jmcpheron/pico-quorum/tools/README.md

# tools

From picowallet (Austin Griffith, MIT): `emu`, the emulator's command line
([`../emu/README.md`](../emu/README.md)), and the start of `check_config`. The rest is Picoquorum's:

- `usb`: the board's REPL and file pushes over USB serial (mpremote), for development boards

- [`vectors/`](vectors/): generates the Safe hash test vectors, and what `firmware/decode.py` must
  say about each one
- `quorum` and [`mock-tx-service/`](mock-tx-service/): the console's 2-of-3 Family Safe on the
  laptop, serving Safe's transaction-service endpoints with two simulated co-signers.
  - It runs simulated (`serve`), or as a real Safe on an Anvil fork of Base (`up`), where the
    chip's approvals execute.
  - `e2e` runs one approval end to end on the fork with the emulator.
  - It also regenerates the screenshot walkthrough in [`../docs/quorum-ui/`](../docs/quorum-ui/).

- `wiring-breadboard`: draws the breadboard version and the knob close-up for
  [`../hardware/wiring/BREADBOARD.md`](../hardware/wiring/BREADBOARD.md); `--check` compares its wire list

- `wiring-build1`: draws [`../hardware/wiring/build1-wiring.svg`](../hardware/wiring/build1-wiring.svg);
  `--check` compares its pin table with BUILD1.md and `firmware/bench1.py`

- `wiring-esp32`: draws the ESP32 build on two breadboards and its pin map, for the DevKitC and for
  Freenove's ESP32-WROVER, for [`../hardware/wiring/ESP32.md`](../hardware/wiring/ESP32.md); `--check`
  compares its pin table with ESP32.md, `firmware/board.py`'s `"esp32"` profile and both boards' headers

- `keypcb`: the key PCBs in [`../hardware/key-pcb/`](../hardware/key-pcb/) and the console boards
  ([Mono](../hardware/mono/README.md), console-rp, and by name the ones in `hardware/prototypes/`
  and `hardware/archive/`), with KiCad's `kicad-cli`: 9 for key rev A, 10 for the rest.
  - `check` runs ERC, then DRC with schematic parity.
  - `fab` writes the Gerber zip, and the BOM and CPL in JLCPCB's format.
  - `render` draws the top and bottom of each board.
  - `calc` works out the numbers behind the design: finger timing, I2C rise time, key power from
    a GPIO, and two ngspice runs. See [`../hardware/key-pcb/LEARN.md`](../hardware/key-pcb/LEARN.md).

- `case`: the printed cases and mock-ups, rebuilt from their CadQuery scripts with uv, at pinned
  versions of CadQuery, matplotlib, Pillow and numpy.
  - `list` shows each design: its scripts, what they write, and the pages that show it. Mono's case
    is `mono`, and its industrial variant `mono-industrial`
    ([`../cad/consoles/`](../cad/consoles/README.md)).
  - `build [design]` runs a design's scripts in order (the prism: `prism.py`, then `assembly.py`'s
    step-by-step pictures).
  - `check [design]` builds, then lists every output that changed, appeared or went, and every
    picture a design's pages link to that isn't there. A design is up to date when it lists nothing.
  - A STEP file that differs only in its time, or in the order of its colours, is left as it was.
  - A new design is one entry in its `DESIGNS`.

- [`fonts/`](fonts/): renders the console's anti-aliased fonts (Atkinson Hyperlegible, OFL) into
  `firmware/qf_*.bin`; `firmware/fonts.py` draws them

- [`brand/lockup.py`](brand/lockup.py): the logo (the mark and the name, outlined) as
  `docs/brand/lockup-dark.svg` and `lockup-light.svg`, for the README

- [`releases/badge.mjs`](releases/badge.mjs): the README's build badges and table, each image's
  release fingerprint as a blockie with its first and last 8 digits; `--check` is CI's

- [`board/shots_feather.mjs`](board/shots_feather.mjs): the console's screens on the Feather
  ESP32-S3 Reverse TFT (240×135, three buttons), from the emulator, for
  [`../docs/quorum-ui/feather/`](../docs/quorum-ui/feather/README.md)

- `fw` ([`board/fw.mjs`](board/fw.mjs)): the Pico as a production device, over USB.
  - `build console|ceremony` makes an image from `firmware/manifest.json`.
  - `backup` copies every file on the board, each checked by SHA-256, into `backups/` (gitignored).
  - `verify [--baseline]` is read-only: files, flags, the console's live state, and the chip.
  - `pin` writes `QUORUM_EXPECT` from the chip itself.
  - `push console|ceremony` backs up first, shows the plan and asks for a typed yes. Then it enters
    maintenance, copies, checks every hash, and deletes stale files.
  - Also `restore`, `logs`, and `measure tls` (run on the board from RAM).
  - `tools/usb push` no longer copies `secrets.py`, and refuses a production board.
- `check_config`: both ATECC608 tables, the legacy test table and quorum v1, with quorum v1 decoded
  again from the datasheet's bit tables. `--summary SNAPSHOT` prints a fresh chip's config CRC.
- [`board/shots.mjs`](board/shots.mjs): the walkthrough in
  [`../docs/firmware-production/`](../docs/firmware-production/).
