jmcpheron/pico-quorum/emu/README.md

# emu: the console in a browser

The emulator comes from Austin Griffith's [picowallet](https://github.com/austintgriffith/picowallet)
(MIT): its runtime, shims, page and command line are his, changed since for Picoquorum.

Real MicroPython (the WebAssembly build of 1.26, the board runs 1.26.1) running the firmware in
`firmware/` unchanged, with the `machine`/`network`/`requests` modules replaced by shims that talk
to the page. The screen is captured from the ST7789 SPI stream, so what you see is the exact
framebuffer.

```
tools/emu                 # start the server, open http://localhost:4242
tools/emu run quorum      # reboot + start the console (firmware/quorum.py)
tools/emu key A           # press a button (A B X Y up down left right press), key right:300 holds
tools/emu shot            # emu/shots/latest.png
tools/emu exec 'import gc; print(gc.mem_free())'
tools/emu log             # console lines
tools/emu chip ready      # the virtual ATECC608: config locked + key in slot 0 (fresh = blank part, show = state)
tools/emu devices         # boards on USB (serial ports, bootloader drives)
tools/emu ship snake      # copy emu/sketches/snake.py (+ imports) to the Pico on USB and run it (--port /dev/cu.usbmodemN, --boot: run at power-up too)
tools/emu flash --port /dev/cu.usbmodemN [--wifi]   # MicroPython onto any board (also works on a BOOTSEL drive without --port)
tools/emu headless quorum --wait 300 --key right --shot emu/shots/x.png    # no browser
tools/emu serve --host 0.0.0.0   # server in the foreground, reachable from the LAN (EMU_HOST=0.0.0.0 too)
```

The server listens on 127.0.0.1 only. Its `/ctl` routes run code on the emulated device and ship files
to a Pico on USB, so `--host` opens that to anyone who can reach the machine: trusted networks only.

Page: the device menu lists every board on USB; for one that is not running MicroPython the
send button becomes ⚡ install MicroPython. The module menu top left picks what ▶ run, ↻ reset and
⇪ send to Pico act on (only modules
that show something are listed: they start themselves at import, or the server knows their entry
point, `ENTRY` in `core/workspace.mjs`). Left = files, editor (Cmd/Ctrl+Enter runs the open file),
console with a REPL; right = the device, its screen with the joystick and A B X Y.
Keyboard: W A S D and space for the joystick, numpad 9 6 3 . for A B X Y (top-row 9 6 3 . work
too), after clicking the device, or click the buttons.

The flash also gets a `build.py` like the one `tools/fw build` writes for a Pico (`IMAGE = "emu"`, the
manifest's version, the commit, and `RELEASE`, the release fingerprint of the console files as
served here). The toolbar shows the fingerprint's blockie, the same picture as on a Pico's Device screen running
the same files. `--file build.py=PATH` in headless replaces it.

The flash is `firmware/*.py` and `*.bin` (never `secrets.py`; a stub is generated with
`APP_URL = "/app"`, which the server proxies to a laptop service such as tools/quorum's mock,
`--app http://host:port`, default `http://localhost:3001`) plus `emu/sketches/*` on top. Saving in the editor writes to disk.

## On GitHub Pages

`node emu/build.mjs` (after `npm ci` here) writes the console page, `docs/console/`. Commit it, as
with `docs/app/`. CI rebuilds it and fails if the committed copy differs. This emulator, with its
editor and module menu, is not on the site any more: `docs/emu/` is only a redirect to the
console page, so old links still land somewhere. It runs here, under `tools/emu`.

**The console page** ([picoquorum.app/console/](https://picoquorum.app/console/),
`emu/console/`, written to `docs/console/` by the same build): the console alone, its screen with the
joystick and A B X Y as on the board, for anyone without a Pico. No editor, no module
menu; it always runs the quorum console with your passkey as the key, and the files exactly as built.
- **First visit:** it asks you to **make a passkey**, or to use one you **already have** (made in
  another browser, or synced from your other device by iCloud Keychain or Google Password Manager),
  then to add a Safe you already have: its chain and address (Safe{Wallet}'s `base:0x…` works too),
  saved to the same list the app keeps.
- **Its owner address** is shown on the screen and in the panel, with Copy: the
  `SafeWebAuthnSignerProxy` address the passkey's signatures count as, the same on every chain,
  worked out in the page (`web/browser.mjs` `passkeyOwner`, `core/keccak.mjs`) from the factory in
  the `quorum_cfg.py` it boots, and the same as the console's own (`webauthn.owner_address`).
  A passkey isn't a wallet: a wallet that owns the Safe deploys its signer and proposes adding that
  address; then the passkey only confirms, on this screen. Each Safe in the panel says, from Safe's
  service, whether the passkey is an owner yet, and links the app's Add owner with it filled in.
- **A passkey you already have:** WebAuthn only gives out a passkey's public key when it is made, so
  the page has it sign twice and works the key out from the two signatures
  (`core/webauthn-assert.mjs` `recoverKeys`), then checks it. Same passkey, same owner address.
- **In the app,** `#/passkey` (Keys → Your passkey) shows its owner address, deploys its signer on
  each chain from your wallet, and links each saved Safe's Add owner with it filled in.
- **One folder with everything it runs.** It loads nothing from the rest of the site, so a copy of
  the folder is the whole program ([docs/guide/BROWSER.md](../docs/guide/BROWSER.md): save it,
  check it, run it on `localhost` with a passkey of its own):
  - `firmware/`: the console image (`firmware/manifest.json`), the same files a Pico runs, as plain
    files. They hash to the release fingerprint; the build checks that, and the page works it out
    again in the browser and shows its blockie.
  - `shims/`: only the shims the console uses. The passkey is its only key, so the virtual chips
    (`atecc_sim.py`, `trustm_sim.py`) and `rp2.py` never load and aren't there, and the page passes
    `keyBin: null`: no `key.bin` at all. `_bootstrap.py` is `bootstrap.py` there, because Pages
    leaves out any file whose name starts with `_`.
  - `boot.json`: the release fingerprint, `build.py`, the console image's file names and the shims'
    paths. `web/browser.mjs` `staticBoot` fetches each file.
  - `worker.js` (`emu/console/worker.js`): the console's own worker. It boots, runs `quorum`, and
    carries frames, HTTP and the passkey's question to the page. None of `web/worker.js`'s serial
    line, server chip state or module running is in it.
  - `web/browser.mjs`, `core/`, `shared/`, `vendor/micropython/`: the same files as here.
  - `fonts/` and `brand/`: the site's, from `docs/app/fonts/` and `docs/brand/`.
  - Its own `coi.js`, `sw.js` and CSP (no inline script or style). The CSP's `connect-src` is
    `'self'` and the hosts of `quorum_cfg.py`'s services (`https://api.safe.global`). `sw.js` sends
    it as a header too, with COOP/COEP, so it binds the worker as well; a `<meta>` tag doesn't reach
    a worker.
  - `SHA256SUMS` (for `sha256sum -c`) and `BUILD.json` list every file. The page's table of what is
    in the folder, with line counts, is written by the build.
- **In a copy on your own computer** (`localhost`), the links to the app go to the app on the site,
  carrying only public things: the deploy link's public key, Add owner's address and Safe.

**Your passkey as the key**, here too. The toolbar's **key** menu picks the virtual chip or **your
passkey**, and **make a passkey** creates one with WebAuthn for this site: Touch ID, Windows Hello, a
phone or a security key, P-256 (ES256). It is the same code as the console page's (`web/browser.mjs`).
- **What the console gets:** the public key, kept in the browser. The console computes its owner
  address from it, as for a chip.
- **When it signs:** `shims/passkey.py` asks the page, through a shared buffer while Python waits,
  for a WebAuthn assertion over the safeTxHash computed on screen. `quorum.sign_it` packs it exactly
  as a chip's.
- **Before handing it over,** the page checks the assertion's shape, the UV flag, and the signature
  against the key.
- **The first time,** a note says the authenticator won't show the transaction.

`tools/vectors/passkey.mjs` showed a real browser's assertion passes Safe's passkey signer on Base
Sepolia, Base and Ethereum. `test-vectors/passkey.json` pins the firmware's packing of it. Headless:
`--passkey` signs with a software passkey (`core/softpasskey.mjs`).

The front page, the app and the README link to the console page.

`node emu/e2e-static.mjs` serves `docs/` like Pages and checks the console page in Chromium, and
that `emu/` sends you there. It serves `docs/console/` alone, as a copy on your own computer, and runs
the console from it. It also signs a transaction through the page's buttons, with a virtual
authenticator, against `tools/mock-tx-service/sim.mjs` standing in for Safe's service, and checks
that the CSP refuses any other host in the page and in its worker.

## Give it to your AI

`emu/SKILL.md` is the skill file. It tells an AI what the screen and buttons are, how to write a
sketch, how to run it here (`tools/emu run`, `key`, `shot`), and how to put it on the real Pico.
Hand it over with a checkout of this repo (the skill runs `tools/emu`, which needs node). In
Claude Code it loads on its own from `.claude/skills/pico-emu`; say "build Tetris for the Pico"
or `/pico-emu`. The page links to it too (top right, "skill file for your AI", also at
http://localhost:4242/skill).

What is modeled: pins (keys pull low when pressed), SPI display window commands, the SPI transfer
time (24 MHz cap until `machine.freq(cpu, peri)` raises the peripheral clock, like rp2), PWM
backlight, `Pin("LED")`, `Timer` periodic/one-shot, `Pin.irq`, `machine.reset()`,
a 448 KB heap, and a virtual ATECC608 on I2C at 0x60 (`core/shims/atecc_sim.py`: the packet
protocol, config zone and its locks, the slot table, GenKey, Nonce + Sign, Random, Info; state in
`emu/chip.json`, blank part until provisioned). Not modeled: the chip's OTP/data reads, MAC and
encrypted transfers, sockets, PIO, native/viper code generation (runs as bytecode), real timing of
Python itself (wasm is much faster than the RP2350).

Needs node 18+ and `npm ci` in `emu/` (done by `tools/emu` on first run). No build step.
