jmcpheron/pico-quorum/hardware/key-pcb/key-c-usbc/README.md

# key-c: the USB-C key

> **P3, drawn 2026-10-23: P2 plus a green LED the console lights.** Not ordered. The files in this
> folder are P3.
>
> **P2: built and working.** 5 boards assembled by JLCPCB (order **W…1209** · PCBA **SMT…3772** ·
> $38.96). They read on the bench from 2026-10-16, and chip 3 is a Safe owner on the Feather. P2's
> files as ordered are in [`fab/P2/`](fab/P2/) and at commit `ac34fc55`.

## P3: the LED

| parts side |
|---|
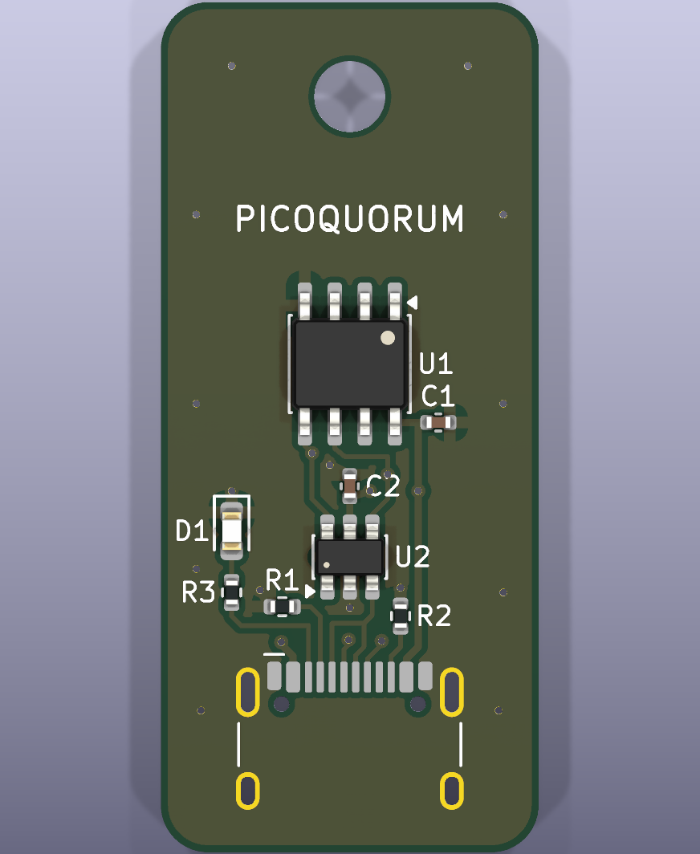
[picture p68: hardware/key-pcb/key-c-usbc/fab/key-c-usbc-top.png]
key-c P3, parts side
|  |

P3 adds two parts, D1 and R3, and changes nothing else in the circuit:
- **D1, a green 0603 LED** (Everlight 19-217, C72043), beside U2, where the key shows when it
  stands in wing-a's plug.
- **R3, 470 Ω** (C25117), between the receptacle's SBU2 pin (B8) and D1. It comes first, so it
  limits whatever a plug puts on SBU. D1's cathode goes to ground.

**The console lights it.** wing-a joins its plug's A8 and B8 and drives them from D13 through
100 Ω ([feather-wing/README.md](../../archive/feather-wing/README.md)). D13 is the console's status LED
pin: today's image blinks it while a transaction waits for this key and keeps it on while Wi-Fi
is up (`led_tick` in `firmware/quorum.py`). So the key's LED does the same with no firmware change.
At 3.3 V that is about 1 mA, which this LED shows plainly; its datasheet rates it at 3.3 V,
20 mA.

**Only B8 is wired.** A8 sits between SDA's two receptacle pads, under SDA's via. The plug's A8 and
B8 are joined on the wing, so one of them meets B8 whichever way up the key goes in.

**Plugged in anywhere else, it stays dark.** A USB-C cable to a laptop carries no SBU on a USB 2.0
cable, and nothing on the key depends on SBU.

**Hot-swap: no change.** P2 already plugs and unplugs safely on wing-a:
- USB-C's ground and VBUS pins mate first and break last. GCT's connector drawings list them as
  "first" and the signal pins (CC, SBU, D+/D−) as "second". The HCTL receptacle's and the wing's
  plug's own drawings weren't checked for this.
- If a signal pin did touch first, U2's diodes carry what the wing's 2.2k pull-ups push into
  SDA/SCL on to the key's VCC: at most about 3 mA, set by the pull-ups.
- The key has 200 nF on VCC, and wing-a's switch limits the key's current to 80 mA.
- 11 plugs and unplugs on the bench reset nothing (log, 2026-10-16).

The rest of hot-swap is the console's: keep the key off until CC shows one, then turn it on. That
needs D5/D6 and D9 in the firmware, a new release
([feather-wing/README.md](../../archive/feather-wing/README.md#open)).

**Checked** (KiCad 10.0.6, `tools/keypcb check key-c-usbc`): ERC 0, DRC 0, 0 unconnected,
schematic parity clean. `gen_cd.py` was first checked to rebuild P2 exactly: every footprint, pad,
track and via the same.

**Ordering P3** is as P2 ([PROPOSALS.md](../PROPOSALS.md#ordering-key-c-at-jlcpcb)), plus: in the
placement preview, D1's cathode (pad 1, the bar in its silkscreen) faces the lanyard hole. D1 and
R3 are basic parts.

## P2 as ordered

| parts side | back |
|---|---|
| key-c P2, parts side | key-c P2, back |

These are KiCad renders of the ordered board, in the colours ordered: blue mask, white
silkscreen and silver lead-free HASL pads. KiCad has no 3D model of the HCTL receptacle, so the
connector shown is a GCT USB4105, a 16-pin receptacle of the same size and pad layout. The
renders come from a scratch copy of the board; the files below are untouched.

**3D models for CAD:** [`3d/key-c-P2.step`](3d/key-c-P2.step) is the assembled board, and
[`3d/key-c-P2-board-only.step`](3d/key-c-P2-board-only.step) is the bare board. They import
into Onshape as-is. Both come from the same scratch copy, with the same GCT stand-in connector at
J1's origin. The origin is the board centre, Z = 0 is the back face, and the USB-C end is at −Y.
The bare board is 1.51 mm thick (mask and copper not modelled). Units are mm.
To remake them: `kicad-cli pcb export step --user-origin 108x118mm`.

**Print mock-up:** [`3d/key-c-P2-print.step`](3d/key-c-P2-print.step) is a simplified version for
a 3D printer: one solid, same frame. The board, the chip bodies and the small parts are plain
blocks fused together. The USB-C receptacle is just its outer shell, with no tongue or contacts.
- The socket is 8.70 × 2.90 mm and 7.0 mm deep, so a real plug (8.25 × 2.40 mm) slides in with
  print clearance. A real-size plug was checked against it and doesn't touch.
- The shell walls are 0.8 mm (two perimeters), so the shell is 10.3 × 4.5 mm. The real one is
  8.94 × 3.26 mm, so the mock-up's shell is a little bigger.
- The board is 1.6 mm, as ordered. H1 is a 3 mm through hole.
- It prints flat, back face down, with no supports. The socket's round top bridges.
- The 0402 parts are 0.35–0.5 mm nubs and may not show on a coarse print.
- To remake it, or change the clearance or walls: `pip install cadquery`, then
  `python3 3d/print_mockup.py`.

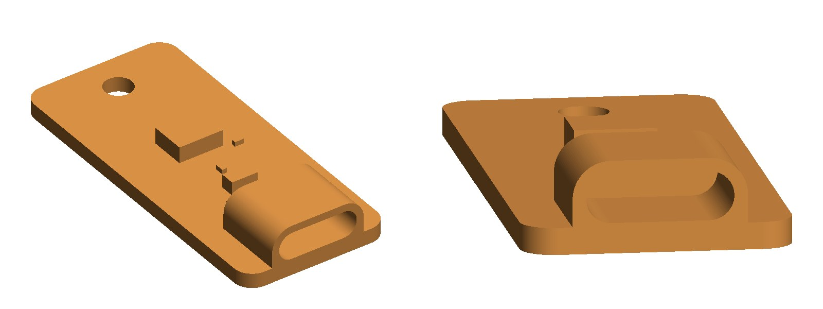
[picture p69: hardware/key-pcb/key-c-usbc/renders/key-c-P2-print.jpg]
print mock-up


**What it is:** an ATECC608C secure element (I2C, SOIC-8) behind a USB-C receptacle. The
receptacle is used as plain wires, not USB:
- D+ carries SDA, D− carries SCL and VBUS is key power.
- A 5.1 kΩ resistor on each CC pin tells the console a key is in.
- A USBLC6 ESD array sits between the connector and the chip.
- Four test pads on the back, and the Picoquorum mark.

The design is in [../PROPOSALS.md](../PROPOSALS.md), and the full order record is
[buildlog/2026-10-02-key-c-order.md](../../../buildlog/2026-10-02-key-c-order.md).

| | |
|---|---|
| Board | 16 × 36 mm, 2 layers, 1.6 mm, blue mask, white silkscreen, LeadFree HASL |
| Parts | U1 ATECC608C-SSHDA-T, U2 USBLC6-2SC6, J1 HCTL HC-TYPE-C-16P-01A, C1/C2 100 nF, R1/R2 5.1 kΩ |
| Files as ordered | commit `ac34fc55` on `key-pcb-learn`; Gerber zip SHA-256 `99a6dbb5…`, now in `fab/P2/` |
| Checks | ERC 0 · DRC 0 · unconnected 0 · parity clean (`tools/keypcb check key-c-usbc`) |

## Next

1. **Before plugging anything in:** build the console's end of the cable
   ([PROPOSALS.md](../PROPOSALS.md#the-console-end-of-key-c)):
   - a current-limited, reverse-blocking VBUS switch, enabled by GP6 and never GP6 directly
   - CC1 and CC2 sensed separately
   - 2.2 kΩ pull-ups to switched VBUS
2. **When the boards arrive:**
   - Look at each one under a loupe, and lightly sand the edges (they weren't deburred).
   - Meter it:
     - VCC to GND is not a short.
     - Each CC pin reads 5.1 kΩ to GND.
     - SDA and SCL aren't shorted to anything.
   - Check that the test pads read the same.
3. **First power-up on the bench:**
   - Only this key in the port.
   - Look for `0x60` in an I2C scan.
   - Read the chip's serial and configuration.
   - Lock nothing yet.
4. **Practise provisioning on a spare** before any key becomes a Safe owner.

## Log (newest first)

- **2026-10-23:** **P3 drawn**: P2 plus D1 (green LED) and R3 on SBU2, lit by the Feather's D13
  through wing-a. R1 moved left of U2 to make room. ERC/DRC clean. P2's fab files moved to
  `fab/P2/`.
- **2026-10-16:** **first power-up on the bench**, on an ESP32
  ([buildlog](../../../buildlog/BUILDLOG.md)). Nothing was locked.
  - The console's end wasn't built: key power straight from the 3.3 V rail, no CC sensing.
  - Nothing answered until IO21/IO22 had pull-ups. The ESP32's own (about 45 kΩ) were enough on
    the bench, up to 400 kHz with no errors.
  - `0x60` answered. Chip `0123e063db3354d7ee`: an ATECC608C, revision `00006005`, both zones
    unlocked, the factory table, SelfTest passes.
  - A second key, `0123147ac8c5b889ee`, also read. Plugged and unplugged 11 times between them,
    both ways round: each insertion read the right serial, and the ESP32 never reset.
- **2026-10-04:** **placement confirmed**, and the order is in production.
  - "Yes, please proceed to production."
  - The PCBA is at 13% (Data Finished) and fabrication at 0%.
  - Estimated finish: 2026-10-07 05:00.
- **2026-10-04:** STEP files of the ordered board added in `3d/`, for Onshape.
- **2026-10-04:** JLCPCB's parts-placement review arrived and was checked.
  - U1 and U2 have pin 1 at their triangles.
  - J1 faces the edge.
  - The 0402 parts aren't polarized.
  - It needs confirming in Order History within 72 hours.
- **2026-10-02:** status page and renders made.
- **2026-10-02:** checked the PCBA line's final parts list and the saved placement view.
  - All 5 parts are selected. C1 and C2 share the C1525 line, with 10 bought.
  - U1/U2 pin 1 sit at their triangles.
  - J1's pegs measure exactly on the peg holes.
- **2026-10-02:** the `cpl.csv` downloadable from the order is byte-identical to the upload. The
  placement edits live only in JLCPCB's system.
- **2026-10-02 17:14:** JLCPCB's production file arrived, was compared with the design, and was
  **confirmed**.
  - The input is byte-identical.
  - All 29 drills are at 0.000 mm offset.
  - Two 1.152 mm tooling holes were added, in plain ground pour.
  - Copper, silkscreen and mask show only normal fab changes.
  - Also checked by hand in GerbView.
- **2026-10-02 16:10:** **ordered**, W…1209, $38.96.
  - Economic PCBA, LeadFree HASL, Confirm Production file and Confirm Parts Placement.
  - Deburring didn't make it into the final order.
- **2026-10-02:** in JLCPCB's placement preview, U1 and U2 were rotated 90° (each pin-1 dot to its
  triangle) and J1 was nudged onto its pads.
- **2026-10-02:** **P2.** Redesigned after an outside review.
  - J1's footprint copy: outer ground pads pulled back to clear the peg holes, which removed the
    DRC exception.
  - U2 moved closer to J1, with C2 at its VBUS pin.
  - Four test pads on the back.
  - The board grew to 16 × 36 mm.
  - The review's console-side points went into PROPOSALS.md.
- **2026-10-02:** first upload, P1, 14 × 32 mm.
  - J1's yellow flag was only a $0.03 special-handling fee.
  - Economic assembly wasn't offered with ENIG but was with HASL. Standard would have forced a
    70 × 70 mm board.
- **2026-10-02:** the Picoquorum mark added to the back.
- **2026-10-02:** **P1** drawn, with key-d (pogo) beside it. The receptacle goes on the key rather
  than a plug: 16 pins on one side, cheap, assembled at JLCPCB.
- **2026-10-02:** rev A (the PCB is the plug) arrived on `main`. The spring-contact C1 concept was
  parked on `key-c1-concept`.
