jmcpheron/pico-quorum/docs/quorum-ui/v2/README.md

# Picoquorum UI, v2: the plan, and the new boot screen

A redo of the console's look, starting with the boot screen. Each iteration adds a section here
with screenshots and what changed. Every picture is the real drawing code running in the emulator
(pixel-for-pixel the Pico's 240×240 panel, shown at 2×). Comment on any line in the pull request,
or edit the [change requests](#change-requests) list at the bottom straight in GitHub.

What came before: [the v1 walkthrough](../README.md) (the approval screens, iterations 1–3) and
its four [boot screen options](../README.md#boot-screen-options). The 2-of-3 "Quorum" triangle
there is where this one starts.

## The plan

1. **The boot screen:** a 3-of-5 quorum that becomes the Ethereum diamond. **Picked: the orbit,
   just dots** (iteration 3), with green signatures and a status line (iteration 4).
2. **Wire it to the real boot.** Each signature is a real boot step finishing, and the spin
   covers the slow ones (see [On the device](#on-the-device)).
3. **Type.** Five candidate sets on a specimen card and on six real screens: see
   [FONTS.md](FONTS.md). Waiting on your pick.
4. **Colour and graphics.** Bring the boot screen's palette and shapes into the approval screens:
   the home screen, the approvals row, and the moment of signing.
5. **Every screen, redone,** with before/after pairs like the v1 walkthrough.

## Home as a status screen, and a screensaver (2026-10-05)

You asked for a home that fits how Picoquorum works now: requests pop up, and when there's
nothing to sign, something calmer, turning into a screensaver with useful information. The grid
of tiles is gone.

**Nothing waits for this key: the status screen.**
- **The header:** this key's blockie and name (the chip's name, or "Your passkey" in the
  browser), and the sync status.
- **One card that answers "can I approve?":**
  - **Ready to approve** (green check): "Nothing waits for you", or "1 waiting for others · Y
    shows" when the queue holds transactions this key has already signed or doesn't need to.
  - **Not an owner yet** (amber): the Safes answered and this key owns none of them. It shows the
    address to add, and the next step: for a passkey "in the app: Your passkey" (its signer
    deployed, then Add owner); for a chip "deploy its signer, add owner". This is the deploy
    step, seen from the console.
  - **Offline**, **Connecting…** or **No key** when that's the state.
- **SAFES:** one row per Safe, with its blockie, name, chain (and the chain's colour bar), and
  what it means for this key: "2 of 3" with a green dot when you're an owner, "not owner" in
  amber, "1 queued", or "offline" in red.
- **Last:** this console's last approval, under the Safes.

**A request arrives: the queue list, as before.** It replaces the status screen until nothing
waits for this key.

**A quiet minute: the screensaver.** The backlight dims to 15%, and every 8 seconds the screen
shows the next card, each a few pixels off from the last:
- **the time and date** (when the clock is set), with "Nothing to sign";
- **each Safe:** its blockie, "2 of 3", the next nonce, whether anything is queued, and whether
  you're an owner;
- **this key:** its blockie, kind ("ATECC608 · 41 uses", "Trust M · sealed", "Passkey"), its
  address, how many Safes it owns;
- **the last approval;**
- **the release:** its blockie and fingerprint, the same on every console and page running it.

Every card comes from what the console already knows, so the screensaver makes no extra
requests. Any key wakes it and does nothing else (the first press only turns the screen on). A
transaction for this key wakes it straight to the queue. `QUORUM_SAVER_S` sets the quiet time (0
turns it off), and `QUORUM_UTC_OFFSET` sets the clock's time zone. The browser console dims its
screen the same way.

**Keys on the status screen:**
- **Up/down** pick a Safe, and **A** (or right, or a press) opens its Owners.
- **B** opens Recent, **X** opens Device, and **Y** opens the queue when others' transactions wait.
- **Build 1's dial:** turn through the Safes, then Queue, Recent and Device; press to open.

| | Waveshare, 240×240 | Build 1, 320×240 |
|---|---|---|
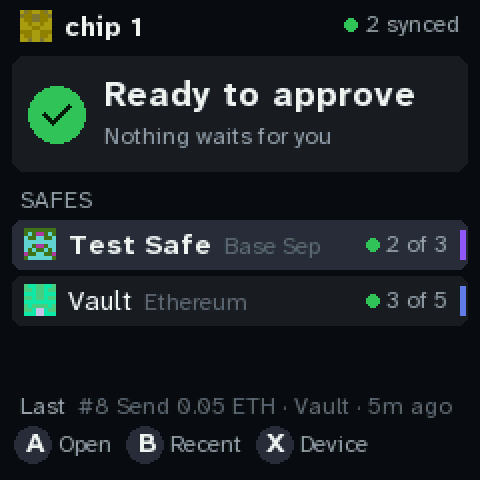
[picture p71: docs/quorum-ui/v2/status/01-ready-240.png]
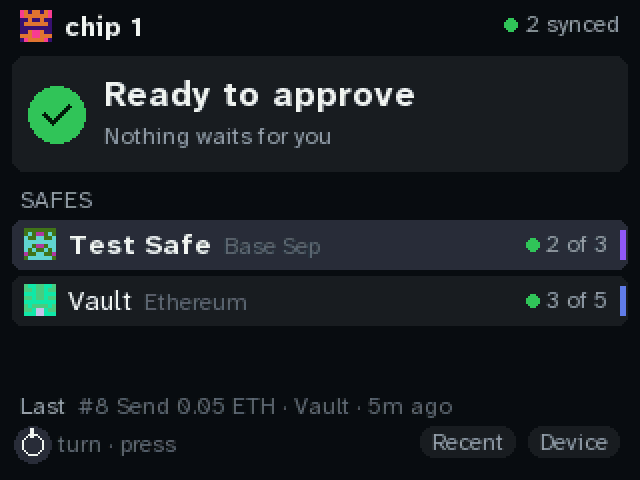
[picture p72: docs/quorum-ui/v2/status/01-ready-320.png]
| Ready |  |  |
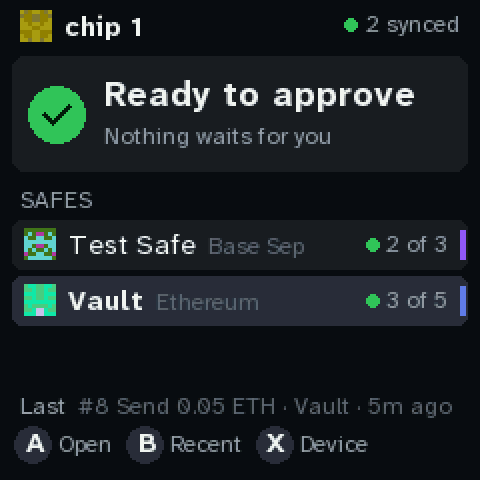
[picture p73: docs/quorum-ui/v2/status/02-safe-in-focus-240.png]
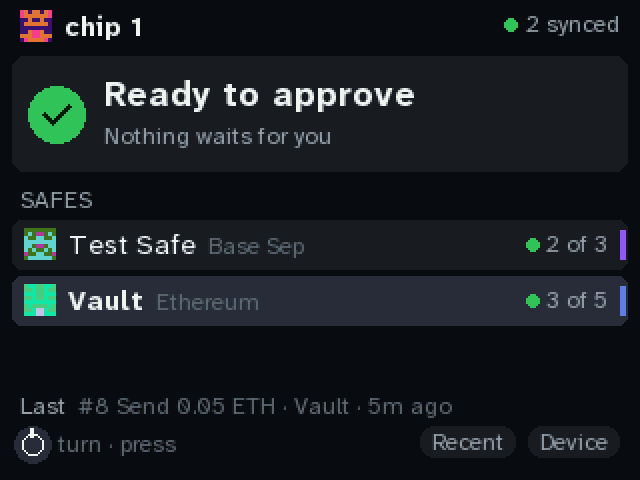
[picture p74: docs/quorum-ui/v2/status/02-safe-in-focus-320.png]
| The second Safe in focus |  |  |
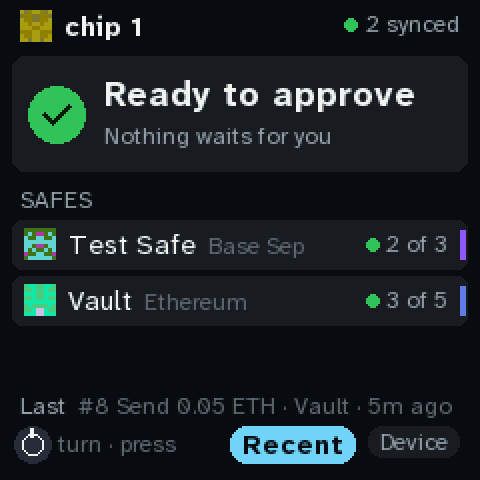
[picture p75: docs/quorum-ui/v2/status/03-dial-240.png]
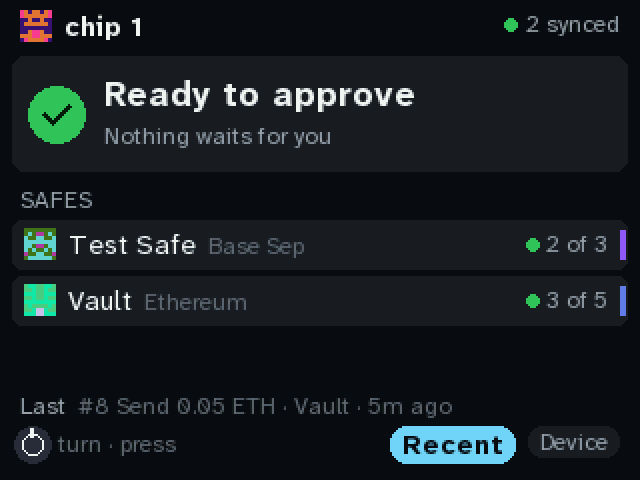
[picture p76: docs/quorum-ui/v2/status/03-dial-320.png]
| The dial past the Safes |  |  |
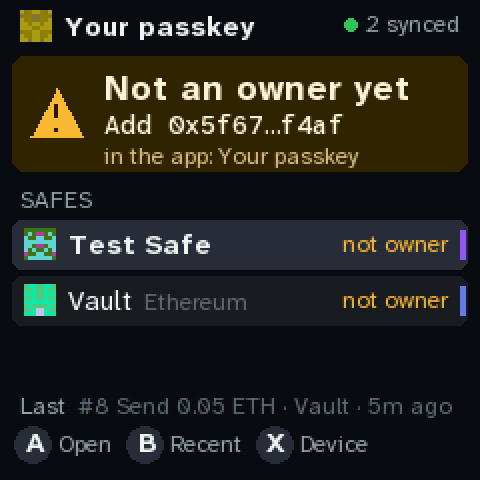
[picture p77: docs/quorum-ui/v2/status/04-passkey-not-owner-yet-240.png]
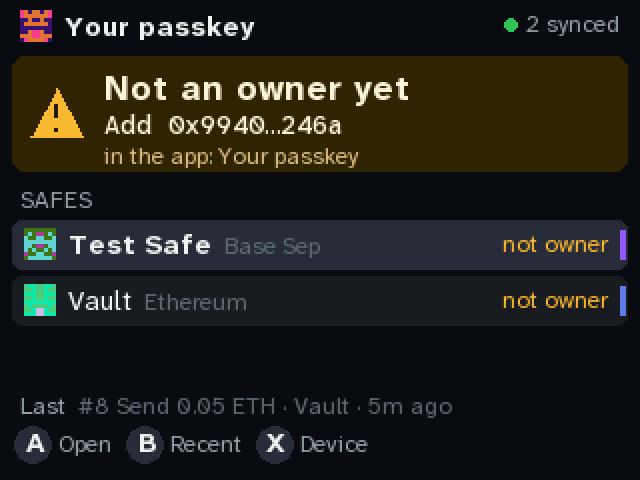
[picture p78: docs/quorum-ui/v2/status/04-passkey-not-owner-yet-320.png]
| Your passkey, not an owner yet |  |  |
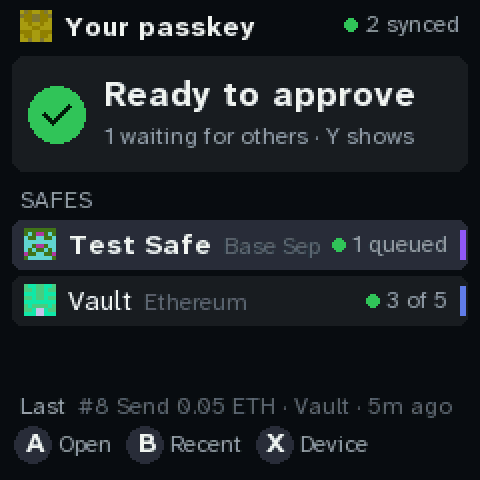
[picture p79: docs/quorum-ui/v2/status/05-queued-for-others-240.png]
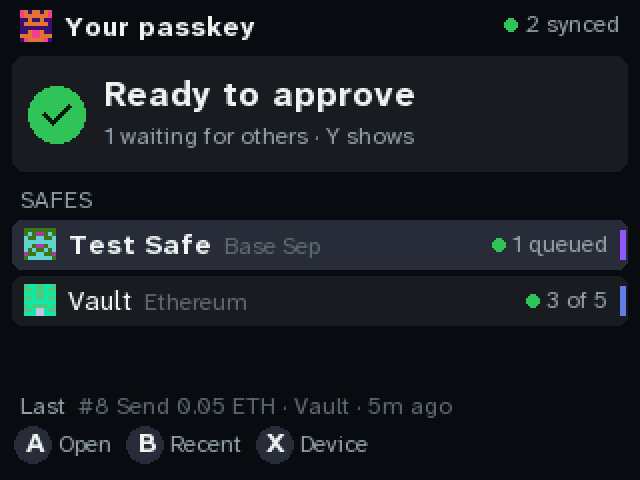
[picture p80: docs/quorum-ui/v2/status/05-queued-for-others-320.png]
| Queued for others (you've signed) |  |  |
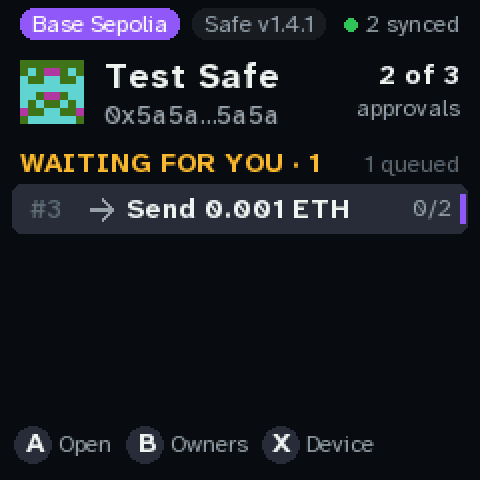
[picture p81: docs/quorum-ui/v2/status/06-request-waiting-240.png]
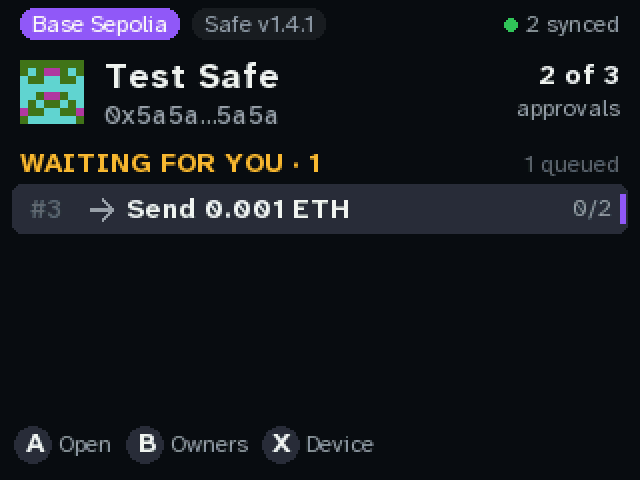
[picture p82: docs/quorum-ui/v2/status/06-request-waiting-320.png]
| A request waiting: the list |  |  |
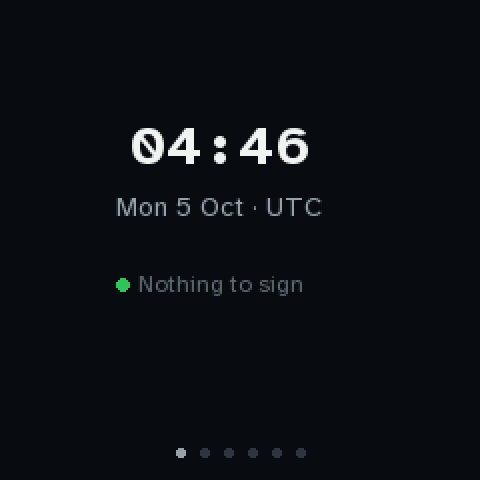
[picture p83: docs/quorum-ui/v2/status/07-saver-clock-240.png]
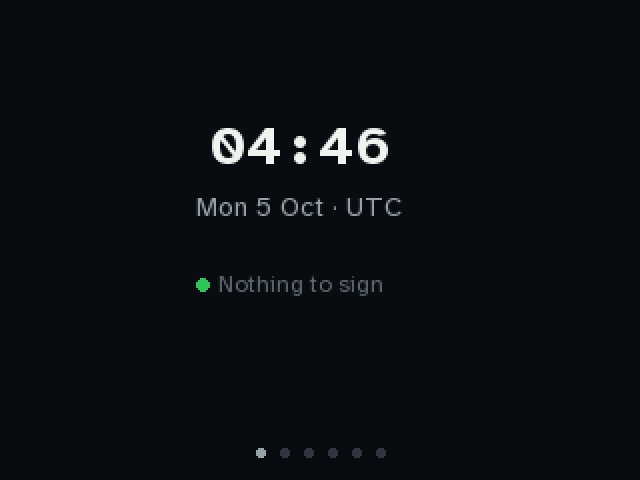
[picture p84: docs/quorum-ui/v2/status/07-saver-clock-320.png]
| Screensaver: the time |  |  |
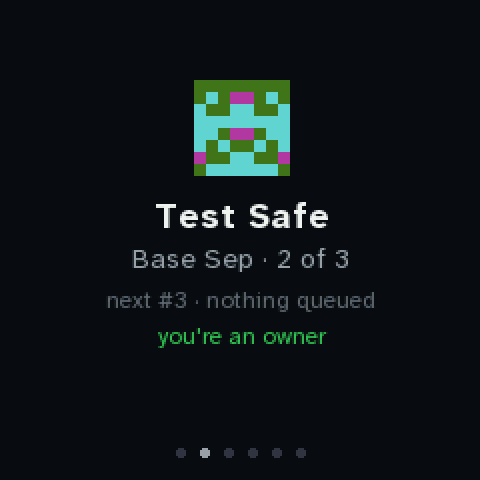
[picture p85: docs/quorum-ui/v2/status/08-saver-safe-240.png]
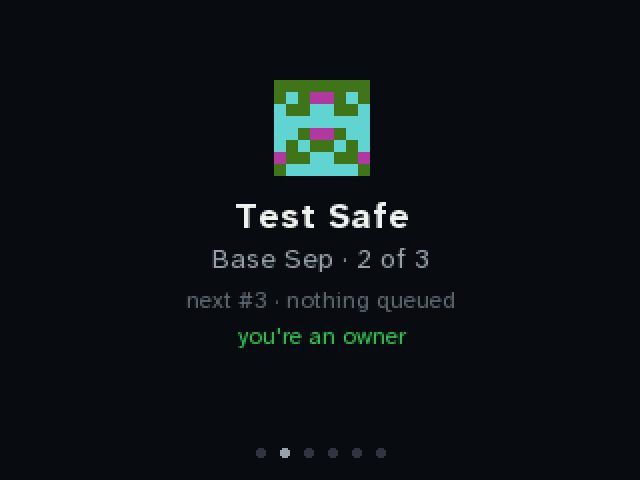
[picture p86: docs/quorum-ui/v2/status/08-saver-safe-320.png]
| Screensaver: a Safe |  |  |
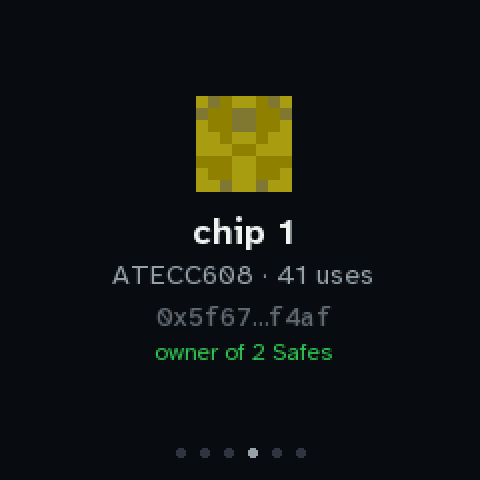
[picture p87: docs/quorum-ui/v2/status/09-saver-key-240.png]
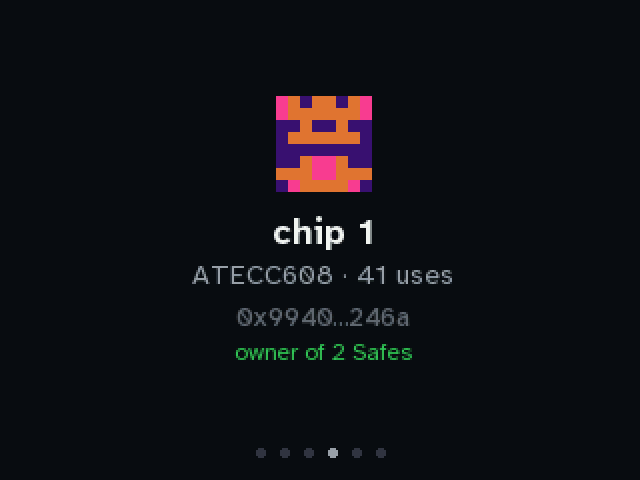
[picture p88: docs/quorum-ui/v2/status/09-saver-key-320.png]
| Screensaver: this key |  |  |
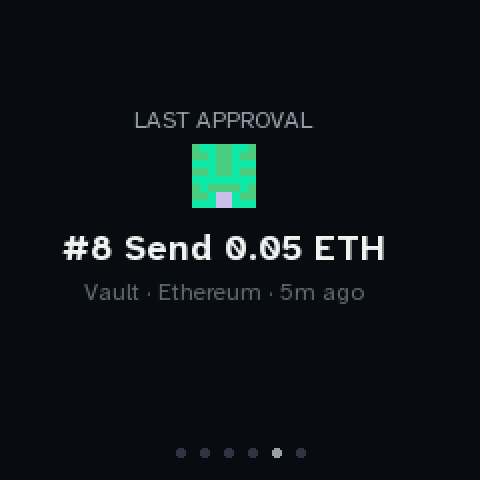
[picture p89: docs/quorum-ui/v2/status/10-saver-recent-240.png]
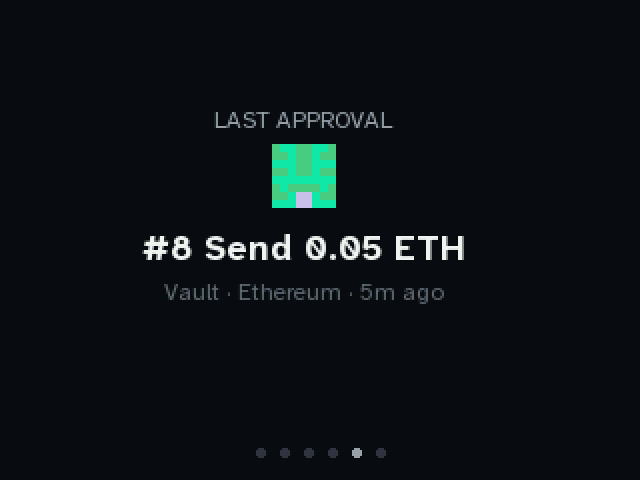
[picture p90: docs/quorum-ui/v2/status/10-saver-recent-320.png]
| Screensaver: the last approval |  |  |
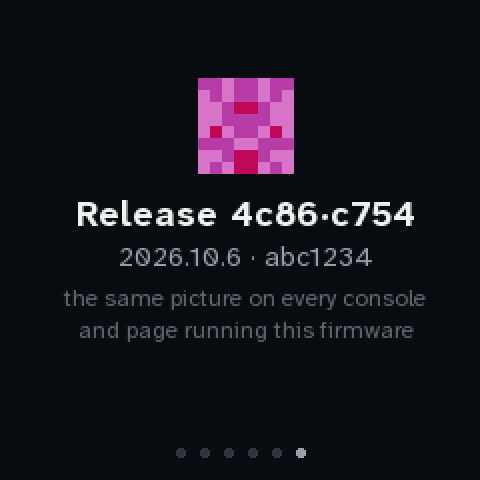
[picture p91: docs/quorum-ui/v2/status/11-saver-release-240.png]
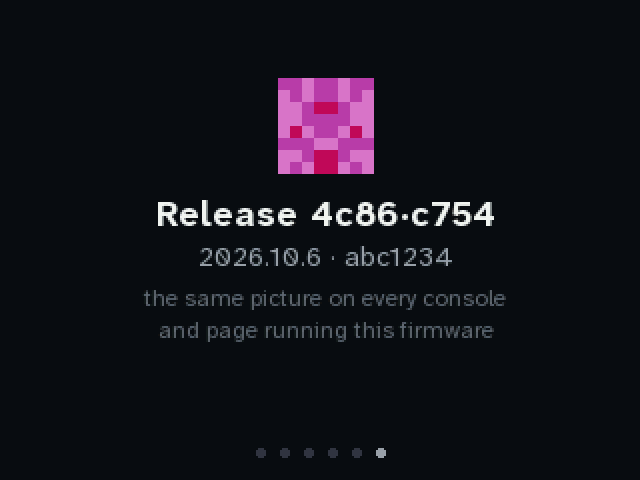
[picture p92: docs/quorum-ui/v2/status/11-saver-release-320.png]
| Screensaver: the release |  |  |

These are drawn by the real firmware in the emulator (`node tools/board/shots_home.mjs`). The
approvals and the release in them are made up.

**Not done, and why:**
- **Whether the signer is deployed.** The console only talks to Safe's transaction service,
  which doesn't say. The app's Your passkey page checks it on each chain. Until it's deployed,
  the Safe can't check that owner's signature, so deploy it before the first approval.
- **An ETH price, or the Safe's balance.** Either needs a new data source on the signing device:
  a price API, or Safe's client gateway for balances in dollars. A balance card would be the more
  useful of the two. Both are easy to add as cards; the question is which source you'd trust.

**Questions for you:**
- Should A on a Safe open a Safe page (owners, nonce, recent activity) rather than just its
  Owners?
- Which cards should the screensaver show, and how often should it turn?

## Home as a grid to browse (2026-10-01, firmware 2026.10.4, replaced by the status screen above)

You asked for a home you can browse when nothing needs signing, with the queue list only when a
request comes in.

**Nothing waits for this key: a grid of tiles.**
- **Each Safe this console works with,** as that Safe's blockie, with its chain and "3 of 5".
  - The one you signed for most recently comes first.
  - A Safe the key isn't an owner of says "not owner" in amber; one that didn't answer says "offline" in red.
  - The coloured bar under the blockie is the chain's colour, as on the chain pill.
- **Recent:** the last signatures this console sent, newest first: which #, what, which Safe,
  when. A dozen are kept in `recent.json` on the board, and every push keeps it. It starts empty
  and fills as you approve.
- **The chip:** its owner blockie (the boot screen's picture), its name, "Trust M · sealed" or
  "ATECC · 41 uses". It opens the Chip pages.
- **Device:** the firmware version and the Wi-Fi network. It opens the Device screen.
- **Queue:** only when transactions are queued but none wants this key; it opens the list.
- **The header** has the same chip blockie, small, with the chip's name, and the sync status.

**A request arrives: the queue list, exactly as before.** Its first row is the waiting
transaction, and A opens it.

**Keys:**
- **Joystick:** moves around the grid. **A** opens the tile. **B** opens the Owners screen for the
  Safe in focus, as on the old home. **X** opens Device.
- **Build 1's dial:** turn to walk the tiles, press to open.

**The 1.8" panel** keeps the list for now.

| | Waveshare, 240×240 | Build 1, 320×240 |
|---|---|---|
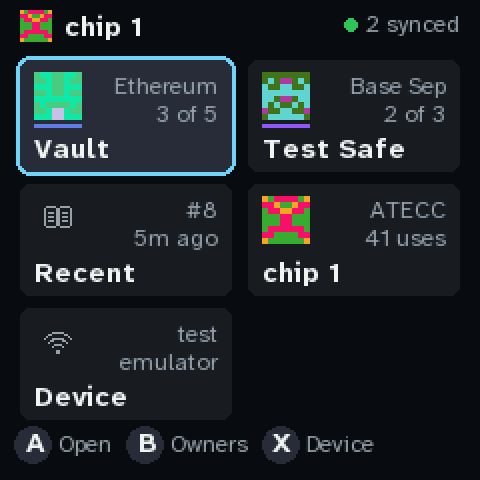
[picture p93: docs/quorum-ui/v2/home/01-grid-240.png]
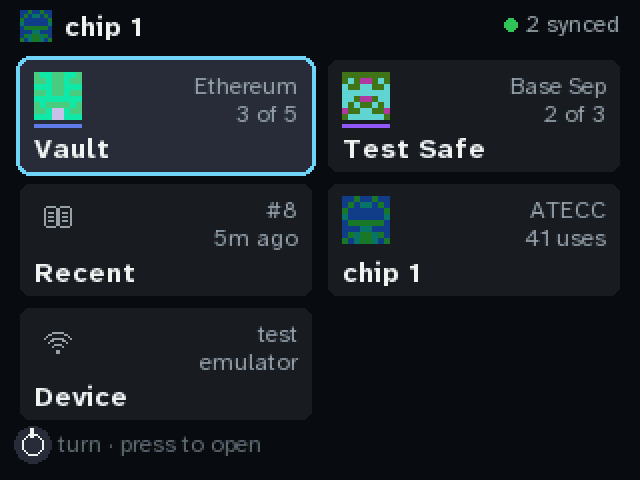
[picture p94: docs/quorum-ui/v2/home/01-grid-320.png]
| The grid |  |  |
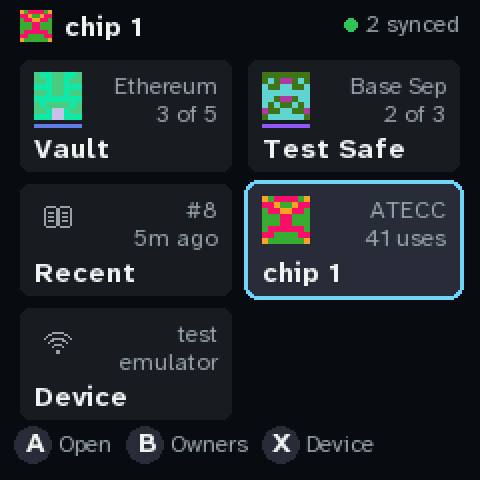
[picture p95: docs/quorum-ui/v2/home/02-grid-chip-240.png]
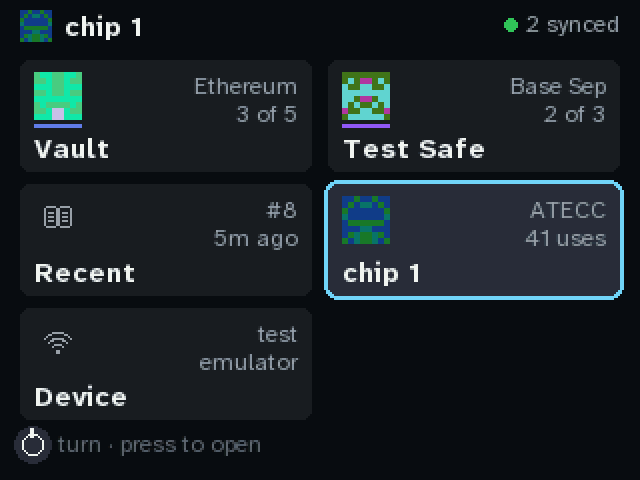
[picture p96: docs/quorum-ui/v2/home/02-grid-chip-320.png]
| The chip in focus |  |  |
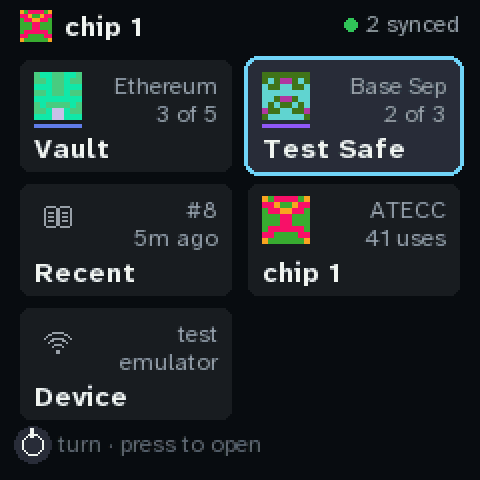
[picture p97: docs/quorum-ui/v2/home/03-grid-knob-240.png]
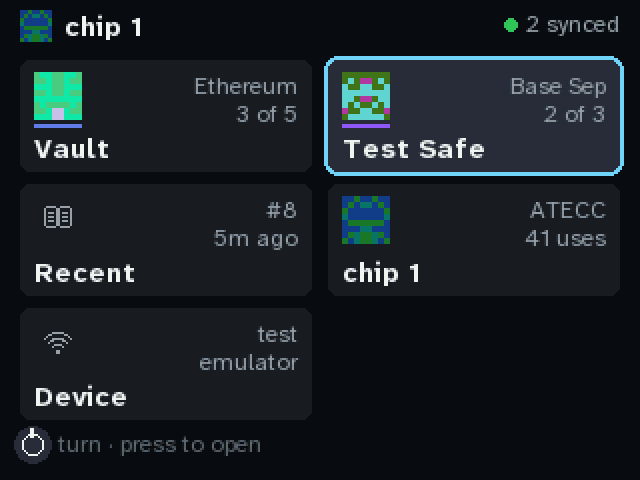
[picture p98: docs/quorum-ui/v2/home/03-grid-knob-320.png]
| The dial's footer |  |  |
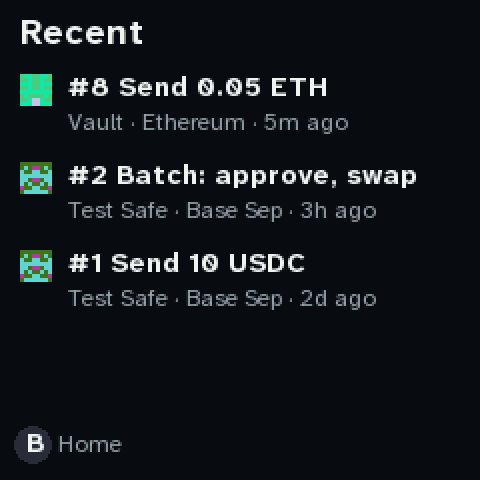
[picture p99: docs/quorum-ui/v2/home/04-recent-240.png]
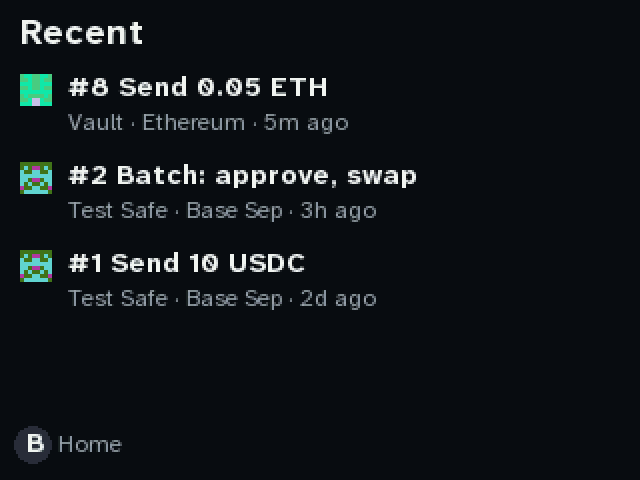
[picture p100: docs/quorum-ui/v2/home/04-recent-320.png]
| Recent |  |  |
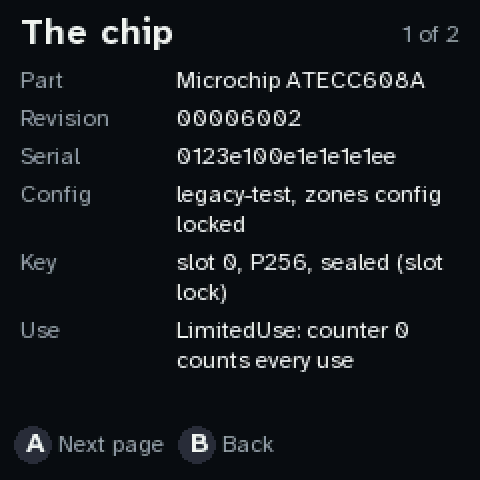
[picture p101: docs/quorum-ui/v2/home/05-chip-from-grid-240.png]
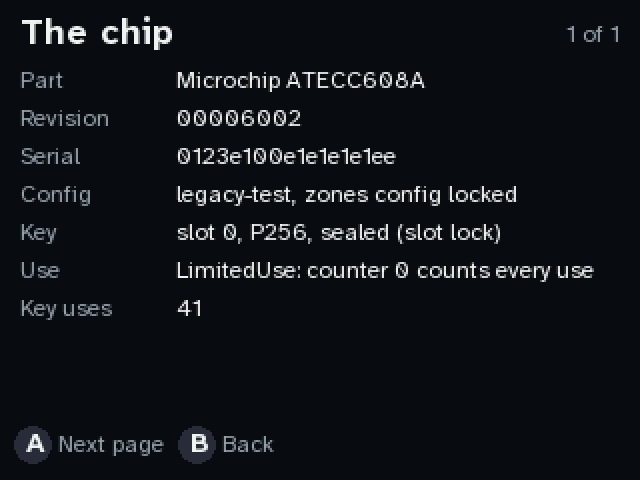
[picture p102: docs/quorum-ui/v2/home/05-chip-from-grid-320.png]
| The Chip pages from the tile (B comes back here) |  |  |
| A request waiting: the list |  |  |

These are drawn by the real firmware in the emulator (`node tools/board/shots_home.mjs`). The
Recent entries in the shots are made up; on the boards Recent starts empty. The Device tile's
"test" and "emulator" are the emulator's build and network names.

**Questions for you:**
- Should a Safe's tile open its Owners, as now, or a Safe page with its owners, nonce and recent
  activity?
- Is two columns right on Build 1's wider screen, or should it be three smaller tiles across?

## The chip's blockie at boot (2026-10-01, firmware 2026.10.3)

You asked to see the loaded chip's blockie when the console first loads.
- **When it appears:** as soon as the console has read the chip and checked its pin, a row comes
  in under the tagline.
- **What's in the row:** the owner address's blockie, the chip's name and the address cut short.
- **The picture:** the same one the ceremony's T5, the Owners screen and every approval show. If
  you swap a chip in, you can tell before the home screen whether it's the one you expect.
- **A chip that isn't the pinned one:** its name and address turn red.
- **How long it shows:** it stays up with the rest of the boot screen, about two seconds on
  Build 1, without slowing the boot.
- **The 1.8" panel:** it has no room, and only the status line shows the chip.

| Waveshare, 240×240 | Build 1, 320×240 |
|---|---|
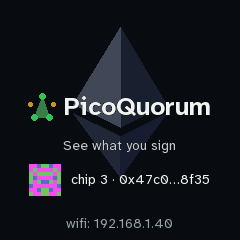
[picture p103: docs/quorum-ui/v2/boot/chip-row-240.png]
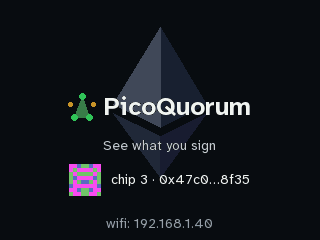
[picture p104: docs/quorum-ui/v2/boot/chip-row-320.png]
|  |  |

These are drawn by the real firmware in the emulator, with TM1's owner address
`0x47c0…8f35` and its board name, chip 3. `node test-vectors/run-bootmark.mjs` checks every frame
of the animation, with the row arriving at 700 ms, against a fresh paint on all three panels.

## The light mark turns into Ethereum (2026-09-30)

You said the diamond fading in and flying to the corner didn't work. You asked to go back to the
original idea, drawn the light way: the green triangle becomes the top of the Ethereum logo, which
spins until the whole logo is there. Then Picoquorum, with a small version of the mark to its left,
fades in over the logo, which keeps turning. And no pauses: as quick as it can go.

**Update, same day:** on the board it ran fast and smooth until the name came up, then stuttered
and froze. That was the console starting up behind it (below), so the diamond now **slows to a
stop on the logo's pose** as the name fades in, rather than freezing mid-turn.

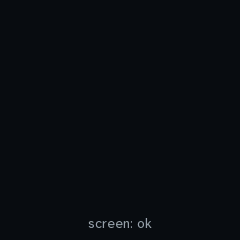
[picture p105: docs/quorum-ui/v2/boot/mark-eth.gif]


| | |
|---|---|
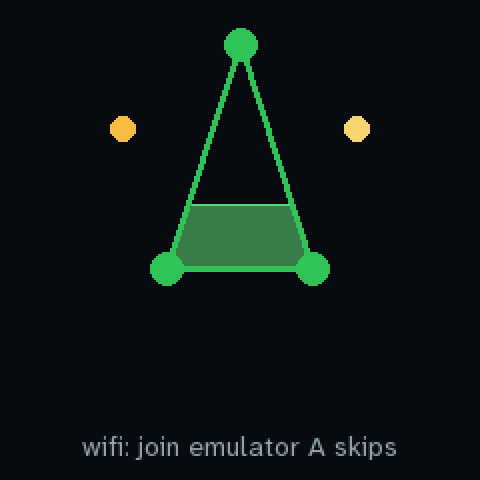
[picture p106: docs/quorum-ui/v2/boot/mark-eth-050.png]
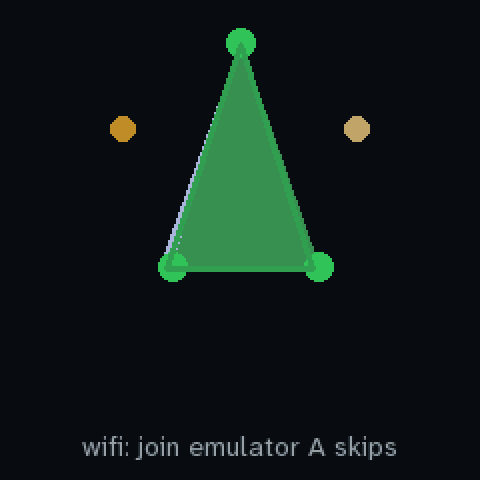
[picture p107: docs/quorum-ui/v2/boot/mark-eth-062.png]
|  |  |
| **1.5 s: the quorum.** Three signed, the triangle filling. The signatures now come 0.3 s apart (they were 0.5 s), with no holds. | **1.9 s: no beat.** The filled triangle *is* the diamond's front face seen head-on. It brightens and starts to turn. |
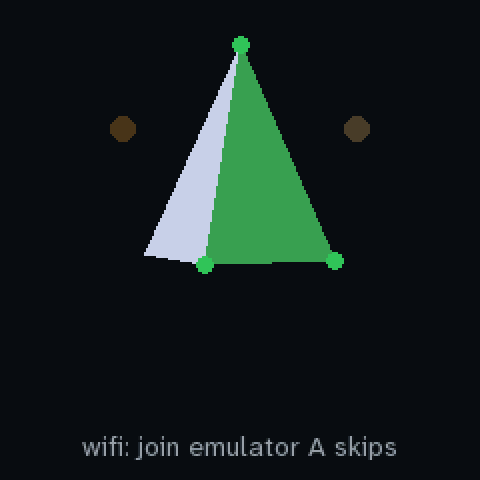
[picture p108: docs/quorum-ui/v2/boot/mark-eth-067.png]
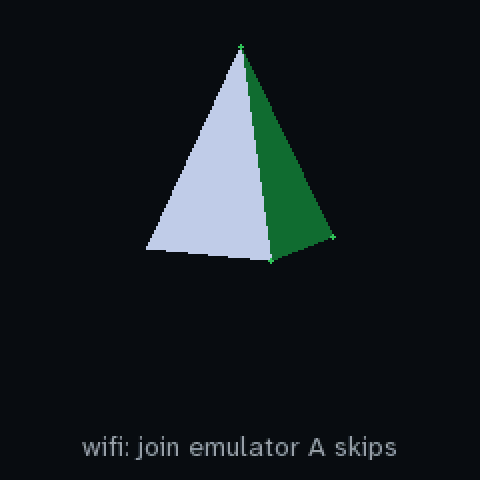
[picture p109: docs/quorum-ui/v2/boot/mark-eth-072.png]
|  |  |
| **2.0 s: it turns.** The signers ride its corners and shrink away, and the two who didn't sign fade out. | **2.2 s: the green face goes round the side** as the camera rises to the logo's 30°. |
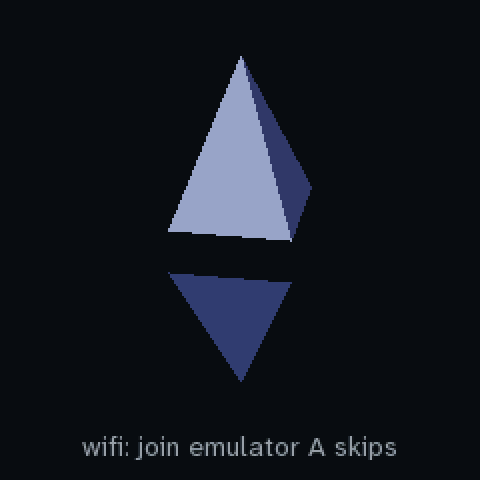
[picture p110: docs/quorum-ui/v2/boot/mark-eth-084.png]
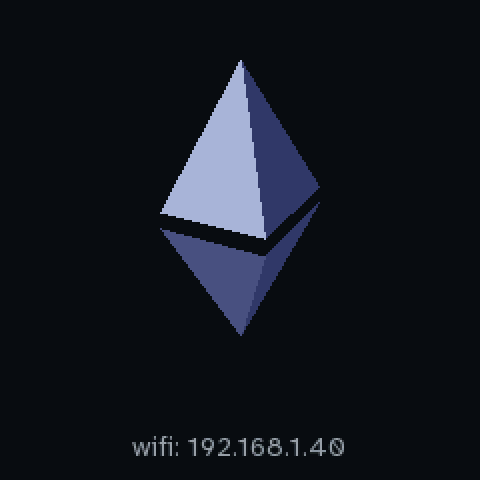
[picture p111: docs/quorum-ui/v2/boot/mark-eth-092.png]
|  |  |
| **2.5 s: all Ethereum blue,** and the lower pyramid rises in. | **2.8 s: the logo,** spinning. |
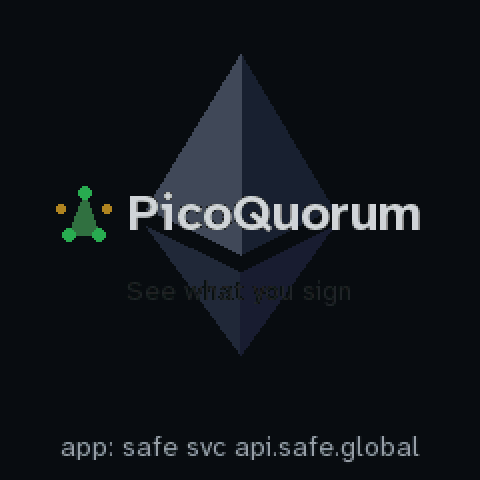
[picture p112: docs/quorum-ui/v2/boot/mark-eth-110.png]
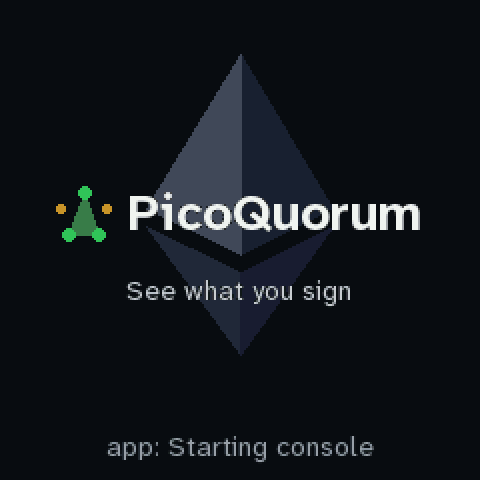
[picture p113: docs/quorum-ui/v2/boot/mark-eth-150.png]
|  |  |
| **3.3 s:** it slows, grows and dims, and **the small mark and Picoquorum fade in over it.** | **4.5 s:** the tagline, and the logo at rest on its own pose behind. |

The small mark is the boot screen in miniature: five owners, three signed in green, two amber,
their triangle.

On every panel (this is `BOOT_ART = "still"`, the end of it drawn at once):

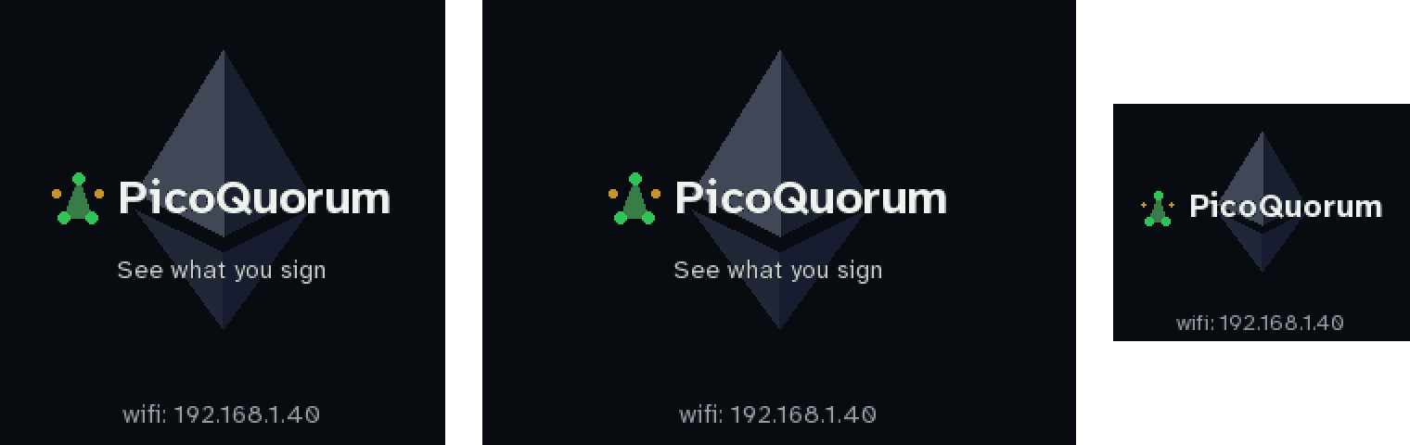
[picture p114: docs/quorum-ui/v2/boot/mark-eth-panels.png]


- **Length:** the logo is spinning by 2.8 s and the name is up by 3.4 s. Splash holds 3.7 s after
  the 0.3 s black (the corner version held 5.3 s and the plain mark 3.8 s). Any key still skips.
- **Cost:** each frame repaints the box the diamond was in and the box it's in now. While it's
  big and turning that's up to half the panel (58 KB), so this is heavier than the plain mark: 15%
  of what whole frames would send, against 6%. That's still about 6× lighter than the orbit. Once
  it lands, frames send nothing but the name's fade and the status line.
- **Why it stuttered on the board, and a faster boot:** the animation finishes as WiFi joins, about
  5.3 s after power-on. Then the console starts: `main.py`'s imports (1.1 s), and the chip checks.
  With the Trust M those were 6.7 s, all without a frame. Two pure-Python P-256 verifies of its
  factory certificate and key binding took 4.7 s, and the owner address (two keccaks) took 0.7 s.
  Both are now worked out once and remembered by a hash of exactly the bytes they're computed from
  (`tmproof.txt`, `owners.txt`). The same chip gives the same answer at once, and any change works
  them out again. The console is up about 7.8 s after power-on, down from about 13 s.
  `log.txt` has a `boot ms:` line each boot with where the time went.
- **The corner version is gone:** its pictures are replaced by these.

**Questions for you:**
1. **The turn:** three-quarters of a turn while it becomes the logo, coming to rest as the name
   fades in. Faster, slower? It could keep turning, but on the board that means a freeze while the
   console starts, unless the startup itself is reworked to hand back frames.
2. **Behind the name:** it dims to about a third. Brighter, so the logo reads more, or darker, so
   the name reads more?

## The light mark (2026-09-30): the loading screen the Pico can keep up with

The orbit redraws and sends the whole panel every frame: 100–130 ms a frame on the Pico
(8–10 fps), of which about 50 ms is just the 150 KB going over SPI to the 2.8". The new default
is the orbit's end mark on its own, drawn as flat shapes: five owners pop in, three sign (green,
a ring going out), their triangle closes and fills from the base, the two left out stay amber, and
Picoquorum fades in under it, then a tagline. The real boot status is the bottom line, as before.

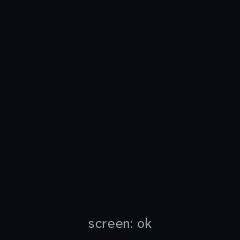
[picture p115: docs/quorum-ui/v2/boot/mark.gif]


**Why it's smooth:** each frame sends only what changed since the last one: a dot's square, an
edge as far as it has got, the rows the green rose through, the name while it fades, the status
line when it changes. Across the animation that's about 6% of the bytes whole frames would take;
the busiest frame is 26–30 KB and 17 of 131 frames send nothing. The drawing is a dozen framebuf
calls per rectangle, in C. Only the first frame paints the whole panel (about the cost of one orbit
frame). It lasts 3.8 s after a 0.3 s black lead-in (the orbit: 9.6 s after 4 s of black).

| | |
|---|---|
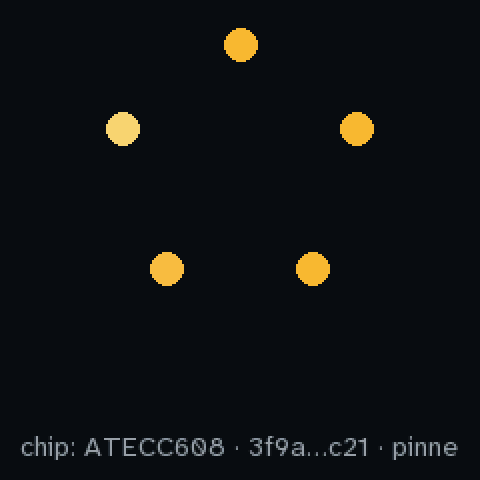
[picture p116: docs/quorum-ui/v2/boot/mark-025.png]
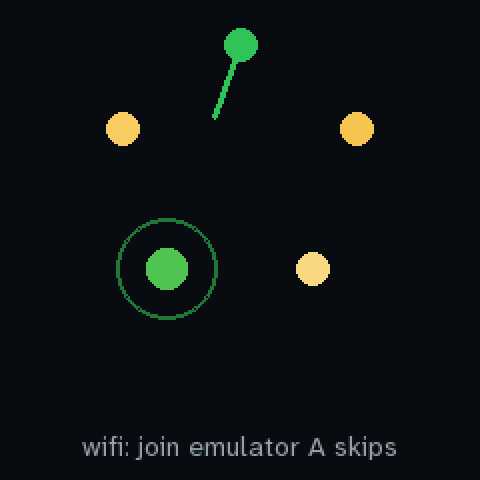
[picture p117: docs/quorum-ui/v2/boot/mark-045.png]
|  |  |
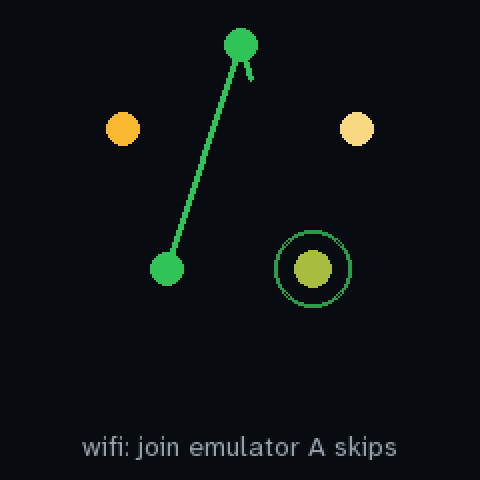
[picture p118: docs/quorum-ui/v2/boot/mark-060.png]
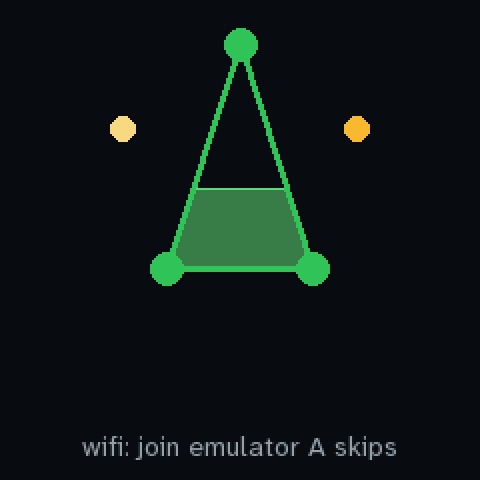
[picture p119: docs/quorum-ui/v2/boot/mark-085.png]
|  |  |
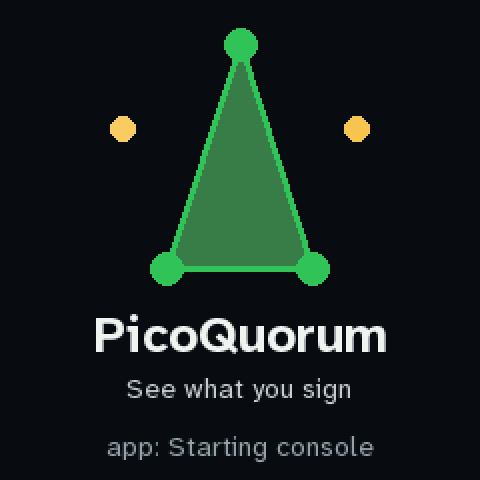
[picture p120: docs/quorum-ui/v2/boot/mark-130.png]
|  | |

It fits every panel we have, including the 1.8" (which had only the checklist; no room there for
a tagline):

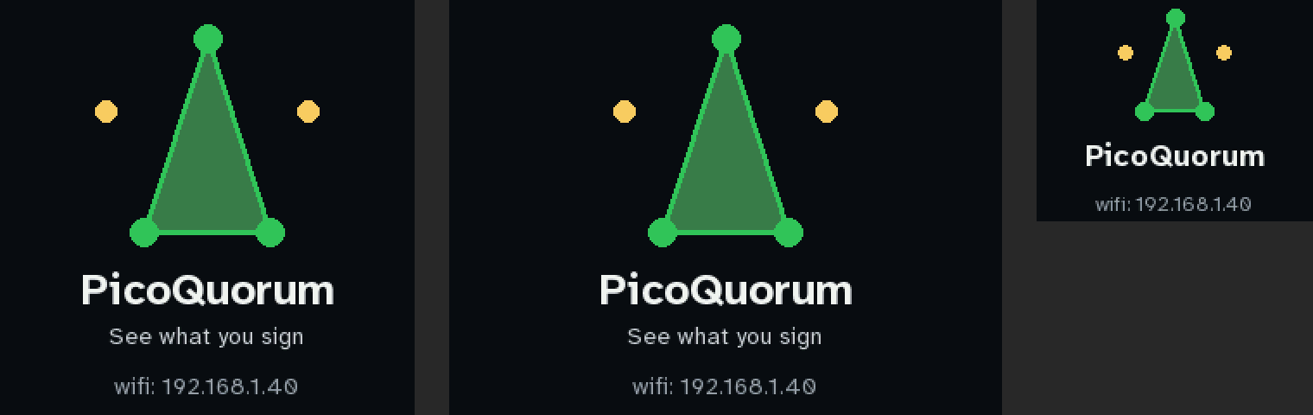
[picture p121: docs/quorum-ui/v2/boot/mark-panels.png]


**Taglines** ([`firmware/taglines.py`](../../../firmware/taglines.py)): one per boot on the mark,
cycling on the orbit. `secrets.BOOT_TAGLINES` picks `"serious"` (the default), `"fun"`, `"all"` or
`"none"`. The serious ones are claims about the console, so each has to stay true of the firmware
(the file says which code backs which claim). The fun ones are films and shows, cyberpunk and
the demoscene. Each fits 220 px; the test checks.

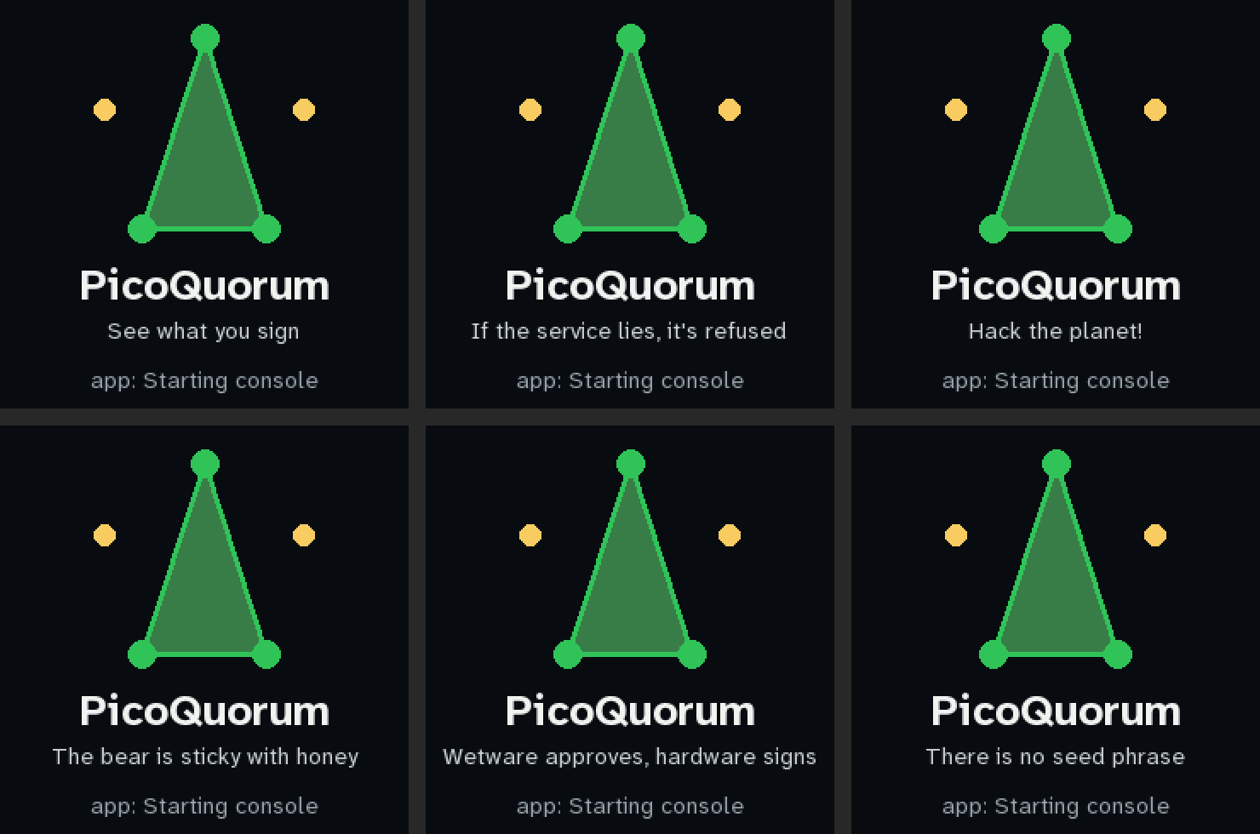
[picture p122: docs/quorum-ui/v2/boot/mark-taglines.png]


`secrets.BOOT_ART` picks the boot screen: `"mark"` (the default), `"still"` (the finished mark at
once, then only the status line changes), `"orbit"` (the full animation above) or `"checklist"`.
`node test-vectors/run-bootmark.mjs` checks that after every frame the panel equals the whole
scene painted afresh, on all three panels, and prints the bytes sent.

## Iteration 6 (2026-09-27): smooth all the way, filled from the bottom, a name in front

You asked:
- Fill the green from the bottom up, like it's being filled.
- It still felt herky-jerky, pausing at awkward spots. Make it feel like it's booting up
  smoothly.
- Keep the Ethereum diamond spinning. Put Picoquorum in front, with the diamond behind it, and a
  cycling tagline.

**Why it was jerky:** to give each boot step time on screen, the animation's clock *stopped*
before each signature. Anything mid-motion froze: a signing ring halfway out, a line partway
drawn, the green triangle dead still before it lurched into the turn. The orbit now has its own
clock that never stops. Between steps the waiting owners keep breathing, and every move eases in
and out.



This is the **lite GIF** (2026-09-28): the panel's own 240 px, 10 frames a second and 48
colours, 0.2 MB, for slower viewers. The full one, 360 px at 20 frames a second (1.1 MB), is
[here](boot/orbit.gif).

| | |
|---|---|
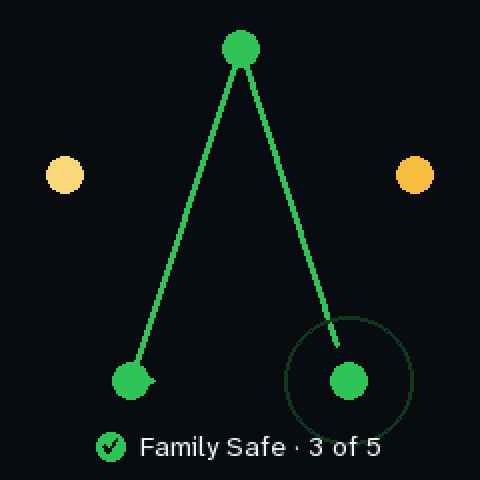
[picture p123: docs/quorum-ui/v2/boot/orbit-132.png]
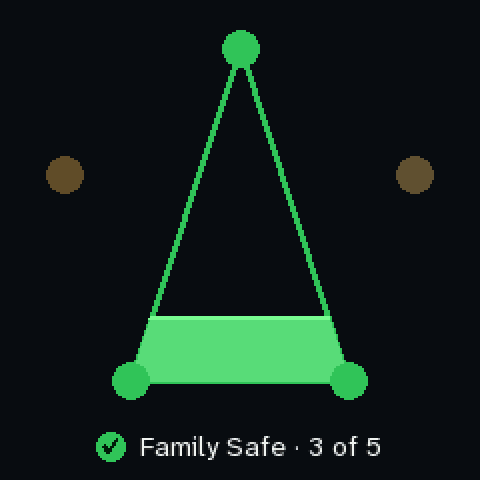
[picture p124: docs/quorum-ui/v2/boot/orbit-144.png]
|  |  |
| **Signing:** each ring now spreads out and fades smoothly (0.8 s), and each line eases in. | **Green fills from the bottom,** with a bright surface line, as the two who didn't sign fade. |
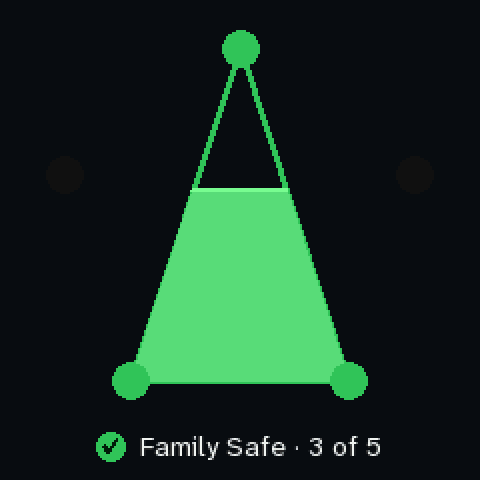
[picture p125: docs/quorum-ui/v2/boot/orbit-150.png]
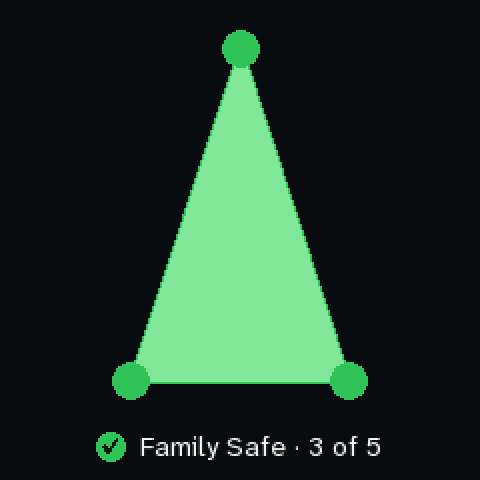
[picture p126: docs/quorum-ui/v2/boot/orbit-160.png]
|  |  |
| **Filling up:** 1.1 s, easing in and out. | **Full,** with a soft glow that swells and fades instead of a flash. |
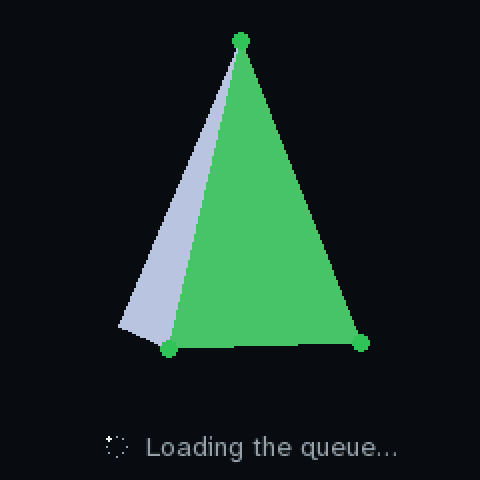
[picture p127: docs/quorum-ui/v2/boot/orbit-186.png]
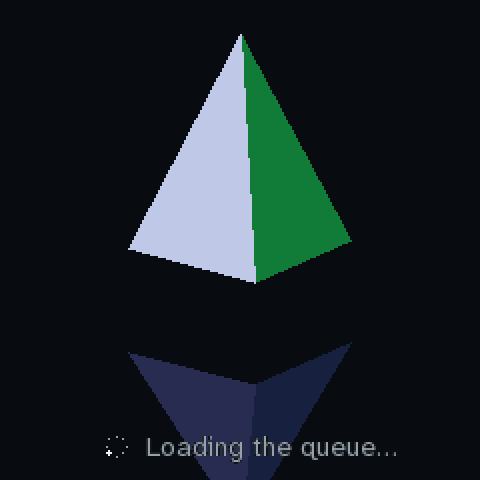
[picture p128: docs/quorum-ui/v2/boot/orbit-198.png]
|  |  |
| **It turns straight out of the glow:** one face of the pyramid, blue coming round. | **The green face turns away,** the inverted pyramid rises. |
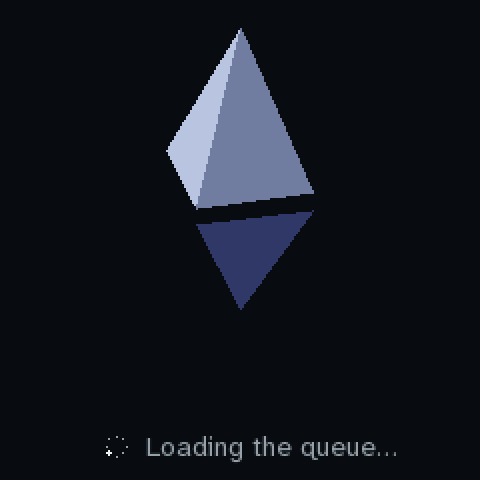
[picture p129: docs/quorum-ui/v2/boot/orbit-214.png]
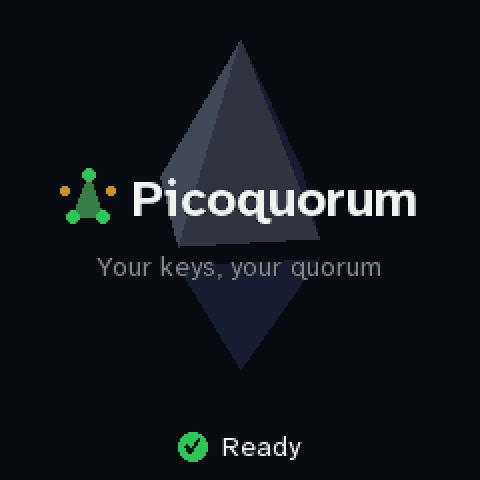
[picture p130: docs/quorum-ui/v2/boot/orbit-256.png]
|  |  |
| **The Ethereum diamond,** still spinning; it never stops now. | **Behind the name:** it grows, centres and dims, and **Picoquorum** comes up in front, with the quorum mark (five owners, three signed, their green triangle). |
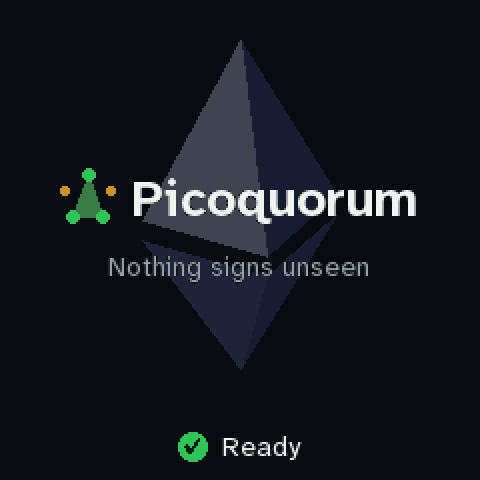
[picture p131: docs/quorum-ui/v2/boot/orbit-300.png]
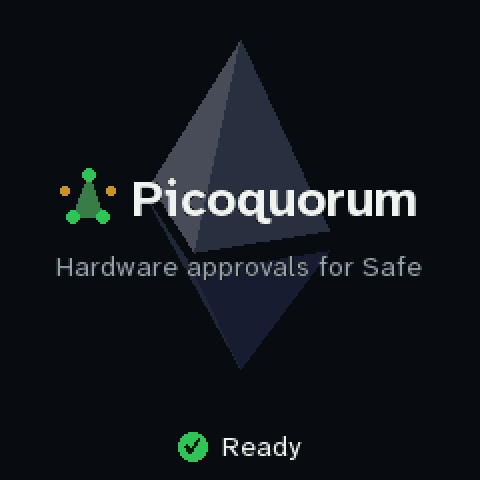
[picture p132: docs/quorum-ui/v2/boot/orbit-340.png]
|  |  |
| **Taglines cycle** under the name, about 2 s each… | **…and the diamond keeps turning** behind, slowly, for as long as the screen is up. |

- **Taglines** (placeholders, yours to rewrite): "Your keys, your quorum", "Nothing signs unseen",
  "Hardware approvals for Safe", "Every hash checked here".
- **The mark** next to the name is new: the boot screen in miniature. It could become the app
  icon and the home screen's corner mark.
- **Length:** 10.8 s to "Ready", then the name and taglines. The GIF runs 20 s to show all four
  taglines. On the device, the home screen would follow as soon as the queue loads.

**Questions for you:**
1. **The taglines:** keep, cut, or write your own? Cycle them, or pick one?
2. **The mark:** keep it next to the name, or just the word?
3. **On the device:** stay on the name until a button is pressed, or go straight to the queue
   when it's ready?

## Iteration 5 (2026-09-27): the green triangle, redone

You said the green triangle's timing felt awkward. Frame by frame, three things were off:
- **It faded up from black,** so for half a second it was a murky dark triangle, not a green one.
- **There was no beat.** It reached full green and started moving at once.
- **The whole pyramid went a washed-out teal** on the way to blue, because every face blended
  from green to blue at the same time.

Now:

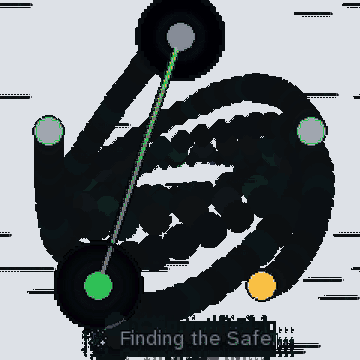
[picture p133: docs/quorum-ui/v2/boot/iter5/orbit.gif]


| | |
|---|---|
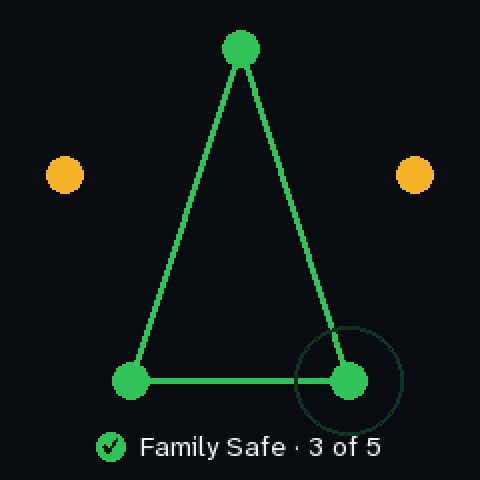
[picture p134: docs/quorum-ui/v2/boot/iter5/orbit-131.png]
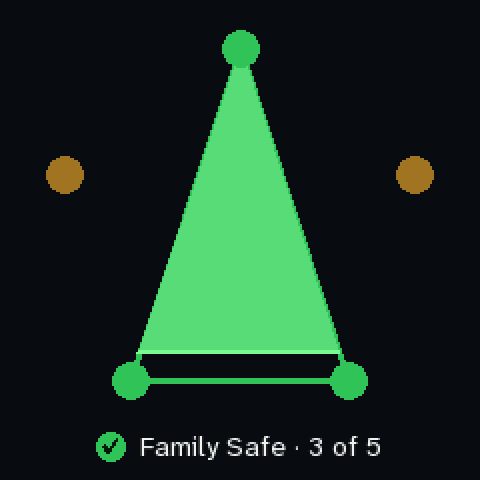
[picture p135: docs/quorum-ui/v2/boot/iter5/orbit-135.png]
|  |  |
| **The quorum closes.** | **Green pours in** from the tip, with a bright surface line, in a third of a second. |
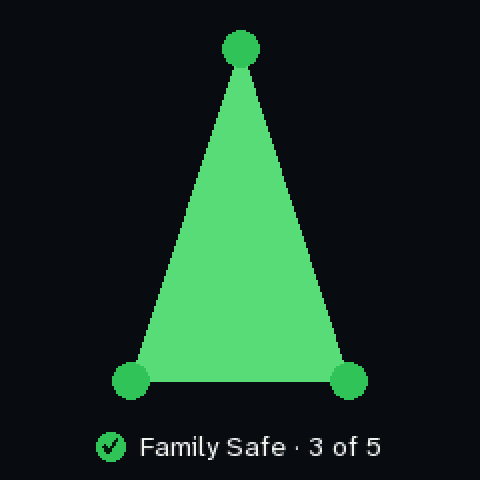
[picture p136: docs/quorum-ui/v2/boot/iter5/orbit-143.png]
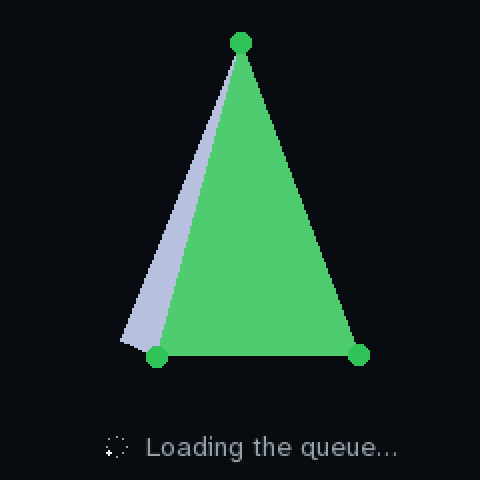
[picture p137: docs/quorum-ui/v2/boot/iter5/orbit-166.png]
|  |  |
| **A flash, then a beat:** it holds, solid green, for about a second. | **It turns, and it's one face of a pyramid.** The face coming round is Ethereum blue. |
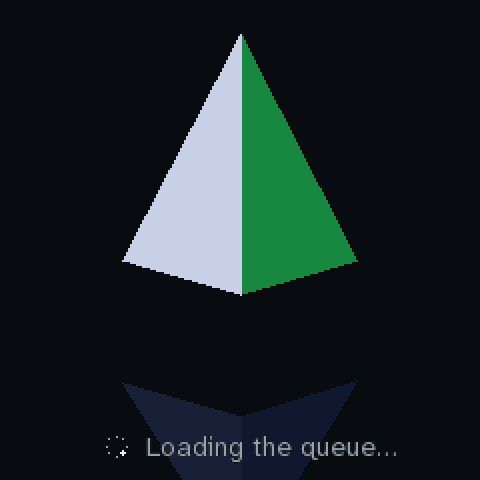
[picture p138: docs/quorum-ui/v2/boot/iter5/orbit-178.png]
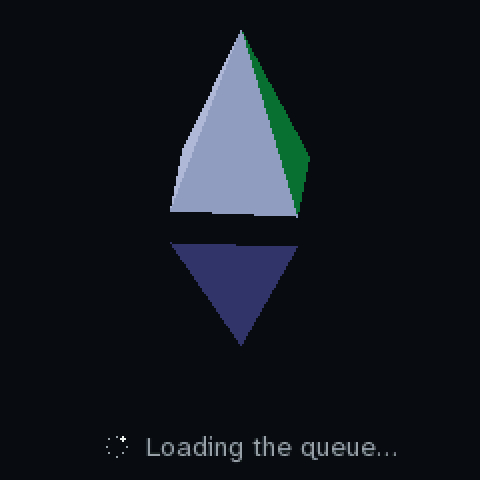
[picture p139: docs/quorum-ui/v2/boot/iter5/orbit-190.png]
|  |  |
| **The green face turns away** as the camera pulls back… | **…and goes out of sight.** Only blue is left, and the diamond settles as before. |

The first half (the orbit, the status line, the signatures) and the ending are iteration 4's.
The loading screen is 0.7 s longer (12.4 s) for the beat.

**Question for you:** is the beat the right length? About 1 s now (the pour, the flash and the
hold).

## Iteration 4 (2026-09-27): more time, a status line, green signatures

You asked:
- Spin the orbit for another cycle; the loading screen could use more time.
- Show what's happening at the bottom as it goes: joining WiFi, verifying the chip…
- Make the three signers green, start the solid triangle green, and blend it into the Ethereum
  logo.

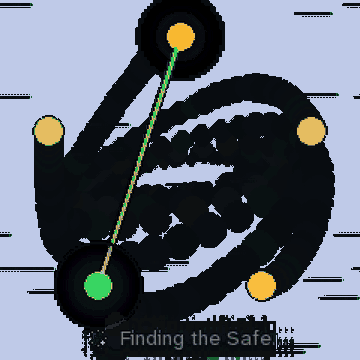
[picture p140: docs/quorum-ui/v2/boot/iter4/orbit.gif]


| | |
|---|---|
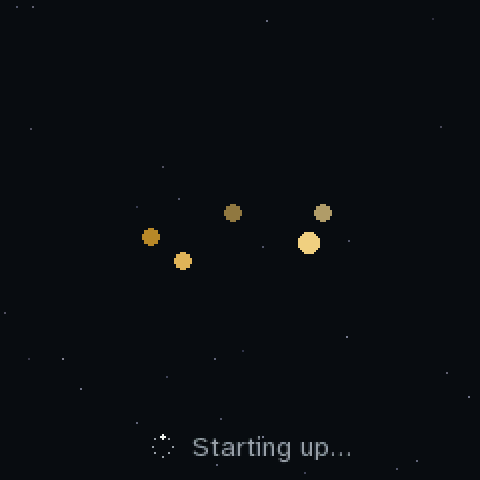
[picture p141: docs/quorum-ui/v2/boot/iter4/orbit-012.png]
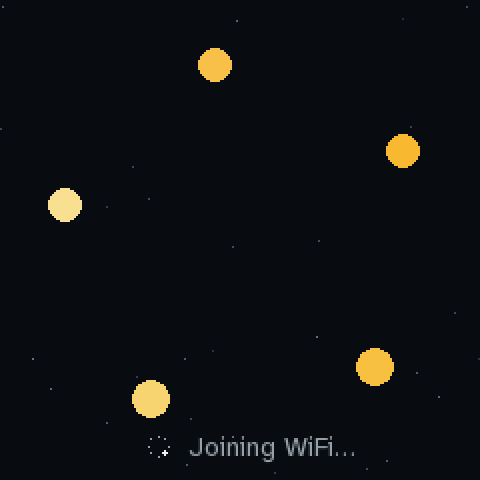
[picture p142: docs/quorum-ui/v2/boot/iter4/orbit-050.png]
|  |  |
| **Starting up.** Five owners far out in space. The orbit now takes 3.2 s and 2.4 turns (was 2.2 s and 1.4). | **Joining WiFi** while they swing round to face you. |
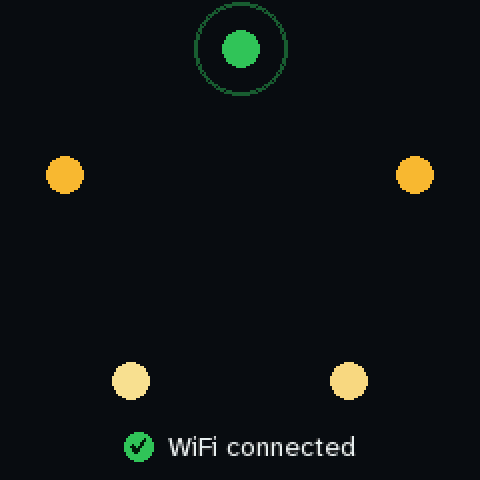
[picture p143: docs/quorum-ui/v2/boot/iter4/orbit-081.png]
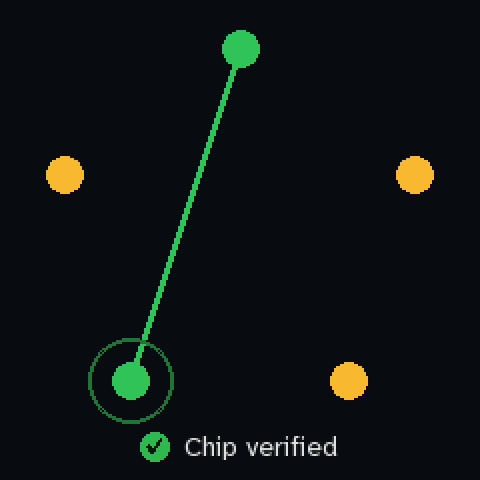
[picture p144: docs/quorum-ui/v2/boot/iter4/orbit-104.png]
|  |  |
| **WiFi connected: the top signs,** and turns green. Each step's line slides up and out as the next slides in. | **Chip verified: the bottom left signs,** with a green line to the top. |
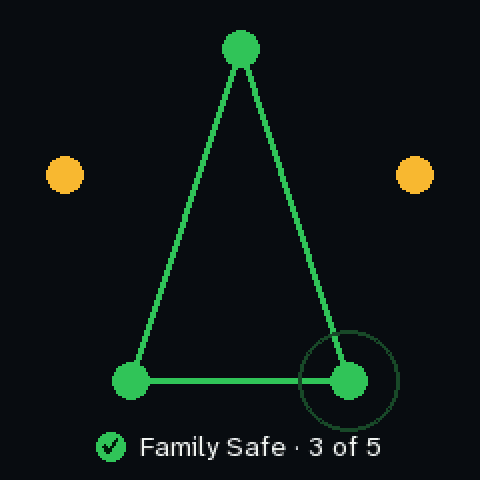
[picture p145: docs/quorum-ui/v2/boot/iter4/orbit-130.png]
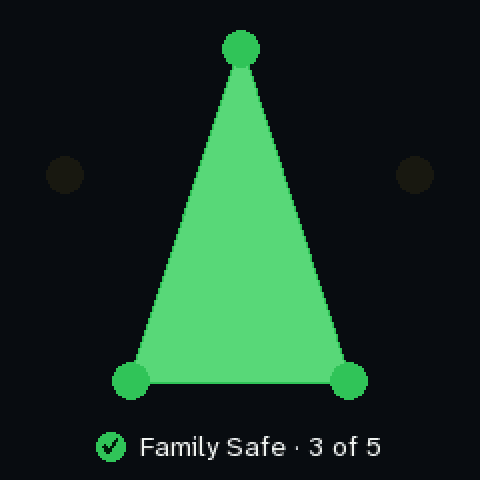
[picture p146: docs/quorum-ui/v2/boot/iter4/orbit-140.png]
|  |  |
| **The Safe found: the bottom right signs** and the triangle closes. "Family Safe · 3 of 5". | **The triangle turns solid green.** The two who didn't sign fade away. |
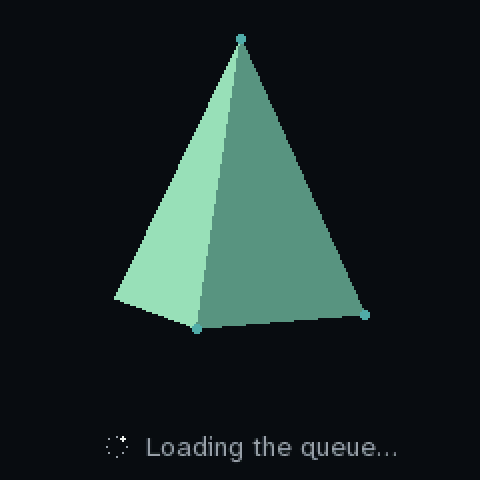
[picture p147: docs/quorum-ui/v2/boot/iter4/orbit-158.png]
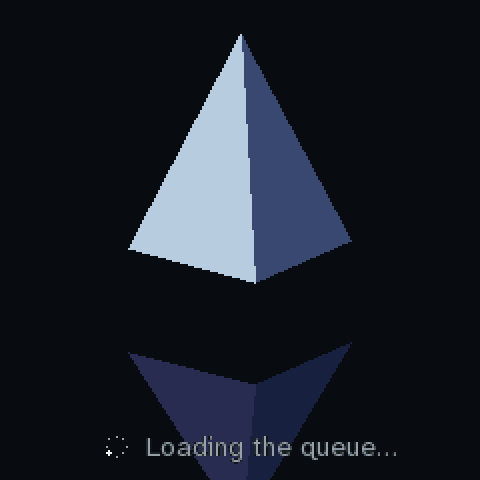
[picture p148: docs/quorum-ui/v2/boot/iter4/orbit-166.png]
|  |  |
| **Loading the queue:** the pyramid turns, and its green blends into Ethereum's blue… | **…and the inverted pyramid rises** underneath. |
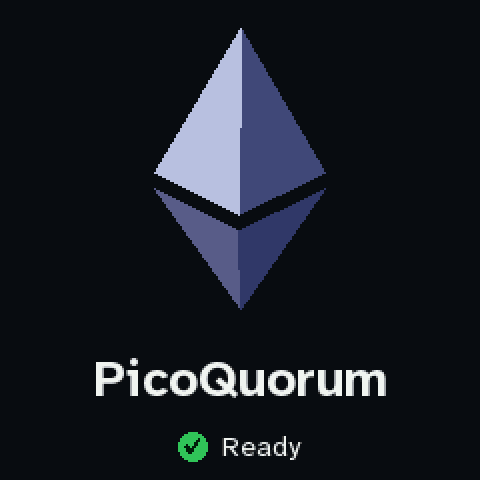
[picture p149: docs/quorum-ui/v2/boot/iter4/orbit-233.png]
|  | |
| **Ready.** The diamond lands on the logo's pose, with the name above the last line. | |

- **The status line** is one row at the bottom. A spinner and grey text mean working ("Joining
  WiFi…"); a green check and white text mean done ("WiFi connected").
- **Each signature is a boot step.** The timeline pauses before each one, so each step gets about a
  second. On the device the pauses would last as long as the real step does.
- **Green** is the theme's "signed" green (the SIGN bar, the checks), which also answers iteration
  1's question 1. The diamond is still Ethereum's blue.
- **The name** no longer has "3 of 5 · ready" under it; the status line says "Ready".
- **Length:** 11.7 s, up from 8.7 s. On the device, most of that would be real waiting anyway.

**Questions for you:**
1. **The wording:** "Starting up · Joining WiFi · WiFi connected · Checking the chip · Chip
   verified · Finding the Safe · Family Safe · 3 of 5 · Loading the queue · Ready". Change any of
   them? It could name the network ("Joining HomeNet") or the key ("Chip verified · 9fad2e82").
2. **Pauses:** about 1.2 s per step here. Faster, slower, or let the real boot decide (my
   suggestion)?

## Iteration 3 (2026-09-27): the orbit, just dots

You picked the orbit, without the circle. The orbit's path is gone, and so is the faint circle the
owners landed on. There are only five dots, then only the triangle of the three who sign. The
pictures for this iteration were replaced by iteration 4's, which builds on it.

## Iteration 2 (2026-09-27): no star, two ways in

You asked: the star could read as a pentagram. Drop it, and have the five owners spin in a
circle or in space, then carry on to the top and the two bottom ones and the Ethereum diamond.

There are two options. Both end with the owners exactly where the star had them. From there it's
iteration 1 unchanged, minus the star's lines: the three sign, the triangle closes, and the
diamond spins.

| **A. Ring** | **B. Orbit** |
|---|---|
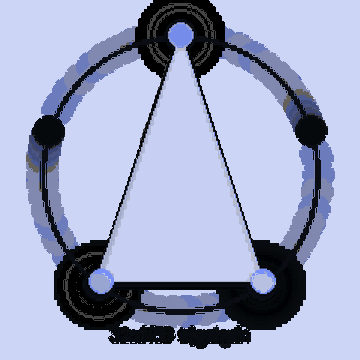
[picture p150: docs/quorum-ui/v2/boot/ring.gif]
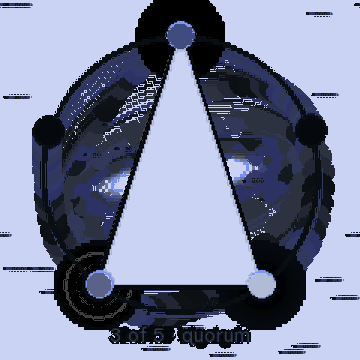
[picture p151: docs/quorum-ui/v2/boot/iter2/orbit.gif]
|  |  |
| Five owners spin round a faint circle, each trailing a comet tail of light. They slow down and stop with one at the top. Flat and simple, like a dial settling. | Five owners orbit in space: the circle starts small and tipped back like a planet's ring, with a few stars drifting behind. It swings round to face you and grows as it slows, and the stars fade out as it lands. |

| | | |
|---|---|---|
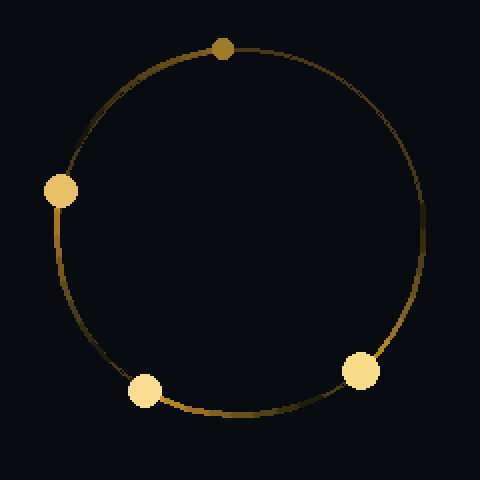
[picture p152: docs/quorum-ui/v2/boot/ring-008.png]
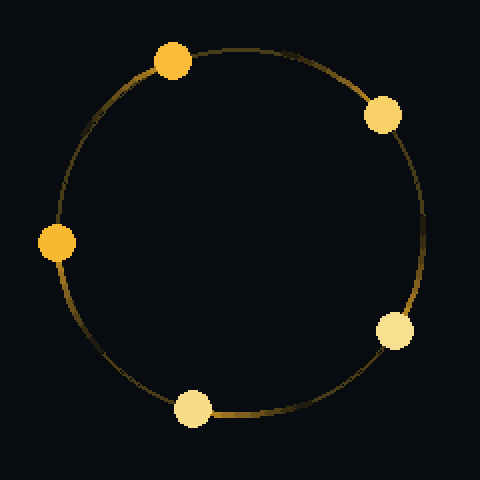
[picture p153: docs/quorum-ui/v2/boot/ring-016.png]
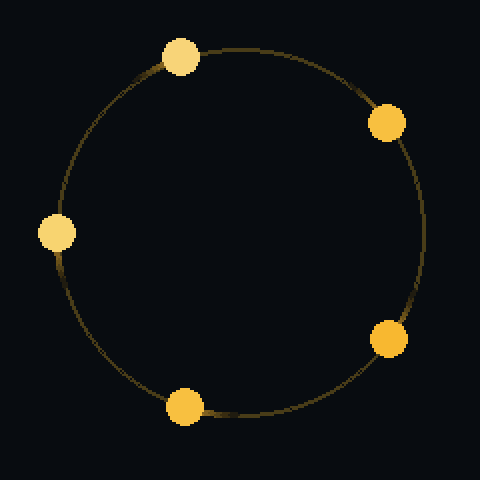
[picture p154: docs/quorum-ui/v2/boot/ring-026.png]
|  |  |  |
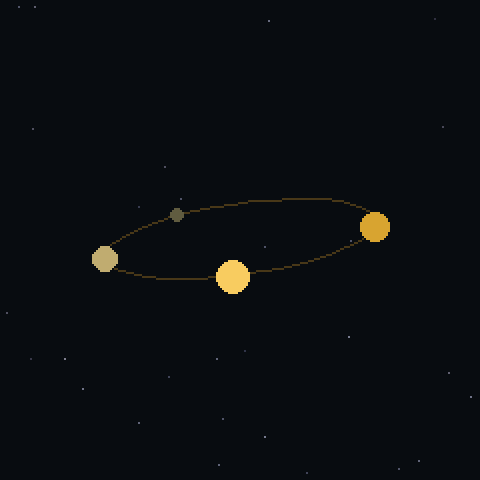
[picture p155: docs/quorum-ui/v2/boot/iter2/orbit-008.png]
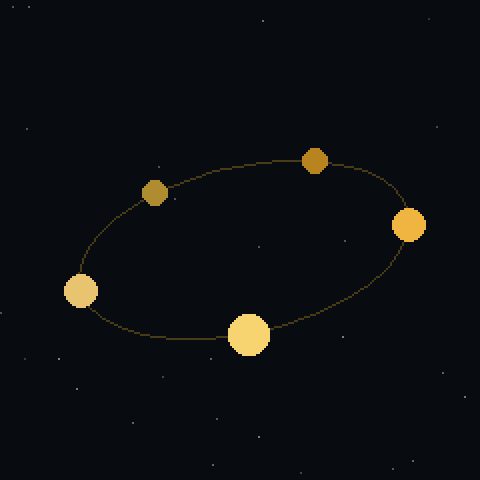
[picture p156: docs/quorum-ui/v2/boot/iter2/orbit-016.png]
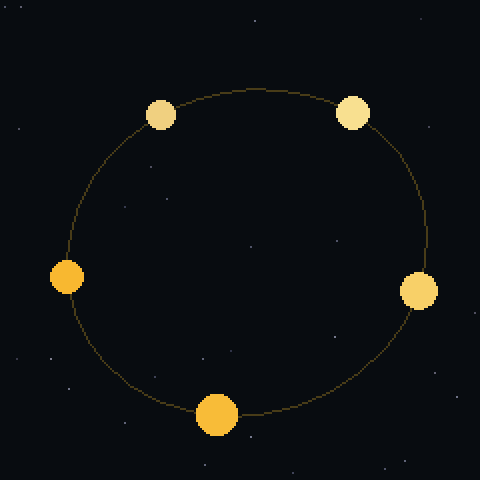
[picture p157: docs/quorum-ui/v2/boot/iter2/orbit-026.png]
|  |  |  |

Both land here, and the signing starts:

| | |
|---|---|
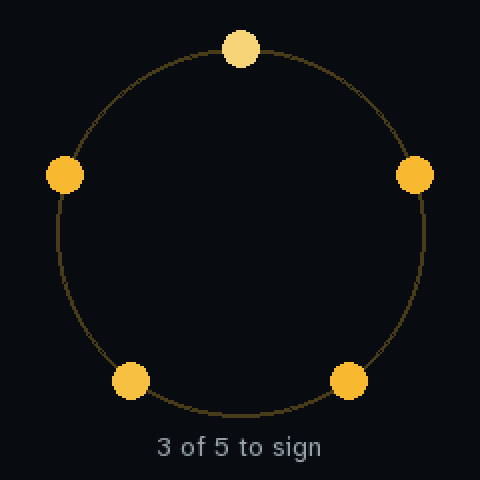
[picture p158: docs/quorum-ui/v2/boot/ring-040.png]
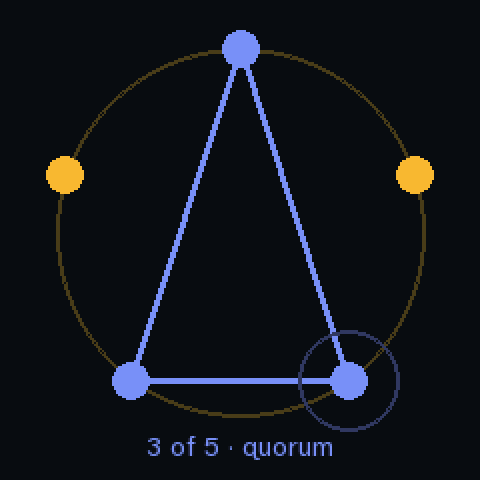
[picture p159: docs/quorum-ui/v2/boot/ring-066.png]
|  |  |
| **Landed.** Five amber owners on a faint circle, no lines between them. | **Quorum.** The top and the two bottom ones sign; only their triangle is drawn. The circle fades out with the two who didn't sign. |

- **What stays:** the three signers, the triangle, the pyramid and the spinning diamond are all
  iteration 1's. Only the first 2 seconds change.
- **Length:** the ring takes 2 s to land and the orbit 2.2 s, so each runs about a second longer
  than the star did (8.5 s in all).
- **The star is still in the sketch** as a third option, so iteration 1's GIF below can be
  regenerated.

**Questions for you** (answered: the orbit, just dots):
1. **Ring or orbit?** I lean to the **orbit**: it has more depth and matches the 3D diamond it
   becomes. The ring is calmer and cheaper to draw on the Pico.
2. **The faint circle:** keep it (it says "these five belong together"), or just the five dots?

## Iteration 1 (2026-09-26): star to Ethereum

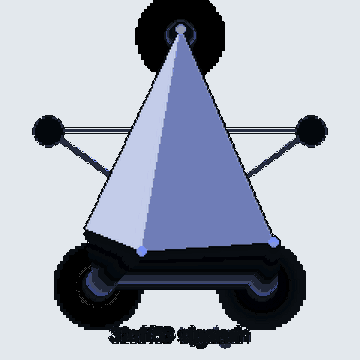
[picture p160: docs/quorum-ui/v2/boot/star.gif]


`emu/sketches/ethboot.py`, 150 frames at the firmware's 50 ms tick (7.5 s, then the last frame
holds). `tools/emu run ethboot` plays it in the emulator; A replays it.

### Frame by frame

| | |
|---|---|
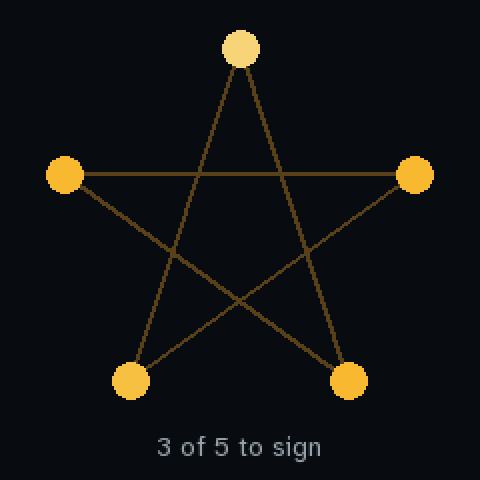
[picture p161: docs/quorum-ui/v2/boot/star-020.png]
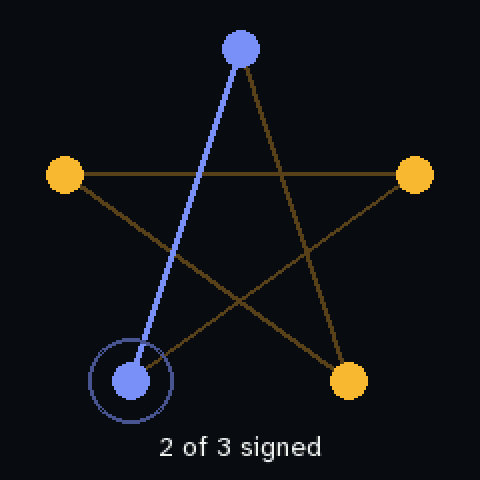
[picture p162: docs/quorum-ui/v2/boot/star-035.png]
|  |  |
| **Five owners, ready.** A pen draws the star in one stroke, and each owner appears as it gets there. All five are amber, which means they can sign but haven't. The ones still waiting breathe slowly. | **Signing.** The top signs, then the left leg. Each one turns Ethereum blue and sends out a ring, and a blue line joins it to the top. |
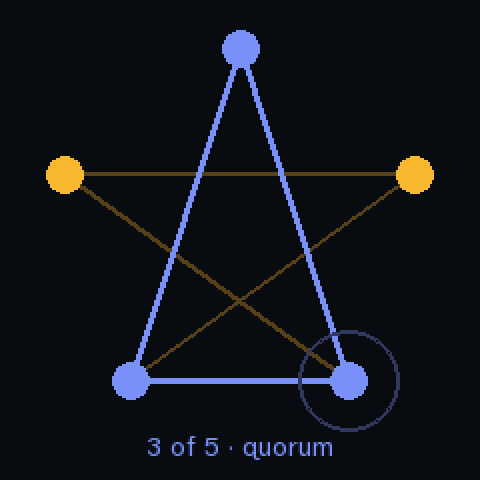
[picture p163: docs/quorum-ui/v2/boot/star-046.png]
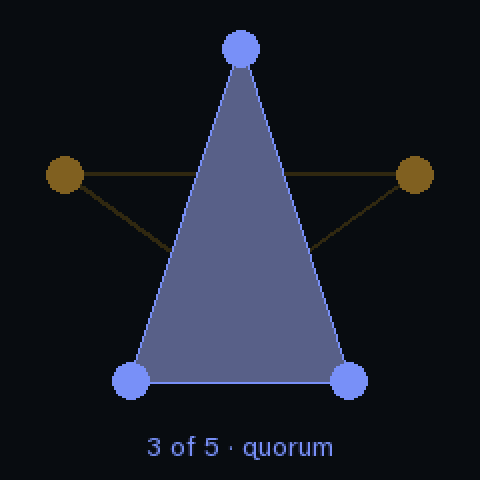
[picture p164: docs/quorum-ui/v2/boot/star-052.png]
|  |  |
| **Quorum.** The right leg signs and the base closes. That's the tall triangle made by the star's top and legs (36° at the tip). The two owners who didn't sign start to fade. | **The triangle fills in.** It's about to become a solid face. |
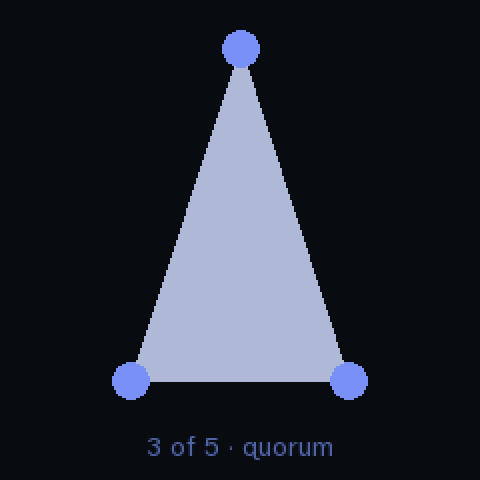
[picture p165: docs/quorum-ui/v2/boot/star-058.png]
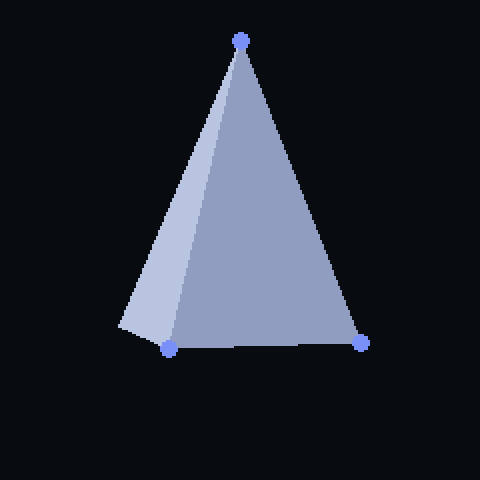
[picture p166: docs/quorum-ui/v2/boot/star-070.png]
|  |  |
| **It's a pyramid, seen head-on.** The filled triangle is exactly one face of a square pyramid. The three signers sit on its tip and its two front corners. | **The camera pulls back and rises**, and the pyramid starts to turn. The signers ride their corners, then shrink away. |
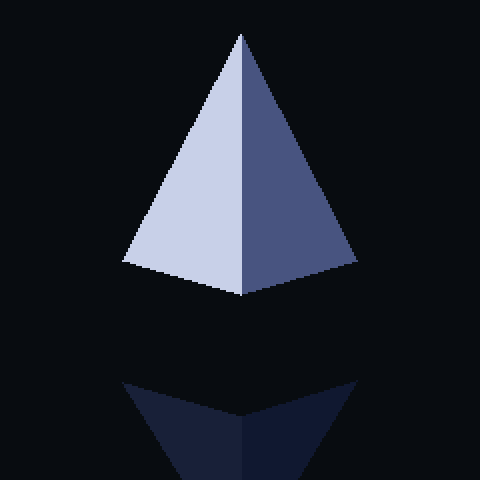
[picture p167: docs/quorum-ui/v2/boot/star-080.png]
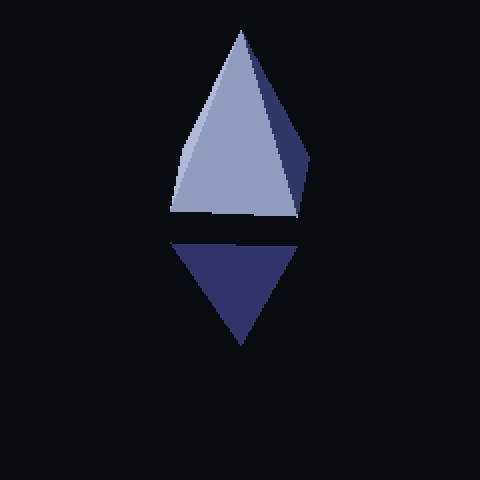
[picture p168: docs/quorum-ui/v2/boot/star-092.png]
|  |  |
| **The inverted pyramid rises** underneath, fading in from dark blue. | **The Ethereum diamond,** spinning on its axis. The gap between the two halves stays an even band at every angle. |
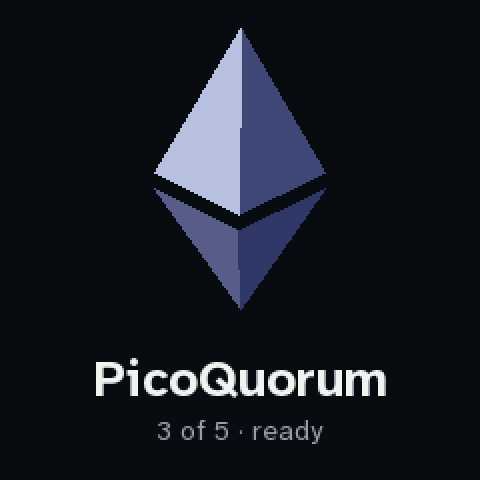
[picture p169: docs/quorum-ui/v2/boot/star-149.png]
|  | |
| **It slows to a stop** with a corner toward you: the logo's own pose. Then the name comes up. | |

### How it's drawn

- **The star** uses lines and filled circles, the same as the v1 option.
- **The diamond** is ten 3D points, turned and projected each frame. It's drawn as flat-shaded
  triangles with `framebuf.poly` (which runs in C), back faces dropped, far faces first. That's at
  most four triangles a frame, so it should cost about what the v1 Quorum option did on the board
  (54 ms a frame, most of it the 46 ms push to the panel). Not timed on the chip yet.
- **It lands on the logo whatever the speed.** A square pyramid looks the same every 90°, so the
  spin can run as long as the boot takes and still stop on a corner (45° + any number of quarter
  turns).
- **The handoff is exact.** The pyramid starts with the star triangle's proportions, so its face
  seen head-on *is* that triangle. It widens a little (0.33 → 0.37 half-base per
  unit of height) as it turns, to match the logo.
- **Colours:** amber (the theme's `warn`) means ready to sign. Signed is Ethereum's periwinkle
  (#627EEA) lifted to `(122, 146, 255)` so it reads on near-black. The diamond is shaded from dark
  indigo to pale lavender, lit from the upper left.
- **The shape is drawn here, not copied.** It's two pyramids built from points, not the
  Ethereum Foundation's artwork. Still, it's meant to read as their mark, so check their brand
  guidance before anything ships.

### What I'd change next (your call)

- **Jagged edges.** `framebuf.poly` doesn't anti-alias. At 2× in the GIF the steps show; on the
  1.3″ screen (about 260 pixels per inch) they're small. A cheap fix is a 1-pixel edge in an
  in-between colour.
- **A glint.** A highlight sweeping across the diamond once it lands.
- **The "not signed" owners** just fade out. They could slide back into the dark instead.
- **Timing.** The whole thing is 7.5 s. On the device, the star part would take as long as the
  real boot steps (see below), and the spin could be shorter once it's ready.

### Questions for you

1. **Blue or green for "signed"?** Ethereum blue ties it to the diamond. Green is what "signed"
   means on every other screen (the SIGN bar, the check marks).
2. **Amber means two things now.** Here it's "ready to sign". On the approval screens amber means
   caution (a yellow page). Keep amber here, or use something neutral (white, grey) for waiting?
3. **3 of 5, always?** The demo Family Safe is 2 of 3. Options:
   - The star is the brand mark and always 3 of 5, and only the line under the name shows the real
     Safe ("2 of 3 · ready").
   - Or draw the real Safe's owners (M points, the first N light up). But only 3 of 5 makes the
     triangle that becomes the diamond.
4. **Ethereum, or the chain it's on?** The Safe might live on Base. Keep the diamond regardless
   (it's all Ethereum), or end on the chain's own mark?

## On the device

This is a proposal; none of it is wired up yet. Today `firmware/splash.py` draws the boot checklist.

| Boot step | What it shows (status line in quotes) |
|---|---|
| Screen up | the five owners spin in and land, all amber: "Starting up", "Joining WiFi" |
| WiFi joined | the top signs: "WiFi connected", then "Checking the chip" |
| The chip answers with its key | the bottom left signs: "Chip verified", then "Finding the Safe" |
| The Safe found, through the service | the bottom right signs, the triangle closes and turns green: "Family Safe · 3 of 5" |
| Loading the queue | the diamond spins, as long as it takes: "Loading the queue" |
| Ready | it lands on the logo: "Ready", and the home screen follows |

- **If a step fails,** that owner turns red and the error goes where the name would be, like the
  checklist's error line today.
- **To try it on the board** without changing `main.py`: `tools/emu ship ethboot`. I haven't
  timed it on the chip yet.

## Type and graphics: where to go next

Today (v1, iteration 2): Atkinson Hyperlegible Next and Mono, seven sizes, rendered on the laptop
by `tools/fonts/gen.py` and drawn by the Pico with 16 levels of anti-aliasing. It was picked for
telling 0/O and 1/l/I apart, which matters on a device for comparing addresses. So:

- **Keep a hyperlegible mono for addresses and hashes,** whatever else changes.
- **A display face for names and headlines** is where the "better fonts" can come from. These are
  all open-licence and `gen.py` can render any of them. I'd put these side by side on the real
  screen:
  - **Inter Display + Inter.** Neutral, very clear at small sizes.
  - **Space Grotesk + JetBrains Mono.** More character, a bit "crypto".
  - **IBM Plex Sans + Plex Mono.** Engineered, calm.
  - **Manrope.** Round and friendly, with Atkinson Mono kept for addresses.
- **Graphics from the boot screen:**
  - The approvals row (`1 of 2 ● Alice ○ Bob ○ You`) becomes a small star or polygon of the
    Safe's owners.
  - Signing plays the ring and the colour change from the boot screen.
  - The home screen's corner carries a small still of the diamond.

## Run it yourself

```sh
tools/emu run ethboot                                   # play it in the emulator; A = next option
tools/bootgifs --sketch ethboot --stills 8,16,26 orbit  # an option's GIF and stills
tools/bootgifs --sketch ethboot --lite orbit            # plus orbit-lite.gif: 240 px, 10 a second
tools/emu ship ethboot                                  # a one-off run on the Pico
```

`tools/bootgifs` now takes `--sketch`, `--out` and `--stills`. It also builds each GIF's palette
from frames across the whole animation instead of only the last one. That kept the amber here, and
it gave the v1 hash-rain GIF back the blue it had lost.

## Change requests

Edit this list on GitHub: add a line, tick one off, or write under it. Each iteration starts here.

- [x] A new boot screen: a 3-of-5 star, the top and legs sign, the triangle becomes the top of a
      rotating Ethereum diamond (iteration 1)
- [x] Fonts: candidates side by side on real screens ([FONTS.md](FONTS.md))
- [x] The star can read as a pentagram: the five owners spin in on a ring or an orbit instead
      (iteration 2)
- [x] Pick the ring or the orbit: the orbit, just dots, no circle (iteration 3)
- [x] Orbit one more turn, more time overall (iteration 4)
- [x] A status line at the bottom: joining WiFi, checking the chip… (iteration 4)
- [x] Signers green, the triangle solid green, blending into the Ethereum logo (iteration 4)
- [x] The green triangle's timing felt awkward: it pours in, holds a beat, and turns away as one
      face of the diamond (iteration 5)
- [x] Fill from the bottom up; smooth, no pauses; the diamond keeps spinning behind the name, with
      cycling taglines (iteration 6)
- [x] A light boot screen: the mark, sending only what changed (the light mark)
- [x] ~~After the mark, the spinning Ethereum diamond fades in and lands in the top-left corner~~
      (didn't work, dropped)
- [x] The light way, the original idea: the green triangle becomes the top of the Ethereum logo,
      which spins; the small mark and Picoquorum fade in over it; no pauses (the light mark turns
      into Ethereum)
- [ ] Pick a font set (FONTS.md, question 1)
- [ ] (add yours)
