jmcpheron/pico-quorum/docs/quorum-ui/feather/README.md

# The console on the Feather ESP32-S3 Reverse TFT

Written by `node tools/board/shots_feather.mjs`: the real firmware on the emulator, 240 × 135, three
buttons down the left edge (the grey dots: D0, D1, D2). The rail beside them says what each does here.

- **D0**: on home, the next tab (Queue, Owners, Key, Device); Reject on a review (one press, any page, even while Sign is held); Back anywhere else.
- **D1**: next page or row, round from the last to the first; held 1 s, the one before. On a review's first page, held: out without rejecting.
- **D2**: what the bar along the bottom says; on a review, the next page not yet seen, then Sign: held 2 s, 3 s when a page is red.

Each button works the strip level with it: D0 the tabs along the top, D1 the list, D2 the bar. The rail's icons:
→ next tab, ‹ back, ⌄ next, ● open or OK, ✕ reject, ✓ sign.

Every address on a review, and every owner, has its blockie: the picture Safe{Wallet} and Etherscan draw for it.
The Key tab shows the app's set-up link for the key as a QR code (docs/ONBOARDING.md).

### home

Home: four tabs, the Queue first. D0 moves to the next tab, D1 down the list and round (held: up), D2 does what the bar along the bottom says.

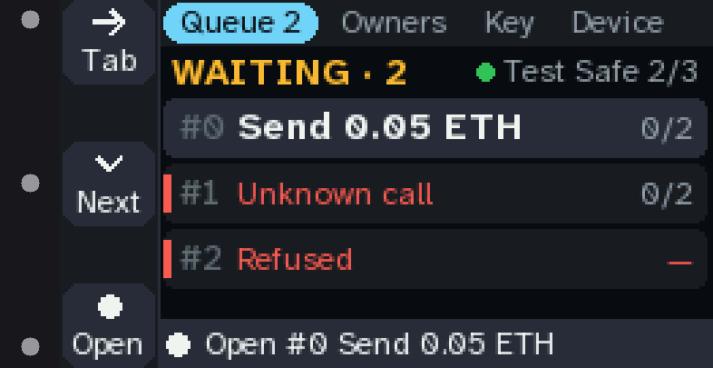
[picture p170: docs/quorum-ui/feather/01-home.png]
01-home


### home owners

The Owners tab: who can approve, each with a blockie. D2 shows the one in focus in full.

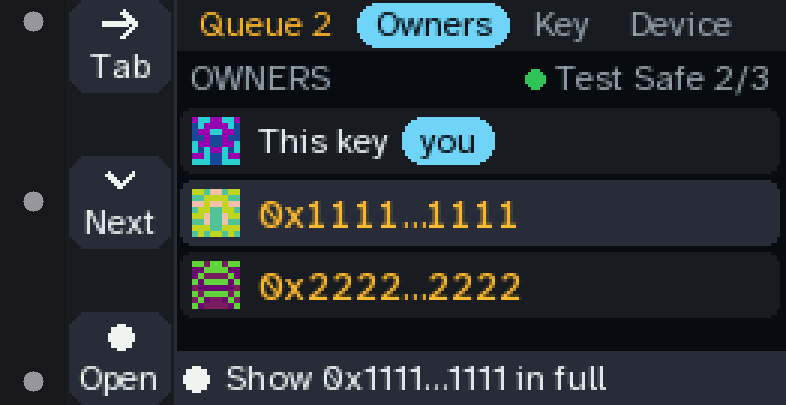
[picture p171: docs/quorum-ui/feather/02-home-owners.png]
02-home-owners


### owner

An owner in full, and its blockie. D0 back to the tab.

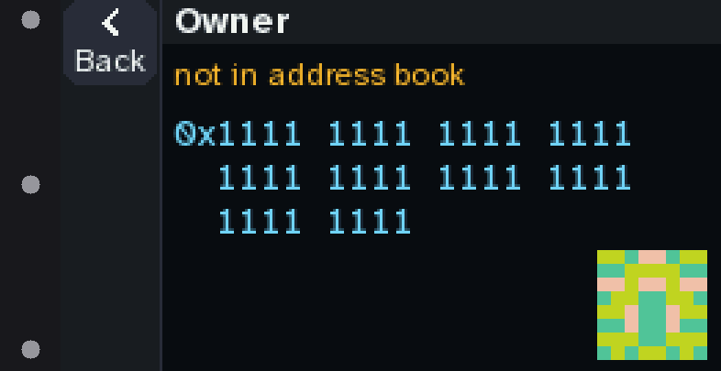
[picture p172: docs/quorum-ui/feather/03-owner.png]
03-owner


### home key

The Key tab: this key's fingerprint and picture, and whether the Safe lists it. D2 shows its code.

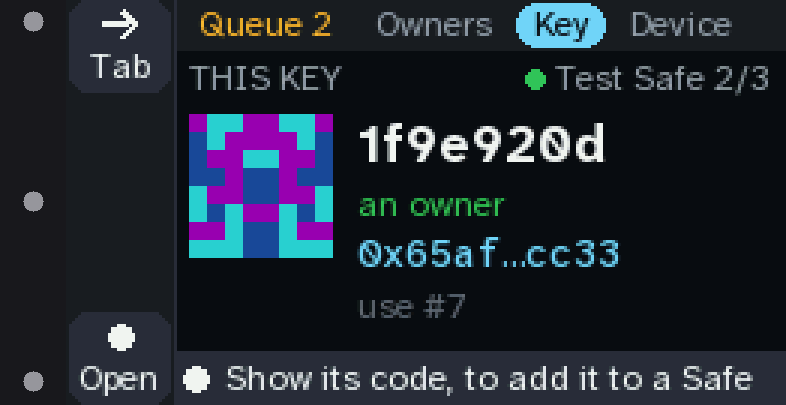
[picture p173: docs/quorum-ui/feather/04-home-key.png]
04-home-key


### home device

The Device tab: Chip, Wi-Fi, Practice and About, one row each.

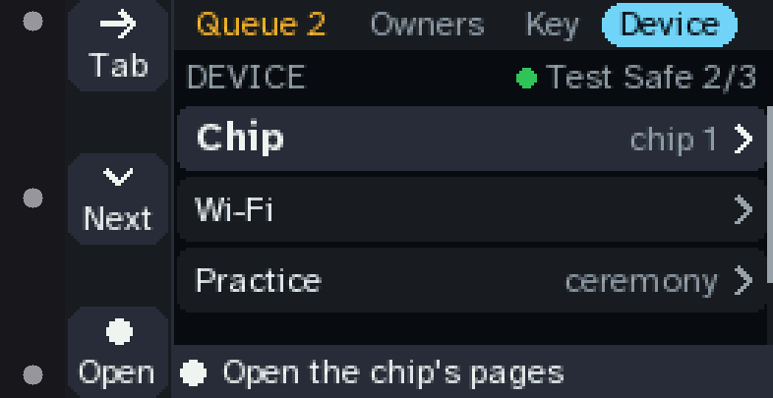
[picture p174: docs/quorum-ui/feather/05-home-device.png]
05-home-device


### review head

A review opens on what it does. Rail: Reject (one press, any page), Next, and "See 5": D2 shows the next page not yet seen.

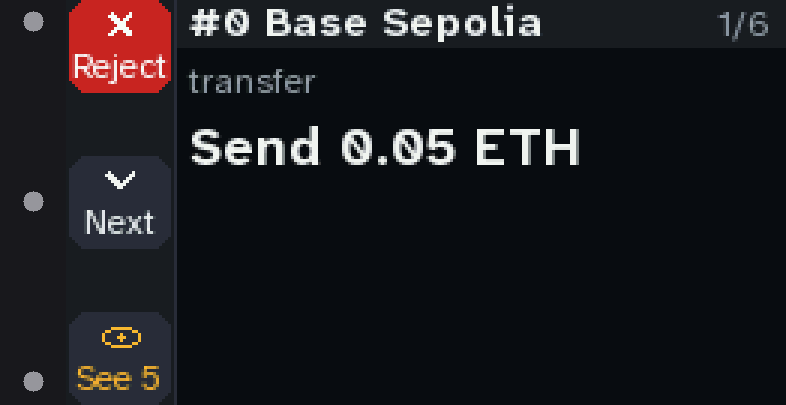
[picture p175: docs/quorum-ui/feather/06-review-head.png]
06-review-head


### review item

The send: the amount, big.

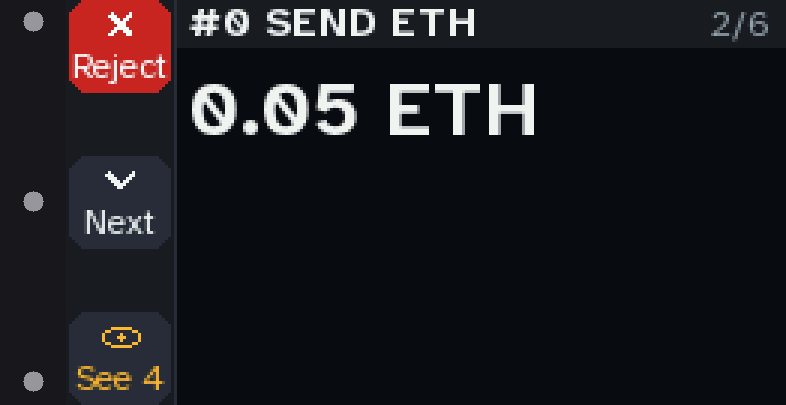
[picture p176: docs/quorum-ui/feather/07-review-item.png]
07-review-item


### review to

Who it goes to, the whole address in four-character chunks, and its blockie.

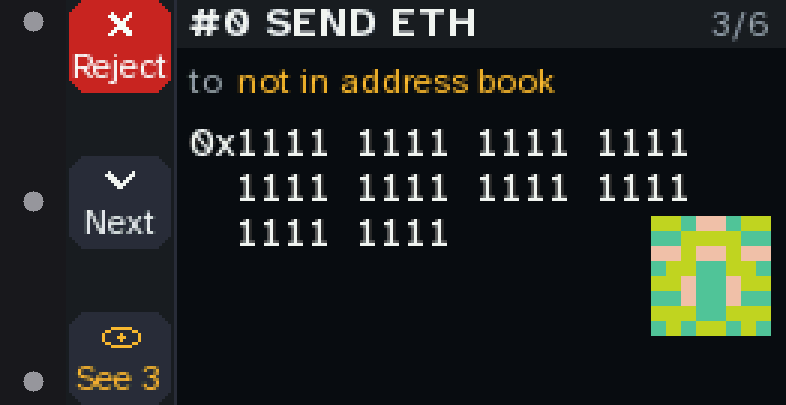
[picture p177: docs/quorum-ui/feather/08-review-to.png]
08-review-to


### review approvals

Who has approved, each owner's blockie beside it, and what this key's signature would make it.

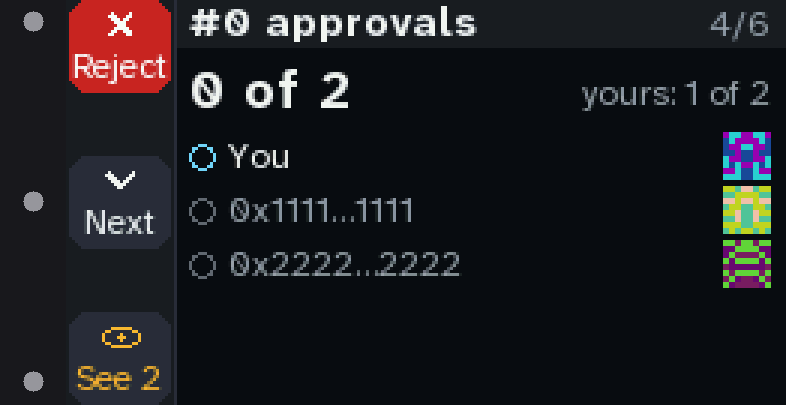
[picture p178: docs/quorum-ui/feather/09-review-approvals.png]
09-review-approvals


### review verify

The code to compare with the proposer: the hash's last 8, and its blockie.

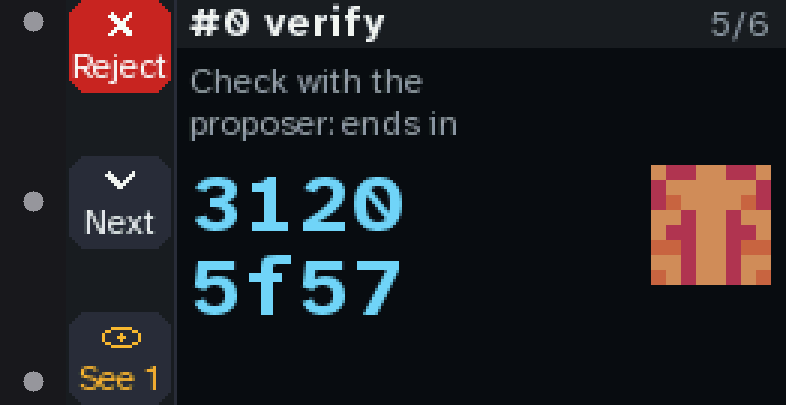
[picture p179: docs/quorum-ui/feather/10-review-verify.png]
10-review-verify


### review hash

The whole Safe transaction hash, worked out here. Every page seen: D2 says Sign.

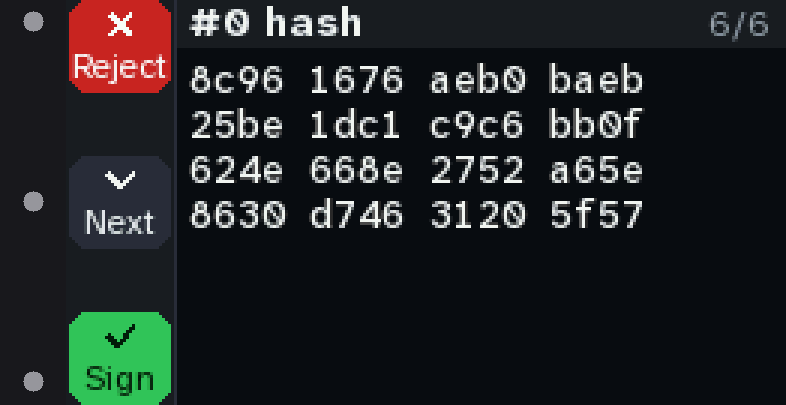
[picture p180: docs/quorum-ui/feather/11-review-hash.png]
11-review-hash


### hold

D2 held: the rail fills from the bottom. 2 s to sign; let go early and nothing is signed.

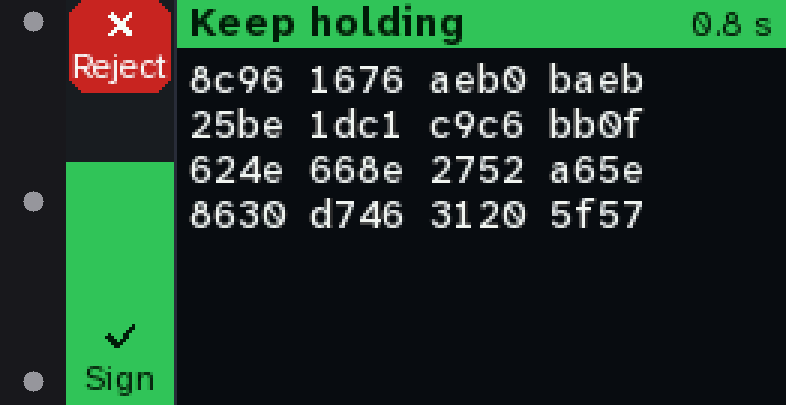
[picture p181: docs/quorum-ui/feather/12-hold.png]
12-hold


### red head

An unknown call: red. Sign takes a 3 s hold.

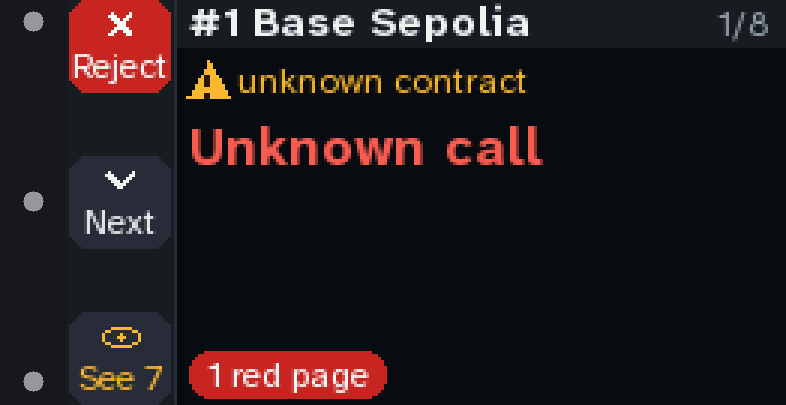
[picture p182: docs/quorum-ui/feather/13-red-head.png]
13-red-head


### red calldata

Its function selector and calldata size, on a red page.

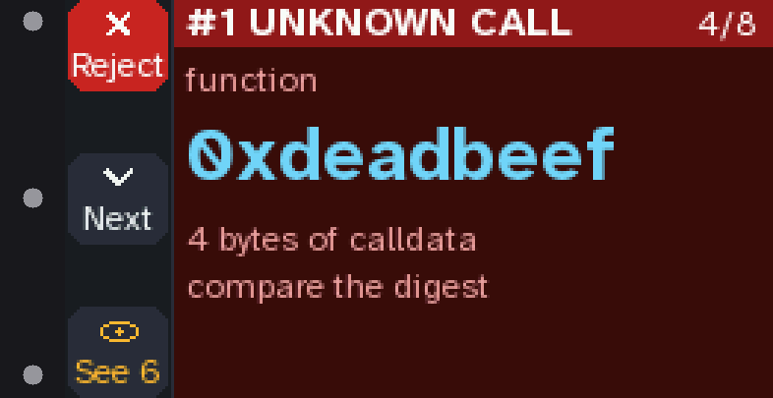
[picture p183: docs/quorum-ui/feather/14-red-calldata.png]
14-red-calldata


### red digest

The calldata's digest to compare.

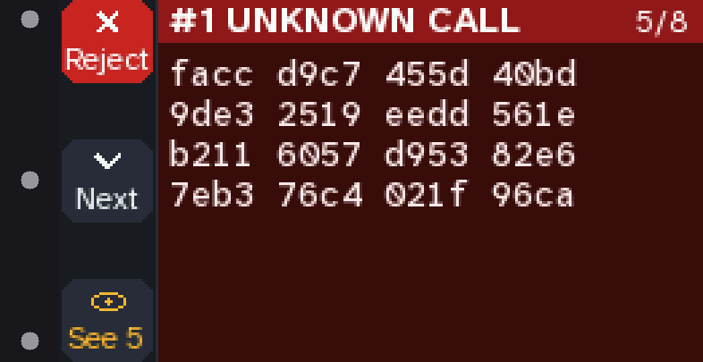
[picture p184: docs/quorum-ui/feather/15-red-digest.png]
15-red-digest


### red hold

Holding Sign on a red transaction: the rail fills in red, 3 s.

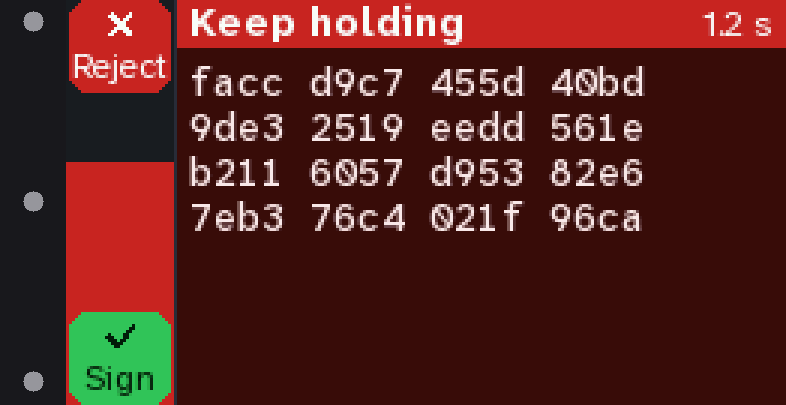
[picture p185: docs/quorum-ui/feather/16-red-hold.png]
16-red-hold


### refused

A hash the fields don't produce: refused. Sign stays grey; D0 rejects.

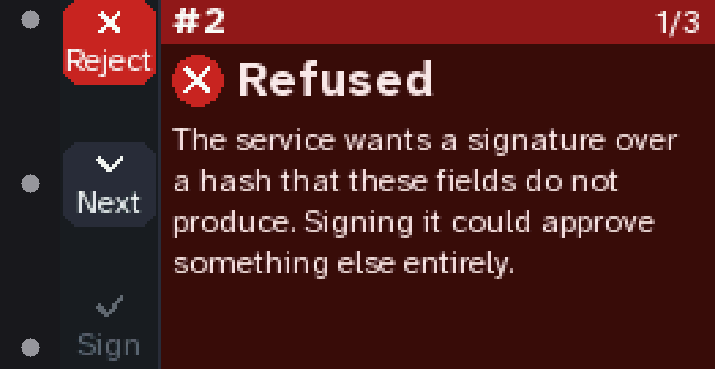
[picture p186: docs/quorum-ui/feather/17-refused.png]
17-refused


### see every page

D2 before every page is seen: it shows the next one and says how many are left.

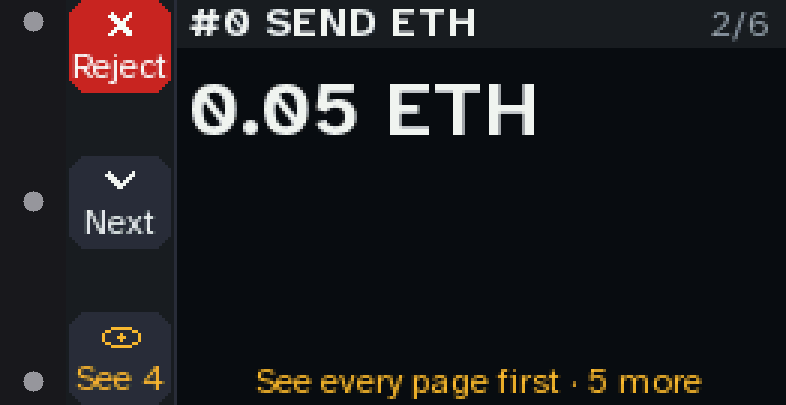
[picture p187: docs/quorum-ui/feather/18-see-every-page.png]
18-see-every-page


### result signed

Signed and posted. D2: OK.

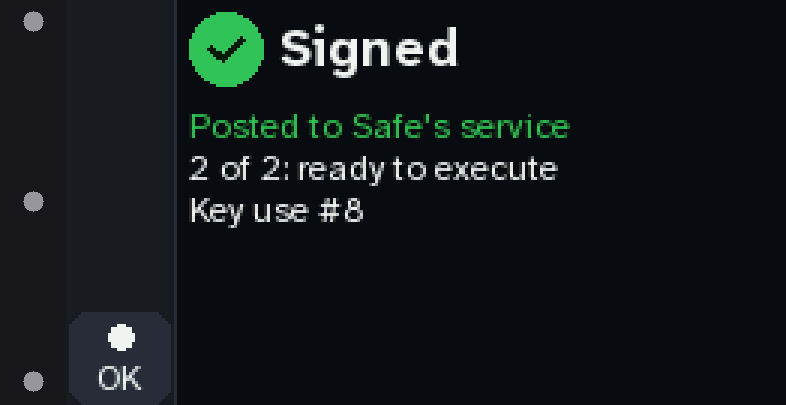
[picture p188: docs/quorum-ui/feather/19-result-signed.png]
19-result-signed


### result unsent

Signed but not sent: D2 sends it again, D0 goes back.

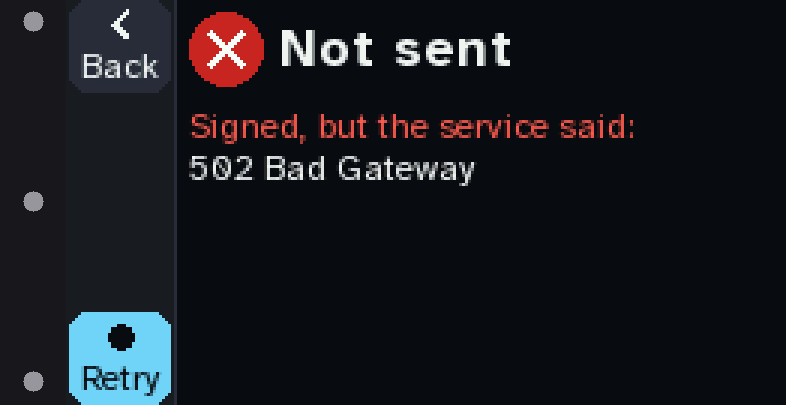
[picture p189: docs/quorum-ui/feather/20-result-unsent.png]
20-result-unsent


### device

Device tab, About: the chip, its slot and key, the pin, uses, memory. D0 back to the tab.

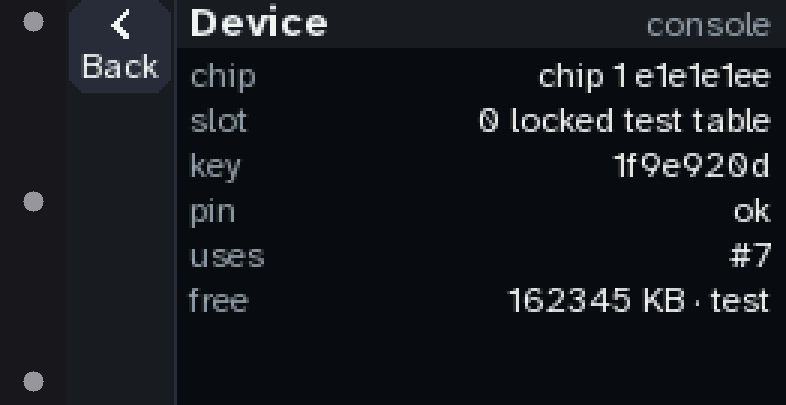
[picture p190: docs/quorum-ui/feather/21-device.png]
21-device


### chip

The chip's own pages. D1 pages, D0 back.

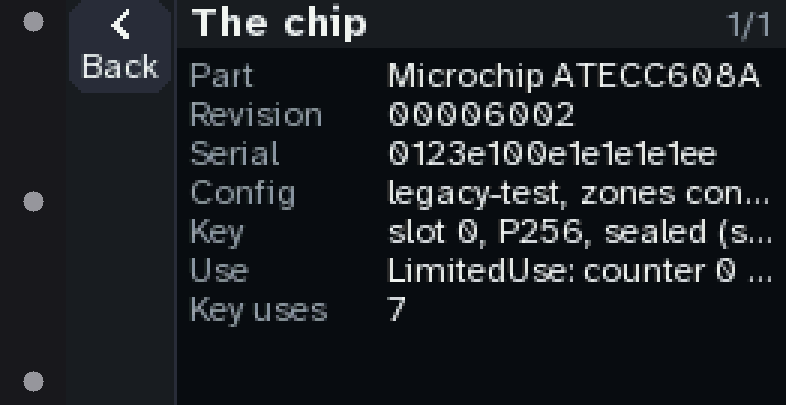
[picture p191: docs/quorum-ui/feather/22-chip.png]
22-chip


### nochip

No chip on the bus: D2 checks again.

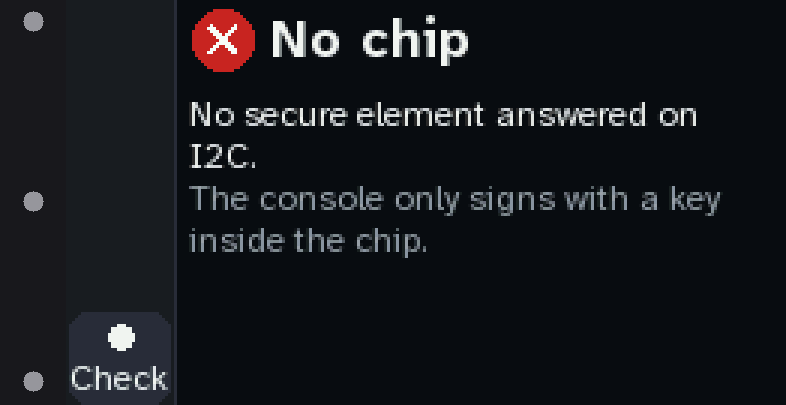
[picture p192: docs/quorum-ui/feather/23-nochip.png]
23-nochip


### pinfail

A chip that isn't pinned: nothing will be signed until tools/fw pin adds it. D2 checks again.

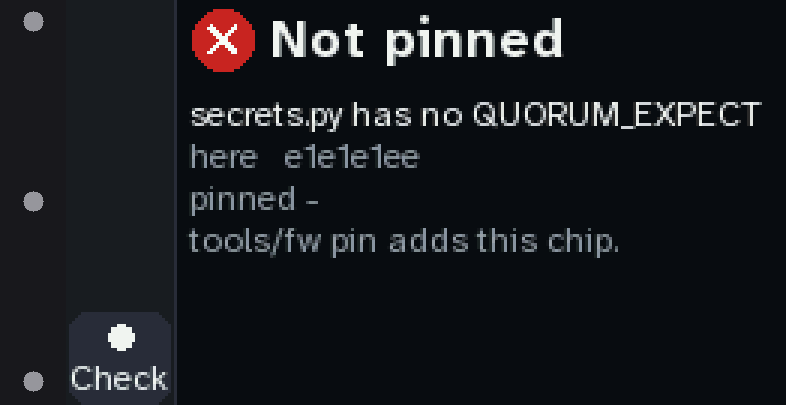
[picture p193: docs/quorum-ui/feather/24-pinfail.png]
24-pinfail


### key code

Key: the app's set-up link (#/k/<compressed key>) as a QR code, beside the owner address's start, end and picture, to compare with the page the phone opens. A signer, not a wallet. D1 shows the address in full, D0 goes back.

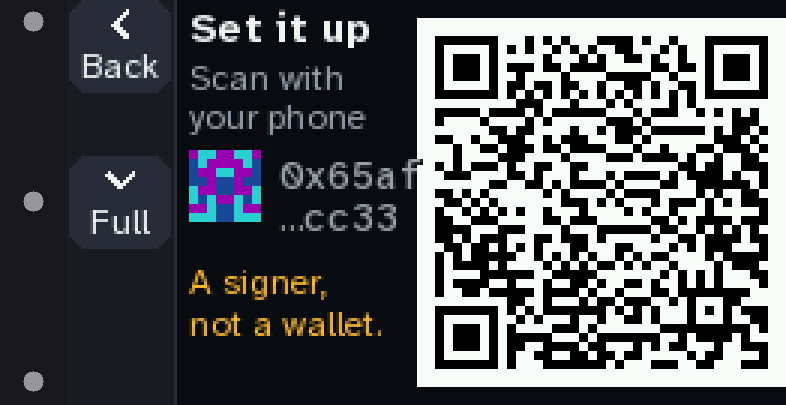
[picture p194: docs/quorum-ui/feather/25-key-code.png]
25-key-code


### key full

The owner address in full, the key's fingerprint and use count.

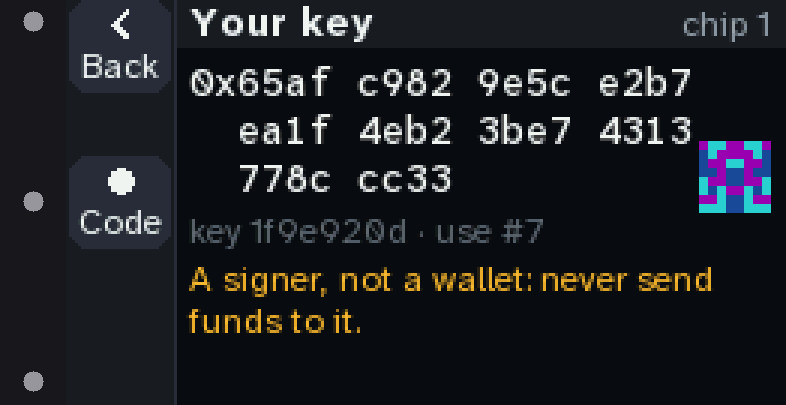
[picture p195: docs/quorum-ui/feather/26-key-full.png]
26-key-full


### home not owner

A Safe that doesn't list this key yet: Not an owner yet, and where its code is: the Key tab.

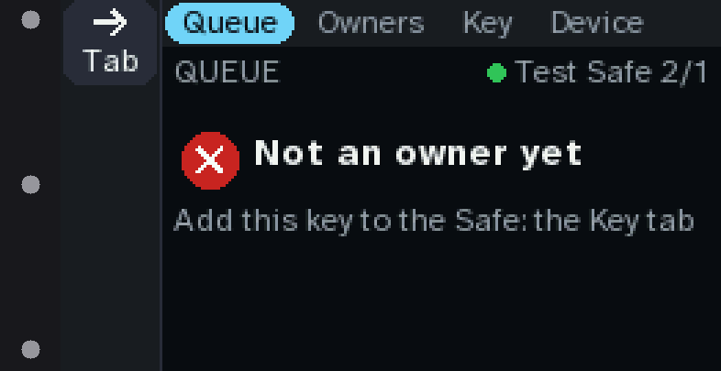
[picture p196: docs/quorum-ui/feather/27-home-not-owner.png]
27-home-not-owner


### ready

No Safe set yet, on a console being set up: the key is ready, D2 shows its code.

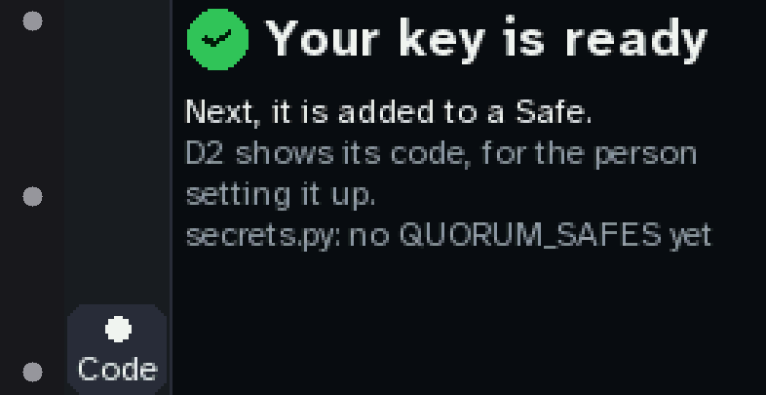
[picture p197: docs/quorum-ui/feather/28-ready.png]
28-ready


### token amount

A token: its amount, the token named from the console's own list, and the token contract's blockie.

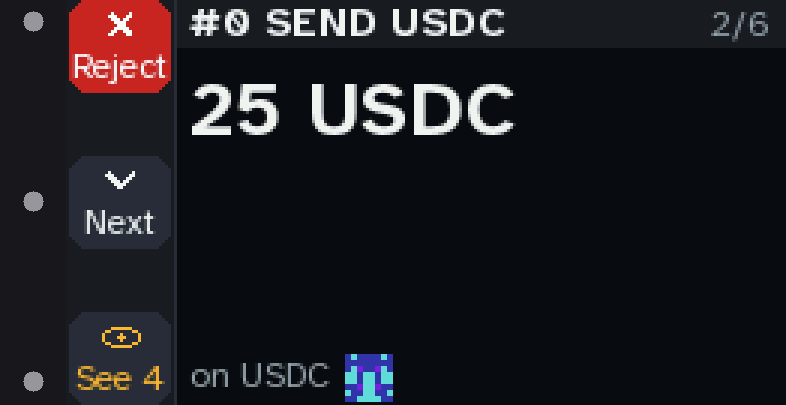
[picture p198: docs/quorum-ui/feather/29-token-amount.png]
29-token-amount


### token to

Every address page has its blockie beside the short last line: the picture Safe{Wallet} and Etherscan draw for it.

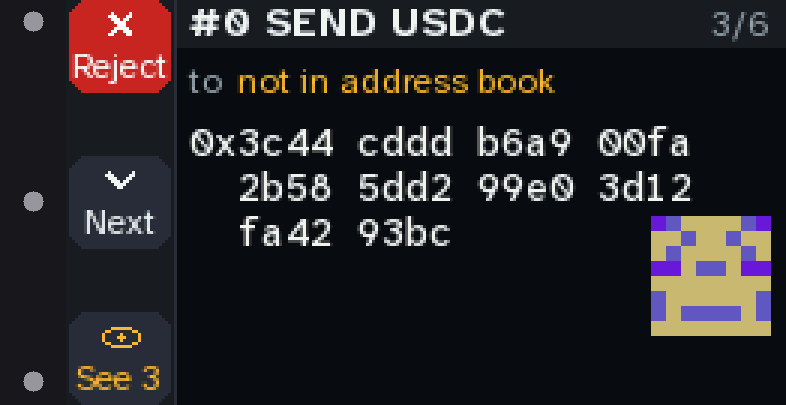
[picture p199: docs/quorum-ui/feather/30-token-to.png]
30-token-to


### swap replaces

Replacing an owner, a red page: the owner going out, and its blockie...

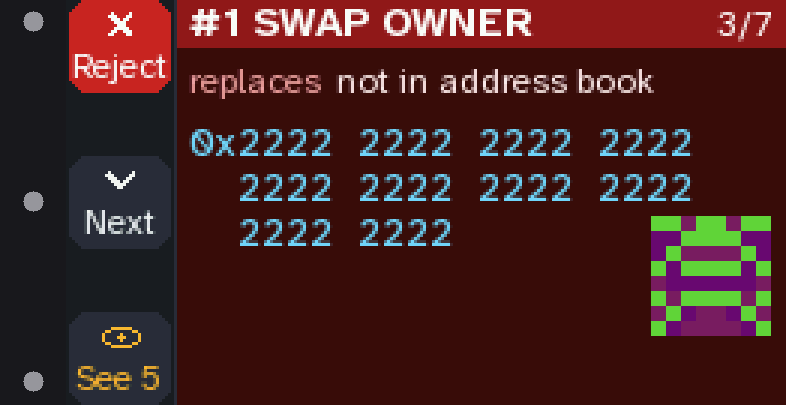
[picture p200: docs/quorum-ui/feather/31-swap-replaces.png]
31-swap-replaces


### swap new owner

...and the one coming in, to compare with the owners list in the Safe app.

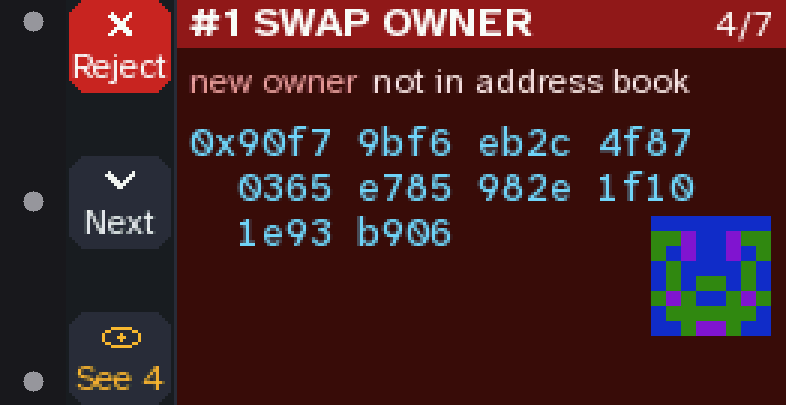
[picture p201: docs/quorum-ui/feather/32-swap-new-owner.png]
32-swap-new-owner


### batch to

A batch: each call has its own pages, and each address its own blockie.

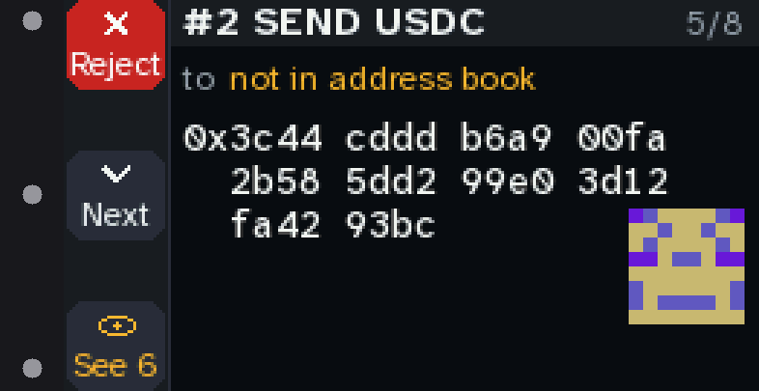
[picture p202: docs/quorum-ui/feather/33-batch-to.png]
33-batch-to
