jmcpheron/pico-quorum/docs/PROVISIONING.md

# Provisioning a fresh ATECC608: quorum v1

Chip #1 (`0123f3acfd2a826bee`) runs Microchip's test table (`test_ecc608_configdata`), inherited
through Austin's Pi code. It works, but it was never meant for a wallet:

- the CountMatch trap in slot 10
- a clear-writable IO-protection slot
- three signing slots
- an open data zone

Every chip from #2 on gets **quorum v1**, a table written for one job: a P-256 key that is one owner
of a Safe. The table lives in [`firmware/chipcfg.py`](../firmware/chipcfg.py). The ceremony that
writes and seals it lives in [`firmware/provision.py`](../firmware/provision.py) and runs from the
ceremony image.

To learn the steps first, the console has them as practice: **Device → Practice**, or **Try** on its
*No key yet* screen ([`firmware/practice.py`](../firmware/practice.py), from 2026.11.2). The same ten
screens, the arm and the holds, on the console's own buttons. C1 reads the config zone and says
whether the chip is fresh; no step writes anything, and the arm is the practice's own, not the
signer's. `test-vectors/console_test.py` (`case_practice`) checks with a spy on the virtual chip
that it asks only Read and Info, and that the chip is the same after.

## Decisions (2026-09-25)

- **No chip PIN.**
  - The Safe's threshold is the protection: a stolen Pico gives one signature of the two needed,
    and the other owners can rotate it out.
  - The ATECC608 has no lockout after failed attempts. At about 40 tries a second over I2C, a
    6-digit PIN falls in about 7 hours.
  - A PIN's rules can only be tested after the irreversible data lock.
  - See [the PIN variant](#the-pin-variant-costed-not-chosen) below. The Trust M has its own
    profile and ceremony now ([TRUSTM.md](TRUSTM.md)), also without a PIN. Revisit it with the Trust M,
    which does lock out.
- **A key-use counter.** LimitedUse on slot 0 ties every use of the key to counter 0, which the
  console shows. CountMatch is off, so the only cap is the counter's own maximum of 2,097,151.
  - On silicon (chip 2), once the data zone is locked, a public-key read (GenKey mode 0) counts as a
    use too; before the lock, and on chip 1, it did not.
  - The console accounts for its own reads: it takes the count before it reads the key, and before
    a signature it re-reads only the serial of a sealed slot. Only uses it didn't make are flagged.
- **One key, sealed.** Slots 1-15 are dead. There is no spare key: a second key in the same chip
  would fail with the first, and recovery is the Safe's other owners.

## The table

```
  0: 01 23 00 00 00 00 60 00 00 00 00 00 ee 00 00 00   the chip's own bytes (never written)
 16: c0 00 00 00 a1 2f 9f 8f 9f 8f 9f 8f 9f 8f 9f 8f
 32: 9f 8f 9f 8f 9f 8f 9f 8f 9f 8f 9f 8f 9f 8f 9f 8f
 48: 9f 8f 9f 8f ff ff ff ff 00 00 00 00 ff ff ff ff
 64: 00 00 00 00 00 00 00 00 00 00 00 00 00 00 00 00
 80: 00 00 00 00 00 00 55 55 ff ff 00 00 00 00 00 00
 96: 33 00 1c 00 1c 00 1c 00 1c 00 1c 00 1c 00 1c 00
112: 1c 00 1c 00 1c 00 1c 00 1c 00 1c 00 1c 00 1c 00
sha256 aadcf1ea51b86a8f71c19823c5eea2adbd683221180496622db2c54b66e8abef
```

### Slot 0, the signing key: SlotConfig `0x2FA1`, KeyConfig `0x0033`

This is chip #1's proven slot 0 (`0x2FAF`/`0x0033`) with internal sign and ECDH taken away.

**SlotConfig:**

| Bits | Field | Value | Meaning |
|---|---|---|---|
| 0-3 | ReadKey | `0001` | External Sign only. No internal sign, no ECDH. |
| 5 | LimitedUse | 1 | Every signature raises counter 0 first. At the cap, Sign fails. |
| 7 | IsSecret | 1 | Required for Sign. |
| 12-15 | WriteConfig | `0010` | The Write command never. GenKey allowed. PrivWrite forbidden, so no key can be imported. |

**KeyConfig:**

- Private, PubInfo (the public key can be read), KeyType 4 (P-256), Lockable.
- No ReqRandom, ReqAuth or AuthKey.

The slot is sealed by the slot lock after GenKey (C6). Datasheet §2.4.3: after that, "modification
via PrivWrite, Write, GenKey, and/or DeriveKey is permanently prohibited".
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
