jmcpheron/pico-quorum/docs/branded-keys/bench/b6-done.png

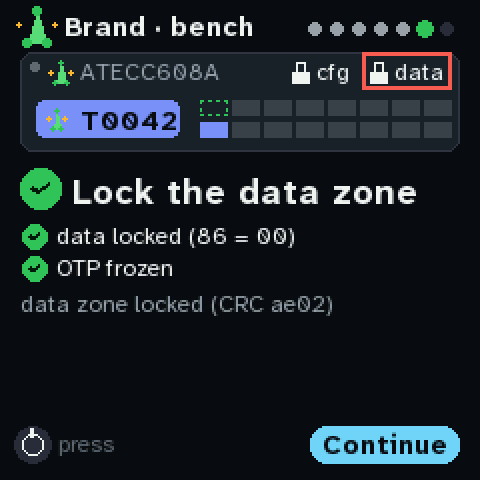
docs/branded-keys/bench/b6-done.png
