jmcpheron/pico-quorum/docs/branded-keys/bench/s1.png

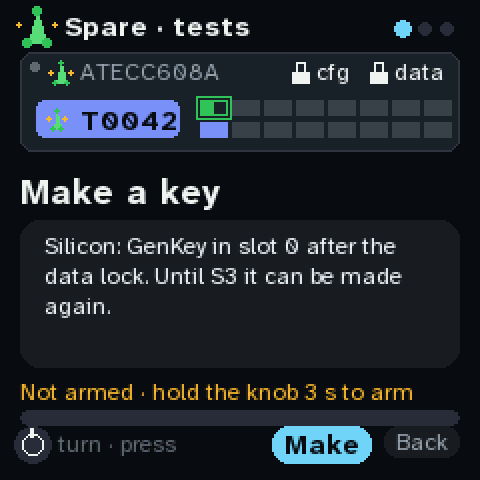
docs/branded-keys/bench/s1.png
