jmcpheron/pico-quorum/docs/branded-keys/bench/s4-done.png

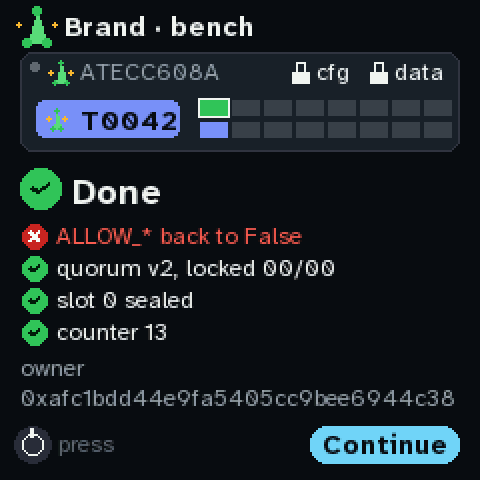
docs/branded-keys/bench/s4-done.png
