jmcpheron/pico-quorum/docs/firmware-production/shots/76-ceremony-C9.png

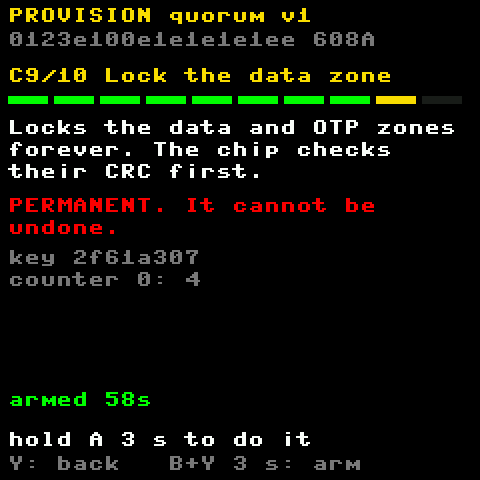
docs/firmware-production/shots/76-ceremony-C9.png
