jmcpheron/pico-quorum/docs/firmware-production/shots/78-ceremony-C10.png

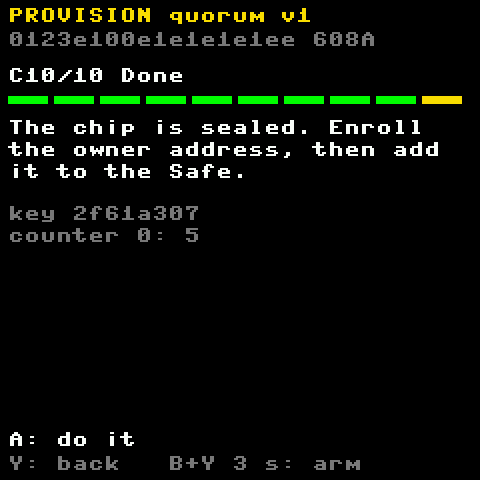
docs/firmware-production/shots/78-ceremony-C10.png
