jmcpheron/pico-quorum/docs/img/console-rp.jpg

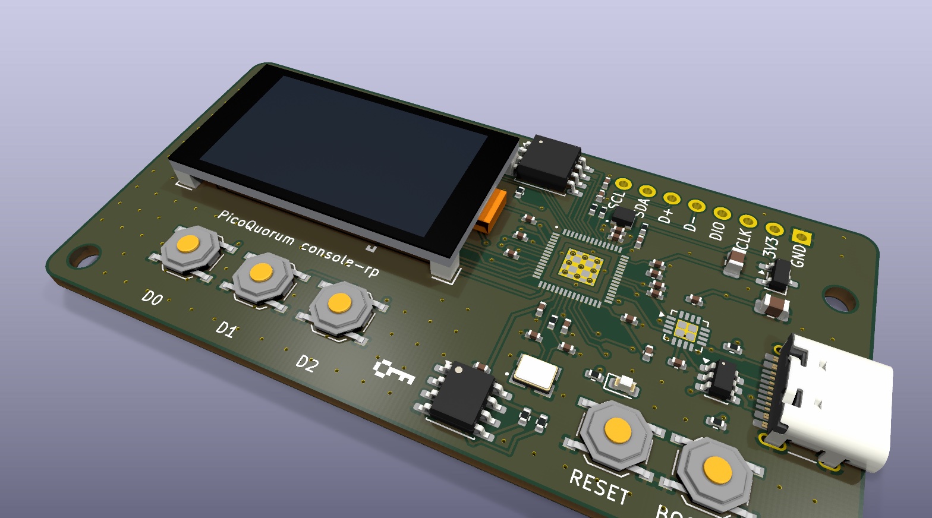
docs/img/console-rp.jpg
