jmcpheron/pico-quorum/docs/mainnet/shots/tm-13-device-buttons-wifi.png

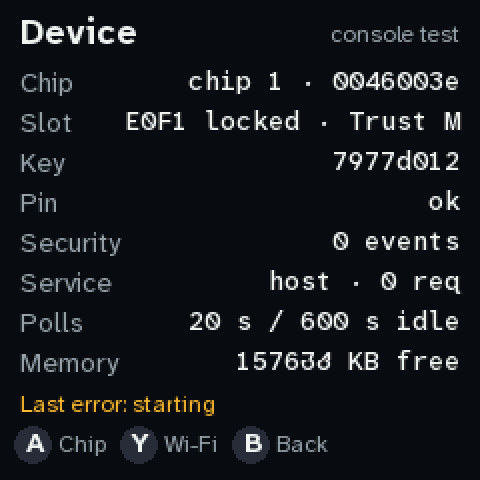
docs/mainnet/shots/tm-13-device-buttons-wifi.png
