jmcpheron/pico-quorum/docs/quorum-ui/boot/quorum.gif

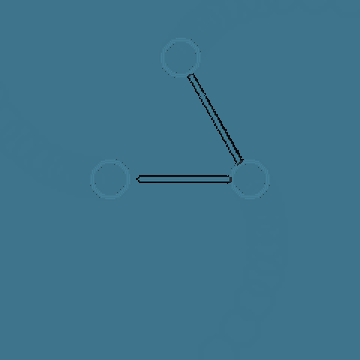
docs/quorum-ui/boot/quorum.gif
