jmcpheron/pico-quorum/docs/quorum-ui/shots/14-owner-let-go-early.png

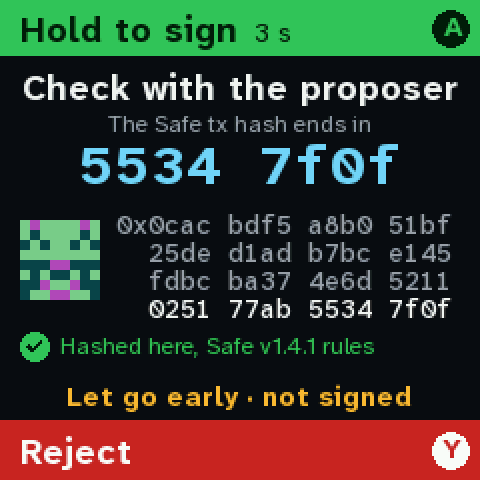
docs/quorum-ui/shots/14-owner-let-go-early.png
