jmcpheron/pico-quorum/docs/quorum-ui/shots/17-lie-claimed.png

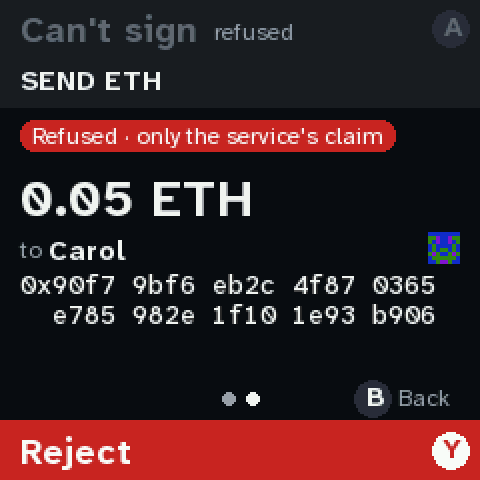
docs/quorum-ui/shots/17-lie-claimed.png
