jmcpheron/pico-quorum/docs/quorum-ui/shots/20-unknown-red-page.png

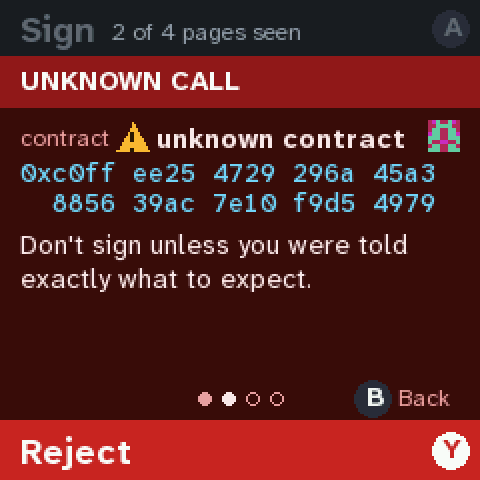
docs/quorum-ui/shots/20-unknown-red-page.png
