jmcpheron/pico-quorum/docs/quorum-ui/shots/23-refund-red-page.png

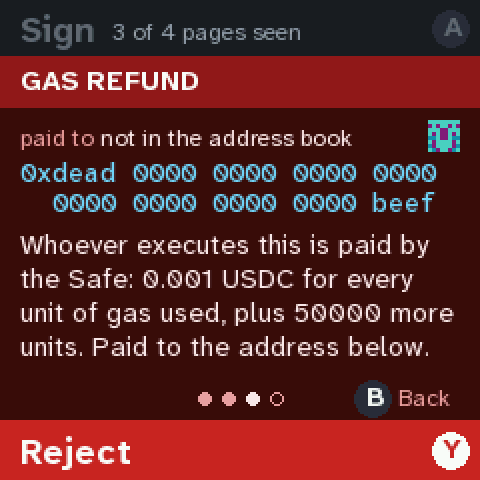
docs/quorum-ui/shots/23-refund-red-page.png
