jmcpheron/pico-quorum/docs/quorum-ui/shots/28-conflict-summary.png

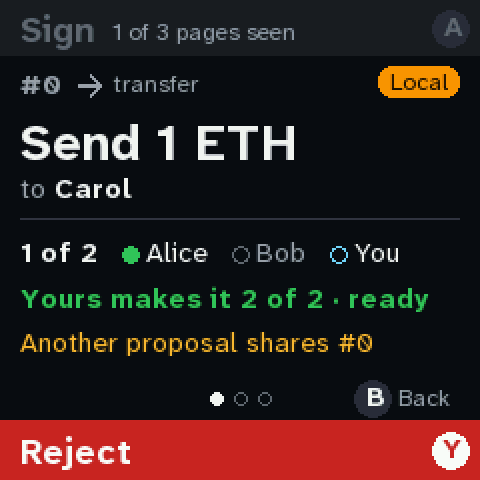
docs/quorum-ui/shots/28-conflict-summary.png
