jmcpheron/pico-quorum/docs/quorum-ui/shots/30-owners.png

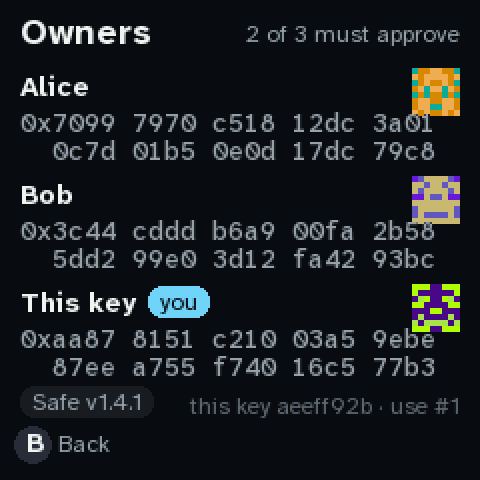
docs/quorum-ui/shots/30-owners.png
