jmcpheron/pico-quorum/docs/quorum-ui/shots/33-light-home.png

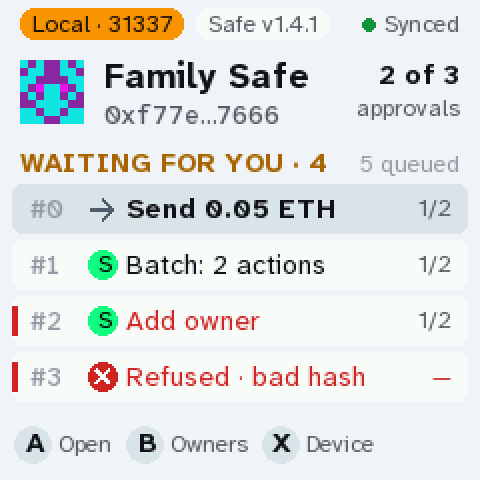
docs/quorum-ui/shots/33-light-home.png
