jmcpheron/pico-quorum/docs/quorum-ui/shots/34-light-summary.png

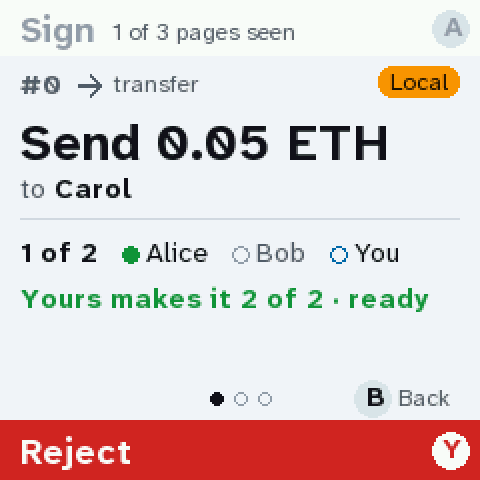
docs/quorum-ui/shots/34-light-summary.png
