jmcpheron/pico-quorum/docs/quorum-ui/shots/35-light-red-page.png

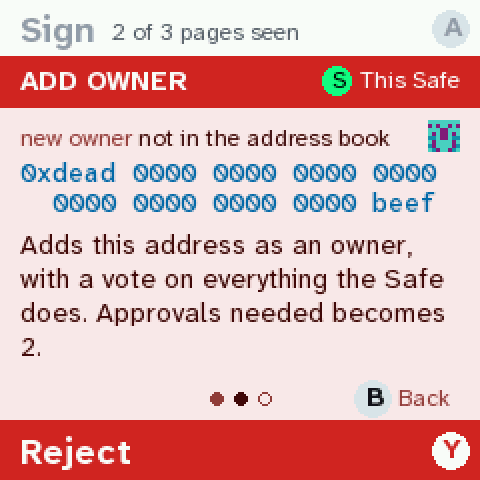
docs/quorum-ui/shots/35-light-red-page.png
