jmcpheron/pico-quorum/docs/quorum-ui/shots/37-identity-home.png

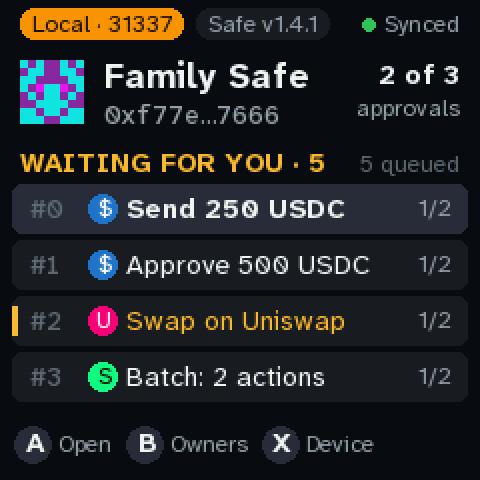
docs/quorum-ui/shots/37-identity-home.png
