jmcpheron/pico-quorum/docs/quorum-ui/shots/41-identity-uniswap-swap-page.png

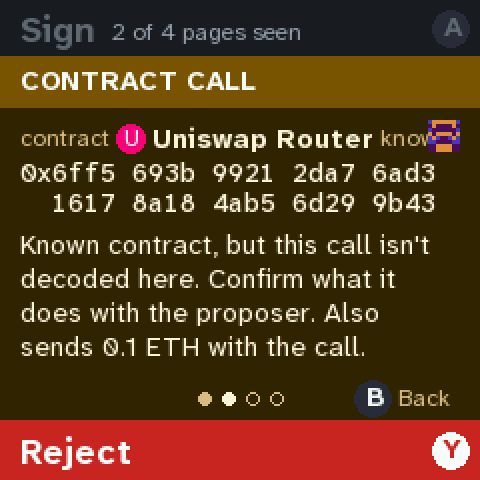
docs/quorum-ui/shots/41-identity-uniswap-swap-page.png
