jmcpheron/pico-quorum/docs/quorum-ui/shots/57-trustm-chip-2.png

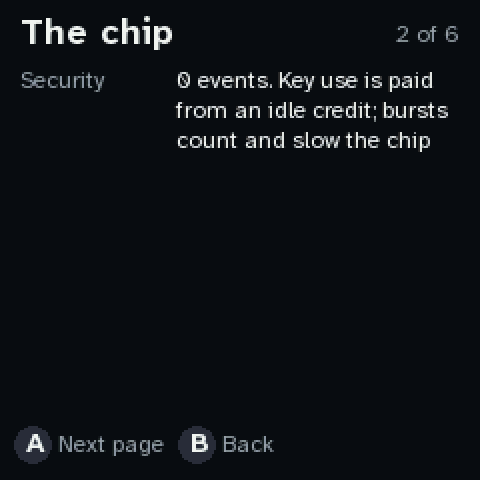
docs/quorum-ui/shots/57-trustm-chip-2.png
