jmcpheron/pico-quorum/docs/quorum-ui/shots/64-owners-page-3.png

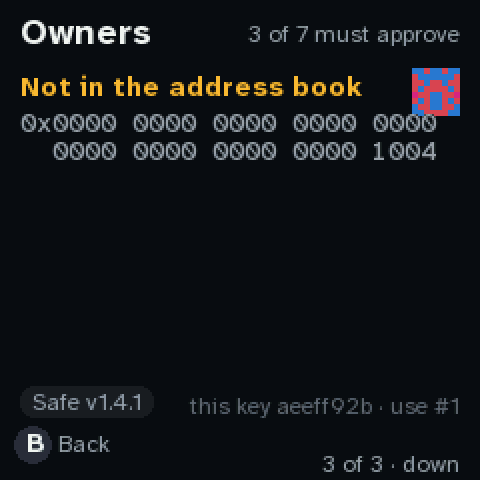
docs/quorum-ui/shots/64-owners-page-3.png
