jmcpheron/pico-quorum/docs/quorum-ui/v2/fonts/compare-02-approve-summary.png

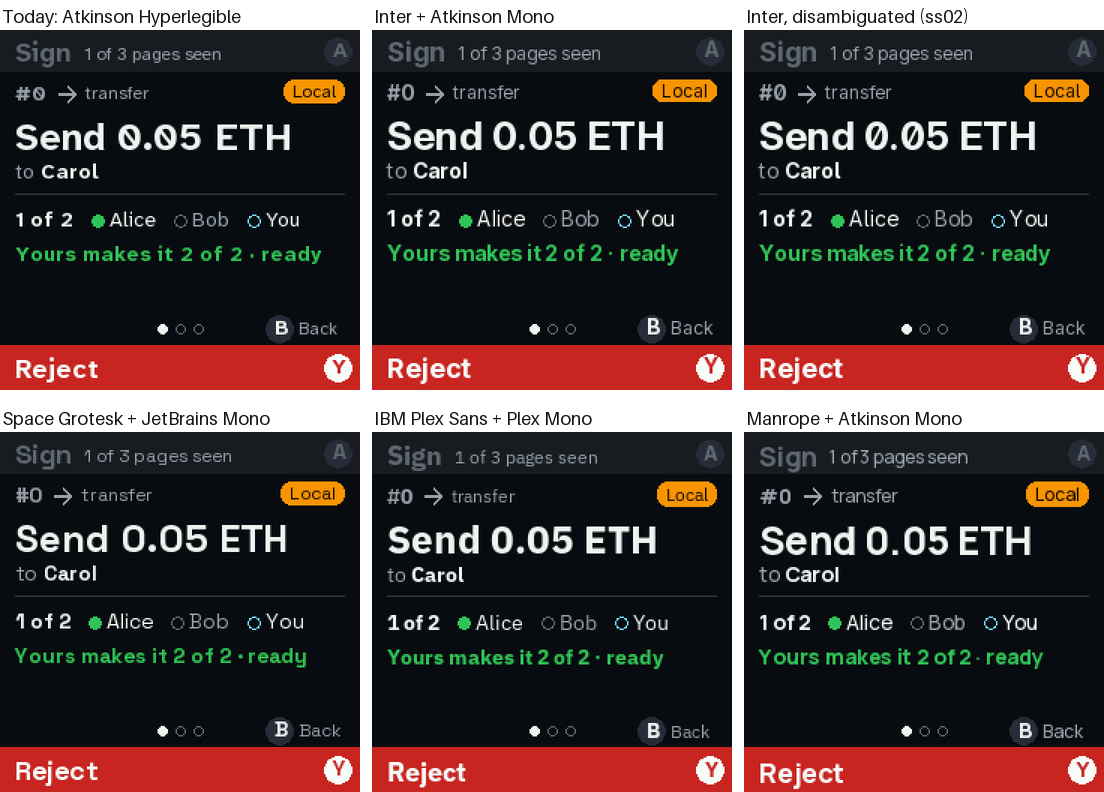
docs/quorum-ui/v2/fonts/compare-02-approve-summary.png
