jmcpheron/pico-quorum/docs/quorum-ui/v2/fonts/compare-13-owner-red-page.png

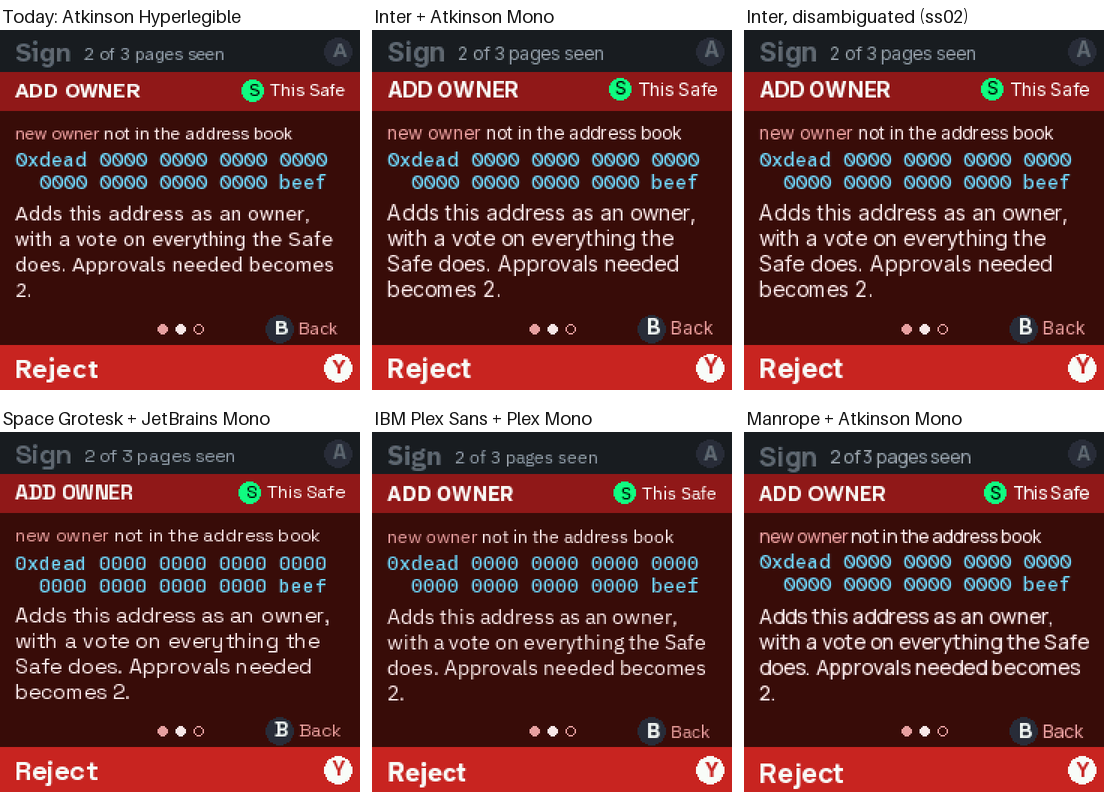
docs/quorum-ui/v2/fonts/compare-13-owner-red-page.png
