jmcpheron/pico-quorum/docs/quorum-ui/v2/fonts/compare-specimen.png

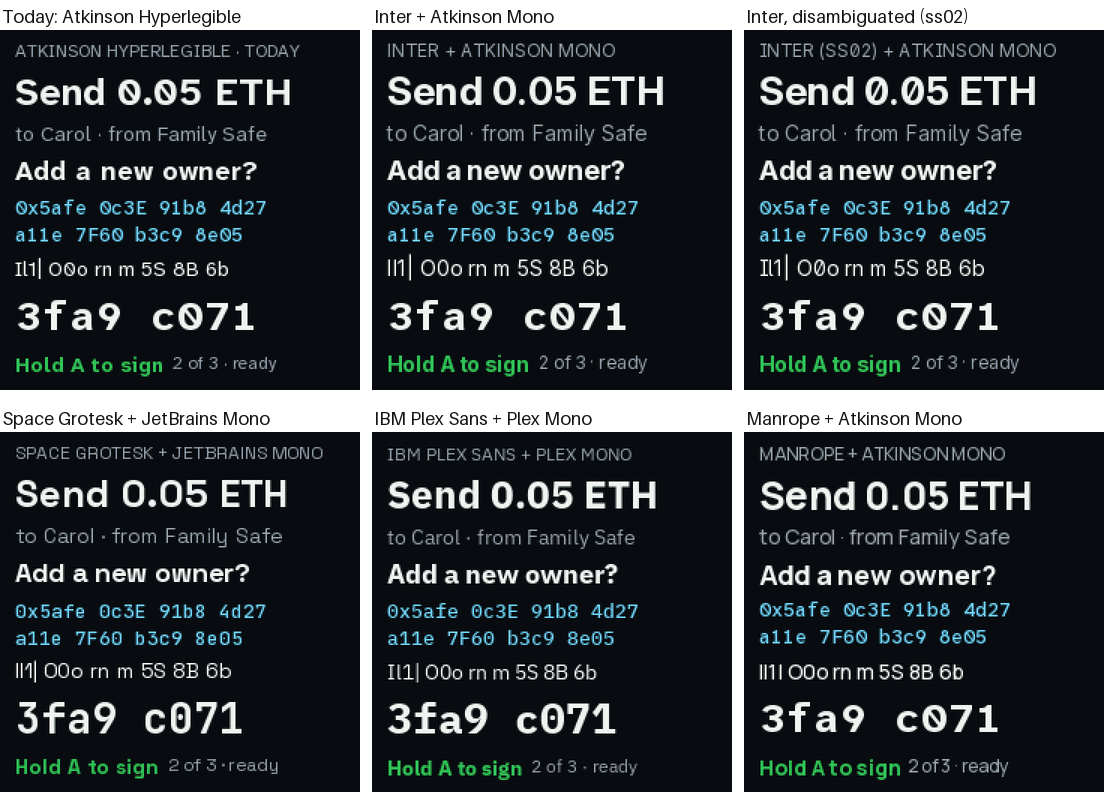
docs/quorum-ui/v2/fonts/compare-specimen.png
