jmcpheron/pico-quorum/docs/quorum-ui/v2/fonts/grotesk/02-approve-summary.png

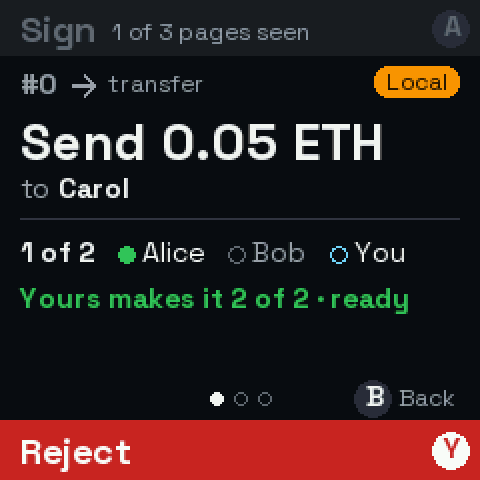
docs/quorum-ui/v2/fonts/grotesk/02-approve-summary.png
