jmcpheron/pico-quorum/docs/quorum-ui/v2/fonts/grotesk/16-lie-refused.png

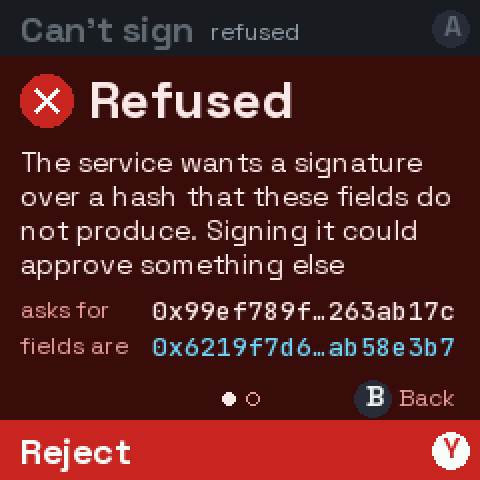
docs/quorum-ui/v2/fonts/grotesk/16-lie-refused.png
