jmcpheron/pico-quorum/docs/quorum-ui/v2/fonts/inter/03-approve-send.png

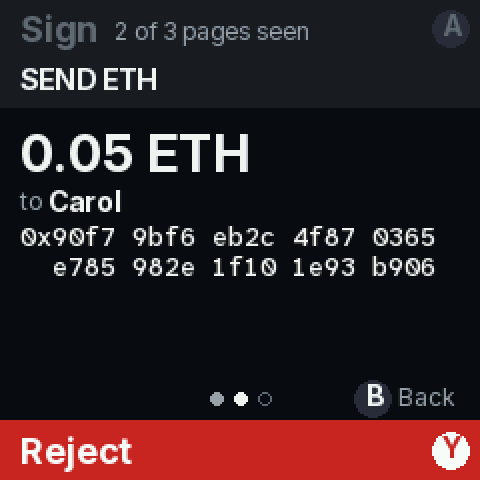
docs/quorum-ui/v2/fonts/inter/03-approve-send.png
