jmcpheron/pico-quorum/docs/quorum-ui/v2/fonts/interd/01-home.png

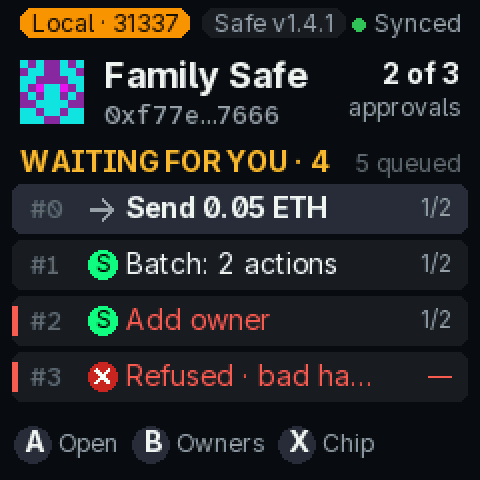
docs/quorum-ui/v2/fonts/interd/01-home.png
