jmcpheron/pico-quorum/docs/quorum-ui/v2/fonts/spec-atkinson.png

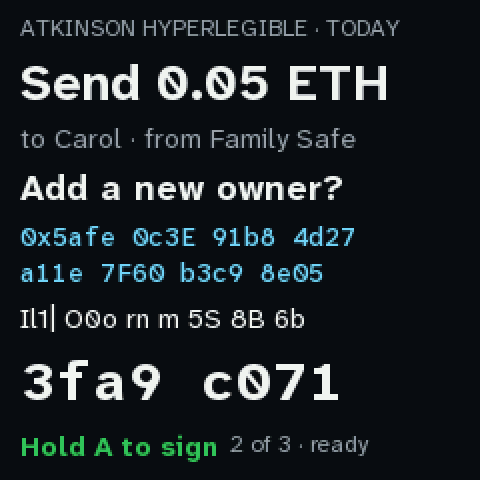
docs/quorum-ui/v2/fonts/spec-atkinson.png
