jmcpheron/pico-quorum/docs/quorum-ui/v2/fonts/spec-grotesk.png

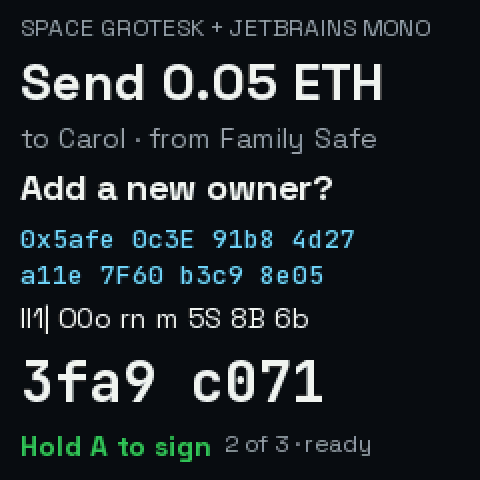
docs/quorum-ui/v2/fonts/spec-grotesk.png
