jmcpheron/pico-quorum/docs/quorum-ui/v2/fonts/spec-interd.png

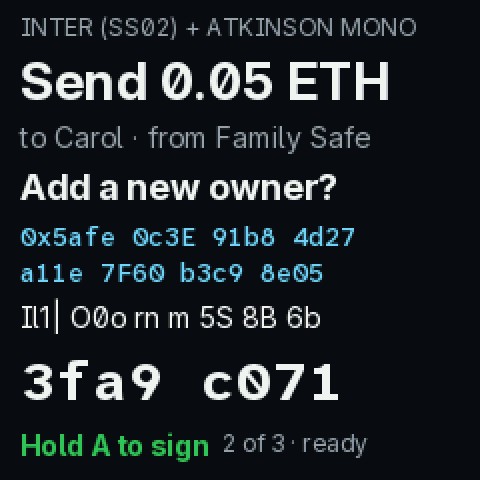
docs/quorum-ui/v2/fonts/spec-interd.png
