jmcpheron/pico-quorum/docs/quorum-ui/v2/fonts/spec-manrope.png

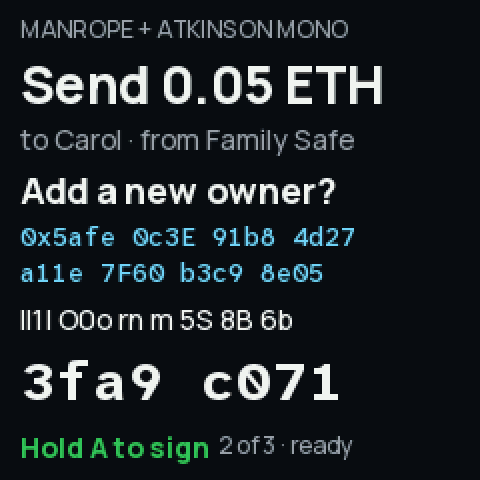
docs/quorum-ui/v2/fonts/spec-manrope.png
