jmcpheron/pico-quorum/docs/quorum-ui/v2/fonts/spec-plex.png

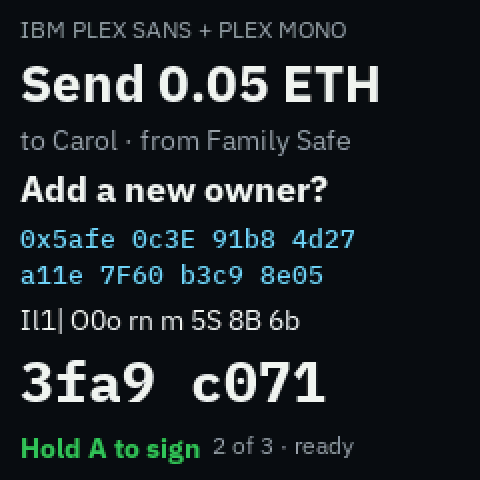
docs/quorum-ui/v2/fonts/spec-plex.png
