jmcpheron/pico-quorum/hardware/console-a/console-a/fab/console-a-bottom.png

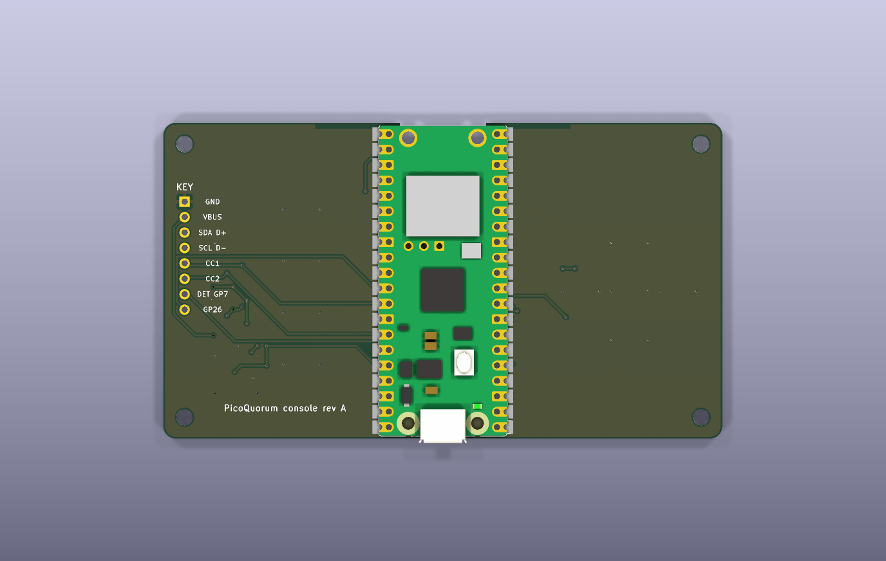
hardware/console-a/console-a/fab/console-a-bottom.png
