jmcpheron/pico-quorum/hardware/console-a/console-a/fab/console-a-top.png

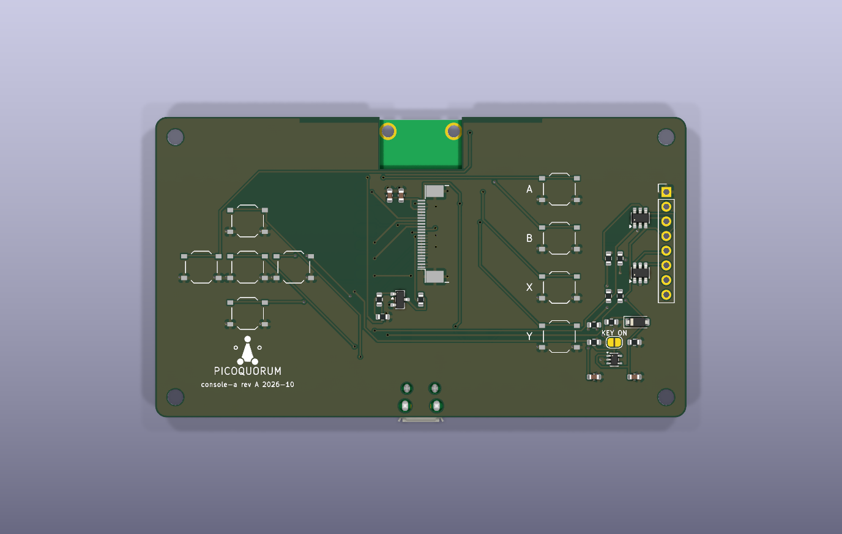
hardware/console-a/console-a/fab/console-a-top.png
