jmcpheron/pico-quorum/hardware/console-rp/renders/console-rp-bottom.jpg

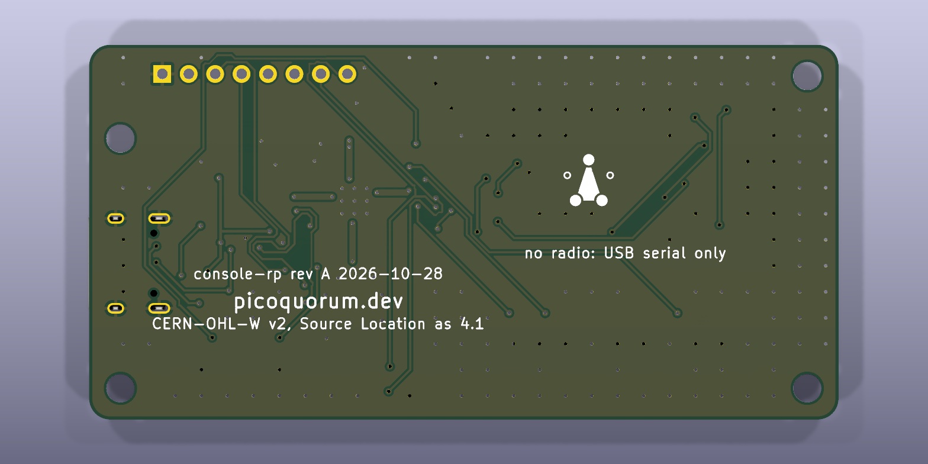
hardware/console-rp/renders/console-rp-bottom.jpg
