jmcpheron/pico-quorum/hardware/console-rp/renders/console-rp-top.jpg

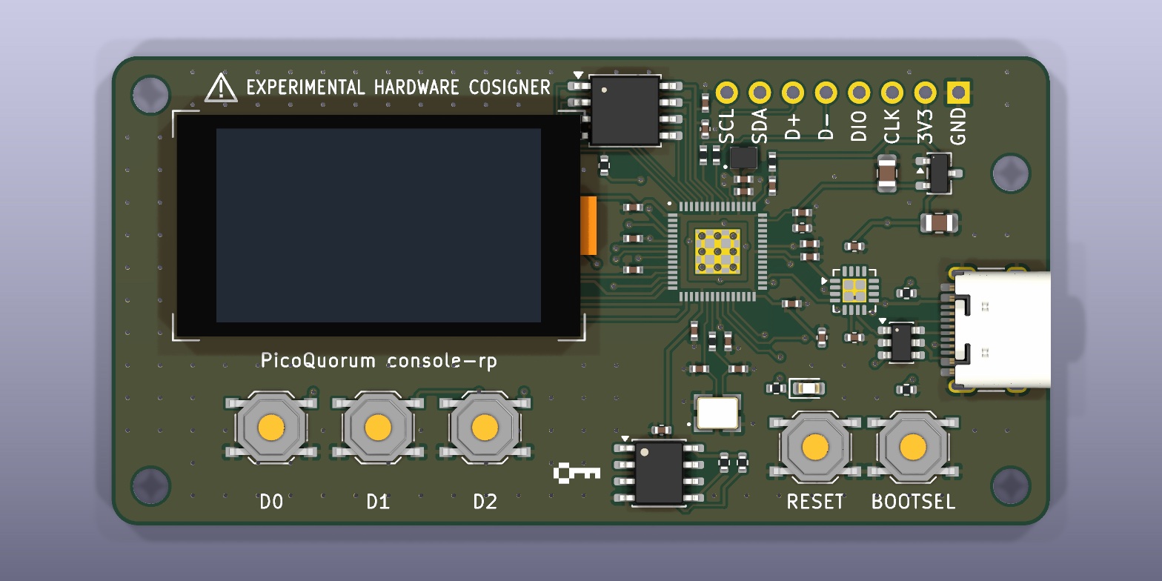
hardware/console-rp/renders/console-rp-top.jpg
