jmcpheron/pico-quorum/hardware/console-usb/renders/console-usb-3q.jpg

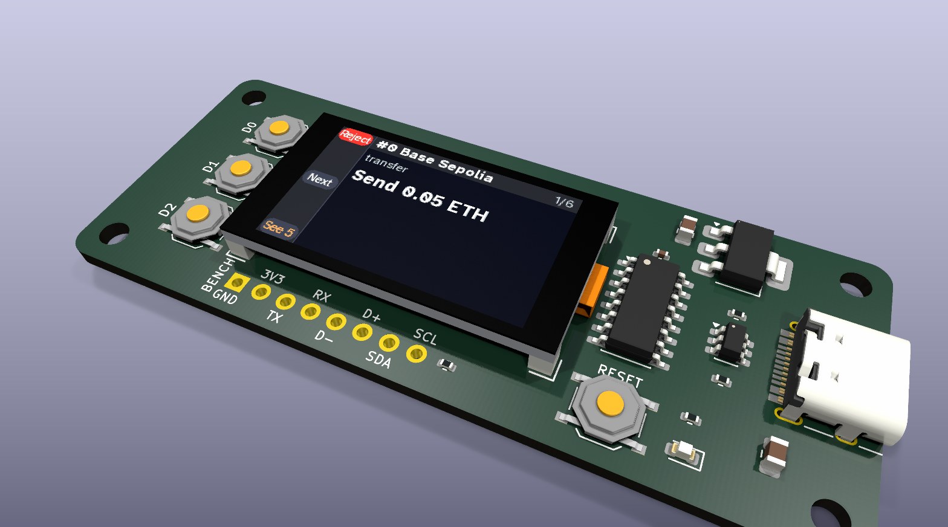
hardware/console-usb/renders/console-usb-3q.jpg
