jmcpheron/pico-quorum/hardware/console-usb/renders/console-usb-bottom.jpg

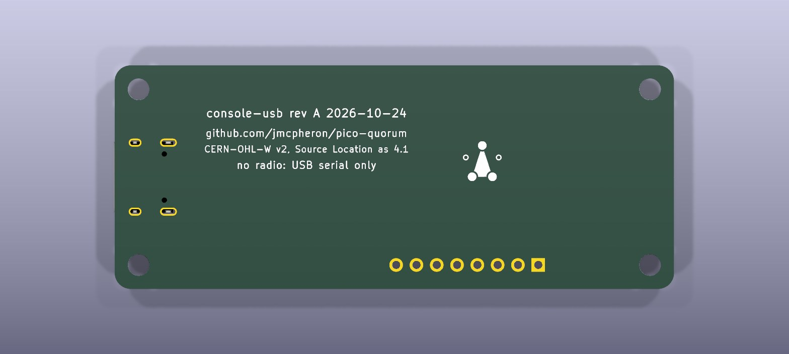
hardware/console-usb/renders/console-usb-bottom.jpg
