jmcpheron/pico-quorum/hardware/console-usb/renders/console-usb-top.jpg

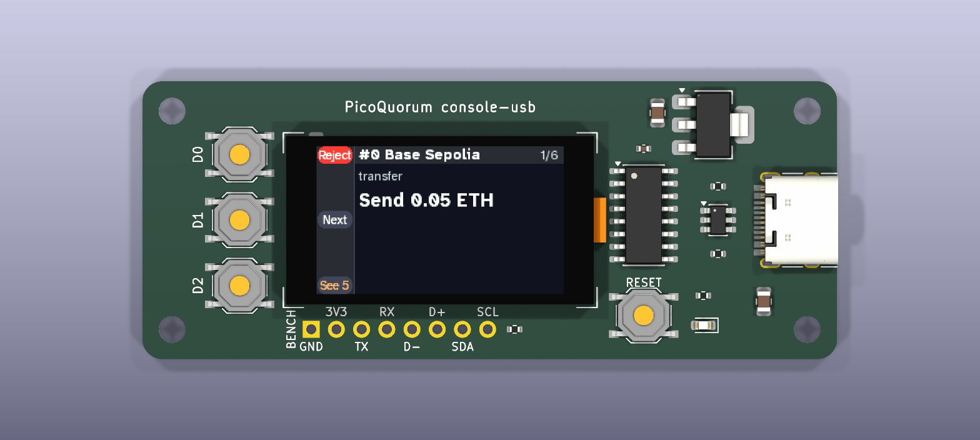
hardware/console-usb/renders/console-usb-top.jpg
