jmcpheron/pico-quorum/hardware/console-usb/renders/console-usb-under-glass.jpg

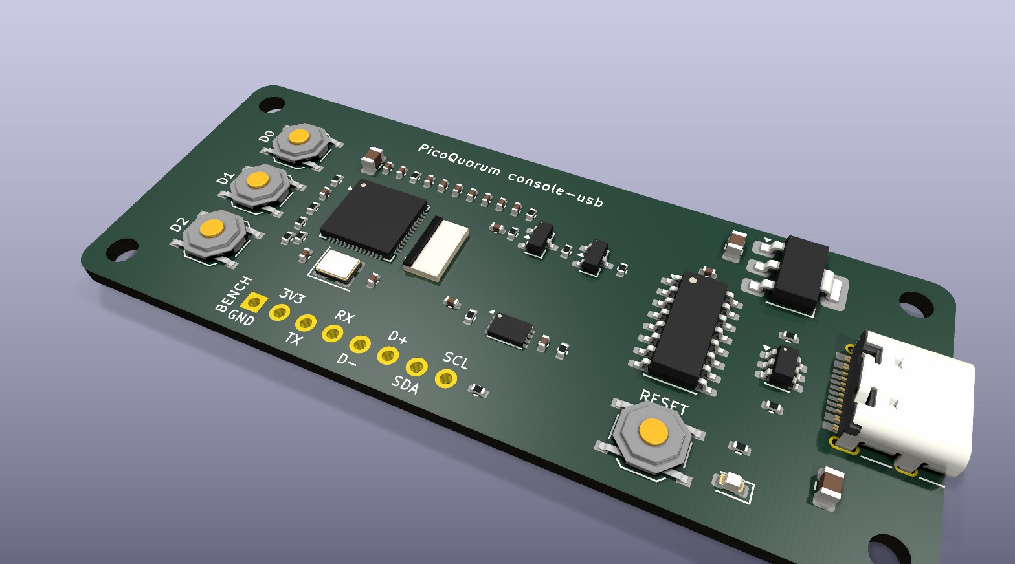
hardware/console-usb/renders/console-usb-under-glass.jpg
