jmcpheron/pico-quorum/hardware/feather-wing/wing-a/fab/wing-a-bottom.png

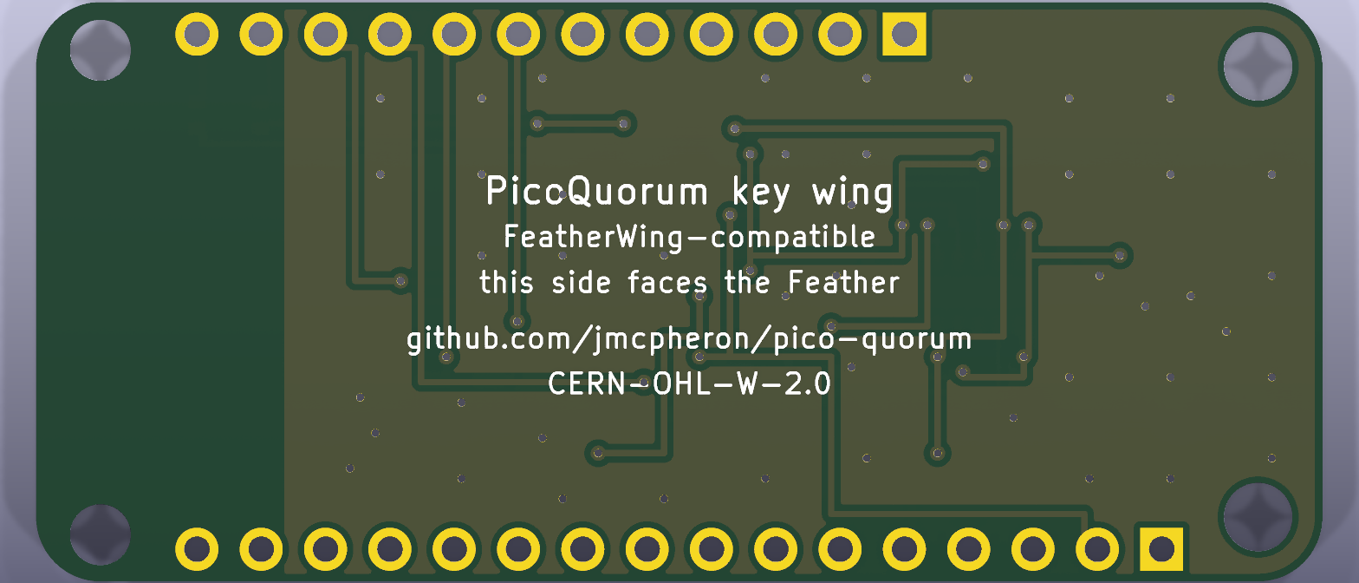
hardware/feather-wing/wing-a/fab/wing-a-bottom.png
