jmcpheron/pico-quorum/hardware/feather-wing/wing-a/fab/wing-a-top.png

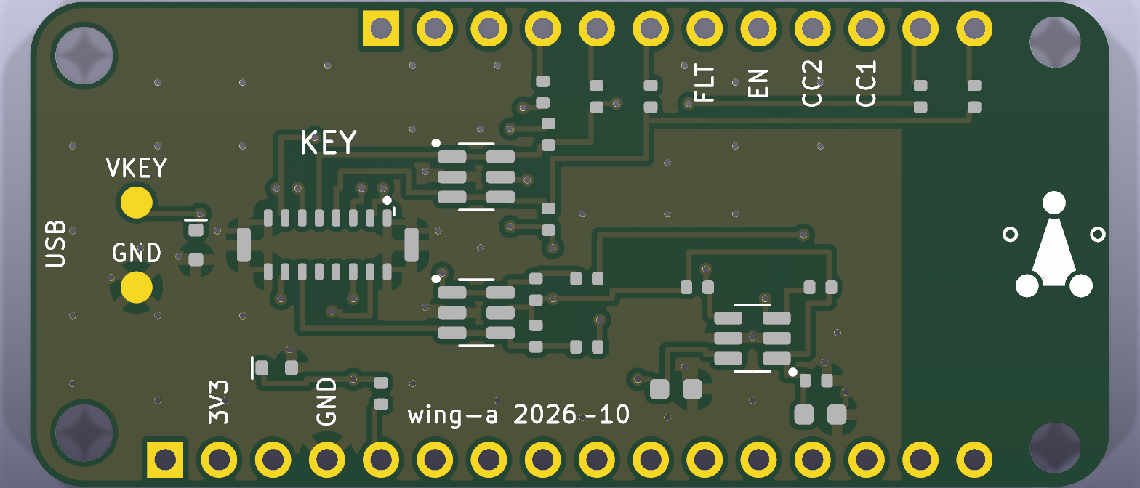
hardware/feather-wing/wing-a/fab/wing-a-top.png
