jmcpheron/pico-quorum/hardware/feather-wing/wing-b/fab/wing-b-bottom.png

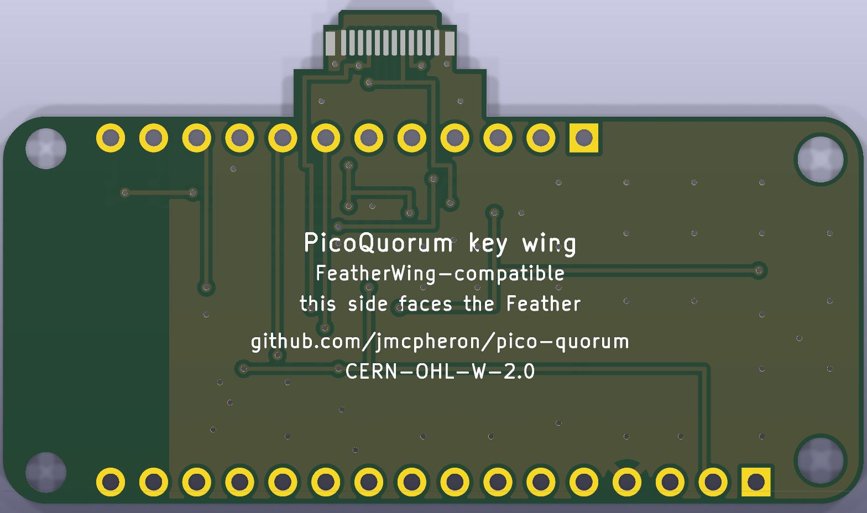
hardware/feather-wing/wing-b/fab/wing-b-bottom.png
