jmcpheron/pico-quorum/hardware/feather-wing/wing-b/fab/wing-b-top.png

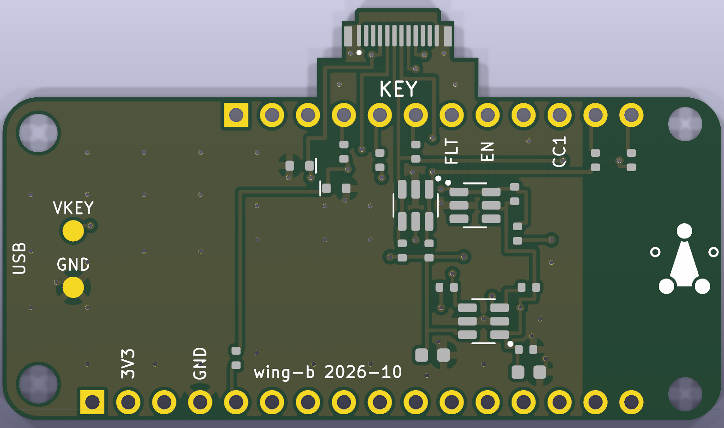
hardware/feather-wing/wing-b/fab/wing-b-top.png
