jmcpheron/pico-quorum/hardware/key-pcb/key-c-usbc/fab/key-c-usbc-bottom.png

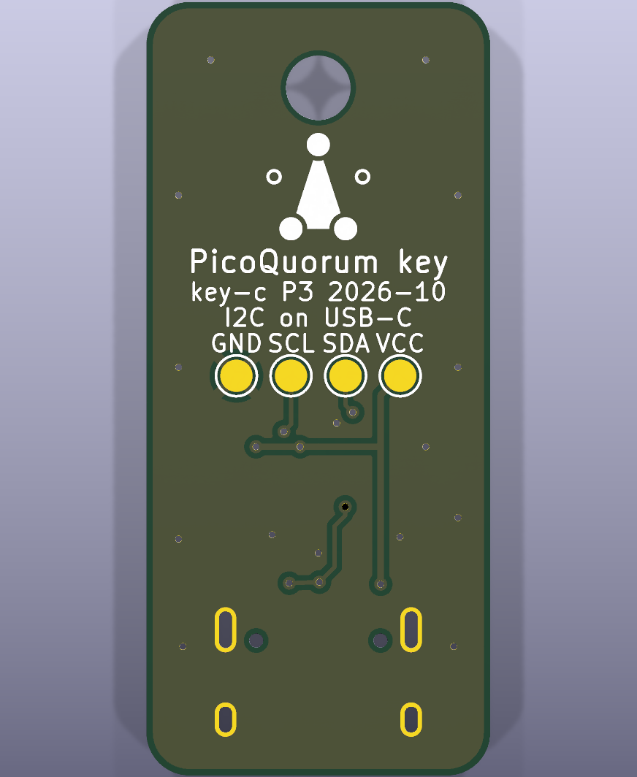
hardware/key-pcb/key-c-usbc/fab/key-c-usbc-bottom.png
