jmcpheron/pico-quorum/hardware/mono/renders/mono-bottom.jpg

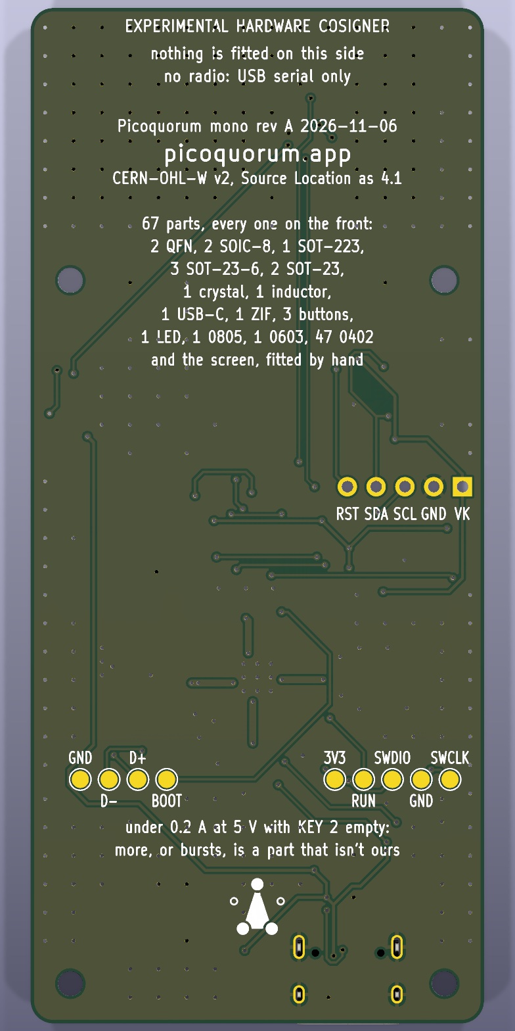
hardware/mono/renders/mono-bottom.jpg
