jmcpheron/pico-quorum/hardware/prototypes/console-s3/console-s3/fab/console-s3-bottom.png

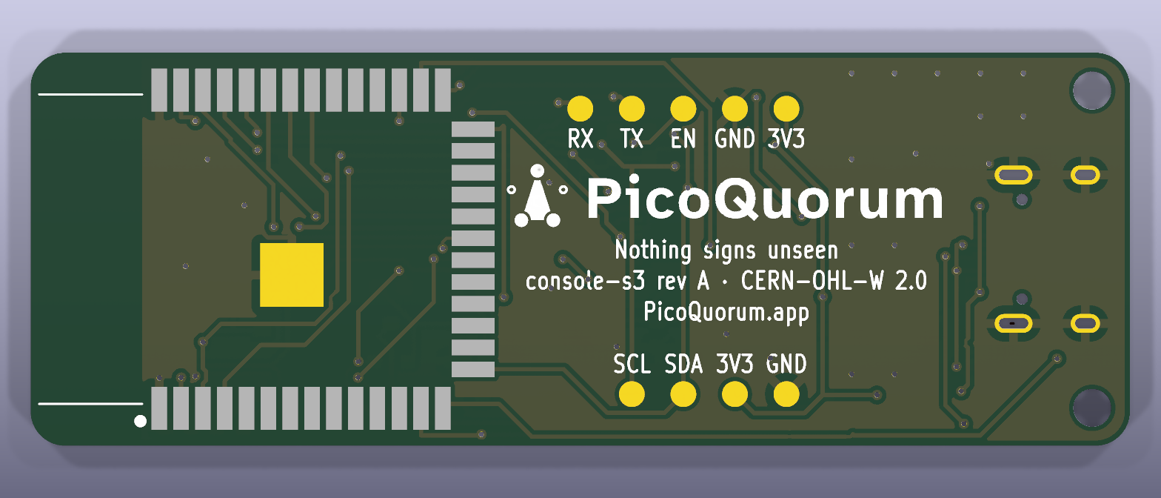
hardware/prototypes/console-s3/console-s3/fab/console-s3-bottom.png
