jmcpheron/pico-quorum/hardware/prototypes/console-s3/console-s3/fab/golden/B.Cu.png

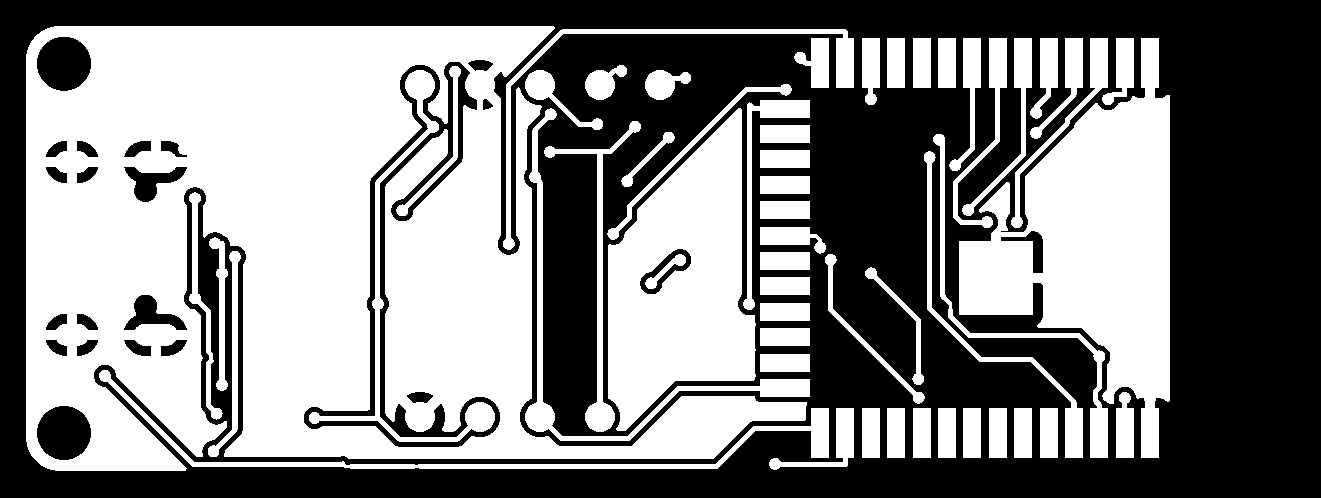
hardware/prototypes/console-s3/console-s3/fab/golden/B.Cu.png
