jmcpheron/pico-quorum/hardware/prototypes/console-s3/console-s3/fab/golden/B.Mask.png

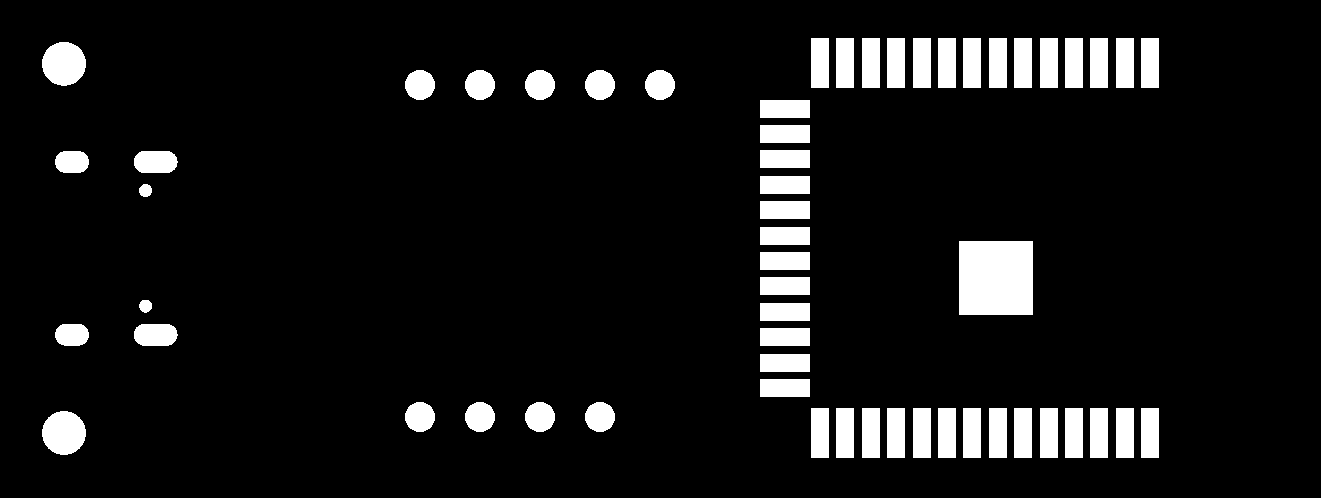
hardware/prototypes/console-s3/console-s3/fab/golden/B.Mask.png
