jmcpheron/pico-quorum/hardware/prototypes/console-s3/console-s3/fab/golden/B.Paste.png

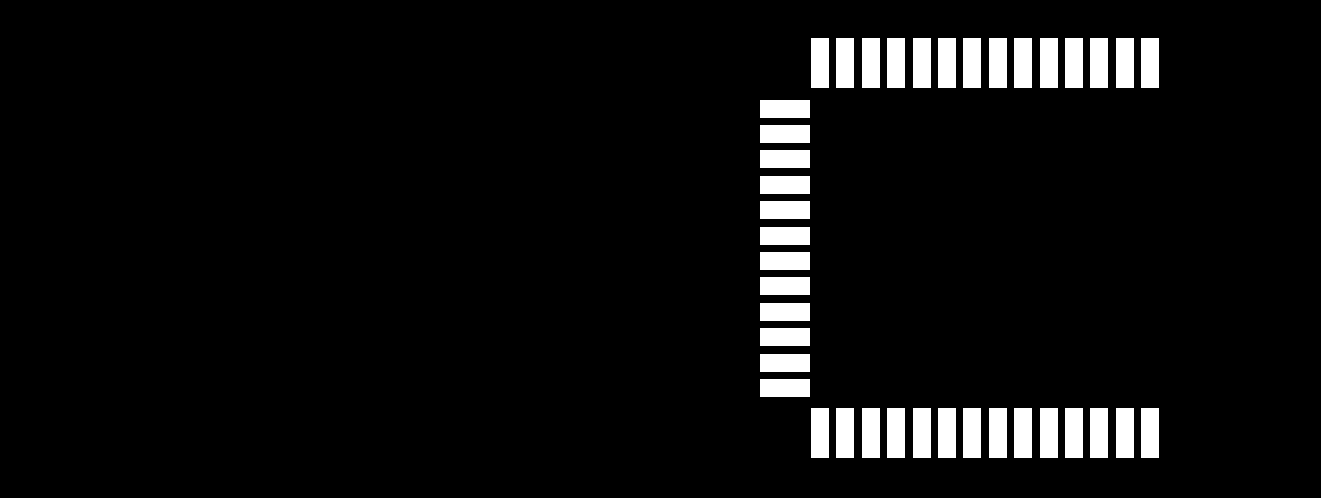
hardware/prototypes/console-s3/console-s3/fab/golden/B.Paste.png
