jmcpheron/pico-quorum/hardware/prototypes/console-s3/console-s3/fab/golden/B.SilkS.png

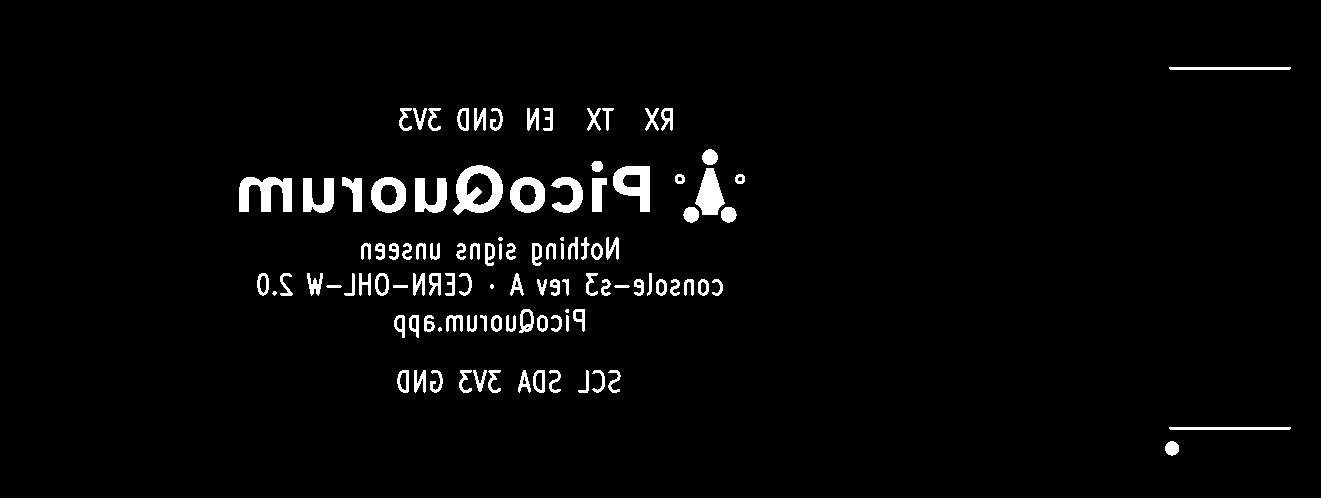
hardware/prototypes/console-s3/console-s3/fab/golden/B.SilkS.png
