jmcpheron/pico-quorum/hardware/prototypes/console-s3/console-s3/fab/golden/F.Cu.png

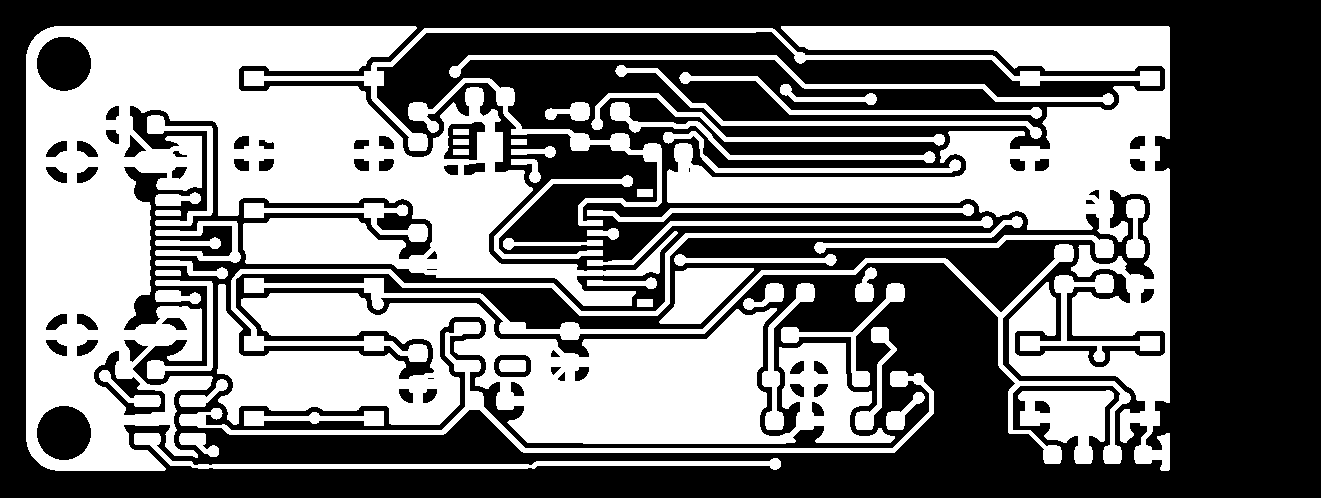
hardware/prototypes/console-s3/console-s3/fab/golden/F.Cu.png
