jmcpheron/pico-quorum/hardware/prototypes/console-s3/console-s3/fab/golden/F.SilkS.png

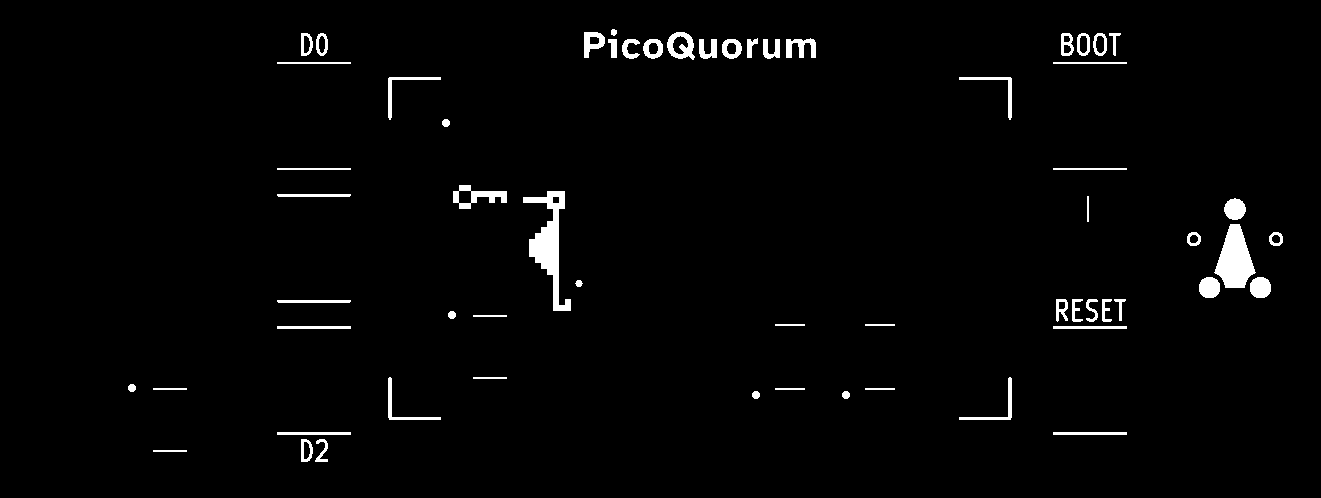
hardware/prototypes/console-s3/console-s3/fab/golden/F.SilkS.png
