jmcpheron/pico-quorum/hardware/prototypes/picoquorum-key/docs/img/rev-a-bottom.png

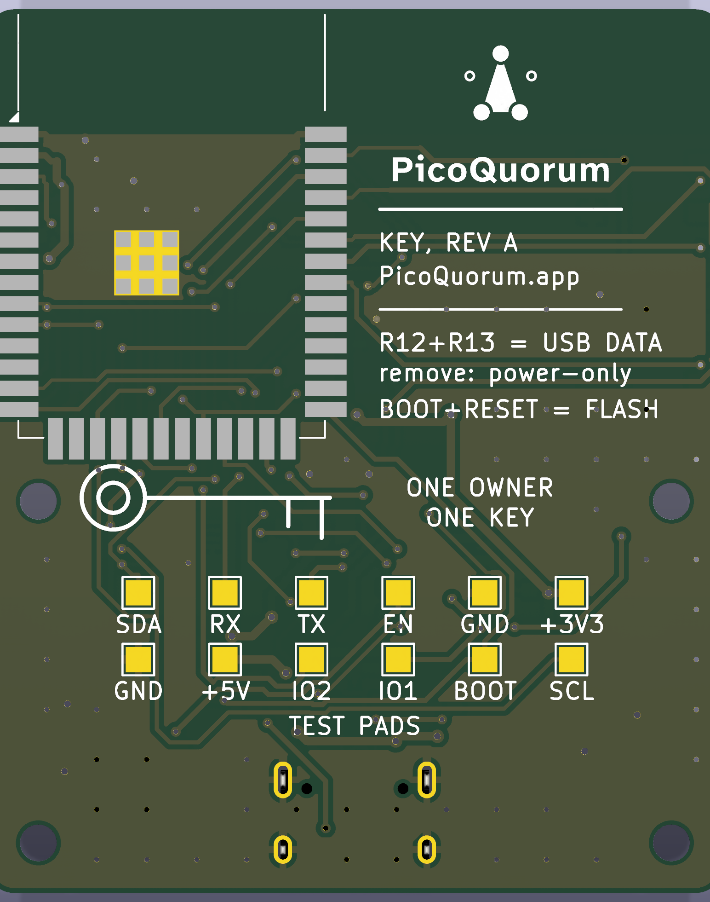
hardware/prototypes/picoquorum-key/docs/img/rev-a-bottom.png
