jmcpheron/pico-quorum/hardware/prototypes/picoquorum-key/docs/img/rev-a-device-back.png

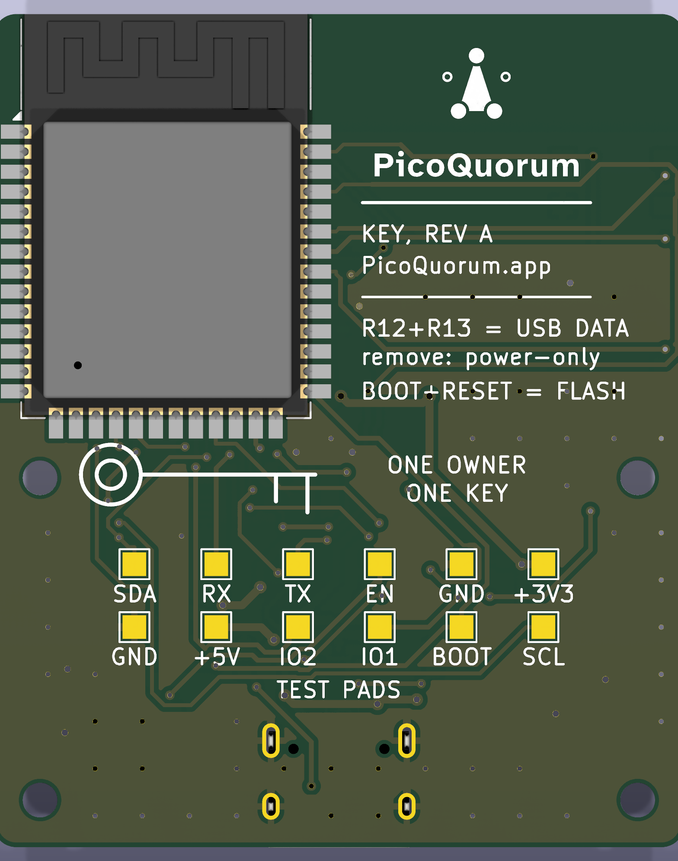
hardware/prototypes/picoquorum-key/docs/img/rev-a-device-back.png
