jmcpheron/pico-quorum/hardware/prototypes/picoquorum-key/docs/img/rev-a-device-top.png

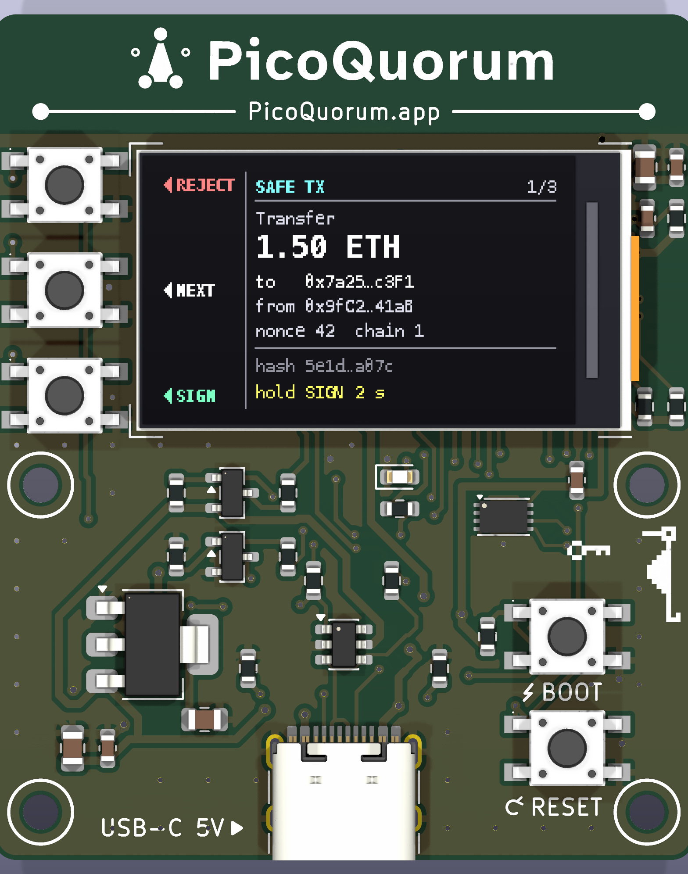
hardware/prototypes/picoquorum-key/docs/img/rev-a-device-top.png
