jmcpheron/pico-quorum/hardware/prototypes/picoquorum-key/docs/img/rev-a-top.png

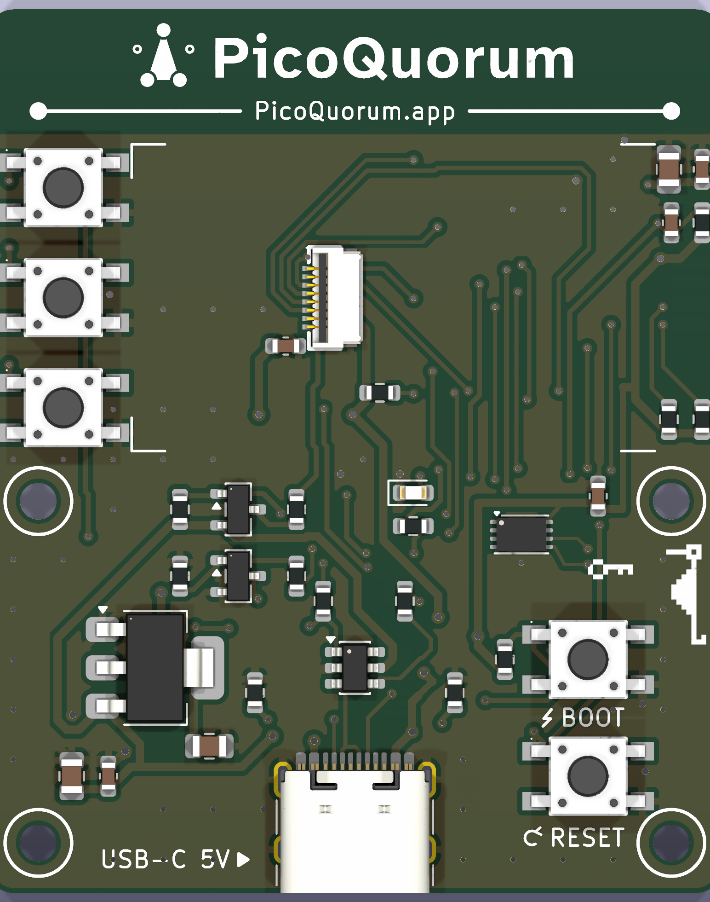
hardware/prototypes/picoquorum-key/docs/img/rev-a-top.png
