jmcpheron/pico-quorum/hardware/tally/renders/tally-back.png

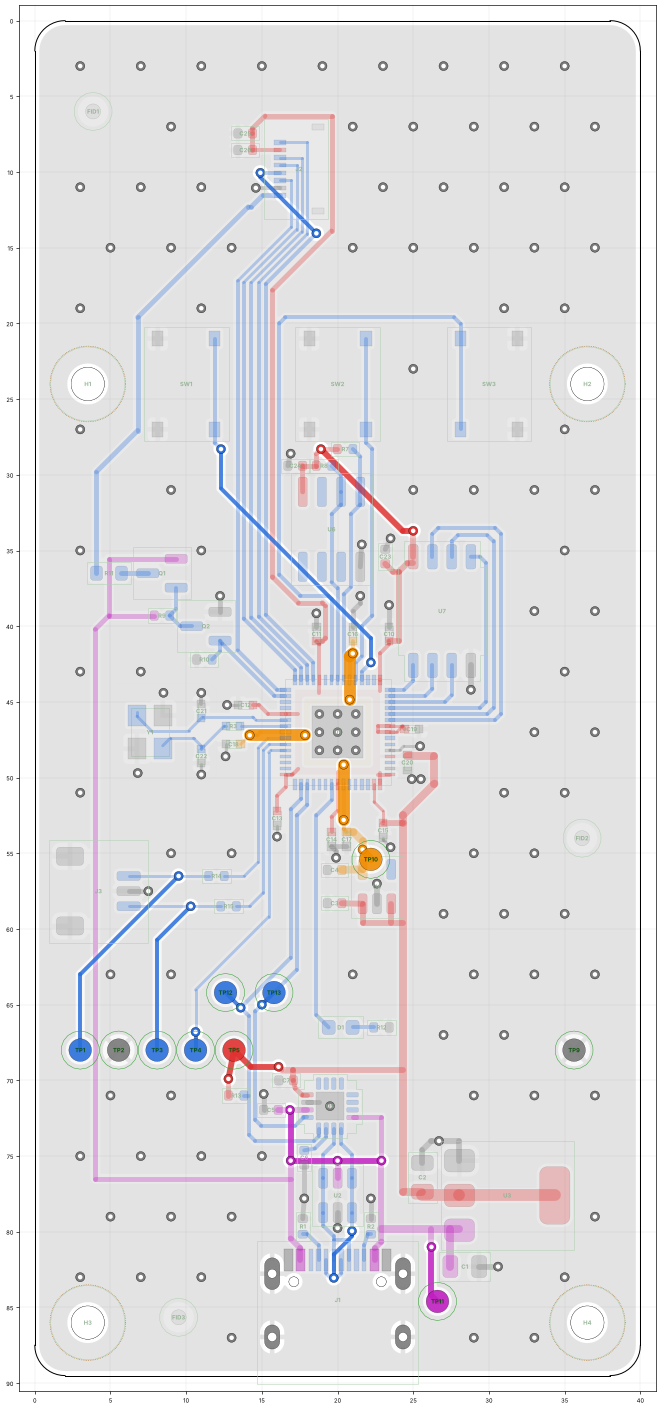
hardware/tally/renders/tally-back.png
