jmcpheron/pico-quorum/hardware/mono/fab/bom.csv

Comment | Designator | Footprint | LCSC Part #
4.7u | C1,C2 | RPi_C_0402_wide | C23733
4.7u | C3,C11 | RPi_C_0402 | C23733
100n | C4,C5,C6,C7,C8,C10,C12,C13,C14 | RPi_C_0402 | C1525
100n | C9,C17,C21,C22,C23,C25,C26,C27,C28 | C_0402_1005Metric | C1525
15p | C15,C16 | RPi_C_0402 | C1548
4.7u | C18 | C_0402_1005Metric | C23733
10u | C19 | C_0805_2012Metric | C15850
1u | C20,C24,C29 | C_0402_1005Metric | C52923
RED | D1 | LED_0603_1608Metric | C2286
USB-C | J1 | USB_C_Receptacle_HRO_TYPE-C-31-M-12 | C165948
PANEL | J2 | FPC_ZIF_8P_P0.5mm_HDGC_0.5K-HX-8PWB | C2919492
3.3uH | L1 | RPi_L_Abracon_AOTA-B201610 | C42411119
AO3401A | Q1 | SOT-23 | C15127
S8050 | Q2 | SOT-23 | C2150
33R | R1 | RPi_R_0402 | C25105
1k | R2 | RPi_R_0402 | C11702
1k | R3,R10,R12 | R_0402_1005Metric | C11702
5.1k | R4,R5 | R_0402_1005Metric | C25905
4.7k | R6,R7,R11,R17,R18,R20 | R_0402_1005Metric | C25900
150R | R8 | R_0603_1608Metric | C22808
10k | R9,R19 | R_0402_1005Metric | C25744
27R | R13,R14 | RPi_R_0402 | C25100
100R | R15,R16 | R_0402_1005Metric | C25076
D0 | SW1 | SW_Push_1P1T_XKB_TS-1187A | C318884
D1 | SW2 | SW_Push_1P1T_XKB_TS-1187A | C318884
D2 | SW3 | SW_Push_1P1T_XKB_TS-1187A | C318884
RP2350A | U1 | RPi_RP2350A_QFN-60_7x7mm_P0.4mm_ThermalVias | C42411118
USBLC6-2SC6 | U2,U10 | SOT-23-6 | C7519
LDL1117S33R | U3 | SOT-223-3_TabPin2 | C435835
CH343P | U4 | WCH_QFN-16-1EP_3x3mm_P0.5mm_EP1.8x1.8mm | C2846043
ATECC608C-SSHDA-T | U5 | SOIC-8_3.9x4.9mm_P1.27mm | C28975195
W25Q128JVSIQ | U6 | SOIC-8_5.3x5.3mm_P1.27mm | C97521
AP22653W6-7 | U9 | SOT-23-6 | C2158037
12MHz | Y1 | RPi_Crystal_SMD_3225-4Pin_3.2x2.5mm | C20625731
