jmcpheron/pico-quorum/hardware/key-pcb/key-c-usbc/fab/bom.csv

Comment | Designator | Footprint | LCSC Part #
100n | C1,C2 | C_0402_1005Metric | C1525
green | D1 | LED_0603_1608Metric | C72043
HC-TYPE-C-16P-01A | J1 | USB_C_Receptacle_HCTL_HC-TYPE-C-16P-01A_PQ | C2894897
5.1k | R1,R2 | R_0402_1005Metric | C25905
470 | R3 | R_0402_1005Metric | C25117
ATECC608C-SSHDA | U1 | SOIC-8_3.9x4.9mm_P1.27mm | C28975195
USBLC6-2SC6 | U2 | SOT-23-6 | C7519
