jmcpheron/pico-quorum/hardware/feather-wing/wing-b/fab/bom.csv

Comment | Designator | Footprint | LCSC Part #
100n | C1 | C_0402 | C1525
10u | C2,C3 | C_0603 | C19702
ESD5Z5V0 | D1,D3 | D_SOD-523 | C502546
USB-C plug, straddle mount | J1 | USB_C_Plug_ShouHan_24P-GTJB_Straddle | C3151751
2.2k | R1,R2 | R_0402 | C25879
100 | R13 | R_0402 | C25076
10k | R3,R7,R8 | R_0402 | C25744
1k | R5 | R_0402 | C11702
0R | R9,R10 | R_0402 | C17168
AP22653W6-7 | U2 | SOT-23-6 | C2158037
USBLC6-2SC6 | U3,U4 | SOT-23-6 | C7519
