jmcpheron/pico-quorum/hardware/console-pcb/console-a/fab/bom.csv

Comment | Designator | Footprint | LCSC Part #
100n | C1 | C_0402_1005Metric | C1525
10u | C2 | C_0603_1608Metric | C19702
ESD5Z5V0 | D1 | D_SOD-523 | C502546
red | D2 | LED_0603_1608Metric | C2286
USB-C plug | J1 | USB_C_Plug_ShenzhenJingTuoJin_918-118A2021Y40002_Vertical | C399939
2.2k | R1,R2 | R_0402_1005Metric | C25879
0R | R10,R11 | R_0402_1005Metric | C17168
10k | R3,R4,R7,R8 | R_0402_1005Metric | C25744
1k | R5,R6,R9 | R_0402_1005Metric | C11702
Sign (A) | SW2 | SW_HRO_K2-1102SP_6x6mm | C129461
Back (B) | SW3 | SW_HRO_K2-1102SP_6x6mm | C129461
Device (X) | SW4 | SW_HRO_K2-1102SP_6x6mm | C129461
Reject (Y) | SW5 | SW_HRO_K2-1102SP_6x6mm | C129461
Pico 2 W | U1 | RaspberryPi_Pico_2_W_SMD_PQ | C42394205
AP22653W6-7 | U2 | SOT-23-6 | C2158037
USBLC6-2SC6 | U3,U4 | SOT-23-6 | C7519
