jmcpheron/pico-quorum/hardware/key-pcb/key-b-udfn/fab/bom.csv

Comment | Designator | Footprint | LCSC Part #
100n | C1 | C_0402_1005Metric | C1525
ATECC608C-MAHDA | U1 | DFN-8-1EP_3x2mm_P0.5mm_EP1.3x1.5mm | C23291019
USBLC6-2SC6 | U2 | SOT-23-6 | C7519
