jmcpheron/pico-quorum/hardware/key-pcb/key-d-pogo/fab/bom.csv

Comment | Designator | Footprint | LCSC Part #
100n | C1 | C_0805_2012Metric | C49678
ATECC608C-SSHDA | U1 | SOIC-8_3.9x4.9mm_P1.27mm | C28975195
USBLC6-2SC6 | U2 | SOT-23-6 | C7519
