jmcpheron/pico-quorum/hardware/prototypes/console-s3/console-s3/fab/bom.csv

Comment | Designator | Footprint | LCSC Part #
10u | C1,C2,C3 | C_0603 | C19702
100n | C4,C5,C6 | C_0603 | C14663
1u | C7 | C_0603 | C15849
RED | D1 | LED_0603 | C2286
USB-C | J1 | USB_C_Receptacle_HCTL_HC-TYPE-C-16P-01A | C2894897
PANEL | J2 | FPC_ZIF_8P_P0.5mm_HDGC_0.5K-HX-8PWB | C2919492
S8050 | Q1 | SOT-23 | C2150
AO3401A | Q2 | SOT-23 | C15127
150R | R1 | R_0603 | C22808
5.1k | R10,R11 | R_0603 | C23186
4.7k | R12,R13 | R_0603 | C23162
1k | R2,R9 | R_0603 | C21190
10k | R3,R4,R5,R6,R7,R8 | R_0603 | C25804
D0 | SW1 | SW_TS-1187A | C318884
D1 | SW2 | SW_TS-1187A | C318884
D2 | SW3 | SW_TS-1187A | C318884
BOOT | SW4 | SW_TS-1187A | C318884
RESET | SW5 | SW_TS-1187A | C318884
ATECC608C | U2 | DFN-8-1EP_3x2mm_P0.5mm | C23291019
ME6211C33 | U3 | SOT-23-5 | C82942
USBLC6-2SC6 | U4 | SOT-23-6 | C7519
