jmcpheron/pico-quorum/hardware/console-a/console-a/fab/factory-pico/bom.csv

Comment | Designator | Footprint | LCSC Part #
100n | C1,C4 | C_0603_1608Metric | C14663
1u | C2,C3 | C_0603_1608Metric | C15849
B5819W | D1 | D_SOD-123 | C8598
AFC07-S24FCA-00 | J2 | Jushuo_AFC07-S24FCA-00_1x24-1MP_P0.50_Horizontal | C262567
SS8050 | Q1 | SOT-23 | C2150
10 | R1 | R_0603_1608Metric | C22859
1k | R2 | R_0603_1608Metric | C21190
10k | R3,R6,R9,R10,R11 | R_0603_1608Metric | C25804
100k | R4,R5 | R_0603_1608Metric | C25803
2.2k | R7,R8 | R_0603_1608Metric | C4190
TS-1187A-B-A-B | SW1,SW2,SW3,SW4,SW5,SW6,SW7,SW8,SW9 | SW_Push_1P1T_XKB_TS-1187A | C318884
Pico 2 W | U1 | RaspberryPi_Pico_W_SMD_HandSolder_PQ | C42394205
TPS22945DCKR | U2 | SOT-353_SC-70-5 | C47507
USBLC6-2SC6 | U3,U4 | SOT-23-6 | C7519
