jmcpheron/pico-quorum/hardware/prototypes/picoquorum-key/hardware/out/rev-b/bom-port.csv

Comment | Designator | Footprint | LCSC Part #
10u | C1,C2,C10 | C_0805_2012Metric | C15850
22u | C3 | C_0805_2012Metric | C45783
1u | C4 | C_0603_1608Metric | C15849
100n | C5,C6,C7,C8,C9 | C_0603_1608Metric | C14663
KT-0603R | D1 | LED_0603_1608Metric | C2286
ESD5Z5V0 | D3 | D_SOD-523 | C502546
KT-0603G | D4 | LED_0603_1608Metric | C12624
1N5819WS | D5 | D_SOD-323 | C191023
HRO TYPE-C-31-M-12 | J1 | USB_C_Receptacle_HRO_TYPE-C-31-M-12_Edge | C165948
HDGC 0.5K-HX-8PWB | J2 | FPC_0.5mm_8P_C2919492 | C2919492
AO3401A | Q1 | SOT-23 | C15127
MMBT3904 | Q2 | SOT-23 | C20526
5.1k | R1,R2 | R_0603_1608Metric | C23186
10k | R3,R4,R5,R23 | R_0603_1608Metric | C25804
4.7k | R6,R7,R14 | R_0603_1608Metric | C23162
1k | R8,R9,R18 | R_0603_1608Metric | C21190
100k | R10,R15 | R_0603_1608Metric | C25803
150 | R11 | R_0603_1608Metric | C22808
0 | R12,R13 | R_0603_1608Metric | C21189
47k | R17 | R_0603_1608Metric | C25819
2.2k | R19,R20 | R_0603_1608Metric | C4190
100 | R21 | R_0603_1608Metric | C22775
470 | R22 | R_0603_1608Metric | C23179
BOOMELE 4.5x4.5x3.8 SMD tact | SW1,SW2,SW3,SW6,SW7 | SW_Tact_4.5x4.5_C2897501 | C2897501
ATECC608C-MAHDA-S | U2 | DFN-8-1EP_3x2mm_P0.5mm_EP1.3x1.5mm | C23291019
AMS1117-3.3 | U3 | SOT-223-3_TabPin2 | C6186
USBLC6-2SC6 | U4,U6,U7 | SOT-23-6 | C7519
AP22653W6-7 | U5 | SOT-23-6 | C2158037
