jmcpheron/pico-quorum/cad/consoles/out/badge/badge_assembly.step

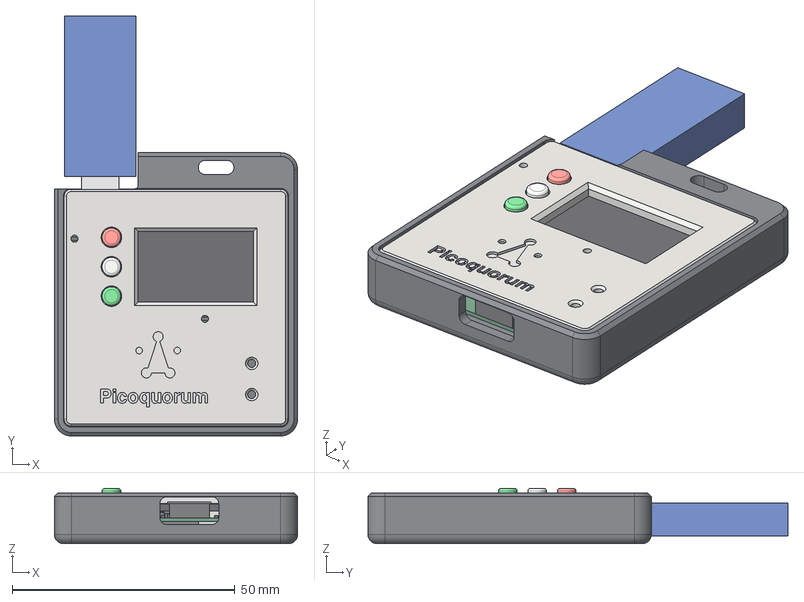
[picture p309: CAD file, 2026-11-09]
cad/consoles/out/badge/badge_assembly.step
54.6 x 94.3 x 12.4 mm
tub
plate
cap_D0
cap_D1
cap_D2
screws
pcb_board
pcb_key_port_plug
pcb_key-c
pcb_C1
pcb_C10
pcb_C2
pcb_C3
pcb_C4
pcb_C5
pcb_C6
pcb_C7
pcb_C8
pcb_C9
pcb_D1
pcb_D3
pcb_D4
pcb_D5
pcb_J1
pcb_J2
pcb_Q1
pcb_Q2
pcb_R1
pcb_R10
pcb_R11
pcb_R12
pcb_R13
pcb_R14
pcb_R15
pcb_R17
pcb_R18
pcb_R19
pcb_R2
pcb_R20
pcb_R21
pcb_R22
pcb_R23
pcb_R3
pcb_R4
pcb_R5
pcb_R6
pcb_R7
pcb_R8
pcb_R9
pcb_SW1
pcb_SW2
pcb_SW3
pcb_SW6
pcb_SW7
pcb_U2
pcb_U3
pcb_U4
pcb_U5
pcb_U6
pcb_U7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
