jmcpheron/pico-quorum/hardware/builds/pico-sign-handheld/case/out/handheld_assembly.step

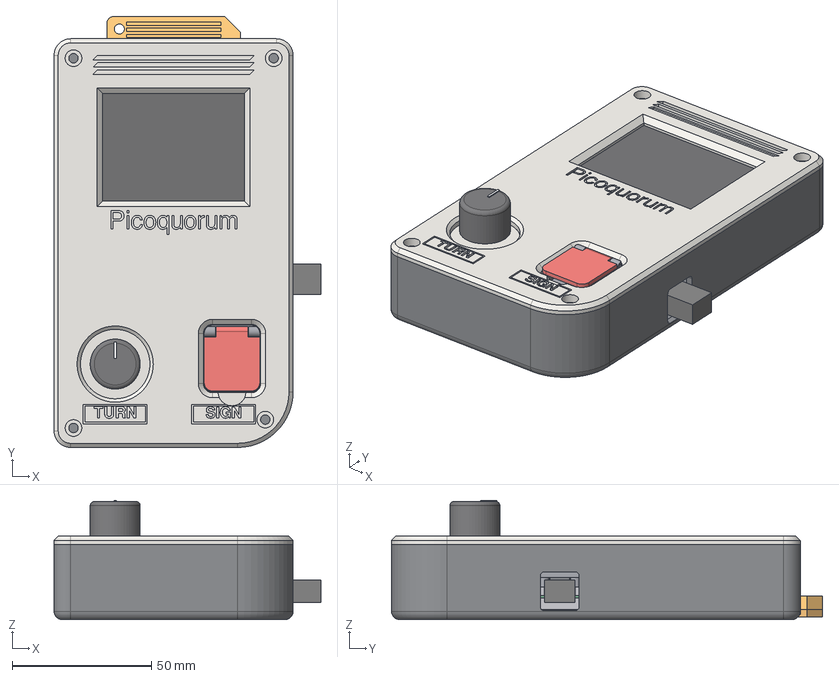
[picture p310: CAD file, 2026-11-06]
hardware/builds/pico-sign-handheld/case/out/handheld_assembly.step
96.0 x 155.0 x 42.9 mm
plate
carrier
spacers
plug_lock
guard_base
guard_cover
sign_cap
screen_glass
screen_board
screen_board_back_parts
screen_header_and_wires
carrier_screws
tact_switch
breadboard
base_screws
knob
knob_mark
EC11_body
plug_overmold
plug_shell
cartridge_cover
cartridge_tray
key-c
ATECC608
Pico_2_W
Picos_parts_toward_the_carrier_space
Picos_wires_space
USB_plug_space
