jmcpheron/pico-quorum/hardware/builds/pico-sign/case/out/prism/prism_assembly.step

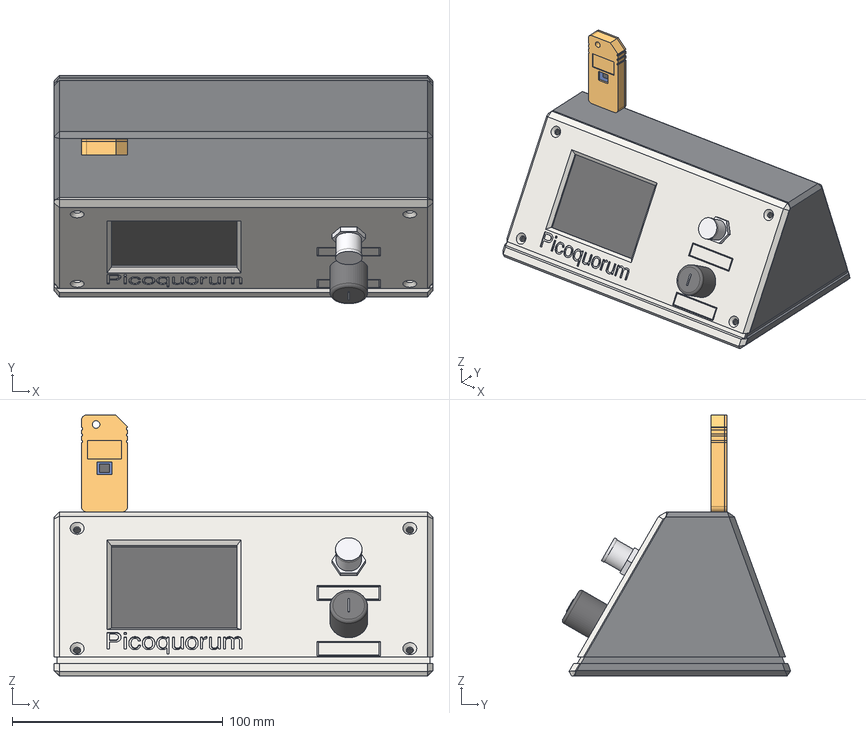
[picture p311: CAD file, 2026-11-06]
hardware/builds/pico-sign/case/out/prism/prism_assembly.step
180.0 x 108.5 x 123.9 mm
plate
carrier
spacers
plug_lock
screen_glass
screen_board
screen_board_back_parts
screen_header_and_wires
carrier_screws
sign_switch
sign_switch_body
knob
knob_mark
EC11_body
plug_overmold
plug_shell
cartridge_top
cartridge_bottom
key-c
ATECC608
Pico_2_W
headers_and_wires_space
USB_plug_and_bend_space
