jmcpheron/pico-quorum/cad/consoles/out/rp/rp_assembly.step

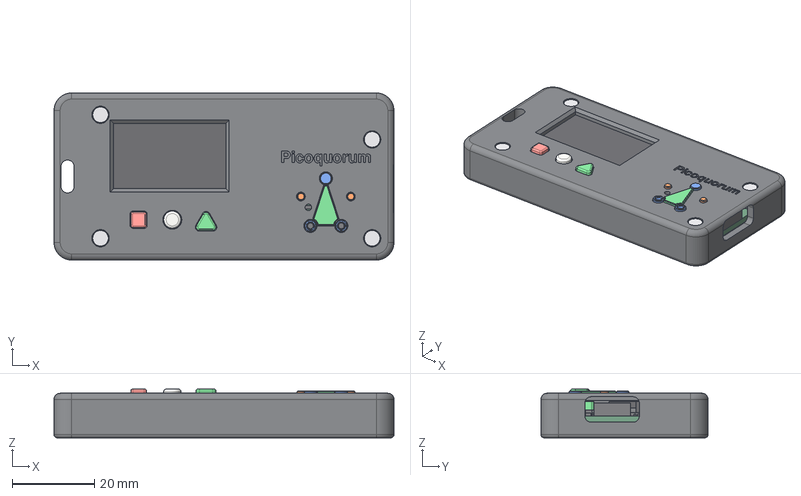
[picture p312: CAD file, 2026-11-09]
cad/consoles/out/rp/rp_assembly.step
82.6 x 40.6 x 11.8 mm
back
cap_D0
cap_D1
cap_D2
badge_triangle
badge_signed_0
badge_signed_2
badge_signed_3
badge_waiting_1
badge_waiting_4
screws
pcb_board
pcb_C1
pcb_C10
pcb_C11
pcb_C12
pcb_C13
pcb_C14
pcb_C15
pcb_C16
pcb_C17
pcb_C18
pcb_C19
pcb_C2
pcb_C20
pcb_C21
pcb_C22
pcb_C23
pcb_C24
pcb_C25
pcb_C3
pcb_C4
pcb_C5
pcb_C6
pcb_C7
pcb_C8
pcb_C9
pcb_D1
pcb_J1
pcb_J2
pcb_L1
pcb_Q1
pcb_Q2
pcb_R1
pcb_R10
pcb_R11
pcb_R12
pcb_R13
pcb_R14
pcb_R2
pcb_R3
pcb_R4
pcb_R5
pcb_R6
pcb_R7
pcb_R8
pcb_R9
pcb_SW1
pcb_SW2
pcb_SW3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
