jmcpheron/pico-quorum/cad/consoles/out/stick/stick_assembly.step

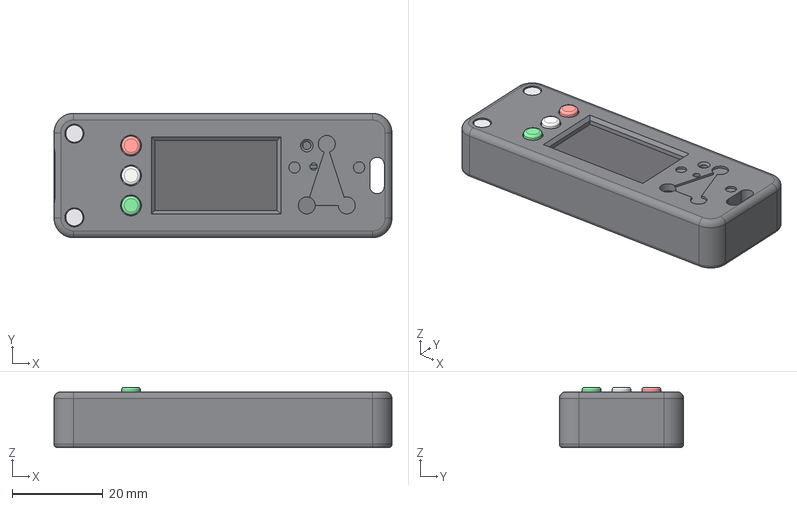
[picture p313: CAD file, 2026-11-09]
cad/consoles/out/stick/stick_assembly.step
74.6 x 27.5 x 13.3 mm
back
cap_D0
cap_D1
cap_D2
screws
pcb_board
pcb_C1
pcb_C2
pcb_C3
pcb_C4
pcb_C5
pcb_C6
pcb_C7
pcb_D1
pcb_J1
pcb_J2
pcb_Q1
pcb_Q2
pcb_R1
pcb_R10
pcb_R11
pcb_R12
pcb_R13
pcb_R2
pcb_R3
pcb_R4
pcb_R5
pcb_R6
pcb_R7
pcb_R8
pcb_R9
pcb_SW1
pcb_SW2
pcb_SW3
pcb_SW4
pcb_SW5
pcb_U2
pcb_U3
pcb_U4
pcb_glass
pcb_ribbon_fold
pcb_module
