jmcpheron/pico-quorum/cad/consoles/out/mono/mono_assembly.step

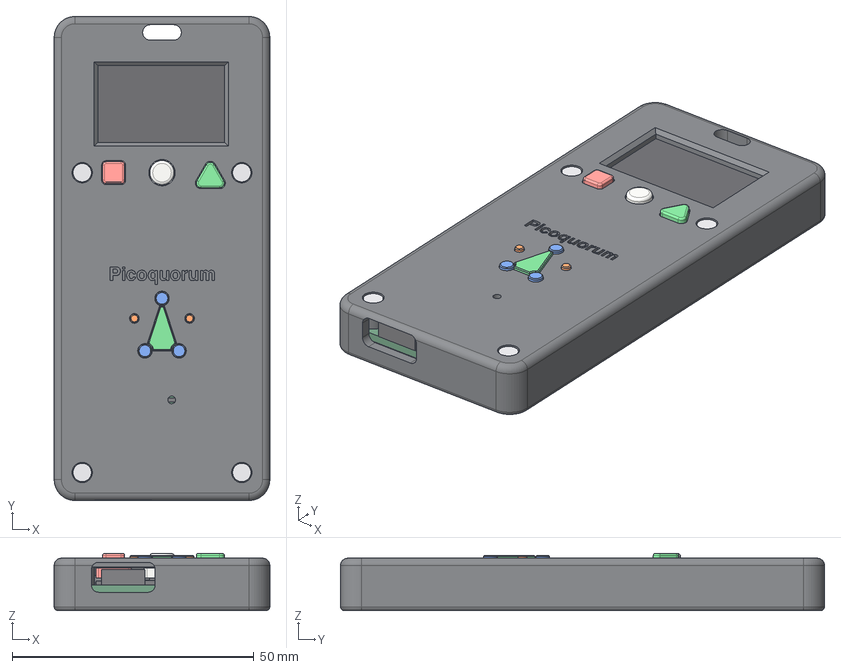
[picture p314: CAD file, 2026-11-09]
cad/consoles/out/mono/mono_assembly.step
44.6 x 100.1 x 11.8 mm
back
cap_D0
cap_D1
cap_D2
badge_triangle
badge_signed_0
badge_signed_2
badge_signed_3
badge_waiting_1
badge_waiting_4
screws
pcb_board
pcb_C1
pcb_C10
pcb_C11
pcb_C12
pcb_C13
pcb_C14
pcb_C15
pcb_C16
pcb_C17
pcb_C18
pcb_C19
pcb_C2
pcb_C20
pcb_C21
pcb_C22
pcb_C23
pcb_C24
pcb_C25
pcb_C26
pcb_C27
pcb_C28
pcb_C29
pcb_C3
pcb_C4
pcb_C5
pcb_C6
pcb_C7
pcb_C8
pcb_C9
pcb_D1
pcb_J1
pcb_J2
pcb_L1
pcb_Q1
pcb_Q2
pcb_R1
pcb_R10
pcb_R11
pcb_R12
pcb_R13
pcb_R14
pcb_R15
pcb_R16
pcb_R17
pcb_R18
pcb_R19
pcb_R2
pcb_R20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
