jmcpheron/pico-quorum/hardware/builds/feather-pigtail/case/out/pigtail_case_v2_assembly.step

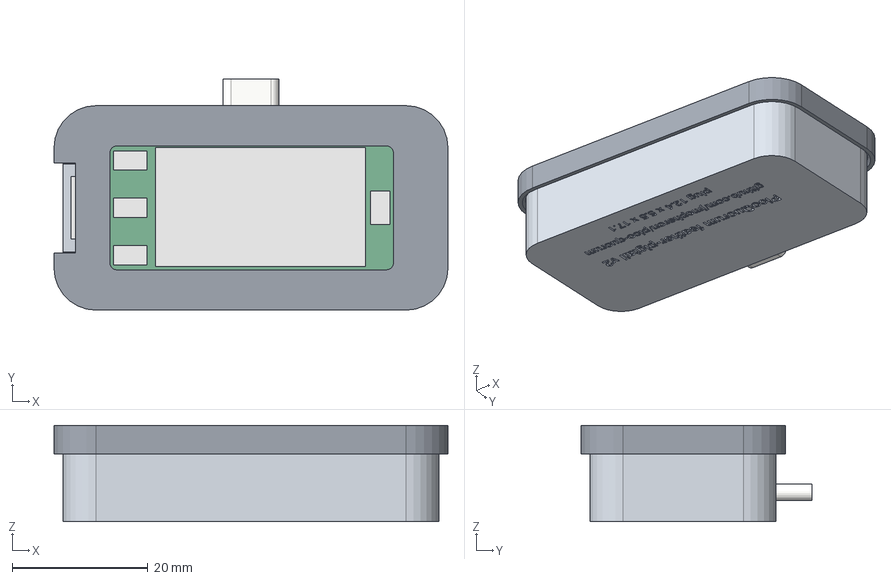
[picture p315: CAD file, 2026-10-24]
hardware/builds/feather-pigtail/case/out/pigtail_case_v2_assembly.step
58.1 x 34.1 x 14.2 mm
tray
bezel
feather
feather parts
usb-c plug
