jmcpheron/pico-quorum/hardware/builds/pico-sign/case/out/pico_sign_assembly.step

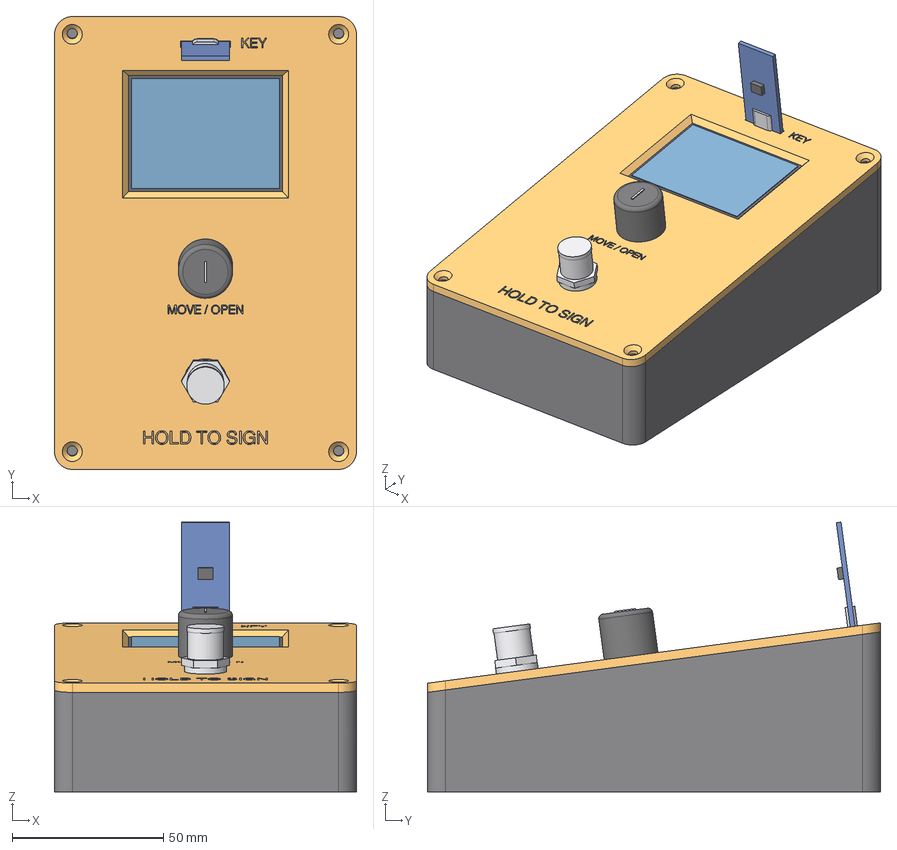
[picture p316: CAD file, 2026-11-02]
hardware/builds/pico-sign/case/out/pico_sign_assembly.step
100.0 x 150.0 x 89.4 mm
base
lid
sign_switch
sign_switch_body
knob
knob_mark
EC11_body
screen_panel
screen_picture
screen_board
plug_overmold
plug_shell
key-c_board
key-c_receptacle
ATECC608
Pico_2_W
micro-USB
headers_and_wires_space
