jmcpheron/pico-quorum/cad/consoles/out/mono/mono_badge_signed_3.stl

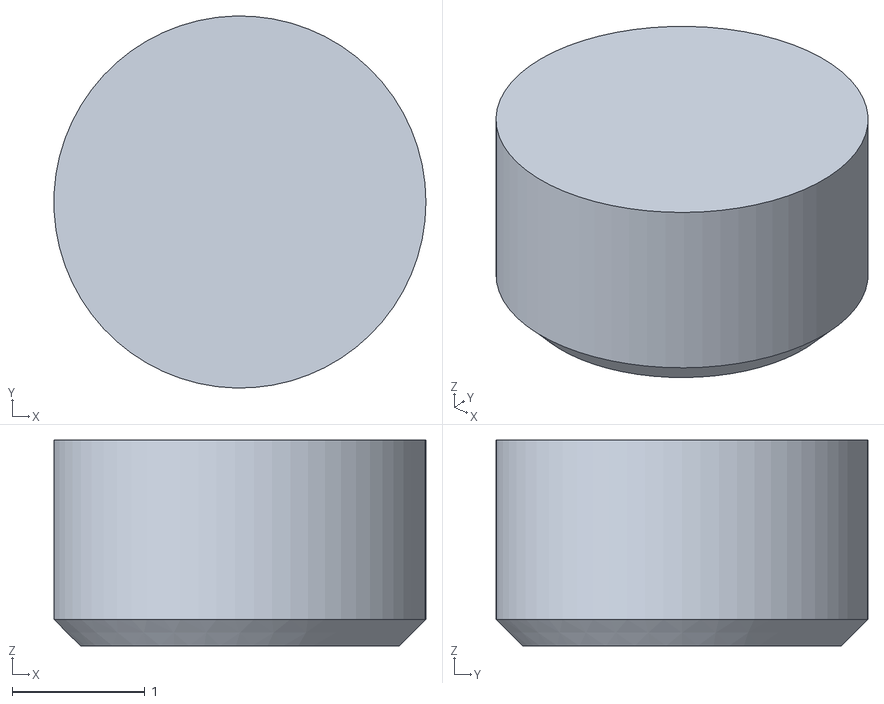
[picture p317: CAD file, 2026-11-09]
cad/consoles/out/mono/mono_badge_signed_3.stl
2.80 x 2.80 x 1.55
