jmcpheron/pico-quorum/cad/consoles/out/mono_ind/mono_ind_shell_black.stl

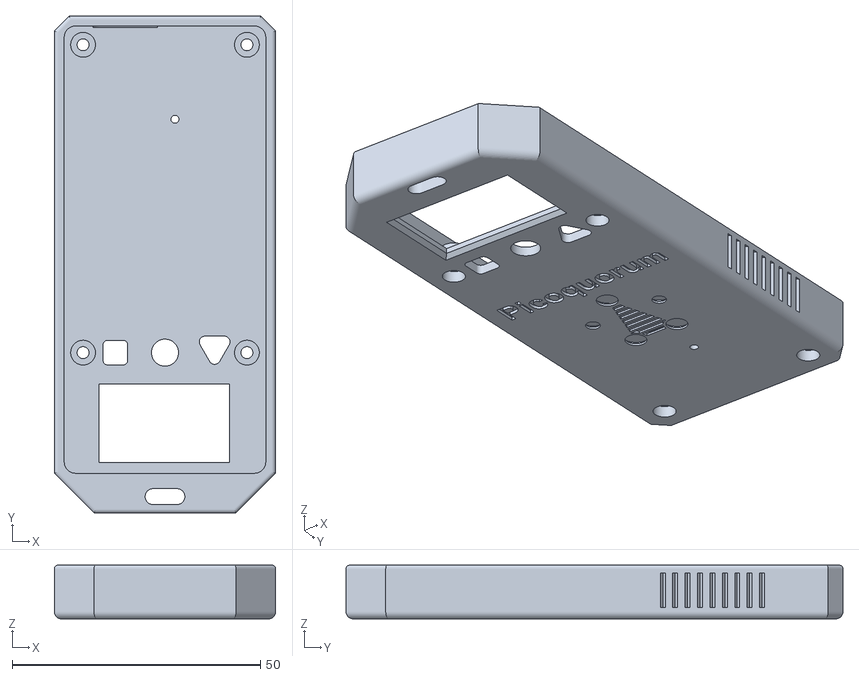
[picture p318: CAD file, 2026-11-12]
cad/consoles/out/mono_ind/mono_ind_shell_black.stl
44.6 x 100.1 x 10.9
