jmcpheron/pico-quorum/cad/consoles/out/rp/rp_shell.stl

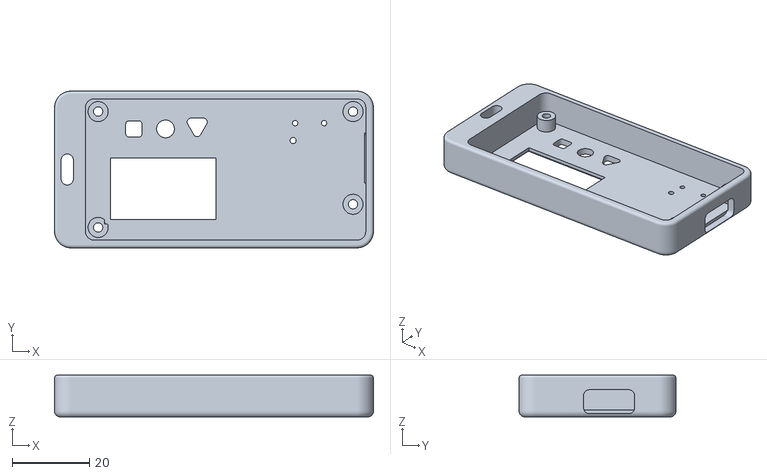
[picture p319: CAD file, 2026-11-09]
cad/consoles/out/rp/rp_shell.stl
82.6 x 40.6 x 10.9
