jmcpheron/pico-quorum/cad/consoles/out/stick/stick_shell.stl

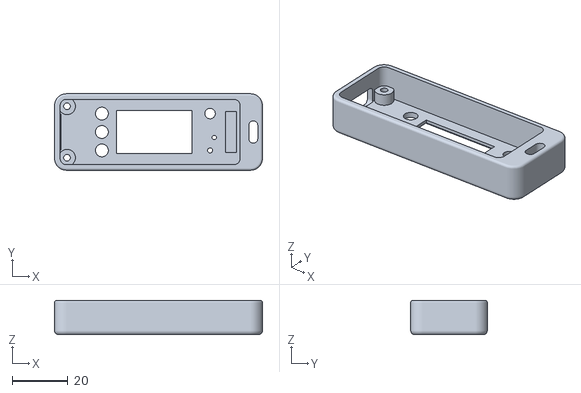
[picture p320: CAD file, 2026-11-09]
cad/consoles/out/stick/stick_shell.stl
74.6 x 27.5 x 12.4
