jmcpheron/pico-quorum/cad/key/out/key_tray_v3.stl

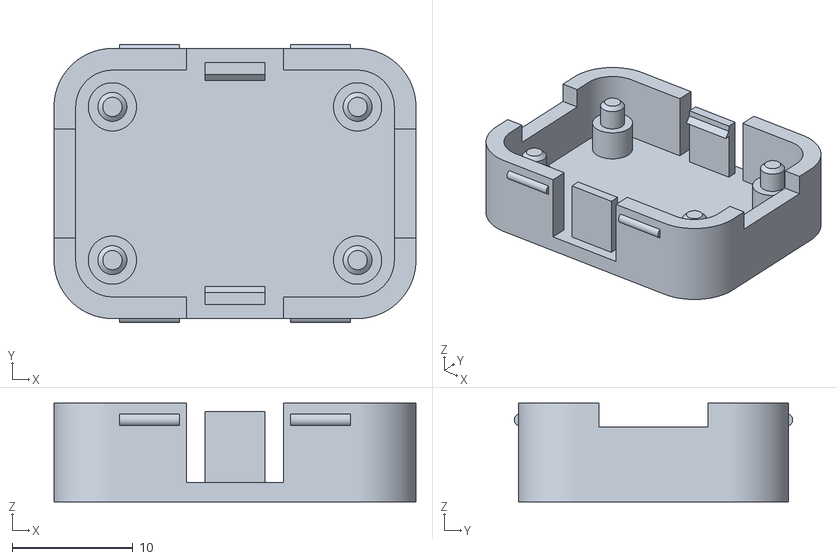
[picture p321: CAD file, 2026-10-07]
cad/key/out/key_tray_v3.stl
30.0 x 23.1 x 8.20
