jmcpheron/pico-quorum/cad/mono/out/mono_board_parts.stl

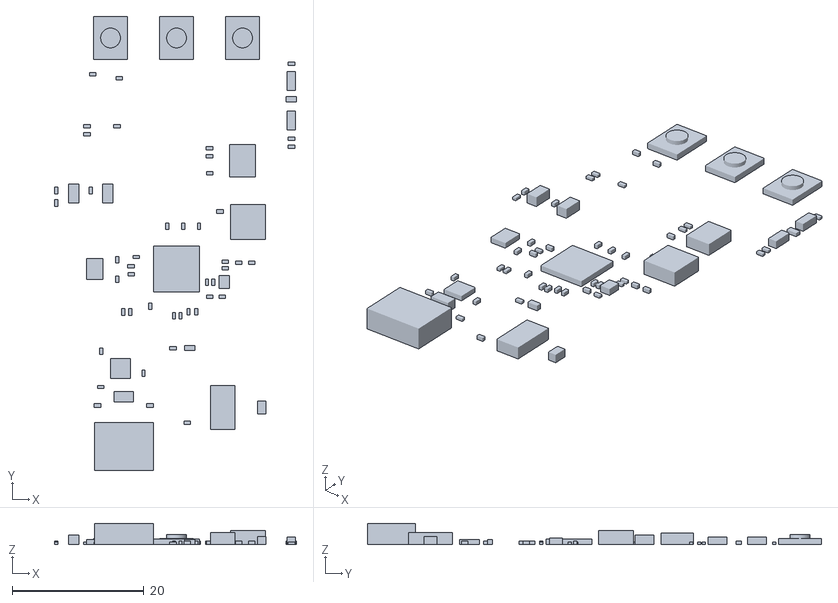
[picture p322: CAD file, 2026-11-09]
cad/mono/out/mono_board_parts.stl
36.7 x 68.8 x 3.20
