jmcpheron/pico-quorum/hardware/builds/feather-pigtail/case/out/pigtail_case_v2.stl

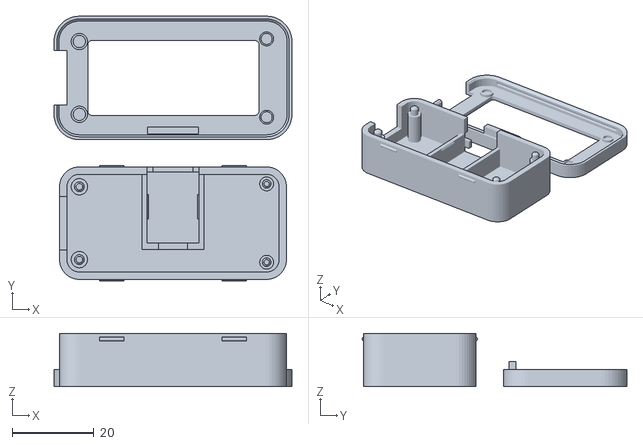
[picture p323: CAD file, 2026-10-24]
hardware/builds/feather-pigtail/case/out/pigtail_case_v2.stl
58.1 x 64.6 x 13.0
