jmcpheron/pico-quorum/hardware/builds/pico-sign/case/out/concepts/cartridge_top.stl

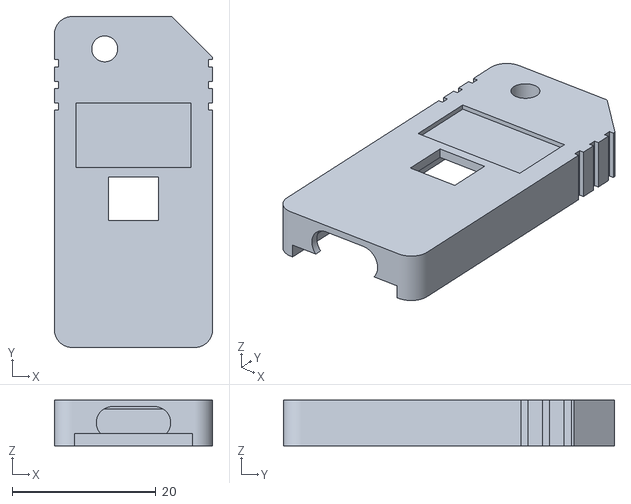
[picture p324: CAD file, 2026-11-02]
hardware/builds/pico-sign/case/out/concepts/cartridge_top.stl
22.0 x 46.0 x 6.36
