jmcpheron/pico-quorum/hardware/builds/pico-sign/case/out/pico_sign_lid.stl

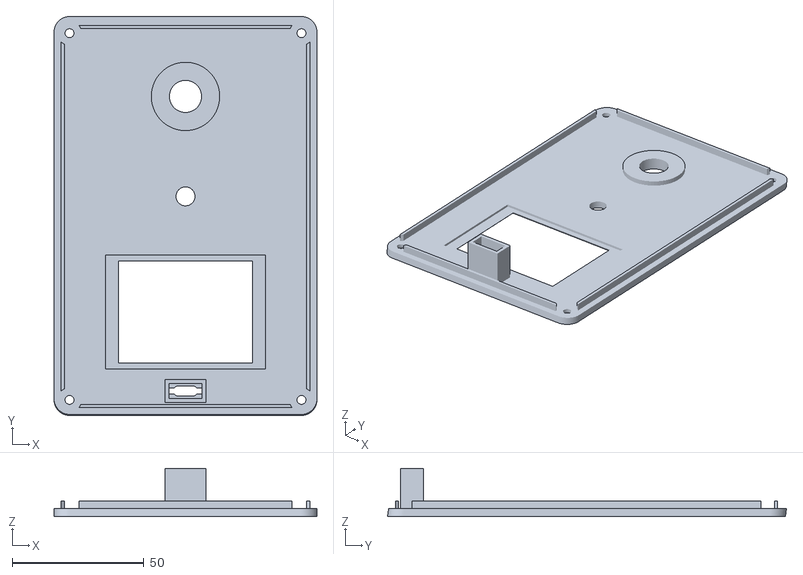
[picture p325: CAD file, 2026-11-02]
hardware/builds/pico-sign/case/out/pico_sign_lid.stl
100.0 x 151.7 x 18.3
