jmcpheron/pico-quorum/hardware/key-pcb/key-c-usbc/3d/key-c-P2-print.step

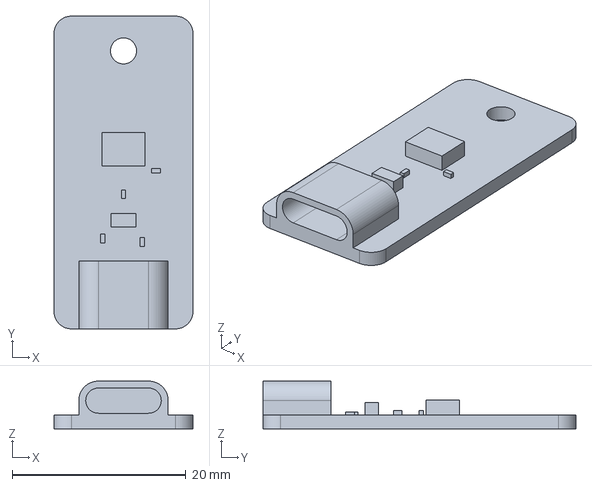
[picture p326: CAD file, 2026-10-05]
hardware/key-pcb/key-c-usbc/3d/key-c-P2-print.step
16.0 x 36.0 x 5.50 mm
