jmcpheron/pico-quorum/hardware/prototypes/console-s3/mockup/console-s3-module.stl

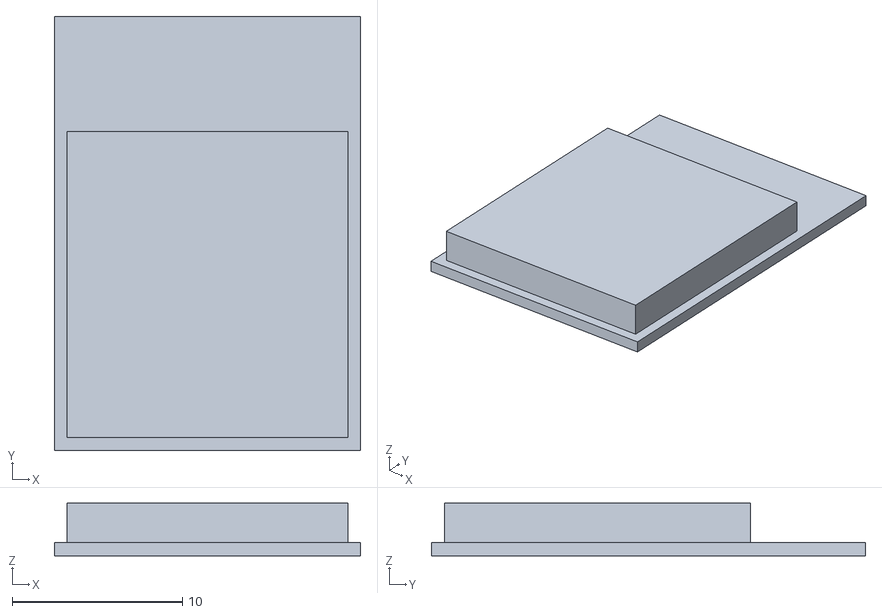
[picture p327: CAD file, 2026-10-25]
hardware/prototypes/console-s3/mockup/console-s3-module.stl
18.0 x 25.5 x 3.10
