jmcpheron/pico-quorum/cad/consoles/out/badge/badge_tub.stl

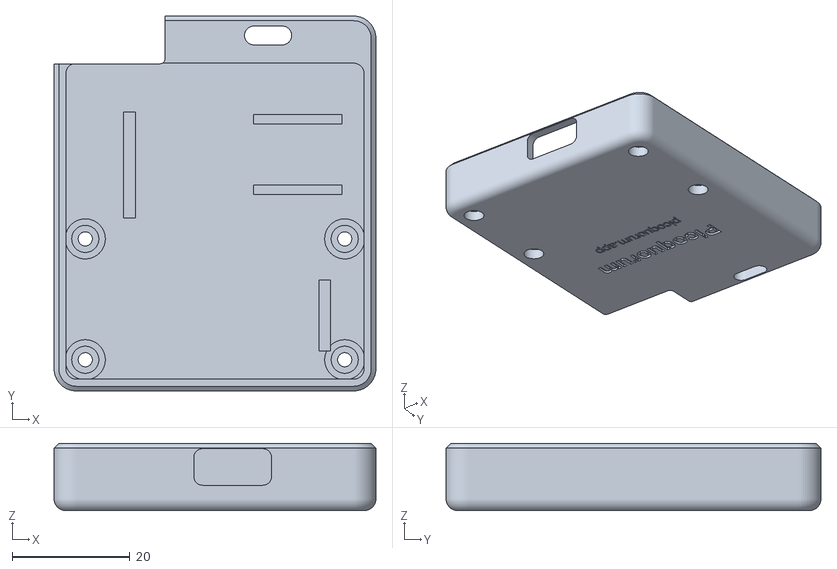
[picture p328: CAD file, 2026-11-09]
cad/consoles/out/badge/badge_tub.stl
54.6 x 63.6 x 11.4
