jmcpheron/pico-quorum/cad/consoles/out/mono/mono_badge_waiting_4.stl

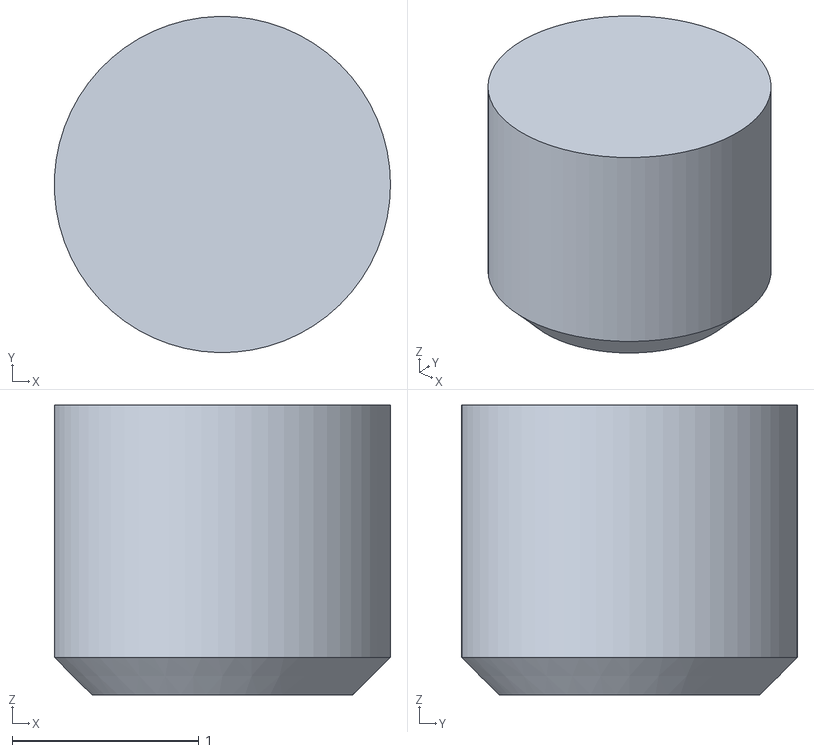
[picture p329: CAD file, 2026-11-09]
cad/consoles/out/mono/mono_badge_waiting_4.stl
1.80 x 1.80 x 1.55
