jmcpheron/pico-quorum/cad/key/out/key_tray_v1_pegfit_x3.stl

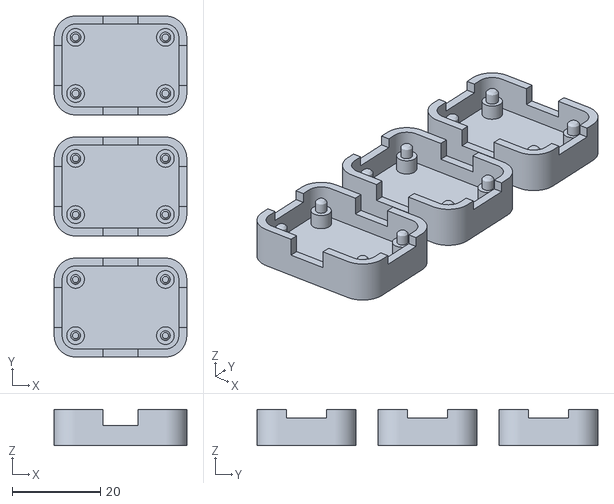
[picture p330: CAD file, 2026-10-07]
cad/key/out/key_tray_v1_pegfit_x3.stl
30.0 x 77.1 x 8.20
