jmcpheron/pico-quorum/cad/mono/out/mono_board_panel.stl

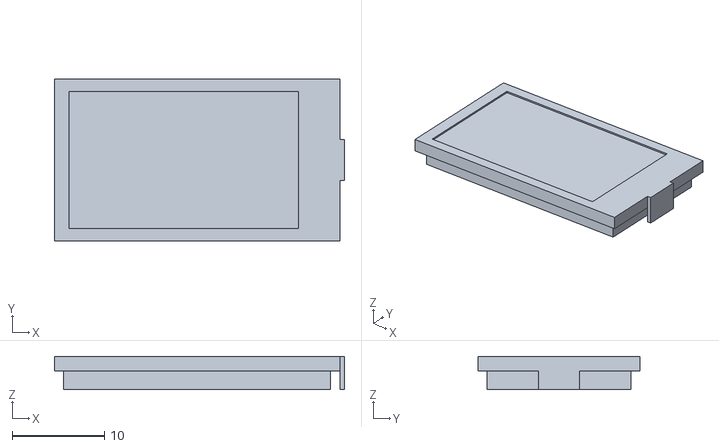
[picture p331: CAD file, 2026-11-09]
cad/mono/out/mono_board_panel.stl
31.5 x 17.6 x 3.60
