jmcpheron/pico-quorum/hardware/builds/feather-pigtail/case/out/pigtail_tray_v2.step

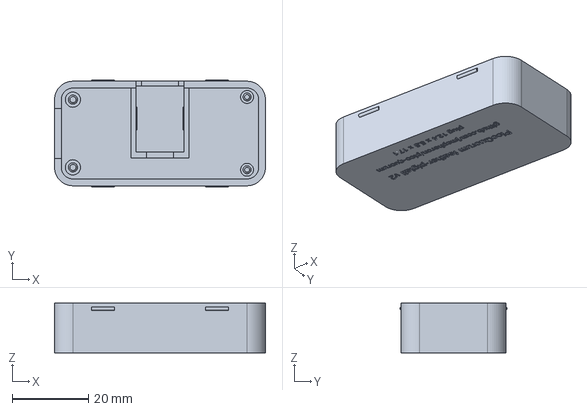
[picture p332: CAD file, 2026-10-24]
hardware/builds/feather-pigtail/case/out/pigtail_tray_v2.step
55.4 x 28.2 x 13.0 mm
