jmcpheron/pico-quorum/hardware/builds/pico-sign-handheld/case/out/handheld_plate.stl

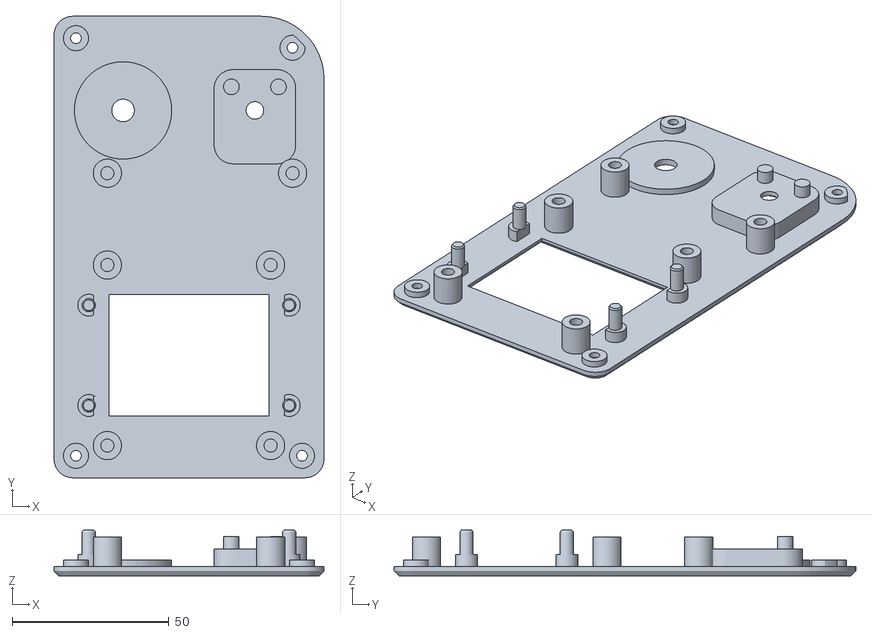
[picture p333: CAD file, 2026-11-06]
hardware/builds/pico-sign-handheld/case/out/handheld_plate.stl
86.0 x 147.0 x 14.5
