jmcpheron/pico-quorum/hardware/builds/pico-sign/case/out/concepts/concepts.step

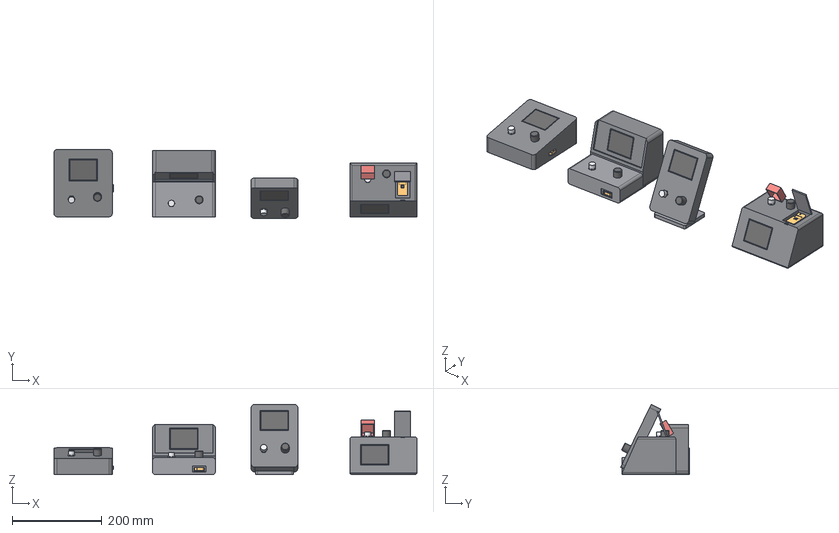
[picture p334: CAD file, 2026-11-02]
hardware/builds/pico-sign/case/out/concepts/concepts.step
810.0 x 153.6 x 156.7 mm
screen x 4
knob x 4
sign_switch x 4
cartridge_top x 4
cartridge_bottom x 4
the_chip_through_its_window x 4
deck
panel
foot
door_slid_open
bay_lid_open
hasp
guard_flipped_up
