jmcpheron/pico-quorum/hardware/builds/pico-sign/case/out/pico_sign_base.stl

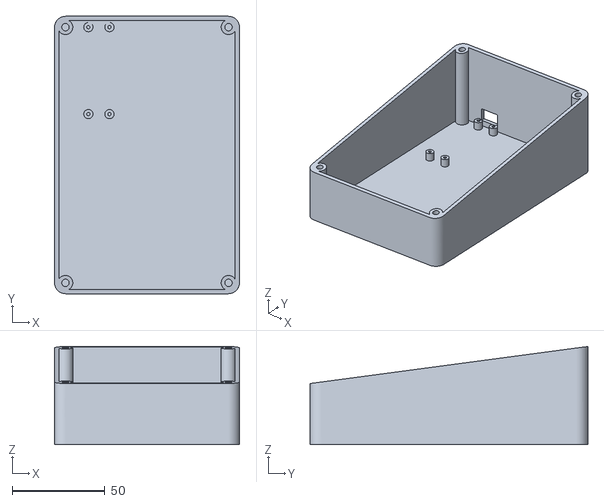
[picture p335: CAD file, 2026-11-02]
hardware/builds/pico-sign/case/out/pico_sign_base.stl
100.0 x 150.0 x 53.0
