jmcpheron/pico-quorum/hardware/builds/pico-sign/case/out/prism/prism_plate.stl

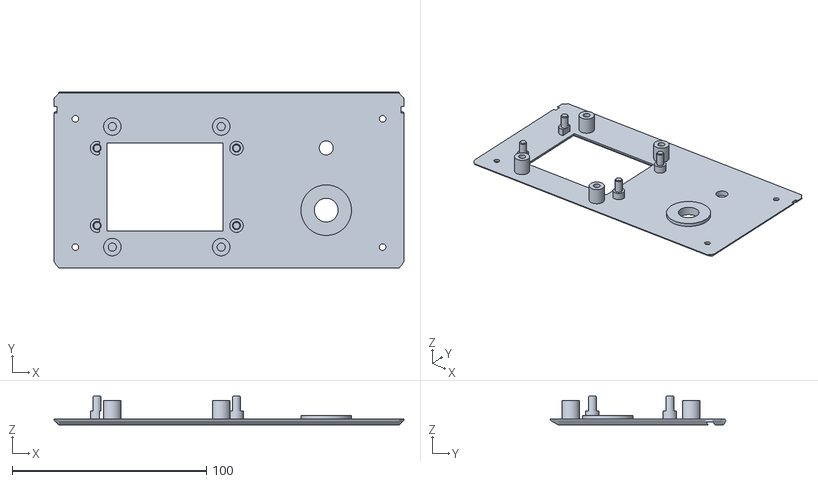
[picture p336: CAD file, 2026-11-06]
hardware/builds/pico-sign/case/out/prism/prism_plate.stl
180.0 x 90.5 x 14.9
