jmcpheron/pico-quorum/hardware/key-pcb/key-c-usbc/3d/key-c-P2.step

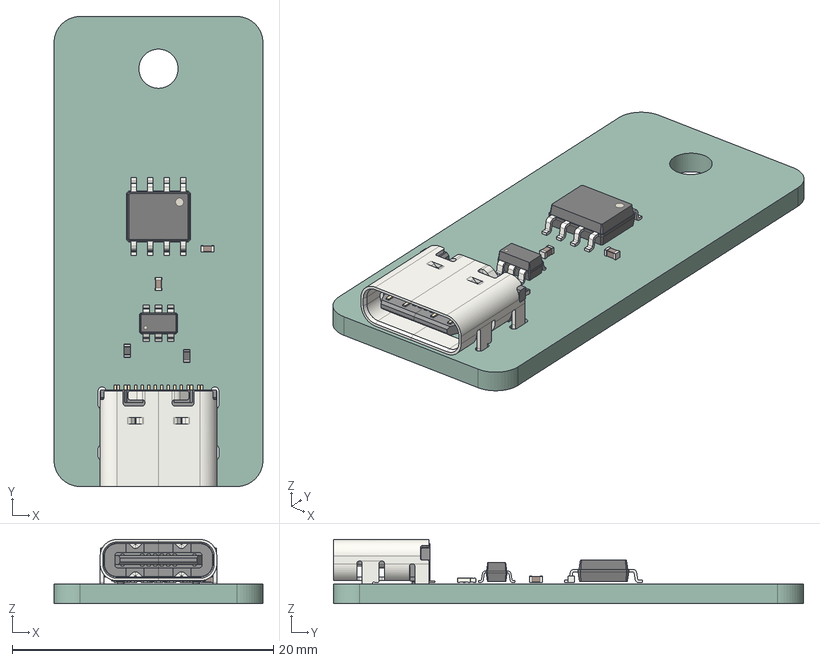
[picture p337: CAD file, 2026-10-05]
hardware/key-pcb/key-c-usbc/3d/key-c-P2.step
16.0 x 36.0 x 4.91 mm
C_0402_1005Metric x 2
SOT-23-6
R_0402_1005Metric x 2
SOIC-8_3.9x4.9mm_P1.27mm
USB_C_Receptacle_16P_TopMnt_Horizontal_GCT_USB4105-xx-A
key-c-usbc_PCB
