jmcpheron/pico-quorum/hardware/prototypes/console-s3/mockup/console-s3-board.stl

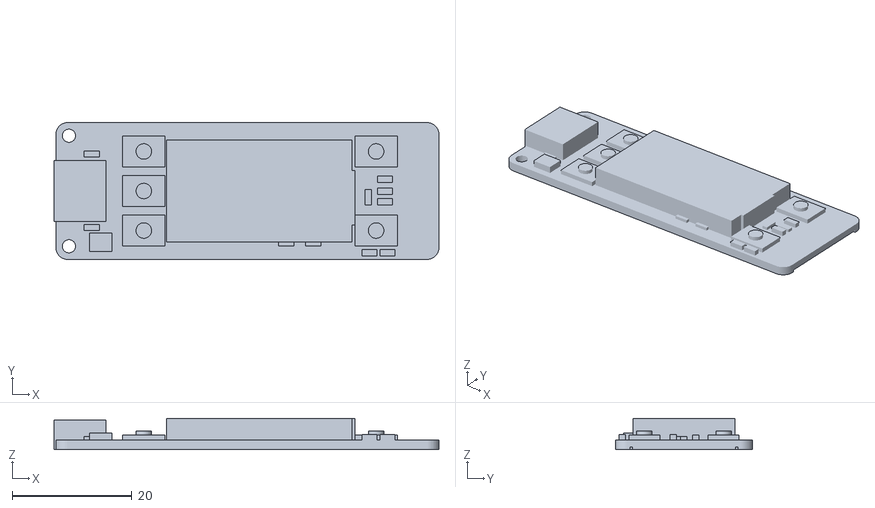
[picture p338: CAD file, 2026-10-25]
hardware/prototypes/console-s3/mockup/console-s3-board.stl
64.3 x 22.9 x 5.20
