jmcpheron/pico-quorum/hardware/prototypes/picoquorum-key/mockup/picoquorum-key-board.stl

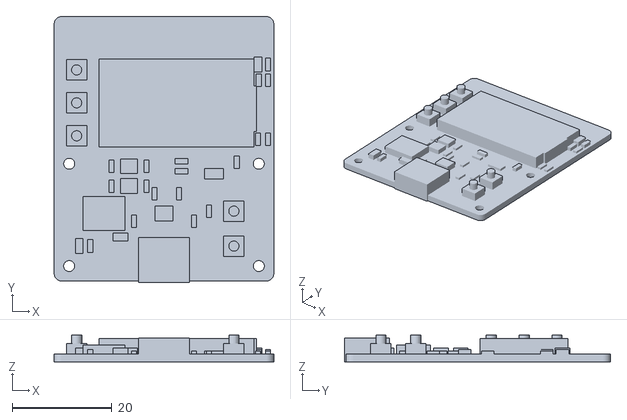
[picture p339: CAD file, 2026-10-25]
hardware/prototypes/picoquorum-key/mockup/picoquorum-key-board.stl
44.0 x 53.3 x 5.40
