jmcpheron/pico-quorum/cad/consoles/out/badge/badge_plate.stl

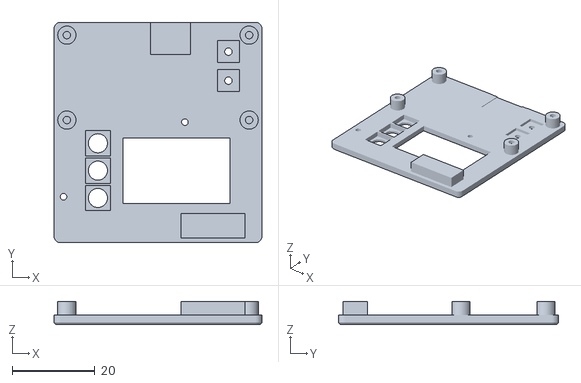
[picture p340: CAD file, 2026-11-06]
cad/consoles/out/badge/badge_plate.stl
50.2 x 53.2 x 5.60
