jmcpheron/pico-quorum/cad/consoles/out/mono_ind/mono_ind_shell_green.stl

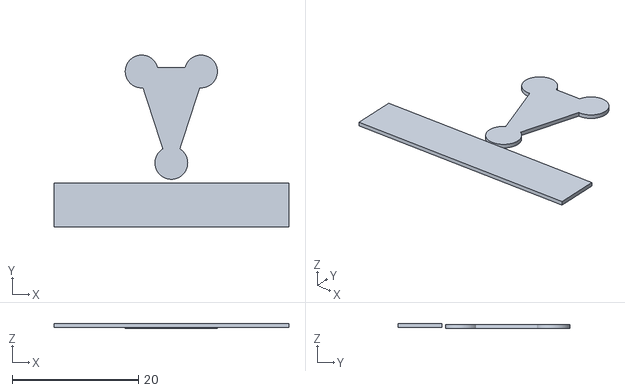
[picture p341: CAD file, 2026-11-12]
cad/consoles/out/mono_ind/mono_ind_shell_green.stl
37.2 x 27.2 x 0.8
