jmcpheron/pico-quorum/cad/consoles/out/rp/rp_back.stl

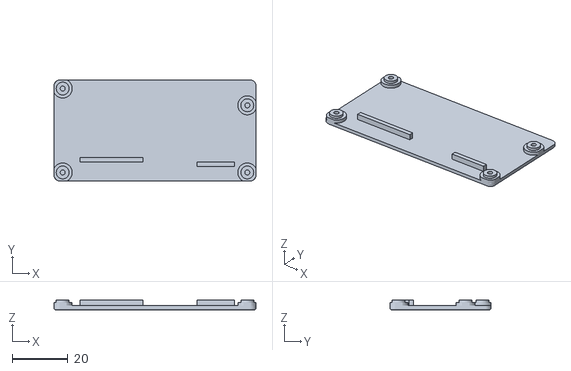
[picture p342: CAD file, 2026-11-06]
cad/consoles/out/rp/rp_back.stl
72.2 x 36.2 x 3.70
