jmcpheron/pico-quorum/cad/consoles/out/stick/stick_back.stl

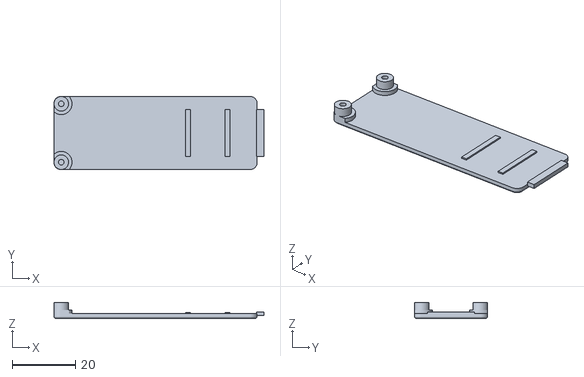
[picture p343: CAD file, 2026-11-06]
cad/consoles/out/stick/stick_back.stl
66.4 x 23.1 x 5.20
