jmcpheron/pico-quorum/cad/key/out/key_case_v2.stl

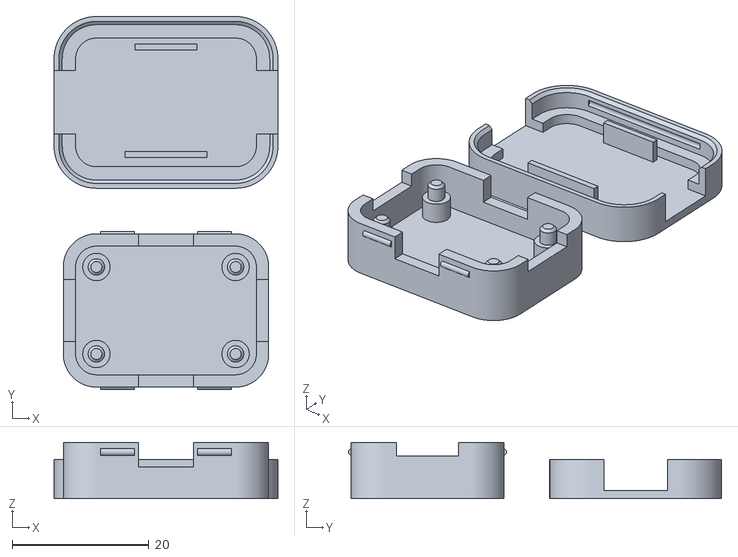
[picture p344: CAD file, 2026-10-07]
cad/key/out/key_case_v2.stl
32.7 x 54.5 x 8.20
