jmcpheron/pico-quorum/cad/mono/out/mono_board_pcb.stl

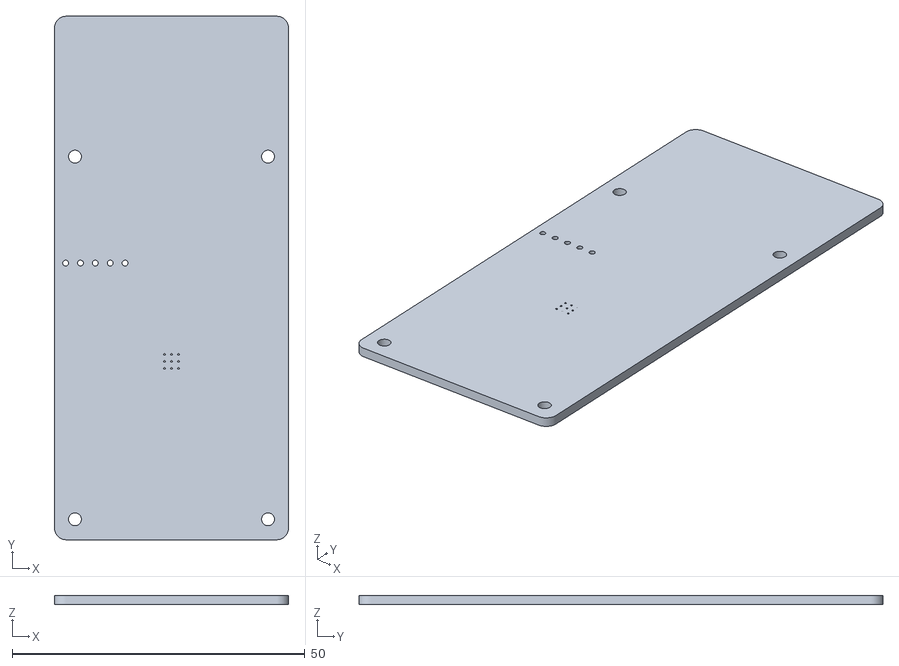
[picture p345: CAD file, 2026-11-09]
cad/mono/out/mono_board_pcb.stl
40.0 x 89.5 x 1.60
