jmcpheron/pico-quorum/hardware/builds/pico-sign-handheld/case/out/cartridge_cover.stl

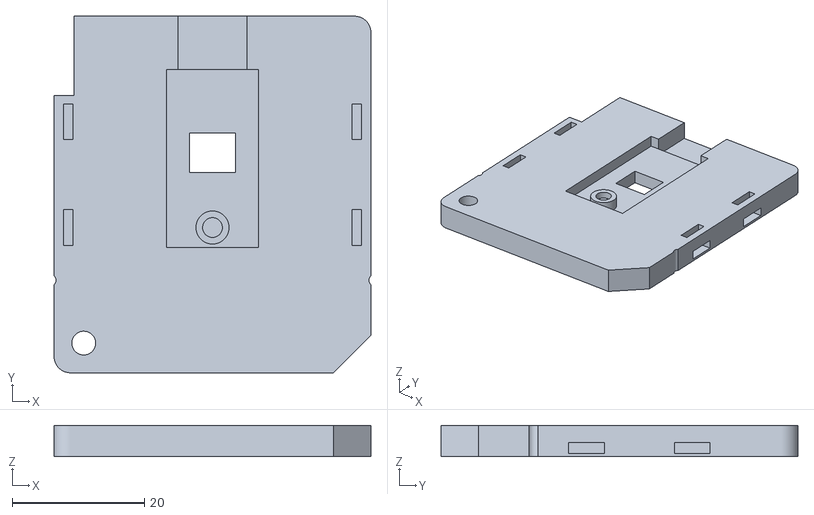
[picture p346: CAD file, 2026-11-02]
hardware/builds/pico-sign-handheld/case/out/cartridge_cover.stl
48.0 x 54.0 x 4.76
