jmcpheron/pico-quorum/hardware/builds/pico-sign/case/out/concepts/cartridge_bottom.stl

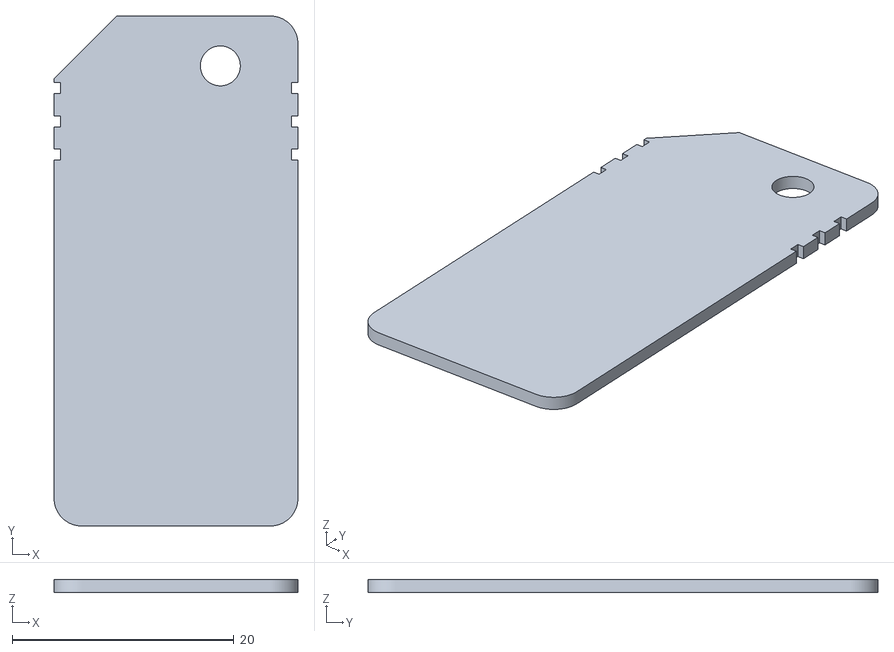
[picture p347: CAD file, 2026-11-02]
hardware/builds/pico-sign/case/out/concepts/cartridge_bottom.stl
22.0 x 46.0 x 1.20
