jmcpheron/pico-quorum/hardware/builds/pico-sign/case/out/prism/prism_plug_lock.stl

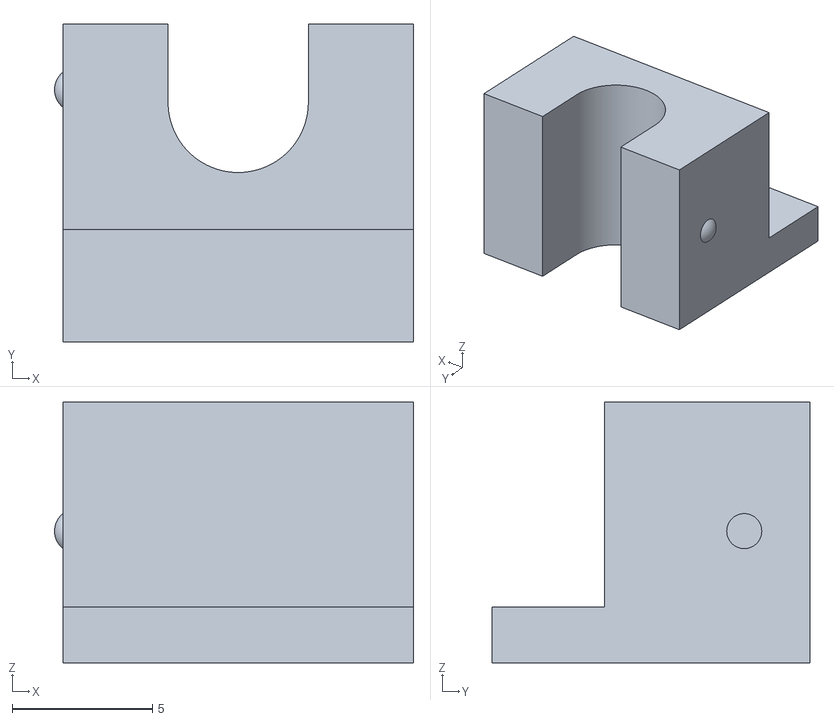
[picture p348: CAD file, 2026-11-02]
hardware/builds/pico-sign/case/out/prism/prism_plug_lock.stl
12.8 x 11.4 x 9.30
