jmcpheron/pico-quorum/hardware/key-pcb/key-c-usbc/3d/key-c-P2-board-only.step

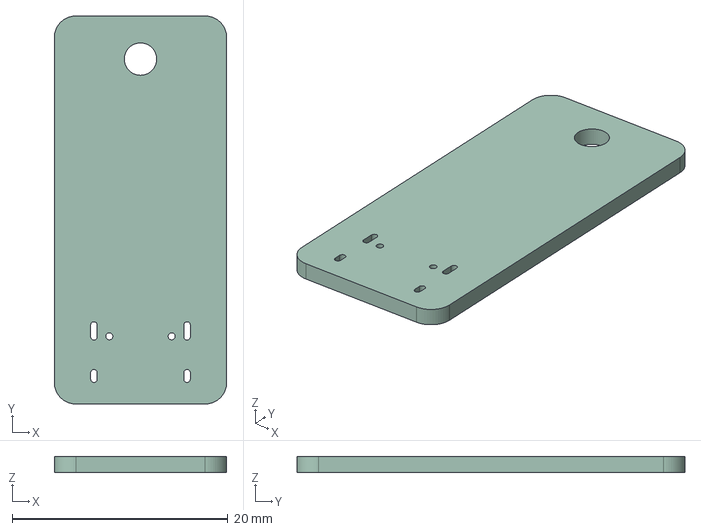
[picture p349: CAD file, 2026-10-05]
hardware/key-pcb/key-c-usbc/3d/key-c-P2-board-only.step
16.0 x 36.0 x 1.51 mm
