jmcpheron/pico-quorum/cad/consoles/out/badge/badge_cap_D2.stl

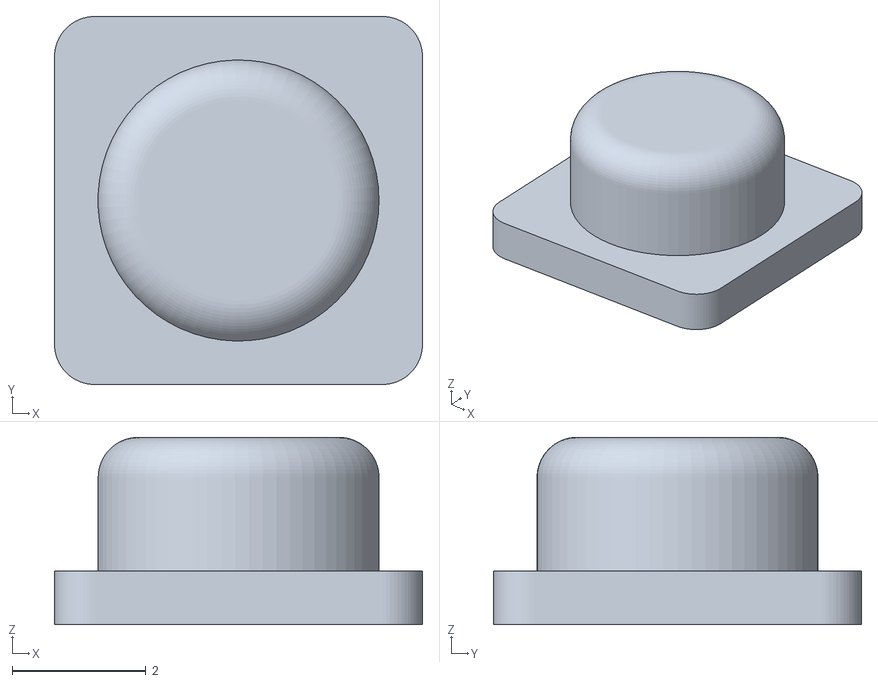
[picture p350: CAD file, 2026-11-03]
cad/consoles/out/badge/badge_cap_D2.stl
5.50 x 5.50 x 2.80
