jmcpheron/pico-quorum/cad/consoles/out/mono/mono_cap_D1.stl

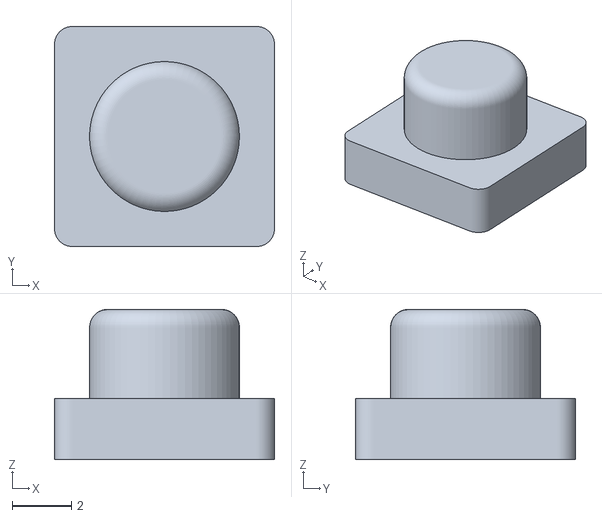
[picture p351: CAD file, 2026-11-09]
cad/consoles/out/mono/mono_cap_D1.stl
7.40 x 7.40 x 5.05
