jmcpheron/pico-quorum/cad/consoles/out/mono_ind/mono_ind_shell_orange.stl

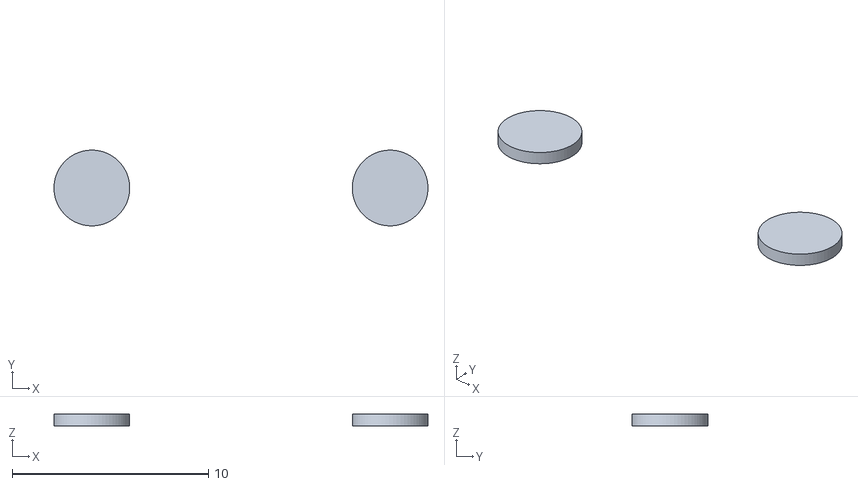
[picture p352: CAD file, 2026-11-12]
cad/consoles/out/mono_ind/mono_ind_shell_orange.stl
19.1 x 3.87 x 0.6
