jmcpheron/pico-quorum/cad/consoles/out/rp/rp_badge_signed_2.stl

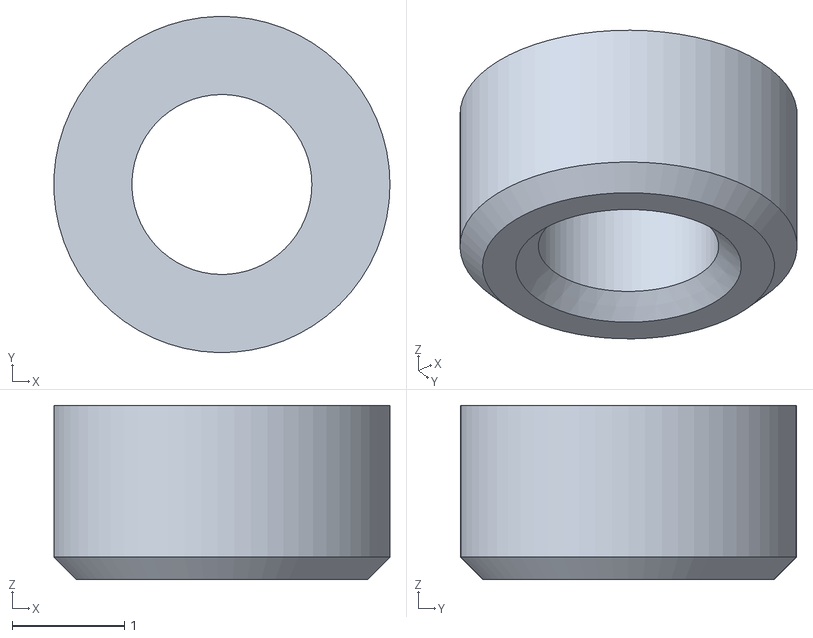
[picture p353: CAD file, 2026-11-05]
cad/consoles/out/rp/rp_badge_signed_2.stl
2.99 x 2.99 x 1.55
