jmcpheron/pico-quorum/cad/consoles/out/stick/stick_cap_D1.stl

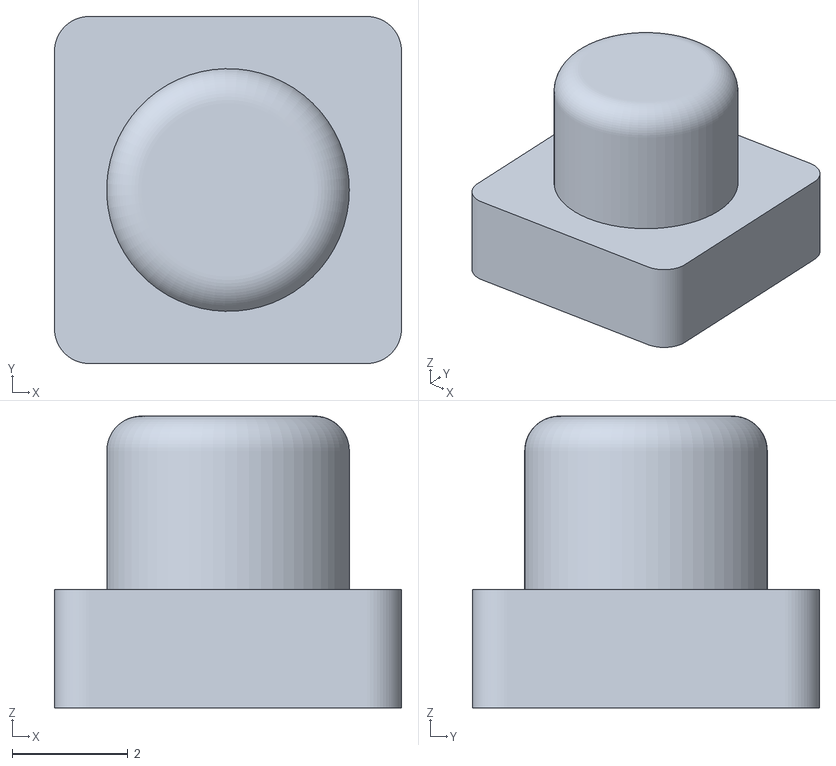
[picture p354: CAD file, 2026-11-03]
cad/consoles/out/stick/stick_cap_D1.stl
6.01 x 6.01 x 5.05
