jmcpheron/pico-quorum/cad/mono/out/mono_board.stl

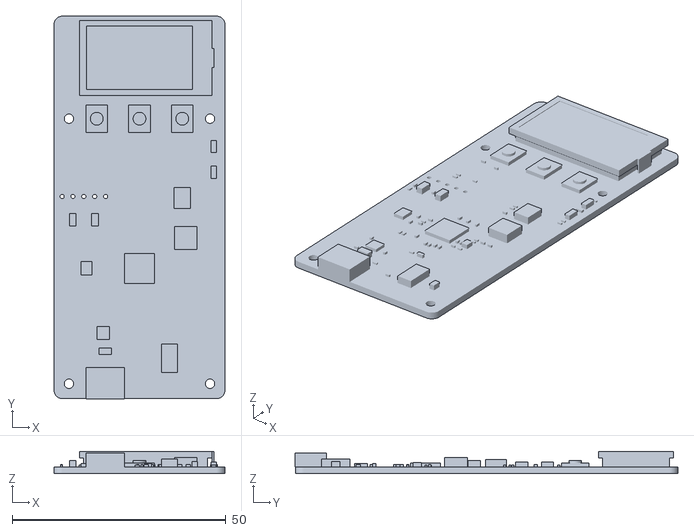
[picture p355: CAD file, 2026-11-09]
cad/mono/out/mono_board.stl
40.0 x 89.6 x 5.20
