jmcpheron/pico-quorum/hardware/builds/feather-pigtail/case/out/pigtail_bezel_v2.step

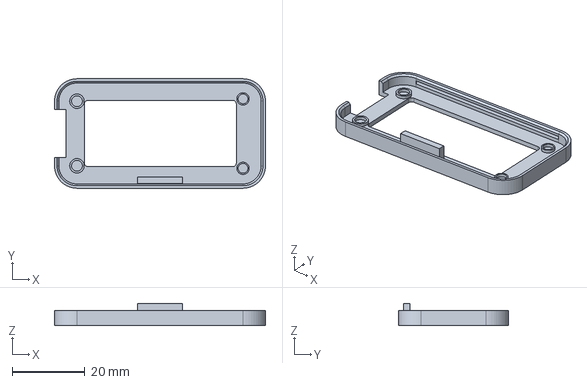
[picture p356: CAD file, 2026-10-24]
hardware/builds/feather-pigtail/case/out/pigtail_bezel_v2.step
58.1 x 30.2 x 6.12 mm
