jmcpheron/pico-quorum/hardware/builds/pico-sign-handheld/case/out/handheld_body.stl

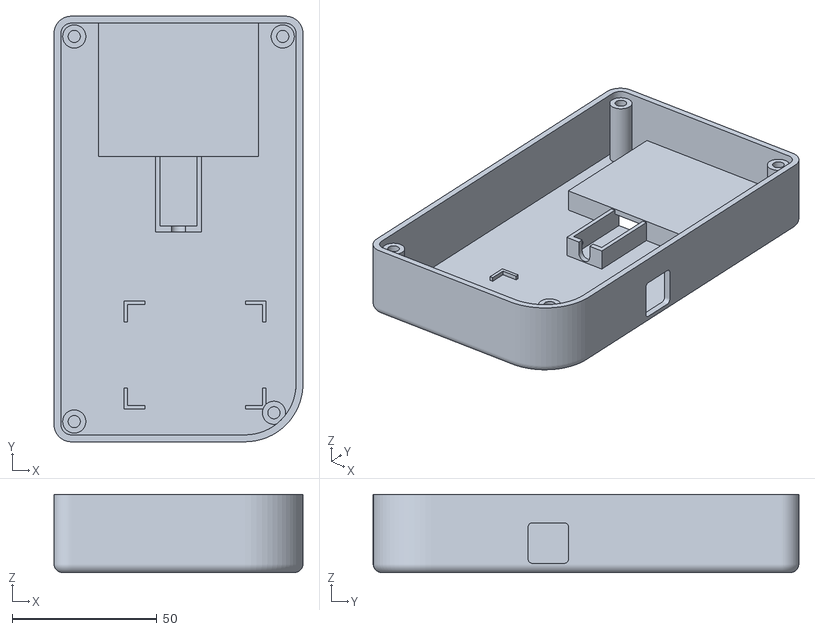
[picture p357: CAD file, 2026-11-02]
hardware/builds/pico-sign-handheld/case/out/handheld_body.stl
86.0 x 147.0 x 27.0
