jmcpheron/pico-quorum/hardware/builds/pico-sign/case/out/prism/prism_carrier.stl

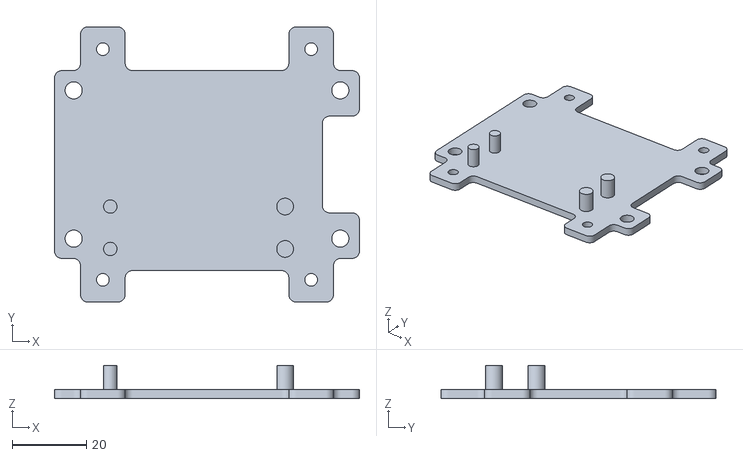
[picture p358: CAD file, 2026-11-02]
hardware/builds/pico-sign/case/out/prism/prism_carrier.stl
82.0 x 74.0 x 9.00
