jmcpheron/pico-quorum/cad/consoles/out/mono/mono_badge_triangle.stl

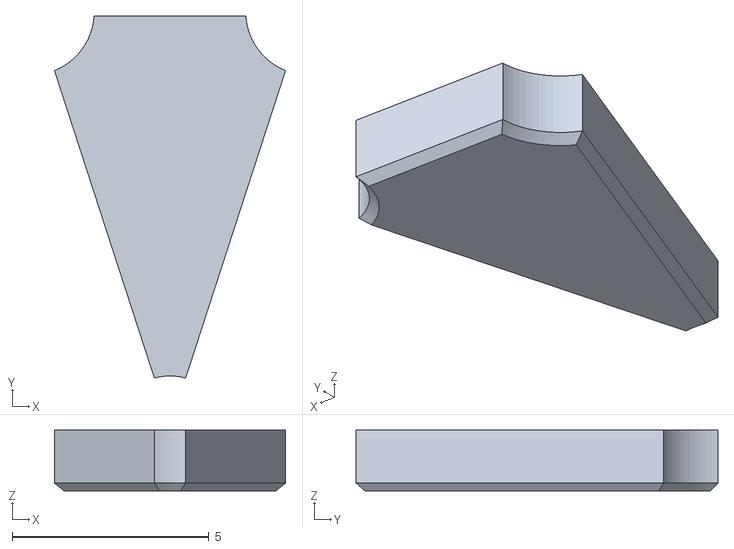
[picture p359: CAD file, 2026-11-09]
cad/consoles/out/mono/mono_badge_triangle.stl
5.88 x 9.20 x 1.55
