jmcpheron/pico-quorum/cad/consoles/out/rp/rp_cap_D2.stl

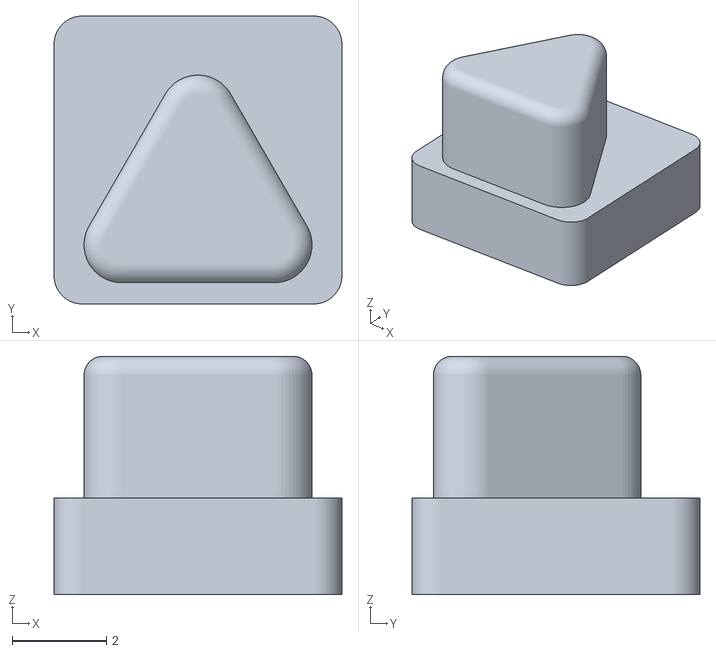
[picture p360: CAD file, 2026-11-05]
cad/consoles/out/rp/rp_cap_D2.stl
6.10 x 6.10 x 5.05
