jmcpheron/pico-quorum/hardware/builds/pico-sign-handheld/case/out/handheld_spacers.stl

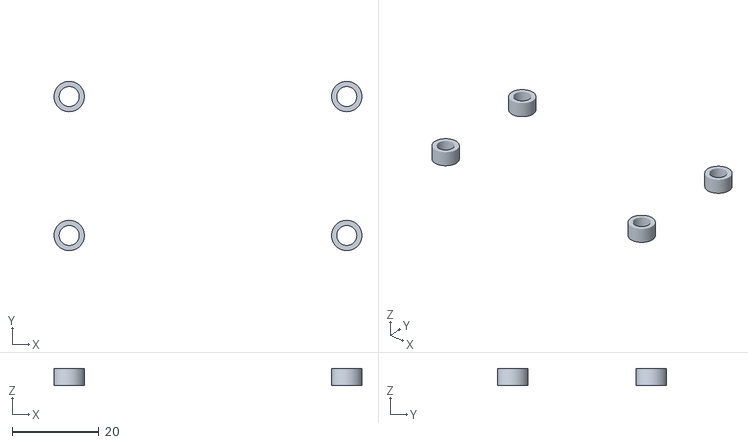
[picture p361: CAD file, 2026-11-02]
hardware/builds/pico-sign-handheld/case/out/handheld_spacers.stl
70.8 x 38.9 x 4.00
