jmcpheron/pico-quorum/hardware/builds/pico-sign/case/out/prism/prism_body.stl

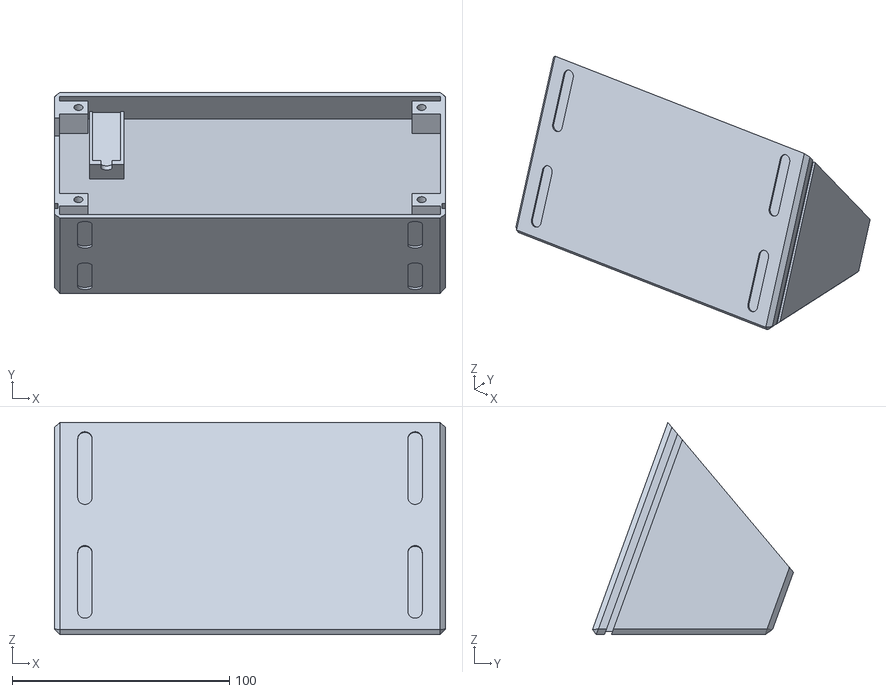
[picture p362: CAD file, 2026-11-02]
hardware/builds/pico-sign/case/out/prism/prism_body.stl
180.0 x 92.5 x 97.6
