jmcpheron/pico-quorum/cad/consoles/out/badge/badge_dock.stl

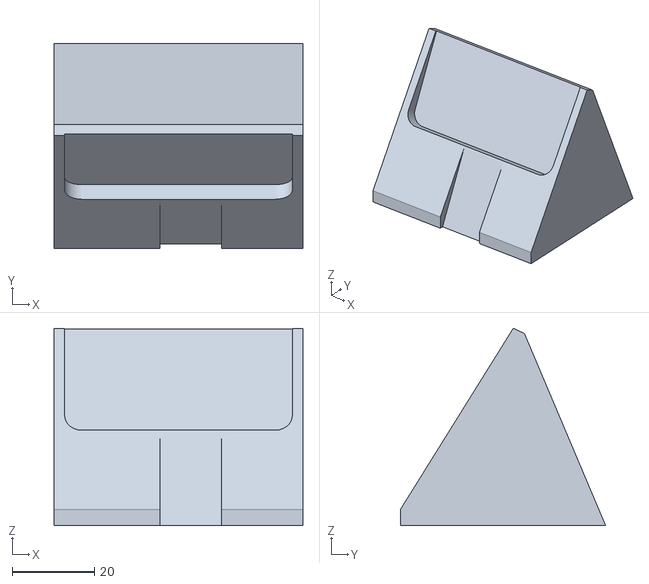
[picture p363: CAD file, 2026-11-03]
cad/consoles/out/badge/badge_dock.stl
60.6 x 50.0 x 48.1
