jmcpheron/pico-quorum/cad/consoles/out/mono/mono_cap_D0.stl

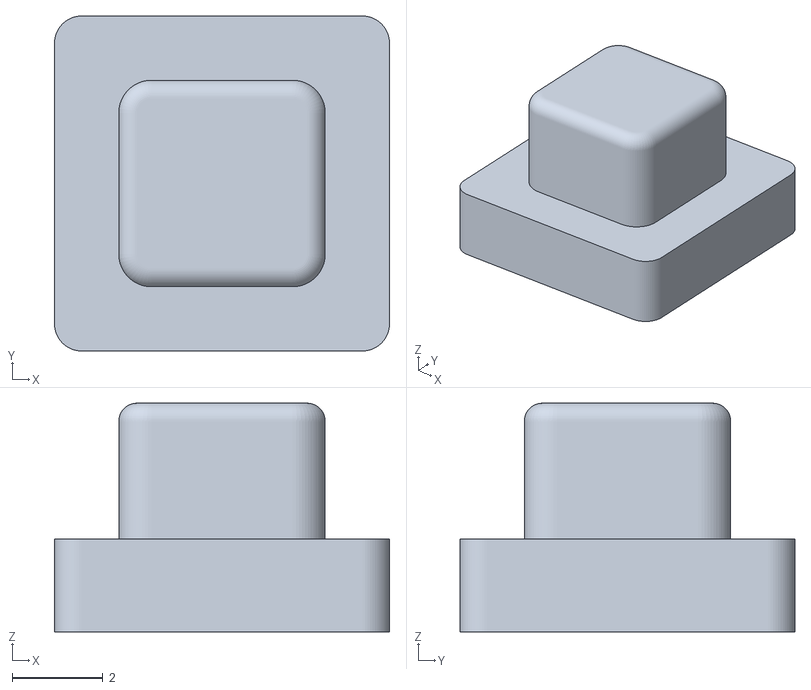
[picture p364: CAD file, 2026-11-09]
cad/consoles/out/mono/mono_cap_D0.stl
7.40 x 7.40 x 5.05
