jmcpheron/pico-quorum/cad/consoles/out/mono_ind/mono_ind_back.stl

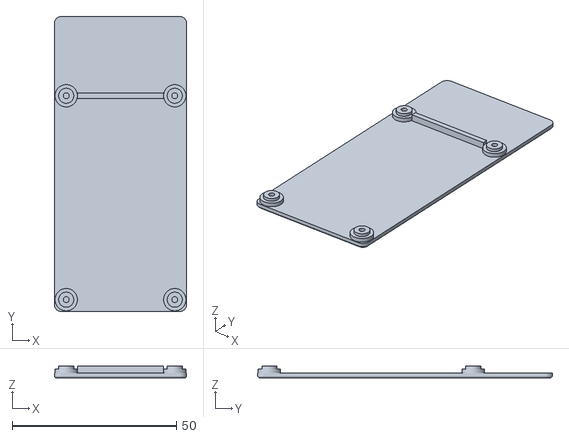
[picture p365: CAD file, 2026-11-09]
cad/consoles/out/mono_ind/mono_ind_back.stl
40.2 x 89.7 x 3.70
