jmcpheron/pico-quorum/cad/key/out/key_lid_v2.stl

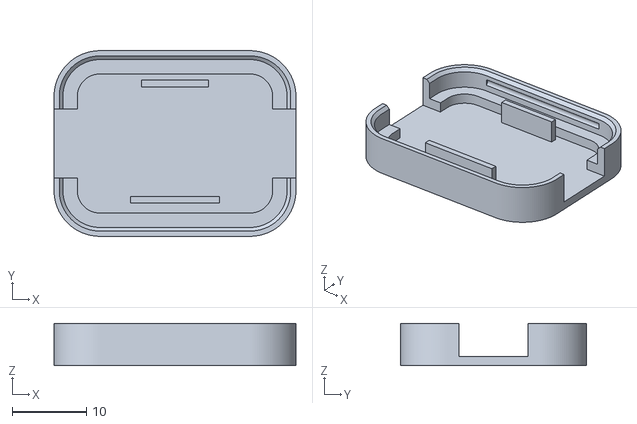
[picture p366: CAD file, 2026-10-07]
cad/key/out/key_lid_v2.stl
32.7 x 25.1 x 5.70
