jmcpheron/pico-quorum/hardware/builds/pico-sign-handheld/case/out/handheld_bay_test.stl

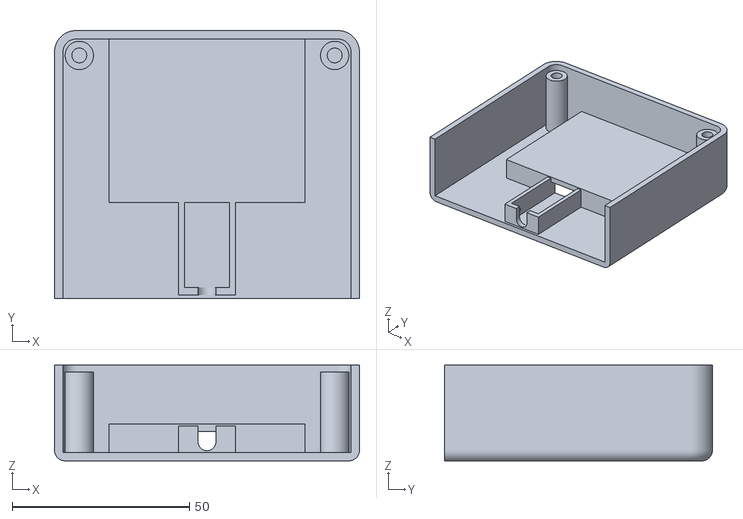
[picture p367: CAD file, 2026-11-02]
hardware/builds/pico-sign-handheld/case/out/handheld_bay_test.stl
86.0 x 75.5 x 27.0
