jmcpheron/pico-quorum/hardware/builds/pico-sign/case/out/prism/prism_spacers.stl

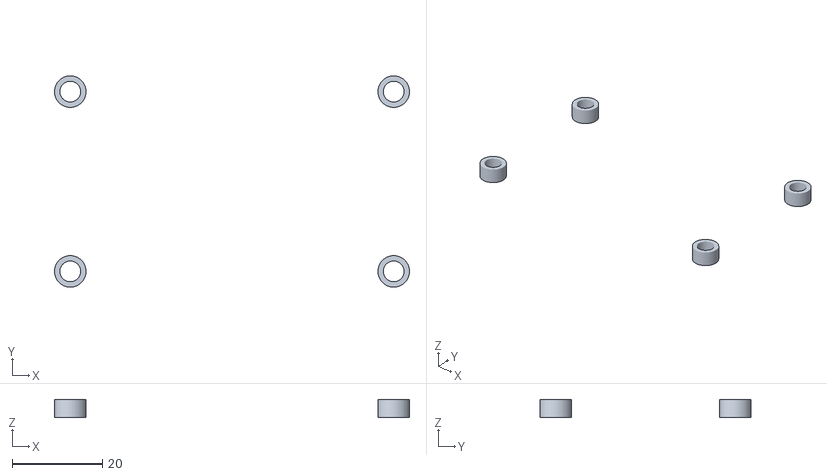
[picture p368: CAD file, 2026-11-02]
hardware/builds/pico-sign/case/out/prism/prism_spacers.stl
78.7 x 46.8 x 4.00
