jmcpheron/pico-quorum/cad/consoles/out/rp/rp_badge_waiting_1.stl

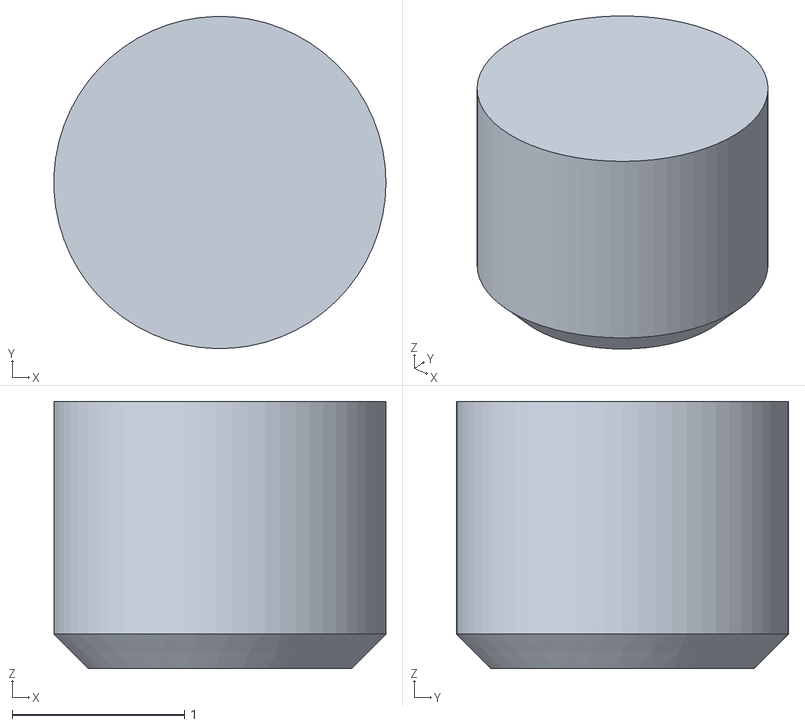
[picture p369: CAD file, 2026-11-05]
cad/consoles/out/rp/rp_badge_waiting_1.stl
1.93 x 1.93 x 1.55
