jmcpheron/pico-quorum/cad/consoles/out/stick/stick_dock.stl

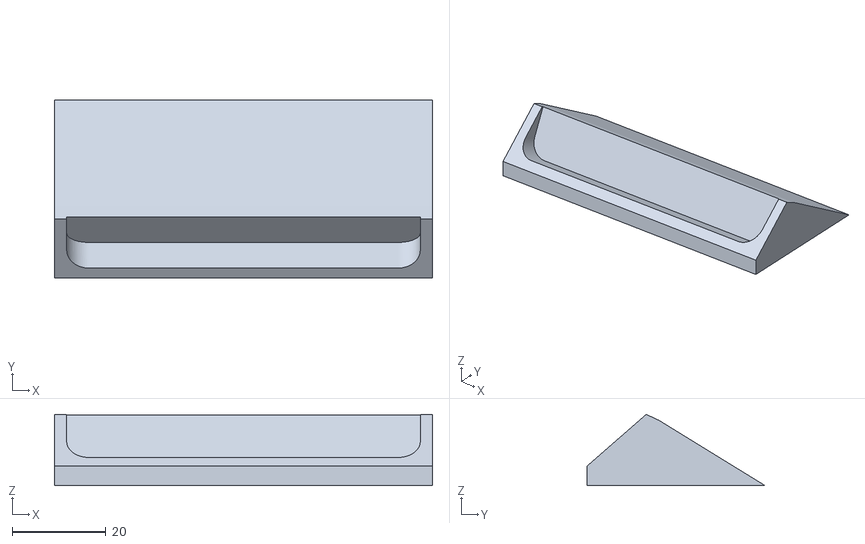
[picture p370: CAD file, 2026-11-03]
cad/consoles/out/stick/stick_dock.stl
80.6 x 38.0 x 15.2
