jmcpheron/pico-quorum/hardware/builds/pico-sign-handheld/case/out/handheld_carrier.stl

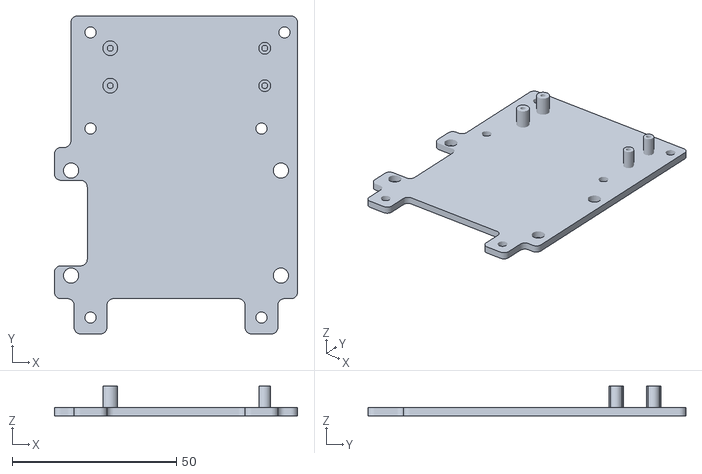
[picture p371: CAD file, 2026-11-02]
hardware/builds/pico-sign-handheld/case/out/handheld_carrier.stl
74.0 x 96.8 x 9.00
