jmcpheron/pico-quorum/cad/consoles/out/rp/rp_dock.stl

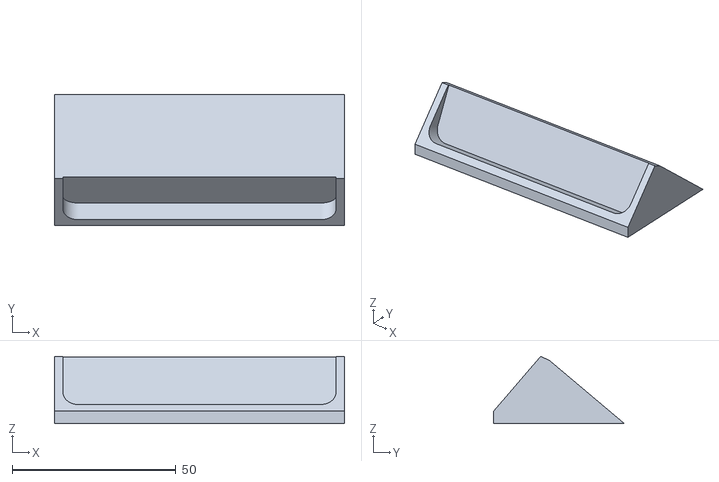
[picture p372: CAD file, 2026-11-05]
cad/consoles/out/rp/rp_dock.stl
88.6 x 40.0 x 20.5
