jmcpheron/pico-quorum/hardware/builds/pico-sign-handheld/case/out/handheld_plug_lock.stl

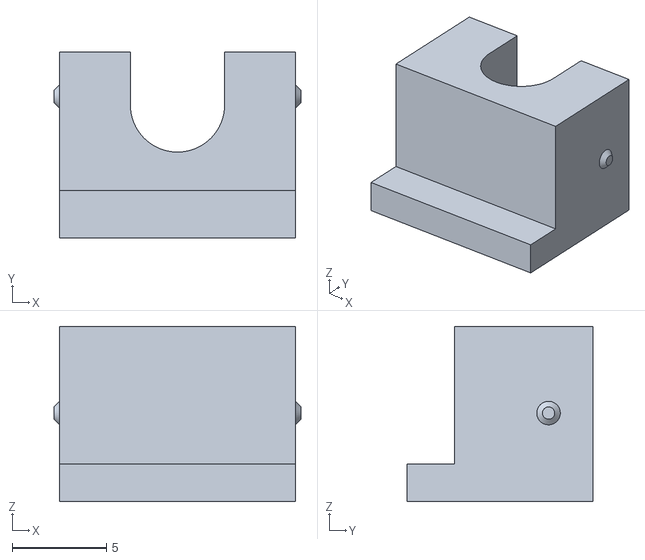
[picture p373: CAD file, 2026-11-02]
hardware/builds/pico-sign-handheld/case/out/handheld_plug_lock.stl
13.1 x 9.85 x 9.30
