jmcpheron/pico-quorum/cad/consoles/out/mono_ind/mono_ind_dock.stl

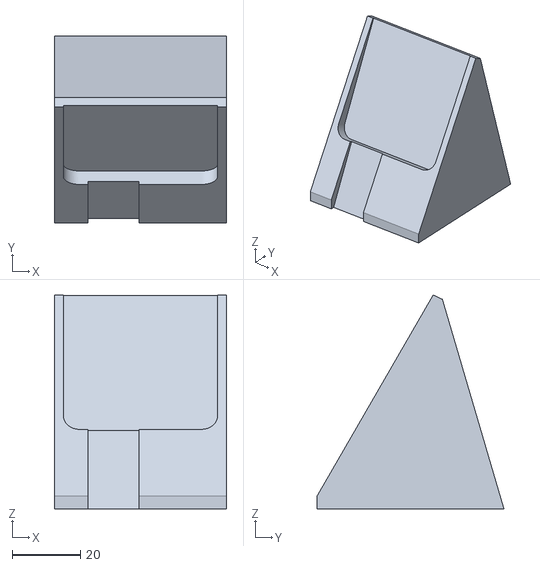
[picture p374: CAD file, 2026-11-09]
cad/consoles/out/mono_ind/mono_ind_dock.stl
50.6 x 55.0 x 62.9
