jmcpheron/pico-quorum/hardware/builds/pico-sign-handheld/case/out/cartridge_tray.stl

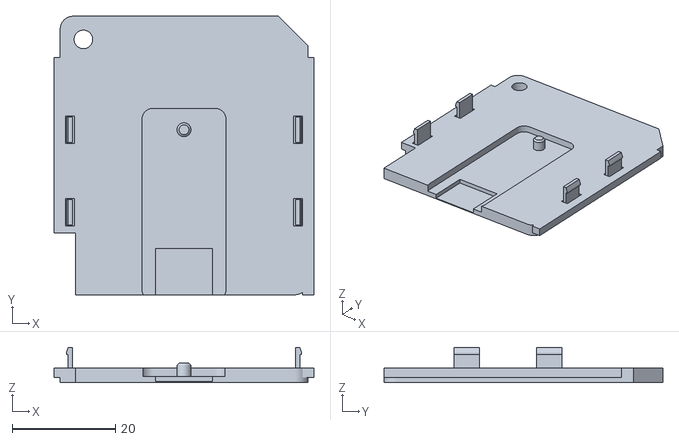
[picture p375: CAD file, 2026-11-02]
hardware/builds/pico-sign-handheld/case/out/cartridge_tray.stl
50.4 x 54.0 x 6.80
