jmcpheron/pico-quorum/hardware/builds/pico-sign-handheld/case/out/handheld_guard_cover.stl

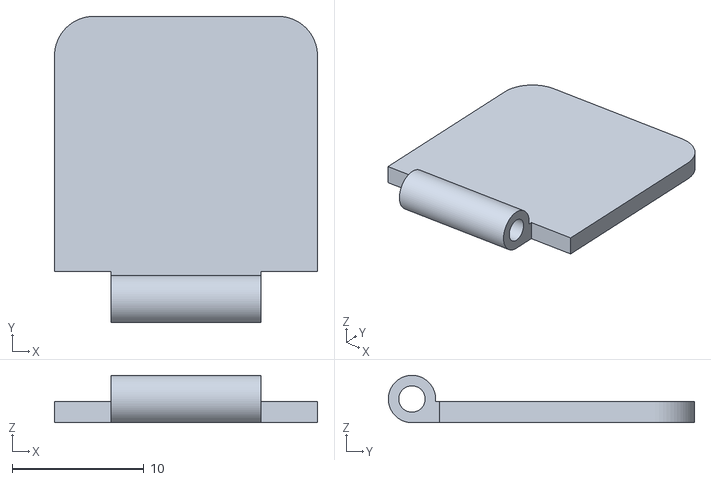
[picture p376: CAD file, 2026-11-02]
hardware/builds/pico-sign-handheld/case/out/handheld_guard_cover.stl
20.0 x 23.3 x 3.60
