jmcpheron/pico-quorum/cad/consoles/out/rp/rp_badge_signed_0.stl

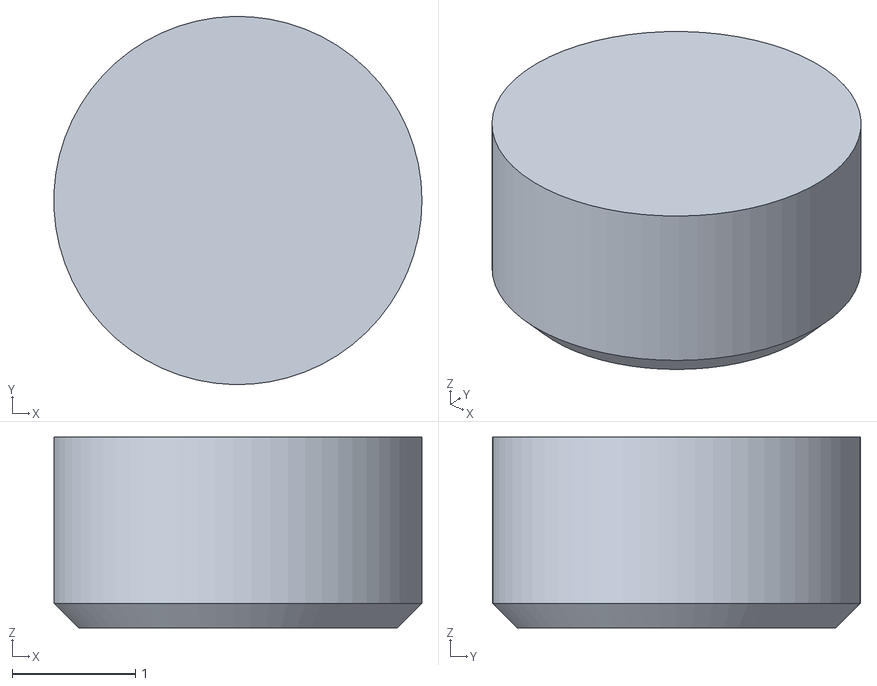
[picture p377: CAD file, 2026-11-05]
cad/consoles/out/rp/rp_badge_signed_0.stl
2.99 x 2.99 x 1.55
