jmcpheron/pico-quorum/hardware/builds/pico-sign-handheld/case/out/handheld_sign_cap.stl

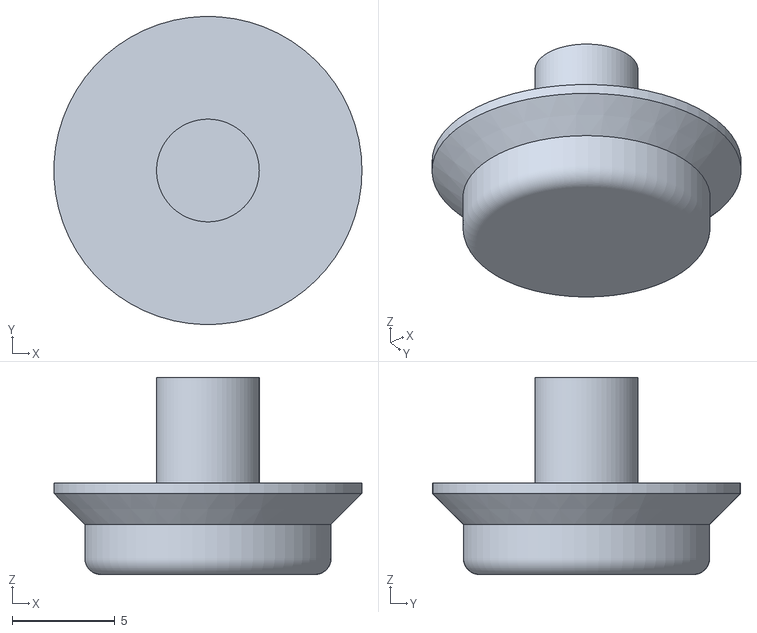
[picture p378: CAD file, 2026-11-02]
hardware/builds/pico-sign-handheld/case/out/handheld_sign_cap.stl
15.0 x 15.0 x 9.60
