jmcpheron/pico-quorum/cad/consoles/out/rp/rp_badge_triangle.stl

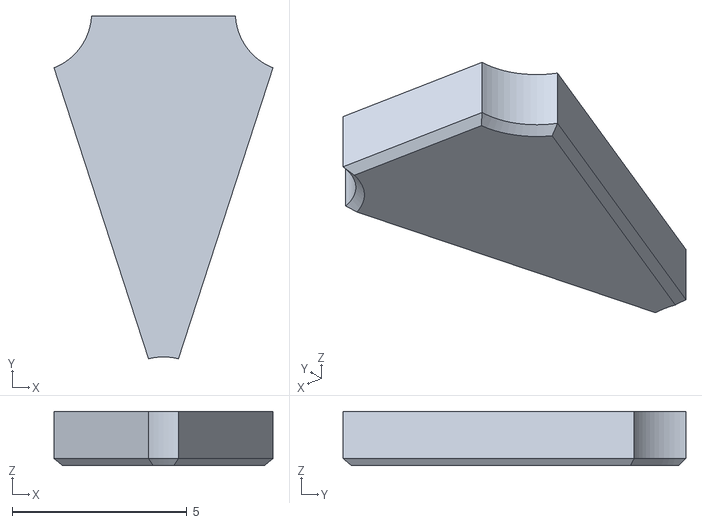
[picture p379: CAD file, 2026-11-05]
cad/consoles/out/rp/rp_badge_triangle.stl
6.26 x 9.80 x 1.55
