jmcpheron/pico-quorum/hardware/builds/pico-sign-handheld/case/out/handheld_guard_base.stl

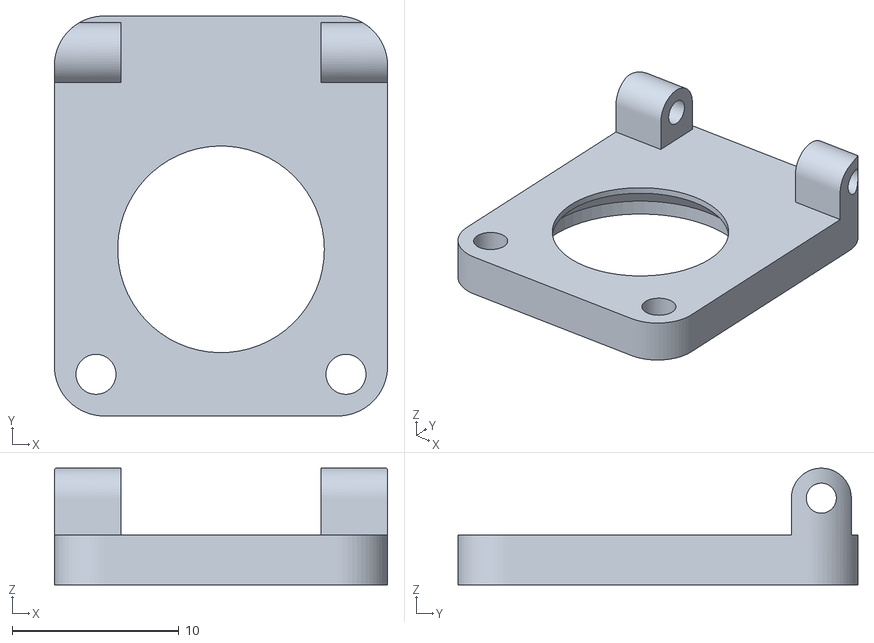
[picture p380: CAD file, 2026-11-02]
hardware/builds/pico-sign-handheld/case/out/handheld_guard_base.stl
20.0 x 24.0 x 7.00
