jmcpheron/pico-quorum/(list of files, cad)

Other CAD files:
cad/consoles/out/mono_ind/mono_ind_assembly.step
cad/consoles/out/mono_ind/mono_ind_shell.stl
cad/consoles/out/badge/badge_cap_D0.stl
cad/consoles/out/stick/stick_cap_D0.stl
cad/consoles/out/rp/rp_cap_D0.stl
cad/consoles/out/stick/stick_cap_D2.stl
cad/consoles/out/badge/badge_cap_D1.stl
cad/consoles/out/mono/mono_badge_waiting_1.stl
cad/consoles/out/mono/mono_cap_D2.stl
cad/consoles/out/rp/rp_badge_signed_3.stl
cad/consoles/out/mono/mono_badge_signed_2.stl
cad/consoles/out/mono_ind/mono_ind_cap_D2.stl
cad/consoles/out/rp/rp_badge_waiting_4.stl
cad/consoles/out/mono/mono_badge_signed_0.stl
cad/consoles/out/mono/mono_shell.stl
cad/consoles/out/rp/rp_cap_D1.stl
cad/key/out/key_tray_v1.stl
cad/key/out/key_tray_v2.stl
hardware/archive/builds/feather-pigtail/case/out/pigtail_bezel_v1.stl
hardware/archive/builds/feather-pigtail/case/out/pigtail_bezel_v2.stl
hardware/archive/builds/feather-pigtail/case/out/pigtail_case_v1.stl
hardware/archive/builds/feather-pigtail/case/out/pigtail_tray_v1.stl
hardware/archive/builds/feather-pigtail/case/out/pigtail_tray_v2.stl
hardware/builds/feather-pigtail/case/out/pigtail_bezel_v1.stl
hardware/builds/feather-pigtail/case/out/pigtail_bezel_v2.stl
hardware/builds/feather-pigtail/case/out/pigtail_case_v1.stl
hardware/builds/feather-pigtail/case/out/pigtail_tray_v1.stl
hardware/builds/feather-pigtail/case/out/pigtail_tray_v2.stl
