jmcpheron/pico-quorum/docs/quorum-ui/feather-setup/README.md

# The ceremony on the Feather ESP32-S3 Reverse TFT

Written by `node tools/board/shots_feather_setup.mjs`: `setup_s.py` on the emulator, C1-C10 on a
virtual 608C, 240 × 135, three buttons down the left edge (the grey dots: D0, D1, D2).

- **D0**: back; on a result, OK.
- **D0 + D1 held 3 s**: the arm, for 60 s (the Pico's B+Y). D2 is never part of it.
- **D2**: do a step; on a permanent or GenKey step, held 3 s once armed. On a result, OK.

ALLOW_LOCK and ALLOW_GENKEY in the board's `secrets.py` still gate every permanent step.

### banner

The banner: a fresh chip on the dual image. Not a signing console. D2 opens PROVISION.

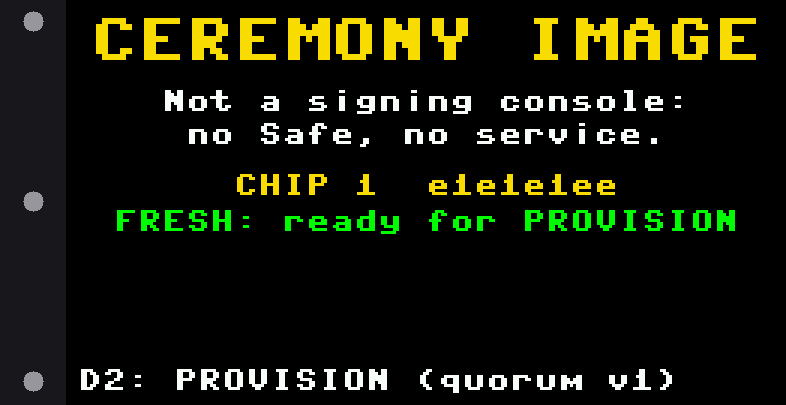
[picture p388: docs/quorum-ui/feather-setup/01-banner.png]
01-banner


### c1

C1, the pre-flight: reads only. D0 back, D2 does it.

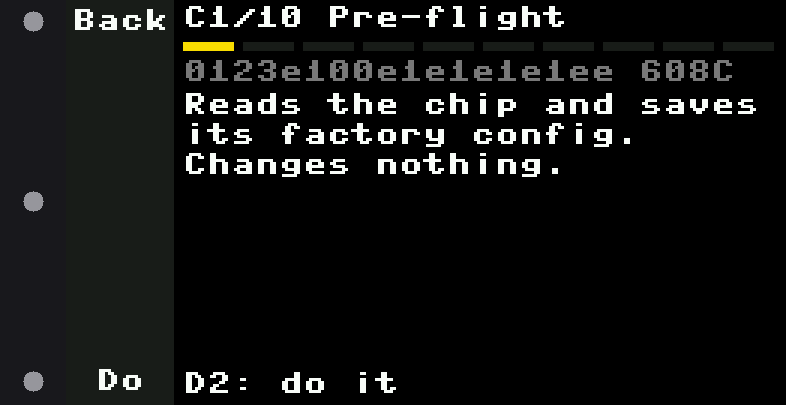
[picture p389: docs/quorum-ui/feather-setup/02-c1.png]
02-c1


### c1 result

C1's checks: the 608C, both zones open, the factory table, saved as a snapshot. D2: OK.

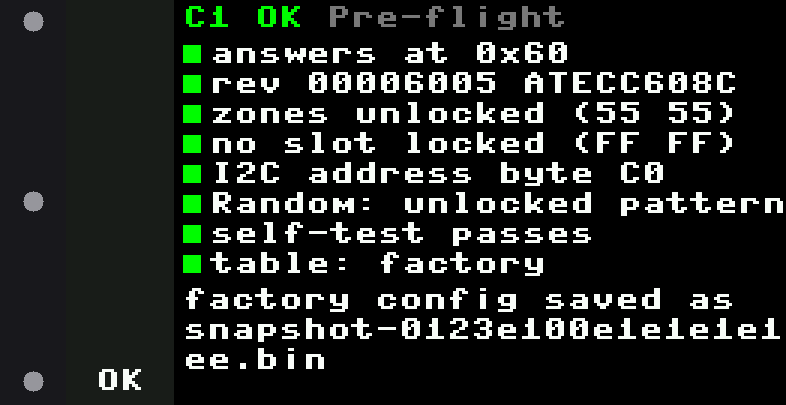
[picture p390: docs/quorum-ui/feather-setup/03-c1-result.png]
03-c1-result


### c2 result

C2 wrote quorum v1 and read it back. Compare the CRC with tools/check_config --summary on the laptop.

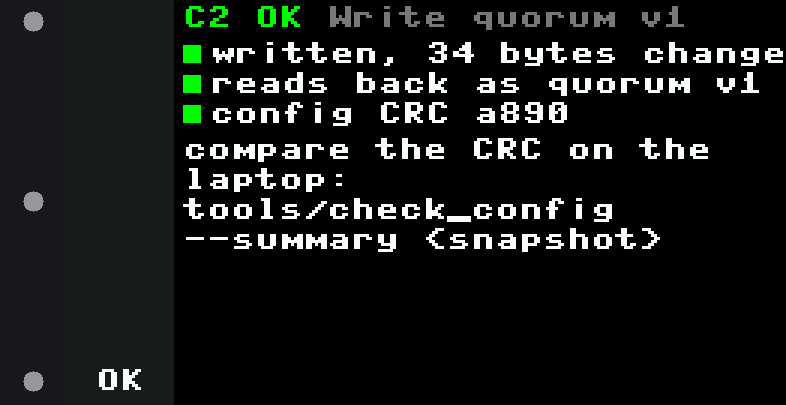
[picture p391: docs/quorum-ui/feather-setup/04-c2-result.png]
04-c2-result


### c3

C3, permanent: red. Not armed: D0+D1 held 3 s arms it (D2 does nothing until then).

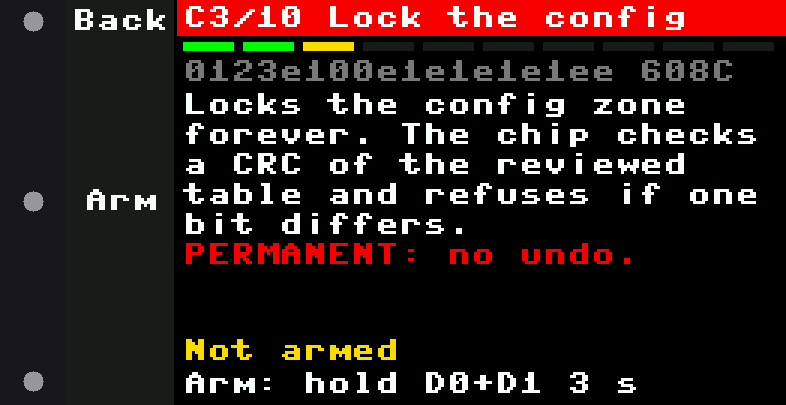
[picture p392: docs/quorum-ui/feather-setup/05-c3.png]
05-c3


### c3 arming

D0+D1 held: the rail fills; 3 s to arm. Let go early and it isn't armed.

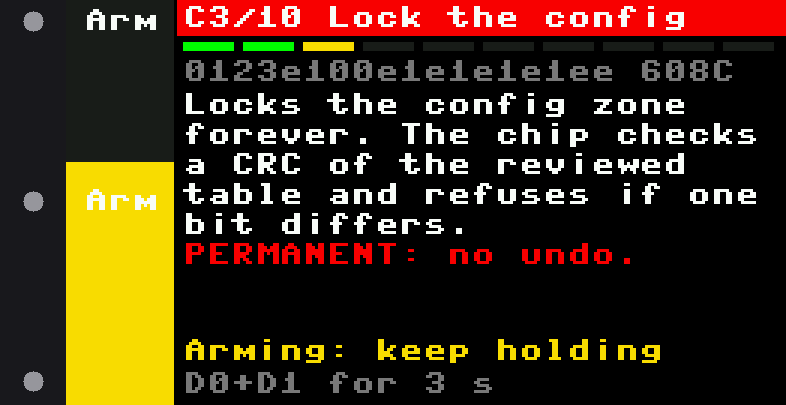
[picture p393: docs/quorum-ui/feather-setup/06-c3-arming.png]
06-c3-arming


### c3 armed letgo

The arm took: let go of both.

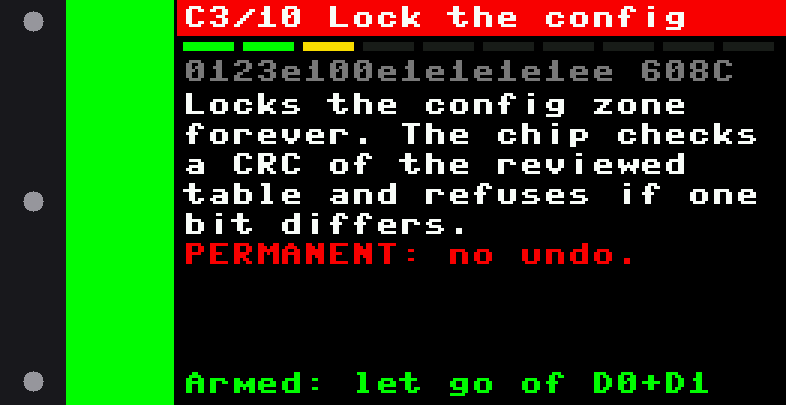
[picture p394: docs/quorum-ui/feather-setup/07-c3-armed-letgo.png]
07-c3-armed-letgo


### c3 armed

Armed for 60 s: hold D2 3 s to lock.

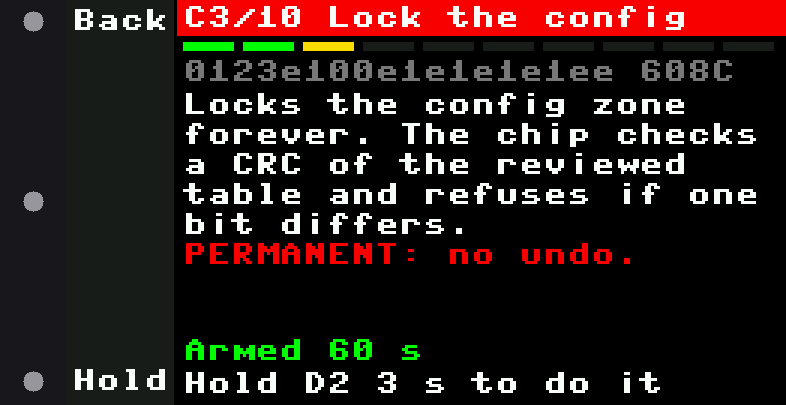
[picture p395: docs/quorum-ui/feather-setup/08-c3-armed.png]
08-c3-armed


### c3 hold

D2 held: the rail fills red. Let go before 3 s and nothing happens.

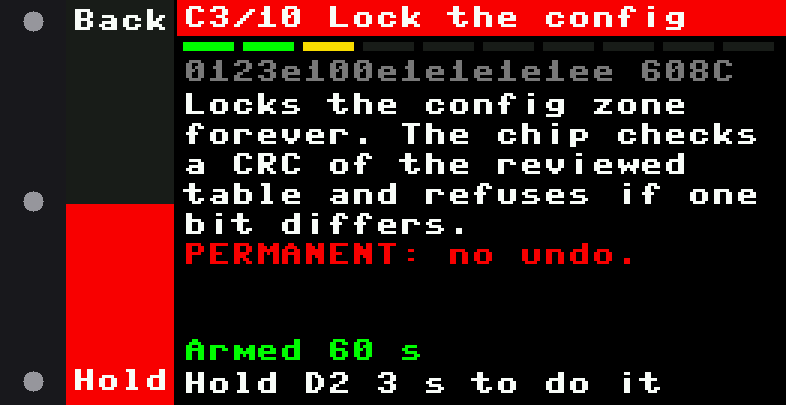
[picture p396: docs/quorum-ui/feather-setup/09-c3-hold.png]
09-c3-hold


### c3 result

C3 done: the config is locked, still quorum v1.

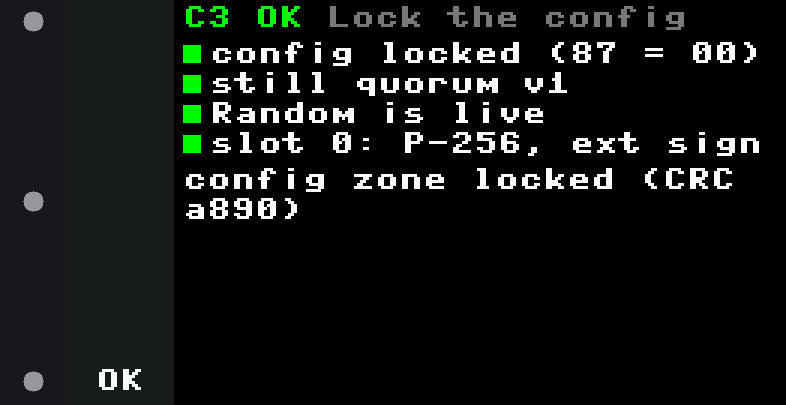
[picture p397: docs/quorum-ui/feather-setup/10-c3-result.png]
10-c3-result


### c4

C4: GenKey, armed and held like a permanent step.

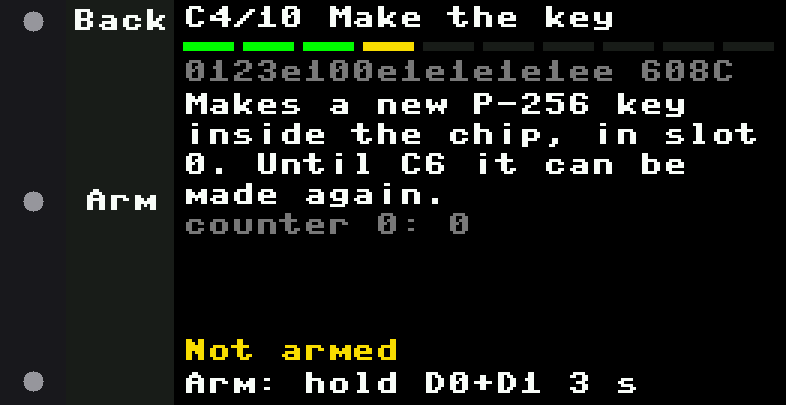
[picture p398: docs/quorum-ui/feather-setup/11-c4.png]
11-c4


### c4 result

The new key, made inside the chip.

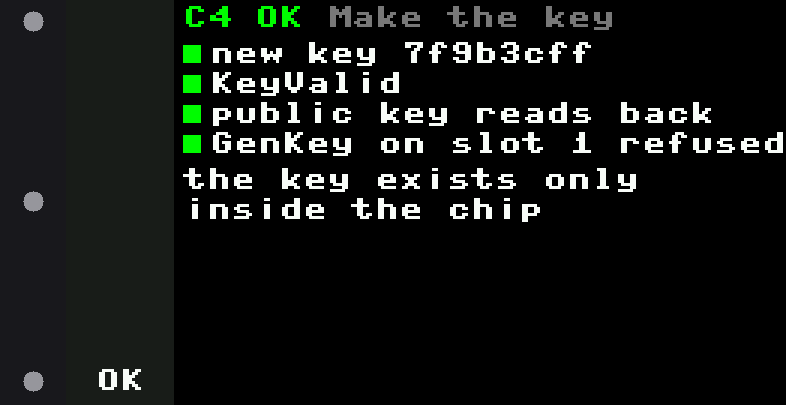
[picture p399: docs/quorum-ui/feather-setup/12-c4-result.png]
12-c4-result


### c5 result

C5: two test signatures checked here; counter 0 up by 2.

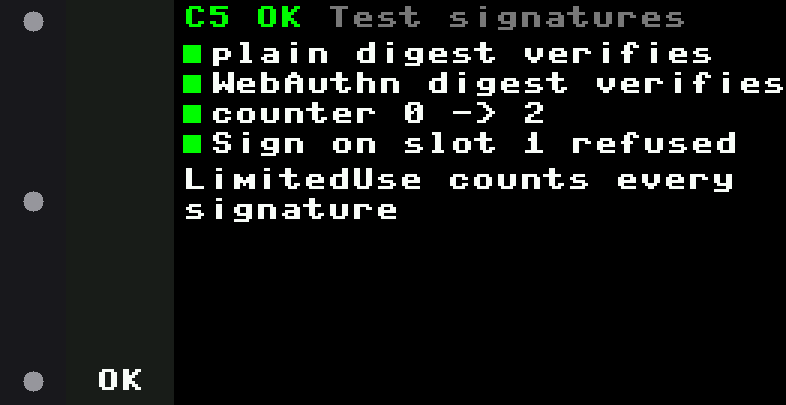
[picture p400: docs/quorum-ui/feather-setup/13-c5-result.png]
13-c5-result


### c6

C6, permanent: seal slot 0 so the key can never be replaced.

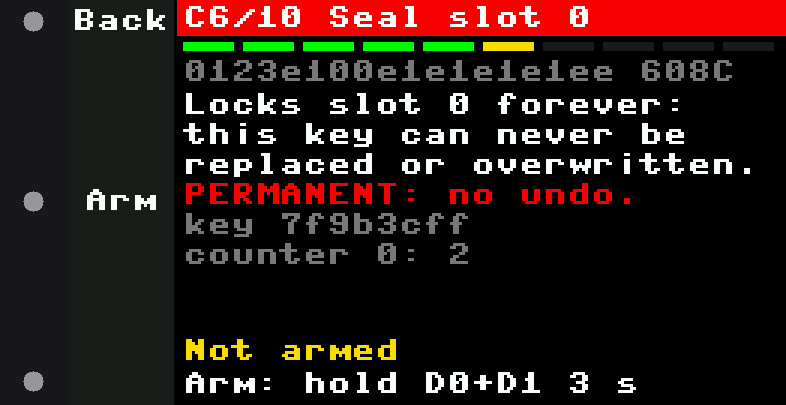
[picture p401: docs/quorum-ui/feather-setup/14-c6.png]
14-c6


### c6 arm again

Under 10 s of the arm left: no hold starts, arm again. Chip 3's first C6 ran out partway.

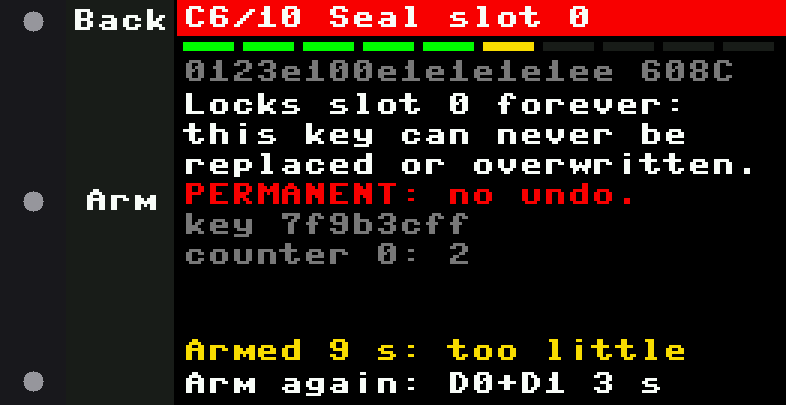
[picture p402: docs/quorum-ui/feather-setup/14-c6-arm-again.png]
14-c6-arm-again


### c6 result

Slot 0 sealed: FE FF, the same key, it signs and verifies.

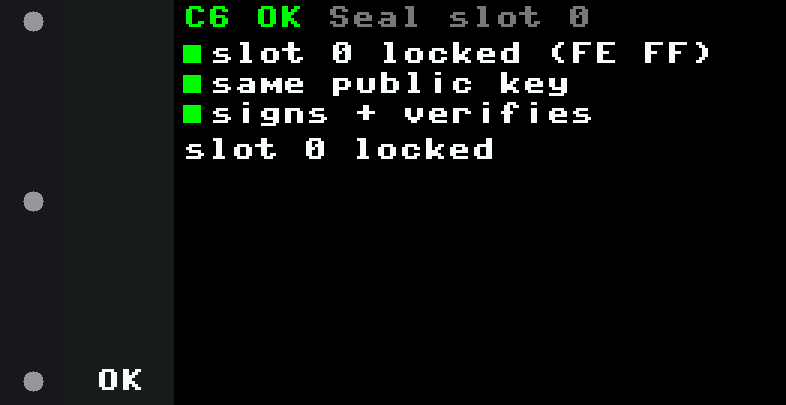
[picture p403: docs/quorum-ui/feather-setup/15-c6-result.png]
15-c6-result


### c7 result

C7: the owner address, to compare on the laptop with tools/fw verify --baseline.

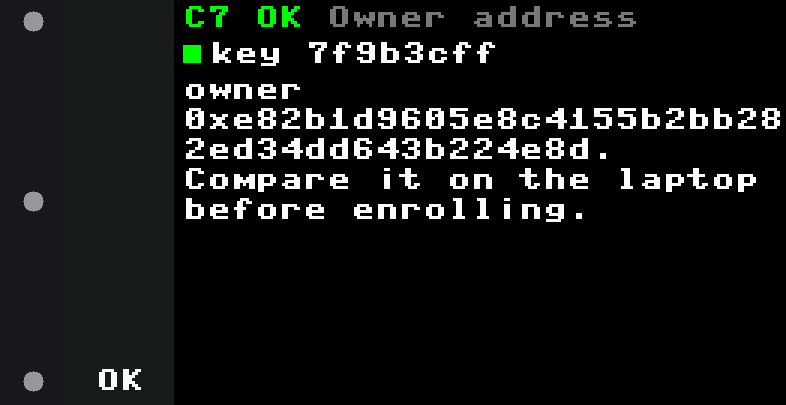
[picture p404: docs/quorum-ui/feather-setup/16-c7-result.png]
16-c7-result


### c8 result

C8: zeros into slots 1-15, the record into OTP; the data CRC.

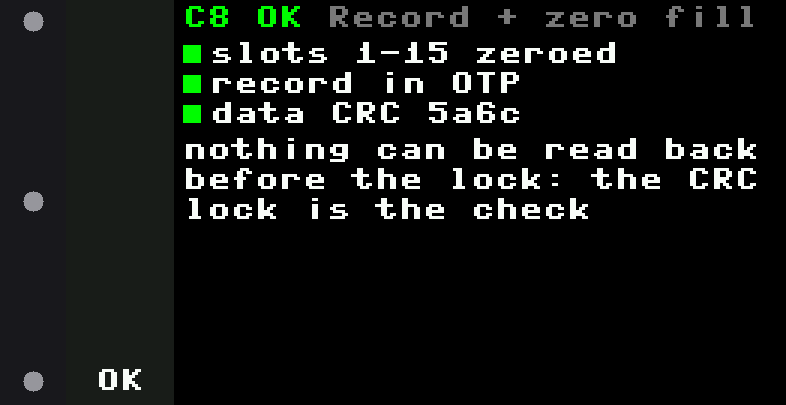
[picture p405: docs/quorum-ui/feather-setup/17-c8-result.png]
17-c8-result


### c9

C9, permanent: lock the data and OTP zones.

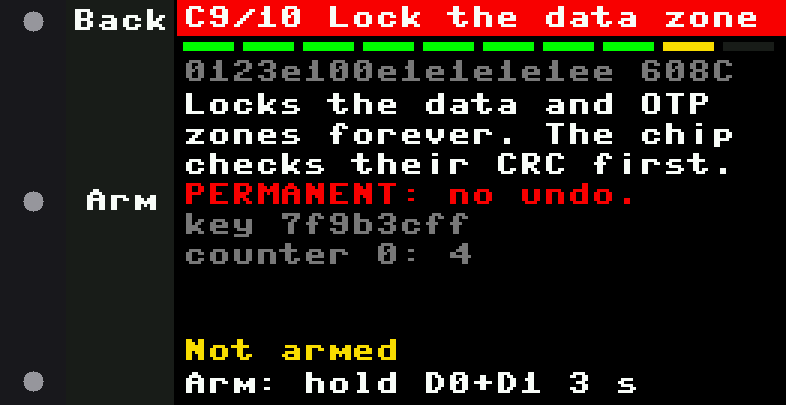
[picture p406: docs/quorum-ui/feather-setup/18-c9.png]
18-c9


### c9 result

C9 done.

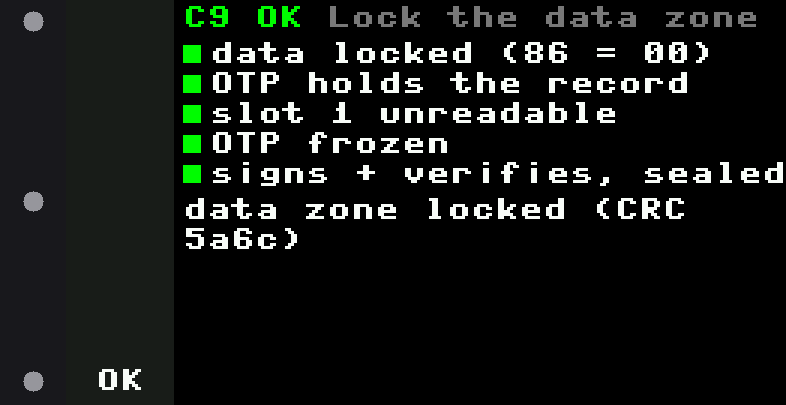
[picture p407: docs/quorum-ui/feather-setup/19-c9-result.png]
19-c9-result


### c10

C10: the summary.

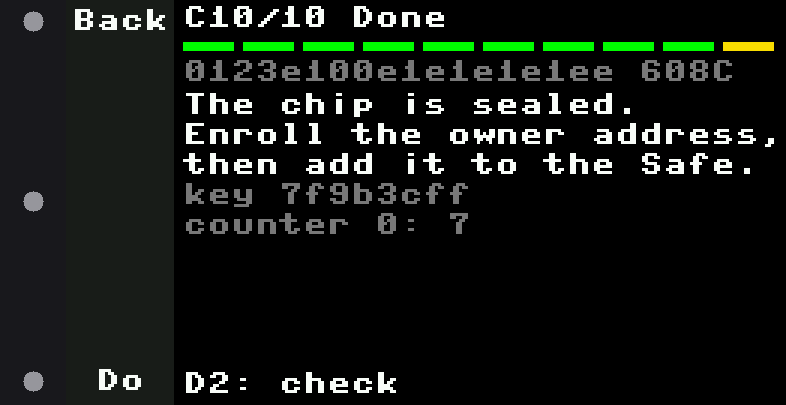
[picture p408: docs/quorum-ui/feather-setup/20-c10.png]
20-c10


### c10 result

Sealed: quorum v1 locked 00/00, slot 0 sealed, the record matches; set ALLOW_* back to False.

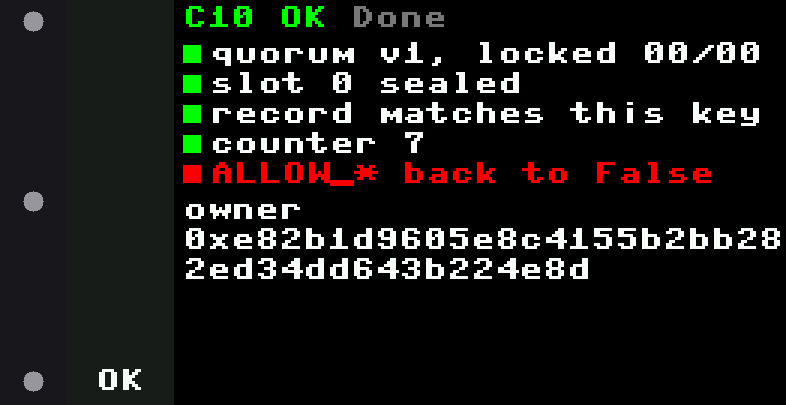
[picture p409: docs/quorum-ui/feather-setup/21-c10-result.png]
21-c10-result


### c3 allow off

With ALLOW_LOCK False on the board, a permanent step says so and nothing arms it.

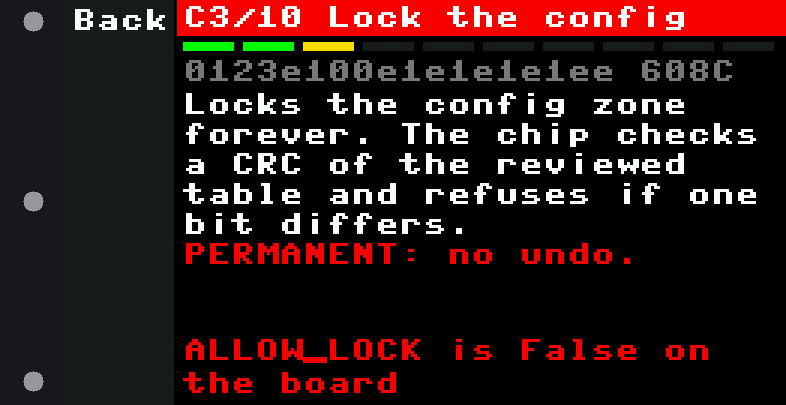
[picture p410: docs/quorum-ui/feather-setup/22-c3-allow-off.png]
22-c3-allow-off
