jmcpheron/pico-quorum/hardware/builds/pico-sign-handheld/ASSEMBLY.md

# Picoquorum Handheld: putting it together

The build's [README](README.md) says what it is, its parts and its wiring; this page puts it together.

Sixteen steps, from printed parts to a key in its bay. Each picture shows the step's new printed parts
in amber, what's already done in white, and what the step needs along the bottom. The pictures are
drawn from the case's own model ([`case/assembly.py`](case/assembly.py)), so they follow
[`case/handheld.py`](case/handheld.py)'s numbers. Nothing here has been put together yet: this is the
plan for the first build.

The wiring is in [pico-sign's README](../pico-sign/README.md#the-wiring), and what differs is in this
build's [README](README.md#the-wiring). This page only says where the wires go.

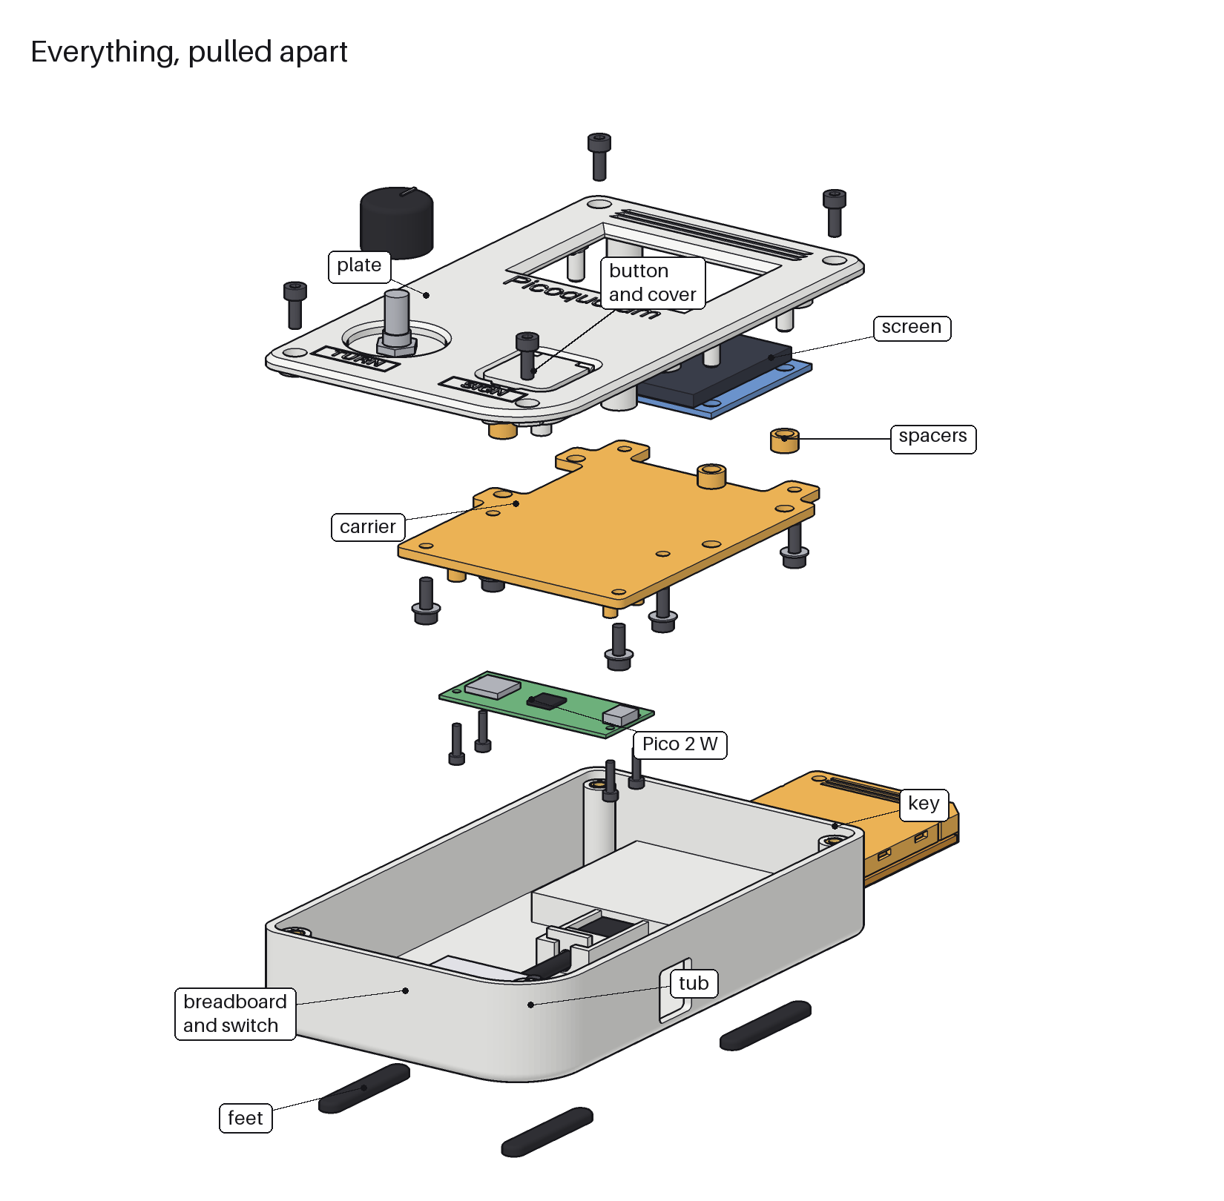
[picture p413: hardware/builds/pico-sign-handheld/case/out/assembly/00-exploded.png]
everything, pulled apart


## What you need

### Printed

All in `case/out/`, each the way up it prints.

| part | file | how many |
|---|---|---|
| the tub | `handheld_body.stl` | 1 |
| the plate | `handheld_plate.stl` | 1 |
| the carrier | `handheld_carrier.stl` | 1 |
| the spacers | `handheld_spacers.stl` (all four in one file) | 4 |
| the plug lock | `handheld_plug_lock.stl` | 1 |
| the guard's base and cover | `handheld_guard_base.stl`, `handheld_guard_cover.stl` | 1 each |
| the button cap | `handheld_sign_cap.stl` | 1 |
| the key's tray and cover | `cartridge_tray.stl`, `cartridge_cover.stl` | 1 each |

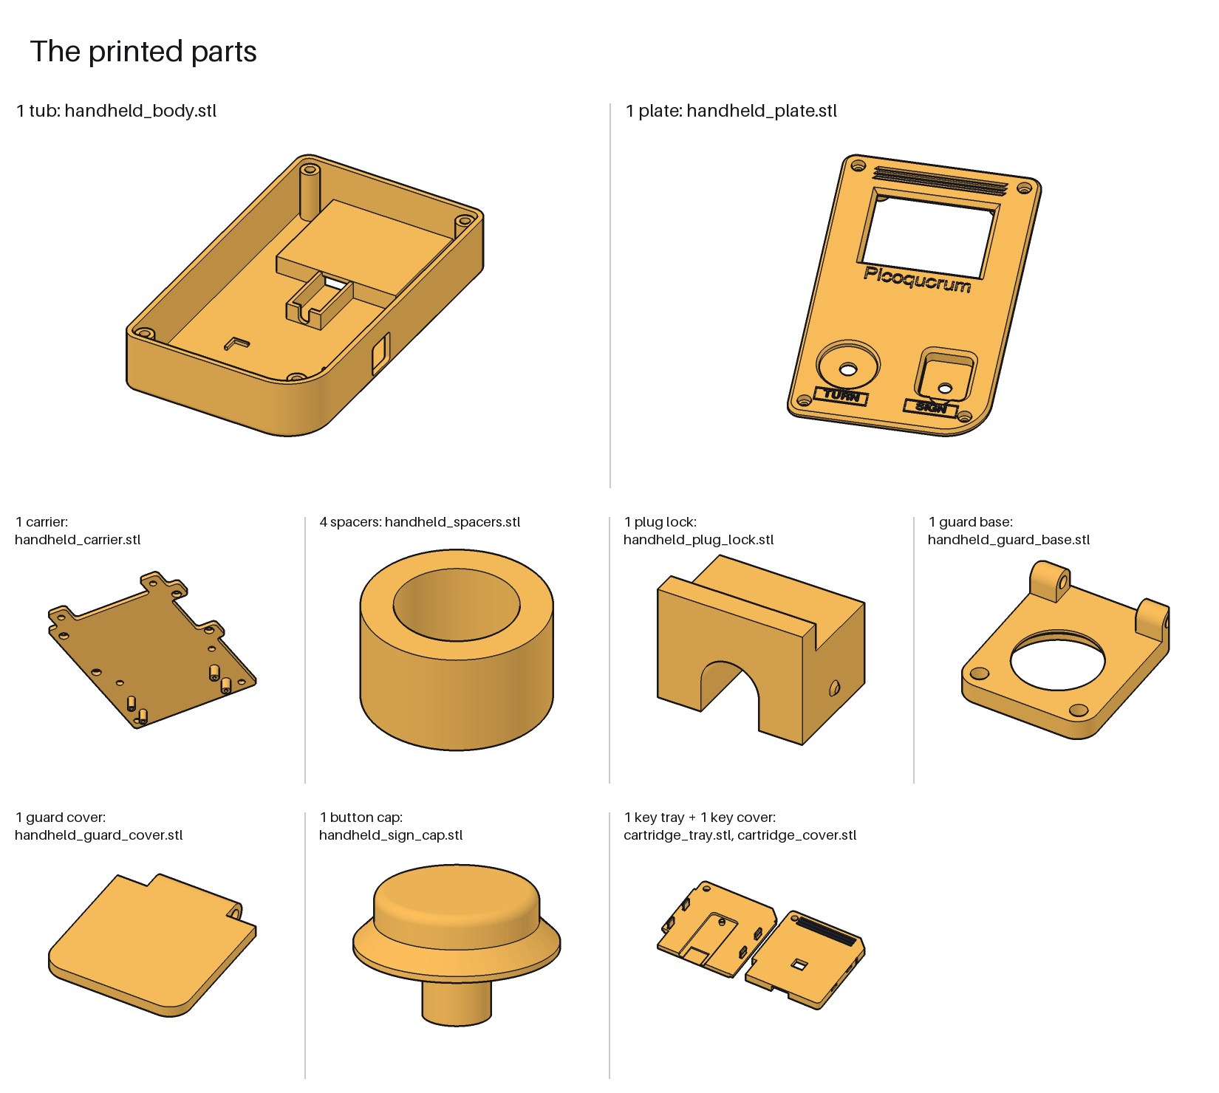
[picture p414: hardware/builds/pico-sign-handheld/case/out/assembly/00-printed-parts.png]
the printed parts


### Printing

Each file is already the way up it prints, on the bed at z = 0. None of them needs supports to start with.
Nothing has been printed yet, so try the untried parts first, in this order:

1. **The key's cartridge**, `cartridge_tray.stl` and `cartridge_cover.stl`, in PETG if you have it: the
   clips are about 1.7% strain to snap in, close to PLA's 2%. Snap them shut without a key first.
2. **The bay test**, `handheld_bay_test.stl`: the tub's top only, from the plug holder's foot up, about
   half the tub. Slide the cartridge in and out: it should run in the grooves, stop on the rib upside down,
   and click at the bottom. Then try the plug and its lock (`handheld_plug_lock.stl`) in the holder, and
   an insert in one of its two corner posts. If the cartridge is tight, sand the bumps; if it's loose or
   won't go, `BAY_CLEAR`, `GROOVE_CLEAR` and `BUMP_R` in `handheld.py` are the numbers to change.
3. **The plate**: every part's hole is in it. Four colours if you like ([below](#the-plates-colours)).
4. **The rest:** the tub, the carrier, the spacers, the guard's base and cover, the cap.

**Bridges** are the only overhangs. The longest is the bay's floor in the tub, 48.6 mm across; if it
sags, put supports in the bay only. In the plate, the wells' floors are 20 to 25 mm; if they sag,
supports in the two wells only. The README lists every one ([what the script checks](README.md#what-the-script-checks)).

**The plate in four colours:** change filament at 0.6, 1.2 and 1.8 mm as it prints, face down
([the colours](README.md#the-colours)).

the plate's colours

### Hardware

| what | how many | where |
|---|---|---|
| M3 heat-set insert, M3\*6\*5 | 10 | 4 in the tub's corner posts, 6 in the plate's bosses |
| M3 × 8 socket head screw | 10 | 4 for the plate into the tub, their heads in counterbores; 6 for the carrier onto the plate's bosses |
| M3 washer | 6 | under the carrier's screws |
| M2 × 8 socket head screw | 6 | 4 for the Pico, 2 for the guard's base. They cut their own thread |
| rubber strip, 6 × 35 mm | 4 | the tub's feet |
| 1.75 mm filament | 20 mm | the guard's hinge pin |

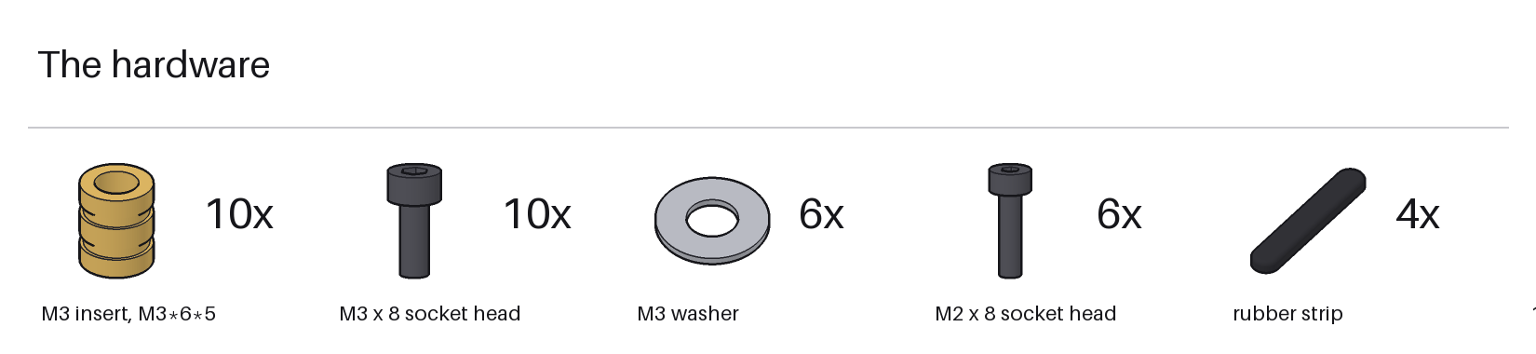
[picture p415: hardware/builds/pico-sign-handheld/case/out/assembly/00-hardware.png]
the hardware


### Bought

- the 2.4″ screen
- a Pico 2 W, no headers
- a 12 × 12 mm tactile switch, a mini breadboard (46 × 34.2 mm) and two flat jumper wires
- an EC11 knob, its nut, and a cap for its 6 mm D-shaft
- a USB-C plug on a short cable, for the key, and two 4.7 kΩ resistors
- a micro-USB cable for the Pico
- thin stranded wire
- a key-c

### Tools

- a soldering iron, with an M3 heat-set insert tip as well as its usual one
- hex keys: 2.5 mm (M3 socket heads), 1.5 mm (M2)
- a spanner or pliers for the knob's nut
- flush cutters, for the hinge pin
- a meter, for the switch's legs
- a towel to lay the plate on

## 1. The tub: an insert in each corner post

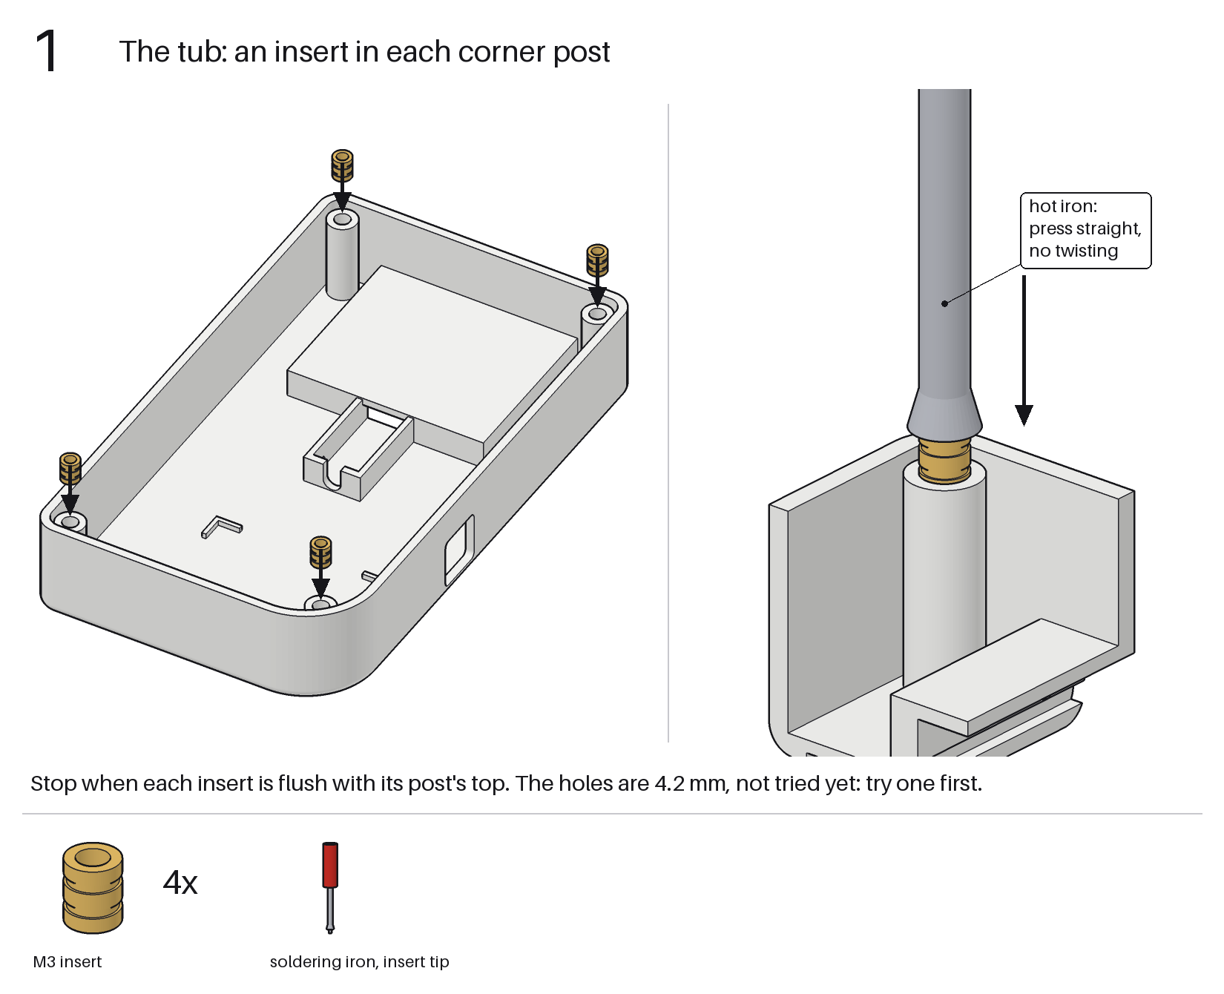
[picture p416: hardware/builds/pico-sign-handheld/case/out/assembly/01-tub-inserts.png]
step 1


The plate screws into these four. Set the iron to the temperature your inserts' maker gives for your
plastic. Sit an insert on the tip, square to the hole, and let it sink in under its own weight with a
light push. Don't twist. Stop when it is flush with the post's top, take the iron straight out, and let
it cool before you touch it.

The insert holes are 4.2 mm, not tried yet. If the first one goes in loose or won't go, stop: the hole
(`M3_INSERT` in `handheld.py`) needs changing.

## 2. The tub: the feet

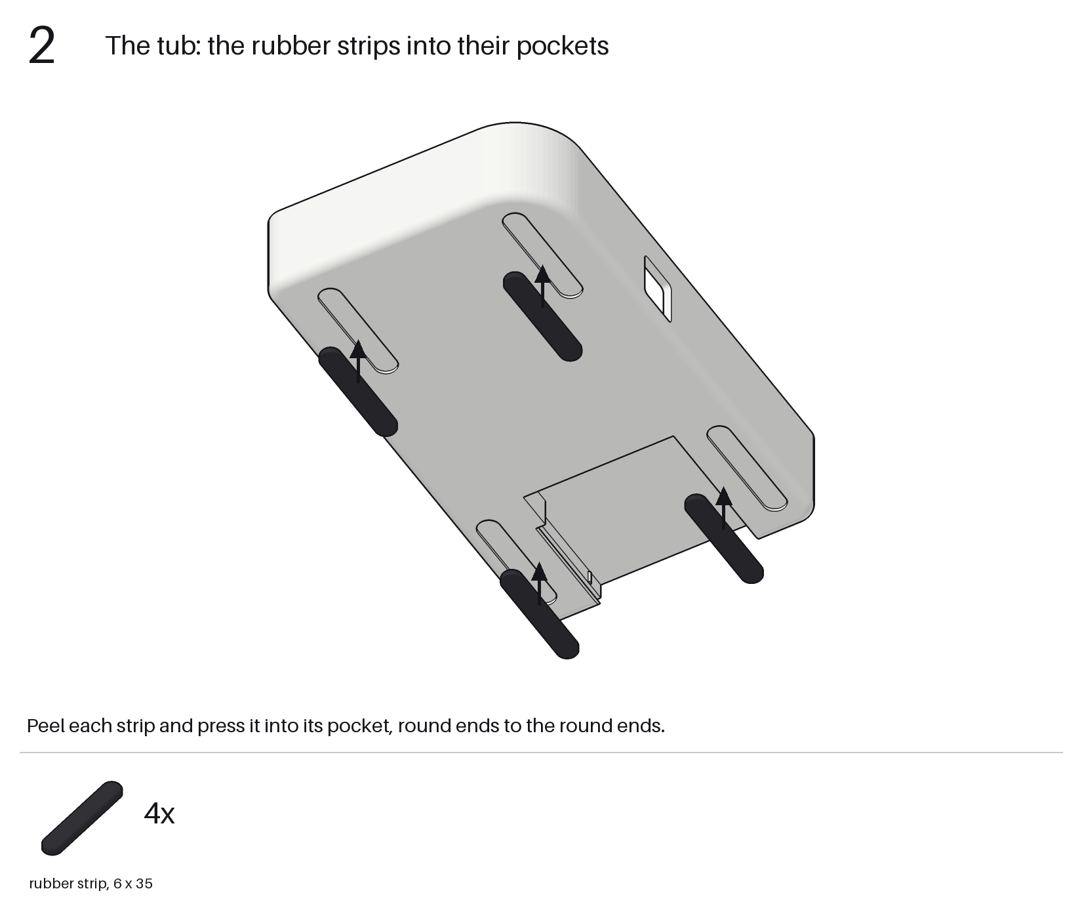
[picture p417: hardware/builds/pico-sign-handheld/case/out/assembly/02-feet.png]
step 2


Peel each strip and press it into its pocket, round ends into the round ends.

## 3. The tub: the key's USB-C plug, at the foot of the key's bay

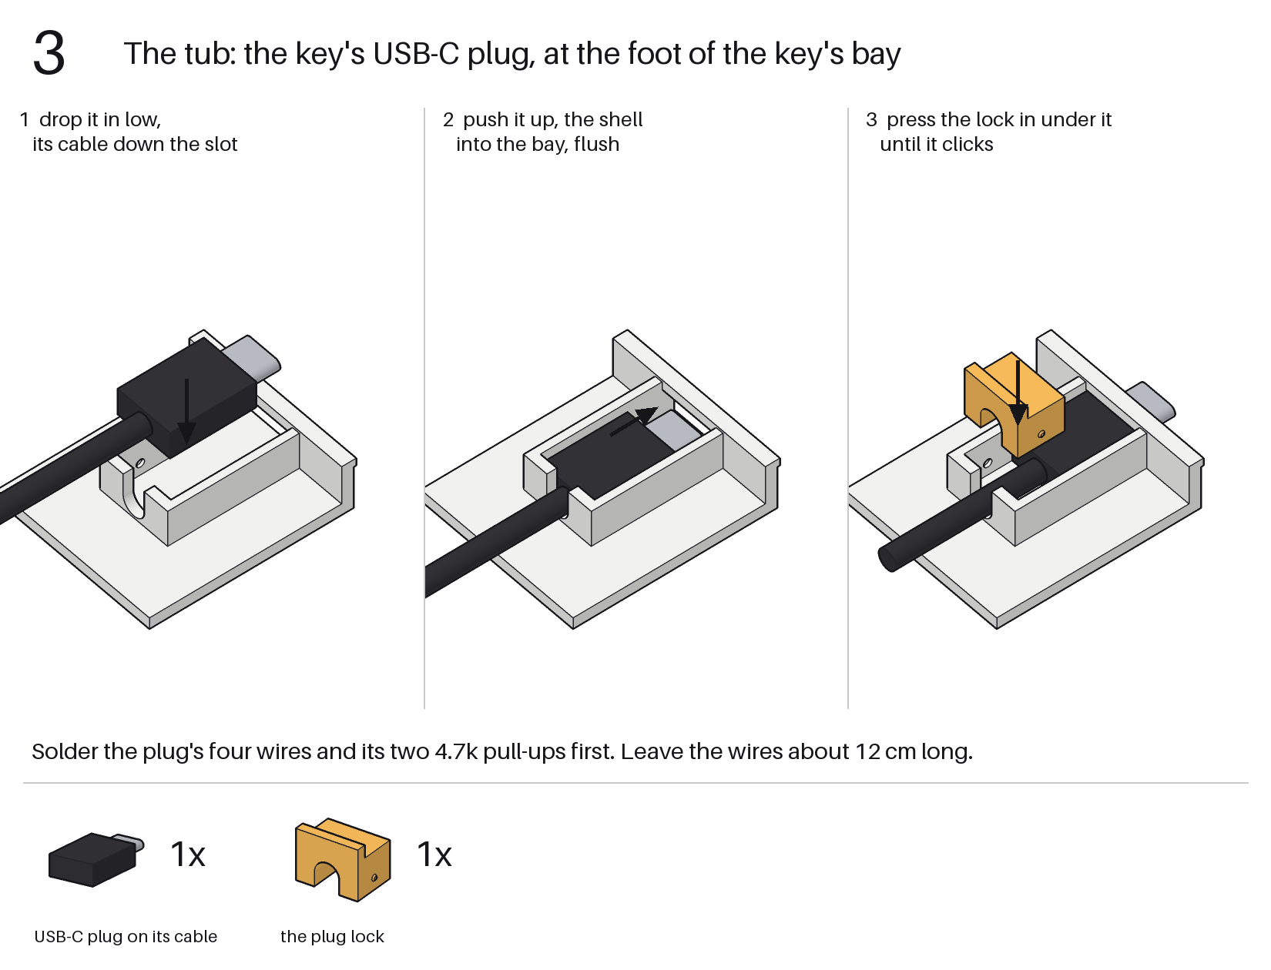
[picture p418: hardware/builds/pico-sign-handheld/case/out/assembly/03-key-plug.png]
step 3


Solder the plug's four wires and its two pull-ups first ([the key](../pico-sign/README.md#the-key)), and
leave the wires about 12 cm long. Then, in the holder under the key's bay, pointing up:
1. Drop the plug into the channel low, its cable down through the slot in the holder's foot.
2. Push it up. The metal shell goes through the hole in the bay's foot and stands up into the bay, and the
   black overmold stops flush with the foot.
3. Press the lock in under it, the cable in the lock's slot, until its two bumps click. Its lip is to
   pull it out by.

## 4. The tub: the breadboard and the sign button's switch

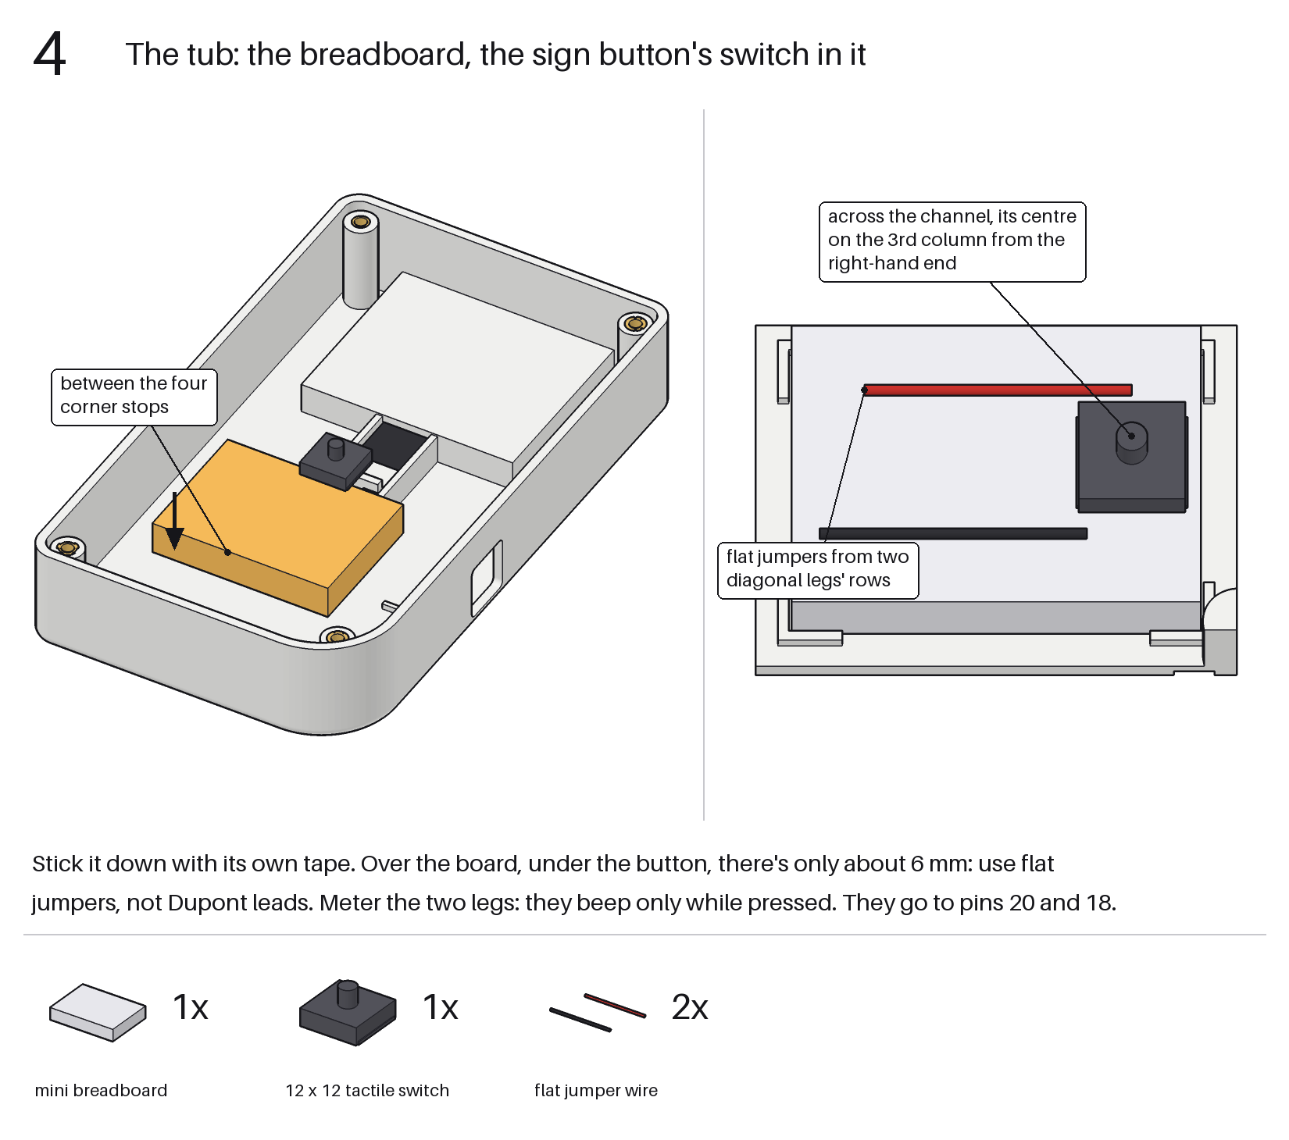
[picture p419: hardware/builds/pico-sign-handheld/case/out/assembly/04-breadboard.png]
step 4


The breadboard goes on the floor under where the button will be, between the four L-shaped stops, long
across the case. Stick it down with its own tape. The 12 × 12 switch goes across the centre channel, its
centre on the **3rd column from the right-hand end**, its legs in the 2nd and 4th. That column is under the
button.

Meter the switch first: find two legs, diagonally opposite, that beep only while it is pressed. Run a flat
jumper from each of their rows; they go to pins 20 and 18. Under the button there's only about 6.6 mm over
the board, so Dupont leads standing up won't fit.

## 5. The plate: an insert in each of the carrier's bosses

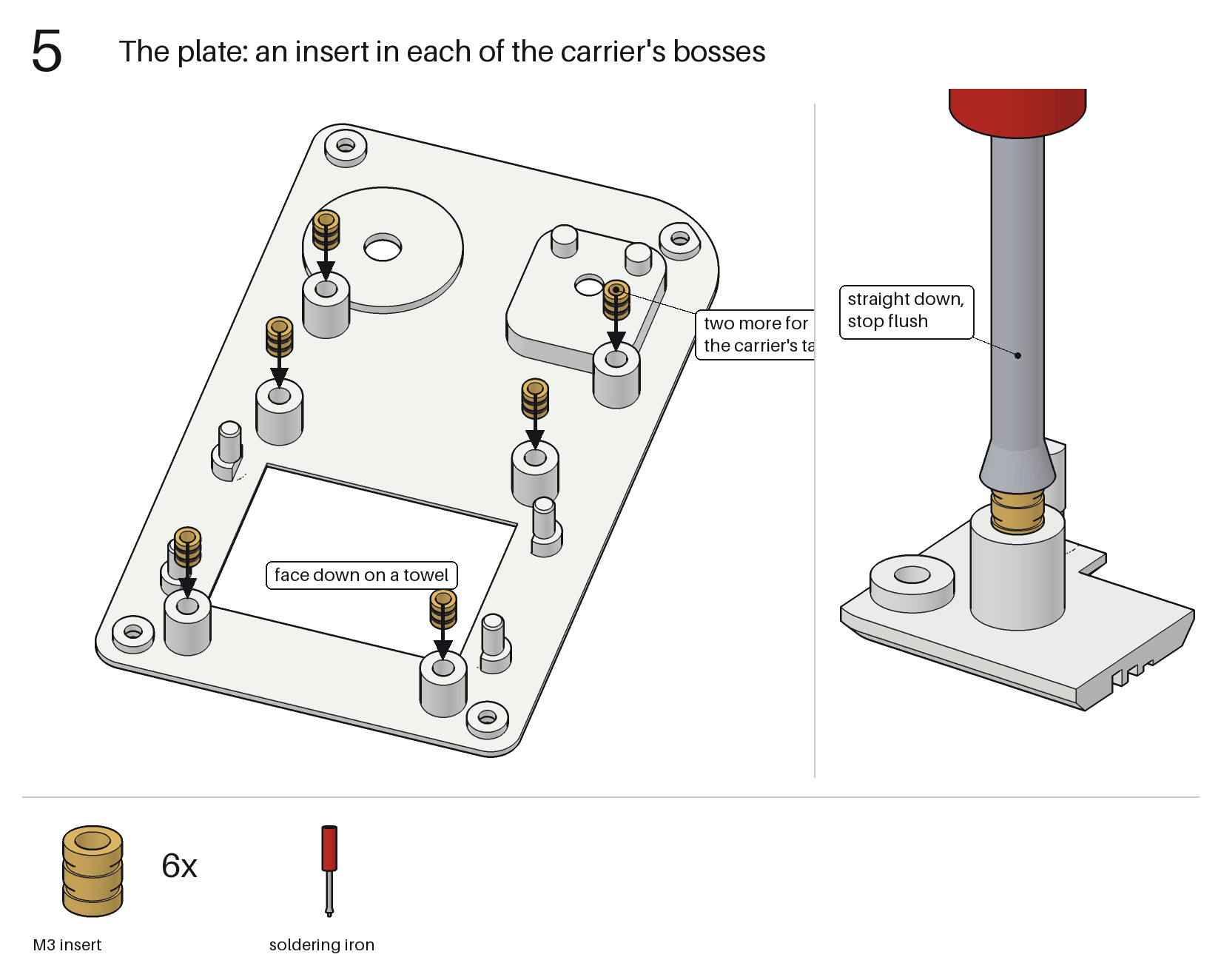
[picture p420: hardware/builds/pico-sign-handheld/case/out/assembly/05-plate-inserts.png]
step 5


Lay the plate face down on a towel. An insert in each of the six round bosses: four round the window, two
lower down for the carrier's tail. As in step 1.

## 6. The sign button's guard, on the bench

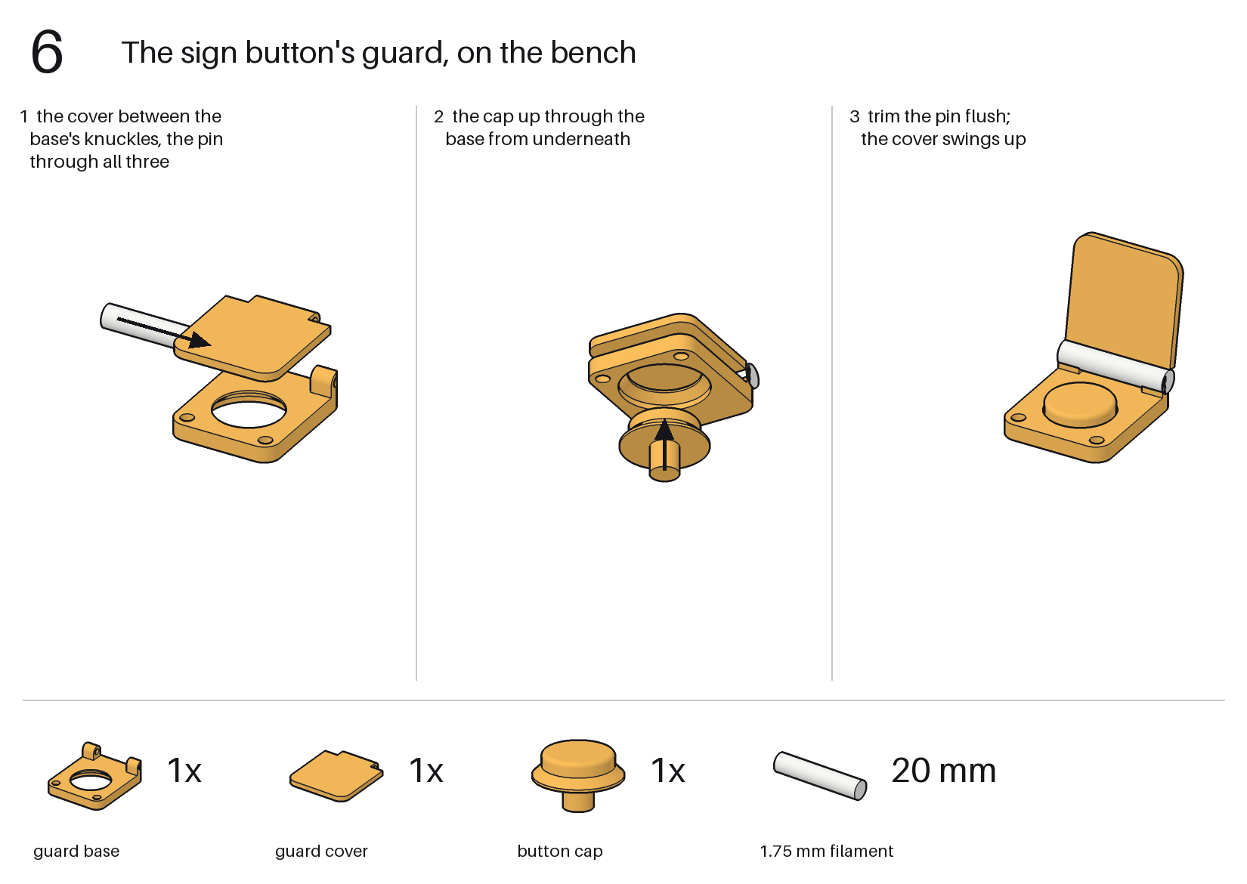
[picture p421: hardware/builds/pico-sign-handheld/case/out/assembly/06-guard.png]
step 6


1. Put the cover's knuckle between the base's two and push the filament through all three. It is tight
   in the base and free in the cover.
2. Push the button cap up through the base from underneath. Its flange seats in the cone under the base.
3. Trim the pin flush on both sides. The cover should swing up and down, and the cap move a little.

## 7. The guard into its well

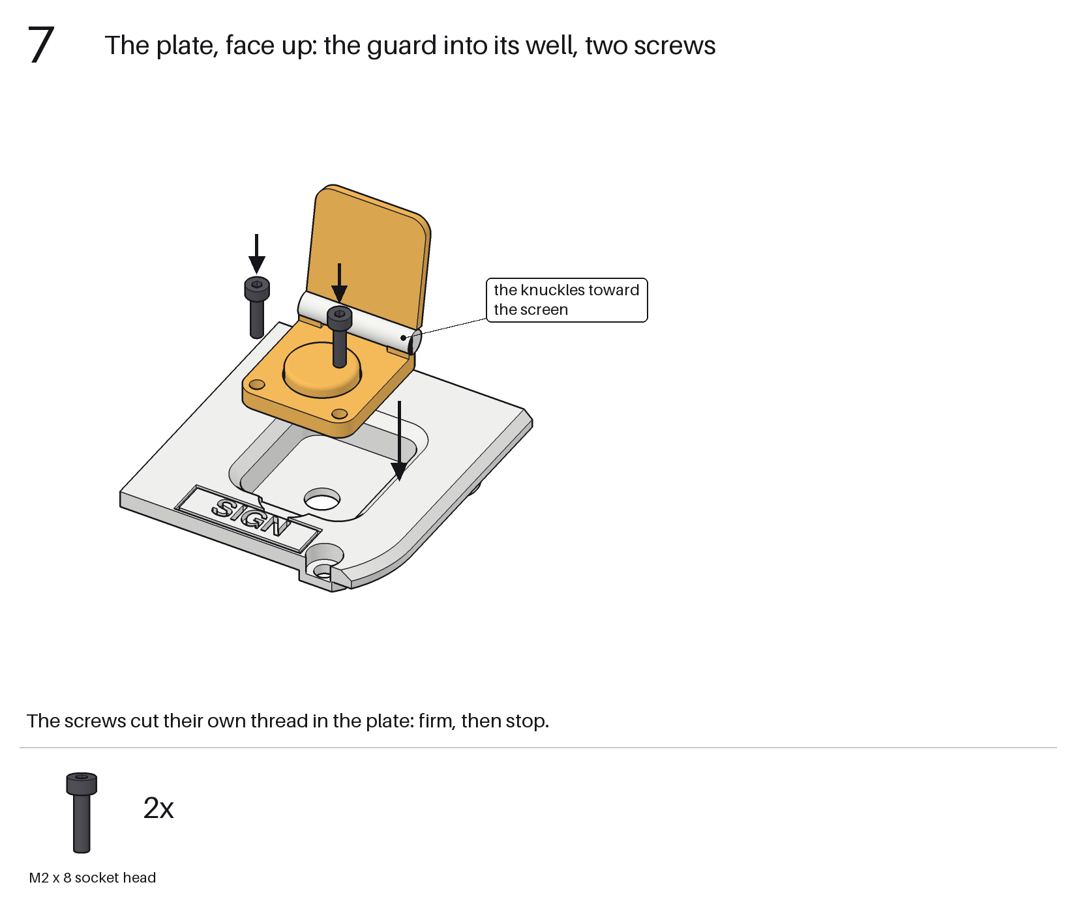
[picture p422: hardware/builds/pico-sign-handheld/case/out/assembly/07-guard-in.png]
step 7


Plate face up. The base, the cap and the cover go into the sign button's well together, the knuckles
toward the screen. Two M2 × 8 through the base's holes into the plate. They cut their own thread: turn
until firm, then stop.

## 8. The plate: the knob

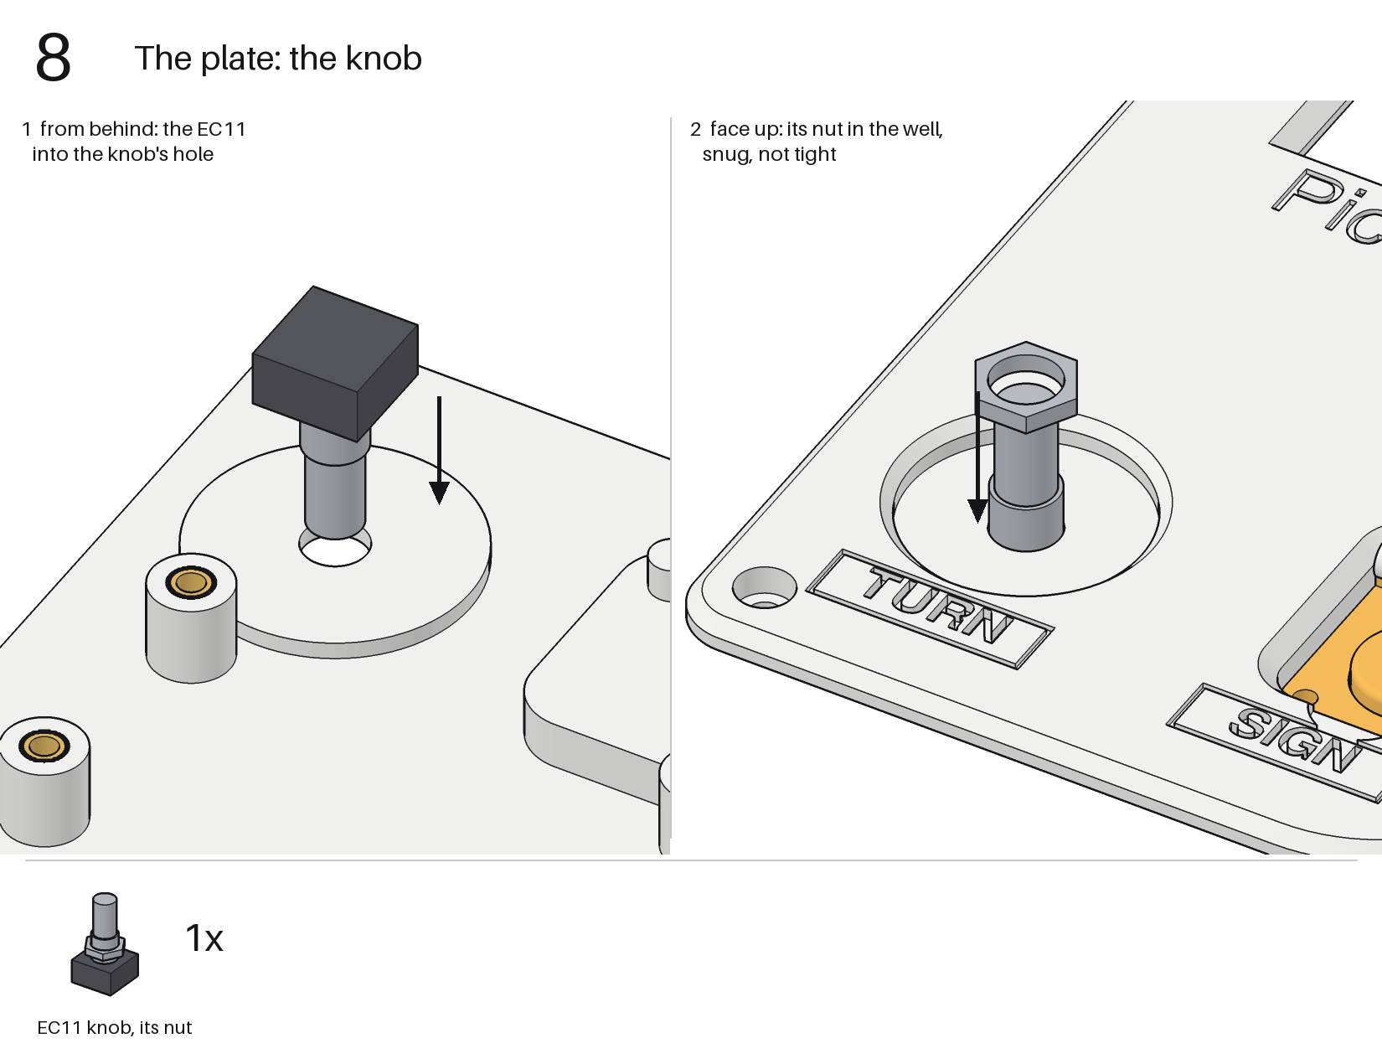
[picture p423: hardware/builds/pico-sign-handheld/case/out/assembly/08-knob.png]
step 8


From behind, the EC11 into the knob's hole. Turn the plate over and put its nut on in the well. Snug,
not tight.

## 9. The plate: the screen onto its pins

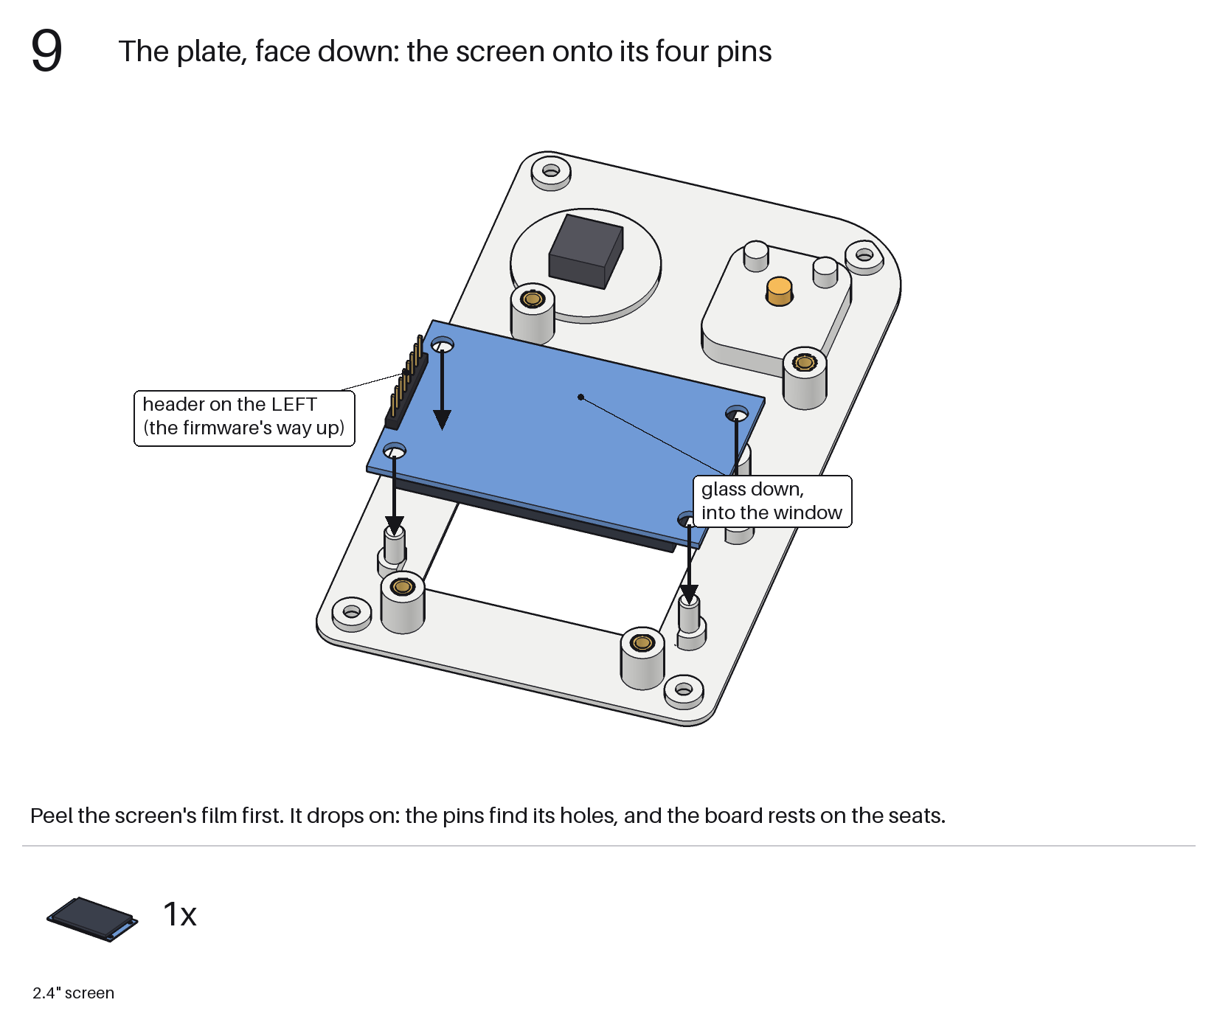
[picture p424: hardware/builds/pico-sign-handheld/case/out/assembly/09-screen.png]
step 9


Face down again. Peel the screen's film. It goes glass down, its 8-pin header on the **left**. Lower it
onto the four pins: they go through its corner holes, and the board rests on the posts' seats.

## 10. The plate: the spacers

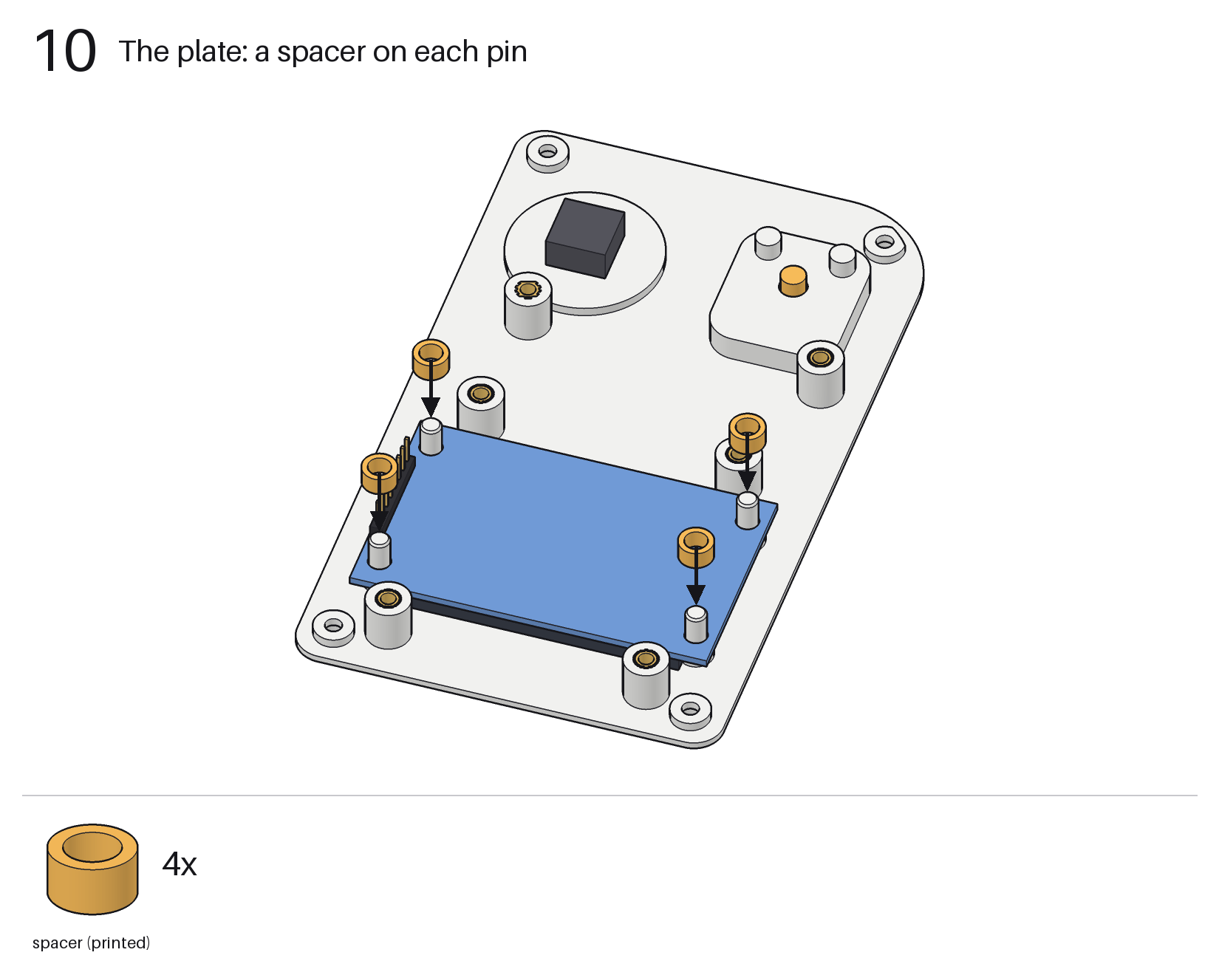
[picture p425: hardware/builds/pico-sign-handheld/case/out/assembly/10-spacers.png]
step 10


A printed spacer on each pin.

## 11. The plate: the carrier

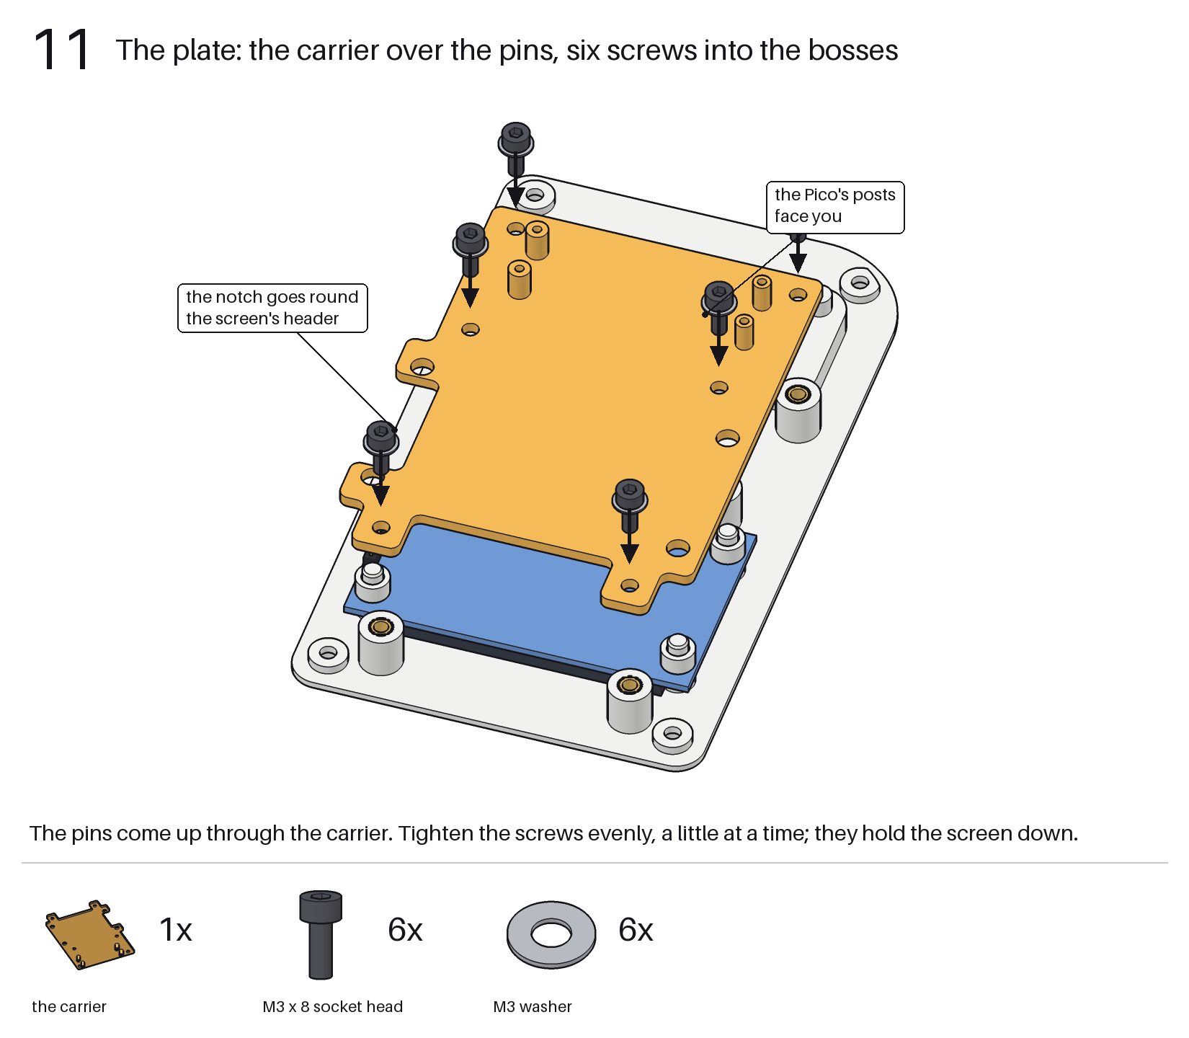
[picture p426: hardware/builds/pico-sign-handheld/case/out/assembly/11-carrier.png]
step 11


The carrier over the pins, the Pico's posts on its tail facing you, its notch round the screen's header.
Six M3 × 8 with washers into the bosses. Tighten the four round the screen evenly, a little at a time: they
hold the screen down.

## 12. The plate: the Pico

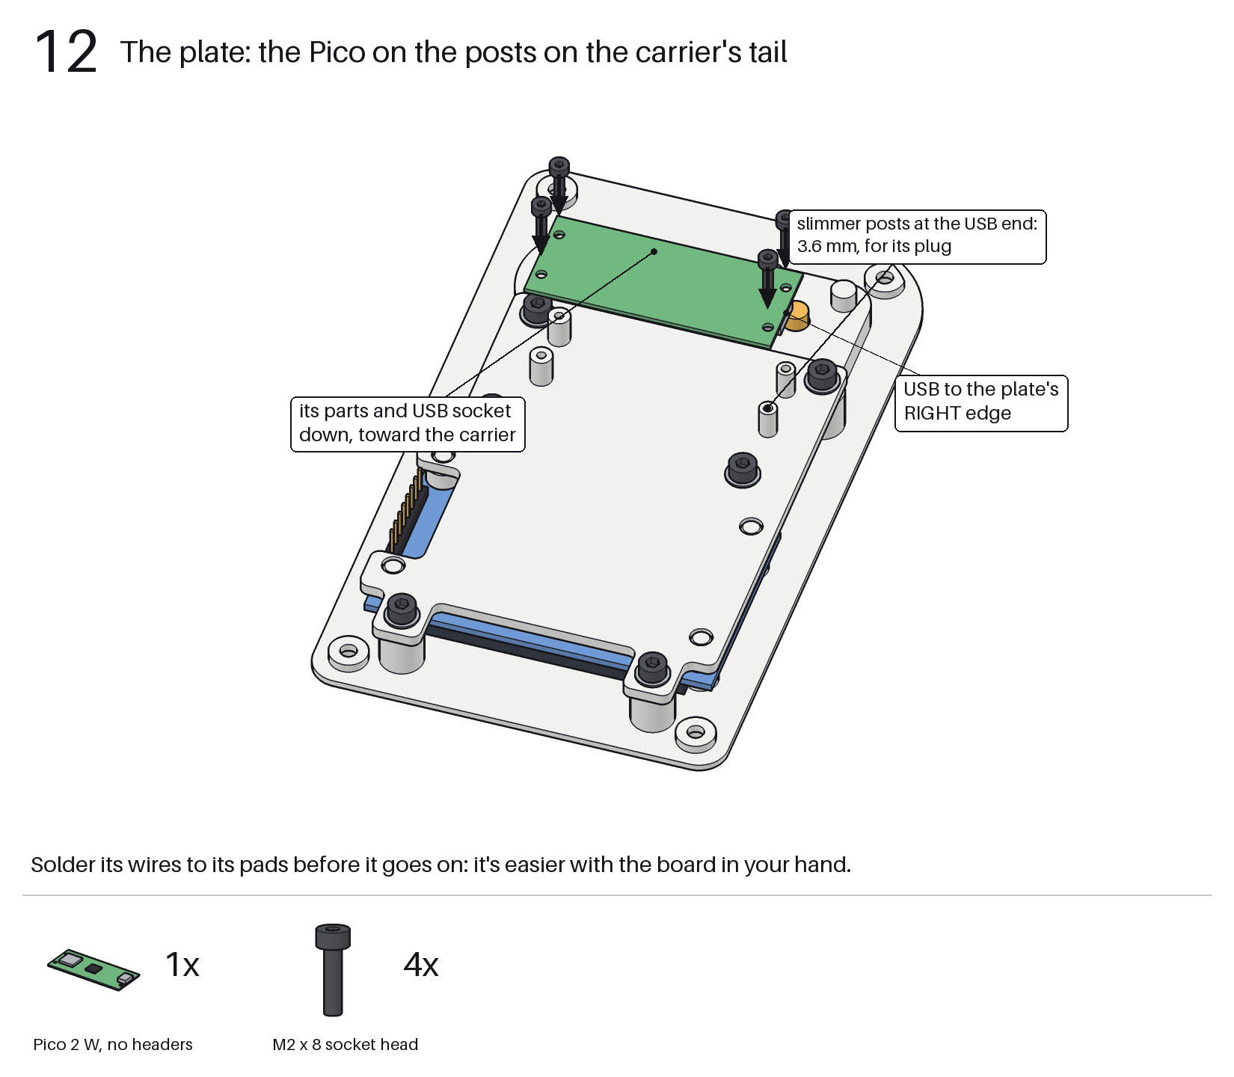
[picture p427: hardware/builds/pico-sign-handheld/case/out/assembly/12-pico.png]
step 12


Solder its wires to its pads first, with the board in your hand. Then onto the four posts on the
carrier's tail, below the screen: its parts and USB socket down toward the carrier, its USB end to the
plate's **right** edge. The slimmer posts are at the USB end. Four M2 × 8.

## 13. The wires

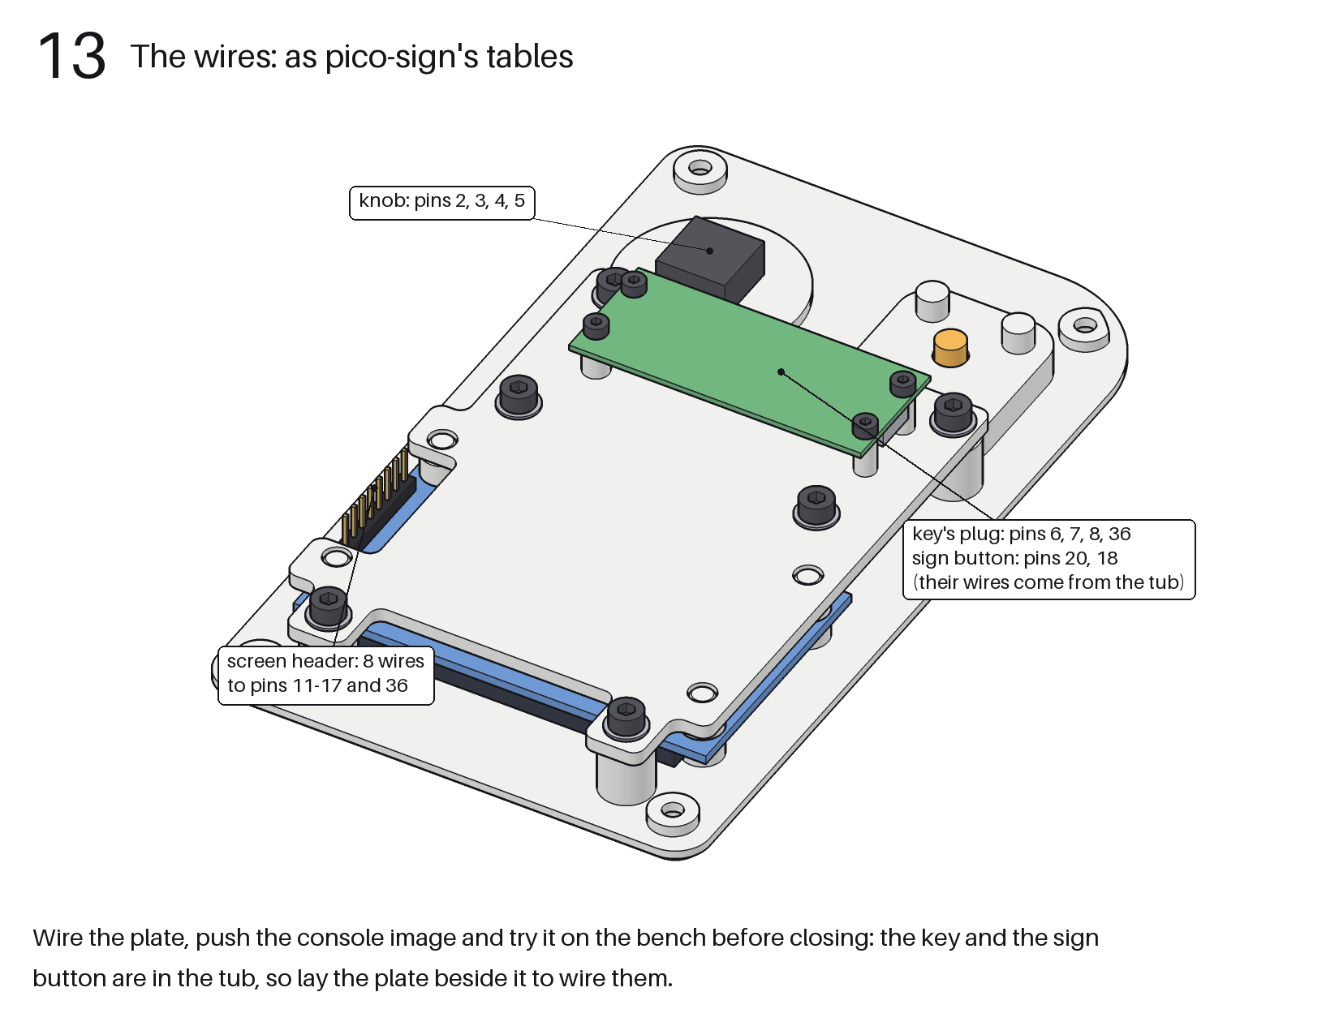
[picture p428: hardware/builds/pico-sign-handheld/case/out/assembly/13-wires.png]
step 13


The screen's header and the knob to the Pico, as pico-sign's tables say. Push the console image and try
it on the bench ([the bench check](README.md#first-the-bench-check)) before it goes in the tub. The key's
plug and the sign button's switch are in the tub: their wires come in the next step.

## 14. Onto the tub

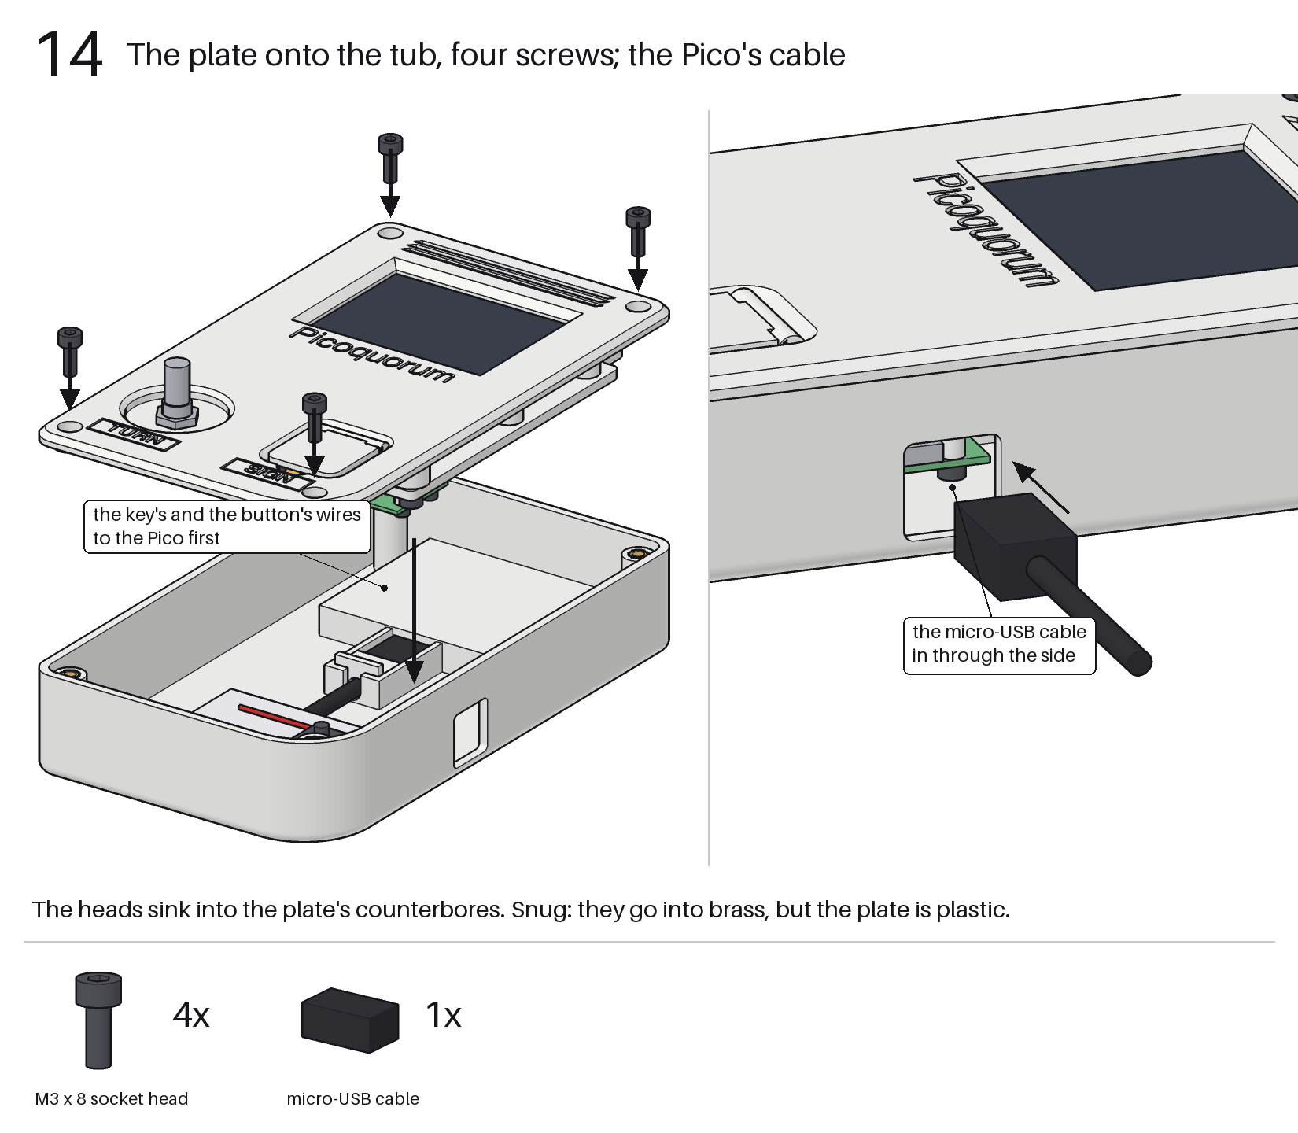
[picture p429: hardware/builds/pico-sign-handheld/case/out/assembly/14-close.png]
step 14


Lay the plate face down beside the tub and solder the key's plug wires and the sign button's two jumpers
to the Pico. Press the cap: the switch should click. Then the plate onto
the tub, and four M3 × 8 socket heads through its corners, into the counterbores. Snug: they go into brass, but the plate is plastic. The micro-USB cable goes in through the hole in the right side, straight into
the Pico's socket.

## 15. The key into its cartridge

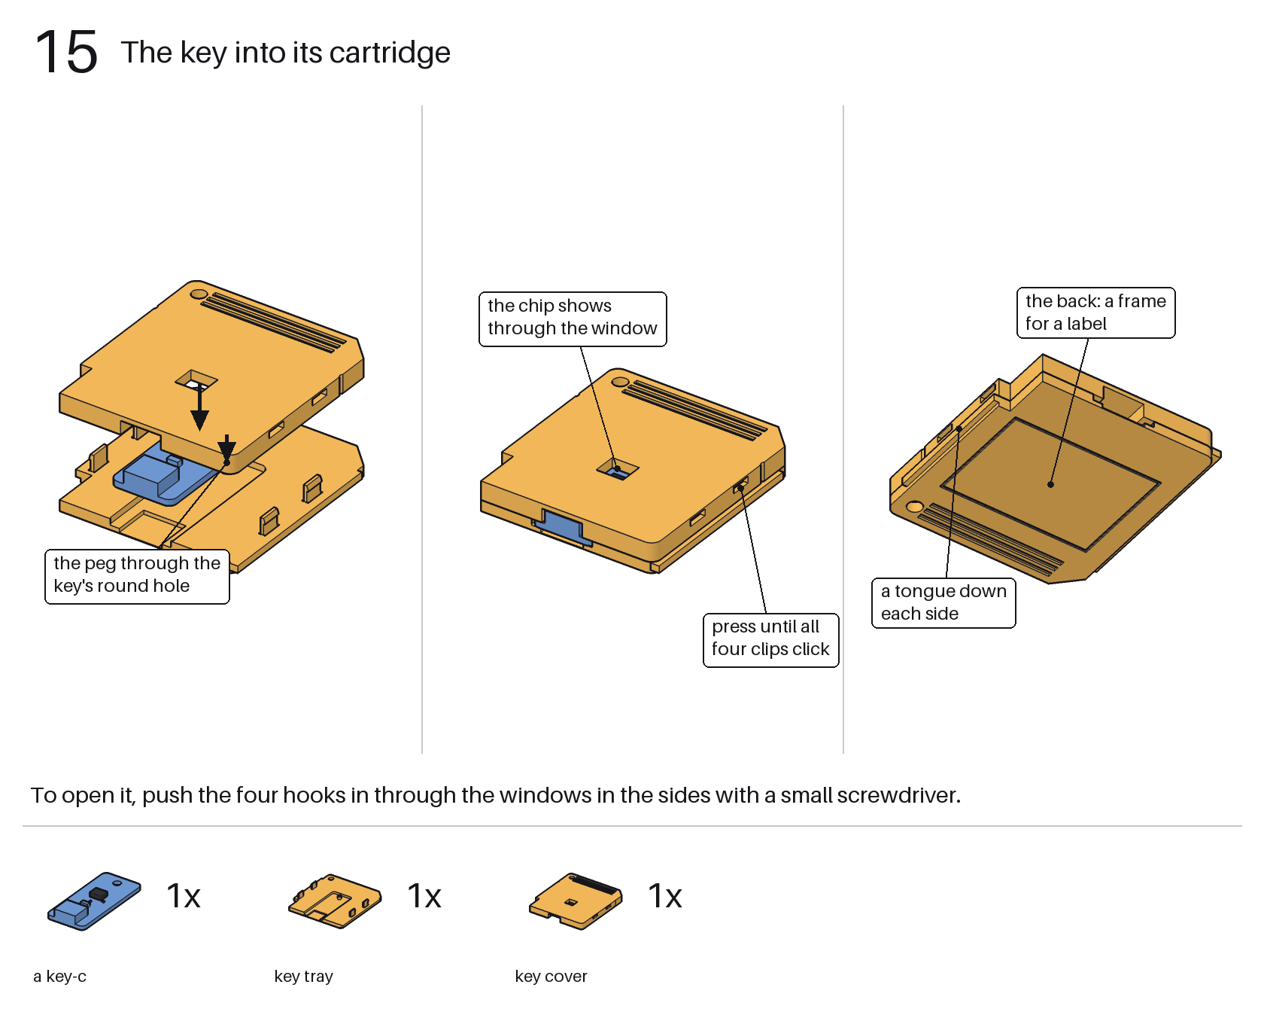
[picture p430: hardware/builds/pico-sign-handheld/case/out/assembly/15-key.png]
step 15


The key-c into the tray, parts up, the tray's peg through its round lanyard hole. The cover on, and
press until all four clips click. The chip shows through the window. To open it, push the four hooks in
through the windows in the sides with a small screwdriver.

The tray's outside is the back: a label goes in its frame. A tongue runs down each of the tray's sides,
and the bottom left corner (seen from the front, the chip's window up) is cut away.

The clips are not tried. Print the two halves and try them before the key goes in; if they're loose,
glue them.

## 16. The knob's cap, then the key into its bay

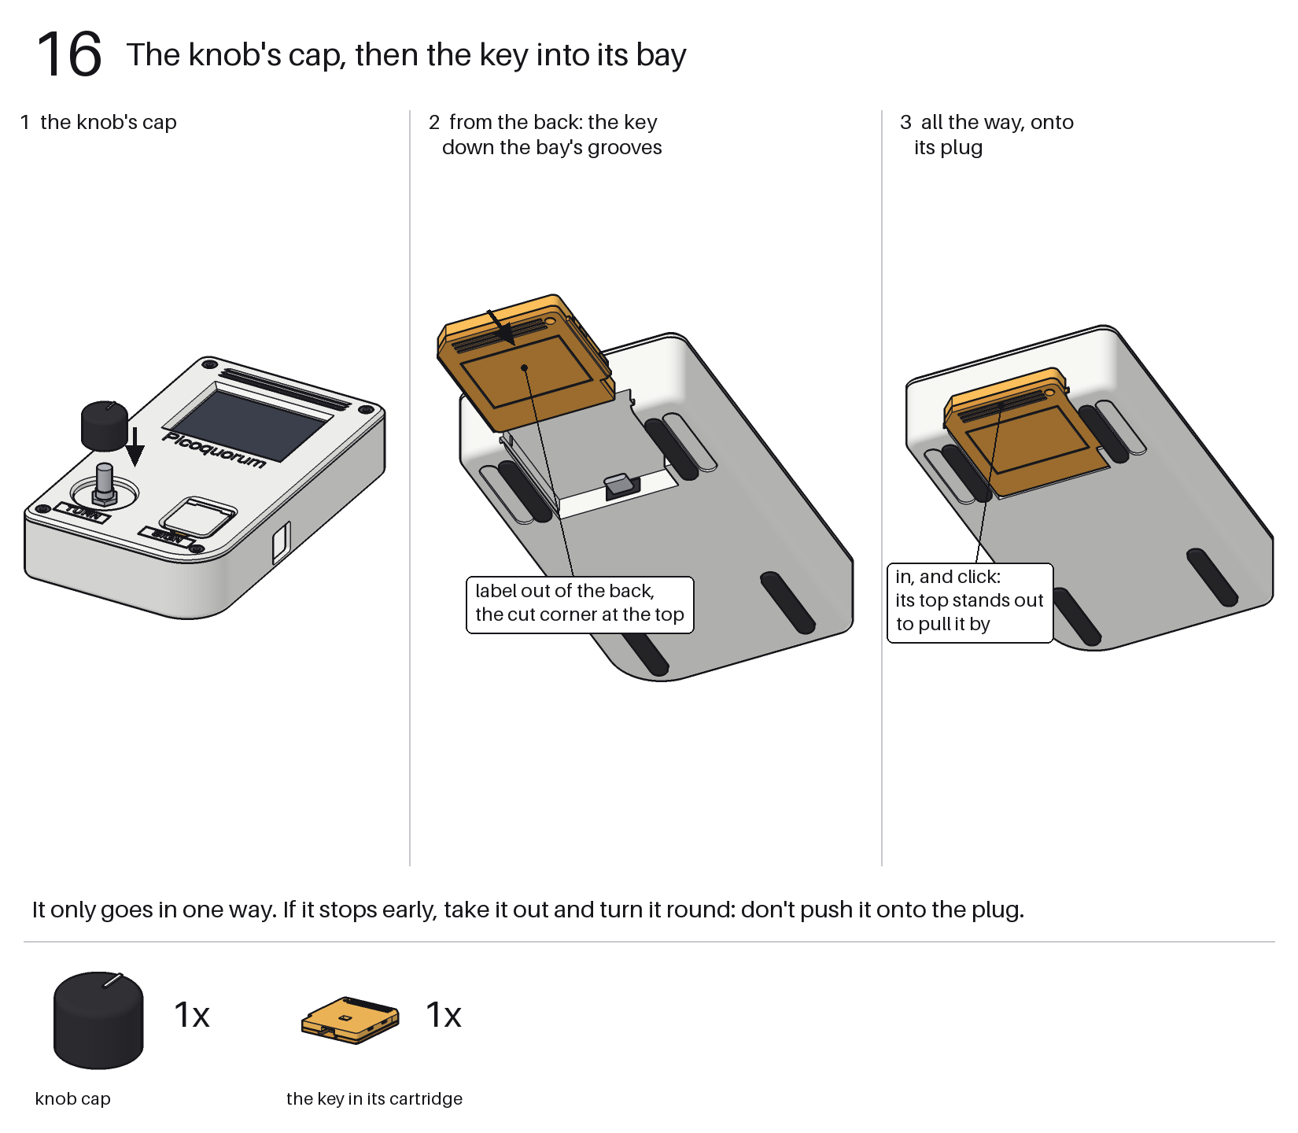
[picture p431: hardware/builds/pico-sign-handheld/case/out/assembly/16-done.png]
step 16


The cap onto the knob's shaft. Then turn the handheld over. The key goes into the bay in the back from the
top edge, plug end first, its label toward you and its cut corner at the top. Its tongues go into the
bay's grooves. Slide it straight down until it clicks onto its plug; its top stays 8 mm out of the top
edge, to pull it out by.

It only goes in one way. Upside down, it stops on the rib in the bay's corner before it reaches the plug.
Back to front, it won't start down the grooves. If it stops early, take it out and turn it round: don't
push it onto the plug.
