jmcpheron/pico-quorum/hardware/builds/pico-sign/case/IDEAS.md

# Case ideas

Three ways to box pico-sign. A is modelled in [`case.py`](case.py); B and C are only written down.

| | A: the wedge | B: the desk console | C: the open sled |
|---|---|---|---|
| looks like | a sloped metal-box enclosure | a small desk console | a bare board on a plate |
| sign switch | front, pressed hard by hand | under a bar along the front edge | front corner |
| screen | landscape, behind the controls | landscape, tilted about 25° | flat, on standoffs |
| key | stands up out of the lid at the back | plugs in from the side, like a cartridge | on a short cable, loose |
| print | lid ~1.5 h, base ~4 h (0.28 mm layers) | ~5 h | ~1 h |
| for tonight | yes: print the lid first | too long | the fallback |

## A: the wedge (modelled)

A Hammond-1590-style wedge, about 100 × 150 mm. The big metal sign switch at the front says what
the box is for before anyone reads the screen: signing is a deliberate act, a press you hold. The
key standing up at the back shows in every shot, so a key swap reads on camera.

Next steps if it's the one:
- a round fillet along the lid's top edges
- a clip under the plug's sleeve instead of hot glue
- a printed bracket for the screen on its own holes, once it's measured
- a chamfer on the back wall's USB hole

## B: the desk wedge

The screen tilted up to face you, the knob to its right, and a long hinged bar across the front edge
over the sign switch, so the whole front edge is the switch. The key slides into a slot in
the left side and its end shows, like a game cartridge. Better for close-up filming of the screen;
less of a story than A's one big switch.

## C: the open sled

A 3 mm plate with standoffs: the Pico, the screen and the knob in plain view, the sign switch in a
printed block at the front, the key on a short USB-C cable. Every wire shows, which suits a "this is
homemade, here's everything in it" post. One hour to print, so it's the fallback if A's lid doesn't
fit tonight.
