jmcpheron/pico-quorum/hardware/builds/feather-pigtail/case/out/pigtail_case_v1_preview.png

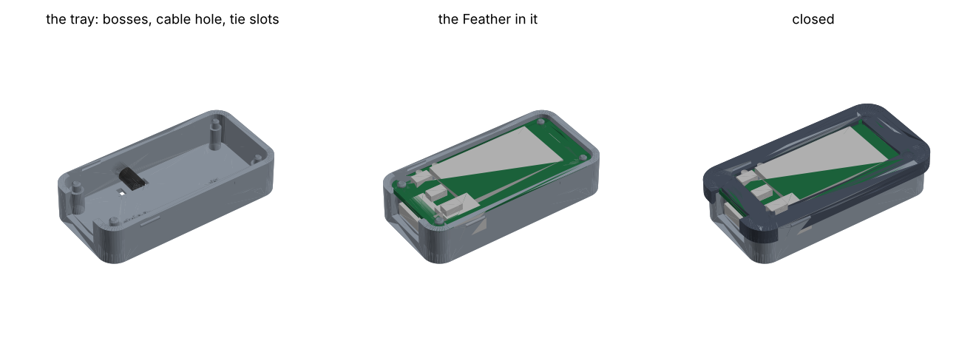
hardware/builds/feather-pigtail/case/out/pigtail_case_v1_preview.png
