jmcpheron/pico-quorum/hardware/builds/pico-sign-handheld/case/out/assembly/card-key-in.png

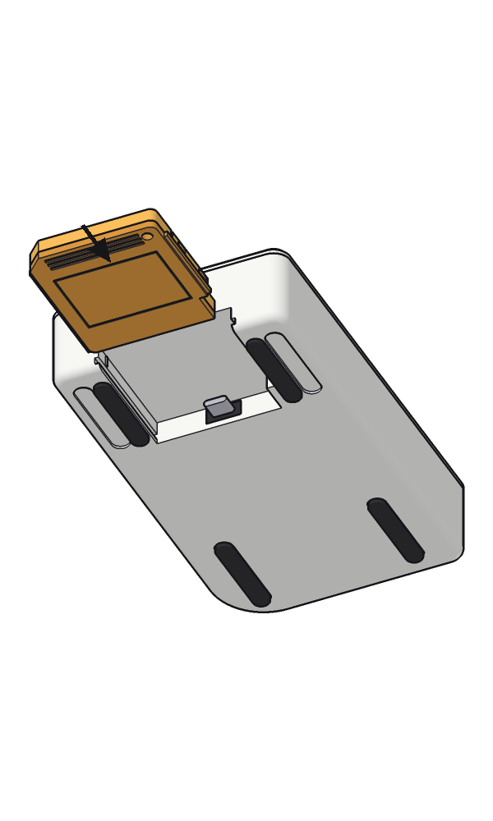
hardware/builds/pico-sign-handheld/case/out/assembly/card-key-in.png
