jmcpheron/pico-quorum/hardware/builds/pico-sign/case/out/pico_sign_exploded.png

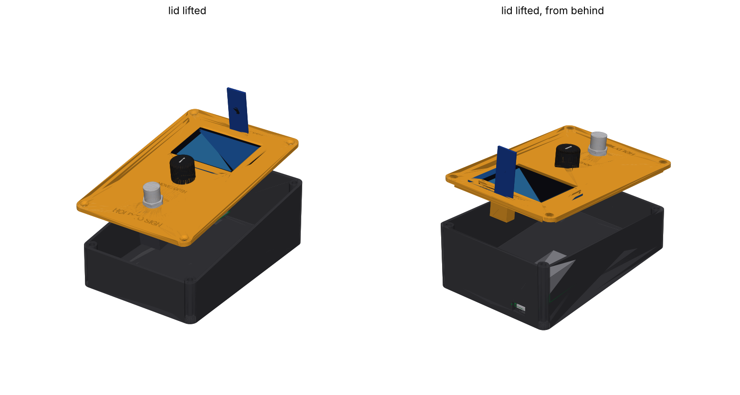
hardware/builds/pico-sign/case/out/pico_sign_exploded.png
