jmcpheron/pico-quorum/hardware/builds/pico-sign/case/out/pico_sign_preview.png

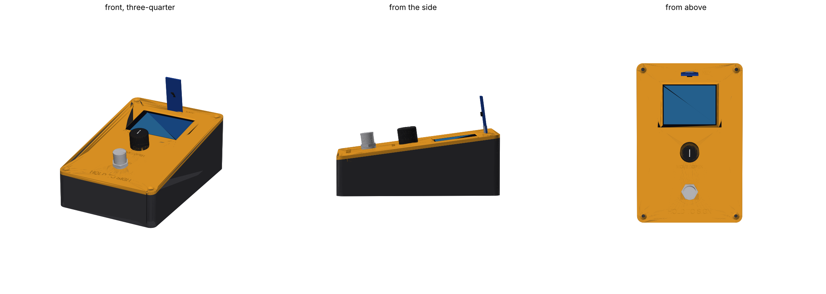
hardware/builds/pico-sign/case/out/pico_sign_preview.png
