jmcpheron/pico-quorum/hardware/prototypes/picoquorum-key/docs/BRINGUP.md

# Building and bringing up a board

*2026-10-23. Per board, about 30 minutes once the parts are on the bench.*

## What you need

- the assembled board from JLCPCB (key chip U2 already placed), a WROOM-1-N8R2, a panel, foam tape
- a temperature-controlled iron (fine chisel tip), flux pen, 0.5 mm solder, wick, isopropyl
- a multimeter, a USB-C cable to the Mac, `esptool` and `mpremote` (both already on this Mac)
- MicroPython `ESP32_GENERIC_S3` 1.26.1 `.bin` from https://micropython.org/download/ESP32_GENERIC_S3

## 1. The bare board

Before any hand soldering:

- Meter 3V3 pad to GND for shorts: expect kΩ or more, not zero.
- Plug in USB. Expect 3.3 V ± 0.1 V on TP1 (+3V3) and 5 V on TP11 (+5V). The backlight switch
  must be off: J2 pad 8 (LEDA, the pad nearest the USB end) near 0 V.
- Unplug.

## 2. Check the key (U2, UDFN-8)

JLCPCB placed it. Check under a loupe that its pin-1 dot matches the silkscreen triangle and that no
pads are bridged (they are 0.5 mm apart, and hidden under the part's edge: look at the fillets).
Meter SDA and SCL to 3V3: ~4.7 kΩ each, and neither shorted to GND.

## 3. Solder the module (U1, back face)

- Flux all 41 pads. Position the module on the **back**: antenna end flush with the board's top
  edge, the antenna area over the empty band. Pin 1 (GND, nearest the antenna) matches the
  silkscreen's pin-1 mark. The pads run 1 mm past the castellations for the iron.
- Tack pin 1 and the opposite corner. Check that every castellation sits on its pad.
- Drag-solder each side with a well-tinned tip and plenty of flux. The castellations wick solder
  from the pad up the half-hole; a clean fillet in each half-hole is the sign.
- Leave the exposed pad (41) unsoldered (datasheet section 9 allows it).
- Clean with isopropyl. Meter 3V3 to GND again for shorts, then EN to 3V3 (10 kΩ).

## 4. Flash MicroPython

```sh
esptool --chip esp32s3 --port /dev/cu.usbmodem* erase_flash
esptool --chip esp32s3 --port /dev/cu.usbmodem* write_flash -z 0 ESP32_GENERIC_S3-20250911-v1.26.1.bin
mpremote
```

The S3's own USB enumerates as `/dev/cu.usbmodem…`. If esptool can't enter download mode by itself:
hold BOOT, tap RESET, release BOOT, retry. In the REPL:

```python
import esp, esp32, gc
esp.flash_size()          # 8388608 for N8R2
gc.mem_free()             # ~ 8 MB with 2 MB PSRAM mapped; a few hundred kB without
```

If `gc.mem_free()` shows no PSRAM, the module is not an R2 or the build is wrong; stop here.

## 5. Panel and smoke test

- Put 1.5 mm foam tape on the board at the glass outline's left and right ends, liners still on.
- Flip J2's actuator up (it hinges at the rear, the side away from the fold). Hold the panel face
  up beside the board's right edge, fold its ribbon back under the glass, and slide it fully into
  J2 from the right. The contacts are double-sided, so the ribbon's face can't be wrong. Press
  the actuator down.
- Lay the panel over the glass outline. Don't peel the tape's top liners until the test passes.

```sh
mpremote cp firmware/smoke/smoke.py :smoke.py
mpremote run firmware/smoke/smoke.py
```

The test, in order, and what passing looks like:

| step | passes when |
|---|---|
| backlight | stays off for 1 s, then comes up (GPIO21 driving the NPN); dims at 25 % |
| screen | three colour bands then the text `picoquorum-key` **upright**, with the buttons on the left |
| rails | three short ticks at rows 7, 67 and 127 at the left edge, level with the three switches |
| buttons | each of D0 D1 D2 (GPIO42–40) prints its name when pressed and lights its rail tick |
| LED | blinks at 2 Hz throughout |
| key bus | `i2c scan: ['0x60']` and nothing else |
| key | `ATECC608 serial: 01 23 ... EE` (9 bytes, first `01 23`, last `EE`), and the chip answers at 0x60 after wake |
| key port, no key | `key port: CC reads 1`, and nothing more from the port: it stays unpowered |
| key port, a key-c in | `CC reads 0`, `VKEY on` with D4 (beside the plug) lit, `i2c(1) scan: ['0x60']`, a `key-c serial` that isn't U2's; then `i2c(0) scan again: ['0x60']` (the buses are apart) |

Anything else is a hardware fault to find before the console image goes on. The test reads only
the chip's public serial number; it signs nothing and reads no key (rule 3).

## 5a. The key port (rev B boards with the port's parts)

Before the plug, and before any key:

- Meter VKEY (D3's cathode) and VKEY_SW (C10) to GND: neither a short; VKEY reads about 10k
  (R23). TP9 (KCC) reads 3.3 V, TP10 (KEN) 0 V. D5 in diode mode: about 0.2 V from C10 to D3's
  cathode, open the other way.
- The plug's A6 and A7 pads are open to TP6 and TP7 (U2's SDA and SCL): the two buses are apart.
- Short J3's A5 pad to GND through 5.1k: TP9 reads about 0.4 V.

**Solder the plug (J3).** Hold a real plug against the paddle first: A1, the dot on the silkscreen,
must be the pin that lands on the front's left pad with the plug pointing up out of the top edge
(DESIGN.md). Slide the 0.8 mm paddle into the plug, flux, solder the front row, then the back row
and the shell legs. Check every pad for bridges at 0.5 mm.

Then with the smoke test (`mpremote run firmware/smoke/smoke.py`):

- No key: the port lines above. Plug a key-c in and run it again: the second set.
- Plug and unplug a key-c 20 times with the board powered and the smoke test's loop running: no
  reset, and the soldered chip still answers (`i2c(0)` scan) after each.
- **Wi-Fi, three numbers**, the same spot and time: RSSI with no key, with a key-c on the plug, and
  on a board without the port's parts. Write them in DESIGN.md. A key-c is a 16 × 36 mm board with a
  ground pour standing beside the antenna; this is the measurement the layout can't make.
- A key-c P3: its own LED is lit with D4, while the key is powered.
- **5 V on VBUS**, from a bench supply at 5.0 V, current limit 30 mA, on J3's VBUS and GND, no
  key. D5 should stop it with KEY_EN low or high (DESIGN.md, "5 V on the plug's VBUS").
  - The supply's current is VKEY's own loads: D4 about (5 − 2.7) / 470 ≈ 5 mA, R23 0.5 mA, D5's
    leakage microamps. About 6 mA; over 10 mA is a path DESIGN.md doesn't know.
  - The board **off** (USB out): 3V3 at TP1 reads under 0.1 V; D1 and the panel stay dark;
    nothing appears on the laptop's USB. Then plug USB in with the 5 V still on: the board starts as
    usual and 3V3 reads 3.3 V ± 0.1 V.
  - The board **on**, smoke test running, with KEY_EN low and then high (the smoke test's key-port
    step, or `Pin(2, Pin.OUT, value=1)` at the REPL): 3V3 at TP1 stays 3.3 V ± 0.1 V throughout,
    VKEY_SW (C10) reads 3.3 V with KEY_EN high, and the supply's current doesn't change when
    KEY_EN does.
  - Take the 5 V off and unplug and replug USB: the board starts as usual.
  Write the numbers in DESIGN.md.
- With a key-c in and powered: VKEY (D3) about 3.1 V, VKEY_SW (C10) 3.3 V. After KEY_EN goes
  low, VKEY falls under 0.5 V within 20 ms (R23).

The console image doesn't use the port yet ([PINS.md](PINS.md#in-the-console-image)): under it the
key on the plug stays unpowered.

## 6. Finish

- Peel the tape, press the panel down square to the rail ticks.
- Write the board's serial (from the test) and the module's lot on the back in pencil, or in the
  project log.
- The console image and the ceremony are Picoquorum's steps (`tools/fw push console`), from a
  release that has the `picoquorum-key` profile; 2026.10.12 and earlier don't
  ([PINS.md](PINS.md#in-the-console-image)).
- From 2026.11.1, plug it into a computer and open the app's **Device** page in Chrome or Edge.
  **Connect** shows the board, its release and its key. The page can send the board a Wi-Fi network
  and the Safes to watch, each saved only once D2 is held on the board ([USB-LINK.md](../../../../docs/USB-LINK.md)).

## Checks worth a minute each

- 3V3 under Wi-Fi: with the console image scanning, 3V3 stays above 3.2 V at the pad. On a scope
  (AC, 20 MHz limit, at C2): no ringing that outlasts a Wi-Fi burst, and the same with a key-c
  plugged in while it runs. U3's output capacitors are all ceramic, which its datasheet doesn't
  cover (DESIGN.md, Power). Feel U3 after ten minutes of Wi-Fi: warm, not too hot to hold.
- Straps at reset: TP8 (BOOT, GPIO0) high with a meter while holding RESET. 45 and 46 have no
  pads; their defaults show as a normal boot.
- esptool reaches the bootloader both ways: BOOT+RESET by hand, and with no buttons.
- Backlight off at reset: unplug, plug in, the panel stays dark until software asks.
