jmcpheron/pico-quorum/test-vectors/README.md

# test-vectors

Safe transactions with known-correct hashes. **Every change to `firmware/safe_tx.py` (or to
`firmware/keccak.py`) must pass all of them.**

```sh
python3 test-vectors/run.py                 # CPython
(cd emu && npm ci)                     # once
node test-vectors/run-micropython.mjs       # MicroPython 1.26, as on the Pico
```

Each run exits 1 on any mismatch.

## Where the expected values come from

Not from the firmware. `tools/vectors/gen.mjs` computes them with viem's `hashTypedData`:

- Made-up cases that cover a plain ETH send on Base and Base Sepolia, an ERC-20 transfer, a
  delegatecall to MultiSendCallOnly, nonzero gas-refund fields, an `addOwnerWithThreshold`, and
  uint256 edge values.
- `real-*` cases are executed transactions from the Safe{DAO} treasury on Ethereum mainnet. Their
  expected `safeTxHash` is the value Safe's transaction service published, and the generator
  checks that viem agrees before writing it.

Add a case in `tools/vectors/gen.mjs` and regenerate. Never edit `safe_tx.json` by hand.

## `webauthn.json`: the chip's signature, packed for the Safe

`firmware/webauthn.py` turns a safeTxHash into what the chip signs (a WebAuthn assertion), and the
chip's (r, s) into the contract signature the Safe checks through this key's signer proxy. It also
computes that proxy's address.

`tools/vectors/webauthn.mjs` makes the expected values with other code: node:crypto for SHA-256,
viem for ABI, CREATE2 and keccak, and noble for P-256. It then puts every vector to the deployed
contracts on Base Sepolia over the public RPC, read only:
- the owner must equal the passkey factory's `getSigner`
- the signature must pass `isValidSignatureForSigner`, the check the Safe makes at execution

It writes nothing unless the chain agrees. `webauthn_check.py` is the check itself, shared by both
runners.

```sh
(cd tools/vectors && npm ci && node webauthn.mjs)
```
