jmcpheron/pico-quorum/docs/firmware-production/shots/65-ceremony-C3-result.png

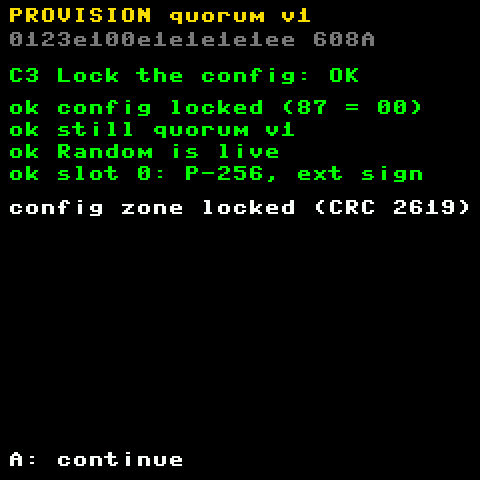
docs/firmware-production/shots/65-ceremony-C3-result.png
