jmcpheron/pico-quorum/docs/firmware-production/shots/75-ceremony-C8-result.png

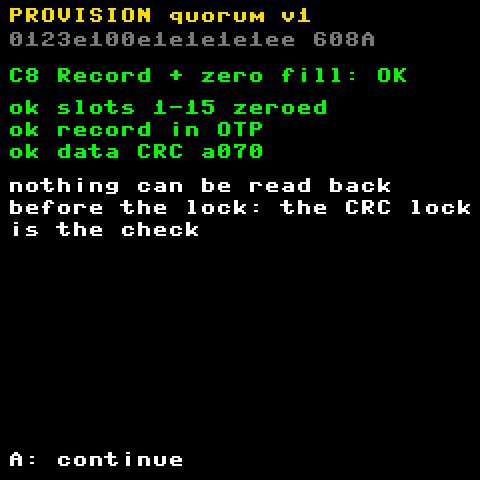
docs/firmware-production/shots/75-ceremony-C8-result.png
