jmcpheron/pico-quorum/docs/firmware-production/shots/84-ceremony-C1-result-light.png

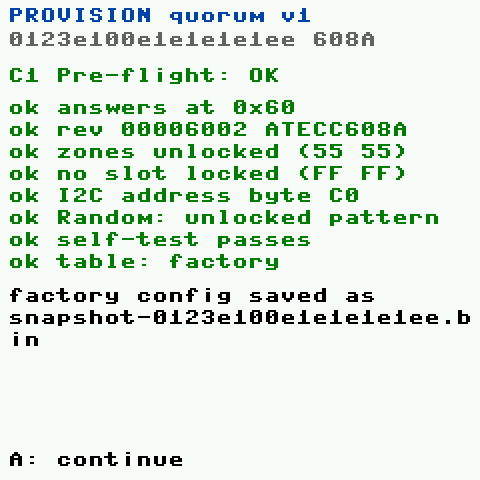
docs/firmware-production/shots/84-ceremony-C1-result-light.png
