jmcpheron/pico-quorum/docs/quorum-ui/shots/36-light-verify.png

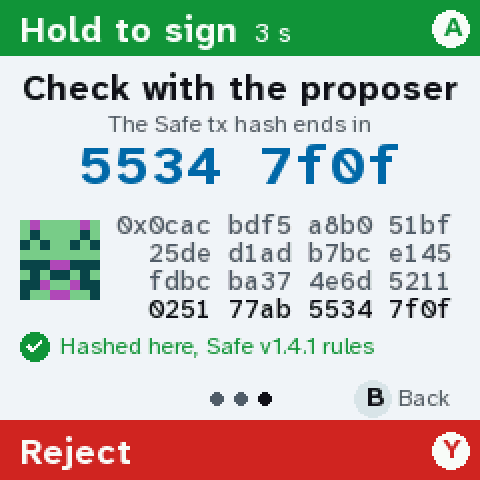
docs/quorum-ui/shots/36-light-verify.png
