jmcpheron/pico-quorum/docs/quorum-ui/v2/fonts/compare-11-batch-verify.png

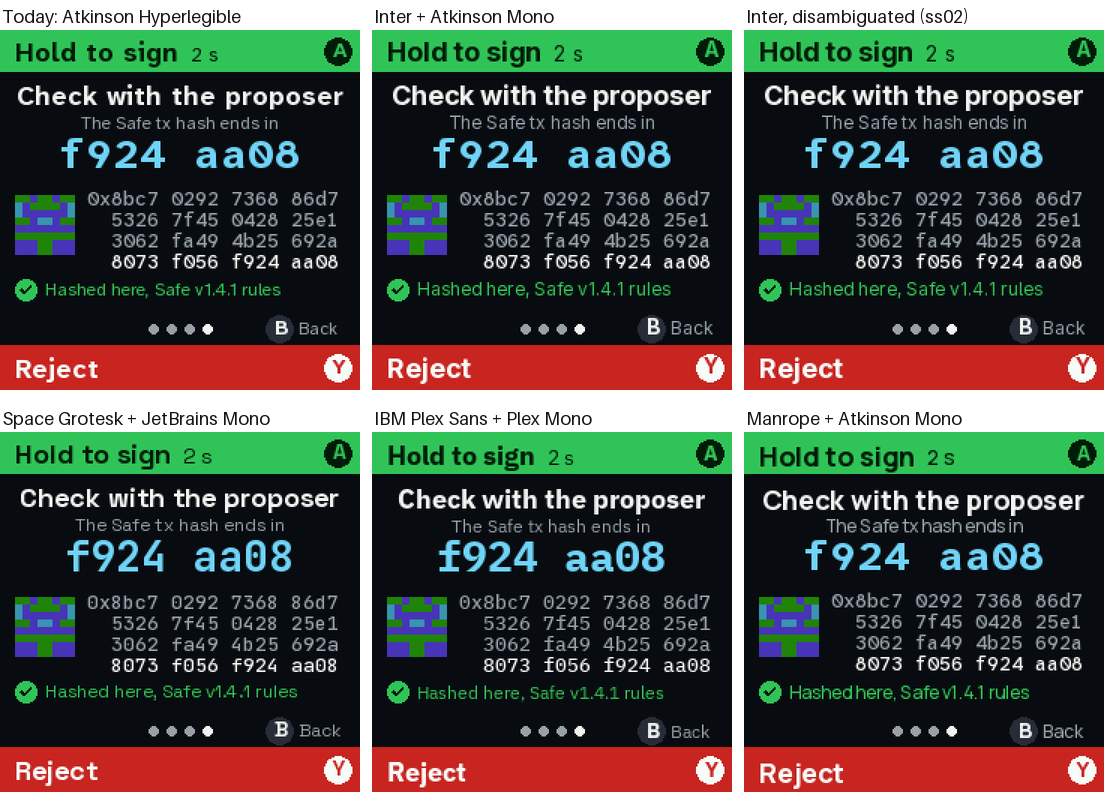
docs/quorum-ui/v2/fonts/compare-11-batch-verify.png
