jmcpheron/pico-quorum/hardware/prototypes/picoquorum-key/tests/golden/B_Cu.png

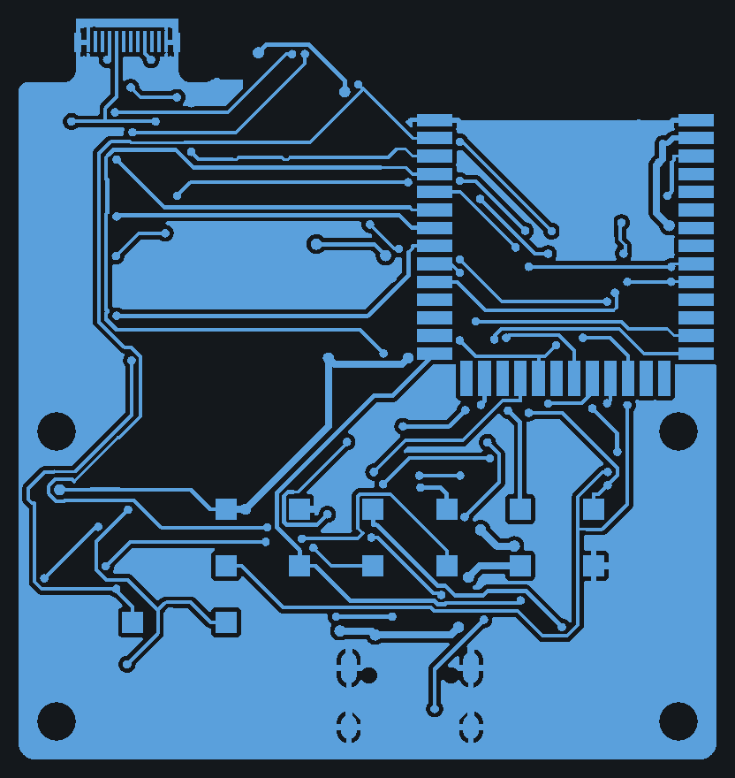
hardware/prototypes/picoquorum-key/tests/golden/B_Cu.png
