jmcpheron/pico-quorum/hardware/prototypes/picoquorum-key/tests/golden/B_Mask.png

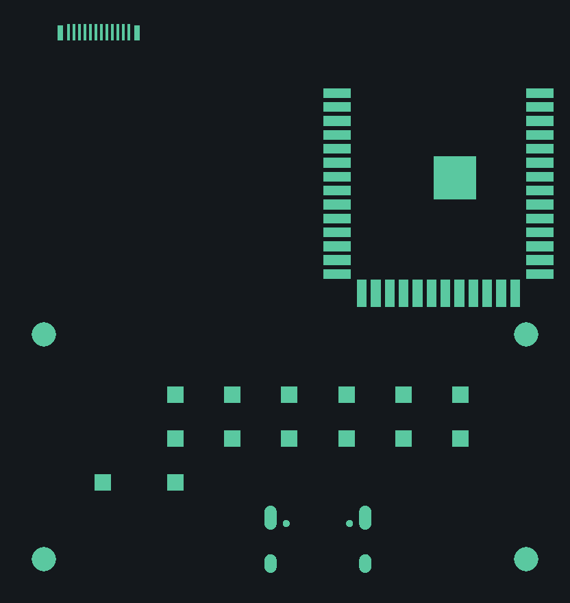
hardware/prototypes/picoquorum-key/tests/golden/B_Mask.png
