jmcpheron/pico-quorum/hardware/prototypes/picoquorum-key/tests/golden/B_Silk.png

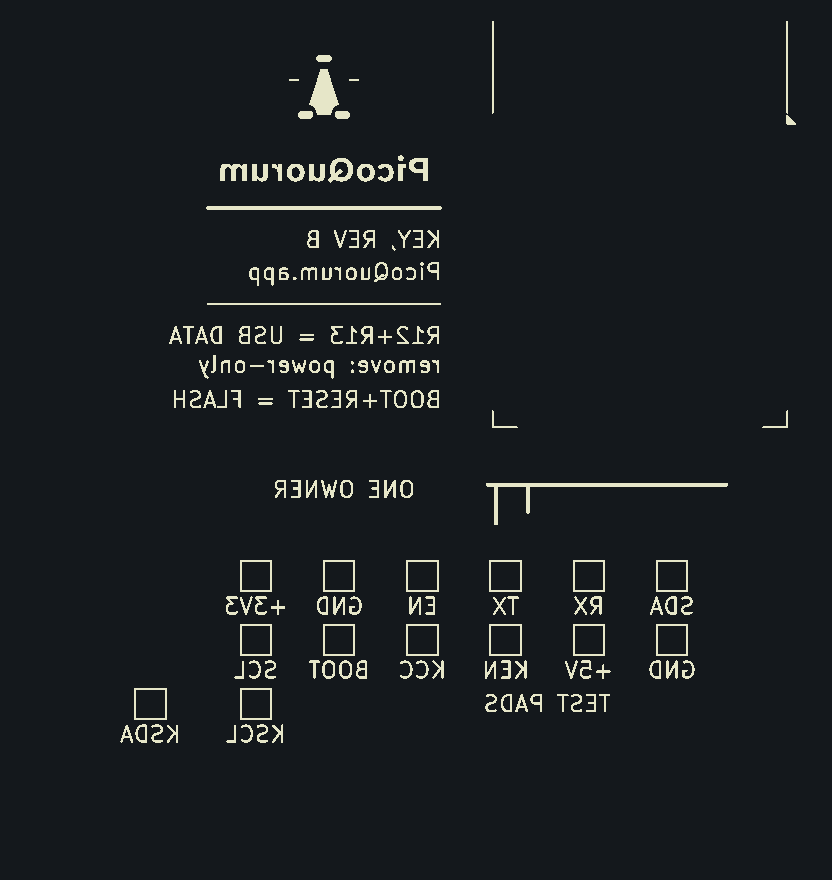
hardware/prototypes/picoquorum-key/tests/golden/B_Silk.png
