jmcpheron/pico-quorum/hardware/prototypes/picoquorum-key/tests/golden/Drill.png

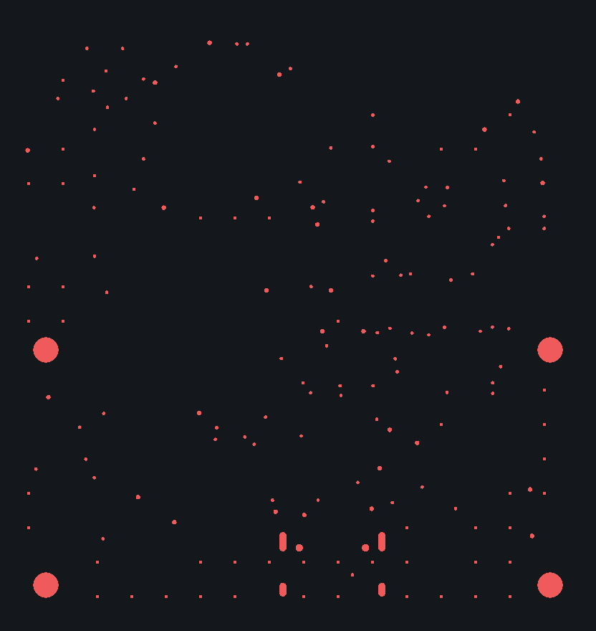
hardware/prototypes/picoquorum-key/tests/golden/Drill.png
