jmcpheron/pico-quorum/hardware/prototypes/picoquorum-key/tests/golden/Edge.png

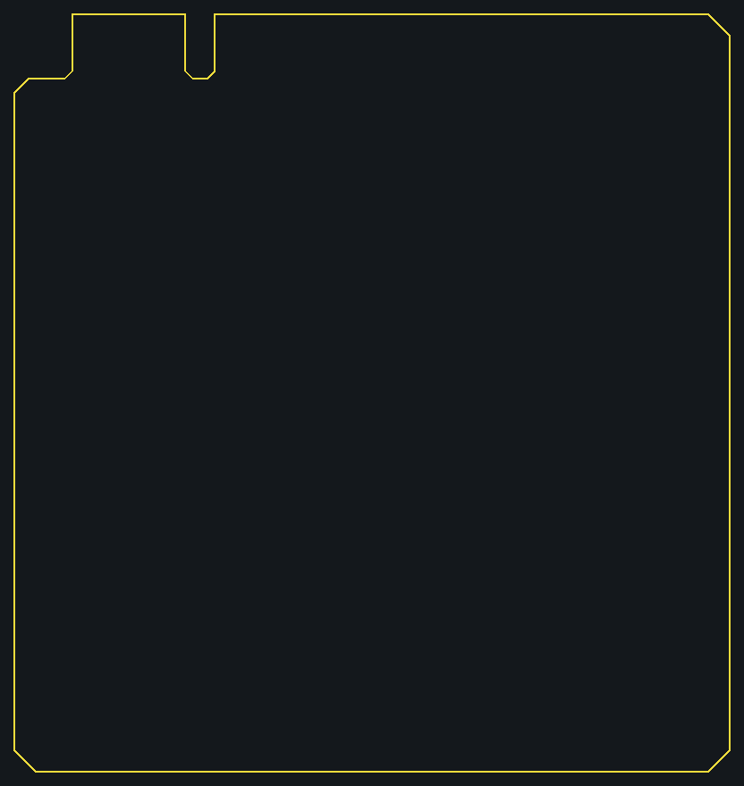
hardware/prototypes/picoquorum-key/tests/golden/Edge.png
