jmcpheron/pico-quorum/hardware/prototypes/picoquorum-key/tests/golden/F_Cu.png

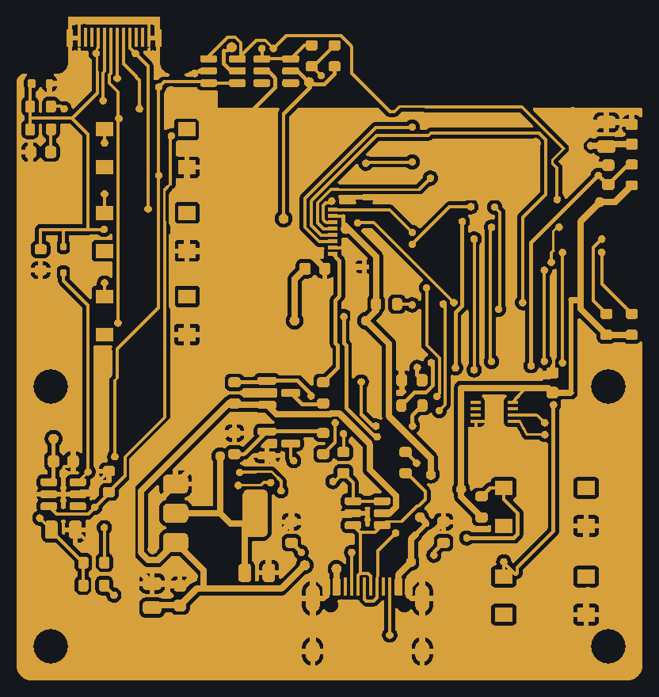
hardware/prototypes/picoquorum-key/tests/golden/F_Cu.png
