jmcpheron/pico-quorum/hardware/prototypes/picoquorum-key/tests/golden/F_Mask.png

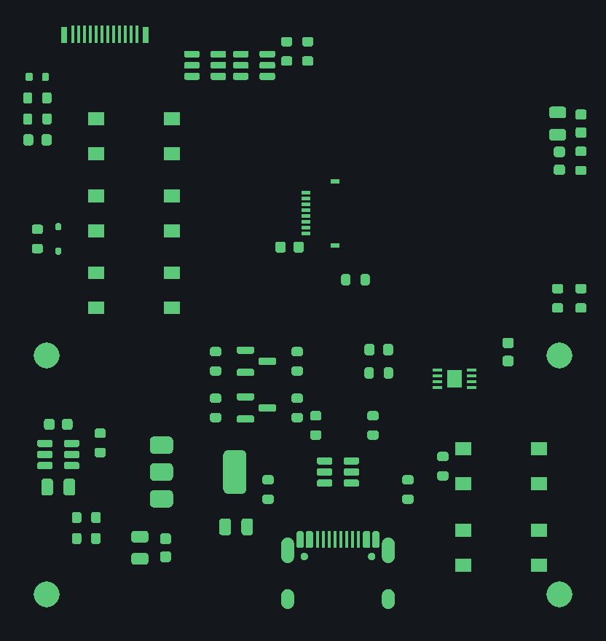
hardware/prototypes/picoquorum-key/tests/golden/F_Mask.png
