jmcpheron/pico-quorum/hardware/prototypes/picoquorum-key/tests/golden/F_Paste.png

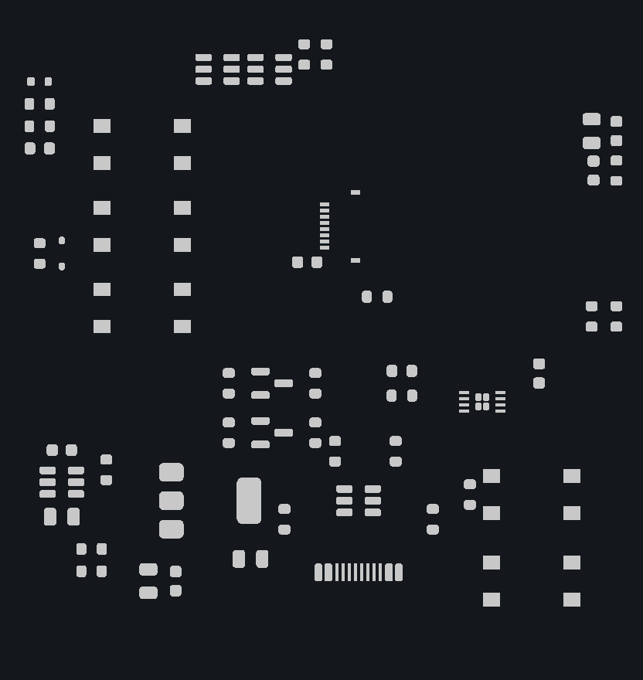
hardware/prototypes/picoquorum-key/tests/golden/F_Paste.png
