jmcpheron/pico-quorum/hardware/prototypes/picoquorum-key/tests/golden/F_Silk.png

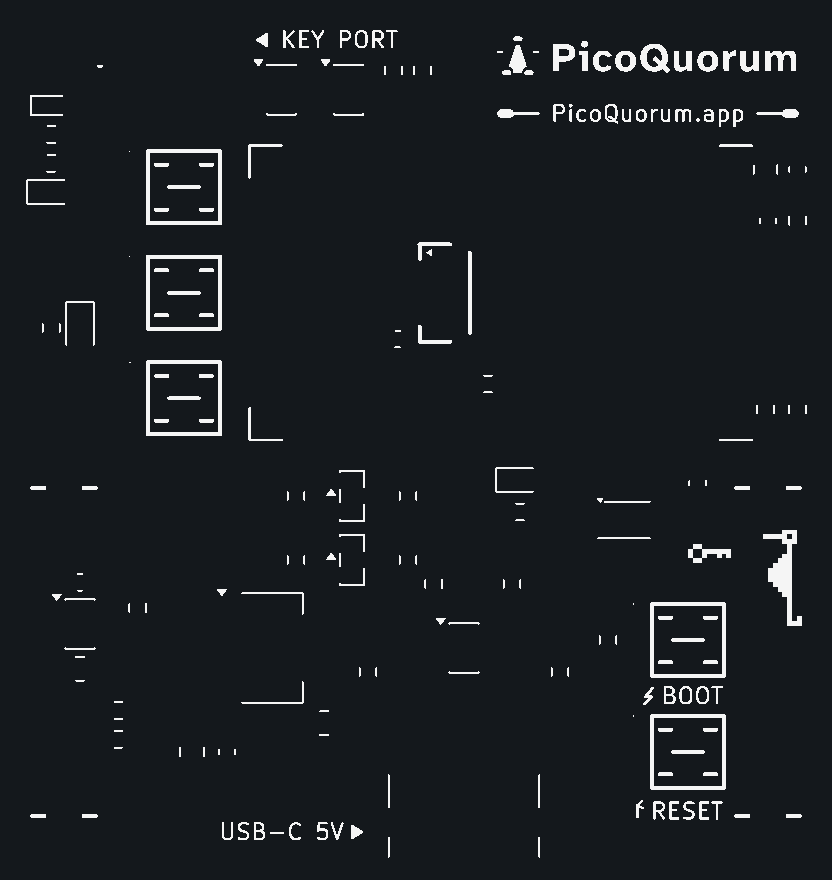
hardware/prototypes/picoquorum-key/tests/golden/F_Silk.png
