jmcpheron/pico-quorum/hardware/prototypes/picoquorum-key/tests/golden/render_bottom.png

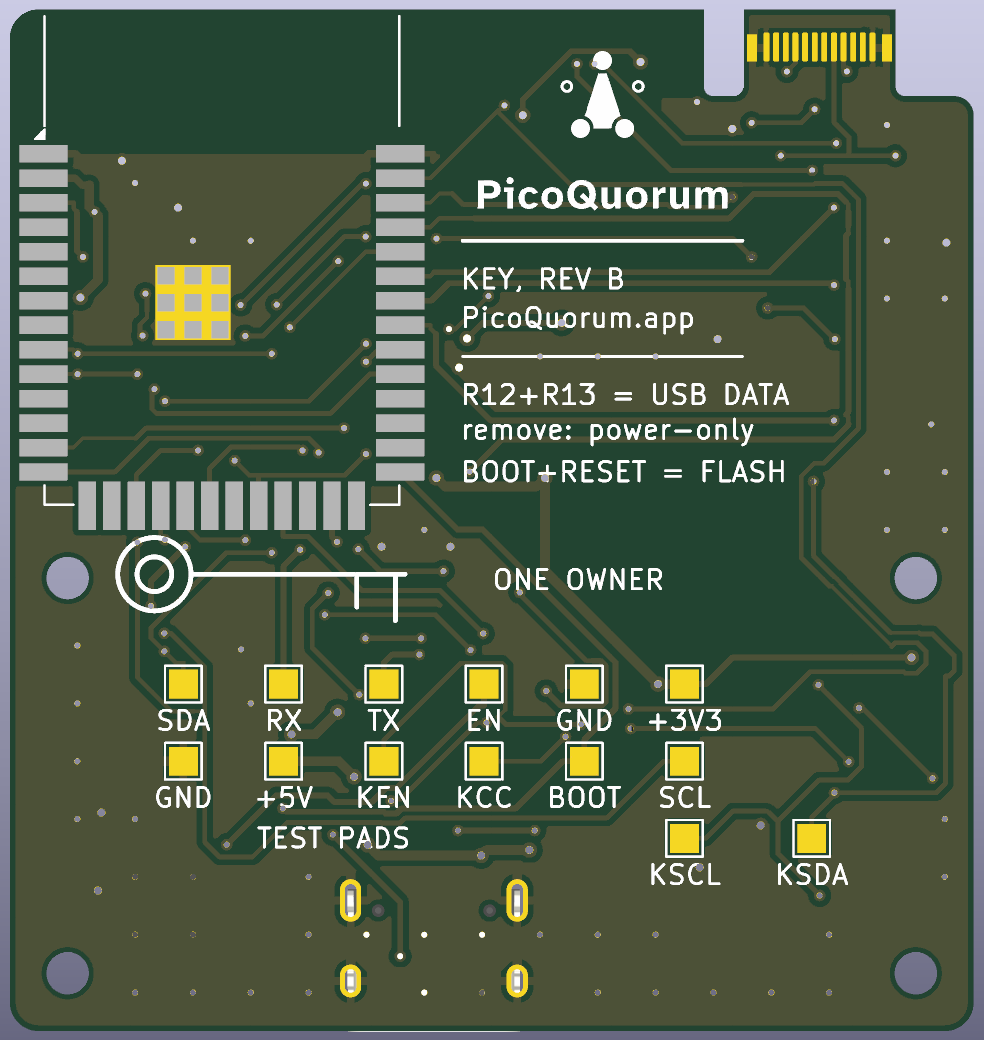
hardware/prototypes/picoquorum-key/tests/golden/render_bottom.png
