jmcpheron/pico-quorum/hardware/prototypes/picoquorum-key/tests/golden/render_top.png

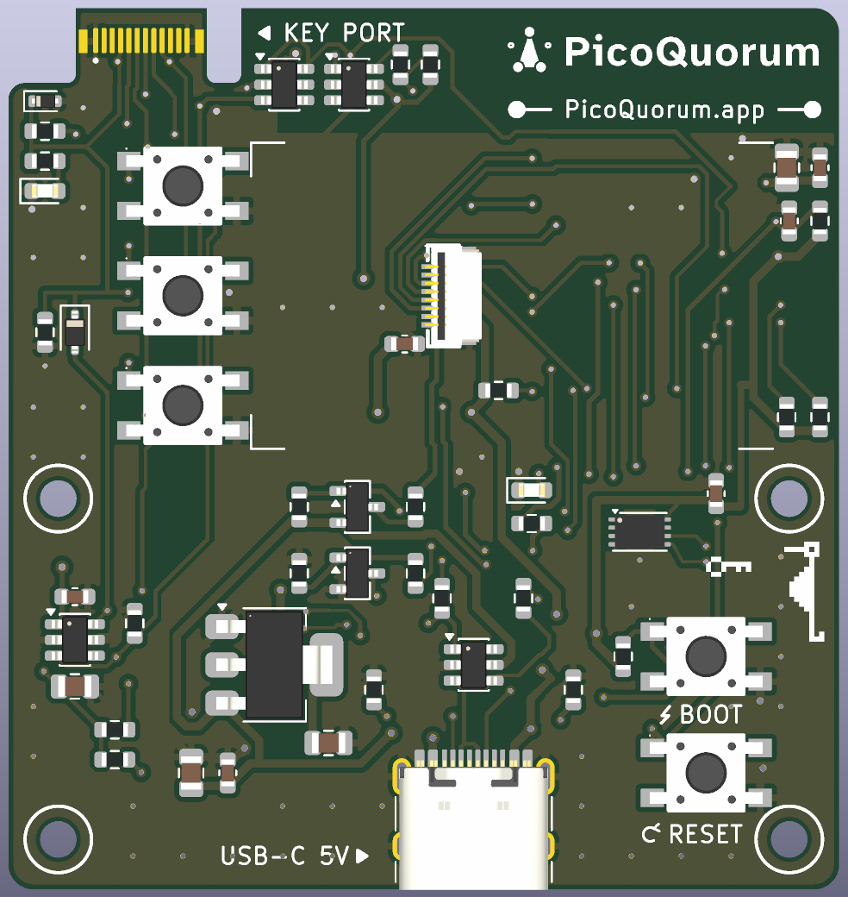
hardware/prototypes/picoquorum-key/tests/golden/render_top.png
