jmcpheron/pico-quorum/buildlog/BUILDLOG.md

# PicoQuorum build log

Dated notes and photos, mistakes included.

The log starts in the picowallet days. Austin Griffith's first entries (2026-09-05: the first build,
the chip on the wallet with no solder, the first mainnet transfer) are in
[picowallet's repository](https://github.com/austintgriffith/picowallet). The 2026-09-16 and
2026-09-17 entries below are Jason McPheron's work on that codebase, before it became PicoQuorum.
Older entries name files as they were that day; picowallet-only ones were removed on 2026-10-06 and
are in the git history.

## 2026-09-17 — the KEYS screen, a virtual chip, and a bug in the config table

No hardware in this session, all of it on the emulator, on branch
`claude/pico-wallet-signing-keys-uyr7mc` of the jmcpheron fork.

The wallet now knows the ATECC608 has 16 slots, not just slot 0. X on the home screen opens a
KEYS screen: the slot table as the config zone types it (P256 / PUB / AES / DATA), which slot
signs, NEW KEY in a slot, SHOW PUBLIC KEY, and the three permanent locks (config zone, data zone,
one slot) each behind a red hold-A screen and the `ALLOW_*` flags. `signer.py` has one shape for
the chip and the software key, active slot in `slot.txt`.

To test it without a chip, the emulator grew a virtual ATECC608 on I2C at 0x60 that speaks the
real packet protocol (wake token, `0x03` command packets, CRC-16), so `atecc.py` runs against it
unchanged. It starts as a blank part. `tools/emu chip fresh|ready|show`. Config lock, GenKey in
slots 0/2/7, a signature that verifies, slot lock and data-zone lock all walked through with
screenshots.

Bug of the day, and a bad one: `atecc.py`'s `CONFIG` was not the table the Pi wrote to chip #1.
It was the ATECC508 test table with an extra row of `0xFF` at bytes 96-111 and the last row
dropped. Those bytes are KeyConfig for slots 0-7, so every one of them decoded to "not an ECC
key". Locking a fresh chip with it (README step 5, the Setup page button) would have made slot 0
unable to ever hold a P-256 key, permanently. It never bit anyone because the lock path has never
run on a fresh chip. Fixed by copying the Pi's bytes; with the real table only slots 0, 2 and 7
are P-256 private keys, not 0-7 as the old handoff said. Notes for upstream in `docs/UPSTREAM.md`.

Also on the branch: `hardware/wiring/SOLDERING.md` with the perfboard wiring (chip on GP4/GP5/GND 8/3V3 36, an
18650 behind a switch and a Schottky into VSYS, 100k/100k divider to GP28 for a gauge),
`power.py` for the gauge, a read-only `chipcheck.py` report, `tools/usb` for deploying over USB
serial, and `docs/TESTPLAN.md` for the next session.

Lesson from the emulator: a top-level `raise SystemExit` in a module you `import` at the
MicroPython REPL soft-reboots the board. `chipcheck.py` runs inside a function now.

## 2026-09-16 — a fresh chip, read only

The perfboard build's first session with the chip: an Adafruit ATECC608 breakout (4314) on the
Pico's pin tails per `hardware/wiring/SOLDERING.md` (VIN 36, GND 8, SDA 6, SCL 7), the 18650 holder, switch,
Schottky and divider wired as well, no cell in the holder, USB only. Firmware: branch
`claude/pico-wallet-signing-keys-uyr7mc` with upstream `main` (`87c717c`) merged in first,
MicroPython v1.26.1 (2025-09-11), deployed with `tools/usb push` from the Mac on
`/dev/cu.usbmodem112301`.

Rule for today: `ALLOW_LOCK = False`, `ALLOW_GENKEY = False`. Nothing written to the chip.

**Before the flash.** Upstream had moved 21 commits past the branch point. The one that mattered
here is `261b373`: a reset straight after a copy lost writes on LittleFS (atecc.py landed at 3584
of 7021 bytes). `tools/usb push` did exactly that sequence, so it now soft-resets first, chains
every copy, calls `os.sync()`, and only then resets. The merge also brought the NO CHIP screen,
the secrets-less boot and demo/vid. Rehearsed on the emulator (blank virtual chip: home, KEYS,
chip page, chipcheck; provisioned: slot 0 ACTIVE), then a read-only I2C scan on the board before
copying anything: `['0x60']`, first try.

**First power, USB only.** The board was already up on the mock screens; after the push it came
back on the wallet's home screen: `X keys`, red dot, `no key`, WiFi joined (secrets.py with real
credentials, console off, app URL a placeholder so the log says `net: OSError(-2,)`). No
`error.log`. Every `.py` on the board matched its local size (`os.stat`). The serial port took
over 10 s to come back after the hard reset.

**What an untouched chip reports.** `tools/usb exec 'import wallet; wallet.stop()'` then
`tools/usb run firmware/chipcheck.py`, three times over the session (twice before the KEYS walk,
once after). The whole output, verbatim:

```
== picowallet chipcheck ==
i2c scan: ['0x60']
using address: 0x60
wake: ok (3 ms)
serial:   0123f3acfd2a826bee
revision: 00006002 (ATECC608A)
i2c address byte 16: 0xc0 (7-bit 0x60)
config zone: unlocked   data zone: unlocked   (byte 87 = 0x55, byte 86 = 0x55; 0x55 = unlocked, 0x00 = locked)
slot locked bytes 88-89: ff ff
raw config zone (128 bytes, 16 per row):
    0: 01 23 f3 ac 00 00 60 02 fd 2a 82 6b ee c1 55 00
   16: c0 00 00 00 83 20 87 20 8f 20 c4 8f 8f 8f 8f 8f
   32: 9f 8f af 8f 00 00 00 00 00 00 00 00 00 00 00 00
   48: 00 00 af 8f ff ff ff ff 00 00 00 00 ff ff ff ff
   64: 00 00 00 00 00 00 00 00 00 00 00 00 00 00 00 00
   80: 00 00 00 00 00 00 55 55 ff ff 00 00 00 00 00 00
   96: 33 00 33 00 33 00 1c 00 1c 00 1c 00 1c 00 1c 00
  112: 3c 00 3c 00 3c 00 3c 00 3c 00 3c 00 3c 00 1c 00
matches the reference table (bytes 16-83, 88-127): no
slot table as the chip has it:
  slot kind  ext-sign genkey privwrite pubinfo lockable locked  key
     0 P256  True     True   False     True    True     False   -
     1 P256  True     True   False     True    True     False   -
     2 P256  True     True   False     True    True     False   -
     3 DATA  False    False  False     False   False    False   -
     4 DATA  False    False  False     False   False    False   -
     5 DATA  False    False  False     False   False    False   -
     6 DATA  False    False  False     False   False    False   -
     7 DATA  False    False  False     False   False    False   -
     8 DATA  False    False  False     False   True     False   -
     9 DATA  False    False  False     False   True     False   -
    10 DATA  False    False  False     False   True     False   -
    11 DATA  False    False  False     False   True     False   -
    12 DATA  False    False  False     False   True     False   -
    13 DATA  False    False  False     False   True     False   -
    14 DATA  False    False  False     False   True     False   -
    15 DATA  False    False  False     False   False    False   -
random (32 bytes): ffff0000ffff0000ffff0000ffff0000ffff0000ffff0000ffff0000ffff0000
NOTE: config zone is unlocked. GenKey and Sign will refuse (status 0x0f) until it is locked; that is normal.
== end ==
```

Read off it:
- I2C scan found `['0x60']`, nothing else.
- Serial `0123f3acfd2a826bee`, revision `00006002` = 608A, address byte 16 `0xc0`.
- Config zone unlocked (byte 87 = 0x55), data zone unlocked (byte 86 = 0x55), SlotLocked `ff ff`.
- The factory slot table is not blank: SlotConfig `2083 2087 208f` and KeyConfig `0033` for slots
  0, 1, 2, so Microchip ships them as P-256 private keys, external sign, GenKey allowed; slots 3
  to 15 data, 8 to 14 lockable. `matches the reference table: no`, as expected.
- Random did NOT change between runs: `ffff0000` repeated. Datasheet behaviour before the config
  lock (a fixed test pattern). The test plan expected it to differ; corrected.
- Second and third runs: serial, config and random byte-identical (only the wake time moved, 3 to
  4 ms).

This is the "as shipped" state.

**The KEYS screen on the real chip.** X: header `KEYS atecc608 cfg OPEN`, rows 0 to 2 `P256`, the
rest `DATA` (the emulator's blank part shows `-` everywhere; its fresh table should be these
factory bytes). X again: the chip page, `i2c 0x60`, the serial, `rev 00006002 608A`, `permanent
actions off`, `config zone OPEN`. Cursor on `WRITE + LOCK CONFIG (off)`, A: the red ERROR naming
ALLOW_LOCK, nothing changed. RAW CONFIG ZONE agreed with the dump, row 80 ended `55 55`. RANDOM
twice: `ffff0000...` both times, as above. Slot 0: `P256` with the `(off)` item. Chipcheck after
the walk: byte 87 still `0x55`.

**Timings.** Wake 3 to 4 ms; the whole chipcheck (config read, slot decode, random) well under a
second. Nothing flaky over the session.

**Battery** (wired, cell out, switch off): `power.status()` said `usb: True` via `WL_GPIO2`, and
`vbat: 1.08` where 0 was expected. With the switch off the divider's top is open, so the volt at
GP28 is most likely the Schottky's reverse leakage from VSYS through the divider. The home screen
showed an empty bar and `1.1V` instead of `usb`. Fixed in `power.py`: anything under 2.5 V counts
as no cell (a protected 18650 cuts off near 2.5 V, and the Pico's regulator quits before that).

Decisions today:
- Locking waits. The app side (vault deployment, recovery address) is not planned yet, and the key
  made at lock time is the one the next vault gets.
- The perfboard layout stays; the chip answered first try.

Gotchas:
- A hard reset drops the USB port for over 10 s; anything scripted must wait for
  `/dev/cu.usbmodem*` before the next mpremote call.
- Random before the lock is a fixed pattern, and the factory table already types slots 0 to 2 as
  P-256: two things the emulator's chip model does not do. Both in `docs/UPSTREAM.md` for `atecc_sim.py`.

Not done today, on purpose: config lock, GenKey, data-zone lock, slot lock. The chip leaves this
session exactly as it arrived. Not done for lack of a cell: TESTPLAN phase 5. Next: the battery
phase when a cell is here; `docs/TESTPLAN.md` phase 6 when the vault deployment is planned.

## 2026-09-17 — the map, the ceremony, and the chip is sealed

The chip UI grew a look: the map is the die itself, drawn as a floor plan with the CONFIG strip,
the 4x4 field of slots coloured by kind, OTP, COUNTERS and the LAB docked below; DATA is a grid
of tiles; menus carry class badges; headers are tinted by zone; 25 sixteen-pixel icons, a palette
in `theme.py`; the boot screen got a navy gradient and a rainbow leg chase. Icons are packed from
ASCII art at import (the first draw of a screen paid 8 ms per icon before that). On the panel a
`show()` is 46 ms and the busiest screen draws in about 70 ms. Two new actions: SIGN TEST on a key
slot (sign, verify on the Pico, read counter 0) and WRITE A NOTE on a clear data slot. Two guards
before the lock: `CONFIG` is checked at import for a P-256 slot 0, and `lock_config()` reads the
zone back and refuses unless the table matches and slot 0 decodes right. `docs/CHIPMAP.md` has it all.

Then the finale on the one chip, flags flipped in `secrets.py` and pushed. Jason at the device,
me reading the chip from the laptop between steps:

- WRITE WALLET CONFIG (the chip had been restored to its original bytes earlier): 49 bytes
  changed, read back identical, config still open. chipcheck: `matches the reference table: yes`.
- Hold B+Y, `! LOCK CONFIG FOREVER`, hold A three seconds: the CONFIG strip pulsed, a flash, the
  padlock closed, RULES SEALED ("the cool sealed animation"). chipcheck: byte 87 = `0x00`, slots
  0/2/7 `P256 empty`. Random live: two different 32-byte values. SelfTest all pass.
- OTP from the map: NOT ALLOWED, status 0x0F. Not a bug on our side of the wire: with the config
  zone locked and the data zone still open the chip accepts clear writes into slots and OTP but
  reads nothing back until the data zone is locked too. Every Data and OTP read refused, clear and
  secret slots alike. Neither the firmware nor the emulator knew; both do now (write-only state on
  the map, the reason on the refusal screen, the note reports "read back after data lock").
- NEW KEY in slot 0: KEY CREATED, `a427c739`. Then Jason unplugged USB, ran the wallet on the
  18650 and made another key on battery; back on USB, rebooted, a third: `cc01b14a`. Counters 0
  and 0 throughout, which is right: GenKey does not spend a count, signing does.
- The control experiment for upstream: GenKey on slot 3 (KeyType 7 but GenKey allowed by its
  SlotConfig, the shape of every slot 0-7 in upstream's table) refused with 0x0F; slot 0 untouched.
- One rewrite while it happened: the red screen now leads with what is LOST (the key being
  replaced and its fingerprint, in red; "nothing, the slot is empty" otherwise; for the locks, the
  abilities that go away).

Decisions today:
- Slot 0 stays replaceable; LOCK SLOT waits for a vault deployed with it.
- The data zone stays open; the note in slot 12 and the OTP wait for that decision.
- Slot 7 is where a brought key would go (PrivWrite, encrypted against the write-only secret in
  slot 4); a seed phrase via SLIP-10 nist256p1 is the idea. Not built.
- The upstream issue has its silicon evidence now (docs/UPSTREAM.md section 1 and the draft at the end).

Gotchas:
- My checkpoint script ended with a reset and rebooted the wallet under Jason's hands. Pause the
  timer (`wallet.stop()`), read, `wallet.start_timer()`: the screen stays where it was.
- The plan said slot 8 was 416 bytes of clear data. Under the wallet config it is secret (write
  never, read never in clear); the clear ones are 12 and 13.
- Reads of Data and OTP need the data lock, not just the config lock.

Later the same evening: the red screen's doomed key went cyan at double size, the one thing on
that screen that is not red ("this is the unique thing that's going to be deleted"). Jason made
a fourth key with it (`9fad2e82`), then SIGN TEST twice: SIGNATURE VERIFIED both times and counter 0
went 1, 2, on the screen and from the laptop. `docs/UPSTREAM-ISSUE.md` is the short version for Austin.

Not done today, on purpose: LOCK SLOT 0, LOCK DATA ZONE, PrivWrite, the note in slot 12, slot 2.
Flags back to False and pushed.

## 2026-09-24 — the Safe console on the Pico: the chip approves its first Safe transactions

The PicoQuorum console (branch `quorum-ui`) ran on the real board for the first time. Its code is
`firmware/quorum.py`, `quorum_ui.py`, `decode.py` and `txservice.py`, with the new
anti-aliased fonts. On the other end was `tools/quorum`, a simulated 2-of-3 Safe on the Mac:
Family Safe, chain 31337, at `192.168.4.25:8787`, with Alice and Bob as simulated co-signers.
Screens and flows are in `docs/quorum-ui/README.md`.

**The board as found:**
- MicroPython 1.26.1 (`RPI_PICO2_W`), `main.py` = the WiFi wallet.
- Chip: config locked, data zone open, key in slot 0 = `9fad2e82`, unchanged since 09-17.
- Heap is 457 KB in all:

  | Loaded | Free |
  |---|---|
  | after boot (boot.py had already drawn the splash, so the framebuffer was in) | 300 KB |
  | with `wallet` imported | 198 KB |
  | with the boot animations' fonts and drawing code | 206 KB |

  That's room enough for the console.

**What changed on the board:**
- Backed up `main.py`, `slot.txt`, `snake.hi`/`snake.top` and the config snapshot.
- Appended `QUORUM_URL = "http://192.168.4.25:8787"` to `secrets.py`; nothing else in it touched.
- `tools/emu ship bootfx`, then `tools/emu ship quorum`. Both are one-off runs; `main.py` was not
  changed.
- Newer `net.py` and `splash.py` came along. They're still compatible with the old wallet.

**The boot screen options** (`emu/sketches/bootfx.py`, GIFs in `docs/quorum-ui/boot/`), timed on
the chip:

| Option | Average frame | Worst frame |
|---|---|---|
| quorum | 54 ms | 81 ms |
| plug in | 61 ms | 97 ms |
| checklist | 67 ms | 84 ms |
| hash rain | 115 ms | 150 ms |

`show()` alone is 46 ms of every frame, so the push to the panel, not the drawing, sets the
pace. Hash rain runs at about half its GIF's speed.

**The session.** The Pico joined WiFi, announced its P-256 key and became the Safe's third
owner (stand-in owner address `0x3EC9…74A7`). Jason at the device, times PDT:

| Time | # | Transaction | On the Pico | The Safe |
|---|---|---|---|---|
| 20:33 | 0 | Alice: 0.05 ETH to Carol | rejected (Y), reopened, held A 2 s | P-256 verified, low s, 2 of 2, executed |
| 20:34 | 1 | Alice: batch via Safe MultiSend (0.01 ETH, 100 USDC) | signed | verified, executed |
| 20:34 | 3 | Bob: add a stranger as an owner (red) | rejected | still 1 of 2 |
| 20:34 | 2 | Alice: approve 500 USDC to Uniswap Permit2 | signed | verified, executed; nonce now 3 |
| — | 4 | The service lies about the hash | refused on the device | nothing ever posted |
| 20:35 | 5 | Bob: call an unknown contract (red) | rejected | still 1 of 2 |

Every signature came from the ATECC608, over a hash the Pico computed itself from the fields it
showed. The Mac checked each one independently: viem's hash, and `@noble/curves` P-256 against
the key the Pico announced. The lying transaction never got a signature. Had the Pico signed the
hash the service reported, the mock would have logged it as blind signing.

Decisions today:
- `main.py` stays the wallet for now; the console runs one-off until it's chosen as the boot app.
- `QUORUM_URL` stays in the board's `secrets.py`.

Gotchas:
- A rejection on the console isn't a rejection on the Safe. #3 (the owner change) now blocks the
  queue at nonce 3, so #4 and #5 could never execute until #3 is signed or replaced by an on-chain
  rejection. That's iteration 1's open question about what Y should do, now shown on hardware.
- The mock server had been started before the day's changes (new names, the Uniswap scenarios,
  the Safe version), so it answered with old code. Restart `tools/quorum serve` after editing
  `tools/mock-tx-service/`.
- `tools/emu ship quorum` reports "blocking loop" because `quorum.start()` joins WiFi for up to
  12 s before returning. The console was fine; it just outlasted ship's short watch.

Not done today, on purpose: making `quorum` the boot app (`main.py`), any lock on the chip, the
on-chain rejection, and a real chain.

## 2026-09-25 — the chip, read before deciding on any lock

A read-only look at the one chip (`0123f3acfd2a826bee`) before any more locks. The analysis and
the decision are in [docs/LOCKING.md](../docs/LOCKING.md).

**What I did to the board:** the console's timer was paused around each read and restarted, and
the screen stayed where it was. Nothing was written. The reads were the config zone, the lock
bytes, both counters, and each P-256 slot's public key (GenKey in public mode).

**What the chip holds:**
- The config zone has been locked since 09-17. The data zone is open and no slot is locked.
- The config matches the wallet table exactly. Byte 52 differs only because it is counter 0,
  which reads 7. That table turned out to be cryptoauthlib's `test_ecc608_configdata`.
- Keys: slot 0 `9fad2e82…` (lockable, LimitedUse), slot 2 `82004df5…` (not lockable), slot 7
  empty.
- Config byte 18 = `0xA1`: the 608A's CountMatch is on, with its limit in slot 10, which was never
  written.

**Checked onchain, free and read only:**
- The owner addresses the console computes, `0x2843…5E53` for slot 0 and `0x3ca6…594F` for slot 2,
  equal the passkey factory's `getSigner` on Base Sepolia, Base and Ethereum.
- Slot 2 signed the WebAuthn digest of a test safeTxHash. `isValidSignatureForSigner` answered
  `0x1626ba7e` on all three chains, for both the high-s signature as the chip made it and the
  low-s one. A wrong-hash control answered `0x00000000`. Counter 0 didn't move.

Gotchas:
- A data-zone lock would make slot 10's unknown bytes the permanent cap on slot 0's signatures,
  unless slot 10 is written first.
- While the data zone is open, a plaintext PrivWrite can put a known key into any private slot.
  Only a slot lock stops that.

## 2026-09-25 — rung 1 on the real Pico: the chip's approval executes on a real Safe

The console with layer 3 (`firmware/webauthn.py`) went on the board with `tools/emu ship quorum`,
and `main.py` wasn't touched. Behind it, `tools/quorum up` ran a real Safe 1.4.1 on an Anvil fork
of Base (chain 31337, block 51760581): the Family Safe at `0xf77e…7666`.

**The run:**
- The Pico announced key `9fad2e82…` (slot 0). The laptop computed its signer proxy `0x2843…5E53`,
  the board computed the same address itself, and the passkey factory's `getSigner` agreed.
- The factory deployed the proxy on the fork and it became the third owner (2 of 3).
- `tools/quorum demo` queued the stories. Jason opened **#0 Send 0.05 ETH** (Alice had signed) and
  held A.
  - The console posted a WebAuthn contract signature.
  - The service checked it with the proxy's own `isValidSignature`.
  - The Safe executed it: `execTransaction` in 109,488 gas, nonce 0 → 1.
- The same slot 0 signature, checked against the real deployed signer on Base Sepolia, Base and
  Ethereum with `isValidSignatureForSigner`, answered `0x1626ba7e` on all three. The s value was
  low. Counter 0 went 7 → 8. Nothing locked.

**Bug of the day:** the first attempt failed on memory, not on the chain. Jason had toured the chip
map (the lock ceremony, the key's QR). After that, the console's biggest font (`qf_bold26.bin`,
one 10.9 KB block, loaded on first use) no longer fit in the fragmented heap, and every redraw of
a review page raised `MemoryError`.
- The screen stopped updating, and #0 got rejected twice from a console that couldn't draw. The
  rejects were console-only and never reached the Safe.
- Fixed now by a fresh start plus loading both big fonts by hand. Fixed for good by `quorum.start()`
  loading every font while the heap is whole.

Gotchas:
- The demo queue on the fork looks exactly like the simulated one, on purpose. The tells are the
  Safe's address (`0xf77e…7666`), "This key" on the owners page, and the dashboard's "a real Safe
  on the Anvil fork of Base".
- The console fetches only from its home screen; on the chip map it doesn't poll.

## 2026-09-25 — rung 2: the chip's approval on Base Sepolia, accepted by Safe's own service

**Setup:**
- Jason's MetaMask (`0x61D2…637F`, Base Sepolia ETH from a faucet) paid for two `createSigner`
  calls through `tools/quorum live enroll`: the emulator's key (`0xaA87…77b3`) and the Pico's slot 0
  (`0x2843…5E53`).
- In the Safe web app he made a 2-of-3 Safe with those three owners: `0xEDEDC0063B23A309f4cAdA5e1225Ef21D8A30a43`.
  It's Safe 1.5.0 L2, and its code and fallback handler match safe-deployments.
- The Safe API key is in the repo's gitignored `.env`. With it the service allows 50,000 requests
  a month, against 5,000 without.

**Rehearsal: the emulator.**
- Jason proposed #0 (0.0001 ETH) in the web app and signed it with MetaMask.
- `live rehearse` ran the console on the emulator against api.safe.global. It showed #0, signed it,
  and the service took the contract signature: 2 of 2.
- `live exec` sent `execTransaction` through MetaMask:
  [tx](https://sepolia.basescan.org/tx/0x1b2adb3e8a860ab0c8802aaa4af48a13260b4b42749a9e53a135e846d4f370d8).
  - The trace: the Safe's part was 105,584 gas, with the P-256 precompile (3,450) doing the check.
  - The rest of the 270k was MetaMask. Jason's account is an EIP-7702 smart account (MetaMask's
    DeleGator), so MetaMask relayed the call through its DelegationManager with fee hooks.

**The real Pico:**
- Two memory fixes first:
  - The chip map now loads only on X. At start it had left no block over 8 KB, and TLS failed with
    OSError 12.
  - An HTTPS reserve.
- The console then read the Safe straight from api.safe.global.
- Jason proposed #1 and the Pico showed it with the hash verified. He held A and the chip signed in
  155 ms, but the POST failed with OSError 12: after the review the heap was in pieces again (154 KB
  free, nothing over 8 KB).
- The console kept the signature. It was copied off the board and checked against the Pico's proxy
  on Base Sepolia (`isValidSignature` = `0x1626ba7e`), then posted unchanged from the laptop. The
  service answered **201**.
- `live exec`: [tx](https://sepolia.basescan.org/tx/0xe719116d86a019098679ba9b7d5e5263fed8c6fc4cd7181f573b4b3fa3860fde),
  `ExecutionSuccess`, nonce 2.
- That completes the slot 0 checklist's last gate before the lock (docs/LOCKING.md).

**Fixes on the board for the Pico's own POST:**
- `txservice.py` holds a 32 KB block from the start and frees it only during each HTTPS call.
- HTTPS calls get a 15 s timeout: a full TLS handshake on the Pico takes 1–2 s, sometimes more than
  the LAN's 5 s.

Gotchas:
- The Safe web app with a 1.5.0 Safe: the version pill `Safe v1.5.0+L2` runs into "Synced" on the
  console's home screen. Cosmetic.
- MicroPython doesn't flush a file until it is closed. A one-line `open(...).write(...)` backup came
  out 0 bytes.

**Later the same evening: the Pico alone.** With the reserve and the 15 s timeout, every poll in a
three-minute watch succeeded. Jason proposed #2 (0.000067 ETH back to his MetaMask). The Pico
fetched it from api.safe.global, showed it, and signed after the hold (154 ms). It posted the
confirmation itself (`confirmed #2`), and `live exec` executed it:
[tx](https://sepolia.basescan.org/tx/0xa046bd0c4289c9c8e75bb75aca40b6a09afea4c5f446f80e24c5fb6a393d9daf),
Safe nonce 3. Counter 0: 13. Slot 0 still `9fad2e82…`, unlocked.

## 2026-09-25 — slot 0 sealed

The last gate in docs/LOCKING.md was rung 2, now passed, so Jason locked slot 0 on the board.
- Before: `ALLOW_GENKEY` was set to False, because NEW KEY sits beside LOCK SLOT in slot 0's menu.
- The lock: X → DATA → slot 0 → `! LOCK SLOT FOREVER`, armed with B+Y, hold A. **KEY SEALED.**

**Checked from the laptop right after:**
- SlotLocked bytes 88–89 = `fe ff`: slot 0 locked, the others open. The config zone is still
  locked, and the data zone is still open by design (CountMatch in slot 10 stays unsprung).
- The public key read back byte for byte as the enrolled one. The sealed key is Safe owner
  `0x2843705391b7E2cf06b0b964b532Ad9891535E53` on every chain.
- The chip still signs. A new WebAuthn signature (counter 13 → 14) passed the passkey factory's
  `isValidSignatureForSigner` on Base Sepolia, Base and Ethereum, and the deployed proxy's own
  `isValidSignature` on Base Sepolia.
- `ALLOW_LOCK` and `ALLOW_GENKEY` are both back to False on the board.

Not done on purpose: asking the chip for a NEW KEY on slot 0 to watch it refuse. If the lock had
not taken, that test would have replaced the key.

## 2026-09-26 — the production console, and quorum v1 for fresh chips

Branch `firmware-production`. The walkthrough with every new screen is in
[docs/firmware-production/](../docs/firmware-production/).

**The console image.**
- `firmware/manifest.json` lists exactly what goes on the board. `main_console.py` boots straight
  into the console, and B at power-up gives maintenance.
- The legacy wallet, the USB wallet, the demos and the chip map are out of the image.
- In this image:
  - `QUORUM_EXPECT` pins the chip, slot and owner, checked at start and before each signature.
  - Counter 0 is shown and checked for signatures made outside the console.
  - A delegatecall to a contract that isn't pinned is refused.
  - HTTPS checks the certificate against three pinned roots.
  - There is a deadline watchdog, `log.txt`, and a crashed state.
  - The `ALLOW_*` flags, the software key and the WiFi REPL are ignored.
- `tools/fw` builds, backs up, pushes, verifies, pins and restores, checking every hash.

**Quorum v1** is PicoQuorum's own ATECC608 table ([docs/PROVISIONING.md](../docs/PROVISIONING.md)).
- Slot 0 is the only key: external Sign only, LimitedUse, no PrivWrite, sealed after GenKey.
- Slots 1-15 are dead, CountMatch is off, and there is no IO protection.
- Both zone locks carry the CRC the chip checks.
- The ceremony (C1-C10) runs on the virtual chip, on a 608A and a 608B, with a reboot after every
  step.

**Mistakes:**
- The first `tools/fw backup` read files over `mpremote resume` while the board's console was
  running. Something the console printed landed inside the transfer: mpremote failed to parse
  `atecc.py`'s bytes, and a minute later the Pico's USB serial stopped answering, even to a raw
  write. It needs a replug. Nothing was written to the board. `tools/fw` now pauses whatever app
  runs (and holds the watchdog off) while it reads, then resumes it.
- `atecc.decode_slot` had decoded WriteConfig wrong since the fork: `wc >> 1` indexing is right only
  for `0000`. The chip map labelled slot 0 "pubinvalid" when it is "never". Only `== "clear"` was
  ever acted on, so nothing wrong was done with it.
- MicroPython strings have no `ljust`. The OTP record would have raised at C8 on the board; the
  ceremony's dry run caught it.

**On the board, 2026-09-26, nothing written to flash:**
- **Backup:** `tools/fw backup` got 52 files, every hash checked, with the wallet paused while
  reading. `verify --baseline` read chip #1 as expected:
  - `0123f3acfd2a826bee`, 608A
  - key `9fad2e82…`, owner `0x2843…5E53`, computed on the laptop
  - lock bytes `55 00 fe ff`
  - counter 0 = 16: 14 at the seal, +1 the Base mainnet GS021 confirmation, +1 not yet accounted for
- **TLS hazard confirmed:** plain `requests` on the board accepted `self-signed.badssl.com`.
- **Dates are checked:** before NTP the board's clock said 2021 and a verified call was refused
  ("validity starts in the future").
- **The console image compiled on the Pico failed to start.** It was run from `mpremote mount`, so
  nothing went to flash. It had 191 KB free, but no block over 5.7 KB, and a 5.8 KB font would not
  load. Compiling modules on the device leaves the heap in pieces.
- **The fix:**
  - `tools/fw build` now compiles every module but `boot.py` and `main.py` with mpy-cross 1.26.1
    (`.mpy` v6.3, the board's own).
  - `main_console.py` loads the fonts and the HTTPS reserve before anything else.
- **The same image, compiled, from the mount:**
  - It starts. Not pinned (no `QUORUM_EXPECT` in the test file), TLS mode `verified`.
  - 8 of 8 verified polls to api.safe.global, 0.8–1.0 s typically, 7 s at worst.
  - 114 KB free after polling, largest block 10.7 KB, the 32 KB reserve back after every call.
  - badssl.com refused on the certificate itself: expired, wrong host (CN mismatch), self-signed,
    untrusted root.

**The production console on the board, 2026-09-26.**
- **Pin:** `tools/fw pin` read chip #1 and computed owner `0x2843…5E53` on the laptop, equal to
  the enrolled one (live.json), then wrote `QUORUM_EXPECT`.
- **Push:** `tools/fw push console` (build `20464b0`) took a fresh backup, copied 28 files
  (compiled `.mpy`, `main.py`, the roots, `build.py`), deleted the 36 legacy files, and checked
  every hash.
- **Mistake:** the push's "is it back?" probe right after the reset sent Ctrl-C (every mpremote
  command does) while `main.py` was still starting. `quorum` never finished importing, so the
  console never started (it left no log, and no watchdog was running).
  - Fixed: after a reset, `tools/fw` waits for the port and then leaves the board alone for 30 s.
  - `tools/fw restart` does that plus `verify`.
  - The flag read now executes the file itself, instead of a `secrets` module the running app had
    imported before the pin was written.
- **After the restart:**
  - home on the Base Safe, pinned, watchdog on
  - TLS `verified`, connected, this key an owner
  - counter 16 (first look), 67 KB free
- **The queue:** #0 "Send 0.000001 ETH", 2 of 2, signed by this key. That is the GS021 evidence
  transaction, still waiting for `live exec`.
- **Log:** boot, pin ok, counter, watchdog on. The reset cause is 3 even for `machine.reset()`: on
  the RP2350 it goes through the watchdog.

**The production console's first real approval, Base Sepolia, 2026-09-26.**
- **Watchdog:** interrupts off for 12 s over USB. The board reset itself, and the console came back
  by itself (a second boot in `log.txt`: pin ok, watchdog on).
- **Approval:**
  1. `live pico --chain basesep`, then Jason proposed #4 (0.0000067 ETH) in the Safe web app and
     signed with MetaMask.
  2. The Pico fetched it over verified TLS. Jason paged through and held A. The log says
     `signed #4 … counter 17`, `confirmed #4`, with real timestamps now that NTP has set the clock.
  3. `live exec` checked both confirmations onchain and executed:
     [tx](https://sepolia.basescan.org/tx/0x52c6d35fd2dde9b63fe65a7de4b9df2016de0551b178d19a4ae0fc20d170cd1b).
     The Safe's nonce is 5.
- **Back to Base:** `live pico --chain base`. `tools/fw verify`: pinned, TLS verified, watchdog on,
  counter 17, all flags off.
- **Small fix:** `live pico` piled up its own comment line on every switch.
- **Power cycle** (Jason unplugged and replugged it). Reset cause 1 (power-on). The console came
  up by itself in 7 s: pin ok, watchdog on, home on the Base Safe, TLS verified, counter still 17,
  so nothing was signed outside the console.

## 2026-09-26 — chip 2 (`01230e6b8fa23e70ee`): quorum v1 on silicon

The first of five new Adafruit 4314 breakouts. It's also the first run of the three details only
silicon can settle (docs/PROVISIONING.md): the byte order of the CRC summary, the data-CRC layout,
and 4-byte writes into the secret slots' tails.

**Setup:**
- The dual image (build `814299d`) boots chip 1 into the Base console, and this chip into the
  ceremony: `chips.json` has it as chip 2, factory, light.
- `tools/fw allow on` refuses while the pinned chip is on the bus. It was run with chip 2 in, then
  `tools/fw restart`.

**Just before, with chip 1:** Base mainnet #0, the GS021 transaction (0.000001 ETH, confirmed by
MetaMask and chip 1), executed with `live exec`:
[tx](https://basescan.org/tx/0x1b682d376629601808c21cf52cbaddb6e17f57779ef1affd81222c50f1262abb).
The Safe's nonce is 1.

**C1-C3 on chip 2:**
- **C1:** all 8 checks passed, including SelfTest on an unlocked chip (not seen on silicon
  before). The factory table matches the known Adafruit dump except the serial and read-only byte
  14. It is an ATECC608A (`6002`). Snapshot saved.
- **C2:** the laptop computed config CRC `2232` from the pulled snapshot
  (`tools/check_config --summary`). The Pico showed `2232` after writing quorum v1.
- **C3:** the CRC-checked config lock (mode `0x00`, summary `2232`) was **accepted by the chip**.
  That settles the summary's byte order (`crc[0] | crc[1] << 8`) on silicon. Read from the
  laptop: lock bytes `55 00`, still quorum v1, Random live.
- **UI:** the first arm showed no feedback while B+Y were held, so a bar was added, plus "let go
  early: not armed" (build `d7c3493`).
- **C4:** GenKey made key `e199b2d7…` in slot 0; KeyValid, the public key reads back, GenKey on
  slot 1 refused. The owner was computed on the laptop and confirmed by the passkey factory's
  `getSigner` on Base and Base Sepolia: `0x99eDACCAd92537B9146dD0804635bC6dEF7f6b88`.
- **C5:** a plain digest and a WebAuthn assertion both signed and verified on the Pico; Sign on
  slot 1 refused.
- **C6:** slot 0 sealed, SlotLocked `fe ff`, the same key read back. Counter 0 = 4: C5's two test
  signatures, plus one before and one after the seal.
- **UI:** B+Y arm in either order, and a full bar waits for the let-go (build `2eaca51`).
- **C7:** the Pico showed `0x99edaccad92537b9146dd0804635bc6def7f6b88`, the same as the laptop
  and the factory.
- **C8 stopped: the third unknown, settled on silicon.** Before the data lock, the chip refuses
  4-byte writes (`0x0F`) into these secret, never-write slots. It accepts 32-byte writes, including
  one that starts at a slot's last, partial block (bytes 32-35 of slots 1-7, bytes 64-71 of slots
  9-15), presumably keeping the bytes that fit.
  - Probed from the laptop with zeros only, the same bytes C8 writes. The OTP zone was not touched:
    C8 stops before the record.
  - Fix: C8 writes whole 32-byte blocks, the last one at the tail. The virtual chip now refuses
    4-byte writes into those slots before the data lock, as this chip does. The data-CRC lock
    at C9 checks that the tails really hold zeros, and refuses (locking nothing) if not.
- **C8 (again), with the tail fix:** all green, data CRC `b10e`.
- **C9:** the CRC-checked data lock (mode `0x01`, summary `b10e`) was **accepted by the chip**.
  Lock bytes `00 00`. That settles the last two silicon questions: the tails took the zeros, and
  the data CRC is every slot that is not a private key, then the OTP zone. The laptop recomputed
  `b10e` from the record independently.
- **The OTP record:** quorum v1, `01230e6b8fa23e70ee`, slot 0, owner `0x99ed…6b88`, 2026-09-26
  05:46:37 UTC, build `c5226e9`, counter 4. Its key hash matches `e199b2d7…`.
- **Every silicon unknown from PROVISIONING.md is now answered.**
  - The config CRC summary's byte order: `crc[0] | crc[1] << 8`.
  - The data CRC's layout: as documented.
  - 4-byte writes into secret slots before the data lock: refused. A 32-byte write at a slot's
    partial last block works instead.
  - Chips 3-5 get the same ceremony (build `c5226e9` or later), with no probing.
- **C10:** sealed. Counter 0 read 7, where the ceremony's signatures account for 5. After a restart
  with nothing signed, it read 8.
  - **Found:** on this chip, once the data zone is locked, a public-key read (GenKey mode 0) counts
    as a use of the LimitedUse key. Tested directly: counter 8, one public-key read, 9; Info
    KeyValid, still 9. Chip 1 (data zone open) never counted them, and the datasheet reading in
    PROVISIONING.md said GenKey ignores LimitedUse. Every extra count came from the ceremony and
    console re-reading the key.
  - **Fix:** the console takes the count before it reads the key, both at boot and before
    signing. It re-reads only the serial of a sealed slot before a signature. The number is
    relabelled "key use #N". The virtual chip counts public-key reads after the data lock.
  - Tests: ceremony 78, console 77. With a sealed chip: boots and a signature raise nothing, and a
    use from outside is flagged.
- `tools/fw allow off`, restart. Chip 2 boots the console in light, "Not pinned" (it is not an
  owner yet).
- **First boot of the fix: 3 uses flagged, all explained by the log.** One was the laptop's
  deliberate public-key read (the test above). Two were "Check again" presses on the pin-fail screen
  (the two `pin FAIL` lines at +199 s and +201 s), each re-reading the key. Fixed: the console saves
  the count after a re-check. Build `63e5041`: the next boot flags nothing (count 12 → 13, its own
  read).
- **Chip 2's state:** quorum v1, sealed, key `e199b2d7…`, owner `0x99ed…6b88`, counter 13, not
  yet an owner of any Safe.
- **Enrolled on Base:** chip 2's signer proxy was deployed with the passkey factory's
  `createSigner` ([tx](https://basescan.org/tx/0x113273caa009c8211e05408521767ef5e01db590f776791f81a82fa24f73931e)).
  `0x99eD…6b88` now has code on Base. The factory on Ethereum mainnet has the same code and gives
  the same address; chip 2 is not deployed there yet (only when a Safe there needs it). Not yet an
  owner of any Safe.

## 2026-10-02 — key PCB rev A: the PCB is the plug

The key's first board, designed and checked but not ordered. The board's own edge is the plug:
gold fingers, staggered so GND mates first and DETECT last, on Build 1's GPIOs. There are two
boards, key-a (SOIC, hand-soldered) and key-b (UDFN, assembled), both with an ATECC608C.
Notes: [2026-10-02-key-pcb-blade.md](2026-10-02-key-pcb-blade.md). Design and ordering:
[hardware/key-pcb](../hardware/key-pcb/README.md).

## 2026-10-02 — key-c ordered: the first key board

The first key board ordered is the USB-C proposal (key-c P2): an ATECC608C behind a USB-C
receptacle used as plain wires, 5 assembled by JLCPCB for $38.96. JLCPCB's production file was
checked against the design before confirming it. Their CAM output matched, apart from two tooling
holes they added in plain ground pour.
key-c P2

Notes: [2026-10-02-key-c-order.md](2026-10-02-key-c-order.md). Status, newest first:
[hardware/key-pcb/key-c-usbc](../hardware/key-pcb/key-c-usbc/README.md). Design:
[hardware/key-pcb/PROPOSALS.md](../hardware/key-pcb/PROPOSALS.md).

## 2026-10-07 — chip 5 (`0123a431b1490801ee`): the brand bench on a spare

The first run of [BRANDED-KEYS.md](../docs/BRANDED-KEYS.md)'s bench half, on Build 1 with the knob
alone, from the `brand` image (branch `brand-bench`). Chip 5 is one of five ATECC608A from one
Amazon order, used as the **spare**: it is branded with the public test key (bench `0xFF`, number
`T0001`), never as a real brand, and it will never be a Safe owner.

- **Read-only first (2026-10-06):** ATECC608A, revision `00006002`, both zones `55 55`, SlotLocked
  `FF FF`, Random's unlocked pattern, self-test 0, the Adafruit factory table. OTP reads were refused
  before any lock (status `0x0F`).
- **B1–B3:** quorum v2 written; the board and `tools/check_config --summary <snapshot> --v2` both said
  config CRC `2136`; the CRC lock took it. B1 and B2 ran on the old 8 px screen, B3 on the new one.
- **B4–B6:** zeros in slots 1–15, the v2 record in OTP, the test key's signature in slot 8, and the
  data lock with CRC `337d`, which covers slot 8. B4 ran three times and B5 twice before the lock,
  as designed (a restart goes back to B4).
- **B7:** the record and slot 8 read back in the clear after the lock; the signature verifies under
  the test key and is refused as a brand. Slot 0 empty, slot 1 unreadable.
- **S1–S3:** GenKey on slot 0 **after** the data lock works (key `7262a070`); two signatures verify
  and count exactly 2 (6 → 8); slot 0 sealed `FE FF`. Owner address of this test key:
  `0x9ff86c3d3fdb64503eb6adaa80614ab38946cdcc` (not deployed, not an owner anywhere).

What it settled, and what it didn't:
- **Settled:** GenKey after the data lock on a slot that never had a key; slot 8 readable after the
  lock and inside the data CRC.
- **A finding for the claim's U1 screen:** counter 0 read **1** at B7, before any key existed. Most
  likely the bench's own public-key read of the empty slot 0 after the data lock counted as a use
  (not yet tried in isolation). "Never used:
  0 signatures" can't be promised as written; the claim must account for the bench's reads.
- **U1's check took 2.3 s** on the Pico (one P-256 verify plus the CRC), against about 1.4 s guessed.
- **Not tested:** PrivWrite on slot 0 after the data lock. The driver has no PrivWrite command.
- **No 608C here:** this order was 608A, so the 608C's revision bytes are still unknown.

**Later the same day: everything left that doesn't need a new command** (a script run over USB with
the bench app paused; counter 0 went from 22 to 27):
- **What counts as a use of slot 0:** only a public-key read of slot 0, 1 each time. Reads of the
  config, OTP and slot 8, Random, Info and the counter itself cost nothing. So the 1 at B7 was most
  likely the bench's own read of the then-empty slot 0 (it can't be measured alone now). A claim
  that reads the key before it shows the count will see its own reads, as chip 2's console does.
- **Refused, each with the counter unmoved:** GenKey on sealed slot 0 (the key read back unchanged
  after), GenKey on slot 1, Write to slots 0, 1 and 8, Write to OTP, Write to the config (the driver
  saw an I2C error, not a status byte), Lock config and Lock data again, Sign with slot 1, Read slot 1,
  the public key of slot 1. GenKey on the sealed slot is the test chip 1 skipped.
- **Onchain, read only, Base Sepolia:** the passkey factory's `getSigner` gives this key
  `0x9ff86c3D3Fdb64503eB6ADAa80614Ab38946CDCC`, the owner the board showed. A WebAuthn signature from
  chip 5 over a test hash passes `isValidSignatureForSigner` (`0x1626ba7e`); a wrong hash gets
  `0x00000000`. Nothing deployed.
- **U1's 2.3 s, split:** the P-256 verify is 2.8 s alone in this run, the config CRC 10 ms, the OTP
  and slot 8 reads 210 ms. The verify is the cost.
- **Self-test 0, Random live, locks `00 00 / FE FF`** at the end.

## 2026-10-07 — the ESP32 bench: screen, knob and both chips on a WROOM-32

The first run of [ESP32.md](../hardware/wiring/ESP32.md) on hardware: a DevKit with an
ESP32-D0WDQ6 (revision v1.0, 4 MB flash, no PSRAM) on two breadboards, the 2.8″ screen from the
Pico's custom build, the EC11 knob and no buttons, `bench1.py` from maintenance mode.

- **MicroPython:** `ESP32_GENERIC-20250911-v1.26.1.bin` (sha256 `6b5272b6…7edd4e`), erase and write
  with esptool 5.4.0. `tools/usb push` copied every firmware file. With bench1 running, 108 KB of
  the heap was still free.
- **The 2.8″:** right on the first try at 24 MHz, with board.py's `MADCTL = 0x60` and inversion on:
  TL top-left, the bars red, green, blue and white. The console's own `lcd.py` drew the same.
  The 2.4″ tried first showed nothing; its wiring was not checked.
- **The knob:** the press worked from the start. The turn counted nothing (A and B never left 1, 1,
  polled every millisecond) until the 3-post side was rewired A, C, B to IO32, ground, IO33. It then
  counted on the pulse counter. Direction and steps per click not yet checked.
- **The Trust M** (a sacrificial chip, LcsA operational, E0F1 a frozen P-256 key): `scan()` returned
  `[]`, as on the Pico (docs/TRUSTM.md). A poll of its state register answered. `bench1.probe()` now
  polls 0x30 when the scan finds nothing, and shows the serial, LcsA and E0F1, read only.
- **Chip 5** (`0123a431b1490801ee`) on the same wires: 608A at 0x60, both zones locked, slot 0 key
  `7262a070` sealed `FE FF`, as above. `chipcheck` read slot 0's public key, so counter 0 went up by 1.
- **This DevKit resets every time its serial port opens.** mpremote's first raw-REPL attempt raced
  the reset; each new connection also stops bench1.
- Not tried: Wi-Fi, HTTPS, the console image, the watchdog. Holding the knob for the chip report
  (`chipcheck`, an ATECC report) with a Trust M on the bus seemed to stall the bench once; not
  looked into.

## 2026-10-16 — the console on an ESP32-WROVER, and the first ATECC608C on a key-c

An ESP32 with PSRAM (MicroPython 1.26.1, the `ESP32_GENERIC-SPIRAM` build, board id
`f42dc976eaf8`) on the breadboards of [ESP32.md](../hardware/wiring/ESP32.md), with the screen and
the EC11 knob, then two key-c boards (P2, ATECC608C) from the JLCPCB order. Nothing was locked or
written on either chip.

- **The console image, with `tools/fw`:** the board had an older console image. `tools/fw push
  console` put 2026.10.10 (`b2187163`, release `a675·bcda`) on it, and `verify` matched all 50
  files. Over the board's USB-serial bridge a backup takes about 3.5 minutes and a push about 5.
  The first push stopped on `trustm.mpy` (mpremote: "timeout waiting for first EOF reception"). The
  board stayed in maintenance, and a second push copied the last 3 files.
- **The screen was black with the backlight on,** at 24 MHz, at 10 MHz and from an init written from
  scratch at 1 MHz. A MOSI or CS wire was out of place. Re-seated, it drew.
- **mpremote's "could not enter raw repl":** its soft reset runs `boot.py` again (the splash, Wi-Fi),
  which takes longer than mpremote waits. Ctrl-C at the prompt, then `mpremote ... resume`.
- **The key-c on the bench:** VBUS and GND to the 3.3 V rails, SDA (D+) to IO21, SCL (D−) to IO22.
  None of the console's end from the key-c page was built: no VBUS switch, no CC sensing, no
  pull-ups.
  - The console's probe timed out (13.6 s) on every boot. Both lines idled low: the key-c has no
    I2C pull-ups (the design puts 2.2 kΩ on the console's side), and on IO21/IO22
    `atecc.make_i2c` uses SoftI2C, which doesn't turn on the ESP32's own. The Adafruit breakout
    has its own, so it never showed.
  - With the ESP32's pull-ups (about 45 kΩ) turned on, `0x60` answered, SDA on IO21.
- **Chip `0123e063db3354d7ee`, `chipcheck` and a read-only lab script:**
  - Revision `00006005`. `chipcfg.REVISIONS` and `chipcheck` know only `6002` (608A) and `6003`
    (608B), so they print "unknown".
  - Config and data zones unlocked. Config bytes 16–127 are byte for byte the 608A factory dump of
    2026-09-16 (`0123f3ac…`). Only the serial, the revision and bytes 13–14 differ: `61 69` here,
    `c1 55` on the 608A.
  - Random: `ffff0000…`, as on any unlocked chip. Info: KeyValid 0 for slots 0–2, State 0. Mode 3
    (GPIO) was refused with status `0x03`.
  - Counters 0 and 1: both 0, after the slot-table probe.
  - SelfTest passed: all at once, then RNG, ECDSA verify, ECDSA sign, ECDH, AES and SHA one at a
    time, 260–320 ms each.
  - The chip's SHA-256 of 0, 3, 21 and 63 bytes equalled `hashlib`'s.
  - 50 config reads at each of 50, 100, 200 and 400 kHz on the internal pull-ups: no errors. Those
    are the clocks asked of SoftI2C; the real ones weren't measured. 400 kHz was barely faster than
    200 (71 against 75 ms a read).
- **The console with a 608C:** started from RAM with the pull-ups on (`boot.py`, the pins, then
  `import main`). Its probe took 3.9 s and logged `new chip 0123e063db3354d7ee: chip 2, factory,
  theme light`, then `pin FAIL ... (secrets.py has no QUORUM_EXPECT)`. The unknown revision didn't
  stop it. It lasts until the board restarts.
- **Hot-plug:** with the console paused, a script woke the chip and read its serial every 300 ms,
  and changed the screen after two reads that agreed. Over 150 s: 11 changes, two chips
  (`0123e063db3354d7ee` and `0123147ac8c5b889ee`), the plug both ways round. Every insertion read
  the right serial, and the ESP32 never reset, with key power straight from the 3.3 V rail. The
  console itself reads the chip only at boot and on Check again.
- Open: pull-ups for the console on an ESP32 (two resistors, or the internal ones turned on in
  `atecc.make_i2c`, which is a new release); `00006005` in `chipcfg.REVISIONS` and `chipcheck`; the
  CC pins (DETECT), not wired here.

## 2026-10-20 — the Feather ESP32-S3 Reverse TFT, and the spare 608C's config is locked

A new board: Adafruit's Feather ESP32-S3 Reverse TFT (4 MB flash, 2 MB PSRAM, 240 × 135 ST7789).
What it is and how to set it up: [FEATHER-S3.md](../hardware/wiring/FEATHER-S3.md).

- **MicroPython 1.26.1** (`ESP32_GENERIC_S3`) over Adafruit's factory demo, with esptool 5.6.0 over
  the native USB. esptool reset the board into its bootloader itself. `erase-flash` failed while the
  port came back after the previous command; `write-flash` without it verified. About 2 MB of heap.
- **The bus:** IO3/IO4 with IO7 high. The MAX17048 battery gauge answered at 0x36.
- **The key** (key-c through USB-C adapters): at first no 0x60, with D+ and D− either way round, at
  20, 100 and 400 kHz, after a wake token and after a 1 ms wake pulse. A scan of every pair of the
  20 header pins found only 0x36. After the key was unplugged and plugged back in, 0x60 answered.
  What changed in the adapters wasn't recorded.
- **Chip `0123e063db3354d7ee`, read-only** (`atecc.py` with a stand-in `board.py`, `addr=0x60`):
  - Revision `00006005` (608C). I2C address byte `c0`, SlotLocked `ffff`.
  - **Config LOCKED, data open.** The table is `quorum-v3` (`chipcfg.identify`). The 2026-10-16
    entry had both zones open, and no entry here records the config lock. A locked chip doesn't
    say which CRC its lock was checked against.
  - Random: 32 bytes that weren't the test pattern. SHA-256 of `PicoQuorum 1` equalled `hashlib`'s.
    SelfTest 0 (all passed). Counters 0 and 1: both 0.
  - No key was read or used.
- **The screen:** `MADCTL 0x60`, offsets 40 and 53, inversion on: the bench test was read off it.
  The buttons haven't been checked.
- **The console image would not start:** `board.py`'s `"esp32"` profile uses GPIO22 and 25, which
  an S3 lacks, and GPIO19, its USB. And `atecc.py`'s fallback addresses include 0x36, the gauge.
  Open: a `"feather-s3"` profile and screens for 240 × 135.

## 2026-10-21 — the Feather: buttons, LED, HTTPS, and the console's profile from RAM

Everything ran from RAM (`mpremote run`, `mpremote mount`). Nothing was written to the board's
flash or to the chip.

- **Buttons** (`feather-s3/stage0.py`): at rest D0 reads 1 and D1, D2 read 0, with or without
  MicroPython's pulls; each reads the other way while pressed. No bounce showed at a 20 ms poll,
  and every press arrived as the right button.
- **Where they sit:** against the screen in 15-row bands, D0 is level with band 0 (rows 0–14), D1
  with band 4 (60–74) and D2 with band 8 (120–134). So `board.RAIL_Y = (7, 67, 127)`.
- **LED:** GPIO13 blinked 5 times; seen.
- **Gauge:** about 4.1 V, 99 %, version `0012`. Whether a battery was plugged in wasn't recorded.
- **HTTPS:** `tools/board/measure_tls.py` after a Wi-Fi join: 10 of 10 calls to `api.safe.global`
  checked against the console's pinned roots (median 561 ms, worst 811 ms), and badssl.com's
  `expired`, `wrong.host`, `self-signed` and `untrusted-root` refused. About 1.3 MB of heap stayed
  free.
- **The console's `board.py` and `lcd.py`, mounted from the laptop:** they picked `"feather-s3"`
  and drew a test frame. Whether its border showed on all four sides wasn't checked. The console
  image hasn't run on the board; its three-button screens run in the emulator
  ([docs/quorum-ui/feather](../docs/quorum-ui/feather/README.md)).

## 2026-10-22 — the dual image on the Feather, and its Wi-Fi setup

- **The push:** `tools/fw push dual` (build `bc6e3a19`) copied the files but failed three times,
  each time because the board dropped off USB: it had reset itself, a watchdog reset
  (`machine.reset_cause()` 3). With the board idle at its REPL, sessions that close the way
  mpremote 1.29 does (RTS low, then DTR low) reset it about one time in three after a restart.
  Closing with about 2 KB of output unread reset it 4 times in 14. Plain pyserial sessions that
  read everything before closing didn't reset it in these tests, and left alone for 90 s it never
  reset. So the push was finished over plain serial: the last file copied, the SHA-256 of every file
  on the board checked against the build (61 of 61), the bench's old files deleted (they are in its
  backup), `maint` removed and the board restarted. `tools/fw verify` hasn't run.
- **What it showed:** Wi-Fi setup, since no network is saved: the QR, "Scan me to set up Wi-Fi",
  and "press to type".
- **The hotspot:** the iPhone read the QR (join `PicoQuorum-CFB0`) and said it was unable to join.
  There was no such network: once setup was stopped, the board's hotspot was off and still had the
  default name `ESP_B1CFB1`. Tried in RAM on the board: `ap.config(...)` before `ap.active(True)`
  raises `OSError('Wifi Invalid Mode')`, and `wifisetup.py` did it in that order, in one `try`, so
  the hotspot never came on. Switched on first and then given a name and key, it came up open
  (`security` 0); with `security=WLAN.SEC_WPA2` as well, it read 3. `wifisetup.py` now does that on
  the ESP32, and switches the hotspot off if that fails. The Pico's order is unchanged.
- **The buttons:** Wi-Fi setup knew A/B/X/Y and the knob, not D0–D2, so no button did anything.
  Now D0 goes back, D1 walks the list and the keyboard one step at a time (held, back) and D2
  chooses; the QR screen says "D2 to type". Checked in the emulator and `wifisetup_test.py`, not
  yet on the board.

## 2026-10-22 — chip 3 (`0123147ac8c5b889ee`): the first 608C through C1–C10, on the Feather's three buttons

A key-c's ATECC608C (revision `00006005`), factory-fresh, on the Feather ESP32-S3 Reverse TFT. The
Feather's own `chips.json` calls it chip 3 (dark). The ceremony is `setup_s.py`, build `2cd9354c`:
`provision.UI`'s steps, checks and gates, on D0–D2 (D0+D1 held 3 s arms, D2 held 3 s does a
permanent step).

- **The push:** `tools/fw push dual` failed three times, each when the board reset partway (`OSError:
  [Errno 6] Device not configured`). The last three files were copied over plain serial, and all 62
  files' SHA-256 on the board matched the build.
- **The flags:** `tools/fw allow on` stopped with ENOENT: the Feather had no `secrets.py` (its Wi-Fi
  is in `wifi.json`). A `secrets.py` with only a comment went on first (every firmware read of
  `secrets` is a `getattr`), then `allow on` wrote both flags.
- **C1–C10:** Jason ran them on the buttons, straight through. The plan had stops at C2 (the CRC,
  on the laptop) and C7 (the owner, on the laptop); both checks came after C10 instead (below).
  Every step's checks were green on the board.
- **One C6 attempt refused.** Its D2 hold started with about 4 s of the 60 s arm left. C6 signs and
  verifies a test digest before it locks, and the arm ran out in between, so `signer.lock_slot`
  refused before any Lock command. A fresh arm, and C6 passed. Two things it showed:
  - The refusal said "hold B+Y 3 s": `signer.gate`'s words, which `setup_s.py` didn't translate. It
    says D0+D1 now.
  - A hold can start too late to finish. Now a hold starts only with 10 s of the arm left
    (`provision.ARM_LEFT`); with less the screen says to arm again. That's for every ceremony
    screen, the Pico's and the knob's too (`case_arm_left`, and the C6 check in `case_three`).
- **The laptop checks, after C10.** `tools/fw verify --baseline` read the chip. `tools/fw logs` and
  `backup` were cut by the reset again, so every file came off over plain serial, each checked
  against a SHA-256 computed on the board (in `backups/`, gitignored).
  - **Config:** `tools/check_config --summary` on the factory snapshot gives `af3a`, and
    `chipcfg.locked_summary` on the locked config read back gives `af3a`. Against the snapshot plus
    quorum v1, the only bytes that differ are counter 0's (52–53), the lock bytes (`00 00`) and
    SlotLocked (`fe ff`).
  - **Key:** slot 0, P-256, LimitedUse, sealed; `9ba14c76…`.
  - **Owner:** `0x031B2c6038aB0d15e62eC2D2D21D84878e13250e`, computed on the laptop. The passkey
    factory's `getSigner` gives the same on Base Sepolia, Base and Ethereum. No signer proxy is
    deployed on any of them yet.
  - **OTP record:** quorum-v1, this serial, slot 0, owner `0x031b…250e`, 2026-10-23 02:20:23 UTC,
    build `2cd9354c`, counter 5. Its key hash matches the key read off the chip. Chip 2's record
    read 4 (C5's two signatures and C6's two); the fifth is the refused C6 attempt's test signature.
  - **Data CRC:** `6724`, worked out on the laptop from zeros in slots 1–15 and the record. The chip
    accepted the CRC-checked data lock (lock bytes `00 00`).
  - **Counter 0:** 11 afterwards. `verify --baseline`'s public-key read and a boot's each count,
    as on chip 2 once its data zone was locked.
- `tools/fw allow off`, read back as False on the board, restart.
- **After the restart:** the dual image booted the console for the sealed chip. The console read it
  (`pin FAIL: … owner 0x031b…250e (secrets.py has no QUORUM_EXPECT)` in `log.txt`) and showed
  "No Safe": the board has no `QUORUM_SAFES` yet. Not pinned, no signer proxy, an owner of nothing yet.
  The plan is Safe `0x5617…DC41` on Base Sepolia (3 of 6 today).
- **Pinned and pointed at the Safe**, later that evening: `tools/quorum live key --qx … --qy …`
  (the key `live.json` held before was kept aside), `tools/fw pin` (owner the same as the laptop's),
  `tools/quorum live pico --chain basesep --safe 0x5617…`. `live pico`'s checks after the restart
  each open an mpremote session, and on this board those caught the console partway through its
  start: 72 s after a reset it was still in `boot`. Restarted with the port left alone for 45 s:
  home, Wi-Fi up, pin ok, the Safe answered (nonce 12, 3 of 6), this key not an owner yet.
- **An owner, and #14.** Jason swapped chip 3's owner in for `0x47c0…` (nonce 13), then proposed #14,
  a Send ETH, and signed it on the Feather. Safe's service refused the confirmation (HTTP 400): the
  signer proxy isn't deployed on Base Sepolia yet, and the service checks a contract signature onchain.

## 2026-10-23 — blockies on the Feather's reviews, pushed with the console's watchdog running

- **The image:** build `3546826d` (dual `db5e·124b`): a blockie on every address page of a review,
  beside a token's amount, and for each owner on approvals and Owners.
- **The push:** `tools/fw push dual` stopped at its first read of the board, before the backup or
  any copy: the board reset (`Device not configured`). Chip 3 is pinned now, so the console had
  started its watchdog (`watch.running()` read True afterwards, over serial). A session that stops the
  console stops its feeding, and the board resets 8 s on. That is likely what cut this one.
- **Done over plain serial instead:** `watch.hold(600000)`, a `maint` file, a restart into
  maintenance (no console, no watchdog), a backup of all 74 files with each SHA-256 checked (in
  `backups/`, gitignored), five files copied (`build.py`, `provision`, `quorum`, `quorum_ui_s`,
  `setup_s`), 62 of 62 hashes matching the build, `maint` removed, restart. `tools/fw verify`
  hasn't run. The signature the console held for #14 went with the restart.

## 2026-10-24 — console-s3 ordered: the first console board

Five console-s3 rev A boards from JLCPCB, Economic assembly on the front; the module goes on by
hand. $96.72 with shipping and import, of which the boards are $50.85. The modules ($43.10, LCSC) and
panels ($16.28, Amazon) are bought apart and not in that figure. Production file not confirmed; parts placement is.

Notes: [2026-10-24-console-s3-order.md](2026-10-24-console-s3-order.md). Plan:
[ORDER-PLAN-2026-10-24.md](../hardware/prototypes/ORDER-PLAN-2026-10-24.md). Design:
[hardware/console-s3](../hardware/prototypes/console-s3/DESIGN.md).

## 2026-11-03 — 100 panels ordered from BuyDisplay

100 ER-TFT1.14-2 (1.14″ 135 × 240 ST7789, FPC) for the demo batches: $371.29 with shipping and
the PayPal fee, $3.71 a panel, before any duty. Paid in advance through PayPal (receipt dated 2026-11-02); invoice and tracking still to come.
Jason reports the first console-s3 and PicoQuorumKey boards both working.

Notes: [2026-11-03-panels-order.md](2026-11-03-panels-order.md).
## 2026-10-29 — console-rp ordered: the RP2350 console, fully assembled

Five console-rp boards from JLCPCB, every part on by JLCPCB; only the panel clips in by hand.
$164.28 with shipping and import, of which the boards are $90.69 ($18.14 each). Import taxes were
35 % of that again. The panels are the console-s3 pair, already checked against J2. An estimate on
the same terms: about $11.50 a board at 100, $9.90 at 500 and $9.60 at 1000, before the panel. L1
and the crystal's stock limit a run before price does.

Notes: [2026-10-29-console-rp-order.md](2026-10-29-console-rp-order.md). Design:
[hardware/console-rp](../hardware/console-rp/README.md).
