jmcpheron/pico-quorum/buildlog/2026-09-30-boot-mark.md

# A light boot screen: the mark, only what changed

The orbit loading screen runs at 8–10 fps on the Pico (2026-09-26: 100–130 ms a frame, about
50 ms of it the 153,600-byte frame over SPI at 24 MHz on the 2.8"). `firmware/bootmark.py` is the
default boot art now: the orbit's end mark (five owners, three sign, the triangle fills green, two
stay amber, PicoQuorum under it) as flat shapes, with the real status on the bottom line.

- **Dirty rectangles.** Each element (a dot, a ring, an edge, the fill, the name, the status) has a
  small "look" tuple for time t. A frame compares looks with the last frame's and repaints only the
  rectangles of those that changed: the whole scene drawn into lcd's own buffer as a window of that
  size (as many rows as fit), then sent with CASET/RASET to just that window. No new buffers.
- **Exact.** An edge repaints from its start to its new end, not only the new piece: a shorter
  Bresenham line is not a prefix of a longer one, and the piece-only version left stray pixels
  (caught by the test at 1350 ms). The test compares the panel with a fresh paint after every
  frame, on the 240x240, 320x240 and 160x128 panels.
- **Numbers (emulator, 30 ms steps, 131 frames).** 240x240: 6.9% of whole-frame bytes; 320x240:
  5.5%; 160x128: 8.2%. Busiest frame after the first: 26 KB / 30 KB / 14 KB. 17 frames send
  nothing. In the emulator, where SPI time is modelled and the CPU is much faster, a mark frame
  averages 2.7 ms against the orbit's 54 ms. On the Pico, expect a few ms to ~15 ms a frame;
  **not yet measured on the board.**
- **Timing.** 0.3 s black, 3.8 s of animation, then the console (the orbit held 4 s + 9.6 s).
  `splash.spin` redraws at most every 30 ms for the mark (120 ms for the orbit), and `net.connect`
  now calls its progress every 50 ms (the LED still toggles every 150 ms), so the mark keeps moving
  while WiFi joins.
- **Choices.** `secrets.BOOT_ART = "mark" | "still" | "orbit" | "checklist"`. "still" draws the
  finished mark once; after that only a status change is sent (13 KB on the 240x240). "orbit" is
  only for strip-buffered panels of 240 rows; elsewhere it falls back to the mark.
- `bootmark` is released at `splash.finish` like `bootart`, and is in all three images in
  `firmware/manifest.json`. Suites: manifest, bootart (pinned to `BOOT_ART="orbit"`), bootmark,
  display, console, ceremony, trustm, micropython all pass.
- **Taglines** (`firmware/taglines.py`): 16 serious (each a claim the firmware backs: the hash
  rebuilt on the device, a lying service refused, the key made in the chip and never a seed phrase,
  plain words, the verify code) and 20 fun (Hackers, Silicon Valley, The Matrix, WarGames, Sneakers,
  Jurassic Park, Mr. Robot, Zero Wing, cyberpunk). One per boot under the name on the mark, cycling on
  the orbit. `secrets.BOOT_TAGLINES = "serious" | "fun" | "all" | "none"`, serious by default. All
  fit 220 px in sans14 ("Mess with the best, die like the rest" was 223 and was cut). No tagline on
  the 1.8". Released with the art at `splash.finish`.
- **Into Ethereum** (same day, on the Waveshare). A first try faded the diamond in beside the mark
  and flew it to the top-left corner; it didn't work and is gone. Now the mark turns into the logo
  the way the orbit did, drawn the light way, with no holds: the signatures 0.3 s apart, then the
  filled triangle *is* bootart.py's diamond seen head-on (its front face, the same green), which
  turns, the signers riding its corners, the lower pyramid rising in and the green face going blue
  round the back. The logo is spinning by 2.8 s. It slows, grows and dims, and the small mark (five
  owners, three signed) and PicoQuorum fade in over it by 3.4 s. It keeps turning, 30° a second,
  for as long as the boot screen is up. The hold is 3.7 s. The diamond is one element: a frame
  repaints the box it was in and the box it is in, as one rectangle. Emulator, 151 frames to 4.5 s:
  20.7% of whole-frame bytes on the 240x240 (the plain mark was 6.9%), busiest frame 58 KB while
  it is big and turning; every frame matches a fresh paint on all three panels. One catch: the
  small mark's points were rounded after shifting into the tile, so tiles disagreed by a pixel;
  they are rounded on the screen first, as everything else is.
- **On the board, then faster** (same evening). Smooth until the name came up, then a stutter and a
  freeze: the console's start ran after the animation without a frame. A `boot ms:` line in
  log.txt now says where the time goes. With the Trust M: art at 1.7 s, WiFi at 5.3 s, then
  imports 1.1 s, fonts 0.1 s, chip probe 6.7 s (the certificate and the binding: two pure-Python
  P-256 verifies, 2.3 s each; the owner address: two keccaks, 0.7 s), the rest 0.4 s. Both are
  pure functions of bytes that don't change, so each is remembered by the SHA-256 of exactly its
  inputs (tmproof.txt, owners.txt, both kept across pushes): the probe is 0.9 s, and the console
  is up at 7.8 s instead of about 13. The chip's own VerifySign was not used for the factory
  checks: they ask whether the chip is genuine, and a counterfeit would say yes. The diamond now
  slows to a stop on the logo's pose (315°) as the name fades in, so the startup after it shows
  a still screen, not a frozen spin.
