jmcpheron/pico-quorum/hardware/prototypes/picoquorum-key/hardware/out/rev-a/fit-check-front-1to1.pdf

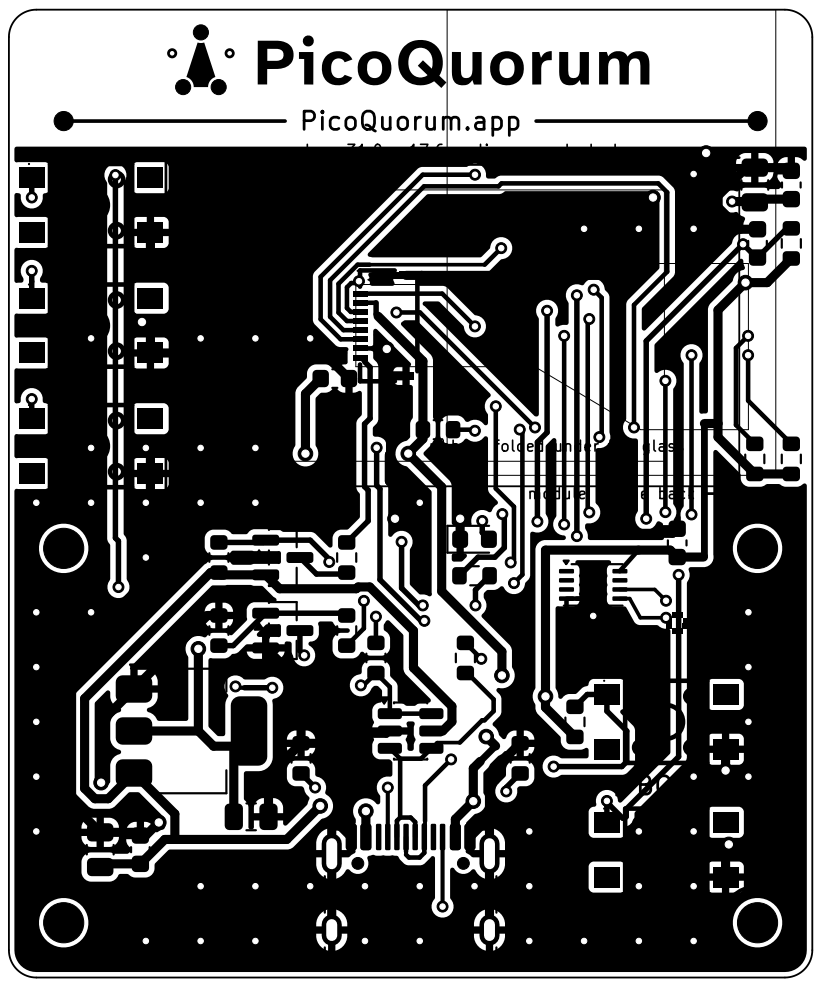
[picture p477: page 1]

glass 31.0 x 17.6; active area dashed

Sheet:
File: picoquorum-key.kicad_pcb
Title: picoquorum-key rev A

Size: A4 | Rev: A
KiCad E.D.A. 10.0.6 | Id: 1/1
