jmcpheron/pico-quorum/hardware/tally/tally/tally.kicad_pcb

## KiCad design hardware/tally/tally/tally.kicad_pcb (2026-11-13)

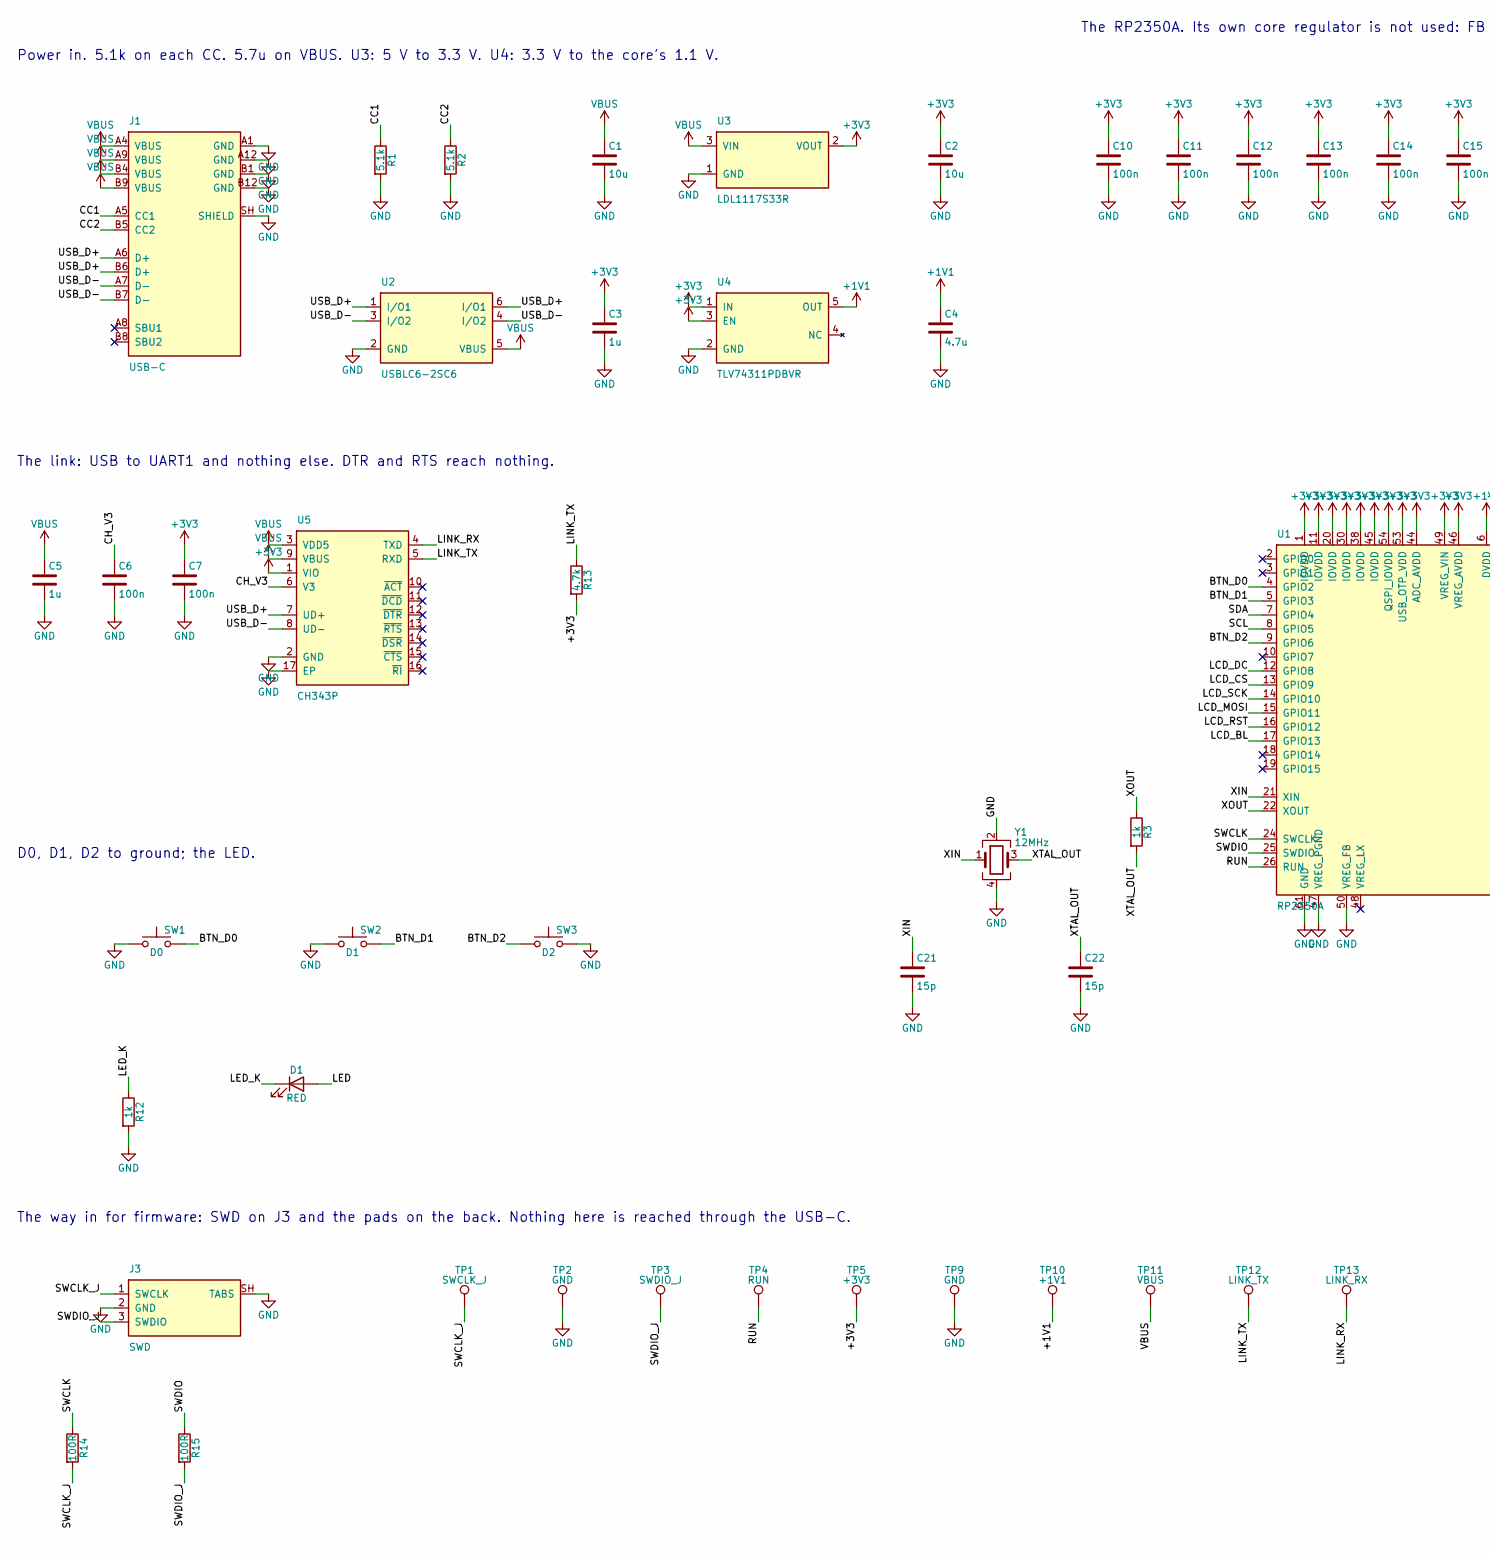
[picture p478: schematic tally.kicad_sch, Picoquorum Tally: a slender console, an RP2350A, no radio, …, part in row 1, column 1]

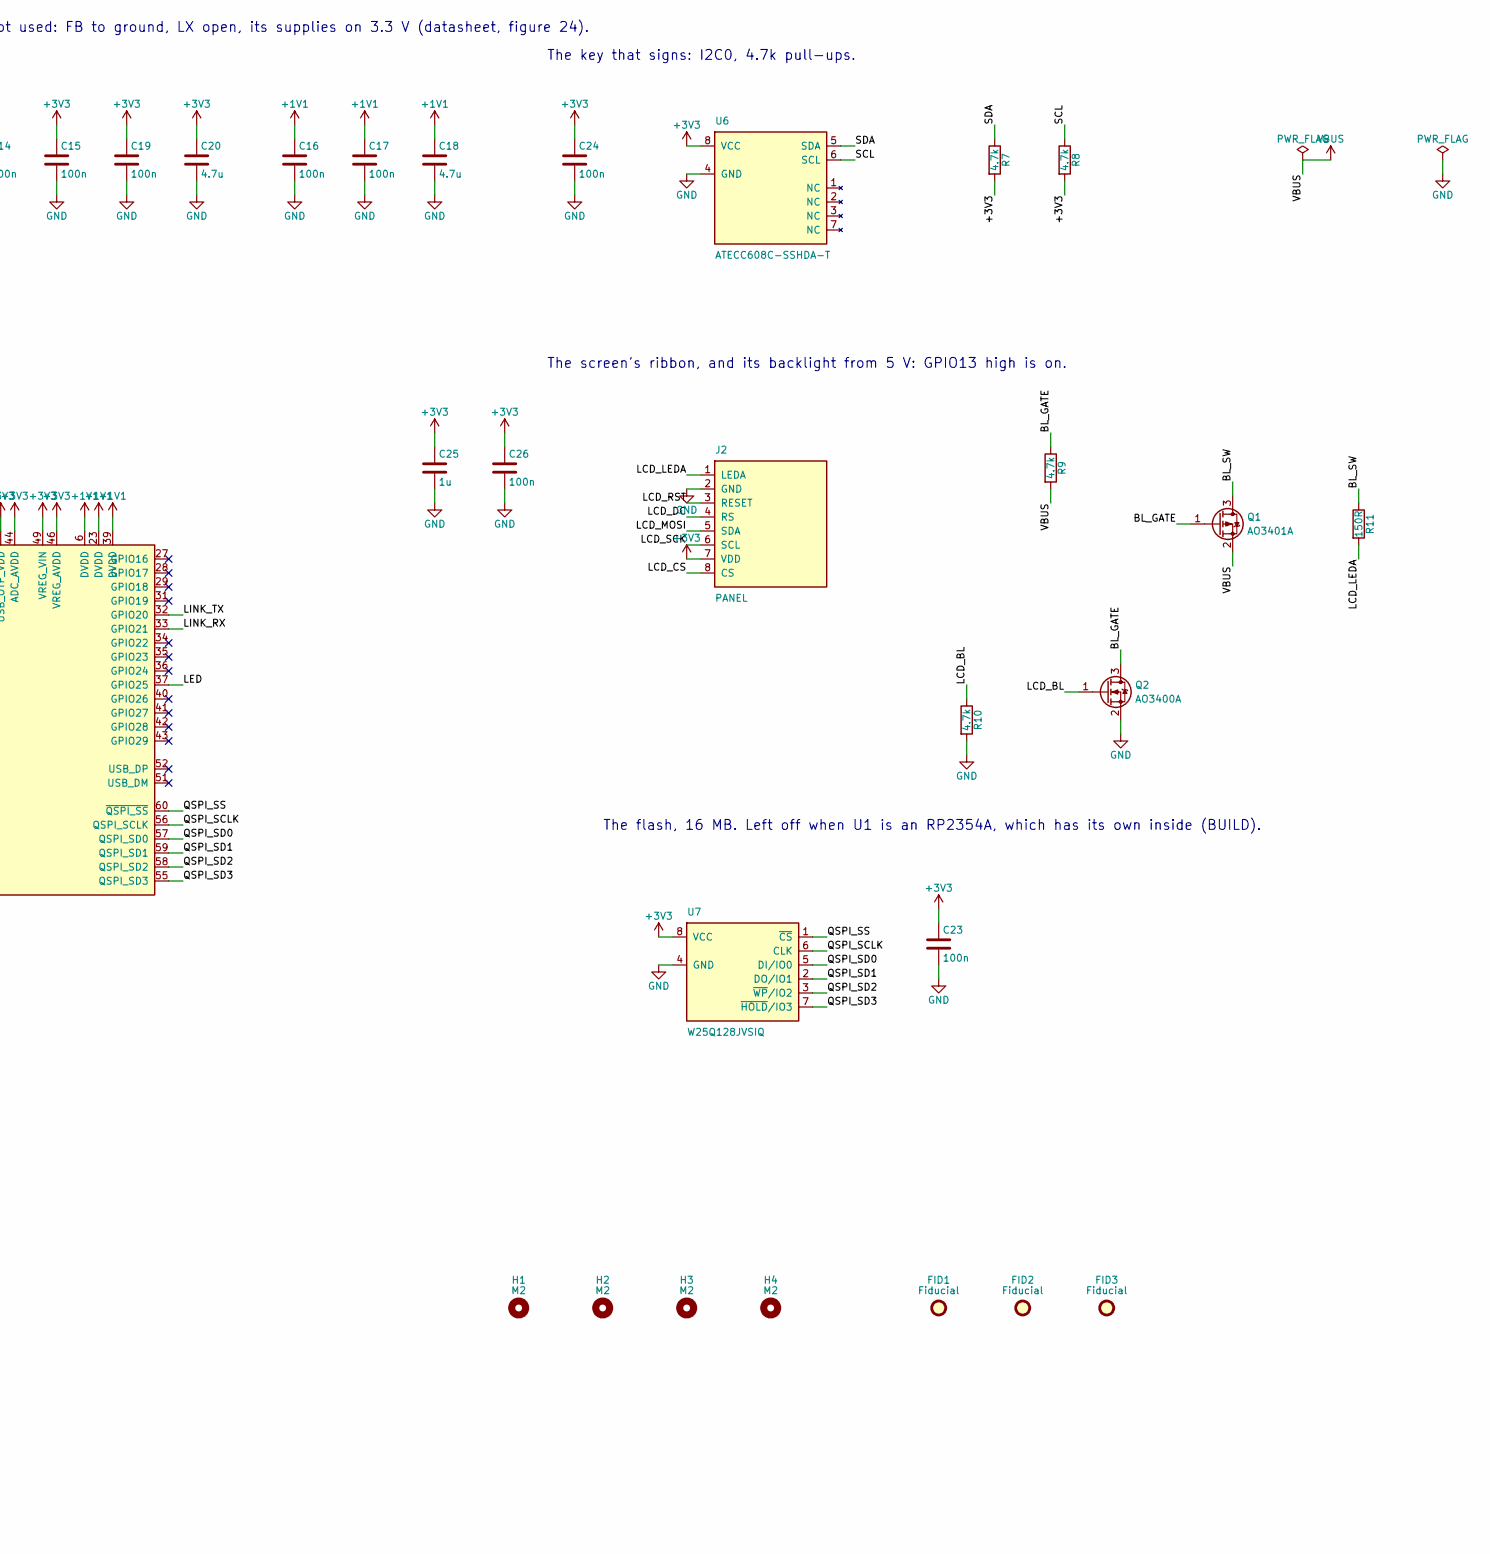
[picture p479: schematic tally.kicad_sch, Picoquorum Tally: a slender console, an RP2350A, no radio, …, part in row 1, column 2]

Parts:
C1, C2: 10u; C_0805_2012Metric; MPN CL21A106KAYNNNE; LCSC C15850
C3, C5, C25: 1u; C_0402_1005Metric; MPN CL05A105KA5NQNC; LCSC C52923
C4: 4.7u; C_0402_1005Metric; MPN CL05A475MP5NRNC; LCSC C23733
C6, C7, C23, C24, C26: 100n; C_0402_1005Metric; MPN CL05B104KO5NNNC; LCSC C1525
C10, C11, C12, C13, C14, C15, C16, C17, C19: 100n; RPi_C_0402; MPN CL05B104KO5NNNC; LCSC C1525
C18: 4.7u; RPi_C_0402; MPN CL05A475MP5NRNC; LCSC C23733
C20: 4.7u; RPi_C_0402_wide; MPN CL05A475MP5NRNC; LCSC C23733
C21, C22: 15p; RPi_C_0402; MPN 0402CG150J500NT; LCSC C1548
D1: RED; LED_0603_1608Metric; MPN KT-0603R; LCSC C2286
FID1, FID2, FID3: Fiducial; Fiducial_1mm_Mask2mm
H1, H2, H3, H4: M2; MountingHole_2.2mm_M2
J1: USB-C; USB_C_Receptacle_HRO_TYPE-C-31-M-12; MPN TYPE-C-31-M-12; LCSC C165948
J2: PANEL; FPC_ZIF_8P_P0.5mm_HDGC_0.5K-HX-8PWB; MPN 0.5K-HX-8PWB; LCSC C2919492
J3: SWD; JST_SH_SM03B-SRSS-TB_1x03-1MP_P1.00mm_Horizontal; MPN SM03B-SRSS-TB(LF)(SN); LCSC C160403
Q1: AO3401A; SOT-23; MPN AO3401A; LCSC C15127
Q2: AO3400A; SOT-23; MPN AO3400A; LCSC C20917
R1, R2: 5.1k; R_0402_1005Metric; MPN 0402WGF5101TCE; LCSC C25905
R3: 1k; RPi_R_0402; MPN 0402WGF1001TCE; LCSC C11702
R7, R8, R9, R10, R13: 4.7k; R_0402_1005Metric; MPN 0402WGF4701TCE; LCSC C25900
R11: 150R; R_0603_1608Metric; MPN 0603WAF1500T5E; LCSC C22808
R12: 1k; R_0402_1005Metric; MPN 0402WGF1001TCE; LCSC C11702
R14, R15: 100R; R_0402_1005Metric; MPN 0402WGF1000TCE; LCSC C25076
SW1: D0; SW_Push_1P1T_XKB_TS-1187A; MPN TS-1187A-B-A-B; LCSC C318884
SW2: D1; SW_Push_1P1T_XKB_TS-1187A; MPN TS-1187A-B-A-B; LCSC C318884
SW3: D2; SW_Push_1P1T_XKB_TS-1187A; MPN TS-1187A-B-A-B; LCSC C318884
TP1: SWCLK_J; TestPoint_Pad_D1.5mm
TP2, TP9: GND; TestPoint_Pad_D1.5mm
TP3: SWDIO_J; TestPoint_Pad_D1.5mm
TP4: RUN; TestPoint_Pad_D1.5mm
TP5: +3V3; TestPoint_Pad_D1.5mm
TP10: +1V1; TestPoint_Pad_D1.5mm
TP11: VBUS; TestPoint_Pad_D1.5mm
TP12: LINK_TX; TestPoint_Pad_D1.5mm
TP13: LINK_RX; TestPoint_Pad_D1.5mm
U1: RP2350A; RPi_RP2350A_QFN-60_7x7mm_P0.4mm_ThermalVias; MPN RP2350A; LCSC C42411118
U2: USBLC6-2SC6; SOT-23-6; MPN USBLC6-2SC6; LCSC C7519
U3: LDL1117S33R; SOT-223-3_TabPin2; MPN LDL1117S33R; LCSC C435835
U4: TLV74311PDBVR; SOT-23-5; MPN TLV74311PDBVR; LCSC C485147
U5: CH343P; WCH_QFN-16-1EP_3x3mm_P0.5mm_EP1.8x1.8mm; MPN CH343P; LCSC C2846043
U6: ATECC608C-SSHDA-T; SOIC-8_3.9x4.9mm_P1.27mm; MPN ATECC608C-SSHDA-T; LCSC C28975195
U7: W25Q128JVSIQ; SOIC-8_5.3x5.3mm_P1.27mm; MPN W25Q128JVSIQ; LCSC C97521
Y1: 12MHz; RPi_Crystal_SMD_3225-4Pin_3.2x2.5mm; MPN X322512MSB4SI; LCSC C9002

Connections:
+1V1: C4.1, C16.1, C17.1, C18.1, TP10.1, U1.6 (DVDD), U1.23 (DVDD), U1.39 (DVDD), U4.5 (OUT)
+3V3: C2.1, C3.1, C7.1, C10.1, C11.1, C12.1, C13.1, C14.1, C15.1, C19.1, C20.1, C23.1, C24.1, C25.1, C26.1, J2.7 (VDD), R7.2, R8.2, R13.2, TP5.1, U1.1 (IOVDD), U1.11 (IOVDD), U1.20 (IOVDD), U1.30 (IOVDD), U1.38 (IOVDD), U1.44 (ADC_AVDD), U1.45 (IOVDD), U1.46 (VREG_AVDD), U1.49 (VREG_VIN), U1.53 (USB_OTP_VDD), U1.54 (QSPI_IOVDD), U3.2 (VOUT), U4.1 (IN), U4.3 (EN), U5.1 (VIO), U6.8 (VCC), U7.8 (VCC)
/BL_GATE: Q1.1 (G), Q2.3 (D), R9.1
/BL_SW: Q1.3 (D), R11.1
/BTN_D0: SW1.2, U1.4 (GPIO2)
/BTN_D1: SW2.2, U1.5 (GPIO3)
/BTN_D2: SW3.1, U1.9 (GPIO6)
/CC1: J1.A5 (CC1), R1.1
/CC2: J1.B5 (CC2), R2.1
/CH_V3: C6.1, U5.6 (V3)
/LCD_BL: Q2.1 (G), R10.1, U1.17 (GPIO13)
/LCD_CS: J2.8 (CS), U1.13 (GPIO9)
/LCD_DC: J2.4 (RS), U1.12 (GPIO8)
/LCD_LEDA: J2.1 (LEDA), R11.2
/LCD_MOSI: J2.5 (SDA), U1.15 (GPIO11)
/LCD_RST: J2.3 (RESET), U1.16 (GPIO12)
/LCD_SCK: J2.6 (SCL), U1.14 (GPIO10)
/LED: D1.2 (A), U1.37 (GPIO25)
/LED_K: D1.1 (K), R12.1
/LINK_RX: TP13.1, U1.33 (GPIO21), U5.4 (TXD)
/LINK_TX: R13.1, TP12.1, U1.32 (GPIO20), U5.5 (RXD)
/QSPI_SCLK: U1.56 (QSPI_SCLK), U7.6 (CLK)
/QSPI_SD0: U1.57 (QSPI_SD0), U7.5 (DI/IO0)
/QSPI_SD1: U1.59 (QSPI_SD1), U7.2 (DO/IO1)
/QSPI_SD2: U1.58 (QSPI_SD2), U7.3 (~WP/IO2)
/QSPI_SD3: U1.55 (QSPI_SD3), U7.7 (~HOLD/IO3)
/QSPI_SS: U1.60 (~QSPI_SS), U7.1 (~CS)
/RUN: TP4.1, U1.26 (RUN)
/SCL: R8.1, U1.8 (GPIO5), U6.6 (SCL)
/SDA: R7.1, U1.7 (GPIO4), U6.5 (SDA)
/SWCLK: R14.1, U1.24 (SWCLK)
/SWCLK_J: J3.1 (SWCLK), R14.2, TP1.1
/SWDIO: R15.1, U1.25 (SWDIO)
/SWDIO_J: J3.3 (SWDIO), R15.2, TP3.1
/USB_D+: J1.A6 (D+), J1.B6 (D+), U2.1 (I/O1), U2.6 (I/O1), U5.7 (UD+)
/USB_D-: J1.A7 (D-), J1.B7 (D-), U2.3 (I/O2), U2.4 (I/O2), U5.8 (UD-)
/XIN: C21.1, U1.21 (XIN), Y1.1
/XOUT: R3.1, U1.22 (XOUT)
/XTAL_OUT: C22.1, R3.2, Y1.3
GND: C1.2, C2.2, C3.2, C4.2, C5.2, C6.2, C7.2, C10.2, C11.2, C12.2, C13.2, C14.2, C15.2, C16.2, C17.2, C18.2, C19.2, C20.2, C21.2, C22.2, C23.2, C24.2, C25.2, C26.2, J1.A1 (GND), J1.A12 (GND), J1.B1 (GND), J1.B12 (GND), J1.SH (SHIELD), J2.2 (GND), J3.2 (GND), J3.SH (TABS), Q2.2 (S), R1.2, R2.2, R10.2, R12.2, SW1.1, SW2.1, SW3.2, TP2.1, TP9.1, U1.47 (VREG_PGND), U1.50 (VREG_FB), U1.61 (GND), U2.2 (GND), U3.1 (GND), U4.2 (GND), U5.2 (GND), U5.17 (EP), U6.4 (GND), U7.4 (GND), Y1.2, Y1.4
VBUS: C1.1, C5.1, J1.A4 (VBUS), J1.A9 (VBUS), J1.B4 (VBUS), J1.B9 (VBUS), Q1.2 (S), R9.2, TP11.1, U2.5 (VBUS), U3.3 (VIN), U5.3 (VDD5), U5.9 (VBUS)

Notes on the sheet:
Power in. 5.1k on each CC. 5.7u on VBUS. U3: 5 V to 3.3 V. U4: 3.3 V to the core's 1.1 V.
The link: USB to UART1 and nothing else. DTR and RTS reach nothing.
The RP2350A. Its own core regulator is not used: FB to ground, LX open, its supplies on 3.3 V (datasheet, figure 24).
The key that signs: I2C0, 4.7k pull-ups.
The screen's ribbon, and its backlight from 5 V: GPIO13 high is on.
The flash, 16 MB. Left off when U1 is an RP2354A, which has its own inside (BUILD).
D0, D1, D2 to ground; the LED.
The way in for firmware: SWD on J3 and the pads on the back. Nothing here is reached through the USB-C.

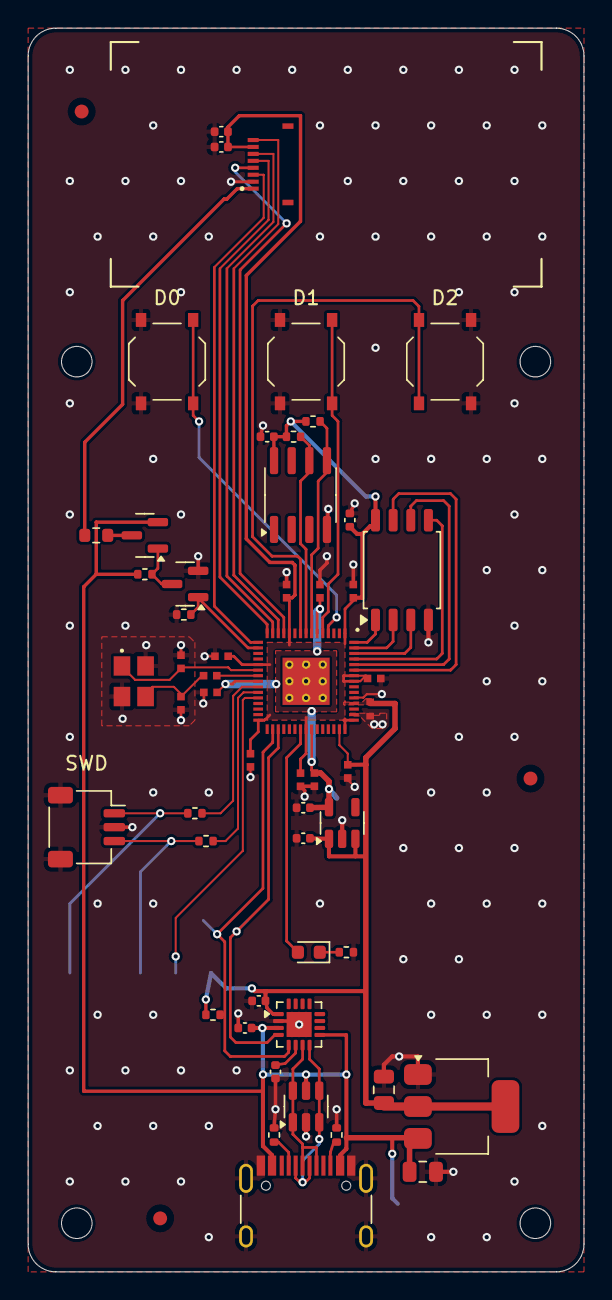
[picture p480: board tally.kicad_pcb from above]

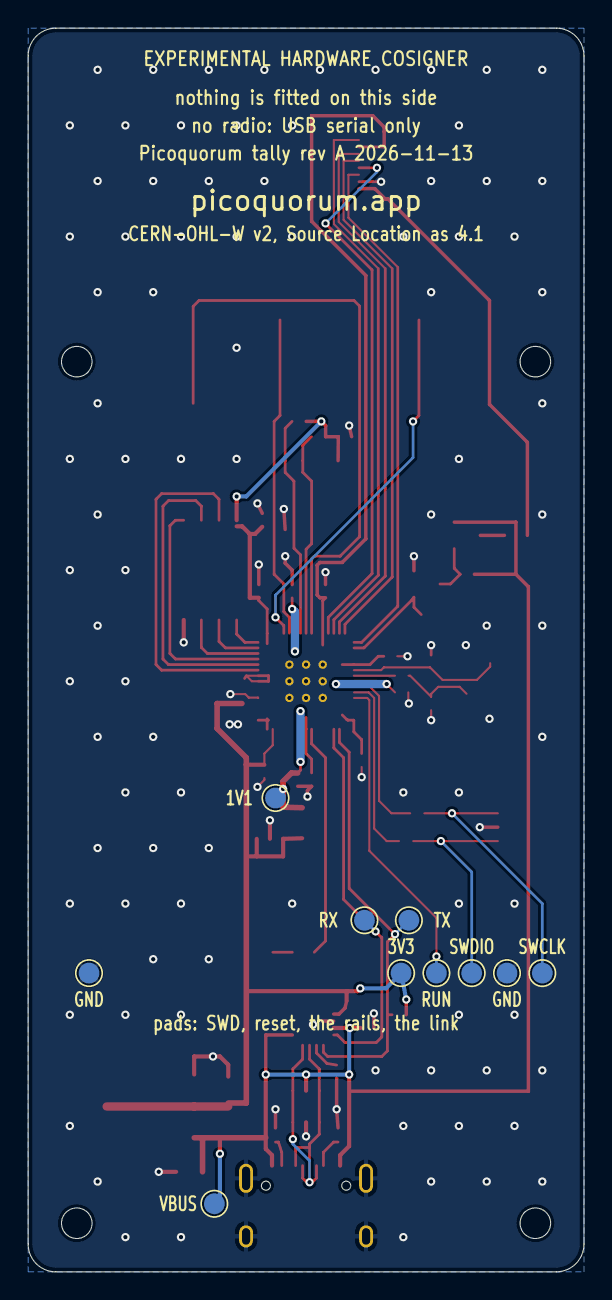
[picture p481: board tally.kicad_pcb from below]

Board: 2 copper layers, 40.0 x 89.5 mm, 70 parts (10 on the bottom side), 41 nets.
