jmcpheron/pico-quorum/hardware/prototypes/console-s3/console-s3/console-s3.kicad_pcb

## KiCad design hardware/prototypes/console-s3/console-s3/console-s3.kicad_pcb (2026-11-06)

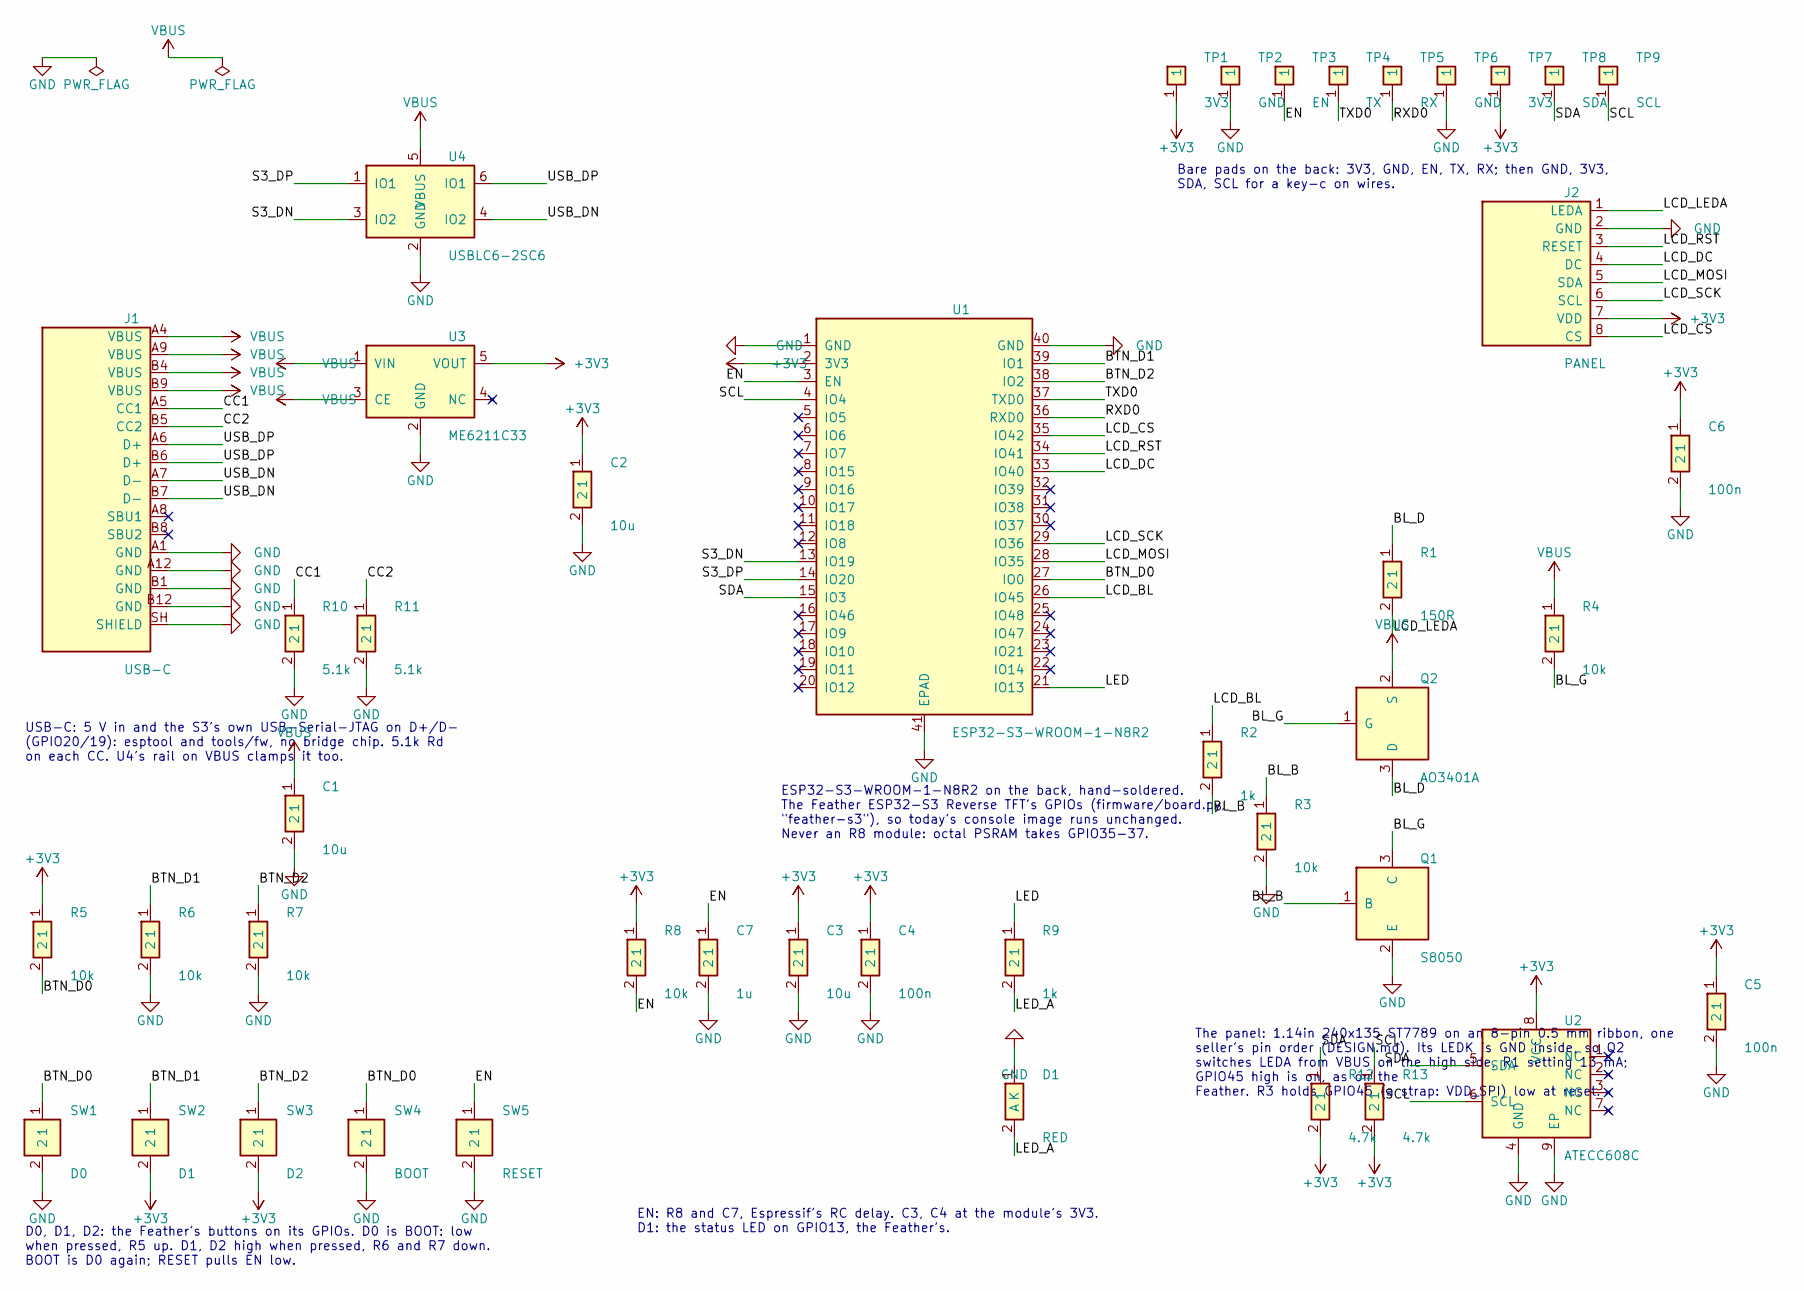
[picture p482: schematic console-s3.kicad_sch, Picoquorum console-s3, rev A: ESP32-S3-WROOM-1 on the back,…]

Parts:
C1, C2, C3: 10u; C_0603; LCSC C19702
C4, C5, C6: 100n; C_0603; LCSC C14663
C7: 1u; C_0603; LCSC C15849
D1: RED; LED_0603; LCSC C2286
J1: USB-C; USB_C_Receptacle_HCTL_HC-TYPE-C-16P-01A; MPN HC-TYPE-C-16P-01A; LCSC C2894897
J2: PANEL; FPC_ZIF_8P_P0.5mm_HDGC_0.5K-HX-8PWB; MPN 0.5K-HX-8PWB; LCSC C2919492
Q1: S8050; SOT-23; MPN SS8050; LCSC C2150
Q2: AO3401A; SOT-23; MPN AO3401A; LCSC C15127
R1: 150R; R_0603; LCSC C22808
R2, R9: 1k; R_0603; LCSC C21190
R3, R4, R5, R6, R7, R8: 10k; R_0603; LCSC C25804
R10, R11: 5.1k; R_0603; LCSC C23186
R12, R13: 4.7k; R_0603; LCSC C23162
SW1: D0; SW_TS-1187A; MPN TS-1187A-B-A-B; LCSC C318884
SW2: D1; SW_TS-1187A; MPN TS-1187A-B-A-B; LCSC C318884
SW3: D2; SW_TS-1187A; MPN TS-1187A-B-A-B; LCSC C318884
SW4: BOOT; SW_TS-1187A; MPN TS-1187A-B-A-B; LCSC C318884
SW5: RESET; SW_TS-1187A; MPN TS-1187A-B-A-B; LCSC C318884
TP1, TP7: 3V3; TestPad_1.5mm_Back
TP2, TP6: GND; TestPad_1.5mm_Back
TP3: EN; TestPad_1.5mm_Back
TP4: TX; TestPad_1.5mm_Back
TP5: RX; TestPad_1.5mm_Back
TP8: SDA; TestPad_1.5mm_Back
TP9: SCL; TestPad_1.5mm_Back
U1: ESP32-S3-WROOM-1-N8R2; ESP32-S3-WROOM-1; MPN ESP32-S3-WROOM-1-N8R2
U2: ATECC608C; DFN-8-1EP_3x2mm_P0.5mm; MPN ATECC608C-MAHDA-S; LCSC C23291019
U3: ME6211C33; SOT-23-5; MPN ME6211C33M5G-N; LCSC C82942
U4: USBLC6-2SC6; SOT-23-6; MPN USBLC6-2SC6; LCSC C7519

Connections:
+3V3: C2.1, C3.1, C4.1, C5.1, C6.1, J2.7 (VDD), R5.1, R8.1, R12.2, R13.2, SW2.2, SW3.2, TP1.1, TP7.1, U1.2 (3V3), U2.8 (VCC), U3.5 (VOUT)
/BL_B: Q1.1 (B), R2.2, R3.1
/BL_D: Q2.3 (D), R1.1
/BL_G: Q1.3 (C), Q2.1 (G), R4.2
/BTN_D0: R5.2, SW1.1, SW4.1, U1.27 (IO0)
/BTN_D1: R6.1, SW2.1, U1.39 (IO1)
/BTN_D2: R7.1, SW3.1, U1.38 (IO2)
/CC1: J1.A5 (CC1), R10.1
/CC2: J1.B5 (CC2), R11.1
/EN: C7.1, R8.2, SW5.1, TP3.1, U1.3 (EN)
/LCD_BL: R2.1, U1.26 (IO45)
/LCD_CS: J2.8 (CS), U1.35 (IO42)
/LCD_DC: J2.4 (DC), U1.33 (IO40)
/LCD_LEDA: J2.1 (LEDA), R1.2
/LCD_MOSI: J2.5 (SDA), U1.28 (IO35)
/LCD_RST: J2.3 (RESET), U1.34 (IO41)
/LCD_SCK: J2.6 (SCL), U1.29 (IO36)
/LED: R9.1, U1.21 (IO13)
/LED_A: D1.2 (A), R9.2
/RXD0: TP5.1, U1.36 (RXD0)
/S3_DN: U1.13 (IO19), U4.3 (IO2)
/S3_DP: U1.14 (IO20), U4.1 (IO1)
/SCL: R13.1, TP9.1, U1.4 (IO4), U2.6 (SCL)
/SDA: R12.1, TP8.1, U1.15 (IO3), U2.5 (SDA)
/TXD0: TP4.1, U1.37 (TXD0)
/USB_DN: J1.A7 (D-), J1.B7 (D-), U4.4 (IO2)
/USB_DP: J1.A6 (D+), J1.B6 (D+), U4.6 (IO1)
GND: C1.2, C2.2, C3.2, C4.2, C5.2, C6.2, C7.2, D1.1 (K), J1.A1 (GND), J1.A12 (GND), J1.B1 (GND), J1.B12 (GND), J1.SH (SHIELD), J2.2 (GND), Q1.2 (E), R3.2, R6.2, R7.2, R10.2, R11.2, SW1.2, SW4.2, SW5.2, TP2.1, TP6.1, U1.1 (GND), U1.40 (GND), U1.41 (EPAD), U2.4 (GND), U2.9 (EP), U3.2 (GND), U4.2 (GND)
VBUS: C1.1, J1.A4 (VBUS), J1.A9 (VBUS), J1.B4 (VBUS), J1.B9 (VBUS), Q2.2 (S), R4.1, U3.1 (VIN), U3.3 (CE), U4.5 (VBUS)

Notes on the sheet:
ESP32-S3-WROOM-1-N8R2 on the back, hand-soldered. The Feather ESP32-S3 Reverse TFT's GPIOs (firmware/board.py, "feather-s3"), so today's console image runs unchanged. Never an R8 module: octal PSRAM takes GPIO35-37.
USB-C: 5 V in and the S3's own USB-Serial-JTAG on D+/D- (GPIO20/19): esptool and tools/fw, no bridge chip. 5.1k Rd on each CC. U4's rail on VBUS clamps it too.
The panel: 1.14in 240x135 ST7789 on an 8-pin 0.5 mm ribbon, one seller's pin order (DESIGN.md). Its LEDK is GND inside, so Q2 switches LEDA from VBUS on the high side, R1 setting 13 mA; GPIO45 high is on, as on the Feather. R3 holds GPIO45 (a strap: VDD_SPI) low at reset.
D0, D1, D2: the Feather's buttons on its GPIOs. D0 is BOOT: low when pressed, R5 up. D1, D2 high when pressed, R6 and R7 down. BOOT is D0 again; RESET pulls EN low.
EN: R8 and C7, Espressif's RC delay. C3, C4 at the module's 3V3. D1: the status LED on GPIO13, the Feather's.
Bare pads on the back: 3V3, GND, EN, TX, RX; then GND, 3V3, SDA, SCL for a key-c on wires.

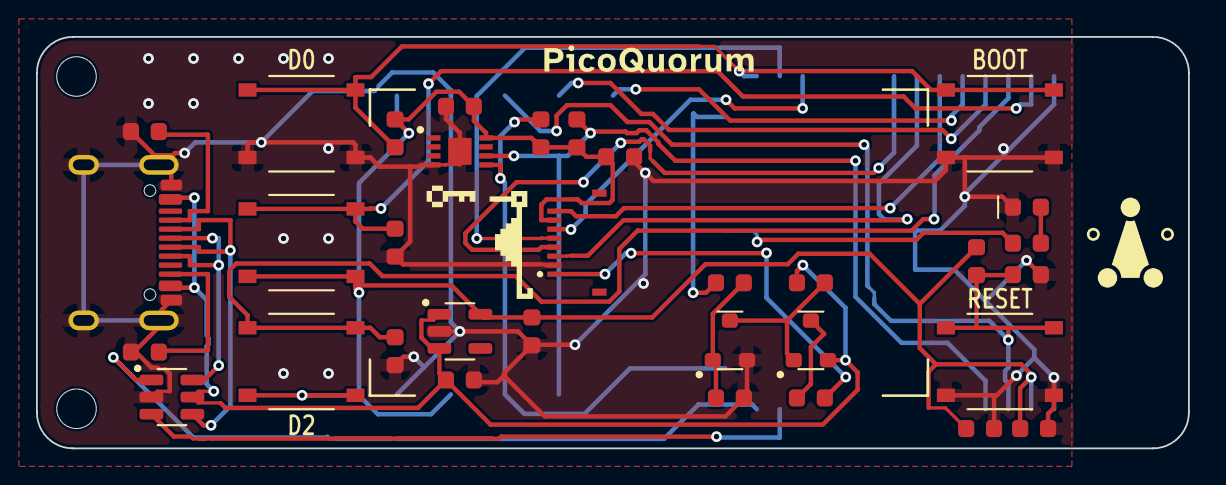
[picture p483: board console-s3.kicad_pcb from above]

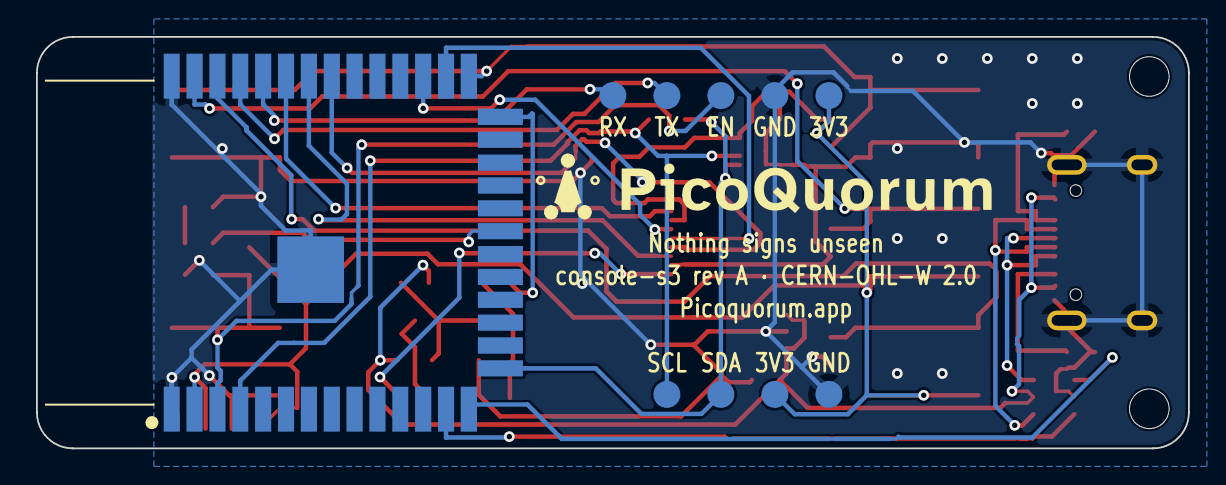
[picture p484: board console-s3.kicad_pcb from below]

Board: 2 copper layers, 64.0 x 22.9 mm, 45 parts (10 on the bottom side), 29 nets.

Other parts of the board:
H1, H2: M2; MountingHole_2.2mm
