jmcpheron/pico-quorum/hardware/prototypes/picoquorum-key/hardware/picoquorum-key/picoquorum-key.kicad_pcb

## KiCad design hardware/prototypes/picoquorum-key/hardware/picoquorum-key/picoquorum-key.kicad_pcb (2026-11-06)

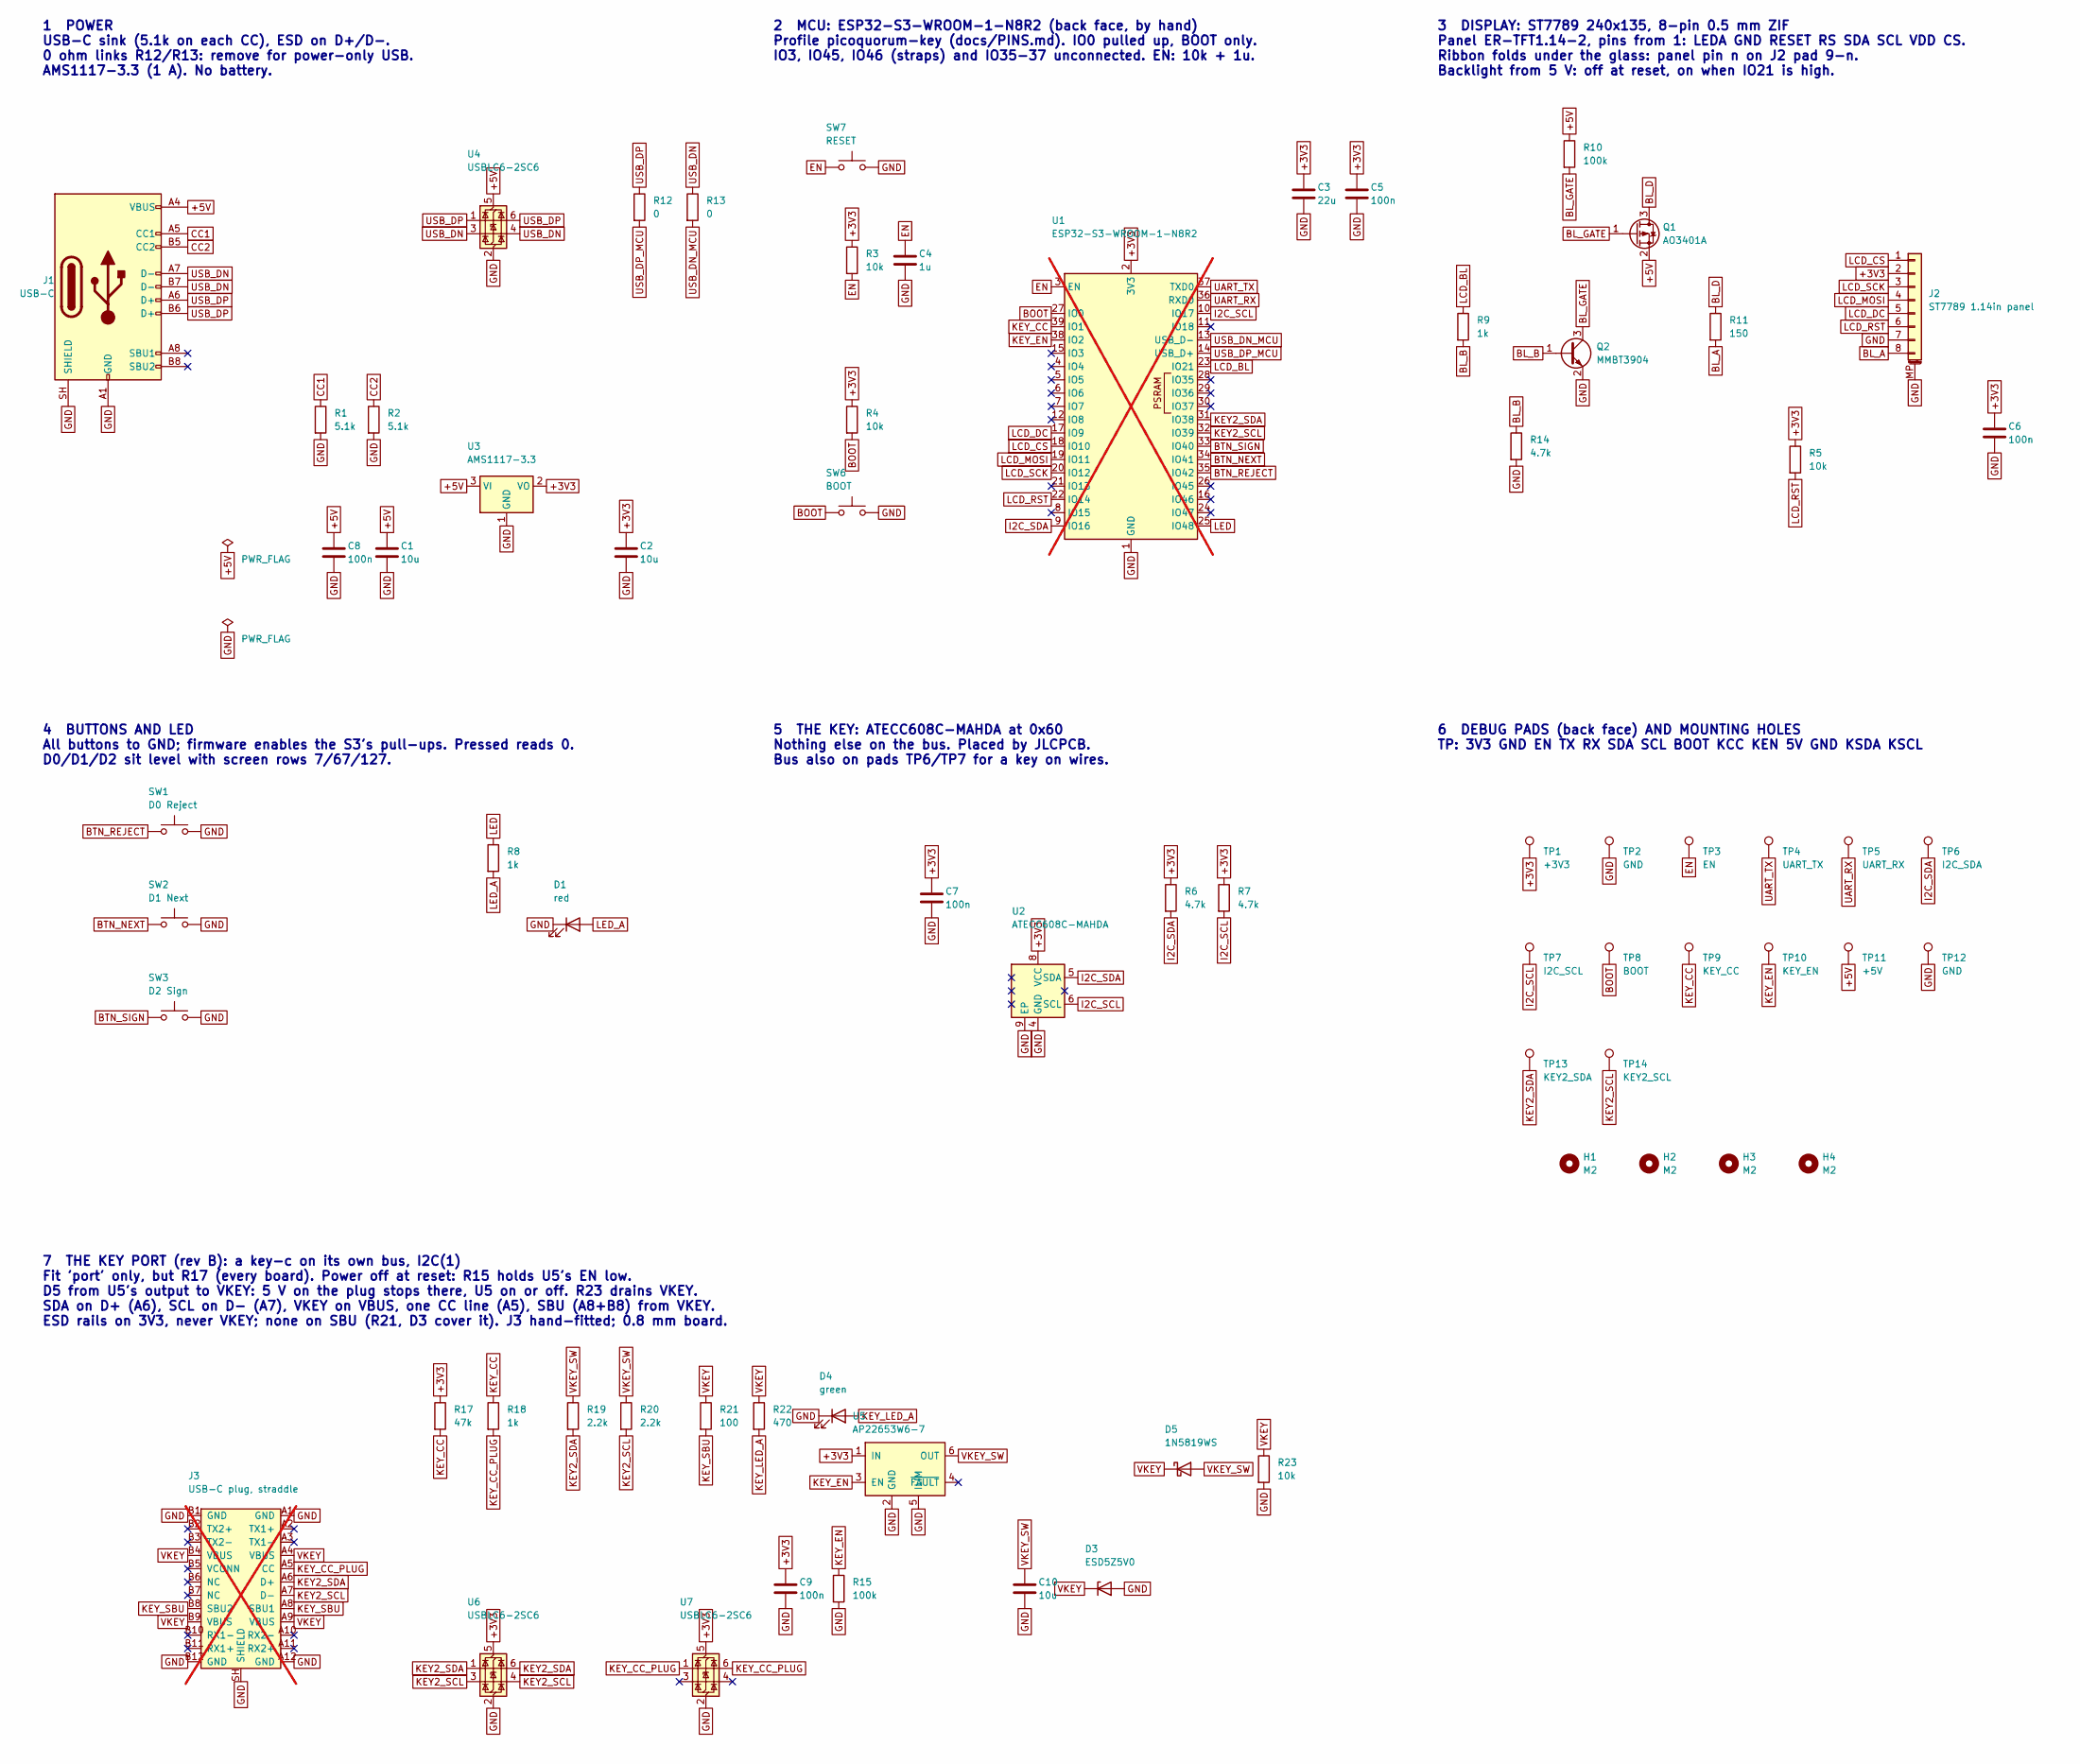
[picture p485: schematic picoquorum-key.kicad_sch, picoquorum-key: one owner of a Safe multisig]

Parts:
C1, C2, C10: 10u; C_0805_2012Metric; MPN 10u; LCSC C15850
C3: 22u; C_0805_2012Metric; MPN 22u; LCSC C45783
C4: 1u; C_0603_1608Metric; MPN 1u; LCSC C15849
C5, C6, C7, C8, C9: 100n; C_0603_1608Metric; MPN 100n; LCSC C14663
D1: red; LED_0603_1608Metric; MPN KT-0603R; LCSC C2286
D3: ESD5Z5V0; D_SOD-523; MPN ESD5Z5V0; LCSC C502546
D4: green; LED_0603_1608Metric; MPN KT-0603G; LCSC C12624
D5: 1N5819WS; D_SOD-323; MPN 1N5819WS; LCSC C191023
H1, H2, H3, H4: M2; MountingHole_2.2mm_M2; MPN M2
J1: USB-C; USB_C_Receptacle_HRO_TYPE-C-31-M-12_Edge; MPN HRO TYPE-C-31-M-12; LCSC C165948
J2: ST7789 1.14in panel; FPC_0.5mm_8P_C2919492; MPN HDGC 0.5K-HX-8PWB; LCSC C2919492
J3: USB-C plug, straddle; USB_C_Plug_ShouHan_24P-GTJB_Straddle; MPN TYPE-C 24P-GTJB 040; LCSC C3151751; not fitted
Q1: AO3401A; SOT-23; MPN AO3401A; LCSC C15127
Q2: MMBT3904; SOT-23; MPN MMBT3904; LCSC C20526
R1, R2: 5.1k; R_0603_1608Metric; MPN 5.1k; LCSC C23186
R3, R4, R5, R23: 10k; R_0603_1608Metric; MPN 10k; LCSC C25804
R6, R7, R14: 4.7k; R_0603_1608Metric; MPN 4.7k; LCSC C23162
R8, R9, R18: 1k; R_0603_1608Metric; MPN 1k; LCSC C21190
R10, R15: 100k; R_0603_1608Metric; MPN 100k; LCSC C25803
R11: 150; R_0603_1608Metric; MPN 150; LCSC C22808
R12, R13: 0; R_0603_1608Metric; MPN 0; LCSC C21189
R17: 47k; R_0603_1608Metric; MPN 47k; LCSC C25819
R19, R20: 2.2k; R_0603_1608Metric; MPN 2.2k; LCSC C4190
R21: 100; R_0603_1608Metric; MPN 100; LCSC C22775
R22: 470; R_0603_1608Metric; MPN 470; LCSC C23179
SW1: D0 Reject; SW_Tact_4.5x4.5_C2897501; MPN BOOMELE 4.5x4.5x3.8 SMD tact; LCSC C2897501
SW2: D1 Next; SW_Tact_4.5x4.5_C2897501; MPN BOOMELE 4.5x4.5x3.8 SMD tact; LCSC C2897501
SW3: D2 Sign; SW_Tact_4.5x4.5_C2897501; MPN BOOMELE 4.5x4.5x3.8 SMD tact; LCSC C2897501
SW6: BOOT; SW_Tact_4.5x4.5_C2897501; MPN BOOMELE 4.5x4.5x3.8 SMD tact; LCSC C2897501
SW7: RESET; SW_Tact_4.5x4.5_C2897501; MPN BOOMELE 4.5x4.5x3.8 SMD tact; LCSC C2897501
TP1: +3V3; TestPoint_Pad_1.5x1.5mm; MPN +3V3
TP2, TP12: GND; TestPoint_Pad_1.5x1.5mm; MPN GND
TP3: EN; TestPoint_Pad_1.5x1.5mm; MPN EN
TP4: UART_TX; TestPoint_Pad_1.5x1.5mm; MPN UART_TX
TP5: UART_RX; TestPoint_Pad_1.5x1.5mm; MPN UART_RX
TP6: I2C_SDA; TestPoint_Pad_1.5x1.5mm; MPN I2C_SDA
TP7: I2C_SCL; TestPoint_Pad_1.5x1.5mm; MPN I2C_SCL
TP8: BOOT; TestPoint_Pad_1.5x1.5mm; MPN BOOT
TP9: KEY_CC; TestPoint_Pad_1.5x1.5mm; MPN KEY_CC
TP10: KEY_EN; TestPoint_Pad_1.5x1.5mm; MPN KEY_EN
TP11: +5V; TestPoint_Pad_1.5x1.5mm; MPN +5V
TP13: KEY2_SDA; TestPoint_Pad_1.5x1.5mm; MPN KEY2_SDA
TP14: KEY2_SCL; TestPoint_Pad_1.5x1.5mm; MPN KEY2_SCL
U1: ESP32-S3-WROOM-1-N8R2; ESP32-S3-WROOM-1_HandSolder; MPN ESP32-S3-WROOM-1-N8R2; LCSC C2913204; not fitted
U2: ATECC608C-MAHDA; DFN-8-1EP_3x2mm_P0.5mm_EP1.3x1.5mm; MPN ATECC608C-MAHDA-S; LCSC C23291019
U3: AMS1117-3.3; SOT-223-3_TabPin2; MPN AMS1117-3.3; LCSC C6186
U4, U6, U7: USBLC6-2SC6; SOT-23-6; MPN USBLC6-2SC6; LCSC C7519
U5: AP22653W6-7; SOT-23-6; MPN AP22653W6-7; LCSC C2158037

Connections:
+3V3: C2.1, C3.1, C5.1, C6.1, C7.1, C9.1, J2.2, R3.1, R4.1, R5.1, R6.1, R7.1, R17.1, TP1.1, U1.2 (3V3), U2.8 (VCC), U3.2 (VO), U5.1 (IN), U6.5 (VBUS), U7.5 (VBUS)
+5V: C1.1, C8.1, J1.A4 (VBUS), J1.A9 (VBUS), J1.B4 (VBUS), J1.B9 (VBUS), Q1.2 (S), R10.1, TP11.1, U3.3 (VI), U4.5 (VBUS)
BL_A: J2.8, R11.2
BL_B: Q2.1 (B), R9.2, R14.1
BL_D: Q1.3 (D), R11.1
BL_GATE: Q1.1 (G), Q2.3 (C), R10.2
BOOT: R4.2, SW6.1, TP8.1, U1.27 (IO0)
BTN_NEXT: SW2.1, U1.34 (IO41)
BTN_REJECT: SW1.1, U1.35 (IO42)
BTN_SIGN: SW3.1, U1.33 (IO40)
CC1: J1.A5 (CC1), R1.1
CC2: J1.B5 (CC2), R2.1
EN: C4.1, R3.2, SW7.1, TP3.1, U1.3 (EN)
GND: C1.2, C2.2, C3.2, C4.2, C5.2, C6.2, C7.2, C8.2, C9.2, C10.2, D1.1 (K), D3.2 (A), D4.1 (K), J1.A1 (GND), J1.A12 (GND), J1.B1 (GND), J1.B12 (GND), J1.SH (SHIELD), J2.7, J2.MP (MountPin), J3.A1 (GND), J3.A12 (GND), J3.B1 (GND), J3.B12 (GND), J3.SH (SHIELD), Q2.2 (E), R1.2, R2.2, R14.2, R15.2, R23.2, SW1.2, SW2.2, SW3.2, SW6.2, SW7.2, TP2.1, TP12.1, U1.1 (GND), U1.40 (GND), U1.41 (GND), U2.4 (GND), U2.9 (EP), U3.1 (GND), U4.2 (GND), U5.2 (GND), U5.5 (ILIM), U6.2 (GND), U7.2 (GND)
I2C_SCL: R7.2, TP7.1, U1.10 (IO17), U2.6 (SCL)
I2C_SDA: R6.2, TP6.1, U1.9 (IO16), U2.5 (SDA)
KEY2_SCL: J3.A7 (D-), R20.2, TP14.1, U1.32 (IO39), U6.3 (I/O2), U6.4 (I/O2)
KEY2_SDA: J3.A6 (D+), R19.2, TP13.1, U1.31 (IO38), U6.1 (I/O1), U6.6 (I/O1)
KEY_CC: R17.2, R18.1, TP9.1, U1.39 (IO1)
KEY_CC_PLUG: J3.A5 (CC), R18.2, U7.1 (I/O1), U7.6 (I/O1)
KEY_EN: R15.1, TP10.1, U1.38 (IO2), U5.3 (EN)
KEY_LED_A: D4.2 (A), R22.2
KEY_SBU: J3.A8 (SBU1), J3.B8 (SBU2), R21.2
LCD_BL: R9.1, U1.23 (IO21)
LCD_CS: J2.1, U1.18 (IO10)
LCD_DC: J2.5, U1.17 (IO9)
LCD_MOSI: J2.4, U1.19 (IO11)
LCD_RST: J2.6, R5.2, U1.22 (IO14)
LCD_SCK: J2.3, U1.20 (IO12)
LED: R8.1, U1.25 (IO48)
LED_A: D1.2 (A), R8.2
UART_RX: TP5.1, U1.36 (RXD0)
UART_TX: TP4.1, U1.37 (TXD0)
USB_DN: J1.A7 (D-), J1.B7 (D-), R13.1, U4.3 (I/O2), U4.4 (I/O2)
USB_DN_MCU: R13.2, U1.13 (USB_D-)
USB_DP: J1.A6 (D+), J1.B6 (D+), R12.1, U4.1 (I/O1), U4.6 (I/O1)
USB_DP_MCU: R12.2, U1.14 (USB_D+)
VKEY: D3.1 (K), D5.1 (K), J3.A4 (VBUS), J3.A9 (VBUS), J3.B4 (VBUS), J3.B9 (VBUS), R21.1, R22.1, R23.1
VKEY_SW: C10.1, D5.2 (A), R19.1, R20.1, U5.6 (OUT)

Notes on the sheet:
1 POWER USB-C sink (5.1k on each CC), ESD on D+/D-. 0 ohm links R12/R13: remove for power-only USB. AMS1117-3.3 (1 A). No battery.
2 MCU: ESP32-S3-WROOM-1-N8R2 (back face, by hand) Profile picoquorum-key (docs/PINS.md). IO0 pulled up, BOOT only. IO3, IO45, IO46 (straps) and IO35-37 unconnected. EN: 10k + 1u.
3 DISPLAY: ST7789 240x135, 8-pin 0.5 mm ZIF Panel ER-TFT1.14-2, pins from 1: LEDA GND RESET RS SDA SCL VDD CS. Ribbon folds under the glass: panel pin n on J2 pad 9-n. Backlight from 5 V: off at reset, on when IO21 is high.
4 BUTTONS AND LED All buttons to GND; firmware enables the S3's pull-ups. Pressed reads 0. D0/D1/D2 sit level with screen rows 7/67/127.
5 THE KEY: ATECC608C-MAHDA at 0x60 Nothing else on the bus. Placed by JLCPCB. Bus also on pads TP6/TP7 for a key on wires.
6 DEBUG PADS (back face) AND MOUNTING HOLES TP: 3V3 GND EN TX RX SDA SCL BOOT KCC KEN 5V GND KSDA KSCL
7 THE KEY PORT (rev B): a key-c on its own bus, I2C(1) Fit 'port' only, but R17 (every board). Power off at reset: R15 holds U5's EN low. D5 from U5's output to VKEY: 5 V on the plug stops there, U5 on or off. R23 drains VKEY. SDA on D+ (A6), SCL on D- (A7), VKEY on VBUS, one CC line (A5), SBU (A8+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
