jmcpheron/pico-quorum/hardware/prototypes/picoquorum-key/hardware/picoquorum-key/picoquorum-key.kicad_pcb

## KiCad design hardware/prototypes/picoquorum-key/hardware/picoquorum-key/picoquorum-key.kicad_pcb (continued)

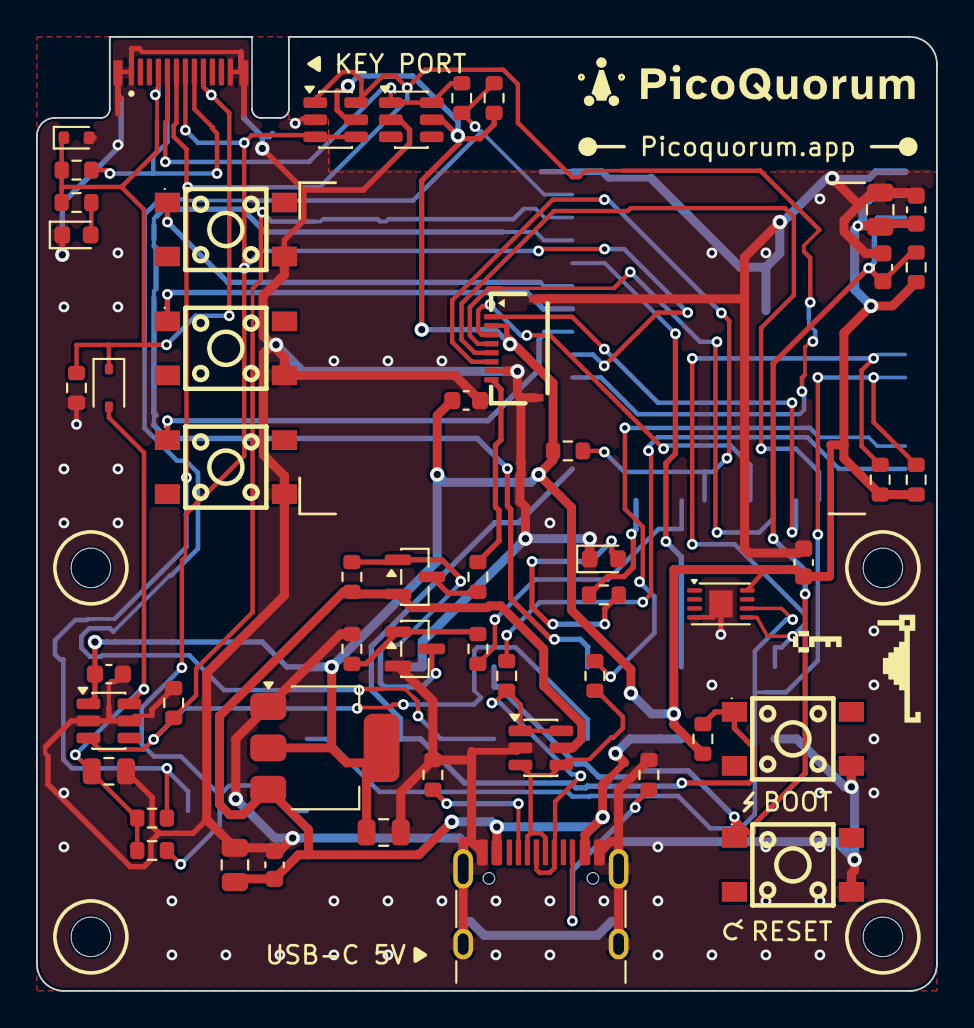
[picture p486: board picoquorum-key.kicad_pcb from above]

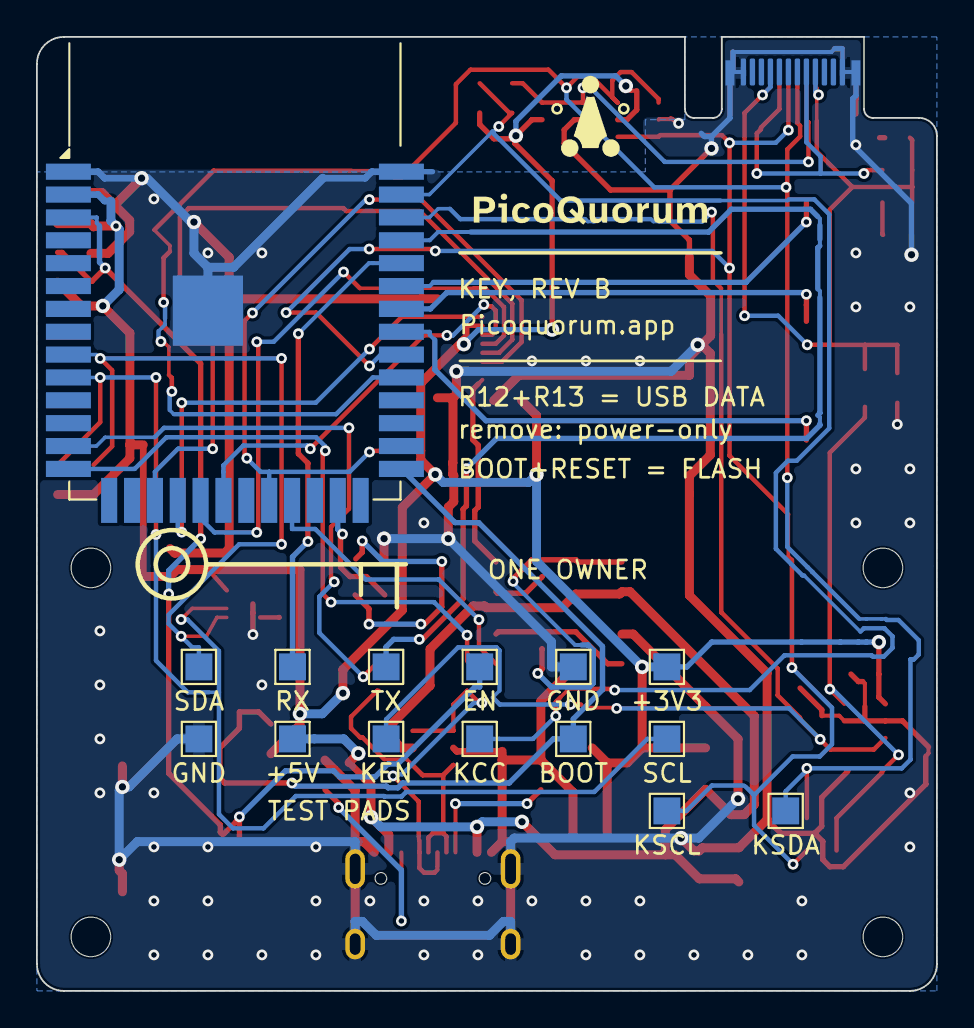
[picture p487: board picoquorum-key.kicad_pcb from below]

Board: 2 copper layers, 50.0 x 53.0 mm, 71 parts (15 on the bottom side), 39 nets.
