jmcpheron/pico-quorum/hardware/mono/mono/mono.kicad_pcb

## KiCad design hardware/mono/mono/mono.kicad_pcb (2026-11-07)

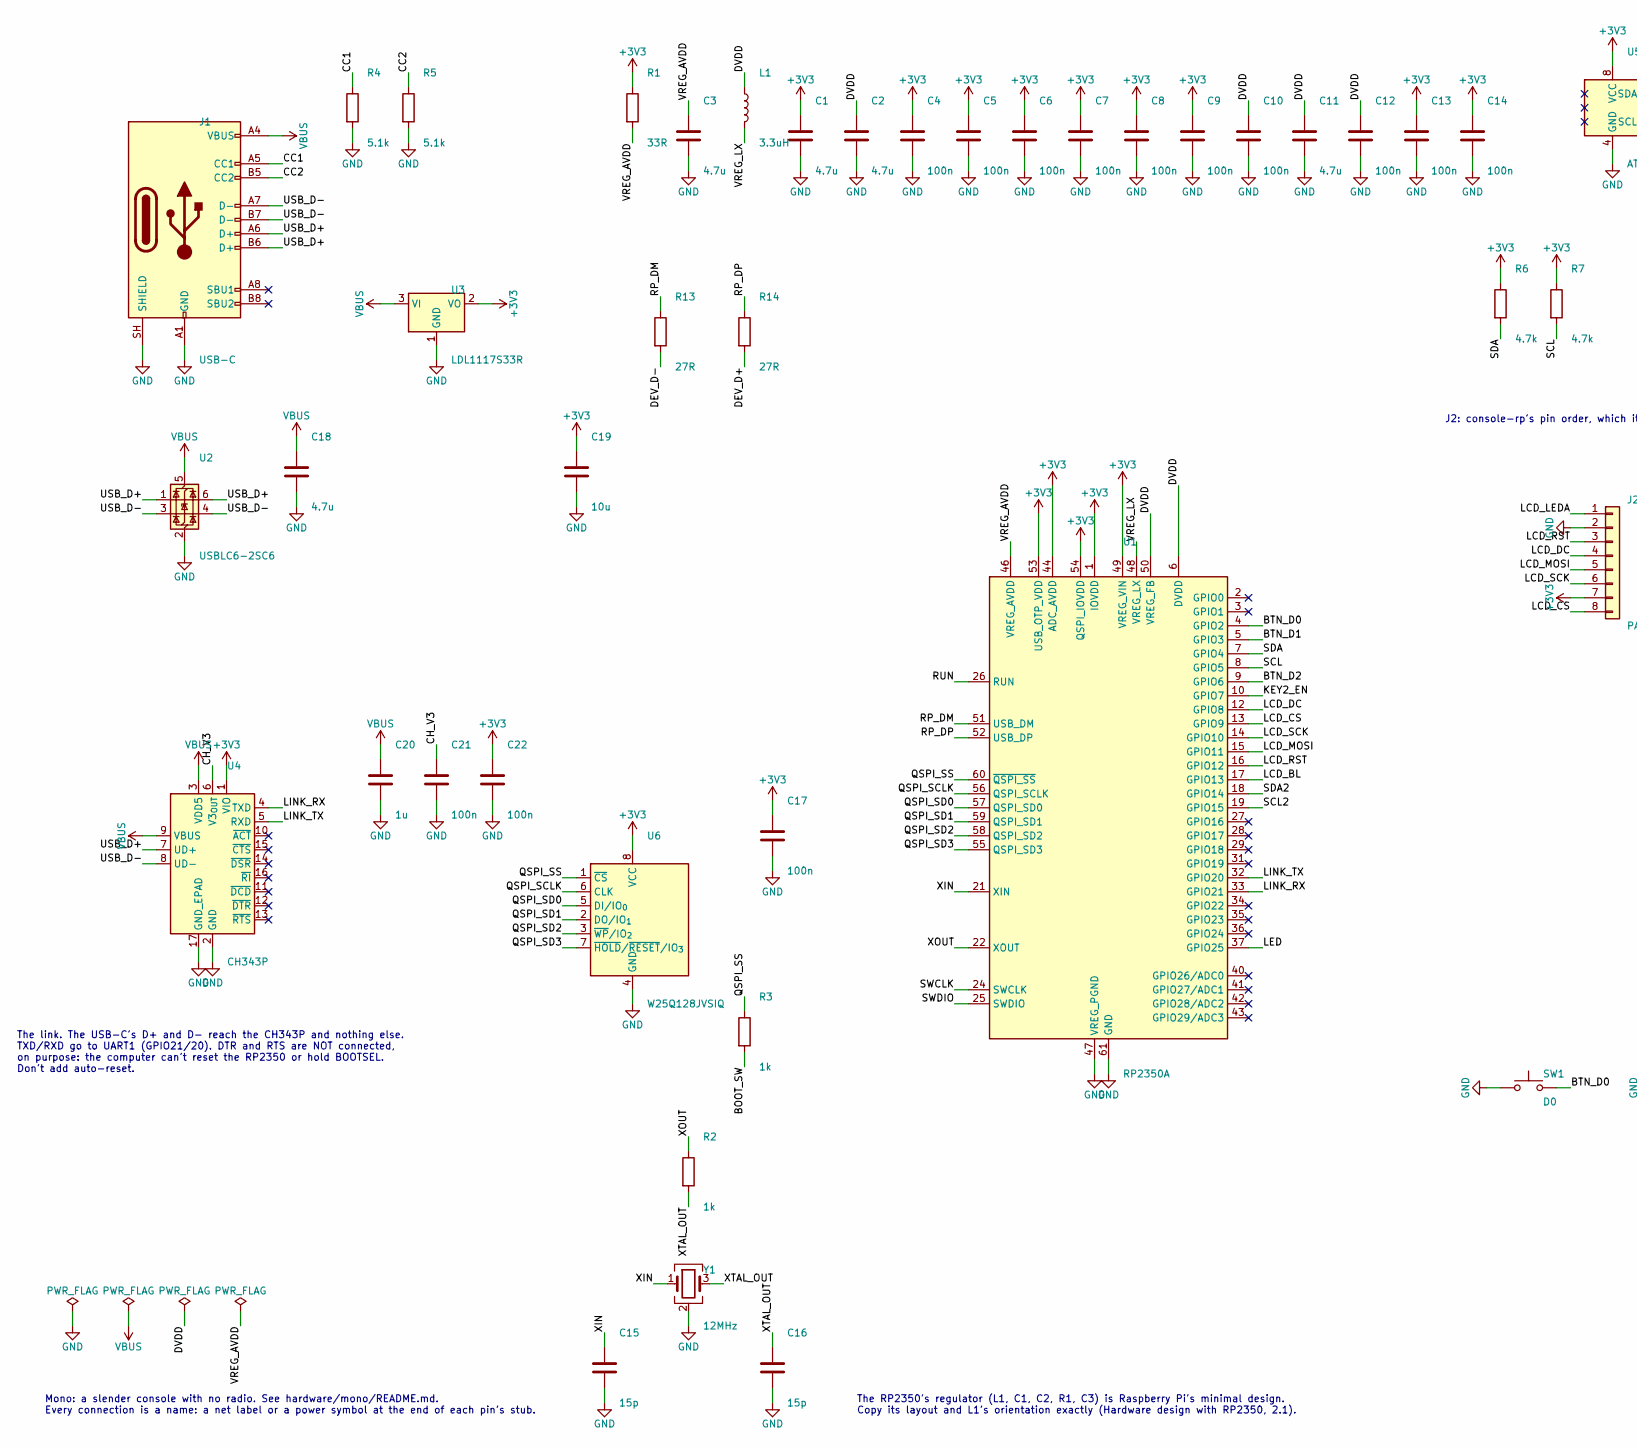
[picture p488: schematic mono.kicad_sch, Picoquorum Mono: a slender console, an RP2350, no radio, US…, part in row 1, column 1]

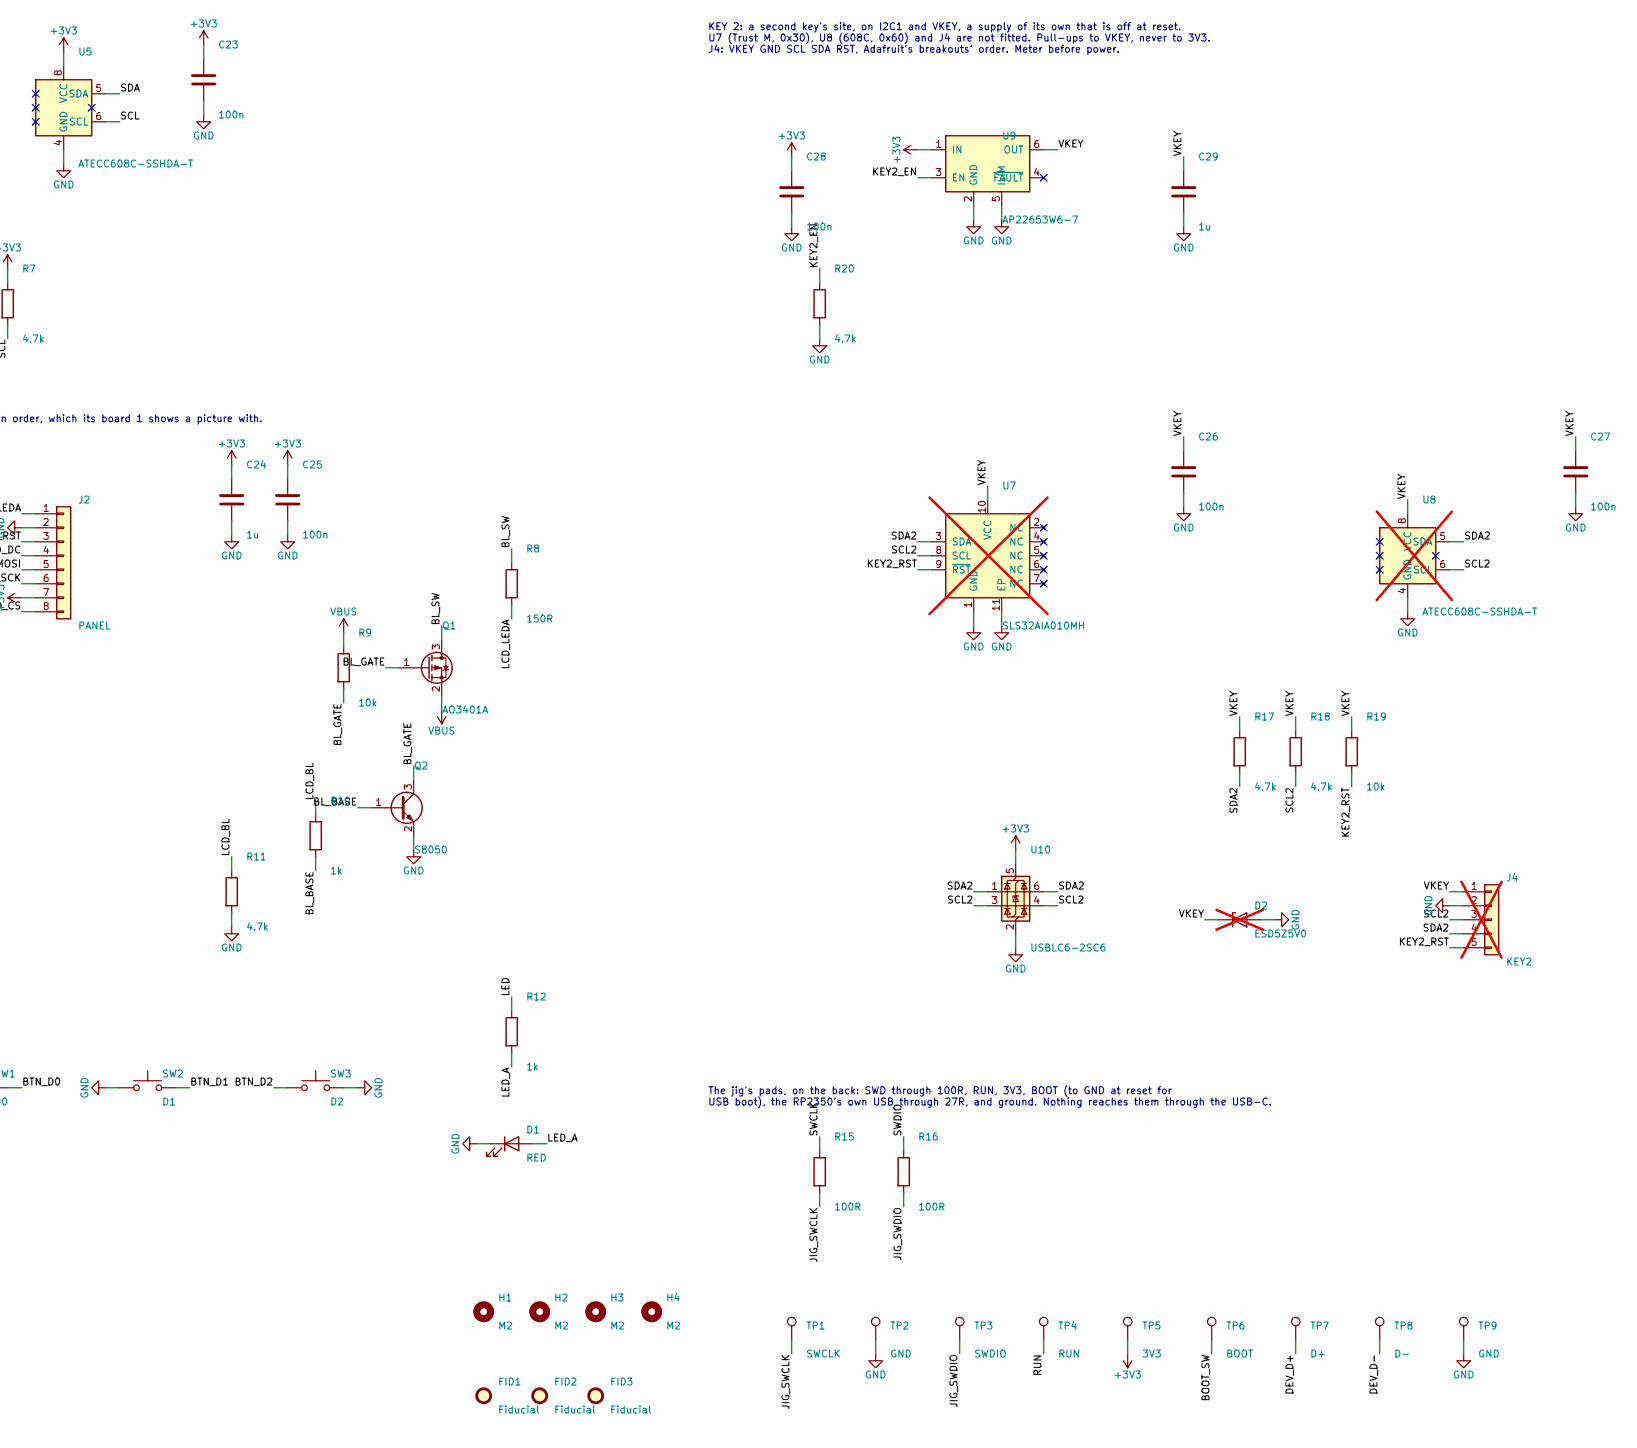
[picture p489: schematic mono.kicad_sch, Picoquorum Mono: a slender console, an RP2350, no radio, US…, part in row 1, column 2]

Parts:
C1, C2: 4.7u; RPi_C_0402_wide; LCSC C23733
C3, C11: 4.7u; RPi_C_0402; LCSC C23733
C4, C5, C6, C7, C8, C10, C12, C13, C14: 100n; RPi_C_0402; LCSC C1525
C9, C17, C21, C22, C23, C25, C26, C27, C28: 100n; C_0402_1005Metric; LCSC C1525
C15, C16: 15p; RPi_C_0402; LCSC C1548
C18: 4.7u; C_0402_1005Metric; LCSC C23733
C19: 10u; C_0805_2012Metric; LCSC C15850
C20, C24, C29: 1u; C_0402_1005Metric; LCSC C52923
D1: RED; LED_0603_1608Metric; MPN KT-0603R; LCSC C2286
D2: ESD5Z5V0; D_SOD-523; MPN ESD5Z5V0; LCSC C502546; not fitted
FID1, FID2, FID3: Fiducial; Fiducial_1mm_Mask2mm
H1, H2, H3, H4: M2; MountingHole_2.2mm_M2
J1: USB-C; USB_C_Receptacle_HRO_TYPE-C-31-M-12; MPN TYPE-C-31-M-12; LCSC C165948
J2: PANEL; FPC_ZIF_8P_P0.5mm_HDGC_0.5K-HX-8PWB; MPN 0.5K-HX-8PWB; LCSC C2919492
J4: KEY2; PinHeader_1x05_P2.54mm_Vertical; not fitted
L1: 3.3uH; RPi_L_Abracon_AOTA-B201610; MPN AOTA-B201610S3R3-101-T; LCSC C42411119
Q1: AO3401A; SOT-23; LCSC C15127
Q2: S8050; SOT-23; MPN SS8050; LCSC C2150
R1: 33R; RPi_R_0402; LCSC C25105
R2: 1k; RPi_R_0402; LCSC C11702
R3, R10, R12: 1k; R_0402_1005Metric; LCSC C11702
R4, R5: 5.1k; R_0402_1005Metric; LCSC C25905
R6, R7, R11, R17, R18, R20: 4.7k; R_0402_1005Metric; LCSC C25900
R8: 150R; R_0603_1608Metric; LCSC C22808
R9, R19: 10k; R_0402_1005Metric; LCSC C25744
R13, R14: 27R; RPi_R_0402; LCSC C25100
R15, R16: 100R; R_0402_1005Metric; LCSC C25076
SW1: D0; SW_Push_1P1T_XKB_TS-1187A; MPN TS-1187A-B-A-B; LCSC C318884
SW2: D1; SW_Push_1P1T_XKB_TS-1187A; MPN TS-1187A-B-A-B; LCSC C318884
SW3: D2; SW_Push_1P1T_XKB_TS-1187A; MPN TS-1187A-B-A-B; LCSC C318884
TP1: SWCLK; TestPoint_Pad_D1.5mm
TP2, TP9: GND; TestPoint_Pad_D1.5mm
TP3: SWDIO; TestPoint_Pad_D1.5mm
TP4: RUN; TestPoint_Pad_D1.5mm
TP5: 3V3; TestPoint_Pad_D1.5mm
TP6: BOOT; TestPoint_Pad_D1.5mm
TP7: D+; TestPoint_Pad_D1.5mm
TP8: D-; TestPoint_Pad_D1.5mm
U1: RP2350A; RPi_RP2350A_QFN-60_7x7mm_P0.4mm_ThermalVias; MPN RP2350A; LCSC C42411118
U2, U10: USBLC6-2SC6; SOT-23-6; LCSC C7519
U3: LDL1117S33R; SOT-223-3_TabPin2; MPN LDL1117S33R; LCSC C435835
U4: CH343P; WCH_QFN-16-1EP_3x3mm_P0.5mm_EP1.8x1.8mm; MPN CH343P; LCSC C2846043
U5: ATECC608C-SSHDA-T; SOIC-8_3.9x4.9mm_P1.27mm; MPN ATECC608C-SSHDA-T; LCSC C28975195
U6: W25Q128JVSIQ; SOIC-8_5.3x5.3mm_P1.27mm; MPN W25Q128JVSIQ; LCSC C97521
U7: SLS32AIA010MH; Microchip_USON-10-1EP_3x3mm_P0.5mm_EP1.8x2.5mm; MPN SLS32AIA010MH; LCSC C539250; not fitted
U8: ATECC608C-SSHDA-T; SOIC-8_3.9x4.9mm_P1.27mm; MPN ATECC608C-SSHDA-T; LCSC C28975195; not fitted
U9: AP22653W6-7; SOT-23-6; MPN AP22653W6-7; LCSC C2158037
Y1: 12MHz; RPi_Crystal_SMD_3225-4Pin_3.2x2.5mm; MPN ABM8-272-T3; LCSC C20625731

Connections:
+3V3: C1.1, C4.1, C5.1, C6.1, C7.1, C8.1, C9.1, C13.1, C14.1, C17.1, C19.1, C22.1, C23.1, C24.1, C25.1, C28.1, J2.7, R1.1, R6.1, R7.1, TP5.1, U1.1 (IOVDD), U1.11 (IOVDD), U1.20 (IOVDD), U1.30 (IOVDD), U1.38 (IOVDD), U1.44 (ADC_AVDD), U1.45 (IOVDD), U1.49 (VREG_VIN), U1.53 (USB_OTP_VDD), U1.54 (QSPI_IOVDD), U3.2 (VO), U4.1 (VIO), U5.8 (VCC), U6.8 (VCC), U9.1 (IN), U10.5 (VBUS)
/BL_BASE: Q2.1 (B), R10.2
/BL_GATE: Q1.1 (G), Q2.3 (C), R9.2
/BL_SW: Q1.3 (D), R8.1
/BOOT_SW: R3.2, TP6.1
/BTN_D0: SW1.2, U1.4 (GPIO2)
/BTN_D1: SW2.2, U1.5 (GPIO3)
/BTN_D2: SW3.1, U1.9 (GPIO6)
/CC1: J1.A5 (CC1), R4.1
/CC2: J1.B5 (CC2), R5.1
/CH_V3: C21.1, U4.6 (V3_{OUT})
/DEV_D+: R14.2, TP7.1
/DEV_D-: R13.2, TP8.1
/DVDD: C2.1, C10.1, C11.1, C12.1, L1.1, U1.6 (DVDD), U1.23 (DVDD), U1.39 (DVDD), U1.50 (VREG_FB)
/JIG_SWCLK: R15.2, TP1.1
/JIG_SWDIO: R16.2, TP3.1
/KEY2_EN: R20.1, U1.10 (GPIO7), U9.3 (EN)
/KEY2_RST: J4.5, R19.2, U7.9 (~RST)
/LCD_BL: R10.1, R11.1, U1.17 (GPIO13)
/LCD_CS: J2.8, U1.13 (GPIO9)
/LCD_DC: J2.4, U1.12 (GPIO8)
/LCD_LEDA: J2.1, R8.2
/LCD_MOSI: J2.5, U1.15 (GPIO11)
/LCD_RST: J2.3, U1.16 (GPIO12)
/LCD_SCK: J2.6, U1.14 (GPIO10)
/LED: R12.1, U1.37 (GPIO25)
/LED_A: D1.2 (A), R12.2
/LINK_RX: U1.33 (GPIO21), U4.4 (TXD)
/LINK_TX: U1.32 (GPIO20), U4.5 (RXD)
/QSPI_SCLK: U1.56 (QSPI_SCLK), U6.6 (CLK)
/QSPI_SD0: U1.57 (QSPI_SD0), U6.5 (DI/IO_{0})
/QSPI_SD1: U1.59 (QSPI_SD1), U6.2 (DO/IO_{1})
/QSPI_SD2: U1.58 (QSPI_SD2), U6.3 (~WP/IO_{2})
/QSPI_SD3: U1.55 (QSPI_SD3), U6.7 (~HOLD/~RESET/IO_{3})
/QSPI_SS: R3.1, U1.60 (~QSPI_SS), U6.1 (~CS)
/RP_DM: R13.1, U1.51 (USB_DM)
/RP_DP: R14.1, U1.52 (USB_DP)
/RUN: TP4.1, U1.26 (RUN)
/SCL: R7.2, U1.8 (GPIO5), U5.6 (SCL)
/SCL2: J4.3, R18.2, U1.19 (GPIO15), U7.8 (SCL), U8.6 (SCL), U10.3 (I/O2), U10.4 (I/O2)
/SDA: R6.2, U1.7 (GPIO4), U5.5 (SDA)
/SDA2: J4.4, R17.2, U1.18 (GPIO14), U7.3 (SDA), U8.5 (SDA), U10.1 (I/O1), U10.6 (I/O1)
/SWCLK: R15.1, U1.24 (SWCLK)
/SWDIO: R16.1, U1.25 (SWDIO)
/USB_D+: J1.A6 (D+), J1.B6 (D+), U2.1 (I/O1), U2.6 (I/O1), U4.7 (UD+)
/USB_D-: J1.A7 (D-), J1.B7 (D-), U2.3 (I/O2), U2.4 (I/O2), U4.8 (UD-)
/VKEY: C26.1, C27.1, C29.1, D2.1 (K), J4.1, R17.1, R18.1, R19.1, U7.10 (VCC), U8.8 (VCC), U9.6 (OUT)
/VREG_AVDD: C3.1, R1.2, U1.46 (VREG_AVDD)
/VREG_LX: L1.2, U1.48 (VREG_LX)
/XIN: C15.1, U1.21 (XIN), Y1.1
/XOUT: R2.1, U1.22 (XOUT)
/XTAL_OUT: C16.1, R2.2, Y1.3
GND: C1.2, C2.2, C3.2, C4.2, C5.2, C6.2, C7.2, C8.2, C9.2, C10.2, C11.2, C12.2, C13.2, C14.2, C15.2, C16.2, C17.2, C18.2, C19.2, C20.2, C21.2, C22.2, C23.2, C24.2, C25.2, C26.2, C27.2, C28.2, C29.2, D1.1 (K), D2.2 (A), J1.A1 (GND), J1.A12 (GND), J1.B1 (GND), J1.B12 (GND), J1.SH (SHIELD), J2.2, J4.2, Q2.2 (E), R4.2, R5.2, R11.2, R20.2, SW1.1, SW2.1, SW3.2, TP2.1, TP9.1, U1.47 (VREG_PGND), U1.61 (GND), U2.2 (GND), U3.1 (GND), U4.2 (GND), U4.17 (GND_EPAD), U5.4 (GND), U6.4 (GND), U7.1 (GND), U7.11 (EP), U8.4 (GND), U9.2 (GND), U9.5 (ILIM), U10.2 (GND), Y1.2 (G), Y1.4 (G)
VBUS: C18.1, C20.1, J1.A4 (VBUS), J1.A9 (VBUS), J1.B4 (VBUS), J1.B9 (VBUS), Q1.2 (S), R9.1, U2.5 (VBUS), U3.3 (VI), U4.3 (VDD5), U4.9 (VBUS)

Notes on the sheet:
Mono: a slender console with no radio. See hardware/mono/README.md. Every connection is a name: a net label or a power symbol at the end of each pin's stub.
The link. The USB-C's D+ and D- reach the CH343P and nothing else. TXD/RXD go to UART1 (GPIO21/20). DTR and RTS are NOT connected, on purpose: the computer can't reset the RP2350 or hold BOOTSEL. Don't add auto-reset.
The RP2350's regulator (L1, C1, C2, R1, C3) is Raspberry Pi's minimal design. Copy its layout and L1's orientation exactly (Hardware design with RP2350, 2.1).
J2: console-rp's pin order, which its board 1 shows a picture with.
KEY 2: a second key's site, on I2C1 and VKEY, a supply of its own that is off at reset. U7 (Trust M, 0x30), U8 (608C, 0x60) and J4 are not fitted. Pull-ups to VKEY, never to 3V3. J4: VKEY GND SCL SDA RST, Adafruit's breakouts' order. Meter before power.
The jig's pads, on the back: SWD through 100R, RUN, 3V3, BOOT (to GND at reset for USB boot), the RP2350's own USB through 27R, and ground. Nothing reaches them through the USB-C.

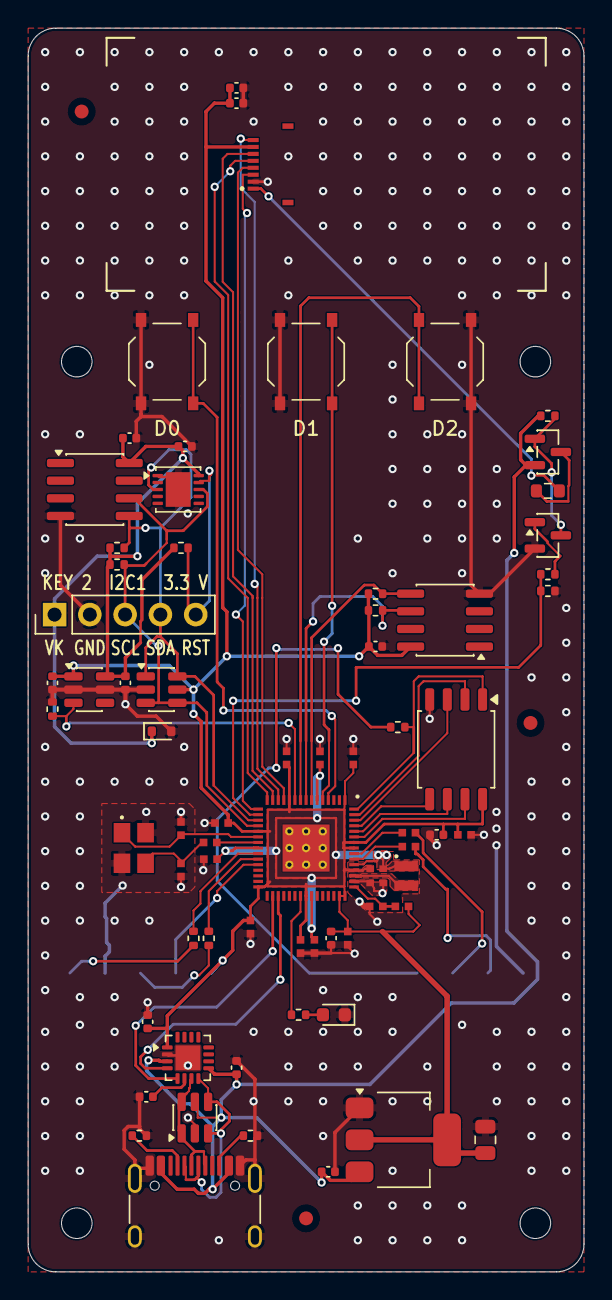
[picture p490: board mono.kicad_pcb from above]

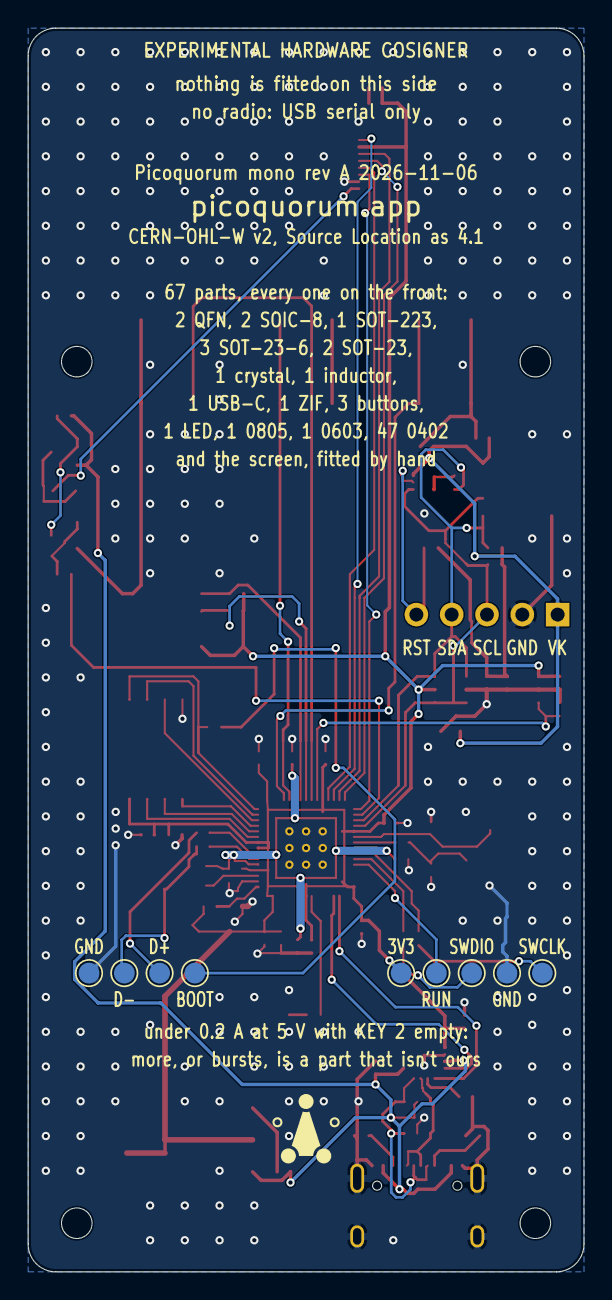
[picture p491: board mono.kicad_pcb from below]

Board: 2 copper layers, 40.0 x 89.5 mm, 89 parts (10 on the bottom side), 54 nets.

Other parts of the board:
LCD1: 1.14in 240x135; LCD_1.14in_240x135_on_tape
LOGO1: PicoQuorum_Mark
