jmcpheron/pico-quorum/hardware/key-pcb/key-c-usbc/key-c-usbc.kicad_pcb

## KiCad design hardware/key-pcb/key-c-usbc/key-c-usbc.kicad_pcb (2026-11-06)

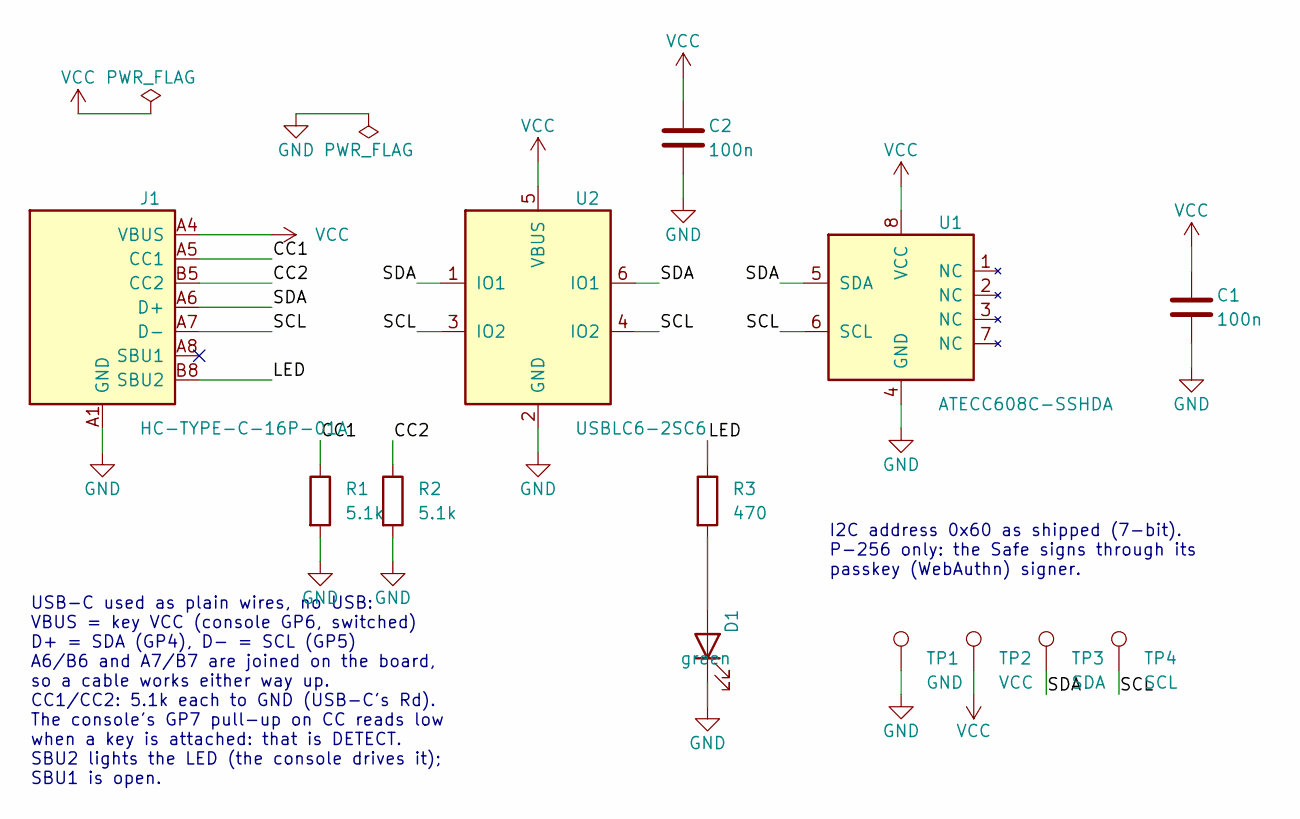
[picture p492: schematic key-c-usbc.kicad_sch, Picoquorum key, proposal C: USB-C receptacle]

Parts:
C1, C2: 100n; C_0402_1005Metric; LCSC C1525
D1: green; LED_0603_1608Metric; MPN Everlight 19-217/GHC-YR1S2/3T; LCSC C72043
J1: HC-TYPE-C-16P-01A; USB_C_Receptacle_HCTL_HC-TYPE-C-16P-01A_PQ; MPN HC-TYPE-C-16P-01A; LCSC C2894897
R1, R2: 5.1k; R_0402_1005Metric; LCSC C25905
R3: 470; R_0402_1005Metric; LCSC C25117
TP1: GND; TestPoint_Pad_D1.5mm
TP2: VCC; TestPoint_Pad_D1.5mm
TP3: SDA; TestPoint_Pad_D1.5mm
TP4: SCL; TestPoint_Pad_D1.5mm
U1: ATECC608C-SSHDA; SOIC-8_3.9x4.9mm_P1.27mm; MPN ATECC608C-SSHDA-B; LCSC C28975195
U2: USBLC6-2SC6; SOT-23-6; MPN USBLC6-2SC6; LCSC C7519

Connections:
/CC1: J1.A5 (CC1), R1.1
/CC2: J1.B5 (CC2), R2.1
/LED: J1.B8 (SBU2), R3.1
/SCL: J1.A7 (D-), J1.B7 (D-), TP4.1, U1.6 (SCL), U2.3 (IO2), U2.4 (IO2)
/SDA: J1.A6 (D+), J1.B6 (D+), TP3.1, U1.5 (SDA), U2.1 (IO1), U2.6 (IO1)
GND: C1.2, C2.2, D1.1 (K), J1.A1 (GND), J1.A12 (GND), J1.B1 (GND), J1.B12 (GND), J1.SH (SHIELD), R1.2, R2.2, TP1.1, U1.4 (GND), U2.2 (GND)
unnamed: D1.2 (A), R3.2
VCC: C1.1, C2.1, J1.A4 (VBUS), J1.A9 (VBUS), J1.B4 (VBUS), J1.B9 (VBUS), TP2.1, U1.8 (VCC), U2.5 (VBUS)

Notes on the sheet:
I2C address 0x60 as shipped (7-bit). P-256 only: the Safe signs through its passkey (WebAuthn) signer.
USB-C used as plain wires, no USB: VBUS = key VCC (console GP6, switched) D+ = SDA (GP4), D- = SCL (GP5) A6/B6 and A7/B7 are joined on the board, so a cable works either way up. CC1/CC2: 5.1k each to GND (USB-C's Rd). The console's GP7 pull-up on CC reads low when a key is attached: that is DETECT.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

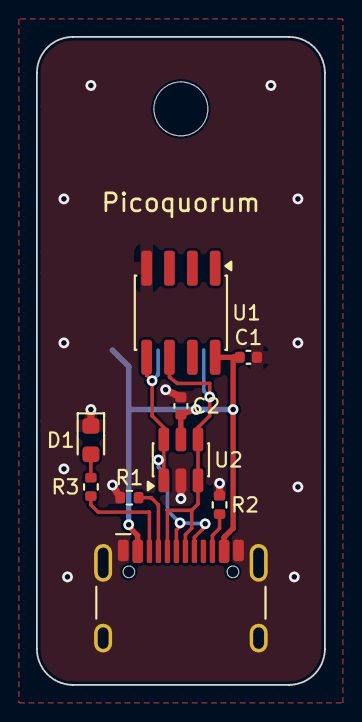
[picture p493: board key-c-usbc.kicad_pcb from above]

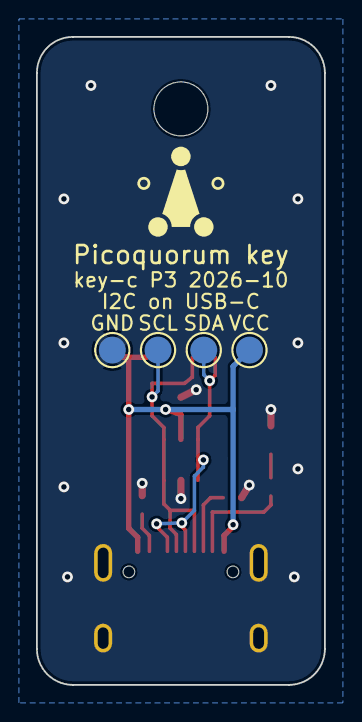
[picture p494: board key-c-usbc.kicad_pcb from below]

Board: 2 copper layers, 16.0 x 36.0 mm, 15 parts (5 on the bottom side), 8 nets.

Other parts of the board:
H1: Lanyard; MountingHole_3mm
LOGO1: PicoQuorum_Mark
