jmcpheron/pico-quorum/hardware/console-pcb/console-a/console-a.kicad_pcb

## KiCad design hardware/console-pcb/console-a/console-a.kicad_pcb (2026-11-06)

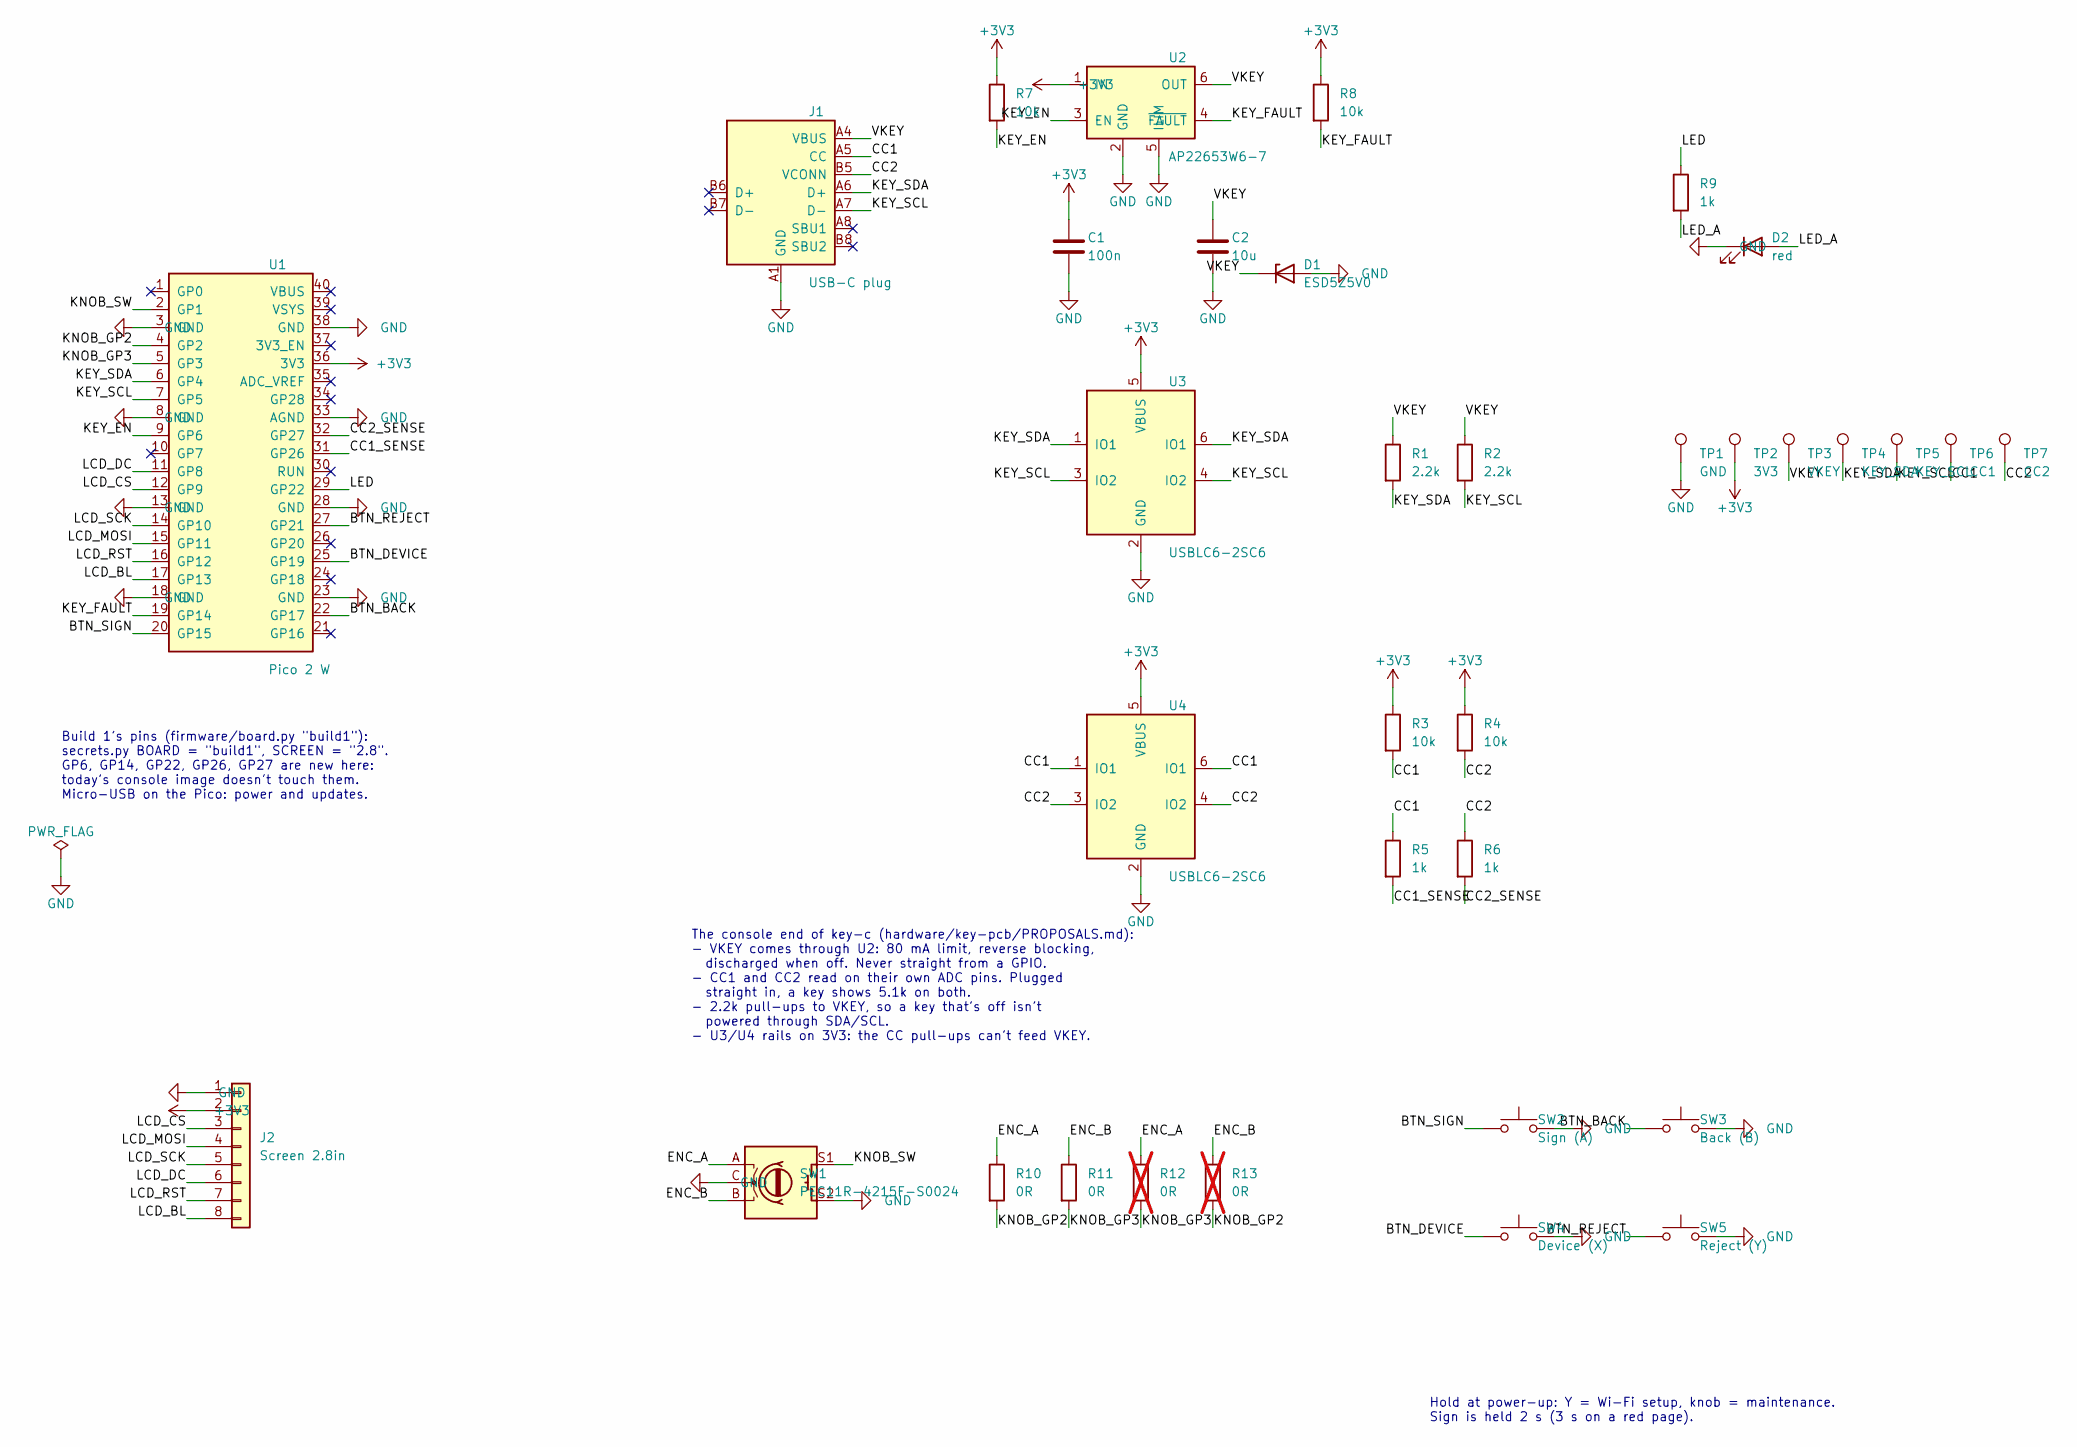
[picture p495: schematic console-a.kicad_sch, Picoquorum console, proposal A: Pico 2 W carrier]

Parts:
C1: 100n; C_0402_1005Metric; LCSC C1525
C2: 10u; C_0603_1608Metric; LCSC C19702
D1: ESD5Z5V0; D_SOD-523; MPN ESD5Z5V0; LCSC C502546
D2: red; LED_0603_1608Metric; MPN KT-0603R; LCSC C2286
J1: USB-C plug; USB_C_Plug_ShenzhenJingTuoJin_918-118A2021Y40002_Vertical; MPN 918-118A2021Y40002; LCSC C399939
J2: Screen 2.8in; Screen_ST7789_2.8in_8P_PLACEHOLDER; MPN 2.8in 240x320 ST7789 SPI module, 8-pin
R1, R2: 2.2k; R_0402_1005Metric; LCSC C25879
R3, R4, R7, R8: 10k; R_0402_1005Metric; LCSC C25744
R5, R6, R9: 1k; R_0402_1005Metric; LCSC C11702
R10, R11: 0R; R_0402_1005Metric; LCSC C17168
R12, R13: 0R; R_0402_1005Metric; LCSC C17168; not fitted
SW1: PEC11R-4215F-S0024; RotaryEncoder_Bourns_PEC11R-S_Vertical; MPN PEC11R-4215F-S0024
SW2: Sign (A); SW_HRO_K2-1102SP_6x6mm; MPN K2-1102SP-K4SC-04; LCSC C129461
SW3: Back (B); SW_HRO_K2-1102SP_6x6mm; MPN K2-1102SP-K4SC-04; LCSC C129461
SW4: Device (X); SW_HRO_K2-1102SP_6x6mm; MPN K2-1102SP-K4SC-04; LCSC C129461
SW5: Reject (Y); SW_HRO_K2-1102SP_6x6mm; MPN K2-1102SP-K4SC-04; LCSC C129461
TP1: GND; TestPoint_Pad_D1.5mm
TP2: 3V3; TestPoint_Pad_D1.5mm
TP3: VKEY; TestPoint_Pad_D1.5mm
TP4: KEY_SDA; TestPoint_Pad_D1.5mm
TP5: KEY_SCL; TestPoint_Pad_D1.5mm
TP6: CC1; TestPoint_Pad_D1.5mm
TP7: CC2; TestPoint_Pad_D1.5mm
U1: Pico 2 W; RaspberryPi_Pico_2_W_SMD_PQ; MPN Raspberry Pi Pico 2 W (SC1633); LCSC C42394205
U2: AP22653W6-7; SOT-23-6; MPN AP22653W6-7; LCSC C2158037
U3, U4: USBLC6-2SC6; SOT-23-6; MPN USBLC6-2SC6; LCSC C7519

Connections:
+3V3: C1.1, J2.2, R3.1, R4.1, R7.1, R8.1, TP2.1, U1.36 (3V3), U2.1 (IN), U3.5 (VBUS), U4.5 (VBUS)
/BTN_BACK: SW3.1, U1.22 (GP17)
/BTN_DEVICE: SW4.1, U1.25 (GP19)
/BTN_REJECT: SW5.1, U1.27 (GP21)
/BTN_SIGN: SW2.1, U1.20 (GP15)
/CC1: J1.A5 (CC), R3.2, R5.1, TP6.1, U4.1 (IO1), U4.6 (IO1)
/CC1_SENSE: R5.2, U1.31 (GP26)
/CC2: J1.B5 (VCONN), R4.2, R6.1, TP7.1, U4.3 (IO2), U4.4 (IO2)
/CC2_SENSE: R6.2, U1.32 (GP27)
/ENC_A: R10.1, R12.1, SW1.A
/ENC_B: R11.1, R13.1, SW1.B
/KEY_EN: R7.2, U1.9 (GP6), U2.3 (EN)
/KEY_FAULT: R8.2, U1.19 (GP14), U2.4 (~FAULT)
/KEY_SCL: J1.A7 (D-), R2.2, TP5.1, U1.7 (GP5), U3.3 (IO2), U3.4 (IO2)
/KEY_SDA: J1.A6 (D+), R1.2, TP4.1, U1.6 (GP4), U3.1 (IO1), U3.6 (IO1)
/KNOB_GP2: R10.2, R13.2, U1.4 (GP2)
/KNOB_GP3: R11.2, R12.2, U1.5 (GP3)
/KNOB_SW: SW1.S1, U1.2 (GP1)
/LCD_BL: J2.8, U1.17 (GP13)
/LCD_CS: J2.3, U1.12 (GP9)
/LCD_DC: J2.6, U1.11 (GP8)
/LCD_MOSI: J2.4, U1.15 (GP11)
/LCD_RST: J2.7, U1.16 (GP12)
/LCD_SCK: J2.5, U1.14 (GP10)
/LED: R9.1, U1.29 (GP22)
/LED_A: D2.2 (A), R9.2
/VKEY: C2.1, D1.1 (K), J1.A4 (VBUS), J1.A9 (VBUS), J1.B4 (VBUS), J1.B9 (VBUS), R1.1, R2.1, TP3.1, U2.6 (OUT)
GND: C1.2, C2.2, D1.2 (A), D2.1 (K), J1.A1 (GND), J1.A12 (GND), J1.B1 (GND), J1.B12 (GND), J1.SH (SHIELD), J2.1, SW1.C, SW1.S2, SW2.2, SW3.2, SW4.2, SW5.2, TP1.1, U1.3 (GND), U1.8 (GND), U1.13 (GND), U1.18 (GND), U1.23 (GND), U1.28 (GND), U1.33 (AGND), U1.38 (GND), U2.2 (GND), U2.5 (ILIM), U3.2 (GND), U4.2 (GND)

Notes on the sheet:
Build 1's pins (firmware/board.py "build1"): secrets.py BOARD = "build1", SCREEN = "2.8". GP6, GP14, GP22, GP26, GP27 are new here: today's console image doesn't touch them. Micro-USB on the Pico: power and updates.
The console end of key-c (hardware/key-pcb/PROPOSALS.md): - VKEY comes through U2: 80 mA limit, reverse blocking, discharged when off. Never straight from a GPIO. - CC1 and CC2 read on their own ADC pins. Plugged straight in, a key shows 5.1k on both. - 2.2k pull-ups to VKEY, so a key that's off is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
Hold at power-up: Y = Wi-Fi setup, knob = maintenance. Sign is held 2 s (3 s on a red page).

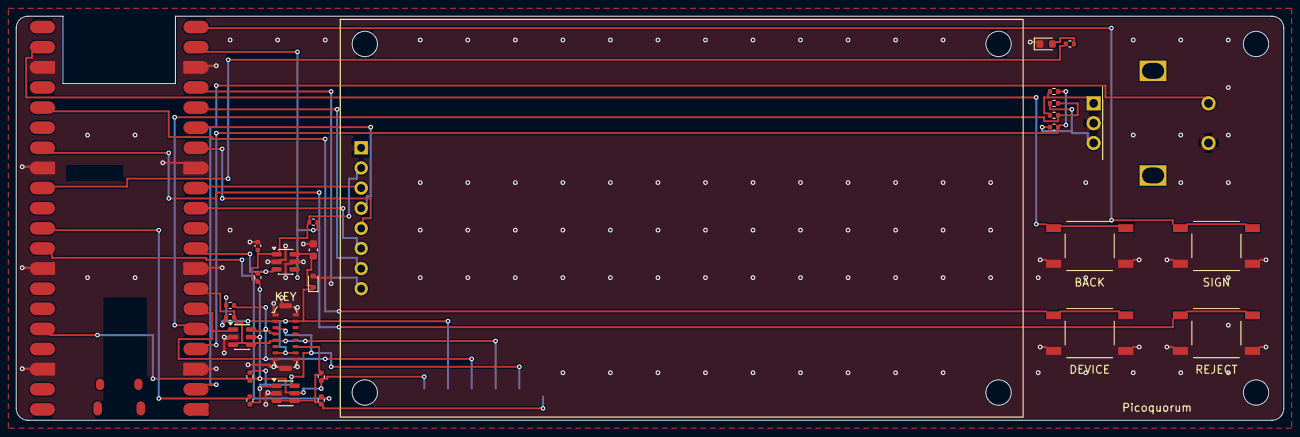
[picture p496: board hardware/console-pcb/console-a/console-a.kicad_pcb from above]

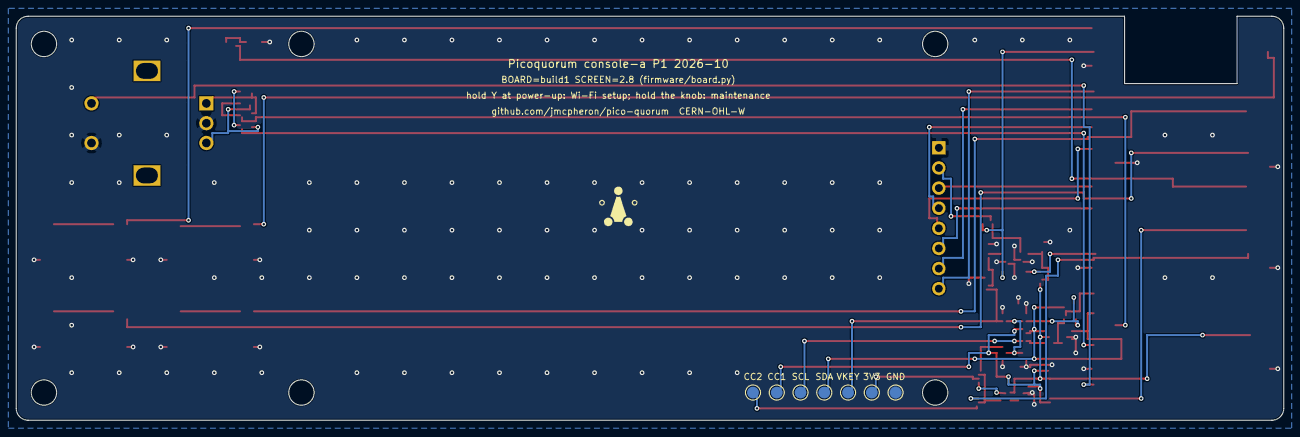
[picture p497: board hardware/console-pcb/console-a/console-a.kicad_pcb from below]

Board: 2 copper layers, 160.0 x 51.0 mm, 38 parts (8 on the bottom side), 28 nets.

Other parts of the board:
H2, H3: M3; MountingHole_3.2mm_M3
LOGO1: PicoQuorum_Mark
