jmcpheron/pico-quorum/hardware/key-pcb/key-d-pogo/key-d-pogo.kicad_pcb

## KiCad design hardware/key-pcb/key-d-pogo/key-d-pogo.kicad_pcb (2026-11-06)

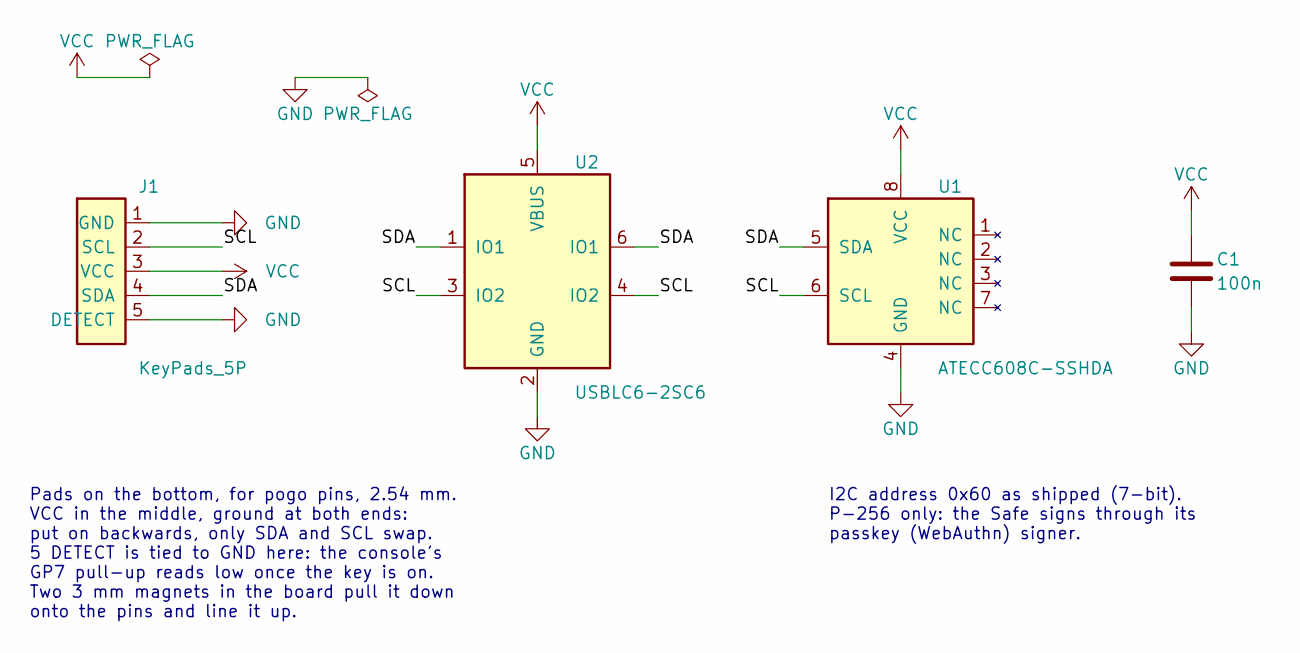
[picture p498: schematic key-d-pogo.kicad_sch, Picoquorum key, proposal D: pogo pads and magnets]

Parts:
C1: 100n; C_0805_2012Metric; LCSC C49678
J1: KeyPads_5P; KeyPads_5P_P2.54mm
U1: ATECC608C-SSHDA; SOIC-8_3.9x4.9mm_P1.27mm; MPN ATECC608C-SSHDA-B; LCSC C28975195
U2: USBLC6-2SC6; SOT-23-6; MPN USBLC6-2SC6; LCSC C7519

Connections:
/SCL: J1.2 (SCL), U1.6 (SCL), U2.3 (IO2), U2.4 (IO2)
/SDA: J1.4 (SDA), U1.5 (SDA), U2.1 (IO1), U2.6 (IO1)
GND: C1.2, J1.1 (GND), J1.5 (DETECT), U1.4 (GND), U2.2 (GND)
VCC: C1.1, J1.3 (VCC), U1.8 (VCC), U2.5 (VBUS)

Notes on the sheet:
I2C address 0x60 as shipped (7-bit). P-256 only: the Safe signs through its passkey (WebAuthn) signer.
Pads on the bottom, for pogo pins, 2.54 mm. VCC in the middle, ground at both ends: put on backwards, only SDA and SCL swap. 5 DETECT is tied to GND here: the console's GP7 pull-up reads low once the key is on. Two 3 mm magnets in the board pull it down onto the pins and line it up.
