jmcpheron/pico-quorum/hardware/key-pcb/key-d-pogo/key-d-pogo.kicad_pcb

## KiCad design hardware/key-pcb/key-d-pogo/key-d-pogo.kicad_pcb (continued)

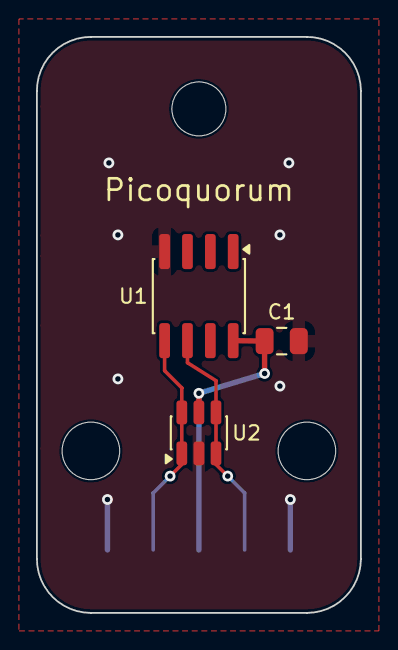
[picture p499: board key-d-pogo.kicad_pcb from above]

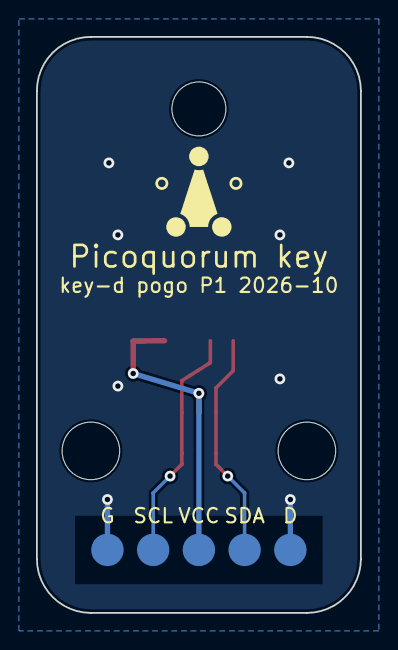
[picture p500: board key-d-pogo.kicad_pcb from below]

Board: 2 copper layers, 18.0 x 32.0 mm, 8 parts (2 on the bottom side), 4 nets.

Other parts of the board:
H1: Lanyard; MountingHole_3mm
H2, H3: Magnet; MountingHole_3.2mm_M3
LOGO1: PicoQuorum_Mark
