jmcpheron/pico-quorum/hardware/console-a/console-a/console-a.kicad_pcb

## KiCad design hardware/console-a/console-a/console-a.kicad_pcb (2026-11-06)

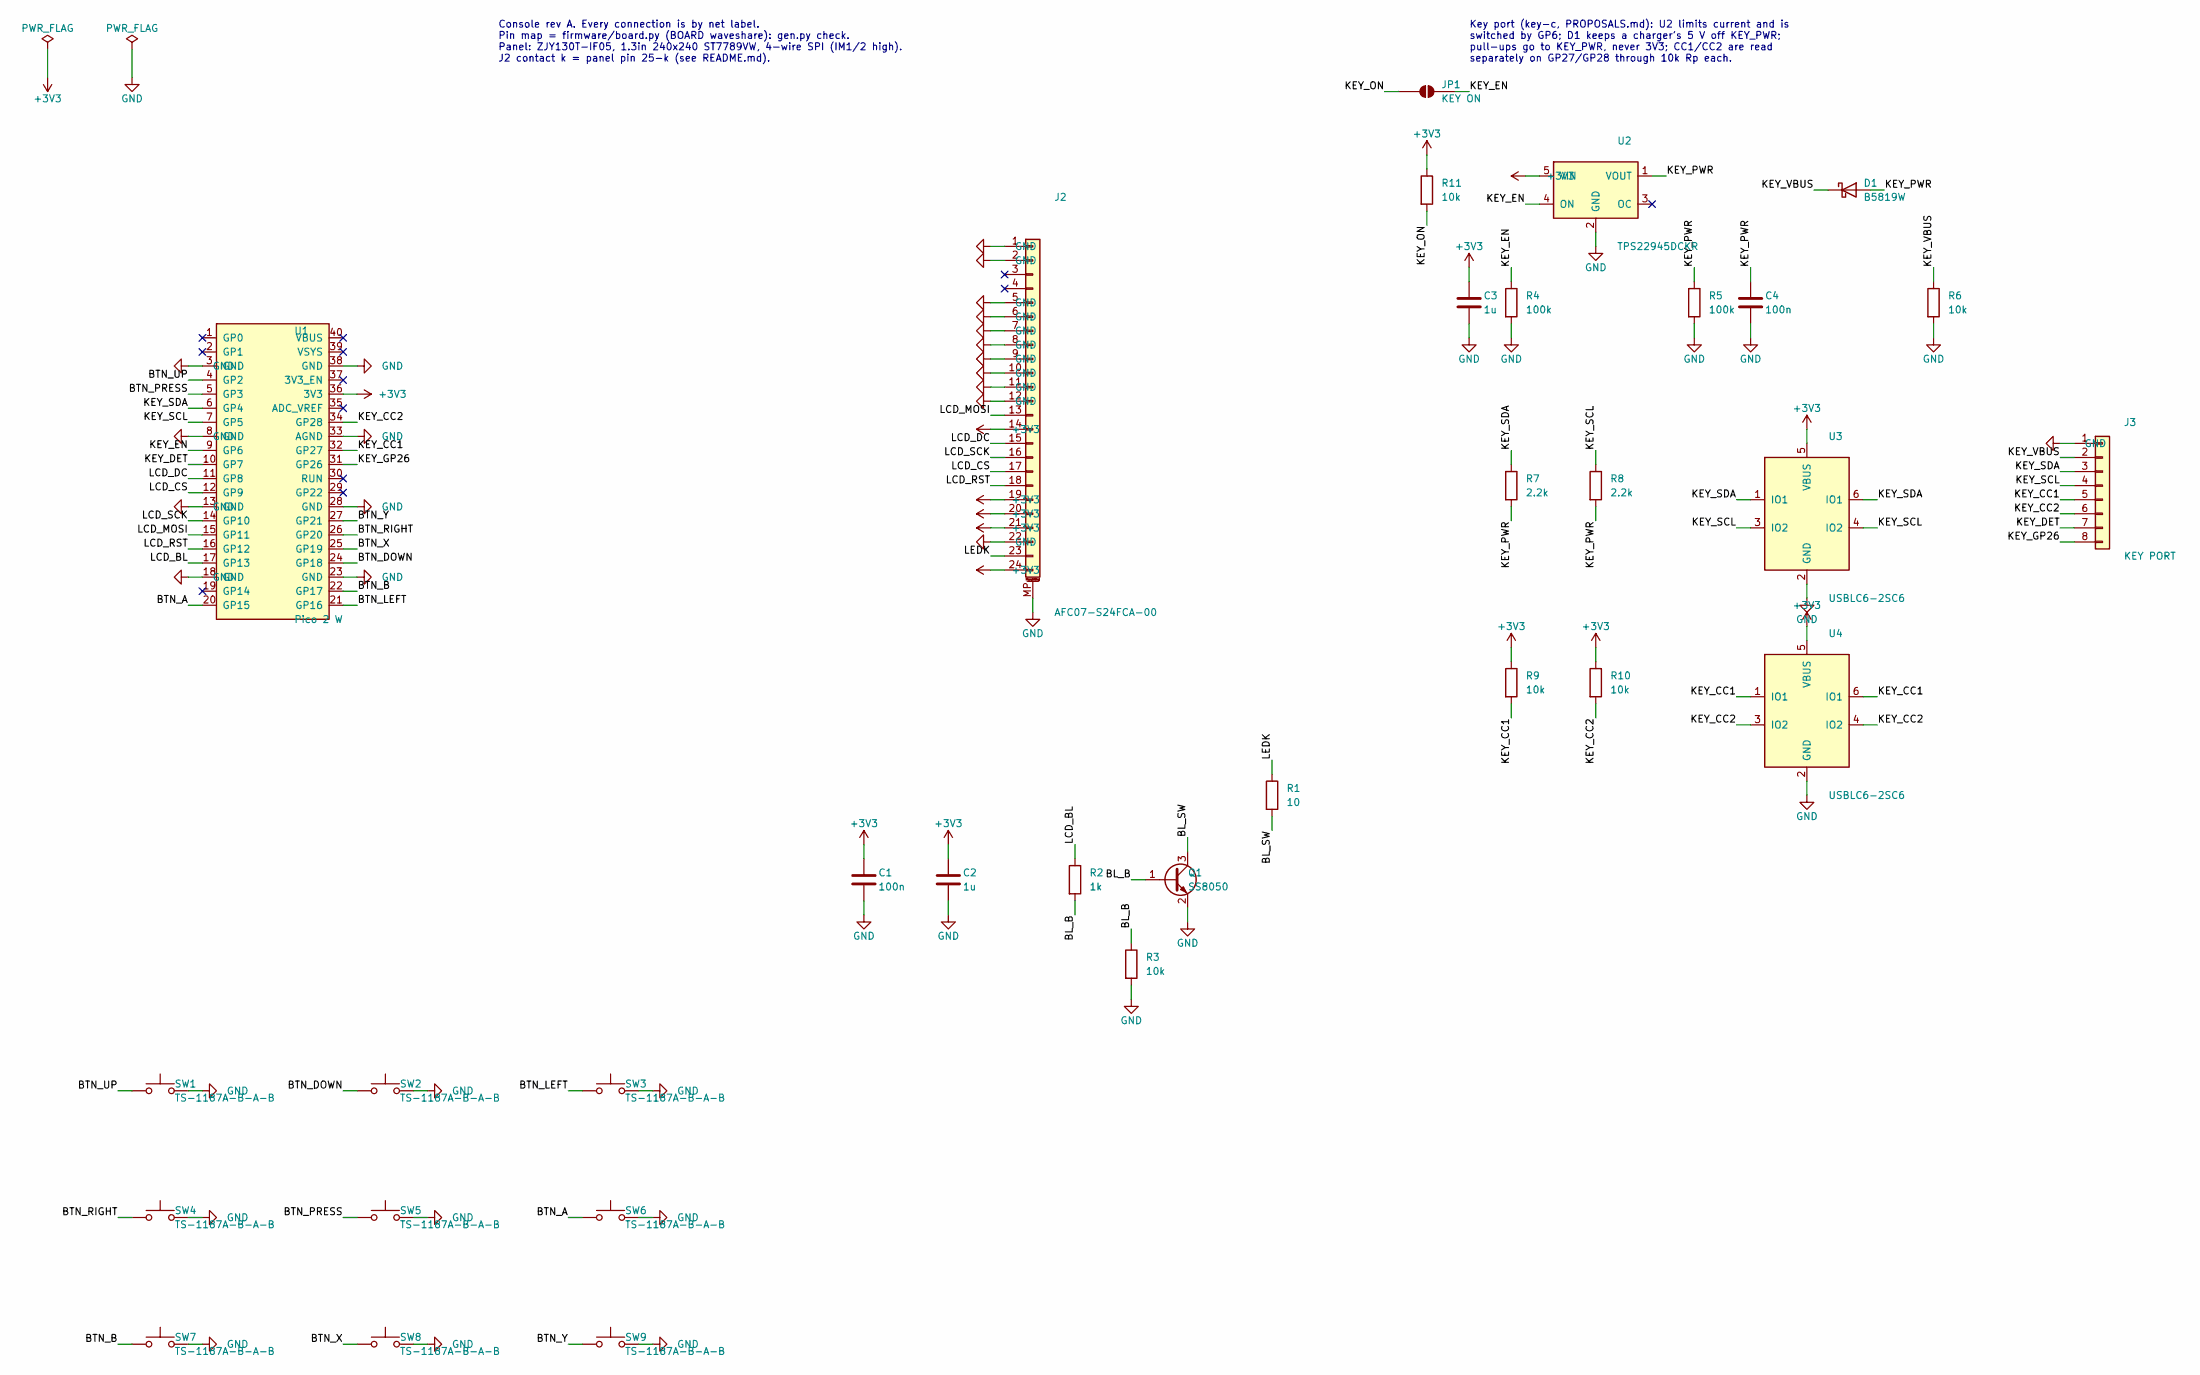
[picture p501: schematic console-a.kicad_sch, Picoquorum console, rev A: Pico 2 W, 1.3in panel, nine butt…]

Parts:
C1, C4: 100n; C_0603_1608Metric; LCSC C14663
C2, C3: 1u; C_0603_1608Metric; LCSC C15849
D1: B5819W; D_SOD-123; MPN B5819W SL; LCSC C8598
J2: AFC07-S24FCA-00; Jushuo_AFC07-S24FCA-00_1x24-1MP_P0.50_Horizontal; MPN AFC07-S24FCA-00; LCSC C262567
J3: KEY PORT; PinHeader_1x08_P2.54mm_Vertical
JP1: KEY ON; SolderJumper-2_P1.3mm_Open_RoundedPad1.0x1.5mm
Q1: SS8050; SOT-23; MPN SS8050; LCSC C2150
R1: 10; R_0603_1608Metric; LCSC C22859
R2: 1k; R_0603_1608Metric; LCSC C21190
R3, R6, R9, R10, R11: 10k; R_0603_1608Metric; LCSC C25804
R4, R5: 100k; R_0603_1608Metric; LCSC C25803
R7, R8: 2.2k; R_0603_1608Metric; LCSC C4190
SW1, SW2, SW3, SW4, SW5, SW6, SW7, SW8, SW9: TS-1187A-B-A-B; SW_Push_1P1T_XKB_TS-1187A; LCSC C318884
U1: Pico 2 W; RaspberryPi_Pico_W_SMD_HandSolder_PQ; MPN SC1633; LCSC_FACTORY C42394205
U2: TPS22945DCKR; SOT-353_SC-70-5; MPN TPS22945DCKR; LCSC C47507
U3, U4: USBLC6-2SC6; SOT-23-6; MPN USBLC6-2SC6; LCSC C7519

Connections:
+3V3: C1.1, C2.1, C3.1, J2.14, J2.19, J2.20, J2.21, J2.24, R9.1, R10.1, R11.1, U1.36 (3V3), U2.5 (VIN), U3.5 (VBUS), U4.5 (VBUS)
/BL_B: Q1.1 (B), R2.2, R3.1
/BL_SW: Q1.3 (C), R1.2
/BTN_A: SW6.1, U1.20 (GP15)
/BTN_B: SW7.1, U1.22 (GP17)
/BTN_DOWN: SW2.1, U1.24 (GP18)
/BTN_LEFT: SW3.1, U1.21 (GP16)
/BTN_PRESS: SW5.1, U1.5 (GP3)
/BTN_RIGHT: SW4.1, U1.26 (GP20)
/BTN_UP: SW1.1, U1.4 (GP2)
/BTN_X: SW8.1, U1.25 (GP19)
/BTN_Y: SW9.1, U1.27 (GP21)
/KEY_CC1: J3.5, R9.2, U1.32 (GP27), U4.1 (IO1), U4.6 (IO1)
/KEY_CC2: J3.6, R10.2, U1.34 (GP28), U4.3 (IO2), U4.4 (IO2)
/KEY_DET: J3.7, U1.10 (GP7)
/KEY_EN: JP1.2 (B), R4.1, U1.9 (GP6), U2.4 (ON)
/KEY_GP26: J3.8, U1.31 (GP26)
/KEY_ON: JP1.1 (A), R11.2
/KEY_PWR: C4.1, D1.2 (A), R5.1, R7.2, R8.2, U2.1 (VOUT)
/KEY_SCL: J3.4, R8.1, U1.7 (GP5), U3.3 (IO2), U3.4 (IO2)
/KEY_SDA: J3.3, R7.1, U1.6 (GP4), U3.1 (IO1), U3.6 (IO1)
/KEY_VBUS: D1.1 (K), J3.2, R6.1
/LCD_BL: R2.1, U1.17 (GP13)
/LCD_CS: J2.17, U1.12 (GP9)
/LCD_DC: J2.15, U1.11 (GP8)
/LCD_MOSI: J2.13, U1.15 (GP11)
/LCD_RST: J2.18, U1.16 (GP12)
/LCD_SCK: J2.16, U1.14 (GP10)
/LEDK: J2.23, R1.1
GND: C1.2, C2.2, C3.2, C4.2, J2.1, J2.2, J2.5, J2.6, J2.7, J2.8, J2.9, J2.10, J2.11, J2.12, J2.22, J2.MP (MountPin), J3.1, Q1.2 (E), R3.2, R4.2, R5.2, R6.2, SW1.2, SW2.2, SW3.2, SW4.2, SW5.2, SW6.2, SW7.2, SW8.2, SW9.2, U1.3 (GND), U1.8 (GND), U1.13 (GND), U1.18 (GND), U1.23 (GND), U1.28 (GND), U1.33 (AGND), U1.38 (GND), U2.2 (GND), U3.2 (GND), U4.2 (GND)

Notes on the sheet:
Console rev A. Every connection is by net label. Pin map = firmware/board.py (BOARD waveshare): gen.py check. Panel: ZJY130T-IF05, 1.3in 240x240 ST7789VW, 4-wire SPI (IM1/2 high). J2 contact k = panel pin 25-k (see README.md).
Key port (key-c, PROPOSALS.md): U2 limits current and is switched by GP6; D1 keeps a charger's 5 V off KEY_PWR; pull-ups go to KEY_PWR, never 3V3; CC1/CC2 are read separately on GP27/GP28 through 10k Rp each.

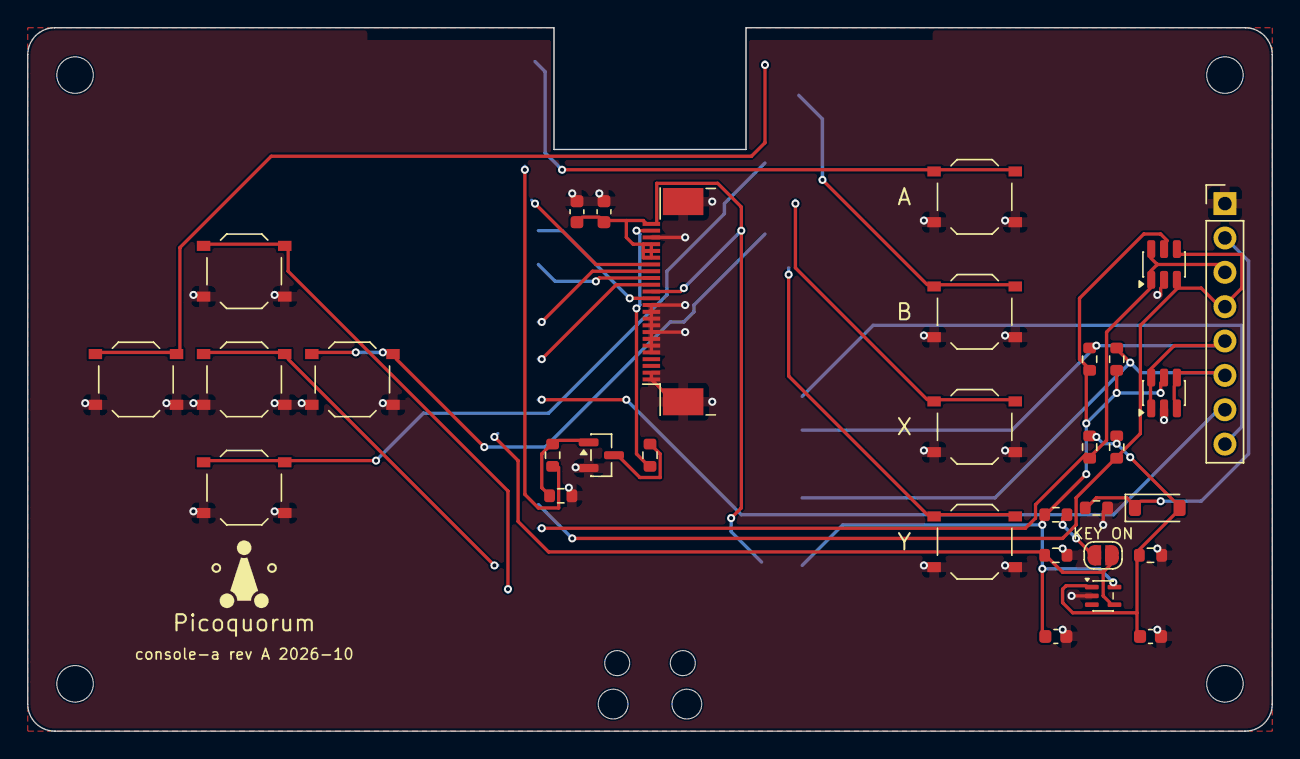
[picture p502: board hardware/console-a/console-a/console-a.kicad_pcb from above]

Board: 2 copper layers, 92.0 x 52.0 mm, 38 parts (1 on the bottom side), 30 nets.

Other parts of the board:
H1, H2, H3, H4: M2.5; MountingHole_2.7mm_M2.5
LOGO1: PicoQuorum_Mark
