jmcpheron/pico-quorum/hardware/feather-wing/wing-a/wing-a.kicad_pcb

## KiCad design hardware/feather-wing/wing-a/wing-a.kicad_pcb (2026-11-06)

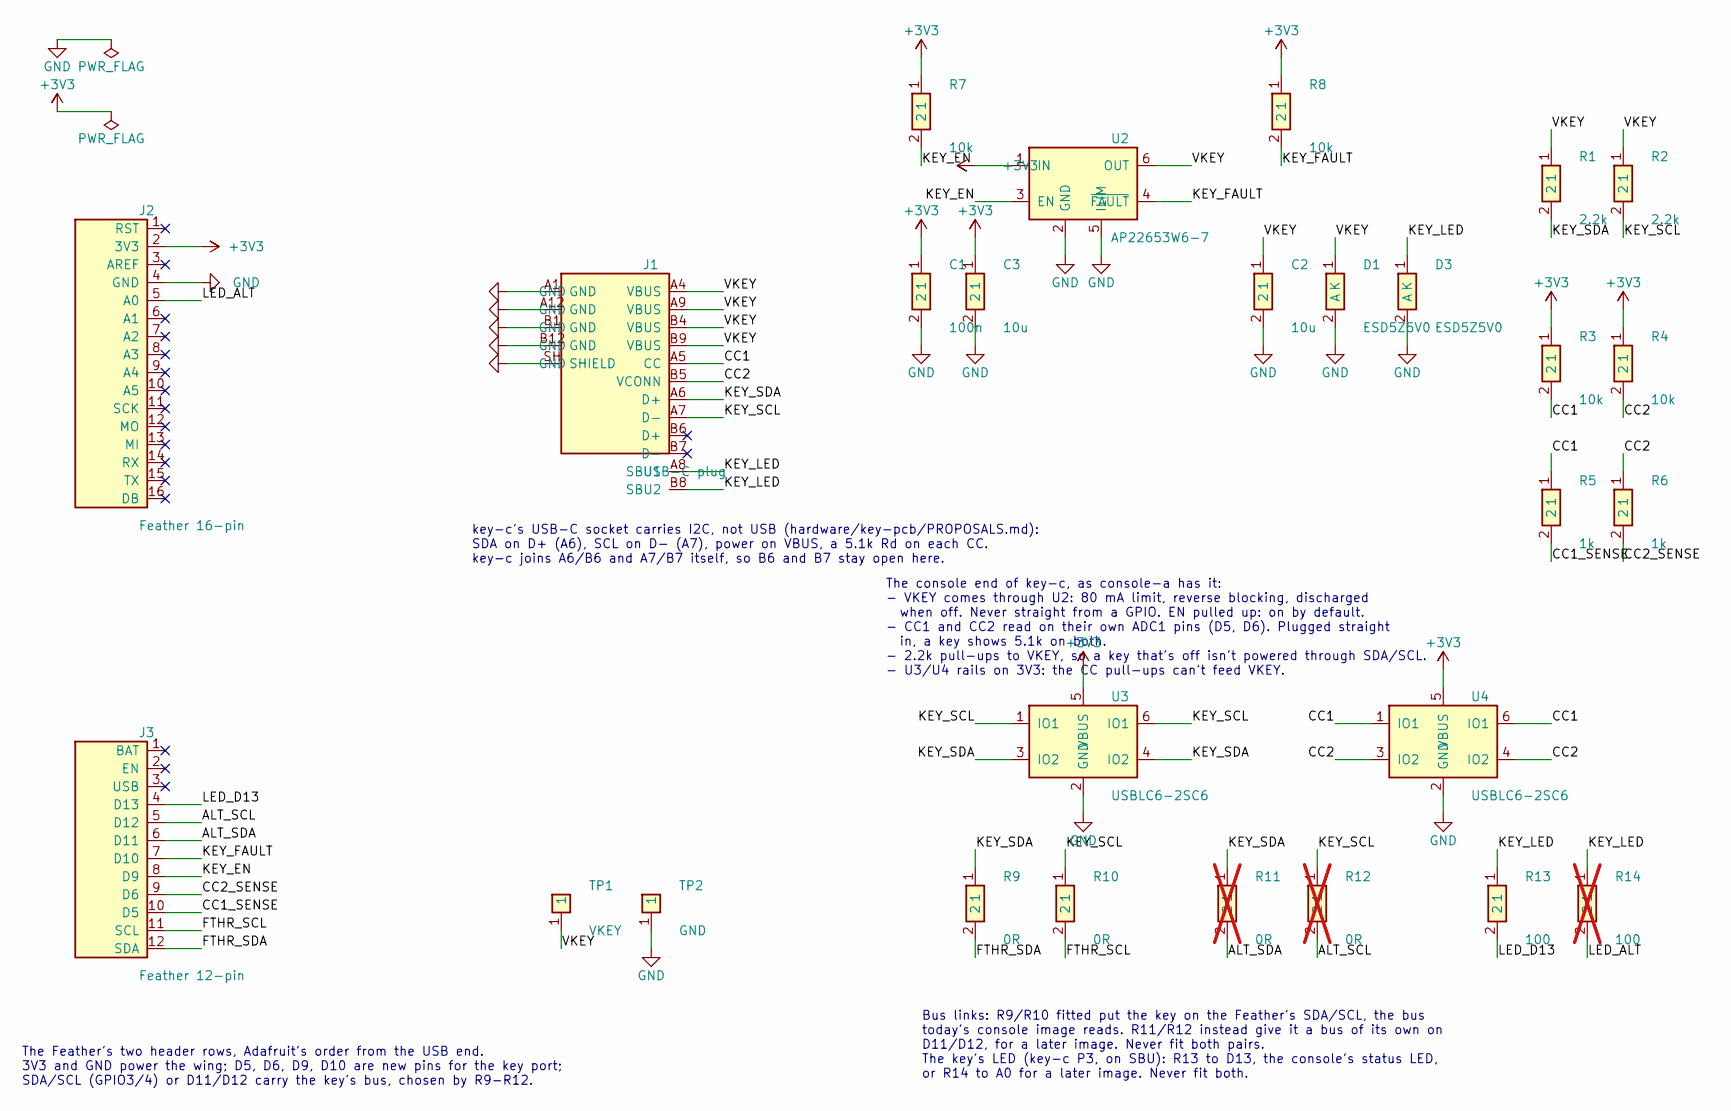
[picture p503: schematic wing-a.kicad_sch, Picoquorum key wing, wing-a: key-c's USB-C port behind a Fe…]

Parts:
C1: 100n; C_0402; LCSC C1525
C2, C3: 10u; C_0603; LCSC C19702
D1, D3: ESD5Z5V0; D_SOD-523; MPN ESD5Z5V0; LCSC C502546
J1: USB-C plug; USB_C_Plug_918-118A2021Y40002_Vertical; MPN 918-118A2021Y40002; LCSC C399939
J2: Feather 16-pin; Feather_Header_1x16
J3: Feather 12-pin; Feather_Header_1x12
R1, R2: 2.2k; R_0402; LCSC C25879
R3, R4, R7, R8: 10k; R_0402; LCSC C25744
R5, R6: 1k; R_0402; LCSC C11702
R9, R10: 0R; R_0402; LCSC C17168
R11, R12: 0R; R_0402; LCSC C17168; not fitted
R13: 100; R_0402; LCSC C25076
R14: 100; R_0402; LCSC C25076; not fitted
TP1: VKEY; TestPad_1.5mm
TP2: GND; TestPad_1.5mm
U2: AP22653W6-7; SOT-23-6; MPN AP22653W6-7; LCSC C2158037
U3, U4: USBLC6-2SC6; SOT-23-6; MPN USBLC6-2SC6; LCSC C7519

Connections:
+3V3: C1.1, C3.1, J2.2 (3V3), R3.1, R4.1, R7.1, R8.1, U2.1 (IN), U3.5 (VBUS), U4.5 (VBUS)
/ALT_SCL: J3.5 (D12), R12.2
/ALT_SDA: J3.6 (D11), R11.2
/CC1: J1.A5 (CC), R3.2, R5.1, U4.1 (IO1), U4.6 (IO1)
/CC1_SENSE: J3.10 (D5), R5.2
/CC2: J1.B5 (VCONN), R4.2, R6.1, U4.3 (IO2), U4.4 (IO2)
/CC2_SENSE: J3.9 (D6), R6.2
/FTHR_SCL: J3.11 (SCL), R10.2
/FTHR_SDA: J3.12 (SDA), R9.2
/KEY_EN: J3.8 (D9), R7.2, U2.3 (EN)
/KEY_FAULT: J3.7 (D10), R8.2, U2.4 (~FAULT)
/KEY_LED: D3.1 (K), J1.A8 (SBU1), J1.B8 (SBU2), R13.1, R14.1
/KEY_SCL: J1.A7 (D-), R2.2, R10.1, R12.1, U3.1 (IO1), U3.6 (IO1)
/KEY_SDA: J1.A6 (D+), R1.2, R9.1, R11.1, U3.3 (IO2), U3.4 (IO2)
/LED_ALT: J2.5 (A0), R14.2
/LED_D13: J3.4 (D13), R13.2
/VKEY: C2.1, D1.1 (K), J1.A4 (VBUS), J1.A9 (VBUS), J1.B4 (VBUS), J1.B9 (VBUS), R1.1, R2.1, TP1.1, U2.6 (OUT)
GND: C1.2, C2.2, C3.2, D1.2 (A), D3.2 (A), J1.A1 (GND), J1.A12 (GND), J1.B1 (GND), J1.B12 (GND), J1.SH (SHIELD), J2.4 (GND), TP2.1, U2.2 (GND), U2.5 (ILIM), U3.2 (GND), U4.2 (GND)

Notes on the sheet:
The Feather's two header rows, Adafruit's order from the USB end. 3V3 and GND power the wing; D5, D6, D9, D10 are new pins for the key port; SDA/SCL (GPIO3/4) or D11/D12 carry the key's bus, chosen by R9-R12.
key-c's USB-C socket carries I2C, not USB (hardware/key-pcb/PROPOSALS.md): SDA on D+ (A6), SCL on D- (A7), power on VBUS, a 5.1k Rd on each CC. key-c joins A6/B6 and A7/B7 itself, so B6 and B7 stay open here.
The console end of key-c, as console-a has it: - VKEY comes through U2: 80 mA limit, reverse blocking, discharged when off. Never straight from a GPIO. EN pulled up: on by default. - CC1 and CC2 read on their own ADC1 pins (D5, D6). Plugged straight in, a key shows 5.1k on both. - 2.2k pull-ups to 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
Bus links: R9/R10 fitted put the key on the Feather's SDA/SCL, the bus today's console image reads. R11/R12 instead give it a bus of its own on D11/D12, for a later image. Never fit both pairs. The key's LED (key-c P3, on SBU): R13 to D13, the console's status LED, or R14 to A0 for a later image. N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

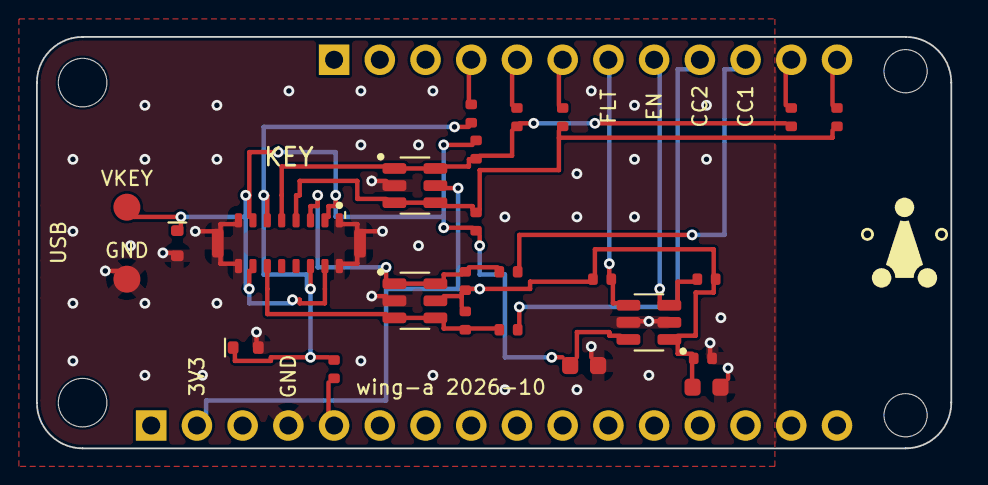
[picture p504: board wing-a.kicad_pcb from above]

Board: 2 copper layers, 50.8 x 22.9 mm, 32 parts (0 on the bottom side), 18 nets.

Other parts of the board:
H1, H2: M2.5; MountingHole_2.7mm
H3, H4: M2; MountingHole_2.4mm
LOGO1: PicoQuorum_Mark
