jmcpheron/pico-quorum/hardware/key-pcb/key-a-soic/key-a-soic.kicad_pcb

## KiCad design hardware/key-pcb/key-a-soic/key-a-soic.kicad_pcb (2026-11-06)

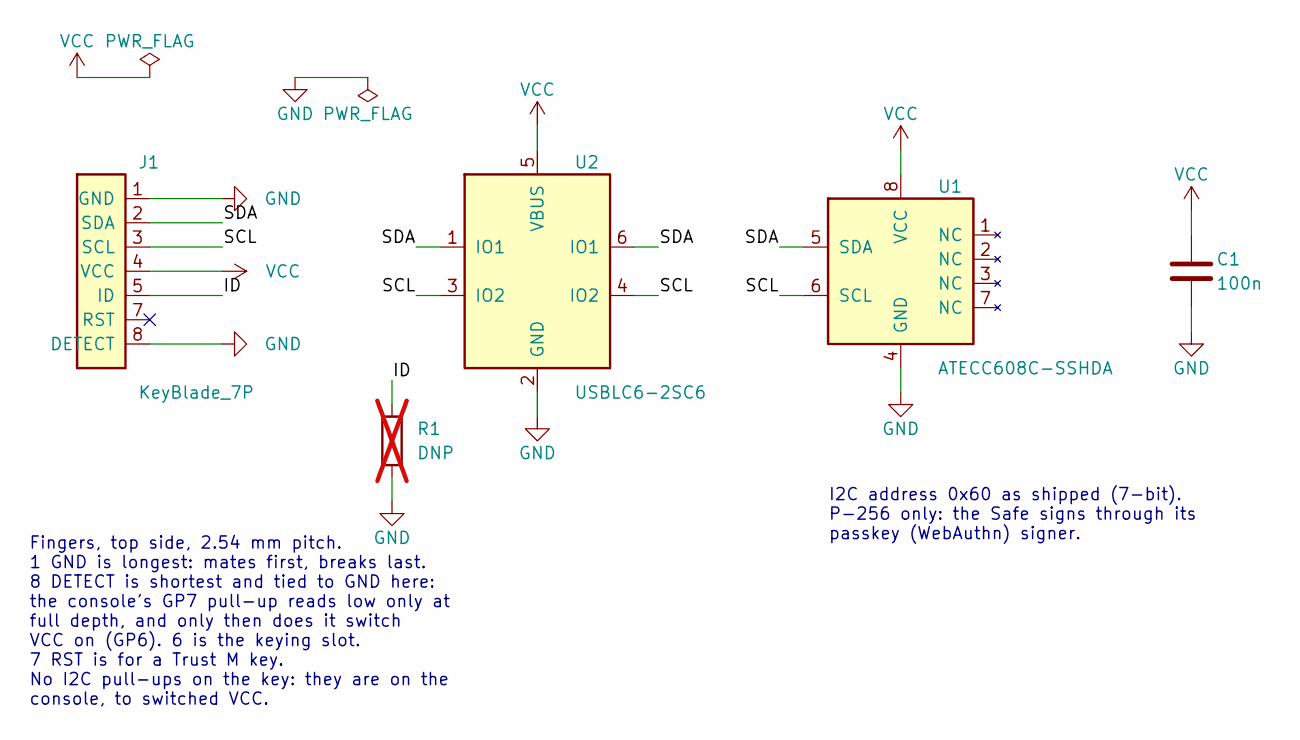
[picture p505: schematic key-a-soic.kicad_sch, Picoquorum key, rev A: SOIC-8, hand-soldered]

Parts:
C1: 100n; C_0805_2012Metric; LCSC C49678
J1: KeyBlade_7P; KeyBlade_7P_P2.54mm
R1: DNP; R_0805_2012Metric; not fitted
U1: ATECC608C-SSHDA; SOIC-8_3.9x4.9mm_P1.27mm; MPN ATECC608C-SSHDA-B; LCSC C28975195
U2: USBLC6-2SC6; SOT-23-6; MPN USBLC6-2SC6; LCSC C7519

Connections:
/ID: J1.5 (ID), R1.1
/SCL: J1.3 (SCL), U1.6 (SCL), U2.3 (IO2), U2.4 (IO2)
/SDA: J1.2 (SDA), U1.5 (SDA), U2.1 (IO1), U2.6 (IO1)
GND: C1.2, J1.1 (GND), J1.8 (DETECT), R1.2, U1.4 (GND), U2.2 (GND)
VCC: C1.1, J1.4 (VCC), U1.8 (VCC), U2.5 (VBUS)

Notes on the sheet:
Fingers, top side, 2.54 mm pitch. 1 GND is longest: mates first, breaks last. 8 DETECT is shortest and tied to GND here: the console's GP7 pull-up reads low only at full depth, and only then does it switch VCC on (GP6). 6 is the keying slot. 7 RST is for a Trust M key. No I2C pull-ups on the key: t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
I2C address 0x60 as shipped (7-bit). P-256 only: the Safe signs through its passkey (WebAuthn) signer.

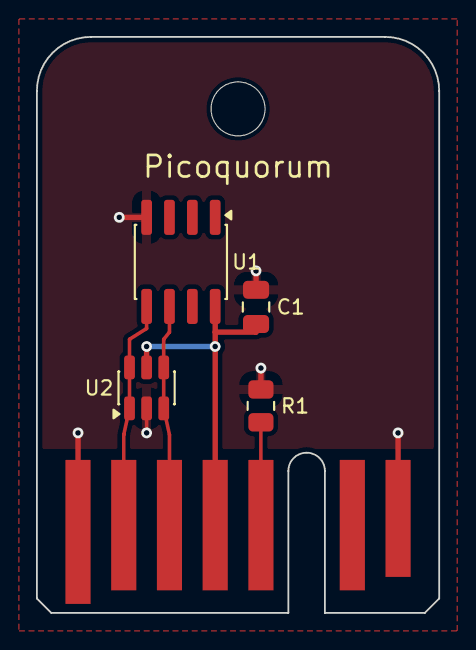
[picture p506: board key-a-soic.kicad_pcb from above]

Board: 2 copper layers, 22.3 x 32.0 mm, 6 parts (0 on the bottom side), 5 nets.

Other parts of the board:
H1: Lanyard; MountingHole_3mm
