jmcpheron/pico-quorum/hardware/console-pocket/console-pocket/console-pocket.kicad_pcb

## KiCad design hardware/console-pocket/console-pocket/console-pocket.kicad_pcb (2026-11-06)

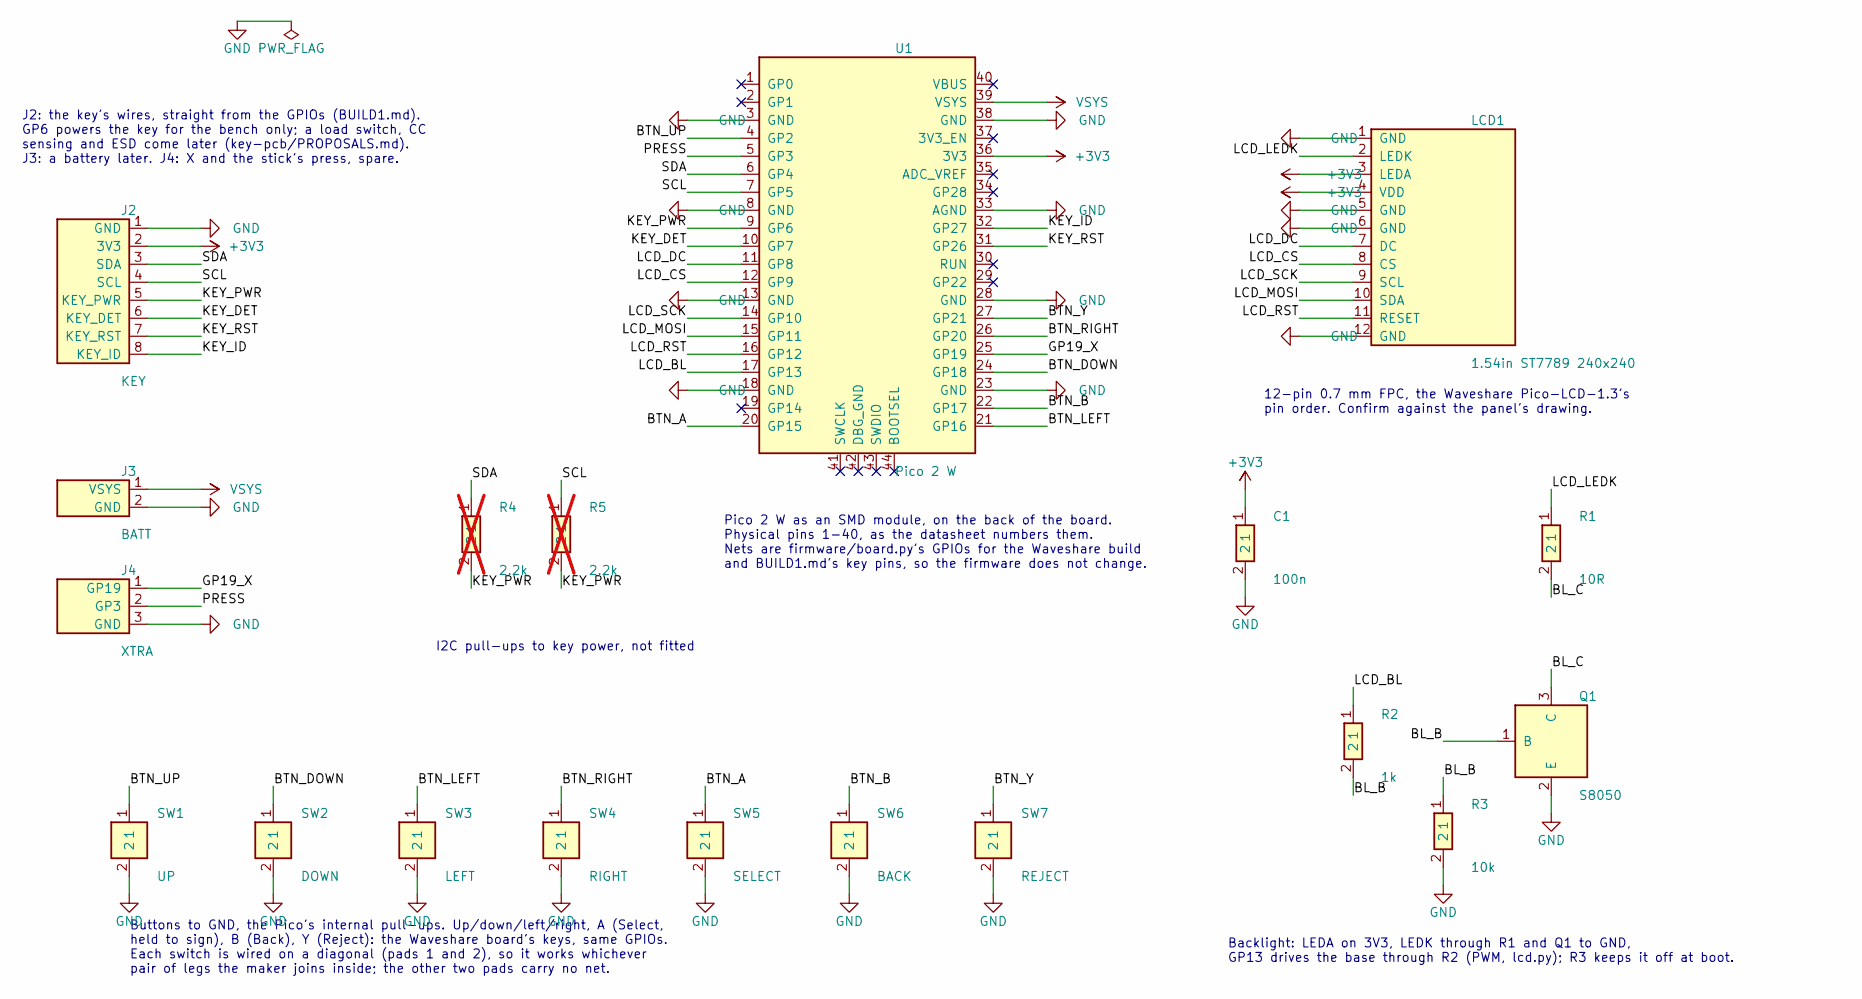
[picture p507: schematic console-pocket.kicad_sch, Picoquorum console-pocket, rev A: Pico 2 W on the back, 1.5…]

Parts:
C1: 100n; C_0603; LCSC C14663
J2: KEY; Pads_1x8_P2.54mm
J3: BATT; Pads_1x2_P2.54mm
J4: XTRA; Pads_1x3_P2.54mm
LCD1: 1.54in ST7789 240x240; LCD_1.54in_240x240_FPC12_P0.7mm
Q1: S8050; SOT-23; MPN S8050 J3Y; LCSC C2150
R1: 10R; R_0603; LCSC C22859
R2: 1k; R_0603; LCSC C21190
R3: 10k; R_0603; LCSC C25804
R4, R5: 2.2k; R_0603; LCSC C4190; not fitted
SW1: UP; SW_SMD_6x6x5_TS1097A; MPN TS-1097A-05026; LCSC C720496
SW2: DOWN; SW_SMD_6x6x5_TS1097A; MPN TS-1097A-05026; LCSC C720496
SW3: LEFT; SW_SMD_6x6x5_TS1097A; MPN TS-1097A-05026; LCSC C720496
SW4: RIGHT; SW_SMD_6x6x5_TS1097A; MPN TS-1097A-05026; LCSC C720496
SW5: SELECT; SW_SMD_6x6x5_TS1097A; MPN TS-1097A-05026; LCSC C720496
SW6: BACK; SW_SMD_6x6x5_TS1097A; MPN TS-1097A-05026; LCSC C720496
SW7: REJECT; SW_SMD_6x6x5_TS1097A; MPN TS-1097A-05026; LCSC C720496
U1: Pico 2 W; Pico2W_SMD; MPN SC1633

Connections:
+3V3: C1.1, J2.2 (3V3), LCD1.3 (LEDA), LCD1.4 (VDD), U1.36 (3V3)
/BL_B: Q1.1 (B), R2.2, R3.1
/BL_C: Q1.3 (C), R1.2
/BTN_A: SW5.1, U1.20 (GP15)
/BTN_B: SW6.1, U1.22 (GP17)
/BTN_DOWN: SW2.1, U1.24 (GP18)
/BTN_LEFT: SW3.1, U1.21 (GP16)
/BTN_RIGHT: SW4.1, U1.26 (GP20)
/BTN_UP: SW1.1, U1.4 (GP2)
/BTN_Y: SW7.1, U1.27 (GP21)
/GP19_X: J4.1 (GP19), U1.25 (GP19)
/KEY_DET: J2.6 (KEY_DET), U1.10 (GP7)
/KEY_ID: J2.8 (KEY_ID), U1.32 (GP27)
/KEY_PWR: J2.5 (KEY_PWR), R4.2, R5.2, U1.9 (GP6)
/KEY_RST: J2.7 (KEY_RST), U1.31 (GP26)
/LCD_BL: R2.1, U1.17 (GP13)
/LCD_CS: LCD1.8 (CS), U1.12 (GP9)
/LCD_DC: LCD1.7 (DC), U1.11 (GP8)
/LCD_LEDK: LCD1.2 (LEDK), R1.1
/LCD_MOSI: LCD1.10 (SDA), U1.15 (GP11)
/LCD_RST: LCD1.11 (RESET), U1.16 (GP12)
/LCD_SCK: LCD1.9 (SCL), U1.14 (GP10)
/PRESS: J4.2 (GP3), U1.5 (GP3)
/SCL: J2.4 (SCL), R5.1, U1.7 (GP5)
/SDA: J2.3 (SDA), R4.1, U1.6 (GP4)
GND: C1.2, J2.1 (GND), J3.2 (GND), J4.3 (GND), LCD1.1 (GND), LCD1.5 (GND), LCD1.6 (GND), LCD1.12 (GND), Q1.2 (E), R3.2, SW1.2, SW2.2, SW3.2, SW4.2, SW5.2, SW6.2, SW7.2, U1.3 (GND), U1.8 (GND), U1.13 (GND), U1.18 (GND), U1.23 (GND), U1.28 (GND), U1.33 (AGND), U1.38 (GND)
VSYS: J3.1 (VSYS), U1.39 (VSYS)

Notes on the sheet:
Pico 2 W as an SMD module, on the back of the board. Physical pins 1-40, as the datasheet numbers them. Nets are firmware/board.py's GPIOs for the Waveshare build and BUILD1.md's key pins, so the firmware does not change.
Buttons to GND, the Pico's internal pull-ups. Up/down/left/right, A (Select, held to sign), B (Back), Y (Reject): the Waveshare board's keys, same GPIOs. Each switch is wired on a diagonal (pads 1 and 2), so it works whichever pair of legs the maker joins inside; the other two pads carry no net.
J2: the key's wires, straight from the GPIOs (BUILD1.md). GP6 powers the key for the bench only; a load switch, CC sensing and ESD come later (key-pcb/PROPOSALS.md). J3: a battery later. J4: X and the stick's press, spare.
I2C pull-ups to key power, not fitted
12-pin 0.7 mm FPC, the Waveshare Pico-LCD-1.3's pin order. Confirm against the panel's drawing.
Backlight: LEDA on 3V3, LEDK through R1 and Q1 to GND, GP13 drives the base through R2 (PWM, lcd.py); R3 keeps it off at boot.

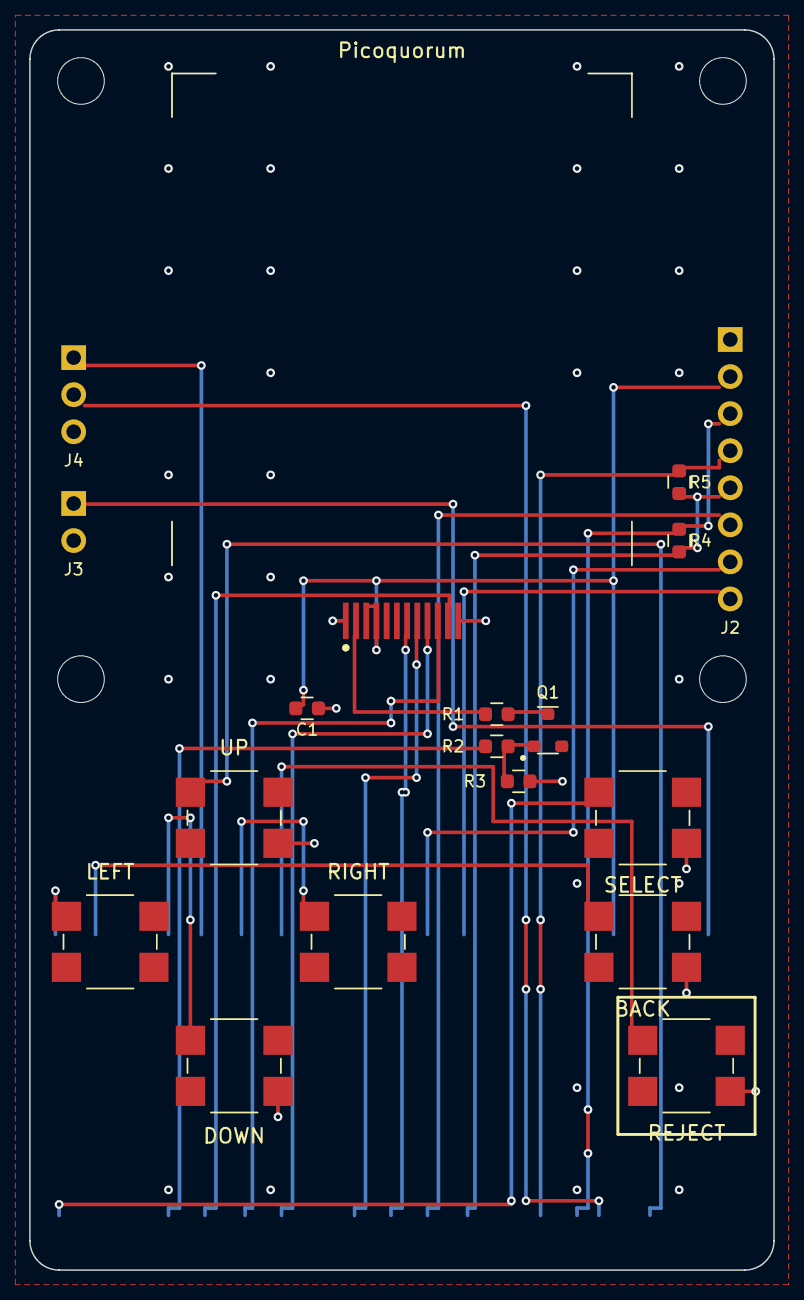
[picture p508: board console-pocket.kicad_pcb from above]

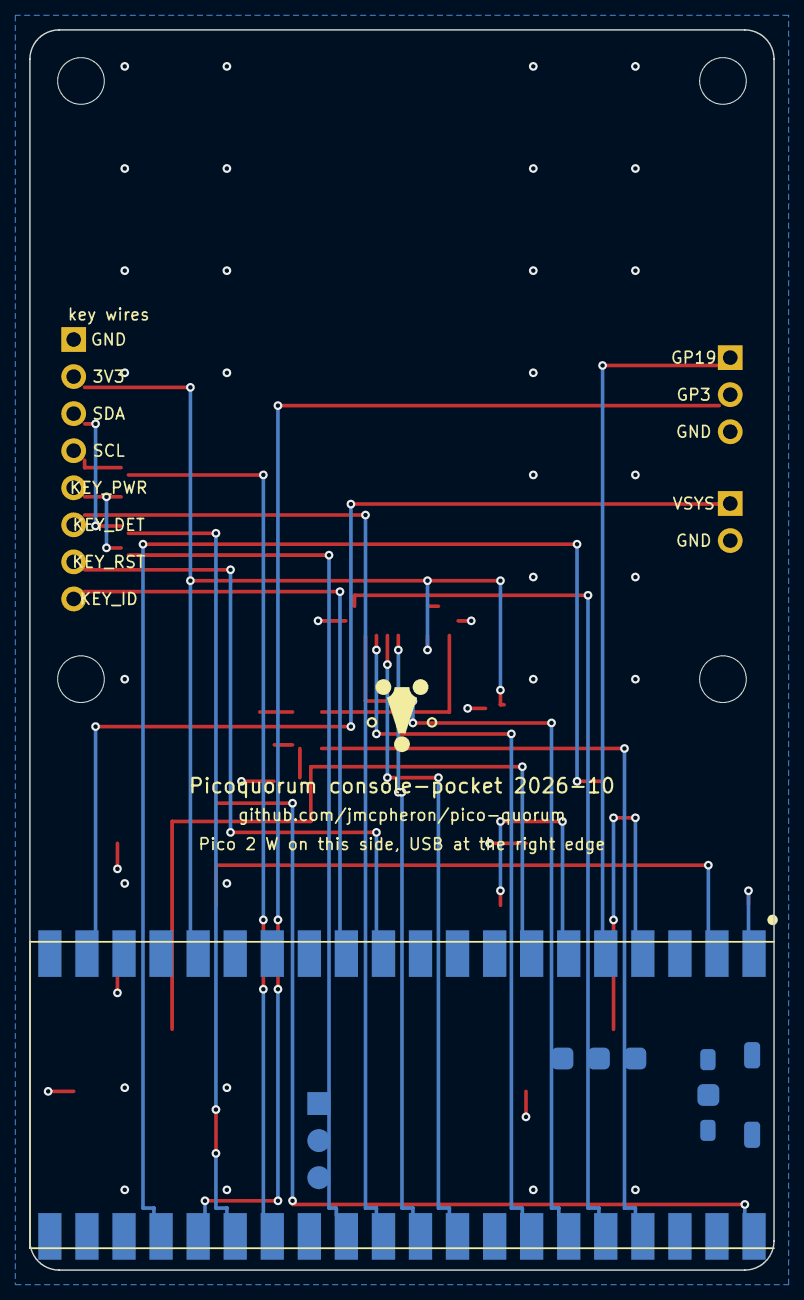
[picture p509: board console-pocket.kicad_pcb from below]

Board: 2 copper layers, 51.0 x 85.0 mm, 24 parts (2 on the bottom side), 27 nets.

Other parts of the board:
H1, H2, H3, H4: M3; MountingHole_3.2mm
LOGO1: PicoQuorum_Mark
