jmcpheron/pico-quorum/hardware/console-usb/console-usb/console-usb.kicad_pcb

## KiCad design hardware/console-usb/console-usb/console-usb.kicad_pcb (2026-11-06)

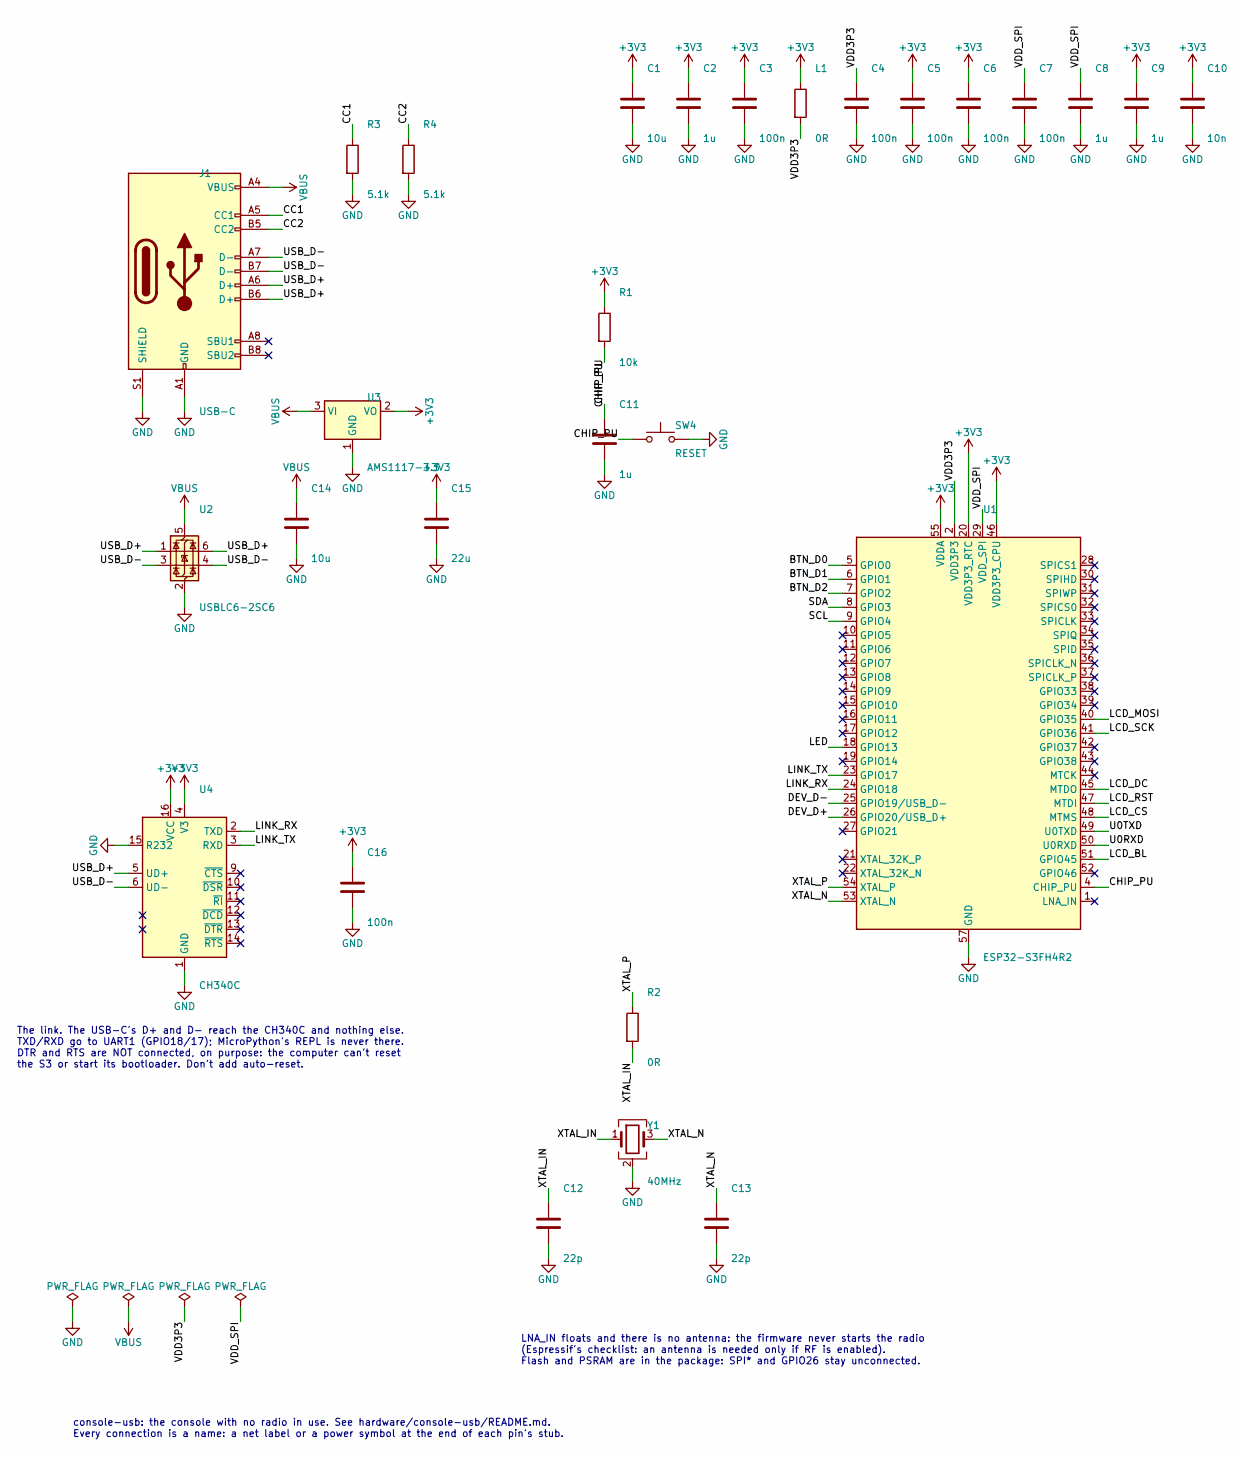
[picture p510: schematic console-usb.kicad_sch, Picoquorum console-usb: no radio, USB serial to the host, part in row 1, column 1]

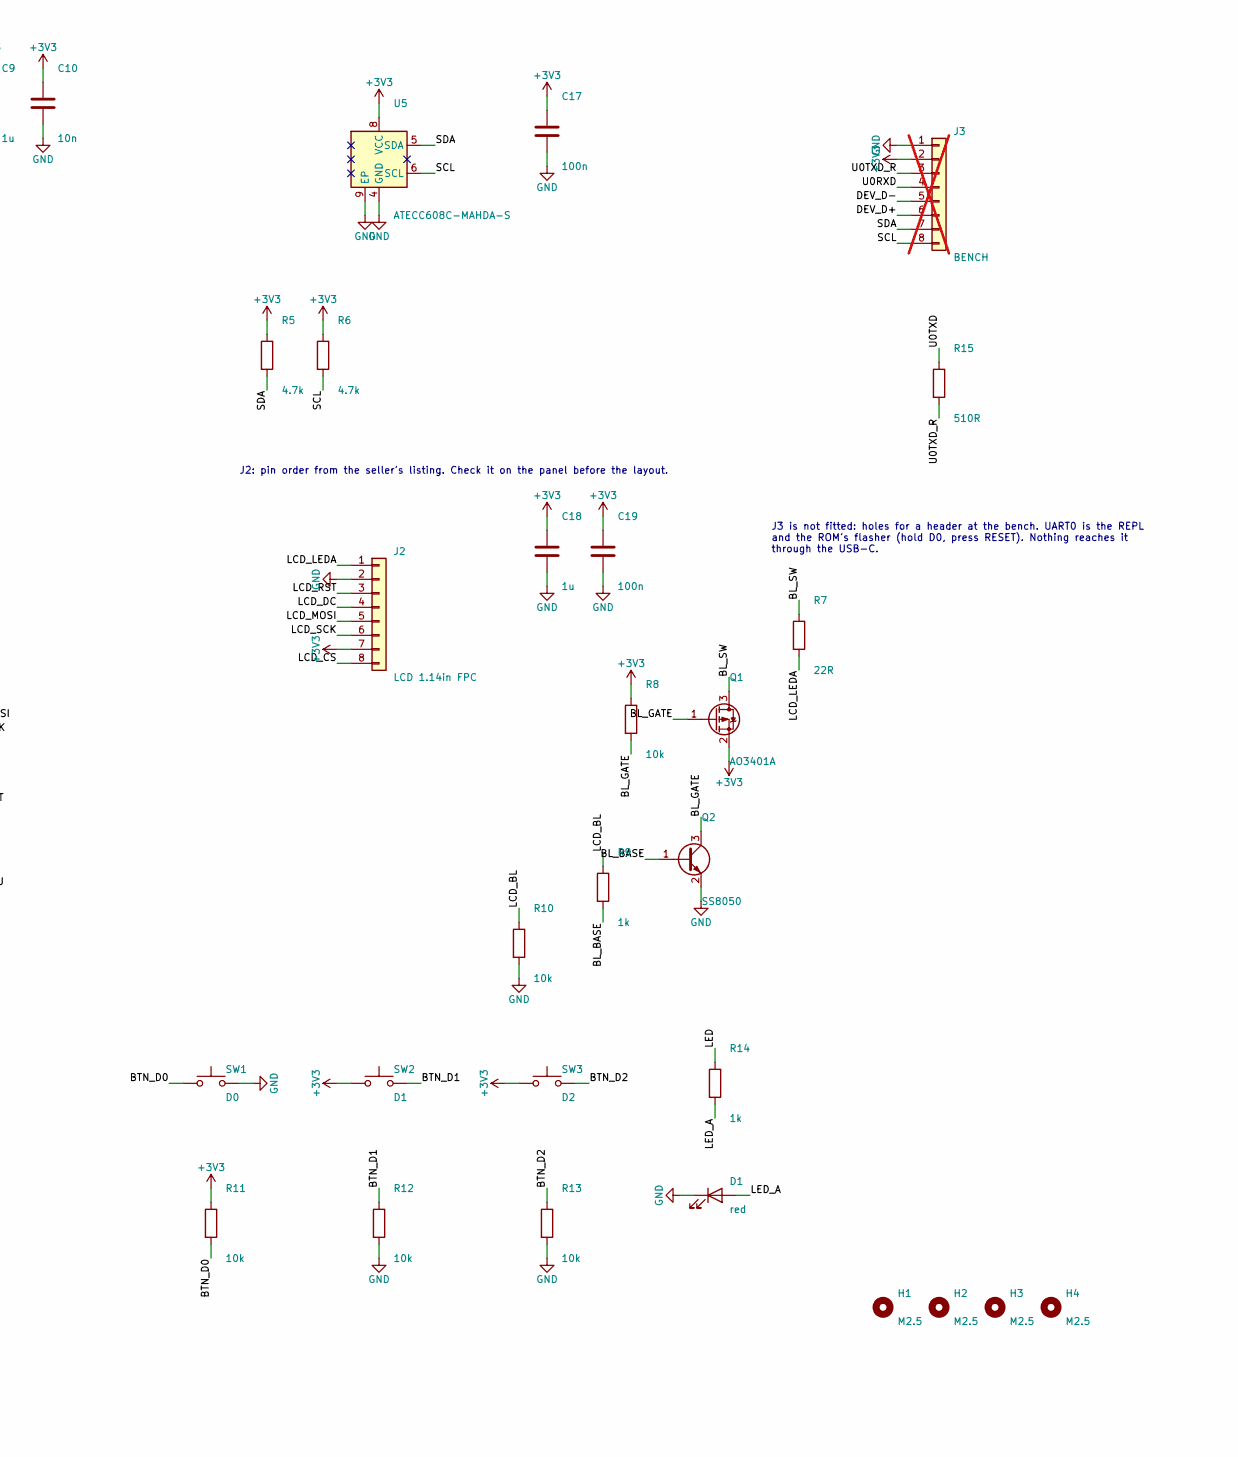
[picture p511: schematic console-usb.kicad_sch, Picoquorum console-usb: no radio, USB serial to the host, part in row 1, column 2]

Parts:
C1, C14: 10u; C_0805_2012Metric; LCSC C15850
C2, C8, C9, C11, C18: 1u; C_0402_1005Metric; LCSC C52923
C3, C4, C5, C6, C7, C16, C17, C19: 100n; C_0402_1005Metric; LCSC C1525
C10: 10n; C_0402_1005Metric; LCSC C15195
C12, C13: 22p; C_0402_1005Metric; LCSC C1555
C15: 22u; C_0805_2012Metric; LCSC C45783
D1: red; LED_0603_1608Metric; MPN KT-0603R; LCSC C2286
H1, H2, H3, H4: M2.5; MountingHole_2.7mm_M2.5
J1: USB-C; USB_C_Receptacle_HRO_TYPE-C-31-M-12; MPN TYPE-C-31-M-12; LCSC C165948
J2: LCD 1.14in FPC; FPC_ZIF_8P_P0.5mm_HDGC_0.5K-HX-8PWB; MPN 0.5K-HX-8PWB; LCSC C2919492
J3: BENCH; PinHeader_1x08_P2.54mm_Vertical; not fitted
L1: 0R; R_0402_1005Metric; LCSC C17168
Q1: AO3401A; SOT-23; LCSC C15127
Q2: SS8050; SOT-23; MPN SS8050; LCSC C2150
R1, R8, R10, R11, R12, R13: 10k; R_0402_1005Metric; LCSC C25744
R2: 0R; R_0402_1005Metric; LCSC C17168
R3, R4: 5.1k; R_0402_1005Metric; LCSC C25905
R5, R6: 4.7k; R_0402_1005Metric; LCSC C25900
R7: 22R; R_0402_1005Metric; LCSC C25092
R9, R14: 1k; R_0402_1005Metric; LCSC C11702
R15: 510R; R_0402_1005Metric; LCSC C25123
SW1: D0; SW_Push_1P1T_XKB_TS-1187A; MPN TS-1187A-B-A-B; LCSC C318884
SW2: D1; SW_Push_1P1T_XKB_TS-1187A; MPN TS-1187A-B-A-B; LCSC C318884
SW3: D2; SW_Push_1P1T_XKB_TS-1187A; MPN TS-1187A-B-A-B; LCSC C318884
SW4: RESET; SW_Push_1P1T_XKB_TS-1187A; MPN TS-1187A-B-A-B; LCSC C318884
U1: ESP32-S3FH4R2; QFN-56-1EP_7x7mm_P0.4mm_EP4x4mm; MPN ESP32-S3FH4R2; LCSC C3013940
U2: USBLC6-2SC6; SOT-23-6; LCSC C7519
U3: AMS1117-3.3; SOT-223-3_TabPin2; LCSC C6186
U4: CH340C; SOIC-16_3.9x9.9mm_P1.27mm; LCSC C84681
U5: ATECC608C-MAHDA-S; DFN-8-1EP_3x2mm_P0.5mm_EP1.3x1.5mm; MPN ATECC608C-MAHDA-S; LCSC C23291019
Y1: 40MHz; Crystal_SMD_3225-4Pin_3.2x2.5mm; MPN X322540MPB4SI; LCSC C9010

Connections:
+3V3: C1.1, C2.1, C3.1, C5.1, C6.1, C9.1, C10.1, C15.1, C16.1, C17.1, C18.1, C19.1, J2.7, J3.2, L1.1, Q1.2 (S), R1.1, R5.1, R6.1, R8.1, R11.1, SW2.1, SW3.1, U1.20 (VDD3P3_RTC), U1.46 (VDD3P3_CPU), U1.55 (VDDA), U1.56 (VDDA), U3.2 (VO), U4.4 (V3), U4.16 (VCC), U5.8 (VCC)
/BL_BASE: Q2.1 (B), R9.2
/BL_GATE: Q1.1 (G), Q2.3 (C), R8.2
/BL_SW: Q1.3 (D), R7.1
/BTN_D0: R11.2, SW1.1, U1.5 (GPIO0)
/BTN_D1: R12.1, SW2.2, U1.6 (GPIO1)
/BTN_D2: R13.1, SW3.2, U1.7 (GPIO2)
/CC1: J1.A5 (CC1), R3.1
/CC2: J1.B5 (CC2), R4.1
/CHIP_PU: C11.1, R1.2, SW4.1, U1.4 (CHIP_PU)
/DEV_D+: J3.6, U1.26 (GPIO20/USB_D+)
/DEV_D-: J3.5, U1.25 (GPIO19/USB_D-)
/LCD_BL: R9.1, R10.1, U1.51 (GPIO45)
/LCD_CS: J2.8, U1.48 (MTMS)
/LCD_DC: J2.4, U1.45 (MTDO)
/LCD_LEDA: J2.1, R7.2
/LCD_MOSI: J2.5, U1.40 (GPIO35)
/LCD_RST: J2.3, U1.47 (MTDI)
/LCD_SCK: J2.6, U1.41 (GPIO36)
/LED: R14.1, U1.18 (GPIO13)
/LED_A: D1.2 (A), R14.2
/LINK_RX: U1.24 (GPIO18), U4.2 (TXD)
/LINK_TX: U1.23 (GPIO17), U4.3 (RXD)
/SCL: J3.8, R6.2, U1.9 (GPIO4), U5.6 (SCL)
/SDA: J3.7, R5.2, U1.8 (GPIO3), U5.5 (SDA)
/U0RXD: J3.4, U1.50 (U0RXD)
/U0TXD: R15.1, U1.49 (U0TXD)
/U0TXD_R: J3.3, R15.2
/USB_D+: J1.A6 (D+), J1.B6 (D+), U2.1 (I/O1), U2.6 (I/O1), U4.5 (UD+)
/USB_D-: J1.A7 (D-), J1.B7 (D-), U2.3 (I/O2), U2.4 (I/O2), U4.6 (UD-)
/VDD3P3: C4.1, L1.2, U1.2 (VDD3P3), U1.3 (VDD3P3)
/VDD_SPI: C7.1, C8.1, U1.29 (VDD_SPI)
/XTAL_IN: C12.1, R2.2, Y1.1
/XTAL_N: C13.1, U1.53 (XTAL_N), Y1.3
/XTAL_P: R2.1, U1.54 (XTAL_P)
GND: C1.2, C2.2, C3.2, C4.2, C5.2, C6.2, C7.2, C8.2, C9.2, C10.2, C11.2, C12.2, C13.2, C14.2, C15.2, C16.2, C17.2, C18.2, C19.2, D1.1 (K), J1.A1 (GND), J1.A12 (GND), J1.B1 (GND), J1.B12 (GND), J1.S1 (SHIELD), J2.2, J3.1, Q2.2 (E), R3.2, R4.2, R10.2, R12.2, R13.2, SW1.2, SW4.2, U1.57 (GND), U2.2 (GND), U3.1 (GND), U4.1 (GND), U4.15 (R232), U5.4 (GND), U5.9 (EP), Y1.2 (G), Y1.4 (G)
VBUS: C14.1, J1.A4 (VBUS), J1.A9 (VBUS), J1.B4 (VBUS), J1.B9 (VBUS), U2.5 (VBUS), U3.3 (VI)

Notes on the sheet:
console-usb: the console with no radio in use. See hardware/console-usb/README.md. Every connection is a name: a net label or a power symbol at the end of each pin's stub.
The link. The USB-C's D+ and D- reach the CH340C and nothing else. TXD/RXD go to UART1 (GPIO18/17); MicroPython's REPL is never there. DTR and RTS are NOT connected, on purpose: the computer can't reset the S3 or start its bootloader. Don't add auto-reset.
LNA_IN floats and there is no antenna: the firmware never starts the radio (Espressif's checklist: an antenna is needed only if RF is enabled). Flash and PSRAM are in the package: SPI* and GPIO26 stay unconnected.
J2: pin order from the seller's listing. Check it on the panel before the layout.
J3 is not fitted: holes for a header at the bench. UART0 is the REPL and the ROM's flasher (hold D0, press RESET). Nothing reaches it through the USB-C.

Board: 2 copper layers, 57 parts (1 on the bottom side), 37 nets, no tracks yet.

Other parts of the board:
LCD1: 1.14in 240x135; LCD_1.14in_240x135_on_tape
LOGO1: PicoQuorum_Mark
