jmcpheron/pico-quorum/docs/console/firmware/main_console.py

# picoquorum-image: console
# main.py of the production image (tools/fw push console copies this file to :main.py). boot.py
# already showed the splash and joined WiFi. This starts the Safe console on its timer, then hands
# USB to the link (usblink.run), which never returns: while the console runs, a computer gets the
# link's few requests and never the REPL (docs/USB-LINK.md). tools/fw reads the console through
# the link, and asks it for maintenance to do anything else.
#
# Maintenance: hold B (on build1, the knob pressed down; D1 on the Feather and PicoquorumKey) while
# plugging the board in, and keep holding it until the onboard LED lights, or accept the link's
# maint ask on the screen (it leaves a file named "maint" on flash). The display stays off in
# maintenance. Then nothing starts: no console, no watchdog, only the USB REPL, for a restore or a
# repair.
try:
    import micropython
    micropython.kbd_intr(-1)        # first: MicroPython turned Ctrl-C back on for this file
except BaseException:
    pass
import sys
import os


def _plain(title, lines, color=None):
    """framebuf's own 8 px font: works when nothing else does."""
    import lcd
    import splash
    splash.stop()               # the boot art's timer must not draw over this
    d = splash.begin()

    def draw():
        d.fill(lcd.BLACK)
        d.center_text(title, 60, color or lcd.YELLOW, 2)
        y = 100
        for line in lines:
            d.center_text(line[:(d.width - 8) // 8], y, lcd.WHITE)
            y += 14
        d.show()
    d.frames(draw)


def _maintenance():
    if "maint" in os.listdir():
        return True
    import board
    return getattr(board, "MAINTENANCE", False) or board.key_down(board.MAINT)     # B, the knob's push on build1, D1 on the Feather


_quorum = None
_maint = False
try:
    import image
    if _maintenance():
        _maint = True
        print("maintenance: the console is not started")
        # Leave the heap and USB free even when the display driver is broken.
        from machine import Pin
        import board
        Pin(board.LED, Pin.OUT).on()
    else:
        # The big blocks first, while the heap is still in one piece: the framebuffer (lcd), every
        # font (bold26 alone is 10.9 KB) and the 32 KB that HTTPS borrows for each call. Everything
        # imported after them fits in what is left; the other way round the heap ends up in pieces
        # too small for any of them (2026-09-26, on the board).
        # The boot art keeps moving on its timer (boot.py, splash.run), but not while the big blocks
        # are taken or the console's modules load: its frames' small objects must not land between
        # them. With the art running through the imports, the console loaded in 3.5 s and left no
        # free block over 17-26 KB; Build 1 then stopped on boot, unable to find 1,280 bytes in one
        # piece with 221 KB free. Paused, the imports take 0.9 s and leave a 95 KB block (2026-10-03).
        import gc
        import lcd
        import splash
        splash.pause()
        gc.collect()
        import fonts
        for _f in fonts.FILES:
            fonts.get(_f)
        import txservice
        txservice.reserve_early()
        import quorum
        splash.pause(False)
        quorum.start()
        _quorum = quorum
except Exception as e:
    try:
        with open("error.log", "w") as f:
            sys.print_exception(e, f)
    except Exception:
        pass
    sys.print_exception(e)
    try:
        import image
        _plain("STOPPED", ["The console did not start.", repr(e)[:29], repr(e)[29:58], "",
                           "error.log has the details.", "build " + image.BUILD])
    except Exception:
        pass

if not _maint:
    # USB is the link's from here, a console that stopped included: never the REPL. Never returns.
    import usblink
    usblink.run(_quorum)
