jmcpheron/pico-quorum/hardware/console-rp/bench/swdload.py

# Load a console-rp over SWD: MicroPython from its UF2, and files into MicroPython's own filesystem.
# The board's USB-C can't do it (it reaches only the CH343P), and J3's USB pins are only holes, so the
# debug probe is the way in. BRINGUP.md has the whole story.
#
#   uv run --no-project --with littlefs-python==0.19.0 python hardware/console-rp/bench/swdload.py \
#       RPI_PICO2-20250911-v1.26.1.uf2 main.py=hardware/console-rp/bench/stage0.py [--no-micropython] [--dry-run]
#
# Each NAME=PATH goes into the filesystem as /NAME. Needs probe-rs on the PATH (brew install
# probe-rs-tools) and a CMSIS-DAP probe on J3's CLK, DIO and GND. It writes the RP2350's flash only:
# nothing here talks to the key.
import hashlib
import os
import struct
import subprocess
import sys
import tempfile

# The MicroPython the first board was loaded with (micropython.org/download/RPI_PICO2, 2026-11-04).
UF2_SHA256 = {"0616a3a4298a3c32c9092b71a431867dafcb4250f467245bcf2b6fe9704e4548": "RPI_PICO2 v1.26.1"}
FAMILY_ARM = 0xE48BFF59         # RP2350, Arm, secure: MicroPython's own blocks
XIP = 0x10000000
# MicroPython's rp2 filesystem on a Pico 2 (ports/rp2: PICO_FLASH_SIZE_BYTES 4 MB, storage = all but the
# first 1 MB): littlefs v2, 4 KB blocks, 256-byte programming (_boot.py), readsize and lookahead 32.
FS_BASE, FS_BLOCKS, BLOCK = XIP + 0x100000, 768, 4096
PROBE = ["probe-rs"]
CHIP = ["--chip", "RP235x", "--protocol", "swd"]


def micropython_bin(path):
    """The UF2's Arm blocks as one image from 0x10000000. -> bytes. Other families are left out: the
    file also carries one block for 0x10ffff00 (family 0xe48bff57), which is for a UF2 copied to the
    boot drive, not part of MicroPython."""
    b = open(path, "rb").read()
    h = hashlib.sha256(b).hexdigest()
    if h not in UF2_SHA256:
        sys.exit("%s: sha256 %s is not a UF2 this script knows (UF2_SHA256)" % (path, h))
    img = {}
    for i in range(0, len(b), 512):
        m0, m1, flags, addr, size, n, total, fam = struct.unpack("<8I", b[i:i + 32])
        if m0 != 0x0A324655 or m1 != 0x9E5D5157:
            sys.exit("%s: block %d is not UF2" % (path, i // 512))
        if fam == FAMILY_ARM:
            img[addr] = b[i + 32:i + 32 + size]
    lo, hi = min(img), max(a + len(d) for a, d in img.items())
    if lo != XIP:
        sys.exit("the image starts at %#x, not %#x" % (lo, XIP))
    out = bytearray(b"\xff" * (hi - lo))
    for a, d in img.items():
        out[a - lo:a - lo + len(d)] = d
    print("%s (%s): %d bytes for %#x" % (os.path.basename(path), UF2_SHA256[h], len(out), lo))
    return bytes(out)
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
