jmcpheron/pico-quorum/(commit log)

2026-09-23 Restructure to the PicoQuorum layout: docs/, hardware/wiring/, cad/console/ (renames only)
    The picowallet build guide moves to docs/picowallet.md; the notes (CHIPMAP, TESTPLAN, SECURITY,
    UPSTREAM, UPSTREAM-ISSUE, HANDOFF, PLAN) to docs/; SOLDERING.md to hardware/wiring/; case/ to
    cad/console/. No content changes in this commit so rename detection follows the files through
    upstream merges. Paths are fixed in the next commit.
    Claude-Session: https://claude.ai/code/session_01C3cYskE8MaNMc3DwiMp1gS
    [base.stl, base_pink.stl, base_v3.stl, base_v4.stl, base_v5.stl, base_v5_qr.3mf, base_v5_qr_black.stl, base_v5_qr_white.stl]
2026-09-23 Paths for the new layout: case/ is cad/console/, docs link back to buildlog/images, notes name their new homes
    tools/lid, zez*, cad/console/gen.py and emu/server.mjs (/stl/) read and write cad/console/.
    Image links in docs/ and hardware/wiring/ climb back to buildlog/images. Comments and notes that
    named SOLDERING, TESTPLAN, CHIPMAP, UPSTREAM or PLAN now give the path. Every relative link in the
    tracked Markdown resolves; the emulator serves the case STLs from the new place.
    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
    [atecc.py, atecc_sim.py, chipcheck.py, gen.py]
2026-09-23 PicoQuorum docs: the kickoff with its upstream credit corrected, NOTICE, a new README, BOM, key stubs, tracking upstream
    docs/KICKOFF.md is the project kickoff. Upstream is Austin Griffith's picowallet on an ATECC608,
    not a Trust M project, so the credit, the secure-element table and the checklists say so, and a
    status table maps the five firmware layers to their files. NOTICE lists every upstream and
    third-party source and license. The README is PicoQuorum's front page; picowallet's build guide
    stays in docs/picowallet.md. hardware/bom has the dev console's parts and the first order;
    hardware/key-pcb and cad/key are placeholders. docs/UPSTREAM.md says how to merge upstream now
    that files ha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
2026-09-24 Fork as PicoQuorum: kickoff doc, attribution, skeleton, and an on-device Safe transaction hash
    PicoQuorum is a Safe multisig signer: a Pico console with guarded Sign and easy Reject buttons,
    and secure-element keys on a dual plug. The picowallet code stays where it is and still works.
    - firmware/safe_tx.py: Safe >= 1.3.0 EIP-712 safeTxHash from the raw fields, and the 8-char
    verify code; reuses keccak.py
    - test-vectors/: 9 vectors (7 made up, 2 real Safe{DAO} mainnet transactions) from viem via
    tools/vectors/gen.mjs, which also checks viem against Safe's service; runners for CPython and
    MicroPython 1.26, both 9/9
    - docs/KICKOFF.md (living draft, credit corrected: upstream is ATECC608,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
    [run.py, safe_tx.py]
2026-09-25 README and KICKOFF: open with what PicoQuorum is, a physical approval device for Safe multisig wallets
    Claude-Session: https://claude.ai/code/session_01Jvvo5FDhAN2YPbxhJzbt1F
2026-09-25 decode.py: a Safe transaction in plain language, checked against hand-written expectations on CPython and MicroPython
    quorum_cfg.py pins the simulated Safe (chain 31337), the address book, tokens and known batchers,
    as a JSON-valid literal the laptop mock can read too. decode.review() turns to/value/data/operation
    into items with a level: sends, ERC-20 transfer/approve/transferFrom, MultiSend batches unpacked per
    call, the Safe's own settings (owners, threshold, modules, guard, fallback handler: red),
    delegatecall (red), gas refunds (red), unlimited approvals (red), and anything else as an unknown
    call (red) with its calldata digest. Six new vectors; gen.mjs writes each vector's expectation.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
2026-09-25 tools/quorum: a simulated 2-of-3 Safe and a mock of Safe's transaction service for the console
    The mock answers the console's endpoints at Safe's real paths and shapes (safes/{safe},
    multisig-transactions, confirmations), hashes with viem, and checks every confirmation the way the
    Safe would: ECDSA from the simulated co-signers Alice and Bob (anvil accounts 1 and 2), P-256
    r||s from a console that announced its key on /sim/device. At threshold it executes: the nonce
    moves on and owner and threshold changes take effect. Eleven scenarios, including a service that
    lies about the hash and one that slips in another Safe's transaction; a dashboard at /.
    test.mjs: every scenario hashes the same in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
2026-09-25 quorum.py: the console's Safe approval screens, signing with the chip against the simulated Safe
    The queue on one screen; per transaction a summary, one page per thing it does, red pages for
    anything that can take the Safe from its owners, and a verify page with the hash computed on the
    device. SIGN stays grey until every page has been seen, then A is held 2 s (3 s when a page is
    red). Y rejects on the console, B goes back, X opens the chip map as in the wallet.
    Every transaction is rehashed from the fields on screen with the chain and Safe pinned in
    quorum_cfg.py; a different safeTxHash or Safe is REFUSED and cannot be signed. The chip signs the
    hash computed here. txservice.py talks to Sa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
2026-09-25 Console screens, iteration 2: real anti-aliased type, a new theme, who's being called, the Safe version
    - fonts.py draws Atkinson Hyperlegible Next and Mono (SIL OFL, Braille Institute), rendered by
    tools/fonts/gen.py into 34 KB of 4-bit glyphs and blitted in C through a 16-colour palette. The
    8x8 framebuf font scaled 2-4x was the blocky look.
    - quorum_ui.py rewritten on colour tokens (dark default, light via QUORUM_THEME), rounded cards,
    key badges beside what each button does, and sentence case.
    - Contract identity: quorum_cfg.py pins known contracts (Safe MultiSend, USDC, Uniswap Router and
    Permit2) with a monogram logo; queue rows, the summary header and page headers show it, and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
2026-09-25 docs/quorum-ui/SCREENS.md: a plan for the approval flow on the six screens on order
    The Lonely Binary kit (0.96" to 3.5": ST7735S, ST7789, ST7796): what each size is for (status
    strip, pocket signer, console, one-screen console), the rules that never change with size,
    layout blocks that paginate per screen instead of fixed positions, drivers, banded drawing for
    320x480, emulator sizes and per-size walkthrough shots, the order of work, and the questions
    that pick the console's screen. Linked from the walkthrough and the kickoff's screen candidates.
    Claude-Session: https://claude.ai/code/session_016JQw5Xk6GET78FuXALvVz6
2026-09-25 Boot screen options: four animations as GIFs in the walkthrough
    emu/sketches/bootfx.py draws each option frame by frame (quorum: owners link up and vote 2 of 3;
    plug in: the dual-plug key goes into the jack and lights; hash rain settling into the name;
    checklist: the real boot steps ticking off), and tools/bootgifs captures them from the emulator
    at the firmware's 50 ms tick into docs/quorum-ui/boot/.
    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
2026-09-25 Build log: the Safe console on the Pico, and the chip's first approvals of (simulated) Safe transactions
    Board survey, what was copied and appended, the boot animations timed on the chip, and the
    session: three transactions signed by the ATECC608 and verified on the Mac, three rejected on the
    console, the lying one refused and never signed. Gotchas: a console rejection blocks the Safe's
    queue, restart the mock after editing it, ship's 'blocking loop' during the WiFi join.
    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
2026-09-25 docs/HEGOTA-WATCH.md: which Hegotá EIPs could matter for a P-256 hardware multisig
    Frame transactions could let the console submit Safe transactions itself;
    state-diff assertions could make the chip sign the outcome the screen showed;
    keyed nonces could give parallel approval queues; ML-DSA precompiles need a
    new chip. Linked from the kickoff's open signature-format decision and the README.
    Claude-Session: https://claude.ai/code/session_01KVjFRyEzwLNsqRe7rys41t
2026-09-25 webauthn.py: the chip's signature packed for Safe's passkey signer, checked against the deployed contracts
    Layer 3. A P-256 key can't own a Safe by itself, so each chip key owns it through its own
    SafeWebAuthnSignerProxy: Safe's audited passkey signer, safe-modules passkey v0.2.1, pinned in
    quorum_cfg.py "signer" with the proxy's creation code.
    - assertion(): what the chip signs, sha256(authenticatorData || sha256(clientDataJSON)). The
    challenge is the safeTxHash computed on the device, so it is still no blind signature.
    - contract_signature(): the Safe's v=0 layout around abi.encode(authData, fields, r, s).
    - owner_address(): the proxy's CREATE2 address, computed on the console.
    - verifi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
2026-09-25 Console screens, iteration 3: the chip signs as its passkey signer, and the simulated Safe checks the real format
    - quorum.py: my_owner() is this key's signer proxy (webauthn.owner_address). The chip signs the
    WebAuthn digest of the hash computed here, and the confirmation it posts is the Safe contract
    signature.
    - tools/mock-tx-service:
    - sigs.mjs, written against viem and noble and never the firmware: the proxy's address, parsing
    a contract signature, the proxy's WebAuthn check, and laying out signatures for execTransaction.
    - sim.mjs accepts those and drops the raw 64-byte r||s. It has hooks for a forked chain under it.
    - test.mjs packs through firmware webauthn.py, with nob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
2026-09-25 tools/quorum up and e2e: the Family Safe as a real Safe 1.4.1 on an Anvil fork of Base (test ladder rung 1)
    The console's approvals now execute for real. `tools/quorum up` forks Base with anvil (chain 31337,
    one pinned block in fork.json, so the public RPC's rate limit and anvil's cache get along), then
    runs the same service with --chain:
    - chain.mjs setup: checks for Safe 1.4.1, the passkey factory (and that quorum_cfg's proxyCode is
    in it) and the P-256 precompile; creates the Family Safe at its pinned address; funds it with
    10 ETH and 10k USDC; snapshots so `demo`/`reset` roll back.
    - A console that announces gets its signer proxy deployed and added as an owner.
    - Contract signatures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
2026-09-25 docs/LOCKING.md: the dev chip read before any lock, checked onchain, and what each lock would do
    A read-only readout of chip 0123f3ac:
    - config locked, data zone open, no slot locks
    - keys in slots 0 and 2; slot 2 isn't lockable
    - CountMatch on slot 10
    - the config is cryptoauthlib's test table
    Both keys' owner addresses match the passkey factory on Base Sepolia, Base and Ethereum. A real
    slot-2 signature passes isValidSignatureForSigner on all three.
    What each lock does, sourced from the datasheets:
    - A slot lock doesn't need the data lock, and it is the only thing that fixes the key (and so the
    owner).
    - The data lock would spring CountMatch unless slot 10 is written first.
    - While the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
2026-09-25 quorum.py: load every font at start, while the heap is whole
    On the board, after a tour of the chip map, bold26 (one 10.9 KB block, loaded on first use) no
    longer fit in the fragmented heap and every review-page redraw failed with MemoryError. That is
    how #0 got rejected twice by a console that couldn't draw.
    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
    [quorum.py]
2026-09-25 Rung 1 on the real Pico: the chip's approval executed a real Safe transaction on the Base fork
    Slot 0 (9fad2e82) approved #0 through its signer proxy 0x2843…5E53: execTransaction in 109,488 gas.
    The same signature passes Safe's passkey signer on Base Sepolia, Base and Ethereum. Counter 0 went
    7 → 8. LOCKING.md and LADDER.md are ticked, and the buildlog has the run and the MemoryError that
    came before it.
    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
2026-09-25 quorum.py: load the chip map on the first X and drop it on the way home, so HTTPS has room
    On the board, with api.safe.global as the service, every call failed with OSError 12. There was
    116 KB free, but no single free block of even 8 KB: the chip map's modules (slots, chipmap, learn,
    ceremony, qrcode, about 80 KB of source compiled on the Pico at start) had left the heap in pieces,
    and TLS needs one buffer of about 16 KB.
    Loaded only while it is open, the chip map leaves 173 KB free at start, with a 32 KB+ block, and
    the console reads the Base Sepolia Safe over HTTPS. The screenshots are unchanged.
    Claude-Session: https://claude.ai/c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
    [quorum.py]
2026-09-25 txservice.py: hold a 32 KB reserve for HTTPS and let go of it only during each call
    After a review on the board, 154 KB of heap were free but no block was over 8 KB, and the POST of
    the chip's confirmation to api.safe.global failed with OSError 12. The signature was kept, posted
    from the laptop and accepted (201), and #1 executed. An https Service now takes one 32 KB block
    at start and frees it just for each call, so TLS always finds its ~16 KB buffer. The chip map
    borrows the reserve while it compiles.
    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
    [quorum.py, txservice.py]
2026-09-25 Rung 2 on Base Sepolia: the emulator's and the Pico's approvals accepted by api.safe.global and executed; HTTPS timeout 15 s on the Pico
    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
2026-09-25 Rung 2 end to end: the Pico fetches, signs and posts its own confirmation over HTTPS; #2 executed on Base Sepolia
    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
2026-09-25 Slot 0 sealed: lock bytes fe ff, the same enrolled key, and a post-lock signature valid on Base Sepolia, Base and Ethereum
    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
2026-09-25 live pico: switch the Pico's console between networks in one command (settings backed up, console restarted and read back); the Pico sends its API key only over HTTPS
    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
2026-09-25 upstream/safe-wallet-gs021: Base mainnet evidence, the same GS021 with the Pico's confirmation on a real-money Safe
    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
2026-09-26 tools/usb: push never copies secrets.py, so the board keeps its WiFi, API key and Safe; refused on a production-image board
    Claude-Session: https://claude.ai/code/session_01L1EKUmNDKakSfiGYx9AYrs
2026-09-26 quorum.py: the console signs only with the pinned chip, slot and owner, counts the chip's signatures, and refuses unpinned delegatecalls
    - QUORUM_EXPECT pins the chip's serial, the slot, its lock and the owner address; checked at start and again before every signature. slot.txt no longer picks the key.
    - The production image (build.py IMAGE="console", image.py): no fallback Safe, no software key, ALLOW_* flags ignored, no network console, the chip map gone (X shows a read-only Device screen).
    - Counter 0 read at start and around each signature; signatures made outside the console are flagged and logged.
    - decode.review refuses delegatecalls except a multiSend to a pinned batcher or a pinned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
    [atecc_sim.py, console_test.py, decode.py, image.py, machine.py, main_console.py, net.py, policy.py]
2026-09-26 tools/fw: images from firmware/manifest.json, and a board that is backed up, pushed, verified and pinned with every hash checked
    - firmware/manifest.json lists exactly what the console and ceremony images put on the board; test-vectors/manifest.mjs checks each is the import closure of boot.py + its main, that the console image holds nothing else that can change the chip or sign (quorum.sign_it is the one place), and that no image carries secrets.
    - main_ceremony.py + chipapp.py: the chip map as its own image, with a banner that says it is not a signing console.
    - tools/fw build | backup | verify [--baseline] | logs | pin | push | restore | measure. Reads pause whatever app runs on the board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
2026-09-26 tools/emu ship and tools/quorum live pico: a production-image board is left to tools/fw; live pico restarts it with a reset
    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
2026-09-26 Boot screen v2: a 3-of-5 star whose quorum becomes a spinning Ethereum diamond
    emu/sketches/ethboot.py: five amber owners on a star; the top and the two legs sign and turn
    Ethereum blue, closing the star's tall triangle. That triangle is one face of a pyramid seen
    head-on: the camera pulls back, the pyramid turns, an inverted pyramid rises beneath, and the
    diamond spins down into the logo's pose (a square pyramid repeats every 90 degrees, so the spin
    can last as long as the boot and still land there). Flat-shaded framebuf.poly triangles, at most
    four a frame.
    docs/quorum-ui/v2/README.md: the plan for the redo (boot screen, wiring it to the real boot
    steps, type, colour and graphics), the ne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
    [ethboot.py]
2026-09-26 vhttp.py: HTTPS with the server's certificate checked against three pinned roots; the API key is written only after the handshake
    MicroPython's requests sets CERT_NONE, so on the board the API key would go to anyone answering
    for api.safe.global. vhttp.py: one TLS context built at start with Amazon Root CA 1 and 3 and
    Starfield Services G2 (DER, exported from the macOS root store; fingerprints in the file), SNI and
    the hostname check, the clock set from NTP first (mbedTLS checks dates) and never below the build's
    date, the body capped at 48 KB. txservice uses it on the board for every https call; the emulator
    keeps the host's curl. A development board may turn it off with QUORUM_TLS_VERIFY =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
2026-09-26 chipcfg.py: quorum v1, PicoQuorum's own ATECC608 config, and the ceremony that seals a fresh chip with it, each zone locked against a CRC the chip checks
    - quorum v1: slot 0 a P-256 key made by GenKey, external Sign only, no PrivWrite, LimitedUse on
    counter 0 (CountMatch off: no slot-10 trap); slots 1-15 dead; IO protection, KDF, SecureBoot,
    UseLock off. Guarded like the legacy table: fingerprint, shape asserts at import, and
    tools/check_config decoding every slot again from the datasheet's bit tables.
    - provision.py: C1 pre-flight .. C10, worked out from the chip's own state so a reboot resumes;
    config and data locks with the CRC summary (a table one bit off is refused by the chip),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
    [atecc.py, atecc_sim.py, ceremony_test.py, chipapp.py, chipcfg.py, chipmap.py, provision.py, signer.py]
2026-09-26 docs: the production console and quorum v1, with a screen walkthrough, the provisioning runbook, a PicoQuorum security model, and the ladder's real-money checklist
    - docs/firmware-production/: every new screen (Device, pin fail, refused delegatecall, the chip's
    signature count, maintenance, the ten ceremony steps), drawn by the firmware on the emulator.
    - docs/PROVISIONING.md: the quorum v1 table byte by byte, the CRC locks, the OTP record, the
    C1-C10 runbook, what only silicon can settle, and the PIN variant costed and deferred.
    - SECURITY.md starts with the PicoQuorum console's model; picowallet's is labelled legacy.
    - LADDER.md, LOCKING.md, TESTPLAN.md, tools/README.md, upstream statu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
    [policy.py, provision.py, quorum.py, quorum_ui.py]
2026-09-26 Fonts for v2: five candidate sets side by side on a specimen card and six real screens
    docs/quorum-ui/v2/FONTS.md compares today's Atkinson Hyperlegible with Inter, Inter with its ss02
    alternates (I, l and 1 all different), Space Grotesk + JetBrains Mono, IBM Plex, and Manrope:
    what each does to look-alike characters, which layouts they break, and a recommendation.
    - tools/fonts/gen.py --try renders candidate sets (SETS) into emu/sketches/qf_SET_NAME.bin, with
    axes set by name (weight, Inter's optical size), OpenType features, and GF_DIR to copy the
    typefaces from a google/fonts checkout. Today's firmware/qf_*.bin are unchanged.
    - firmware/fonts.py: use(SET) swaps every size to a candid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
    [fonts.py, fontspec.py, gen.py]
2026-09-26 tools/fw measure tls: follow the console's order at start, and tell a memory failure from a certificate refusal
    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
    [measure_tls.py]
2026-09-26 tools/fw build: every module but boot.py and main.py goes on the board as .mpy (mpy-cross 1.26.1); main_console takes the fonts and the HTTPS reserve before the console's modules load
    The console image compiled on the Pico failed to start: 191 KB free, no block over 5.7 KB, and a
    5.8 KB font would not load (found by running it from a mount, nothing written to flash).
    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
    [main_console.py, txservice.py]
2026-09-26 buildlog: the board, read-only: backup, chip #1's baseline, the TLS hazard confirmed, and the compiled console image passing verified TLS from a mount
    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
2026-09-26 hardware/HANDOFF.md and wiring/BUILD1.md: Build 1 on the bench (2.0" ST7789, EC11 knob, 3.5 + 2.5 mm TRRS key jacks, ATECC608 stand-in key)
    - BUILD1.md: pin map per part, reserved and free pins, how the key is
    detected (J1 ring 2 to sleeve on GP7) and powered (GP6, only after
    DETECT settles), the key's plug wiring and meter checks
    - build1-wiring.svg, drawn by tools/wiring-build1; --check compares its
    pin table with BUILD1.md, HANDOFF.md and firmware/bench1.py
    - HANDOFF.md: parts on hand and what each unblocks, build order with
    pass tests, damage rules, firmware to-do, open decisions, pin change log
    - firmware/bench1.py: read-only bench test (320x240 screen, knob,
    detect/power/scan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
    [bench1.py]
2026-09-26 review fixes: the Anvil names only on the local chain, the seal only after C5 passes, the chip re-read before each signature, and tools/fw safer
    From an independent review of the branch:
    - quorum.py never passed the chain to decode.context, so the bookChains gate did nothing: on Base
    mainnet a send to an Anvil address (an EIP-7702 sweeper there) showed as "Alice".
    - provision.py offered C6 (the permanent seal) after a failed C5, because a failed test signature
    raises the counter too. The seal now needs C5 passed this session, and C6 signs and verifies once
    more first. A result dismissed with A no longer starts the next hold until A is let go.
    - sign_it re-reads the chip's serial and th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
    [ceremony_test.py, console_test.py, provision.py, quorum.py, txservice.py, vhttp.py, watch.py]
2026-09-26 tools/fw: hands off for 30 s after a reset (a probe's Ctrl-C stopped the console mid-start on the first push); flags read from the file itself; tools/fw restart
    The production console is on the board: pinned, TLS verified, watchdog on (buildlog).
    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
2026-09-26 tools/quorum live pico: 30 s hands off after resetting a production board
    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
2026-09-26 buildlog: power cycle: the console boots itself, pinned, counter unchanged
    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
2026-09-26 chips.py: the board remembers every chip it has seen (chips.json): chip 1 dark, chip 2 light; both images identify the chip at boot and draw in its theme
    - The console identifies the chip's config at boot (chipcfg.identify: quorum v1, the test table,
    fresh), registers it, and uses its theme. Its name shows on the boot screen and on Device. It
    stays cosmetic: the pin decides what gets signed, and chip 2 on a board pinned to chip 1 is
    refused.
    - The ceremony image's banner names the chip and says whether it is fresh; PROVISION draws in a
    light palette for a light chip; C10 records the owner in chips.json.
    - tools/fw chips lists the index; tools/fw allow on|off sets ALLOW_LOCK and ALLOW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
2026-09-26 tools/fw: list the board's files one per line and lend the tool the console's HTTPS reserve while it reads (a running console left no 3.4 KB block for one big listing)
    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
2026-09-26 main_dual.py: a dual image for the provisioning period: at every boot it reads the chip on the bus and runs the console for the pinned chip, the ceremony for a fresh (or half-sealed quorum v1) chip
    The board ran whatever image was on its flash, so chip 1 put back got the ceremony too. The dual
    image carries both. The console path keeps the production rules (image.PRODUCTION is on by default
    for "dual"). The ceremony path turns them off only for a chip that is not the pinned one and is
    fresh, or quorum v1 with its data zone still open. tools/fw push dual; back to push console once
    the new chip is sealed, enrolled and pinned. Tests: ceremony 75 (the choice for every kind of chip,
    no chip, and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
2026-09-26 provision.py: a bar fills while B+Y are held to arm, and 'let go early: not armed' if they are let go too soon
    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
2026-09-26 provision.py: arm with B+Y in either order; a full arm bar waits for both keys to be let go, and the 60 s start then; Y is back only on release, and only alone
    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
2026-09-26 buildlog: chip 2 C4-C6: key e199b2d7 sealed in slot 0, owner 0x99eD...6b88 confirmed by the factory onchain
    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
2026-09-26 provision.py C8: fill the dead slots with whole 32-byte blocks, the last starting at the slot's tail; chip 2 refused 4-byte writes into them before the data lock
    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
2026-09-26 quorum.py: a sealed quorum v1 chip counts public-key reads as uses of the key (found on chip 2); the console takes the count before its own reads and flags only uses it didn't make
    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
    [atecc_sim.py, ceremony_test.py, console_test.py, quorum.py, quorum_ui.py]
2026-09-26 quorum.py: Check again on the pin-fail screen reads the key; save the count after it so the console's own reads are never flagged (the 3 flagged on chip 2: one laptop test read, two Check again press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
    [ceremony_test.py, quorum.py]
2026-09-26 tools/quorum live pico: the dual image restarts with a reset too
    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
2026-09-26 tools/fw pin: use the running console's serial and key, so pinning reads nothing new from a sealed chip
    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
2026-09-26 quorum.py: a signature the service did not take is kept on flash and sent after the next boot; a lost HTTPS reserve restarts the console from home; the reserve is taken back before a response is pars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
    On chip 2 (dual image) the reserve could not be taken back after a poll: what the console kept
    from the response landed where the reserve goes, and the confirmation's POST then failed with
    OSError 12 (free 100 KB, largest block 10.6 KB). Now:
    - txservice reads the body, closes the connection, takes the reserve back, and only then parses
    the JSON; if the reserve still does not fit, Service.lost is set.
    - on home, a lost reserve restarts the board (at most once in 10 minutes; logged).
    - unsent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
    [console_test.py, quorum.py, txservice.py]
2026-09-26 QUORUM_EXPECT pins several chips: at boot the chip on the bus picks its entry (serial), and signs only if that entry's slot, lock and owner all match; tools/fw pin adds the chip on the bus to the list
    Any of the owner's chips can be plugged in (USB off) and used, each as itself. A chip not on the
    list is refused; a fresh one still boots the dual image's ceremony. The single-dict form still
    works. tools/fw pin keeps the others (--only replaces them); allow on refuses for any pinned chip.
    Tests: console 86 (two pinned, one missing, a listed serial with the wrong owner).
    Claude-Session: https://claude.ai/code/session_01L1EKUmNDKakSfiGYx9A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
    [console_test.py, main_dual.py, policy.py, quorum.py, quorum_ui.py]
2026-09-27 Boot screen iteration 2: the owners spin in on a ring or an orbit, no star
    The one-stroke star could read as a pentagram. emu/sketches/ethboot.py gains two ways in, both
    landing the five owners exactly where the star had them, then carrying on as before without the
    star's lines:
    - ring: they spin round a faint circle with comet tails and slow to a stop, one at the top
    - orbit: a small ring tipped back in space, stars drifting behind, swings round to face us
    The star stays as a third option so iteration 1's GIF can be regenerated. A in the emulator
    cycles through them. docs/quorum-ui/v2/README.md shows both, with questions.
    Claude-Sess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
    [ethboot.py]
2026-09-27 hardware/wiring/BREADBOARD.md: Build 1 on a breadboard, no jacks, with a knob close-up
    - build1-breadboard.svg: the Pico across the gap, power on the rails,
    19 numbered jumper wires dropping straight to the chip, screen and knob
    - knob-ec11.svg: the EC11 from the side and from below, which leg is
    which, what each goes to, how A/B quadrature and the push work, the
    KY-040 board version
    - tools/wiring-breadboard draws both; --check compares the wire list
    with BREADBOARD.md and the GPIO pins with tools/wiring-build1
    - bench1.py: JACKS = False (default) for a chip wired straight to 3V3;
    it reads the chip at start and never touches GP6/GP7
    - HANDOFF.md build order: breadboard now, jacks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
2026-09-27 QUORUM_SAFES: one console watches up to 4 Safes on any mix of chains, asks each at its own chain's service (quorum_cfg "services", one Safe per poll in turn), and shows one queue; the config's tokens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
2026-09-27 Boot screen iteration 6: one clock, green fills from the bottom, the name in front
    The orbit paused its clock before each signature, freezing whatever was moving (a ring halfway
    out, a line partway drawn, the triangle before the turn). It now runs on its own timeline that
    never stops: the waiting owners keep breathing, the rings spread and fade over 0.8 s, the lines
    ease in, and green fills the triangle from the base up with a soft glow instead of a flash,
    turning straight out of it.
    The diamond no longer stops: it grows, centres and dims behind the PicoQuorum name, which comes
    up with a new mark (five owners, three signed, their green triangle), and taglines cycle under
    it while it keeps t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
    [ethboot.py]
2026-09-27 Build 1 screen: use the bench screen's printed pin names (3V3, SCL, MOSI) and draw its header order
    The 2.0" board on the bench prints BL, RST, DC, SCL, MOSI, CS, 3V3, GND
    down its right edge: the same 8 signals as before under other names.
    Same Pico pins, no firmware change.
    - PINS, BUILD1.md, HANDOFF.md: VCC -> 3V3, DIN -> MOSI, CLK -> SCL
    - build1-breadboard.svg: the screen's header in its real order, each
    pin with its wire number and destination; SCL flagged as the screen's
    clock, not the chip's I2C SCL
    - BREADBOARD.md: the screen section as a printed-name -> Pico table
    Claude-Session: https://claude.ai/code/session_012k2c8ChP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
2026-09-27 Support Build 1 displays and stabilize firmware updates
    [board.py, boot.py, boot_maintenance_test.py, fonts.py, knob.py, lcd.py, main_ceremony.py, main_console.py]
2026-09-27 Record loading-screen performance measured on Pico
2026-09-28 A lite boot screen GIF: the panel's 240 px, 10 frames a second, 48 colours
    The full orbit GIF (360 px, 20 frames a second, 402 frames, 1.1 MB) lags on slower viewers.
    tools/bootgifs --lite also writes OPTION-lite.gif: every other frame at 100 ms, the panel's own
    pixels kept sharp (nearest-neighbour), 48 colours; 0.2 MB. The v2 page shows it inline and links
    the full one. The GIF code moved into a function; every existing GIF regenerates unchanged.
    Claude-Session: https://claude.ai/code/session_01VwsX5t6CBqTaer3oW2cveF
2026-09-29 Support the OPTIGA Trust M beside the ATECC608: detect at boot, sign, and a quorum-tm1 ceremony
    - signer.detect() finds either chip on I2C0 (a sleeping Trust M NACKs scan(), so 0x30 is polled);
    load(pins=) prefers the pinned one. TrustMSigner and ChipSigner share the console's interface
    (serial(fresh), key_row, profile, use_counter, needs_ceremony, info); quorum.py, main_dual and
    chipapp go through it.
    - trustm_q.py (GenKeyPair, SetDataObject, lifecycle, metadata, error codes) over upstream's
    unchanged trustm.py; tmcfg.py: metadata, the Infineon certificate check, the F1D0 record and the
    E0F0 key binding, and the screen lines.
    - provision_tm.py: T1-T8 on the shared ceremony screen.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
    [atecc_sim.py, chipapp.py, chips.py, machine.py, main_dual.py, provision.py, provision_tm.py, quorum.py]
2026-09-29 Ceremony image on Build 1: draw every screen strip by strip, drive it with the knob
    The banner, the ceremony steps and the Trust M object map drew once and called show(), so the
    strip-buffered 320x240 panel only ever got its top 30 rows: a black screen. They go through
    d.frames now. On build1 (A/B/X/Y not wired) the knob drives the ceremony: turn to choose
    do it / back, press to act; on a permanent or GenKey step one 3 s hold arms and a second does it.
    The boot art is released before the banner. test-vectors: case_knob.
2026-09-29 Trust M ceremony: T1 resumes a ceremony started elsewhere
    On the board, the Trust M that ran T1-T6 from the laptop stopped at T1 ("E0F1 empty", "no
    record yet" failed): its snapshot was on the laptop, so the board saw no T1. T1 now accepts
    E0F1 holding a key when F1D0 holds our record for this serial, still checks the cert, E0F0,
    lifecycle and security events, and the ceremony resumes at T3, which proves the key matches the
    record. A key without our record still stops.
    Claude-Session: https://claude.ai/code/session_018VxLv8Exi5pQ6LLVcdkqFD
    [provision_tm.py, trustm_test.py]
2026-09-29 Chip pages: the chip, its factory certificate and the signing key, from the Device screen
    The Signing screen's four chip lines go by in about a second. Device -> Chip (A, or the knob)
    now shows them at leisure, read off the chip when opened: part, CC EAL6+, firmware, serial,
    wafer, lifecycle and security counter; the Infineon certificate's issuer, subject, serial,
    validity (now parsed), the CA check and the factory key; E0F1, sealed or not, access, public
    key, owner, the binding and when the record was written. Long rows continue on the next page.
    An ATECC gets its own page. Boot now also checks the certificate against the pinned Infineon CA
    key: "Bound to Infineon cert" needs both the chain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
    [quorum.py, quorum_ui.py, quorum_ui_s.py, signer.py, tmcfg.py, trustm_test.py]
2026-09-29 Watch several Safes on one chain; the production console ignores a stale APP_URL
    live pico takes --safe A,B and --name N1,N2 for one chain (up to 4), without saving either as
    the chain's default. Removing QUORUM_URL let the legacy APP_URL (the board still had an old
    laptop address) take over and every request went to a dead plain-HTTP host: "connection reset"
    on both Safes. Only a development console falls back to APP_URL now; production uses Safe's
    own service per chain unless QUORUM_URL is set.
    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
    [console_test.py, quorum.py]
2026-09-29 Owners screen scrolls; the single-buffer 240x240 board skips the boot animation
    Owners: three a page (four on the 160x128), down/right or a dial turn for the next page, up/left
    back, a "2 of 3 . down" marker; a 3-of-5 or larger Safe no longer loses owners past the fourth.
    splash: the orbit animation is only for strip-buffered panels (BANDS > 1). On the Waveshare
    240x240 board (one 115 KB frame, ~109 KB free after the console is imported) it ran the heap out
    at boot: MemoryError in bootart.render. Buildlog 2026-09-29-waveshare.md, with the measurements
    and why config edits on that board go through maintenance.
    Claude-Session: https:/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
    [console_test.py, quorum.py, quorum_ui.py, quorum_ui_s.py, splash.py]
2026-09-29 Strip-buffer the 240x240 Waveshare board: the 115 KB frame left HTTPS no room
    On the Waveshare board (one 115 KB frame) the console had ~109 KB of heap once imported; on some
    boots HTTPS found no 16 KB block: OSError 12 on every call, svc.lost, and the 10-minute restart
    guard landing on the same layout. Any panel whose frame is over 45 KB is now strip-buffered as
    build1's is (BANDS = 8, a 14 KB buffer at 240 wide), about 100 KB of heap back, and the boot
    animation runs on it again. The 1.8" keeps one frame. Test: the 240x240 board is strip-buffered.
    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
2026-09-30 A boot-animation frame that runs out of memory is skipped, not fatal
    With the Trust M on the 240x240 board the certificate checks (big-number math) left the heap in
    pieces, and one failed 1.3 KB allocation in bootart.render ended quorum.start(): the console never
    came up. splash.draw now catches MemoryError, collects and skips the frame, and start() collects
    after the chip probe. Test: a render that raises MemoryError does not propagate.
    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
    [console_test.py, quorum.py, splash.py]
2026-09-30 A light boot screen: the PicoQuorum mark, sending only what changed
    The orbit redraws and sends the whole panel every frame (100-130 ms on the Pico). bootmark.py
    draws the orbit's end mark as flat shapes (five owners, three sign, the triangle fills green, two
    stay amber, the name fades in) and each frame repaints only the rectangles whose look changed,
    in lcd's own buffer, each sent to its own window: about 6% of whole-frame bytes in the emulator.
    The default now; secrets.BOOT_ART = "mark" | "still" | "orbit" | "checklist". Runs on every panel,
    the 1.8" included. net.connect calls progress every 50 ms so it keeps moving while WiFi joins.
    Test: run-bootmark.mjs compares the panel with a fresh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
2026-09-30 A refused confirmation says what the service said
    confirm() read only the service's `detail`, so a rejected signature showed "Signed, but the service
    said: " and nothing. Safe's validation errors come as {"nonFieldErrors": [...]} or {"signature": [...]}.
    The screen and log now carry "HTTP <code>: <message>" from detail, else the first message under any
    name, else just the code. Found when Trust M's confirmation was rejected because its signer contract
    is not deployed (its signature is valid: the factory returns 0x1626ba7e).
    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
    [console_test.py, txservice.py]
2026-09-30 Boot taglines: serious ones the firmware backs, fun ones for hackers
    firmware/taglines.py: 16 serious lines, each a claim the console makes true (it rebuilds the Safe
    hash itself, refuses a service that lies about it, makes the key in the chip with no seed phrase,
    shows plain words and a verify code), and 20 fun ones (Hackers, Silicon Valley, The Matrix,
    WarGames, Sneakers, Jurassic Park, Mr. Robot, Zero Wing, cyberpunk). The mark shows one per boot
    under the name (not on the 1.8"); the orbit cycles them. secrets.BOOT_TAGLINES = "serious"
    (default) | "fun" | "all" | "none". The test checks every line fits 220 px.
    Claude-Session: https: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
2026-10-01 Boot mark: the Ethereum diamond fades in spinning and lands in the corner
    After the mark (3.5 s), bootart.py's diamond fades in beside the owners, turning, and glides up
    into the top-left corner, landing on the logo's pose at 5.1 s, where it stays. One more element
    with a look (yaw mod 90, place, size, fade); a frame repaints the union of the box it was in and
    the box it is in. The hold is 5.3 s (was 3.8 s). Emulator: every one of 181 frames matches a
    fresh paint on 240x240, 320x240 and 160x128; 6.3% of whole-frame bytes on the 240x240.
    Walkthrough: docs/quorum-ui/v2/README.md, "The light mark, then Ethereum".
2026-10-01 Trust M: remember a pass of the factory checks; a boot timeline in log.txt
    The Trust M's factory certificate and key binding are two pure-Python P-256 verifies, 2.3 s each
    on the Pico (measured), every boot, over bytes that never change: UID, E0E0, F1D1, F1D0. A pass
    is now remembered by the SHA-256 of everything the two checks decide from (those bytes, the key's
    OID and the pinned CA key; tmcfg.proof) in tmproof.txt, kept across pushes. A boot that reads the
    same bytes has the same answer without the math; one changed byte runs both again, and a failure
    is never remembered. Not handed to the chip's VerifySign: the checks ask whether the chip is
    genuine, and a counterfeit would answer yes.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
    [boot.py, quorum.py, signer.py, tmcfg.py, trustm_test.py]
2026-10-01 Boot: the diamond lands on the logo; the owner address is remembered
    The diamond slows to a stop on the logo's pose behind the name (60 + 180 + 75 = 315°) instead
    of turning on: after WiFi the console's start takes the Pico for seconds without a frame, and a
    diamond frozen mid-turn looked like a hang. The yaw is rounded, not truncated (float32 on the
    Pico). The test checks it lands on 45° mod 90 and stays.
    The owner address (webauthn.owner_address, two pure-Python keccaks, 0.7 s on the Pico) is
    remembered in owners.txt by the SHA-256 of exactly its inputs (webauthn.owner_inputs: factory and
    init code), kept across pushes. Test: computed once, then remembered; another key computes.
    Co-Aut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
2026-10-01 Boot timeline: written before the timer starts (its first tick is the first HTTPS call)
2026-10-02 Boot: WiFi starts joining before the boot screen
    net.begin() switches the radio on, asks it to join and returns; boot.py calls it first, so the
    join runs while the screen comes up, and net.connect() only waits for what is left of its 12 s
    (counted from begin). The "boot ms" line now starts with when boot.py ran and when the radio was
    asked ("boot 900 radio 1200 art ...").
2026-10-02 Boot (prototype): the art on a soft timer while the console starts
    On the console image boot.py starts the art, a soft timer that draws a frame every 30 ms
    (splash.run), asks WiFi to join and returns without waiting: main.py's imports and the chip probe
    run while WiFi joins, under a moving screen, and quorum.start waits for what is left of the join.
    One core on purpose: MicroPython's second core on the RP2 has no GIL and its collector does not
    stop the other core, so two cores allocating can free an object in use; a soft timer runs between
    bytecodes, every object rooted. The timer skips a frame while one is drawn, pauses around main.py's
    big blocks (fonts, the HTTPS reserve) after a collect,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
    [boot.py, main_console.py, quorum.py, splash.py]
2026-10-02 Wi-Fi setup at power-up: a hotspot with a QR code, or the on-screen keyboard
    A board with no Wi-Fi saved (or Y held while plugging in) opens Wi-Fi setup
    before the console starts. The console makes its own hotspot and shows a QR
    code that joins it; the phone's captive-portal check lands on a page with the
    network list and a password field. Or pick a network on the console and type
    the password on an on-screen keyboard: the joystick moves on the grid, the
    build1 knob steps through every key.
    The console joins before it saves, so a wrong password shows up on the screen
    and the page. Networks go in wifi.json (up to 4, newest first, preserved by
    every push), which net.py tries before secrets.py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
    [board.py, boot.py, net.py, network.py, quorum.py, secrets.example.py, splash.py, wificfg.py]
2026-10-02 Trust M T9: freeze the spares; tools/fw ceremony start|finish
    The quorum-tm1 ceremony gains T8 (the seal checked), T9 (LcsO operational on
    every object the profile does not use: spare keys, cert and trust-anchor
    slots, counters, data objects; never termination, E140 left as it came) and
    T10 (done). TRUSTM_KEEP_OPEN leaves named spares open. A sealed chip from
    before T9 reaches it on the dual image only unpinned with ALLOW_LOCK on. The
    Chip page shows the spares; console boot reads nothing new.
    tools/fw ceremony start/finish wraps the swap (unpin, ALLOW_*, push dual;
    then ALLOW_* off, pin, push console, compare the pins), each after one yes.
    verify and backups record the board's flash space.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
    [main_dual.py, provision_tm.py, signer.py, tmcfg.py, trustm_sim.py, trustm_test.py]
2026-10-02 Ceremony record anyone can check: tools/fw attest, tools/quorum verify
    tools/fw attest reads a Trust M's public ceremony record off the board (UID,
    factory certificate, F1D0 record, F1D1 binding, every object's metadata) into
    docs/mainnet/attest/. tools/quorum verify re-checks it with Node's X.509,
    noble and viem, no board and no firmware: the certificate under Infineon's
    CA 101, the binding, the owner from the key, the seal and the spares as
    reported, getSigner and deployment per chain, Safe ownership. TM1's record
    passes on Base Sepolia, Base and Ethereum.
    T9's result lines fit 240 px; the Chip page says T9 freezes open spares.
    Shots of T8-T10 and the Chip page in docs/mainnet/shots (shot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
    [provision_tm.py, tmcfg.py]
2026-10-02 docs/mainnet: co-signers, threat model, configuration, runbook
    The shareable side of a Trust M signer in a mainnet 3-of-5 Safe: how other
    owners check a chip (tools/quorum verify, or getSigner on Etherscan), what a
    Pico approval does and doesn't mean, GS021 and live exec, a lost device; the
    honest limits (no PIN, open REPL, no use record on a Trust M, what the
    binding proves); the recommended Safe and the address lock-down options,
    still to decide; the operator's runbook from a fresh chip to an owner.
    TRUSTM.md gains T8-T10 and the spares; LADDER.md a Trust M rung.
    Claude-Session: https://claude.ai/code/session_01VLs77QjrEu7ZCaUH966677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
2026-10-02 docs/mainnet: the Safe stays off the chip; the spare key slots are the open question
    After talking it through: the goal is a key that never leaves the chip and
    can serve any Safe, so the Safe list stays in the Pico's config (option a).
    The address goes into the hash on the Pico; the chip never sees it. The
    decision left before T9 is whether to freeze E0F2/E0F3 (one key per chip) or
    keep them for a second key. The shareable guide now draws the chip's objects
    and the one-key-many-Safes picture.
    Claude-Session: https://claude.ai/code/session_01VLs77QjrEu7ZCaUH966677
2026-10-02 Trust M ceremony: record every step on the board
    T1's snapshot now holds every object's factory metadata, the 23 spares
    included. Each step appends its result to snapshot-tm-<serial>-steps.json
    (checks, message, security counter); T9's entry keeps each spare's metadata
    before and after, any refusal and how long it took. The file is preserved
    across pushes, so ceremony finish's backup carries it to the laptop.
    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
2026-10-02 TM2, the sacrificial Trust M: T9 and every refusal confirmed on silicon
    The whole ceremony ran on the device; T9 raised all 23 spares to operational
    in 1.2 s, changing only the lifecycle byte. Then, from the laptop, GenKeyPair
    on the sealed E0F1 and a frozen E0F2, writes to the sealed F1D0 and a frozen
    F1D2, and a metadata change were all refused (07), and lowering a lifecycle
    too (05); the key still signs as recorded. The emulator gives the same codes.
    tools/board/tm_refusals.py repeats the test, only on the serial it names.
    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
2026-10-02 tools/fw ceremony finish: pin doesn't ask for a replug the push makes anyway
    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
2026-10-02 tools/board/tm_burst.py: the Trust M's security counter under a burst, sacrificial chips only
    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
2026-10-02 TM2: the Trust M's security counter under a burst, measured
    No idle credit on a chip just powered up; +1 per signature at ~140 ms each
    with no slowdown below a counter of about 127; above it each count adds about
    40 ms (1.0 s at 149, 2.5 s at 187), so a burst settles near one signature
    every 5 s, the fade rate. It slows a burst, never refuses one. Past ~150 a
    signature outlasts upstream's 1 s wait. tm_burst.py now waits 15 s in RAM and
    logs errors; TRUSTM.md and the threat model have the numbers.
    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
    [tm_burst.py]
2026-10-02 TM2 rewrite tests: Infineon's objects can be rewritten until frozen; T9 freezes them
    Every data write, counter increment and metadata change on TM2's sealed and
    frozen objects was refused (07; 08 past the end, 04 empty, 0E a frozen
    counter, 05 a lower lifecycle or an empty TLV). But Infineon's E0F0, E0E0
    and E140 come at LcsO creation, and below operational metadata is
    rewritable whatever Change says: E0F0's Change went NEV to ALW, then
    GenKeyPair replaced the factory key (counter unchanged). The stored binding
    still verified.
    So T9 also raises E0F0, E0E0 and E140 to operational with their rules as
    they came (26 objects); T8 checks live that E0F0 is still the certificate's
    key and that Infi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
    [provision_tm.py, signer.py, tm_rewrites.py, tmcfg.py, trustm_test.py]
2026-10-02 Wi-Fi setup from the Device screen; tools/fw --all for every board on USB
    Build 1's knob board has no Y to hold at power-up, so the Device screen
    offers Wi-Fi: the knob's third choice, Y on a buttons board. It leaves a
    "wifisetup" file and restarts; boot.py takes it once and opens setup, where
    the knob already works (and "Keep the saved Wi-Fi" goes back).
    tools/fw ... --all runs the same command on every board on USB in turn, each
    in its own run (its own backup and yes), then prints a summary.
    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
2026-10-02 Firmware 2026.10.1: a version on every build, shown on the Device screen
    firmware/manifest.json carries the release (year.month.n). tools/fw build
    writes it into build.py beside the commit; image.VERSION has it, the Device
    screen shows "2026.10.1 · <commit>", the boot line in log.txt both, and
    tools/fw verify and push print it. docs/RELEASES.md says what 2026.10.1 holds
    and how to make the next one; the tag is fw-2026.10.1.
    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
2026-10-02 Firmware 2026.10.2: Device -> Wi-Fi works on Build 1's knob
    The knob's press that chose Wi-Fi is also Build 1's maintenance key at
    power-up, and the console restarted with it still down: Build 1 came up in
    maintenance with the request untouched. The console now waits for the knob
    to be let go (saying so on screen, the watchdog extended), and at boot a
    pending Wi-Fi request outranks a held key; the request is taken once and
    the maint file still wins. Tests cover all four cases.
    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
2026-10-02 Firmware 2026.10.3: the loaded chip's blockie on the boot screen
    Once the console has read its chip and checked the pin, the boot mark shows
    a row under the tagline: the owner address's blockie (the picture T5, Owners
    and approvals show), the chip's name and the address cut short, red when it
    is not the pinned chip. bootmark.set_chip / splash.chip; the 1.8" has no
    room. run-bootmark checks every frame with the row arriving at 700 ms against
    a fresh paint on all three panels. Walkthrough: docs/quorum-ui/v2.
    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
    [bootmark.py, quorum.py, splash.py]
2026-10-02 Firmware 2026.10.4: home is a grid to browse when nothing waits
    When no transaction wants this key, home is a grid of tiles: each Safe (its
    blockie, chain and threshold; the one signed for most recently first; "not
    owner" or "offline" flagged), Recent (the last dozen signatures this console
    sent, kept in recent.json and preserved by pushes), the chip (its owner
    blockie, opening the Chip pages and coming back home) and Device; a Queue
    tile when transactions are queued for others. A request waiting: the queue
    list as before. Joystick moves, A opens, B Owners, X Device; the dial turns
    and presses. The chip's blockie sits small in the header. The 1.8" keeps the
    list. console_test case_grid; shot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
2026-10-02 Firmware 2026.10.5: no Wi-Fi scan at boot (Build 1 froze at "screen: ok")
    With two networks saved, net.begin() scanned for the one in range just as
    boot.py started the art on its soft timer; Build 1 froze at the first status
    line and stopped answering on USB. begin() now joins the newest saved network
    without a scan; retry() already walks the others every 30 s. The scan stays
    in connect(), which runs only where nothing draws on a timer.
    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
2026-10-02 Key PCB rev A: the PCB is the plug
    The key's first board. Gold fingers on the board's own edge plug into a
    card-edge socket. The fingers are staggered so GND mates first and DETECT
    last, and they use Build 1's GPIOs, so the firmware is unchanged. A slot at
    position 6 keys it.
    Two KiCad 9 projects share the blade:
    - key-a: ATECC608C in SOIC-8, ordered bare and soldered by hand
    - key-b: ATECC608C in UDFN-8 (Microchip's 3x2 land pattern), assembled by
    JLCPCB
    Both have a USBLC6-2SC6 ESD array and a 100 nF cap, plus unfitted KEY ID
    and RST positions for a later Trust M key.
    hardware/key-pcb/gen.py writes the projects. tools/keypcb runs ERC, and DRC
    with schematic parity (both boards clean),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
    [bom.csv, key-a-soic.kicad_pcb, key-a-soic.kicad_sch, key-b-udfn.kicad_pcb, key-b-udfn.kicad_sch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]
2026-10-02 Brand guide: the name, the three-of-five mark, colour, type, motion and voice
    docs/BRAND.html is a single page with the orbit boot screen running live (a
    port of firmware/bootart.py at 30 ms a frame). Colours and sizes come from
    firmware/quorum_ui.py and tools/fonts/gen.py; the taglines and the font set
    are marked as still open.
    Claude-Session: https://claude.ai/code/session_01PbVs8zigosD74GRACEPrhq
2026-10-02 Key PCB: USB-C (key-c P2, ordered) and pogo (key-d) proposals, LEARN.md, keycalc
    Two alternatives to rev A's gold fingers, generated by gen_cd.py (tools/keypcb
    gen-cd), which reuses gen.py's helpers and never rewrites rev A:
    - key-c-usbc, proposal P2: a USB-C receptacle used as plain wires (D+ = SDA,
    D- = SCL, VBUS = key power, 5.1k on each CC as the attach detect). Changes
    after an outside review: a project copy of the HCTL footprint with its outer
    ground pads pulled back from the peg holes (JLCPCB hole clearance, no DRC
    exception), U2 closer to J1 with C2 bypassing its VBUS pin, four test pads on
    the back, 16 x 36 mm.
    - key-d-pogo, P1: five ENIG pads on the bottom (GND SCL VCC S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
    [bom.csv, key-c-usbc.kicad_pcb, key-c-usbc.kicad_sch, key-d-pogo.kicad_pcb, key-d-pogo.kicad_sch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]
2026-10-03 Build log: key-c P2 ordered at JLCPCB, the parts and the production-file check
    Order W2026100307101209 (PCB Y4-13710122A): 5 assembled, $38.96. The parts
    as JLCPCB matched them (MPN, maker, LCSC), the hashes of the files sent and
    of JLCPCB's production file, and what the production-file comparison found:
    input byte-identical, all 29 drills at 0.000 mm, plus two 1.152 mm tooling
    holes in cleared ground pour. Still to record: the final PCBA parts list,
    the placement confirmation and the bench test.
    Claude-Session: https://claude.ai/code/session_01Laiocv4emJiwXVGjenZzqa
2026-10-03 Build log: key-c order's final PCB details (full PCBA number, no deburring, production file confirmed)
    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
2026-10-03 Build log: key-c's final PCBA parts list and the checked placement
    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
2026-10-03 key-c P2: a status page (newest first) with three-quarter renders, and the full order story in the build log
    hardware/key-pcb/key-c-usbc/README.md: where the ordered key stands, what's
    next (console adapter, arrival checks, first power-up) and a newest-first
    log. Renders in the ordered colours (blue mask, white silkscreen, lead-free
    HASL), made from a scratch copy so the ordered files are untouched; the USB-C
    body is a same-size GCT USB4105 stand-in because KiCad has no HCTL model.
    buildlog/2026-10-02-key-c-order.md: how the day went from rev A to the order,
    and the lessons from the first real order (fixed costs, Economic vs Standard,
    the special-fee flag, rotation offsets, tooling holes, c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
2026-10-03 Firmware 2026.10.6: Build 1's screen turned 180° for its case
2026-10-03 Firmware 2026.10.7: Build 1's knob keeps up; the Sign button only signs
    A detent took ~2.1 s to reach the screen: every one of the 8 strips re-ran
    the whole screen, rebuilding each blockie's pattern and re-measuring text.
    Both are kept now, a turn that only moves the focus redraws just its
    strips (~140 ms), the encoder interrupts are hard, and polls wait for the
    knob to be still and stop between calls when it turns.
    With the knob, the Sign button signs on a review and nothing else;
    anywhere else it says so.
    Claude-Session: https://claude.ai/code/session_01T4UzpiwqVJeFFAKoEBNF7H
2026-10-03 Firmware 2026.10.8: HTTPS fits its reserve (the OSError 12s)
    Measured on the board with the heap full but for one hole: the TLS
    session fails in 28 KB and crawls in 32 KB, the old reserve, so it is
    40 KB now. The body was read as pieces and joined with the connection
    still open, so a 6.7 KB queue needed 48 KB; it is read in place into a
    16 KB buffer kept from boot and copied out after the reserve is back.
    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
    [txservice.py, vhttp.py]
2026-10-03 Firmware 2026.10.9: the boot art pauses while the console loads
    Build 1 stopped on boot with "allocating 1280 bytes" and 221 KB free:
    the boot art's frames landed between the modules being loaded, leaving
    no block over 17-26 KB. Paused, the imports take 0.9 s instead of
    3.5 s and leave a 95 KB block.
    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
2026-10-04 key-c P2: JLCPCB's parts-placement review checked, and STEP files of the ordered board for Onshape
    [key-c-P2-board-only.step, key-c-P2.step]
2026-10-04 Emulator on the web with a laptop passkey: design notes and an on-chain check
    docs/EMU-WEB.md: how the emulator goes onto GitHub Pages (a service worker for
    COOP/COEP, static boot.json, chip state in the browser; no Vercel), and how a
    laptop passkey (Touch ID, Windows Hello, a phone, a YubiKey) becomes a key
    through the passkey signer the Safe already trusts. Covers the firmware seam
    (signer.assertion), the limits, and the steps.
    tools/vectors/passkey.mjs: a real Chromium passkey assertion over a safeTxHash,
    packed as firmware/webauthn.py packs the chip's, passes the deployed factory's
    isValidSignatureForSigner on Base Sepolia, Base and Ethereum, with the same
    owner address on all three.
    C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
2026-10-05 Release fingerprint: one SHA-256 of the console's source, its blockie on the Pico, the emulator and the app
    The fingerprint is the SHA-256 over "name \0 sha256(file)" lines of an image's source files,
    sorted (tools/release/fingerprint.mjs; test-vectors/fingerprint_test.py is a second
    implementation). Taken over source, not .mpy, so a Pico built from a commit and the emulator
    running that commit's files show the same value.
    - tools/fw build writes RELEASE into build.py; build and verify print it.
    - firmware/image.py: RELEASE, SEED (the blockie's seed), SHORT (4c86·c754).
    - The home grid's Device tile draws the release blockie; the Device screen draws it in the header
    (when it fits) and on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
    [console_test.py, fingerprint_test.py, image.py, quorum_ui.py, quorum_ui_s.py]
2026-10-05 The emulator on GitHub Pages: docs/emu, the console in your browser
    emu/build.mjs writes docs/emu/, the same page as tools/emu as a static site, laid out like the
    server's URLs so one set of relative paths works under both:
    - boot.json at build time: the firmware, the shims, and a build.py with IMAGE "web", BUILD
    "pages" and the console's release fingerprint (no commit or date in it, so a rebuild of the
    same commit gives the same bytes; CI checks that).
    - coi.js + sw.js: a service worker adds COOP/COEP to the folder's own responses, since Pages can't
    send headers; the first visit reloads once. Cross-origin requests are left alone.
    - A strict CSP (wasm-unsafe-eval and the import map's h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
    [base_v5.stl, button_cap_1.stl, joystick_cap_v3_2.00.stl, lid_v4.stl]
2026-10-05 web build: pin viem and noble with an esbuild alias, not a resolve plugin
    The plugin that sent sigs.mjs's viem and noble imports to web's copies let the module order, and
    so the minified names, differ about one build in eight (three different app.js from one source in
    40 builds), even with a synchronous resolver; CI's rebuild-must-equal-docs check would trip on it.
    An alias resolves those imports from web/ with no plugin: 30 builds out of 30 give the same app.js,
    the one already committed (a6ccf6e7), and nothing is bundled from outside web/node_modules.
    Claude-Session: https://claude.ai/code/session_01PPJmErTNh1xFD5nWLyymob
2026-10-05 Bring your own passkey: the visitor's passkey as the console's key, in the browser emulator
    A passkey can't stand in for a chip's sign(digest): it writes its own authenticatorData and
    clientDataJSON. So the console asks it for a whole assertion over the safeTxHash computed on
    screen, and packs that exactly as it packs a chip's; Safe's passkey signer checks both the same way.
    Firmware (no change on a Pico):
    - signer.load() returns the visitor's passkey first when the emulator's page picked one
    (emu/core/shims/passkey.py, a module the Pico never has; never in a production image).
    - quorum.sign_it: a signer with asserts = True gives (ad, fields, r, s) from sig.assertion(hash);
    the working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
2026-10-05 Safe-approved releases: the project Safe approves a release on chain, and the console clear-signs it
    A release's digest D = EIP-712 PicoQuorumRelease(version, firmware, manifest): the console image's
    release fingerprint and the SHA-256 of docs/releases/<version>.json (immutable after its tag). The
    project Safe approves D with one ordinary Safe transaction, a delegatecall to Safe's SignMessageLib
    1.4.1 (signMessage(D)), which marks it signed for good: isValidSignature(D, "0x") == 0x1626ba7e on
    the Safe, even after owners change. No off-chain message flow, no signature packing to trust.
    Console:
    - firmware/release.py: D, pure (checked against viem on CPython and MicroPython).
    - decode.py: a d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
2026-10-05 Governance plan: the project Safe on Ethereum and Base, release approvals, the ENS name, handing it over
    docs/GOVERNANCE.md, plan only: one Safe at the same address on Ethereum (canonical: owns the ENS
    name, approves releases) and Base (day-to-day), 2 of 3 to start across three technologies (a
    Trust M console key, a hardware wallet, a passkey); how to get the same address on both chains and
    keep owners from drifting; the release approval flow and the "project" setting that turns its
    checks on; the ENS name handed to the Safe and its records, and the resolver decoders the console
    needs next; the stages of handing it over; what changes at a public launch (provenance
    attestations, a domain befo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
2026-10-05 README for launch: light and dark logo, badges, the build's blockie, three ideas
    - The logo: docs/brand/lockup-dark.svg and lockup-light.svg, the mark and the name outlined from
    Atkinson Hyperlegible Next Bold, swapped by GitHub's prefers-color-scheme (tools/brand/lockup.py).
    - Badges: the live site, the browser console, the site check, CI, the firmware version, signed
    release tags, the release workflow, Safe ≥ 1.3.0, the chains, the license.
    - The build you're looking at: each image's release fingerprint as a blockie badge with its first
    and last 8 digits, and a table of the full fingerprints (tools/releases/badge.mjs writes
    docs/releases/badges/ and the table; CI's fwbuild job fa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
2026-10-05 Add the console page: the console alone, with your passkey as its key
    docs/console/ (from emu/console/, written by emu/build.mjs): the console's screen with the joystick
    and A B X Y as on the board, for anyone without a Pico. No editor, no 3D case, no module menu: it
    always runs the quorum console on the files exactly as built, with your passkey as the key. The
    first visit asks you to make a passkey, then to save a Safe in the app.
    - emu/web/browser.mjs: what both pages need (boot.json, the release fingerprint, the app's Safes,
    the software key, the passkey, the worker's questions, frames), shared by the emulator's app.js
    - the console runs docs/emu's boot.json, worker and MicroPython, wi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
2026-10-05 Your passkey in a Safe: use one you already have, and a page in the app to add it
    A passkey synced to your other device (iCloud Keychain, Google Password Manager) is there, but its
    public key isn't: WebAuthn only hands that out when the passkey is made. So:
    - "I already have one" on the console page (and "use one I have" in the emulator): you pick the
    passkey, it signs twice, and the page works out its public key from the two signatures
    (webauthn-assert.mjs recoverKeys: P-256 public key recovery), checks it, and keeps it. Same
    passkey, same owner address, whichever device signs.
    - The app's Your passkey page (#/passkey, from Keys and from the console page): its owner address
    with a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
2026-10-05 Home is a status screen, and a quiet minute brings a screensaver
    The grid of tiles didn't fit how the console is used: it waits, and now and then a request comes
    in. So home when nothing waits for this key is one screen that answers "can I approve?":
    - this key (the chip's name, or Your passkey) and the sync status;
    - one card: Ready to approve, or Not an owner yet with the address to add and the next step (in
    the app: Your passkey, for a browser passkey: deploy its signer, Add owner), or Offline,
    Connecting, No key;
    - the Safes, a row each: chain, "2 of 3" with a green dot when this key is an owner, "not owner",
    "1 queued", "offline";
    - this console's last approval.
    A request for th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
    [console_test.py, quorum.py, quorum_ui.py, secrets.example.py]
2026-10-05 Console page: your passkey's owner address, and add a Safe you already have
    The console page signed with your passkey but never showed the address its signatures count as,
    and it sent you to the app for a Safe. Now:
    - The owner address on the screen and in the panel, with its blockie and Copy: the
    SafeWebAuthnSignerProxy address Safe's passkey factory deploys for the key, the same on every
    chain. Worked out in the page (web/browser.mjs passkeyOwner, a small core/keccak.mjs: the page
    has no viem) from the factory in the quorum_cfg.py it boots.
    - Add a Safe right there: chain and address (Safe{Wallet}'s "base:0x..." picks the chain), checked
    with EIP-55, saved to the same pq.safes lis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
2026-10-05 HTTPS: parse the response in its buffer, never copy it out
    "service New 3-of-5: MemoryError" on poll after poll while a queue
    waited: the body sat whole in its 16 KB buffer, but _fetch copied it out
    with bytes(), and a running console's heap had no free block of 6-9 KB
    for the copy. json.loads reads a memoryview in place and needs only
    small blocks. On Build 1 with the heap cut into 4 KB holes: bytes() of a
    9 KB queue fails, and three polls through Service parse it fine.
    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
    [txservice.py]
2026-10-05 README build badges for the board fixes' source (badge.mjs)
    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
2026-10-05 Deploy any passkey's signer from any wallet: a deploy link and a page for it in the app
    A passkey owner's signatures fail on a chain where its signer isn't deployed (Safe's service: HTTP
    400 on the signature), and the app could only deploy your own passkey's signer, from a wallet in the
    same browser. An iPhone has the passkey but no wallet. Now:
    - #/signer/<x>/<y> in the app: the owner address worked out from the key (the address alone is a
    hash of it, so it can't be deployed from), and Deploy on each chain from whatever wallet is
    connected: createSigner is open to anyone, so it needn't own the Safe. Each chain's factory must
    name the same address before anything is sent, as on Your p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
2026-10-05 key-c P2: a simplified STEP mock-up for 3D printing
    One fused solid: the board, block bodies for the chips and small parts, and
    the USB-C receptacle as just its outer shell with an open socket a real plug
    slides into (no tongue). Made by 3d/print_mockup.py (CadQuery), so the plug
    clearance and wall thickness can be changed and the file remade.
    Claude-Session: https://claude.ai/code/session_01UUZRaAJjMAL52UDybYzNTL
    [key-c-P2-print.step]
2026-10-06 The console page as one folder you can read, check and run; the hosted 3D emulator deprecated
    The console page (docs/console/) now holds everything it runs and loads nothing from the rest of
    the site, so a copy of the folder is the whole program:
    - firmware/ is the console image, the same 50 files a Pico runs, as plain files. They hash to the
    release fingerprint (the build checks), so a copy can be held up to the README with sha256sum.
    - shims/, web/, core/, shared/ and vendor/micropython/: the rest of what runs. boot.json names
    the files to boot; browser.mjs staticBoot fetches each.
    - SHA256SUMS lists every file for sha256sum -c. The page shows a table of what is in the folder,
    with l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
2026-10-06 The console folder, only what runs: no virtual chips, its own worker, a CSP the browser enforces
    The console page always signs with your passkey, so the folder now holds only what that runs:
    - shims/: the six the console uses. The virtual chips (atecc_sim, trustm_sim) and rp2 never
    loaded; 1,695 lines down to 633. No key.bin and no chip state: runtime.mjs writes only the shims
    it is given, and keyBin null means no software key at all.
    - worker.js: the console's own (emu/console/worker.js), about half the emulator's. It boots, runs
    quorum, and carries frames, HTTP and the passkey's question; none of the serial line, the
    server's chip state or module running.
    - boot.json: the release f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
    [base_v5.stl, button_cap_1.stl, joystick_cap_v3_2.00.stl, lid_v4.stl]
2026-10-06 AGENTS.md: what an AI agent must never weaken here, and what to run
    The console signs only the hash it worked out, from one place; the console image is exactly what
    it imports; keys stay in their chips and locks are permanent; the console page is one folder with a
    CSP that allows only Safe's service; the app holds no key and never follows offchain lookups; docs/
    is built, never edited; no secrets; the supply chain stays pinned; releases are signed tags. Then
    the checks CI runs, as commands. CLAUDE.md imports it, so Claude Code reads it too.
    Claude-Session: https://claude.ai/code/session_0147sXZ3zKC3CDYjsuNvoQJa
2026-10-06 Remove picowallet-specific material before going public
    PicoQuorum grew from Austin Griffith's picowallet (MIT). Before the repository goes
    public, take out what came with the fork that PicoQuorum doesn't use. Austin's code
    that the console does use (the chip drivers, keccak, p256, lcd, blockies, net, the
    emulator core and shims) stays, under his MIT copyright, and gets credited file by
    file in the next commit. Everything removed here is still in this repository's
    history and in picowallet's own.
    Removed:
    - app/: the Scaffold-ETH 2 single-owner vault app (ChipAccount, TrustMAttest, the
    mainnet broadcast records) and its agent rule files (AGENTS.md, CLAUDE.md,
    .agents/, .cursor/, .openco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
    [base.stl, base_pink.stl, base_v3.stl, base_v4.stl, base_v5.stl, base_v5_qr.3mf, base_v5_qr_black.stl, base_v5_qr_white.stl]
2026-10-06 Credit Austin Griffith and picowallet in every file that came from it; firmware 2026.10.10
    Each file that started in picowallet now says so on its first line, with a link and its
    license:
    - "From picowallet by Austin Griffith (MIT)" where it is still mostly his: trustm.py,
    p256.py, keccak.py; the emulator's runtime, png, ship, devices, usbinfo, server, the
    dev page's CSS, and the shims _bootstrap, requests, socket, rp2; tools/emu
    - "Started in picowallet" where it has changed a lot since: atecc.py, lcd.py,
    blockies.py, net.py; workspace, headless, cli, the dev page, its worker, and the
    machine and network shims; tools/check_config
    The console page's folder now carries LICENSE (MIT,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
2026-10-06 Licensing: MIT code, CERN-OHL-W-2.0 hardware, CC BY-SA 4.0 docs; the name and mark reserved
    Set before the repository goes public, because a version once published under a license
    stays under it.
    - LICENSE stays MIT, with Austin Griffith's copyright beside Jason McPheron's: his code is
    still here.
    - LICENSE-HARDWARE: CERN-OHL-W-2.0, verbatim from ohwr.org, for hardware/. Changes to the
    designs must be shared; they can be combined with other parts. hardware/README.md
    carries CERN's notice, the Source Location, and, per section 4.1, that a product made
    from it shows the Source Location on itself, its packaging or its documentation. A
    to-do puts it on the silkscreen at the next key r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
2026-10-06 Docs: one status page, picoquorum.eth and the domains, superseded notes folded in
    PicoQuorum is built in public, so what exists should be easy to find and current.
    - docs/STATUS.md, new: the one page for what exists. picoquorum.eth (owned by the
    hardware wallet 0x682De3ad16F47Acd01e97A73f1619be93672a9f3, unwrapped, expires
    2031-10-06) and picoquorum.app/.com/.org/.dev; the three Safes with their owners and
    thresholds, read on chain 2026-10-06 (the Base Sepolia "3-of-5" is now 3 of 6; the
    Base Safe's #0 executed 2026-09-26); each key's owner address and where its proxy is
    deployed; Jason's wallets; the contracts the console pins in quorum_cfg.py; releases,
    hardware, the ladder, w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
2026-10-06 Emulator server listens on 127.0.0.1; --host or EMU_HOST to open it to the LAN
    server.listen(PORT) bound every interface, so any machine on the network could
    call /ctl/cmd (run code on the emulated device) and /ctl/ship (copy modules to
    a Pico on USB). It now binds loopback by default. --host 0.0.0.0 (or EMU_HOST)
    opts in, and the server prints a warning when it is not on 127.0.0.1.
    URLs stay on localhost: the page needs it as the WebAuthn RP ID.
2026-10-06 emu: drop three.js from the exact pins, so npm ci installs again
    The merge of main kept #51's "three": "0.170.0" in emu/package.json and the lockfile's root,
    but this branch had already removed three.js's package entry along with the 3D case view.
    npm ci refused the pair ("Missing: three@0.170.0 from lock file"), and every CI job installs
    emu/ with it. Now the pins are #51's exact versions without three.js; npm install
    --package-lock-only leaves the lockfile as it is, npm ci installs from it, and the rebuilt
    docs/ and the release fingerprints are unchanged.
    Claude-Session: https://claude.ai/code/session_019bZJLX1hwpk9Wx7HeCtu5B
2026-10-06 The site moves to picoquorum.app
    docs/CNAME sets the custom domain. The site check, the console page's
    app link for a local copy, and the static e2e test (now served at the
    root, as Pages will) follow it, and the docs name the new host. The
    console page is rebuilt; the firmware and its release fingerprint
    (817a·5ae6) are unchanged. LAUNCH.md gets the exact Porkbun records,
    from GitHub's docs, and the forwarding and auto-renew steps.
    Merge only once picoquorum.app's A, AAAA and www records resolve to
    GitHub Pages: github.io starts redirecting the moment this lands.
    Claude-Session: https://claude.ai/code/session_016VzzhkPTVDPXMB2YR3zcC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
2026-10-07 key-c: sketches of ways to lock the key into a dock
    Five ideas for a possible P3, as top-view SVG sketches with a page
    comparing them: round detents, a keyed corner, square notches under a
    lid with prongs, barbs with release tabs, and a pin through H1 on the
    board as ordered. Also notes what JLCPCB can mill. No board files change.
    Claude-Session: https://claude.ai/code/session_01WYKU6jTQADXv5q3A6Xb3UP
2026-10-07 BRANDED-KEYS.md: the bench brands the chip, the user makes the key
    A proposal for LAUNCH.md section 6 (the brand and quorum record before
    chip #3), and the user's side of it. The bench runs B1-B7: quorum v2
    (quorum v1 with slot 8 readable), a brand record in OTP, a signature
    from a bench Trust M in slot 8, both zones locked, and no key. The
    user's console runs claim, U1-U5: check the brand offline, GenKey,
    test, seal, owner. After the bench's data lock only the chip's own
    GenKey can fill slot 0, so nobody chose the user's key.
    The screens are mockups drawn by the real ceremony screen on the
    emulator (tools/board/shots_brand.mjs); the label is drawn with the
    firmware's blockies.py and qrcode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
2026-10-07 BRANDED-KEYS.md: the brand key is PicoQuorum key 0000
    The brand key is now a PicoQuorum key, not a Trust M: a key-c ATECC608C
    run through today's C1-C10 on the bench, on the Pico's second I2C
    controller beside the chip being branded. Its use counter is a public
    tally against the registry. B7's screen is redrawn to name it.
    Claude-Session: https://claude.ai/code/session_01F2siti5ZqnrYbuxLjEHMfG
2026-10-07 BRANDED-KEYS.md: diagrams of quorum v2, the brand and the bench
    Four SVGs in the brand's dark colours with the PicoQuorum lockup: the
    chip map (config zone, the sixteen slots, OTP, and who writes each), how
    key 0000 signs the brand into slot 8, a branded key's four states, and
    the bench rig. tools/board/brand_diagrams.py draws them.
    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
2026-10-07 BRANDED-KEYS.md: the ceremony in the console's own look, in plain words
    The bench and claim mockups are redrawn with quorum_ui.py's kit: the
    Atkinson Hyperlegible fonts, cards, check marks, red pages, hold bars,
    and the PicoQuorum mark in the header. tools/board/brand_screens.py
    draws them; it is not firmware.
    The claim now says what the key is: it signs your Safe's approvals,
    can't hold ETH, tokens or funds, can't be copied or read out. The last
    screen warns again beside the owner address: a signer, not a wallet.
    New screens: plug in, test. A table in the doc gives the reason for
    each plain line.
    Claude-Session: https://claude.ai/cod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
2026-10-07 BRANDED-KEYS.md: the chip fills in on every ceremony screen
    Each bench and claim screen now shows the chip under its header: the
    ATECC608C package, the config and data padlocks, the OTP zone (dashed,
    then the PicoQuorum mark and the key's number) and the sixteen slots.
    Slot 8 turns blue with key 0000's signature, slot 0 fills green with
    the user's key and gets a white border when sealed. What each step
    writes is ringed.
    New bench screens B1, B3 and B5, so the bench reads as a wizard too,
    and a card with the chip at four stages for the doc.
    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
2026-10-07 BRANDED-KEYS.md: a bench id in the number, room for a bench certificate
    The brand record's 4-byte number becomes a bench id (1 byte, 0 for
    now) and a sequence on that bench (3 bytes): bench 0 prints 0042,
    another bench would print B2-0042. Slot 8 keeps bytes 64-223 for a
    bench certificate, zeros while key 0000 brands every chip itself, and
    the console refuses any other bench id or a non-zero certificate until
    a second bench exists. Both are frozen at the first chip, so the room
    is there from the start.
    New point 5 says how a second bench would work. Point 4 gives the
    pros and cons of sequential numbers. The use-counter tally now counts
    key 0000's public-key reads too. The OTP and brand diag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
2026-10-07 brand image: quorum v2 and the bench steps B1-B7, for a spare chip
    The first build of docs/BRANDED-KEYS.md's bench half, on a spare:
    - chipcfg: quorum v2 (v1 with slot 8 readable in the clear), the v2 brand record,
    and the CRC a locked config was checked against. tools/check_config decodes v2.
    - brand.py: B1-B7 on provision.py's screen and gates (knob or buttons), then
    S1-S3 for the silicon questions: GenKey after the data lock, two signatures,
    the slot lock. B5 signs with a public test key, bench 0xFF, which brand_check
    refuses as a brand.
    - main_brand.py and a "brand" image in the manifest; tools/fw refuses it on a
    board that pins a chip, as for the ceremony image.
    - test-vectors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
2026-10-07 Console page: no wallet asks, three setup steps under the device
    The console page's key is your passkey, so it no longer points you at a
    wallet: no Launch app in the header, no deploy link to share, no
    MetaMask or Rabby. One link stays, for an owner of the Safe who adds the
    passkey from their own wallet.
    Under the device, the panel is three steps that turn green when done:
    your passkey, a Safe to watch, your passkey as its owner (green when
    Safe's service says so). The warning sits right under the screen it is
    about, and the keyboard keys are drawn as keys (hidden on phones).
    Firmware unchanged: the release fingerprint is still 817a·5ae6.
    emu/e2e-static.mjs checks the page asks for no wal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
2026-10-07 brand image: the bench screens in the console's look (brand_ui.py)
    The brand steps now draw as docs/BRANDED-KEYS.md's mockups do: the header and
    step dots, the chip filling in (OTP, slot 8, padlocks, the part a step writes
    ringed), a red card on permanent steps, the hold bar, and the console's knob
    choices. brand_ui.UI is provision.UI with this drawing, so the knob, the arm,
    ALLOW_* and the 3 s holds are unchanged.
    - The kit moves into firmware/brand_ui.py; tools/board/brand_screens.py
    imports it, and its mockups come out byte for byte the same.
    - Every step's full result is appended to brand-log.txt on the board
    (preserved across pushes); the screen shows a few lines.
    - The test bench'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
2026-10-07 Console page: steps beside the device, a shorter intro, Ask an owner
    - On wide screens (1160px and up) the warning and the three setup steps
    sit beside the device, the section a little wider than the page's
    column, so all of it fits without scrolling. Narrower, they stay under it.
    - The intro is one short paragraph, with less space above the device.
    - The header's nav drops Keys, the last link that led into the app.
    - A Safe your passkey doesn't own yet gets an Ask an owner button: one
    tap shares (or copies) a note for an owner with the owner address, the
    signer's deploy link and the add-owner link. Only public things.
    emu/e2e-static.mjs adds a Safe the passkey doesn't own and check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
2026-10-07 Chip 5, a spare 608A, through the brand bench: what the silicon showed
    B1-B7 and S1-S3 on Build 1 with the knob. GenKey after the data lock works,
    slot 8 reads in the clear and is in the data CRC, U1's check takes 2.3 s.
    Counter 0 read 1 before any key existed. PrivWrite was not tested. In the
    buildlog and BRANDED-KEYS.md's silicon list.
    brand.py: once the data zone is locked the bench reads the record from OTP,
    so the screen shows the chip's number after a restart (it showed ????).
    Claude-Session: https://claude.ai/code/session_01PX6mRUeihEgRz4R4YfutoJ
2026-10-07 Chip 5: counter accounting, the refusals after the seal, and an onchain check
    Only a public-key read of slot 0 counts as a use; every write, lock and key
    command is refused after the seal, GenKey on slot 0 included, none moving the
    counter; Base Sepolia's passkey factory agrees on the owner and accepts a
    chip 5 signature (read only). In the buildlog and BRANDED-KEYS.md.
    run-brand.mjs: the console pinned to a branded spare, signing, and the dual
    image booting the console for a sealed quorum v2 chip.
    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
2026-10-07 Restore the key breakout case and add a clip-in tray (v3)
    The ATECC608 breakout case (cad/key) came out with the picowallet cleanup in
    d529a59. Bring back its generator, README and STLs as of 39e3a4c, and add
    key_tray_v3.stl: the v2 tray with a springy finger in each grip notch whose hook
    reaches 0.35 mm over the board edge, so a test key stays in its tray without
    the lid. The v2 files regenerate byte for byte, and the overlap checks cover
    the v3 tray against the lid and the board. Not printed yet.
    Claude-Session: https://claude.ai/code/session_01LzPWW19TtRKn4Hd1rec3UX
    [key_case_v2.stl, key_lid_v2.stl, key_tray_v1.stl, key_tray_v1_pegfit_x3.stl, key_tray_v2.stl, key_tray_v3.stl]
2026-10-07 Add console-a: the console on one board, with a USB-C plug for key-c
    A Pico 2 W carrier on Build 1's pins (BOARD = "build1", SCREEN = "2.8"),
    so today's console image runs on it unchanged:
    - the 2.8" ST7789 module on its 8-pin header
    - a Bourns PEC11R knob (24 detents, 24 pulses, as knob.py counts)
    - Sign, Back, Device and Reject buttons, and a status LED on GP22
    - a vertical USB-C plug that key-c slides onto, with the console end
    PROPOSALS.md asks for: an AP22653 switch on VBUS (80 mA, reverse
    blocking, enabled by GP6 with a pull-up), CC read on GP26/GP27,
    2.2k pull-ups to the switched VBUS, ESD on every line
    gen_console.py writes the KiCad 10 project, checks its pin table against
    fi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
    [bom.csv, console-a.kicad_pcb, console-a.kicad_sch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]
2026-10-07 console-a: rotations that match JLCPCB's footprints
    In JLCPCB's 3D preview the Pico 2 W lay across its pads, turned 90° and
    off the board's edge: JLCPCB places each part by its own footprint, whose
    zero rotation isn't always KiCad's. key-c's SOT-23-6 parts had the same
    problem and were turned by hand in the preview, which no file records.
    Every placed part's KiCad footprint was compared with JLCPCB's EasyEDA
    one, matching pins by function (JLCPCB's LED calls its anode pin 1). The
    turns needed go on the parts as "JLCPCB Rotation Offset" (JLC_ROT in
    gen_console.py), and tools/keypcb adds that field to the rotation it
    writes to cpl.csv:
    - U1 Pico 2 W 180 -> 90, J1 plug 0 -> 270, U3/U4 USBLC6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
    [console-a.kicad_pcb, console-a.kicad_sch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]
2026-10-07 Console PCB rev A: Pico 2 W, 1.3in panel and nine buttons on one board
    console-a is the whole console on one board, wired like the Waveshare
    Pico-LCD-1.3, so the console image runs on it unchanged (BOARD "waveshare").
    - Pico 2 W soldered flat on the back, antenna over a notch.
    - A bare 1.3in 240x240 ST7789 panel on a 24-pin FPC connector.
    - A five-button d-pad plus A/B/X/Y, all SMT.
    - Pads for the key, behind the console end of key-c that PROPOSALS.md asks
    for: a 100 mA load switch on GP6, a Schottky against 5 V on VBUS,
    pull-ups to switched power, CC1/CC2 read separately on GP27/GP28, ESD.
    JP1 (open) powers the key for firmware that doesn't switch GP6, which is
    today's console image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
    [bom.csv, console-a.kicad_pcb, console-a.kicad_sch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]
2026-10-07 Move the console board to hardware/console-a
    Same design, new folder, so it stays clear of parallel work in hardware/.
    tools/keypcb, gen.py and the links in hardware/README.md and
    hardware/bom/README.md follow it. Checks still pass from the new place:
    ERC 0, DRC 0, parity clean, pin check passes. The fab files are unchanged.
    Claude-Session: https://claude.ai/code/session_012wBec1er2qFD8SksgKkpb8
    [bom.csv, console-a.kicad_pcb, console-a.kicad_sch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]
2026-10-08 console-a: factory-soldered Pico option, and how to get the right panel
    The same board and Gerbers, with a second assembly set in
    fab/factory-pico/ where JLCPCB also solders U1, the Pico 2 W
    (LCSC C42394205, Raspberry Pi SC1633), on the back. It needs two-sided
    assembly and X-ray. The default fab/bom.csv and cpl.csv are unchanged.
    - gen.py: U1's MPN is SC1633 (the Pico 2 W without headers; SC1634 has
    headers). An LCSC_FACTORY field carries the factory option, and U1 stays
    in the position file. Track geometry is identical (244 segments,
    77 vias), so the committed Gerber zip is kept.
    - tools/keypcb fab: a board with LCSC_FACTORY parts also gets
    fab/factory-pico/{bom,cpl}.csv. The key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
    [bom.csv, console-a.kicad_pcb, console-a.kicad_sch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]
2026-10-08 Console PCB, rev A: one board for the Pico 2 W, a 1.54in panel, seven buttons and the key pads
    hardware/console-pcb/gen_console.py writes the whole KiCad 9 project as text (symbols,
    footprints, schematic, routed board, project file), with no KiCad needed: a grid router with a
    reserved exit channel per Pico pad and a geometric self-check that stands in for DRC until
    tools/keypcb check runs on a machine with KiCad. The Pico sits on the back as an SMD module,
    USB flush with the right edge and the antenna end with the left; the panel's 12-pin FPC is
    soldered to pads on the front; the buttons are 6x6 SMD tacts wired on a diagonal. The key's
    wires come out to eight pads on the Build 1 GPIOs. tools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
    [console-a.kicad_pcb, console-a.kicad_sch]
2026-10-08 Move the pocket console board to hardware/console-pocket
    Two other one-board consoles landed on main under hardware/console-pcb and hardware/console-a
    while this one was drawn, so it gets its own folder and name: console-pocket, the one with the
    Pico on the back.
    Claude-Session: https://claude.ai/code/session_01EyXWgJKqX9XDdHSz7BdKtN
    [console-a.kicad_pcb, console-a.kicad_sch, console-pocket.kicad_pcb, console-pocket.kicad_sch]
2026-10-08 key-pcb README: the three console boards each bring the key out
    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
2026-10-08 ESP32 (WROOM-32) board profile, bench test and breadboard wiring
    The console's screen, knob and chip on an ESP32 DevKit instead of a Pico 2 W.
    Same image: board.py picks an "esp32" profile on its own.
    Firmware (checked against MicroPython 1.26's ESP32 port source):
    - board.py: the esp32 pins (screen on VSPI 18/23, chip on 21/22, knob on
    32/33/25, Sign/Back/Reject on 27/26/13), SPI_ID, LED, timer() for the
    ESP32's four numbered timers, and unix(): time.time() counts from 2000
    there, so the TLS clock check would always have failed
    - knob.py and bench1.py: the pulse counter (machine.Encoder) in place of
    hard pin interrupts, which the ESP32 port does not have
    - txservice.py: TLS checked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
    [atecc.py, bench1.py, board.py, boot.py, boot_maintenance_test.py, brand.py, chipapp.py, chips.py]
2026-10-08 ESP32 wiring: the screen's pins in the order printed on the panel
    The breadboard picture draws the screen's pins as its header runs, BL, RST,
    DC, SCL, MOSI, CS, 3V3, GND, and wires 9 to 16 follow that order. The ESP32
    pins are unchanged; the wires route across to the screen in five crossings,
    the fewest this order allows, and each screen pin is labelled with its wire.
    ESP32.md's tables follow the same order.
    Claude-Session: https://claude.ai/code/session_01YaLrjYKNZcmA5YZzKUkNw1
2026-10-08 ESP32 bench on hardware: the Trust M in bench1, and what ran
    bench1.probe() polls 0x30 when scan() finds nothing (a sleeping Trust M
    NACKs its address) and shows the Trust M's serial, LcsA and E0F1, read only.
    First run on a WROOM-32 DevKit, MicroPython 1.26.1: the 2.8" right at
    24 MHz, the knob's turn and press, a Trust M at 0x30 and chip 5 (608A) at
    0x60. ESP32.md says what ran and what didn't, with a row for a knob whose
    middle post isn't grounded; the build log has the details.
    Claude-Session: https://claude.ai/code/session_01BZgnpr3jB6BQXKeaPRKyTt
    [bench1.py]
2026-10-08 ESP32 wiring for Freenove's ESP32-WROVER board
    tools/wiring-esp32 draws a second pair of pictures, esp32-wrover-breadboard.svg
    and esp32-wrover-pinmap.svg, for Freenove's ESP32-WROVER (USB-C, camera,
    WROVER-E with PSRAM). Its headers, read off the board, put every GPIO the
    console uses at the DevKitC's pin numbers, so the wire list is the same;
    --check holds PINS to both boards' headers. The DevKitC pictures are
    unchanged.
    ESP32.md says how the board differs (the camera unplugged, 20 pins a side,
    5 V at the bottom left, the SPIRAM build) and how to free the camera's ribbon.
    Claude-Session: https://claude.ai/code/session_01BZgnpr3jB6BQ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
2026-10-17 ESP32-WROVER and the first ATECC608C on a key-c: what ran
    The console image went onto an ESP32 with PSRAM with tools/fw push console (2026.10.10,
    b2187163); verify matched every file. A push over the serial bridge takes about 5 minutes and
    the first one timed out; the board stayed in maintenance and a second push finished it.
    A key-c board (P2) answered at 0x60 only once IO21/IO22 had pull-ups: the key has none, and
    atecc.make_i2c's SoftI2C doesn't turn on the ESP32's own. Read only, nothing locked: revision
    00006005, config bytes 16-127 the 608A's factory table byte for byte, counters 0 and 0, SelfTest
    passes, the on-chip SHA-256 matches hashlib. The console ran with it from RAM, and a pol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
2026-10-17 Key setup for the key-c 608Cs: key 0000 by a swap, and the claim (2026.10.11)
    Two paths, and the user's console makes the key on both. A branded chip goes
    through the bench's B1-B7 and stops with no key; the dual image routes it to a
    new claim, U1-U5 (firmware/claim.py): check the brand with no network, make the
    key, two test signatures, seal slot 0, show the owner address. An unbranded
    chip stays as it came, and the dual image routes it to C1-C10.
    - The ATECC608C (revision 00006005) is in chipcfg.REVISIONS and every list that
    named the 608A and B. Its factory table already identifies as factory.
    - atecc.make_i2c turns on the ESP32's pull-ups on IO21/IO22: the key-c has none.
    - With a bra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
    [atecc.py, atecc_sim.py, bench1.py, board.py, brand.py, brand_test.py, brand_ui.py, ceremony_test.py]
2026-10-19 Attested keys: a proposal for proving a key is in a branded chip
    docs/ATTESTED-KEYS.md adds an attestation key in slot 1 (quorum v3),
    made and sealed at the bench and named in the brand, so a key made at
    claim can prove it lives in a branded chip. On top of that: a registry
    contract, a gas relay and its treasury on Base, the sales share, and
    how picoquorum.eth names each piece. Nothing is built. BRANDED-KEYS.md,
    docs/README.md and LAUNCH.md section 6 link to it.
    Claude-Session: https://claude.ai/code/session_01TmNjwacG1rSpT3qHgbsmsG
2026-10-19 Attestation key on the brand bench: quorum v3 (2026.10.12)
    The chip half of docs/ATTESTED-KEYS.md, so a spare 608C can settle it on
    silicon before the first real branded chip.
    - chipcfg: quorum v3 is quorum v2 with slot 1 an attestation key
    (SlotConfig 2F82, internal Sign only; KeyConfig 0033). A version 3
    brand record; its digest covers slot 1's public half, which goes into
    slot 8 at 224-287, under the prefix "PicoQuorum brand v2". brand_check
    takes a v3 brand and checks slot 1 against slot 8. The attestation
    message builders and attest_check, pure, for the board and the laptop.
    - atecc: genkey_attest, which runs Nonce, GenKey's digest mode and an
    internal Sign in one wake. No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
2026-10-21 The Feather ESP32-S3 Reverse TFT: setup notes and a read-only chip bench
    MicroPython 1.26.1 on Adafruit's Feather ESP32-S3 Reverse TFT, its pins and screen settings, and a
    bench test (screen, buttons, the key's ATECC608: random, SHA-256, self-test) outside the console
    image. The spare 608C read back with its config locked to quorum v3. Notes why the console image
    can't run here yet.
    Claude-Session: https://claude.ai/code/session_018Dz28BsiCQ6cgXSsBoHMwk
    [board.py, main.py, scantest.py, tft.py]
2026-10-22 The console on the Feather ESP32-S3: its board profile and the three-button review
    board.py picks "feather-s3" on any ESP32-S3: its pins, the 240x135 screen at (40, 53) in the
    panel's RAM, GPIO7 high, D1 and D2 read high when pressed, and the battery gauge at 0x36 never
    taken for a key. Power-up button reads go through board.key_down. On the Feather, D0 rejects
    (one press, any page, even while Sign is held), D1 moves (held 1 s, back), and D2 opens, shows
    the pages not yet seen, then signs on a 2 s hold (3 s red), with a rail of labels beside the
    buttons. Checked on CPython (feather_s3_test.py) and in the emulator (console_test.case_three);
    22 screenshots in docs/quorum-ui/feather. The bench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
2026-10-22 Wi-Fi setup on the Feather: a WPA2 hotspot on the ESP32, and the three buttons
    On the ESP32, MicroPython sets a hotspot's password but leaves it open unless security= is given
    too, so the iPhone couldn't join the network the QR named. Wi-Fi setup now asks for WPA2 there.
    D0 goes back, D1 walks the list and keyboard (held, back) and D2 chooses; the QR says "D2 to type".
    The build log and FEATHER-S3.md note the dual image's push, finished over plain serial after
    mpremote's sessions reset the board.
    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
    [board.py, wifisetup.py, wifisetup_test.py]
2026-10-22 Wi-Fi setup on the ESP32: switch the hotspot on before configuring it
    Tried in RAM on the Feather: ap.config() before ap.active(True) raises "Wifi Invalid Mode", so the
    hotspot never came on and the phone found no network. On the ESP32 it is now switched on first, then
    given its name, key and WPA2; if that fails it is switched off rather than left open.
    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
    [wifisetup.py, wifisetup_test.py]
2026-10-22 tools/fw: go on when the Feather resets as mpremote closes the port
    The Feather ESP32-S3 can reset itself as mpremote closes the port, once every command has run;
    mpremote then fails in close() and the push stopped in its backup. Now mp() waits for the board to
    come back and leaves the step to its usual check of what the board printed. An error on the board
    still fails, and unpause skips an app the restart took away.
    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
2026-10-22 The Feather's resets can come partway through an mpremote session, not only as it closes
    The second push stopped in its backup with no COPIED from the board: the reset came during the copy.
    tools/fw's step checks caught it; the comment and FEATHER-S3.md now say so.
    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
2026-10-22 The ceremony on the Feather's three buttons
    The dual image sent a fresh chip to the ceremony banner, but nothing there read D0-D2. Now D2 on
    the banner opens PROVISION, and setup_s.py draws C1-C10 on 240x135 with a rail. It reads the
    buttons as the Pico's: D0 is Y (back), D1 is B, D2 is A. So the arm is D0+D1 held 3 s, and a
    permanent or GenKey step is D2 held 3 s once armed. ALLOW_*, the 60 s arm and the holds stay
    provision.UI's own. The banner offers nothing for a branded chip on the Feather: the claim isn't on
    three buttons yet.
    run-ceremony.mjs walks C1-C10 on a virtual 608C through the buttons alone, in a device of its own.
    It also checks that D2 without the arm does nothing, D1+D2 is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
2026-10-23 Chip 3 sealed on the Feather; a ceremony hold starts only with 10 s of the arm left
    The first ATECC608C through C1-C10 (0123147ac8c5b889ee, on the Feather's three buttons, build
    2cd9354c), checked on the laptop afterwards: config CRC af3a from the snapshot and from the locked
    chip, the OTP record matches the key, owner 0x031B2c6038aB0d15e62eC2D2D21D84878e13250e from the
    passkey factory on Base Sepolia, Base and Ethereum. Build log entry.
    One C6 attempt was refused: its hold started with about 4 s of the arm left, and the arm ran out
    during C6's test signature, before the lock. provision.ARM_LEFT: a hold starts only with 10 s to
    go, else the screen says arm again (A, the knob, and the Feathe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
2026-10-23 docs/ONBOARDING.md: a proposal for giving someone a key
    Who's who (organizer, keyholder, other owners, a helper), the keyholder's three jobs, three ways
    to hand a key over, the Safe shape it needs, the journey from preparing to an emergency, what the
    console says in each state, the set-up QR code, the printed card, what exists, and a build order
    with chip 3 as the test case. Five decisions left open.
    Claude-Session: https://claude.ai/code/session_01Duo2iAWZoXo4nA3KdNzuAk
2026-10-23 The Feather's Key screen: the key's owner address as a QR code
    Step 1 of docs/ONBOARDING.md's build order. Key, past Owners and Device on home, shows the owner
    address as an EIP-55 QR code (29 modules at 4 px, 132 px with its margin) beside the short address,
    its picture and "A signer, not a wallet"; D1 shows the address in full, D0 goes back. A console
    with no Safe yet says "Your key is ready" and D2 opens the same screen, unless another chip is
    pinned. A Safe that doesn't list the key says "Not an owner yet" on home.
    Checked: console_test.case_three (11 new checks, 243 pass), the screenshots (docs/quorum-ui/feather
    23-27), and the code read back by macOS CoreImage as the address on the sc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
    [console_test.py, quorum.py, quorum_ui_s.py]
2026-10-23 The Feather's reviews: a blockie for every address, a token's and each owner's
    Every address page (to, from, the owner replaced and the new one, a spender, a contract, each call's
    in a batch) draws the address's blockie beside its short last line: 40 px on the Feather, 24 px on
    the 1.8". A token's amount page has the token contract's beside "on USDC", and approvals (on the
    Feather) and Owners one for each owner. case_three checks each is drawn, on the screen and clear
    of the text, for a send, a token send, a swapOwner and a MultiSend batch (246 pass). Five new
    shots in docs/quorum-ui/feather. The console's release is now e4f2·1ef1.
    Cl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
    [console_test.py, quorum_ui_s.py]
2026-10-23 wing-a: a FeatherWing-compatible board for key-c's port behind the Feather
    A board the Feather's size, on its header pins, with console-a's key port:
    an upright USB-C plug, the AP22653 switch, ESD, CC sense on D5/D6 (ADC1),
    and 0 ohm links that put the key on the Feather's SDA/SCL (today's image)
    or on D11/D12. Outline, rows and holes from Adafruit's board file; no copper
    behind the antenna. Written, routed and self-checked by gen_wing.py with no
    KiCad; not yet checked in KiCad, not ordered. No firmware change.
    Claude-Session: https://claude.ai/code/session_014UuUn7sLaEVq1c2M8i6TGa
    [wing-a.kicad_pcb, wing-a.kicad_sch]
2026-10-23 wing-b: the key's plug at the edge, on a tab out of the 12-pin side
    The same circuit as wing-a with GCT's USB4155 right-angle edge plug, so
    key-c lies beside the stack. Every edge of the Feather's outline is taken,
    so the plug sits on an 11 x 5 mm tab mid-board. The plug wants a 1.0 mm
    board; only its A row can be routed, which is all key-c needs, so one CC
    line is read (D5) and R4/R6 go. Its 0.5 mm pitch is fanned out on a 0.1 mm
    grid with V-shaped stubs before the 0.2 mm router takes over.
    The new courtyard check found five overlaps in wing-a as first pushed; those
    parts moved, and both ESD arrays' flow-through pairs are now bridged under
    the chip. Both wings self-check clean; neither has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
    [wing-a.kicad_pcb, wing-a.kicad_sch, wing-b.kicad_pcb, wing-b.kicad_sch]
2026-10-23 console-s3: a concept for a one-board S3 console with the chip on it
    A concept page, not a design: a Feather-sized board with an ESP32-S3 module,
    the Feather's 1.14" screen and three buttons, the ATECC608C soldered on, and
    USB-C for power and serial. It copies the Feather's pins so today's image
    runs through the feather-s3 profile. JLCPCB's Economic assembly places
    everything but the module and the panel, which the workshop fits, because
    every Espressif S3 module is Standard-only there. Parts, tiers, the
    JLCPCB/workshop split, rough costs at 5/25/50 and the open questions.
    Claude-Session: https://claude.ai/code/session_01VgLzvFqqmnKN8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
2026-10-24 console-s3: the technical design, placed and checked, not routed
    DESIGN.md and gen_console_s3.py turn the concept into a board: an
    ESP32-S3-WROOM-1-N4R2 on the back (hand-soldered, antenna flush with the
    edge over a both-layer keep-out), the Feather's 1.14" panel in an 8-pin
    ZIF under its glass, five buttons, the ATECC608C on board and USB-C on
    the S3's own USB. 64 x 22.86 mm, everything JLCPCB places on the front.
    D0, D1, D2, the screen, the key's bus and the LED are on the
    feather-s3 profile's GPIOs, so today's image runs unchanged and nothing
    in firmware/ changes. PREV and BACK are on GPIO5 and GPIO6 for a later
    profile. The generator reads firmware/board.py and stops if the pins,
    the bu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
    [console-s3.kicad_pcb, console-s3.kicad_sch]
2026-10-24 console-usb: the S3 console with no radio, USB serial to the computer
    A design and its schematic: the bare ESP32-S3FH4R2 chip with no antenna, the
    Feather's 1.14" screen and three buttons, the ATECC608C soldered on, and a
    USB-C whose only data path is a CH340C bridge to the S3's UART1. DTR and RTS
    go nowhere, so the computer that relays the queue gets no REPL and can't
    reset the S3 or start its flasher. JLCPCB's Economic assembly places all of
    it but the panel.
    gen_console_usb.py writes the KiCad 9 schematic, the project, the JLCPCB BOM
    and PINS.md from one table, then has KiCad export the netlist and run ERC,
    and checks every net, footprint pad, strapping pin and the feather-s3 pins
    agains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
    [bom.csv, console-usb.kicad_sch]
2026-10-24 console-usb: every part placed, and 3D renders with the screen
    The generator now also writes a 70 x 28 mm board with every part placed (not
    routed), and with "render" has KiCad's 3D view draw it: top, three-quarter,
    the back, and the panel lifted off. The panel is a body of our own (glass,
    frame, foam pads, the ribbon folding under into J2) carrying the review page
    from docs/quorum-ui/feather. KiCad's DRC checks the placement against
    JLCPCB's limits, and the generator checks what sits under the glass.
    J2 becomes console-s3's HDGC 0.5K-HX-8PWB ZIF: the FH12, about 2 mm tall,
    didn't fit under the glass on its 2 mm tape. The S3 takes the plain QFN-56
    footprint; the thermal-via one drills 0.2 m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
    [bom.csv, console-usb.kicad_pcb, console-usb.kicad_sch]
2026-10-24 console-s3: renders of the board as placed, with its parts and the screen
    render.py draws four views from the generator's own positions, turns,
    sides and pads: the front with the panel, the front without it (what
    sits under the glass), the back with the module, and from above. The
    board's faces are textures (green mask, HASL pads, silkscreen, the
    mark); the parts are plain blocks at their datasheet sizes; the panel
    shows the Feather's review page from docs/quorum-ui/feather. A small
    z-buffered rasterizer in numpy, shrunk with Pillow; nothing random, so a
    rerun writes the same bytes.
    DESIGN.md shows the four at the top, says they are mock-ups and not
    KiCad renders, and how to remake them. CO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
2026-10-24 console-s3: SPEC.md, what any S3 console must have in any shape
    A spec with no board size and no positions: the ESP32-S3 (2 MB quad
    PSRAM, 4 MB flash, a certified module, never R8), the ATECC608C at 0x60
    and the addresses kept clear for it, the 240x135 ST7789 and how it must
    be mounted, the buttons' polarity and rails, the feather-s3 pin table
    that runs today's image, power, the straps, USB and what its REPL
    leaves open, the antenna rules, debug pads, and a checklist for any
    layout. Numbers from firmware/board.py, atecc.py, SECURITY.md and
    Espressif's WROOM-1 datasheet v1.8.
    DESIGN.md, CONCEPT.md and hardware/README.md point to it.
    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
2026-10-24 wing-a and wing-b: KiCad-clean, key-c P3's LED line, wing-b on a straddle plug
    KiCad 10.0.6 found what the self-check couldn't: gen_wing.py's rotate(),
    shared with console-pocket, turned parts clockwise on the page where
    KiCad turns them counter-clockwise, so every part at 90 or 270 had its
    pads swapped against its tracks. rotate() is KiCad's now and ROT's 90s
    and 270s are swapped; round pads join only inside their circle; loose
    via and track ends are dropped. console-pocket's README now says not to
    order it until it is regenerated the same way.
    Both wings carry key-c P3's LED: A8 and B8 joined as KEY_LED, driven
    from D13 (the status LED pin) through R13, D3 for ESD; R14 to A0 not
    fitted. N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
    [bom.csv, wing-a.kicad_pcb, wing-a.kicad_sch, wing-b.kicad_pcb, wing-b.kicad_sch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]
2026-10-24 key-c P3: a green LED on SBU2 that the console lights
    P2 plus two parts: D1, a green 0603 LED (C72043) beside U2, and R3,
    470 ohm (C25117), from the receptacle's B8 (SBU2) to D1's anode. R3 is
    first from the pad, so it limits whatever a plug puts on SBU. Only B8 is
    wired: A8 sits under SDA's via. The wings join their plug's A8 and B8 and
    drive them from D13, the status LED pin, so the key's LED follows it with
    no firmware change. A cable to a laptop carries no SBU: it stays dark.
    gen_cd.py writes P3 (and was first checked to rebuild P2 exactly);
    `tools/keypcb gen-cd key-c-usbc` now writes only that board. P2's files
    as ordered move to fab/P2/. KiCad 10.0.6, tools/keypcb check key-c-usbc:
    ER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
    [bom.csv, key-c-usbc.kicad_pcb, key-c-usbc.kicad_sch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]
2026-10-24 console-s3: routed with Freerouting, brand silkscreen, BOOT and RESET
    tools/keypcb route console-s3 routes the placed board with Freerouting
    2.5 through KiCad's Specctra files, then drops dangling vias, stitches
    ground and fills. The generator writes the board placed, plus locked
    escape tracks for J1's USB pads and U2's bus. 537 tracks, 1066 mm, 70
    vias (19 stitching).
    - C5 turned toward U2; U4 moved; USB split at U4 (USB_DP/DN on J1's
    side, S3_DP/DN on the module's); 2.5 mm no-track rings round H1/H2.
    - The silkscreen: the name traced from Atkinson Hyperlegible Next Bold
    (wordmark.py), the logos, and under the glass an 8-bit key below U2
    with a dragon guarding it, after Adventure (At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
    [bom.csv, console-s3.kicad_pcb, console-s3.kicad_sch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]
2026-10-24 tools/keypcb jlc: the checks before a JLCPCB order
    `tools/keypcb jlc <board>` holds a board and its fab files to JLCPCB's
    2-layer limits (tools/jlc/limits.py, read from their capabilities page
    2026-10-23), writing tables and pictures to <board>/fab/check/ (ignored):
    0 the fab files are the board's 5 mask webs, vias by pads, paste
    1 DRC at JLC's limits, all errors 6 vias, holes, rings, spokes
    2 Gerbers read back by gerbonara 7 regulator heat, islands, return
    3 IPC-D-356 against the schematic 8 3D fit in FreeCAD, fit.step
    4 BOM/CPL against LCSC (parts.json) 9 golden pictures (fab/golden/)
    Check 10 is by hand: ORDERING.md section 9. --selftest breaks a copy of
    the board o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
2026-10-24 console-s3: J1's slot rings 0.25, R8 clear of the fold, U3's heat path; the order plan
    The three things tools/keypcb jlc pointed to, then routed again:
    - J1's shell pads 0.1 mm bigger, so its plated slots' rings are 0.25 mm,
    not JLCPCB's bare 0.20. The slots are the same.
    - R8 upright at (52.2, 10.4), 0.7 mm clear of the panel ribbon's guessed
    fold instead of under it.
    - U3's ground pin solid to the pour, with a track to a via under its
    body into the back pour.
    504 tracks, 1051 mm, 74 vias (17 stitching).
    The back's Source Location reads PicoQuorum.app, whose home page links
    to the source.
    ORDER-PLAN-2026-10-24.md: what to select at JLCPCB for five boards, and
    the choice it turns on.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
    [console-s3.kicad_pcb, console-s3.kicad_sch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]
2026-10-24 ci: skip CI for changes only to hardware/, cad/ or buildlog/
    Nothing in CI builds or tests those folders. A change that also touches
    anything else still runs all of it, and the release workflow still calls
    CI in full on the tagged commit.
    Claude-Session: https://claude.ai/code/session_01AdhKFuUCjAq2Egaz4aX4zg
2026-10-24 PicoQuorumKey: the sister S3 board, rebranded, with the UDFN key chip
    Imported from the user's own design (crypto-signing-device) into
    hardware/picoquorum-key, to order beside console-s3 and compare.
    - Renamed console-s3 to picoquorum-key throughout (the name clashed).
    - Silk: the PicoQuorum mark and name, PicoQuorum.app, and the 8-bit key
    and dragon by U2; the back carries the mark, "KEY, REV A" and the site.
    - U2 is now the ATECC608C-MAHDA-S UDFN-8 (C23291019), as on console-s3.
    Swapped in place on the routed board: 3V3 goes round the chip's west
    side, the exposed pad reaches GND through one new via.
    - J1's shell slot rings 0.20 to 0.25 mm, console-s3's lesson.
    - Its tests learn the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
    [bom.csv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]
2026-10-24 Order plan: one ESP32 module, the S3-WROOM-1-N8R2, for both boards
    Compare the ESP32 families against what the console needs (Wi-Fi, 2 MB
    quad PSRAM, an S3 for today's profile, native USB), with LCSC stock and
    prices read 2026-10-24. N8R2 is the cheapest part that fits, has ten
    times the N4R2's stock, and is already PicoQuorumKey's module. Buy
    twelve for both orders.
    Claude-Session: https://claude.ai/code/session_01XwHg4ToGz3n53Vasj6GisW
2026-10-24 console-s3: the ESP32-S3-WROOM-1-N8R2, as PicoQuorumKey
    Both boards now name one module, C2913204: the same footprint, pins and
    2 MB quad PSRAM as the N4R2, cheaper, and ten times the stock on
    2026-10-24. The generator's constants and the routed KiCad files carry
    the new part number and flash size; only hidden properties and the
    schematic's note change. The module isn't in the Gerbers, BOM or CPL,
    so the fab files stay as they are.
    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
    [console-s3.kicad_pcb, console-s3.kicad_sch]
2026-10-24 console-s3: backlight from VBUS, longer module pads, J2 at the 21 mm reach
    - The backlight was likely over-driven: 10 R from 3.3 V gave 20-40 mA against the
    panel's 20 mA maximum (ER-TFT1.14-2). It now runs from VBUS through 150 R
    (C22808): (5 - 3.0) V / 150 R = 13 mA, 16 mA at worst. Q2 and R4 move to VBUS.
    - The module's pads reached 0.45 mm past its edge; they now reach 1.45 mm, as on
    PicoQuorumKey, for the iron. The courtyard and pin-1 dot follow.
    - J2 moves to x 30.0, for the datasheet's folded reach of 21.0 +/- 0.5 mm from the
    glass's edge (it was 4.7 mm shorter). C6, the key and dragon art move with it, and
    the 3D fit models the fold from the same drawing.
    - Placed, routed a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
    [bom.csv, console-s3.kicad_pcb, console-s3.kicad_sch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]
2026-10-24 firmware: a picoquorum-key profile, picked on an S3 by its key bus's pull-ups
    PicoQuorumKey has the Feather's screen and three buttons on other pins: the
    screen on SPI(1) 12/11 (CS 10, DC 9, RST 14, BL 21), D0 D1 D2 on 42 41 40, all
    pulled up and pressed low, the key on 16/17, the LED on 48, nothing to power up.
    The image drove 40-42 as outputs on it, into buttons that short them to ground.
    There is one image for every S3, so board.py looks: GPIO16 and 17 read with
    only the S3's ~45k pull-downs, then left with no pull. Only PicoQuorumKey pulls
    them up (4.7k); the Feather, console-s3 and the wings leave them free, and stay
    feather-s3. THREE now covers both; the emulator takes BOARD = "picoqu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
    [board.py, console_test.py, feather_s3_test.py]
2026-10-24 console-s3: U1's schematic MPN is the N8R2; the order plan's via count
    - The schematic's U1 still named the N4R2 (C2913203, 4 MB) in its MPN and
    Description; its value, the board and the generator name the N8R2. The two
    lines now match what the generator writes. ERC 0, DRC 0, parity 0;
    tools/keypcb jlc passes.
    - The order plan said 74 vias; the re-route left 72.
    Claude-Session: https://claude.ai/code/session_014mGuGD4x9Si2dmdRKbhRec
    [console-s3.kicad_sch]
2026-10-24 hardware/builds: one folder per rig, and the Feather pigtail
    builds/ holds rigs made from bought boards, each with a README, bench/
    and case/. hardware/README.md gets a table of every configuration and
    the firmware profile it runs. The console image knows boards, not rigs;
    a rig's own screens stay in its bench/, outside the image.
    The Feather pigtail: a USB-C cable soldered to the Feather's 3V, GND,
    SDA and SCL; bench/swap.py, a read-only screen that rescans on D2 and
    says whether the key changed, with a CPython test on the virtual chip;
    and case/case.py, a CadQuery tray and bezel with a cable-tie clamp,
    checked for overlaps against the board's parts.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
    [pigtail_bezel_v1.stl, pigtail_case_v1.stl, pigtail_tray_v1.stl]
2026-10-24 console-s3, picoquorum-key: printable STL mockups of the board and the module
    tools/mockup/mockup.py reads each routed board with KiCad's Python and builds
    two solids in FreeCAD:
    - <board>-board.stl: the board's outline and M2 holes, every front part as a
    block on its courtyard to its height, and the panel as one block up to the
    glass's top, with the ribbon fold. One solid, back face down to print. A
    0.4 mm groove on the back outlines the module, with a line where its antenna
    starts.
    - <board>-module.stl: the ESP32-S3-WROOM-1, 18 x 25.5 x 3.1, soldered face down,
    to print apart and stack in the groove.
    Heights come from console-s3's generator and PicoQuorumKey's test_3d.py, and
    ty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
    [console-s3-board.stl, console-s3-module.stl, picoquorum-key-board.stl, picoquorum-key-module.stl]
2026-10-24 feather-pigtail case v2: the plug in a pocket under the board
    The pigtail's USB-C plug lies flat under the Feather, its shell out of
    the top (D0) edge. Keepers in front of the overmold take the pull when a
    key comes off, a back stop takes the push, and ramped lips click over
    its top. A tongue on the bezel fills the plug's slot. The board sits
    8.8 mm up (7.0 in v1). Writes STL and STEP for the tray and bezel, and
    an assembly STEP. Not printed yet.
    Claude-Session: https://claude.ai/code/session_01M7Ls73VV3WRnZGEyXDx785
    [pigtail_bezel_v2.step, pigtail_bezel_v2.stl, pigtail_case_v2.stl, pigtail_case_v2_assembly.step, pigtail_tray_v2.step, pigtail_tray_v2.stl]
2026-10-24 buildlog: console-s3 rev A ordered from JLCPCB
    The order's settings and costs from its PCB and PCBA lines, the PCBA
    price breakdown and JLCPCB's invoice. Names, address and the account's
    customer code left out, as for key-c.
    Claude-Session: https://claude.ai/code/session_0182mzqwp6N7yEyi5Ua6AxYF
2026-10-25 feather-knob: the ESP32-S3 TFT Feather with an EC11 knob
    A board profile for Adafruit's ESP32-S3 TFT Feather (5483), chosen by
    secrets.BOARD = "feather-knob". Its pins are not the Reverse TFT's: the
    key on 42/41, the screen's CS/DC/RST on 7/39/40, power on GPIO21, and
    Boot is its only button. A knob on A1/A2/A3 stands in for D1 and D2:
    lcd.Keys hands on a detent as D1 or D1L and the push as D2, so the
    small screens and quorum.three() run unchanged. Boot rejects and goes
    back; the push held signs.
    The ceremony: Boot held 3 s alone is the arm, a detent back is back,
    the push does the step; the push is never part of the arm.
    hardware/builds/feather-knob: the wiring and its pin diagram (checke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
    [board.py, ceremony_test.py, chipapp.py, console_test.py, feather_s3_test.py, lcd.py, main.py, quorum_ui_s.py]
2026-10-25 buildlog: console-s3's placement review, checked pin by pin
    Each polarized part's pad 1, read from the board file, against JLCPCB's
    preview. All match; J2's model numbers its row from the other end,
    which changes nothing. The switches' inner pairing can't be seen there,
    so it goes on the bench list.
    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
2026-10-25 picoquorum-key rev B: an optional key port for a key-c
    Adds a straddle USB-C plug (C3151751) at the board's top-left corner, on a
    0.8 mm board widened 6 mm to 50 x 53. The key-c gets an I2C bus of its own
    (GPIO38/39) and power through an AP22653 switch whose EN is pulled down, so
    the key is off at reset and under any image that doesn't know the port. The
    port also has CC on GPIO1 (R17 47k on every board), ESD on every plug line,
    and a TVS on VKEY.
    Departures from the plan:
    - No LED or FAULT pins. Rev A's routing closes in module pins 21 and 24.
    D4 and a key-c P3's LED run off VKEY, and U5's FAULT is left open.
    - The ESP32 module footprint's 48 mm keep-out is removed. The antenna rule
    ar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
    [bom-port.csv, bom.csv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]
2026-10-26 picoquorum-key rev B: D4 is D1's red LED (C2286)
    The plan's green LED (C72043) is out of stock at JLCPCB. D4 is now the
    red KT-0603R that D1 already uses: a basic part already on every order,
    so no extra BOM line. At 3.3 V through R22 (1k) it gets about 1.4 mA, as
    D1 does; the green InGaN part would have got under 1 mA.
    Checks: ERC 0, DRC 0, tools/test.sh OK (11 skipped: no FreeCAD).
    Claude-Session: https://claude.ai/code/session_01H2mKC2z3aivAd8yF8tbg6X
    [bom-port.csv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]
2026-10-26 picoquorum-key rev B: D4 is a green KT-0603G (C12624)
    Replaces the red C2286 stand-in. The plan's green C72043 is out of stock.
    C12624's JLCPCB tier and stock weren't checked from here. At 3.3 V
    through R22 (1k) a green LED gets under 1 mA; BRINGUP.md says to drop
    R22 to 470 ohm if it is too dim.
    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
    [bom-port.csv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]
2026-10-26 picoquorum-key rev B: R22 470 ohm (C23179) for D4
    The green KT-0603G drops about 2.7 V or more, so through 1k from VKEY it
    got under 1 mA. 470 ohm gives about 1 mA. R22 is no longer on R18's 1k line,
    so bom-port.csv has one line more.
    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
    [bom-port.csv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]
2026-10-26 picoquorum-key rev B: 5 V on the key port's VBUS no longer reaches 3V3 through SBU
    U7's second channel was on SBU, which R21 (100 ohm) feeds from VKEY.
    5 V put on the plug's VBUS then went R21 -> U7's diode -> 3V3, around
    U5's reverse blocking: about 11 mA with the board on, enough to
    half-power it when off. U7 now covers CC only; SBU meets only R21, so
    D3 clamps it through 100 ohm. Its spur (3 vias, 13 segments) is gone
    from the board; nothing else moved.
    What is left is R19/R20 (2.2k) into U6's diodes and GPIO38/39's
    clamps, about 0.5 mA a line. test_key_port holds the board to that,
    and fails on the old circuit. BRINGUP.md gets a bench-supply check.
    DESIGN.md's regulator note said the A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
    [picoquorum-key-B_Cu.gbl, picoquorum-key-B_Mask.gbs, picoquorum-key-B_Silkscreen.gbo, picoquorum-key-Edge_Cuts.gm1, picoquorum-key-F_Cu.gtl, picoquorum-key-F_Mask.gts, picoquorum-key-F_Paste.gtp, picoquorum-key-F_Silkscreen.gto]
2026-10-26 picoquorum-key rev B: U5 blocks reverse current only while off
    From the second review of the key port. The AP22653 datasheet (Diodes
    DS41186 rev 5-2): disabled, reverse leakage is 1 uA at most (p. 5);
    enabled, reverse current is limited to 0.32 A typical, not blocked
    (p. 6, p. 10). DESIGN.md said U5 blocks 5 V on the plug's VBUS; it now
    splits the two cases and says the enabled one is not protected, why the
    latch-off AP22653A wouldn't close it, and how it could arise. No part
    changed: closing it is a switch that blocks while on, and a re-route.
    BRINGUP.md's bench check now keeps KEN low throughout, counts D4
    (~5 mA) and U5's 600 ohm discharge (~8 mA) in the supply current, and
    sets pass lev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
    [picoquorum-key.kicad_pcb, picoquorum-key.kicad_sch]
2026-10-26 picoquorum-key rev B: D5, a Schottky between U5 and the plug
    U5 (AP22653) blocks reverse current only while off; on, it limits it
    to 0.32 A, which would push 3V3 past the S3's 3.6 V if 5 V reached the
    plug's VBUS. D5 (1N5819WS, C191023, basic) now sits between U5's output
    (new net VKEY_SW) and VKEY: 5 V on the plug stops there, U5 on or off.
    About 0.2 V of drop at the key's current, so the key sees ~3.1 V.
    - R19/R20 move to VKEY_SW: a key that is off still isn't fed through
    its bus, and 5 V on the plug no longer reaches GPIO38/39's clamps.
    - R23 (10k) drains VKEY, which U5's discharge can't reach through D5.
    - Board: D5 and R23 in VKEY's run up the left strip (4, 19.5) and
    (2.2, 19.5);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
    [bom-port.csv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]
2026-10-29 console-rp: a sketch of console-usb on an RP2350, no radio at all
    The Pico 2 W's chip without its Wi-Fi chip, with console-usb's CH340C link,
    ATECC608C, screen and buttons. The RP2350 block (power pins, the core
    regulator, flash, crystal, USB, debug) from Raspberry Pi's hardware design
    guide and datasheet; the pins, the parts with LCSC numbers, and how to get
    there in KiCad by copying console-usb's project. No KiCad files yet.
    Claude-Session: https://claude.ai/code/session_013V1LHinRXiv7dfCS3HKLUE
2026-10-29 console-rp: an RP2350A console with no radio, routed, fab files for JLCPCB
    RP2350A, Raspberry Pi's minimal circuit, a CH343P serial bridge to USB-C, an ATECC608C (SOIC-8),
    the 1.14" panel in console-usb's ZIF, and D0 D1 D2 under the screen. gen_console_rp.py writes and
    checks the schematic and board; rpi_minimal.py copies Raspberry Pi's layout round the chip from
    their MIT KiCad files: the regulator corner with L1 (Abracon's polarity-marked AOTA) turned as
    theirs, the decoupling, and the crystal corner (ABM8-272-T3), each part where theirs is.
    Routed with Freerouting, then put right in place; the generator draws the same changes. ERC 0,
    DRC clean but for allowed findings, and `tools/keypcb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
    [bom.csv, console-rp.kicad_pcb, console-rp.kicad_sch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]
2026-10-29 console-rp: ready to order, the panel checked against J2
    Two real panels (NFP114H-03AF, Walfront's listing) were checked by hand: a 23 mm tail, and pin 1
    on the side J2's pad 1 is on. YIYANG's Y114-2413THBIG09-C08 datasheet, the same panel, gives J2's
    pin order. The README now has the panel section: the ribbon's loop past the glass, the foam pad
    off U6's leads, the wider glass, the active area's offset and R8's current. It also lists the
    outside review's findings left as they are. Docs only: the board and fab files are unchanged.
    Claude-Session: https://claude.ai/code/session_013V1LHk2Wdx2LrQkQAikN1e
2026-10-29 console-rp: five ordered from JLCPCB, the order logged with a cost estimate
    buildlog/2026-10-29-console-rp-order.md records the order: settings, the invoice ($164.28, $32.86
    a board, import 35 % of the merchandise), every BOM line as JLCPCB matched it ($44.38) and the fab
    files' hashes. It also estimates 100, 500 and 1000 boards (about $11.50, $9.90 and $9.60 a board,
    before the panel) from LCSC's price ladders, with the stock that limits a run: L1 at 0, the crystal
    at 830. Name, address, phone, email, card and the account code are left out. The READMEs mark the
    board ordered, and BUILDLOG.md has the entry.
    Claude-Session: https://clau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
2026-10-31 hardware: the stompbox build (Pico 2 W, 2.4" screen, knob, footswitch Sign)
    A Build 1 variant in a printed guitar-pedal case, for a demo: an EC11 knob
    for the screens, a momentary footswitch on GP15 (the console's Sign), an
    optional Reject button on GP21, and a key-c on a USB-C plug standing out
    of the lid. Every pin is Build 1's, so it runs the console image as
    BOARD = "build1", SCREEN = "2.4" with no firmware change.
    - wiring.py draws wiring.svg; --check loads board.py as build1 and
    compares the pins
    - case/case.py (CadQuery): base, lid, a STEP assembly with stand-in parts,
    and matplotlib previews; case/IDEAS.md weighs three cases
    - DEMO.md: the demo with the laptop's simulated Safe a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
    [stompbox_assembly.step, stompbox_base.stl, stompbox_lid.stl]
2026-10-31 stompbox: no Reject button
    A cosigner can't reject a Safe transaction: not signing it is all it
    can do, and only executing another transaction at the same nonce
    cancels one. So the optional Reject button is gone from the parts, the
    wiring (wiring.py, wiring.svg; nothing on GP21), the case (its hole,
    label and stand-in; the knob now centred above the footswitch) and the
    demo. The README says the console's own Reject row only hides a
    transaction on that console.
    Claude-Session: https://claude.ai/code/session_013V1LHfjBV8HMc1gbX5y1Lz
    [stompbox_assembly.step, stompbox_lid.stl]
2026-10-31 pico-sign: the build's name, and a sign switch, not a footswitch
    hardware/builds/pico-stomp is now hardware/builds/pico-sign. The switch
    is the sign switch (a 12 mm momentary metal push switch, HOLD TO SIGN)
    in the README, demo, case ideas, wiring diagram and case script; the
    case's outputs are pico_sign_*. Nothing about the parts, pins or case
    geometry changed: wiring.py --check agrees with board.py, and the case
    script's checks are clear (the switch's lugs 3.7 mm off the floor).
    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
    [pico_sign_assembly.step, pico_sign_base.stl, pico_sign_lid.stl]
2026-10-31 pico-sign: the 2.8" screen, four case concepts and a key cartridge
    The build moves to the 2.8" ST7789 Build 1 proved (SCREEN = "2.8", the
    same 8 pins); the README, wiring.py/svg and the index tables say so.
    case/concepts.py draws four massing models for it (a wedge, a terminal,
    a leaning slab, a vault with a guarded sign switch and a sealable key
    bay) and the key cartridge they share: a 22 x 46 x 7.6 mm two-part
    shell round a key-c, its plug end open to the receptacle, a window
    over the ATECC608, a label recess, a keyed corner and a lanyard hole.
    It writes each concept's pictures with a screen warped onto the panel,
    the cartridge's halves as STLs and every concept as STEP.
    case/CONCEPTS.md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
    [cartridge_bottom.stl, cartridge_top.stl, concepts.step]
2026-10-31 pico-sign: the prism case
    case/prism.py draws the case after the pictures that were liked: a
    triangle seen from the side (the plate at 60 degrees, a flat top band,
    the back at 70), 180 mm wide, in two printed parts. The body is one
    piece, open at the front, chamfered, with a colour channel round the
    base, and prints front-down with no supports. The 3 mm front plate holds
    the 2.8" screen on four posts, the sign switch on top (HOLD TO SIGN, a
    reinforcing ring behind it) and the knob under it, and fixes with four
    M3 screws into heat-set inserts in the body's corner blocks.
    The key, in its cartridge, lies flat in a tray sunk 2.4 mm into the top
    band, chip window up, with a finger scoop; the USB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
    [cartridge_bottom.stl, cartridge_top.stl, concepts.step, prism_assembly.step, prism_body.stl, prism_plate.stl]
2026-10-31 pico-sign: the prism's screen mount, carrier and key plug
    The plate prints face down. The screen rests on four posts at its
    board's holes (4.6 mm, calipers): 7 mm seats, 4.2 mm tall for the 4.0 mm
    panel, cut flat where the glass comes close, each with a 4.2 mm pin on
    through the board. Spacers and a carrier follow on the pins; the carrier
    rests on four bosses with M3 inserts and screws to them, pressing the
    board onto its seats. The Pico screws to 6.5 mm posts with M2 inserts on
    the carrier's back, above the screen's header, its USB left and out
    through a 13 mm hole in the left wall. Only PICOQUORUM is cut on the
    front now, as big as fits, with a frame for a label under each control.
    The sc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
    [prism_assembly.step, prism_body.stl, prism_carrier.stl, prism_plate.stl, prism_plug_lock.stl, prism_spacers.stl]
2026-10-31 pico-sign: assembly pictures, the Pico's USB end, header right, tools/case
    - the Pico screwed at its far end only: two 4.5 mm posts, M2 x 8
    self-tapping, no M2 inserts; its micro-USB plug hit the USB-end posts
    - the screen's header on the right, away from the Pico's USB; the firmware
    still draws it for the left (MADCTL 0x60, needs 0xA0: not changed)
    - the cable slot in the left wall, the feet's pockets
    - ASSEMBLY.md: 13 steps, pictures drawn from the model by case/assembly.py
    - tools/case: list, build and check the CadQuery designs at pinned versions
    Claude-Session: https://claude.ai/code/session_013V1LHiaKGYEcGGXBWRxpgR
    [prism_assembly.step, prism_body.stl, prism_carrier.stl, prism_plate.stl, prism_spacers.stl]
2026-10-31 pico-sign: slimmer posts at the Pico's USB end, a drawing of it, a rounded carrier
    - The USB end's two posts are back, 3.6 mm across with the same 1.8 mm holes (the far
    end's stay 4.5 mm). prism.py checks them against the plug (0.2 mm), the micro-USB
    socket between them (0.15 mm) and the nearest pad (0.56 mm). The socket's size is a
    usual micro-B's, not measured.
    - assembly.py draws pico-usb-end.png: the USB end from above and from the side, with
    those clearances. ASSEMBLY.md's step 9 shows it.
    - The carrier's outline has 2 mm rounded corners, inside and out.
    tools/case check prism: 30 outputs, up to date; 181 pairs clear.
    Cla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
    [prism_assembly.step, prism_carrier.stl]
2026-11-01 app: paste a key's compressed public key to deploy its signer
    The #/signer form takes a PicoQuorum key's compressed key (02|03 x) or its
    set-up link and opens the key's page (#/k), with its Deploy buttons. The
    form now says it's for any key, and that an owner address can't be used.
    Claude-Session: https://claude.ai/code/session_013V1LHkGXVgVigxrLAuhTiU
2026-11-02 pico-sign-handheld: pico-sign with the 2.4" screen, in a flat handheld case
    A new build: pico-sign's knob, hold-to-sign switch, pins and key cartridge,
    with the 2.4" screen and a Pico 2 W, in a flat portrait case held in two
    hands or laid on the desk. It runs the console image as BOARD = "build1",
    SCREEN = "2.4": no firmware change.
    - case/handheld.py (CadQuery): a tub printed on its back and a front plate,
    86 x 118 x 30 mm (the prism is 180 x 107 x 78). The screen across the
    top, the knob bottom left, the sign switch bottom right. The prism's
    screen mount (posts and pins, spacers, carrier), its key plug holder and
    lock laid on the floor at the top edge, the key's cartridge standing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
    [handheld_assembly.step, handheld_body.stl, handheld_carrier.stl, handheld_plate.stl, handheld_plug_lock.stl, handheld_spacers.stl]
2026-11-02 pico-sign-handheld: the key's clamshell, sunk controls, a cover on the sign switch
    - case/cartridge.py: a clamshell for key-c, two halves each printed flat
    on its outside face. The tray holds the board in a pocket, a peg up
    through H1, a relief for J1's shell tabs; the cover's rim and a boss
    round the peg press the board flat. Four clips on the tray snap into
    windows in the cover's sides; push them in to open it. Same outside as
    pico-sign's cartridge (22 x 46 x 7.56 mm).
    - handheld.py: the knob in a round well (25 mm, 3 mm deep), the sign
    switch in a 6 mm well, the plate thickened behind each. In the switch's
    well, a guard: a base the switch's head clamps to the floor, and a co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
    [cartridge_cover.stl, cartridge_tray.stl, handheld_assembly.step, handheld_guard_base.stl, handheld_guard_cover.stl, handheld_plate.stl]
2026-11-02 pico-sign-handheld: the Pico on the carrier, a tactile sign button
    - The Pico screws to the screen's carrier, as on the prism: four 6.5 mm
    posts, M2 x 8 self-tapping, across behind the screen under the key's
    plug holder, its USB out through a hole in the right side. Everything
    wired is now on the plate but the key's plug. The tub's floor posts and
    bottom hole are gone.
    - The sign button is a 6 x 6 mm tactile switch, not the 12 mm metal
    switch: that one would make the case about 45 mm thick under a flush
    cover. A printed cap in the well, a flange seated in a cone under the
    guard's base, a plunger through the floor 0.2 mm over the switch's stem;
    0.45 mm travel to a stop on the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
    [handheld_assembly.step, handheld_body.stl, handheld_carrier.stl, handheld_guard_base.stl, handheld_plate.stl, handheld_sign_cap.stl, handheld_tact_holder.stl]
2026-11-02 pico-sign-handheld: flat-pack assembly pictures, ASSEMBLY.md
    - case/assembly.py draws 16 steps and the parts, hardware and exploded
    pages from handheld.py's and cartridge.py's own parts, with pico-sign's
    drawing (its z-buffer, outlines, labels and hardware shapes, loaded
    from pico-sign/case/assembly.py): the tub's inserts, feet and key
    plug; the plate's inserts; the guard and cap on the bench, into the
    well; the tactile switch in its holder, with a cut through the button;
    the knob, the screen, spacers, carrier, the Pico, the wires; onto the
    tub and the Pico's cable; the key into its clamshell; done.
    - ASSEMBLY.md: what to print, buy and have to hand, and each step
    - tools/case: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
2026-11-02 pico-sign-handheld: the sign button in a mini breadboard; socket heads, no countersunk
    - SIGN_MOUNT = "breadboard": a 12 x 12 mm tactile switch in the bench's
    mini breadboard (46 x 34.2, calipers), stuck to the tub's floor under
    the button between four L-shaped stops, the switch across the channel
    on its 3rd column from the right-hand end. The cap's plunger reaches
    down to it, 3.1 mm under the well's floor; 0.55 mm travel to the stop.
    The printed holder stays as SIGN_MOUNT = "holder" for a 6 x 6.
    The breadboard clears the corner post (1.1 mm), the carrier's screws
    (0.9 mm), the EC11 and the Pico. Its height (8.5) and the switch's
    (7.3) are not measured; only the cap follows t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
    [handheld_assembly.step, handheld_body.stl, handheld_guard_base.stl, handheld_plate.stl, handheld_sign_cap.stl, handheld_tact_holder.stl]
2026-11-02 pico-sign-handheld: a title, PicoQuorum Handheld, and the assembly linked up top
    The README opens with the build's name and a line to ASSEMBLY.md;
    ASSEMBLY.md links back. Both index tables name it and link its assembly.
    Every relative link in the four pages resolves.
    Claude-Session: https://claude.ai/code/session_013V1LHgQoi3Ug8fKGbTfesh
2026-11-02 pico-sign-handheld: the README's subtitle, reworded
    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
2026-11-02 pico-sign-handheld: the plate in four colours, by layer change
    The plate prints face down, so whatever is cut into the face shows the
    colour printing at its floor's depth. Filament changes at 0.6, 1.2 and
    1.8 mm from the bed (before layers 4, 7, 10 at 0.2 mm):
    - 0.6: charcoal: PICOQUORUM and the label frames, cut 0.6
    - 1.2: red: TURN and SIGN, bold 4.2 mm, cut 1.2
    - 1.8: blue: the far stripe; the wells' floors
    - three stripes over the screen, 1.6 mm bars with 45 degree ends, one at
    each depth
    - 45 degree chamfers round the knob well (1.2) and the sign well (1.8),
    so they, the window's bevel and the plate's edge show rings of colour;
    the guard's cover now stops at 120 degrees on the cha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
    [handheld_assembly.step, handheld_plate.stl]
2026-11-02 site: the handheld's page, and the front page brought up to date
    - docs/handheld/, from web/src/handheld.html: the PicoQuorum Handheld, its 16 assembly steps
    with the case's own pictures, a placeholder for the assembly video, and links back. Static like
    the front page: the same CSP, no script. Open Graph and a large share card for links from posts
    (web/src/handheld-card.png, cut from two assembly pictures by web/handheld-card.py).
    - The front page: a link to the handheld, its nav too; "What we're building" (the handheld,
    key-c, console-s3, the console on ESP32-S3); Where it stands now says Base mainnet executed
    (2026-09-26) and Ethereum with a fresh Trust M is next; the key is desc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
2026-11-02 pico-sign-handheld: the key as a cartridge in a bay in the back
    - The key's case is a wider cartridge, 48 x 54 x 7.56 mm, round key-c: the same snap-shut halves,
    the clips moved out to its sides. A tongue down each side of the tray, a notch in its bottom left
    corner, a dimple in each side of the cover. Its top 8 mm stand out of the case: grip grooves across
    both faces, a cut corner, a lanyard hole. A frame on the back for a label.
    - The bay: a slot down into the back's top half, open at the top edge and at the back, as on a
    handheld game. Grooves for the tongues, a rib round the notch, two bumps for the dimples. The key's
    USB-C plug stands up at its foot, in the prism's holder and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
    [cartridge_cover.stl, cartridge_tray.stl, handheld_assembly.step, handheld_body.stl, handheld_carrier.stl, handheld_plate.stl, handheld_plug_lock.stl, handheld_spacers.stl]
2026-11-02 pico-sign-handheld: STLs ready to print; a bay test piece; printing notes
    - The plug lock's STL had a hole: one of its two click bumps, a sphere, never fused (OCC), and the
    file laid it on that side. Each bump is now a cone cut flat, the same height; the lock is one
    closed mesh, 13.1 mm across with both bumps, and prints on its lip's face as its docstring said.
    - handheld.py stops on any printed part that isn't a valid solid; cartridge.py too.
    - handheld_bay_test.stl: the tub's top only, from the plug holder's foot up, to try the cartridge
    in the bay, the plug and its lock and a first insert before printing the whole tub.
    - ASSEMBLY.md: Printing, what to print first and the bridges. Th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
    [handheld_assembly.step, handheld_bay_test.stl, handheld_plug_lock.stl]
2026-11-02 pico-sign-handheld: the screen's holes as measured; thicker pins
    A first plate, printed with the placeholders, didn't take the bench's lonely binary 2.4" board:
    its posts were too far apart both ways and its pins too thin. Calipers on the board: 4.6 mm holes,
    near and far edges 59.2 and 68.5 mm apart across, 27.2 and 36.7 up and down.
    - SCREEN_HOLES 66 x 38 -> 63.85 x 31.95 mm (centres), SCREEN_HOLE 3.2 -> 4.6: pins 4.2 mm.
    - Seats and spacers 6 -> 7 mm across, so 1.2 mm rings carry the board and wall the spacers.
    - The board's back parts' stand-in, from a photo of the board: 46 x 36 mm, clear of the holes.
    - README: what's measured now, and what isn't (the board's outline, the glass).
    too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
    [handheld_assembly.step, handheld_carrier.stl, handheld_plate.stl, handheld_spacers.stl]
2026-11-02 site: the handheld's page for the cartridge in the back, rebuilt from this branch's pictures
    main's docs/handheld/ was built from the top-plug case, so CI's rebuild of this PR (new case
    pictures, the old built site) failed: "docs/ differs from a rebuild of this commit".
    - The page and the front page say the key is a cartridge in a bay in the back: the new sizes,
    hardware counts and checks; a section on the cartridge; the step captions as the guide has them.
    - Print it: every STL in the order to try them, linked to GitHub's 3D view, the bay test first.
    - The share card: the four-colour plate and the cartridge going into the back.
    - docs/ rebuilt from this branch's pictures (the measured sc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
2026-11-02 firmware: the USB link, and the REPL only in maintenance (2026.11.1)
    A running console now holds its USB port (firmware/usblink.py, docs/USB-LINK.md): JSON lines,
    hello and status read what it already knows, and three asks (Wi-Fi, the Safes, maintenance) are
    written only when the person sees every page and holds Sign on the console's own screen. The link
    never signs and never touches the chip. Ctrl-C is off from boot.py's first line, and main.py ends
    in a loop that never returns, so the REPL opens only in maintenance.
    - quorum.py: the ask state (pages, D0/Y refuses, D2/A held accepts, 3 s for maintenance), and
    safes.json read before secrets.py's QUORUM_SAFES
    - wifisetup.py: a new board's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
2026-11-02 app: #/device, a console on USB through Web Serial
    Connect reads what the console says it is (board, release, key, Wi-Fi, the Safes it watches) over the
    USB link, and sends it a Wi-Fi network or the Safes to watch; the console saves either only once
    Sign is held on it. DTR and RTS stay low. After the console restarts, the page opens it again.
    Without Web Serial the page says so and offers the console in the browser and the hotspot. Pictures
    of the ceremony's real screens show how a new key is made.
    web/e2e.mjs drives it against a scripted console on a fake navigator.serial.
    Claude-Session: https://claude.ai/code/session_013V1LHjE5d5LL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
2026-11-02 console page: ?board=picoquorum-key and feather-s3, the console on three buttons
    The emulator's runtime takes the board's screen from a small table (core/runtime.mjs SCREENS): the
    S3 boards' 240x135 frame at RAM 40,53, their DC pin, and D0 D1 D2 on their pins. It writes BOARD into
    the generated secrets, so the firmware picks the same profile. Without a board nothing changes.
    The console page reads ?board=, draws D0 D1 D2 down the screen's left edge level with the rail,
    maps 1 2 3 (or Esc, Down, Enter) to them, and gives the S3 boards their 2 MB heap. The app's Device
    page links here with the connected board. Same passkey, same folder, same firmware: the release
    fingerprint is unchanged.
    e2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
2026-11-02 firmware: the USB link writes each answer in 64-byte pieces
    On the PicoQuorumKey a status answer (about 560 bytes) arrived as its last 318 bytes, every time.
    Checked in maintenance: on the ESP32-S3's own USB, MicroPython 1.26.1 drops the front of a long
    write. A 600-byte line written at once came out as 318 bytes, three times out of three, and whole
    in 64-byte writes, with or without a pause between them. hello (230 bytes) was never cut.
    console_test checks an answer goes out in pieces of 64 bytes at most that together are the whole
    line. A new release fingerprint, 1851·f763.
    Claude-Session: https://claude.ai/code/session_013V1LHjE5d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
2026-11-03 cad/consoles: cases for console-s3 and PicoQuorumKey rev A, the stick and the badge, and a dock for each
    A tub and a flush front plate round each board, clamped by M2 screws from the back through the board's
    own holes into posts on the plate. Caps on D0, D1, D2 in Reject red, white and Sign green; pinholes for
    BOOT and RESET; a hole over the LED; plastic ribs, not screws, at the antenna end. The badge has a window
    over the ATECC608C. The back carries the name and the Source Location. The parts come from the CPL and
    BOM JLCPCB built from; the script checks the printed parts against stand-ins for the board, its parts,
    the glass, the module, a USB-C plug and the screws. First drafts: not printe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
    [badge_assembly.step, badge_cap_D0.stl, badge_cap_D1.stl, badge_cap_D2.stl, badge_dock.stl, badge_plate.stl, badge_tub.stl, stick_assembly.step]
2026-11-03 cad/consoles: the stick turned round, a front shell and a back panel, screws in the face
    The stick's face and walls are one front shell now, and a flat panel closes the back. Its two M2 screws
    go in from the front, flush in counterbores, through wider posts and the board's holes at the USB end
    into bosses on the panel. At the antenna end the panel's tab hooks into a slot in the end wall, inside
    the lanyard's lug, so there is still no metal near the antenna. shell.py has the two layouts, "shell"
    and "plate"; the badge keeps "plate" and its STLs don't change. Both build with no overlap.
    Claude-Session: https://claude.ai/code/session_013V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
    [stick_assembly.step, stick_back.stl, stick_dock.stl, stick_plate.stl, stick_shell.stl, stick_tub.stl]
2026-11-03 cad/consoles: the stick's mark big, RESET in its lower-left dot; its back the name alone
    The mark at the stick's antenna end is 17 mm across its dots now, placed from RESET's position so its
    lower-left dot is RESET's hole, cut through, 3.75 mm across; the script stops if the dot isn't over the
    switch. It misses BOOT's pinhole by 1.1 mm and the LED's hole by 0.4 mm. The back panel keeps the name
    and drops the small line under it. Each case also draws its face sliced just under the top, which shows
    the engraving.
    Claude-Session: https://claude.ai/code/session_013V1LHgqYF4uLi158MwkDeV
    [stick_assembly.step, stick_back.stl, stick_shell.stl]
2026-11-03 cad/consoles: the badge for PicoQuorumKey rev B with its key port; its rib off U6 and U7; no key window
    The boards came as rev B with the key port fitted: 50 x 53 x 0.8 mm. The first badge was drawn for rev A,
    and its plate's rib above the screen sat on U6 and U7, the port's ESD chips. The badge now reads rev B's
    cpl-port.csv, bom-port.csv and drill file, and its outline with the port's notch. The rib is on the
    antenna's keep-out band, which has no parts; run with the old rib, the script finds it on U6, U7, R17 and
    R18. The top-left corner is open for a key-c on the port's plug, and the script checks the plug and a
    plugged key-c against the case. Ribs in the tub back the 0.8 mm board under D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
    [badge_assembly.step, badge_cap_D0.stl, badge_cap_D1.stl, badge_cap_D2.stl, badge_dock.stl, badge_plate.stl, badge_tub.stl]
2026-11-04 Look around, Tabs, the set-up link QR, and New Safe with a 7-day recovery
    Firmware (release cc7c·6b5d):
    - Device → Practice: the ceremony's screens, arm and holds, writing nothing
    - three-button Tabs home on the Feather, console S3 and PicoQuorumKey
    - the Key screen's QR is the app's set-up link, #/k/<compressed key>
    (97 characters, 37 modules at 3 px); D1 still shows the owner address
    App:
    - #/k: Make a new Safe. One transaction from the wallet that scanned the
    console makes a SafeL2 1.4.1, that wallet and the key 2 of 2, deploys the
    key's signer, and turns on Candide's 7-day Social Recovery Module with a
    recovery address (not an owner) as its guardian. The chain is read back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
2026-11-04 Three buttons: pick your key by its blockie, then keep it
    The claim's U2-U4 and the spare's S1-S3 on PicoQuorumKey and the Feather
    (firmware/keypick_s.py): Make shows the owner address as a big blockie and
    its two ends; New makes another, as often as the owner likes before the
    seal; Full shows the whole address; Keep is a red page held 3 s that runs
    the test signatures and then the seal. The brand bench and the claim now
    open on three buttons (setup_s for the other steps).
    No B+Y arm on this screen: one press for a key that can be made again, the
    held red page for the seal; the screen arms the chip for that one call.
    ALLOW_GENKEY and ALLOW_LOCK still gate both.
    A new key costs nothing on c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
2026-11-04 The owner's own key on three buttons: set up, pick by blockie, keep
    The dual image now sends a fresh ATECC608 on PicoQuorumKey or the Feather
    to keypick_s's screens over provision.py's C1-C10, with no brand: Start
    (D2 held 3 s) runs C1-C3, Make/New/Keep are C4-C6, and Keep runs on
    through C7-C9 to the data lock. Finish picks C7-C9 up after a restart.
    The ceremony image keeps setup_s's step-by-step screens and the B+Y arm.
    signer.needs_ceremony also routes a chip whose config zone is still open
    (a table written, nothing locked, as the brand bench's B2 leaves it):
    C2 writes quorum v1 over it. provision.c4 clears "tested": a new key is
    tested again before any seal.
    brand_test case_three: the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
2026-11-04 A customer's first screen: the mark, plain words, a changing blockie
    On the dual image's own-key path (three buttons), the bench banner ("Not a
    signing console", chip name, PROVISION) gives way to keypick_s.welcome:
    the PicoQuorum mark, "Your key, made here. Pick the one you like.", and a
    72 px blockie drawn from fresh random bytes every 0.4 s (decoration: no
    key exists until Make). D2 opens Set up your key as before.
    Claude-Session: https://claude.ai/code/session_013V1LHgyEqknNUZZPNr4EKZ
2026-11-04 Key pick: a shuffle before each key lands, Choose this on top, New below
    - Each new key is made first, then lands after a shuffle that slows to a
    stop (ten frames, 60-250 ms): the shuffled pictures are random bytes,
    not keys.
    - The pick page: a wide "Choose this" bar across the top (D0), Full in
    the middle, New at the bottom (D2). The red Keep page holds on D0 for
    3 s; D2 is Back there.
    - The welcome blockie changes every 0.8 s (was 0.4).
    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
2026-11-04 console-rp: a bring-up script for the first board (screen, D0-D2, LED, key, link)
    One file on the stock Pico 2 MicroPython. It reads the key (Info, two
    config blocks) and writes nothing to it. Run in emulated MicroPython
    against a stand-in machine module: the screen, a chip's answers, a key
    press and the UART echo.
    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
2026-11-04 console-rp bring-up: no MISO on SPI1 (it took GPIO8, the screen's DC), and the REPL may own the link
    Proven on the first board: with SPI1's default MISO on GPIO8 the DC line
    never moved and the panel stayed black; with miso=None it fills. With a
    bench main.py that puts the REPL on UART1, the script leaves the link to
    it and its lines reach the computer as print()s.
    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
2026-11-04 console-rp: the first board's bring-up, its SWD loader, and ways to load boards in numbers
    bench/BRINGUP.md: what the first board showed, how it was loaded (a Pico 2
    W as debug probe, probe-rs, swdload.py), what went wrong (SPI1's MISO on
    the DC line, loose jumpers, J3's USB not seen), and the options for
    production loading. swdload.py writes MicroPython and a littlefs over SWD
    and was run on the board; rawrepl.py and main_repl.py are bench-only.
    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
    [main_repl.py, rawrepl.py, stage0.py, swdload.py]
2026-11-05 The console-rp plan: where the first board leaves us, the relay, a batch of 20, selling
    A plan to argue with, not a decision record. It explains why no radio,
    how the console could take Safe's queue through the computer without
    trusting it (and the AGENTS.md rule the relay would reword, not yet
    changed), the five boards' jobs, two weeks to an order of 20, loading at
    volume, the RP2350's locks, the brand's root key, and an ETH door and a
    Stripe door for the first sales, with business basics as footnotes.
    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
2026-11-05 cad/consoles: a first case for console-rp, the slate
    rp.py describes console-rp to shell.py, in the stick's "shell" layout: a front
    shell and a back panel, four M2 x 8 screws through the face into the board's
    four holes. D0-D2's caps in a row under the window; the mark at the right, its
    two lower dots the holes over RESET and BOOTSEL; the LED's hole beside it. The
    USB-C open at the right end, the lanyard lug at the left. The name and the
    Source Location on the back. Closed 82.6 x 40.6 x 10.9 mm. It builds with no
    overlaps. Not printed or fitted to a board.
    shell.py gains what the board needs, each off by default: a USB-C on the right
    edge, a lug at the left, no module, no tab, posts of the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
    [rp_assembly.step, rp_back.stl, rp_cap_D0.stl, rp_cap_D1.stl, rp_cap_D2.stl, rp_dock.stl, rp_shell.stl]
2026-11-05 cad/consoles: the slate's mark and name in orange, a collar round Sign
    The mark on the face and the name on the back are filled flush in an orange
    to match the caps: rp_inlay_mark.stl and rp_inlay_name.stl, each in the frame
    of the part it fills, to print as a second colour in the same job or press in.
    RESET's and BOOTSEL's holes stay open through the mark.
    A low collar round D2, Sign: 7.2 mm inside, 1.3 mm over the face, its top
    0.3 mm over the cap's. Sign takes a deliberate press; Reject stays one easy
    press. The collar keeps 1.1 mm off D1's hole.
    shell.py's printed() takes a board's own touches (b["decor"]); stick and
    badge have none. It builds with no overlaps, the collar on the dock i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
    [rp_assembly.step, rp_inlay_mark.stl, rp_inlay_name.stl, rp_shell.stl]
2026-11-05 cad/consoles: the slate's mark takes glue-in inserts; no collar
    The collar round Sign stood proud of the face, and the shell prints face down,
    so it's gone. The face is flat again.
    The mark's pocket is 1.0 mm deep, for printed inserts glued into it: the
    triangle and its top dot as one piece, in orange (rp_insert_signed.stl), and
    the two waiting dots in green (rp_insert_waiting_1/4.stl). Each is 0.1 mm in
    all round and 0.05 mm short of flush, for the glue. RESET's and BOOTSEL's
    holes stay open. The pocket leaves out the mark's lower dots: they are those
    holes already, and cutting their cylinders a second time made OpenCASCADE
    return an empty shell.
    The back's name is engraved only, as befor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
    [rp_assembly.step, rp_inlay_mark.stl, rp_inlay_name.stl, rp_insert_signed.stl, rp_insert_waiting_1.stl, rp_insert_waiting_4.stl, rp_shell.stl]
2026-11-05 cad/consoles: shaped caps; the slate's are a square, a circle and a triangle
    Each button keeps one job on every screen (quorum_ui_s.py): D0 takes you out
    (Reject, No, Back), D1 moves on (Next), D2 does it (Sign, OK, Open). On the
    slate each cap is that job's shape: D0 a square, stop; D1 a circle; D2 the
    mark's triangle, point up. Shape tells Reject from Sign where red and green
    alone don't, for the most common colour blindness.
    shell.py's cap_shape() makes a stem and its hole, the hole the same shape
    0.2 mm out. A square of 3.8 mm and a triangle of 6.0 mm, corners rounded, are
    each about a round cap's 14 mm2 and as tall, so Reject is no harder to press
    than Sign. A shaped stem in its own ho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
    [rp_assembly.step, rp_cap_D0.stl, rp_cap_D2.stl, rp_shell.stl]
2026-11-05 cad/consoles: the slate's mark is a raised badge in three colours
    The mark is six printed pieces glued into a pocket 1.0 mm deep, standing
    0.6 mm proud of the face, their top edges chamfered 0.2 mm: the triangle in
    green, the three signed dots in blue, the two waiting dots in orange
    (rp_badge_*.stl, face down). Each piece keeps 0.1 mm from its neighbours and
    the pocket's walls, and 0.05 mm off its floor for the glue. The shell's face
    stays flat, so it still prints face down.
    The two lower signed dots sit over RESET and BOOTSEL, so they are blue rings
    round 1.4 mm pinholes: a paperclip reaches the switch, a thumb doesn't. The
    script checks the dots are over the switches. The mark moves from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
    [rp_assembly.step, rp_badge_signed_0.stl, rp_badge_signed_2.stl, rp_badge_signed_3.stl, rp_badge_triangle.stl, rp_badge_waiting_1.stl, rp_badge_waiting_4.stl, rp_insert_signed.stl]
2026-11-05 cad/consoles: the slate's name on its face, cut to show a second colour
    "Pico" over "Quorum", centred over the mark, 2 mm above its top dot, cut
    0.6 mm into the face. The back's text is cut 0.6 mm too (b["engrave"]; the
    stick and the badge keep 0.5).
    Printed with the first two 0.2 mm layers in black and the rest in a colour,
    the letters' floor is that colour, from three layers down so a squashed first
    layer doesn't matter. The shell prints face down, 10.85 mm tall; the back
    panel outside down, 3.70 mm tall.
    It builds with no overlaps; stick's STLs and pictures are the same.
    Claude-Session: https://claude.ai/code/session_013V1LHjg3aZa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
    [rp_assembly.step, rp_back.stl, rp_shell.stl]
2026-11-05 The console-rp rev B plan: a square board, the same wiring, hooks for a run
    A plan for the next console-rp: rev A's netlist on a 58 x 54 mm board with the
    USB-C at the bottom, the flash clear of the glass, the top-left reserved for a
    key port, one corner cut, test pads for a jig, fiducials and the mark on the
    face. Decisions are marked.
    Claude-Session: https://claude.ai/code/session_013V1LHkVrvaz5VqffiJ7WRU
2026-11-05 Site: @picoquorum on X, one header, console-rp in place of the old prototypes
    - X: twitter:site and rel=me on the front page, an X link in the header and
    footer of the front, handheld and console pages and the app's footer, a
    README badge, and a row in STATUS.md's names.
    - One header on the static pages: Guide, Hardware, Console, Source, X. Guide
    goes to the guide on GitHub; Pages drew docs/guide/ with Jekyll's default
    theme. Mainnet notes likewise.
    - What we're building: console-rp and key-c. The handheld, console-s3 and
    Feather cards and the handheld banner come out; the handheld's page stays
    for links already shared, marked as an earlier design.
    - The guide: execute in the app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
2026-11-05 The name is Picoquorum: one word, one line, one capital
    The brand guide (docs/BRAND.md, BRAND.html) now writes the name Picoquorum: a capital P,
    every other letter lower case, never split across two lines. Web addresses and handles stay
    lower case.
    - Text: README, docs, the app, the console page, the emulator, tools, KiCad titles and silkscreen
    text, and PICOQUORUM on the cases and boards.
    - Unchanged: byte strings that are hashed or signed (the brand prefixes, the release's EIP-712
    domain, the Trust M domains, the family Safe's salt), the footprint ids PicoQuorum_Mark and
    PicoQuorum_Name, buildlog/, and image descriptions of renders that weren't rebuilt.
    - Logo: tools/brand/lockup.py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
    [badge_assembly.step, badge_plate.stl, badge_tub.stl, console-a.kicad_pcb, console-a.kicad_sch, console-pocket.kicad_pcb, console-pocket.kicad_sch, console-rp.kicad_pcb]
2026-11-07 mono: a slender RP2350 console, 40 x 96, routed, fab files for JLCPCB
    A new board, drawn from scratch: a 2.4 : 1 bar with the 1.14" panel near the top, D0 D1 D2 evenly
    spaced under it, and the USB-C at the bottom end, left of centre. RP2350A with Raspberry Pi's
    minimal circuit and layout, turned -90; a CH343P serial bridge, its DTR and RTS unconnected; the
    ATECC608C on I2C0; an LDL1117 regulator; the backlight from 5 V. KEY 2, under D0: a second key's
    site on I2C1 behind an AP22653 switch, with footprints for a Trust M and an ATECC608C and five
    holes, none fitted. Nine jig pads on the back; every part JLCPCB fits on the front.
    gen_mono.py writes and checks the schematic and board (tools/key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
    [bom.csv, mono.kicad_pcb, mono.kicad_sch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]
2026-11-07 cad/mono: Mono's board as a print, the parts as blocks to their heights
    board.py reads the routed mono.kicad_pcb (outline, holes, each part's place, turn and F.Fab body)
    and gen_mono.py's heights and panel, and writes one STL of the board, the 67 fitted parts and the
    glass, the back down, and the same in three pieces for colours. The glass's foam is one block and
    the parts under it are hidden, so it prints without support. A rough model, not a fit check.
    Not printed yet.
    Claude-Session: https://claude.ai/code/session_013V1LHhGippXwLsZEqEkczU
    [mono_board.stl, mono_board_panel.stl, mono_board_parts.stl, mono_board_pcb.stl]
2026-11-07 cad/consoles: Mono's case, a first draft in the slate's layout
    mono.py: a front shell and a back panel round the 40 x 96 board, 44.6 x 106.6 x 10.9 mm closed,
    four M2 x 8 screws from the face into the back's bosses. The window, the slate's shaped caps, the
    name and the mark's badge in the field under the buttons, a hole over the LED, the USB-C open at
    the bottom end, a lug at the top, a rib under D0-D2, and a dock with the plug in its lip. The
    numbers are gen_mono.py's and mono/fab/cpl.csv's, checked against each other. The build finds no
    overlap between the printed parts, the board's stand-ins, a USB-C plug, the screws and the dock.
    Not printed; no Mono board built.
    rp.decor: the mark's pi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
    [mono_assembly.step, mono_back.stl, mono_badge_signed_0.stl, mono_badge_signed_2.stl, mono_badge_signed_3.stl, mono_badge_triangle.stl, mono_badge_waiting_1.stl, mono_badge_waiting_4.stl]
2026-11-07 cad/consoles: Mono's caps 1.2 times as wide, on wider flanges
    The faces of D0, D1 and D2 are 1.2 times the slate's across (circle 5.0 mm, square 4.6, triangle
    7.2), and their flanges 7.4 mm, not 6.1, 0.3 mm off the posts beside D0 and D2. Each flange still
    sits on its switch with the same play and clearance, and reaches 0.35 mm past its hole at the
    least, more than the slate's triangle (0.25).
    shell.py: a board can scale its caps (cap_scale) and widen their flanges (flange_over); the build
    now fails if a flange reaches less than 0.2 mm past its hole (CAP_LIP). The stick's, the badge's
    and the slate's outputs rebuild unchanged.
    Claude-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
    [mono_assembly.step, mono_cap_D0.stl, mono_cap_D1.stl, mono_cap_D2.stl, mono_shell.stl]
2026-11-07 mono: 40 x 89.5, made shorter in place without routing again
    The top edge comes down 2 mm, so the glass is 1 mm from it, and everything below y 73.85 rises
    4.5 mm into the empty field under the LED: the USB-C, U2, the CH343P, the regulator, their
    capacitors and resistors, the bottom holes and a fiducial. Lines straight down through the field
    get shorter. Four crossed it at a slant: the regulator's 3V3 line, drawn in the generator, is now
    its column and one 45° run; VBUS, LINK_TX and LINK_RX, the route's, take a 4.5 mm level jog. On
    the back the warning comes down with the edge, and the current lines and the logo rise 1.3 mm,
    clear of the jig's names. 29 ground vias come out: the top row, no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
    [mono.kicad_pcb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]
2026-11-07 cad: Mono's case and print for the shorter board, 40 x 89.5
    Merged claude/mono's shorter Mono. Its generator keeps the first outline's top-left corner as its
    origin, the board from TOP to H, so the case and the print take the board's height as H - TOP.
    The mark and the back's text are given in the generator's frame, so they keep their places to
    the parts. The case closes at 44.6 x 100.1 x 10.9 mm, 6.5 mm shorter; the build finds no overlap
    and every cap held. Not printed.
    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
    [mono_assembly.step, mono_back.stl, mono_badge_signed_0.stl, mono_badge_signed_2.stl, mono_badge_signed_3.stl, mono_badge_triangle.stl, mono_badge_waiting_1.stl, mono_badge_waiting_4.stl]
2026-11-09 cad: Mono's case, industrial: cut corners, chamfered edges, grooves
    A variant of Mono's case (mono_ind.py), the same inside. The front shell's corners are cut off at
    45 degrees, 3 mm at the bottom and 8 mm across the lug at the top; the face's edge is chamfered
    1.6 mm and the back's 0.8; the counterbores 0.4; nine 0.5 mm V-grooves across each long side.
    shell.py gains these as options (corner_cut, back_edge, cb_chamfer, grooves), off by default:
    stick, badge and mono rebuild unchanged, and rp's STLs too. The build finds no overlap; the wall at
    the cut corners is 1.66 mm at the least. Not printed.
    Claude-Session: https://claude.ai/code/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
    [mono_ind_assembly.step, mono_ind_back.stl, mono_ind_badge_signed_0.stl, mono_ind_badge_signed_2.stl, mono_ind_badge_signed_3.stl, mono_ind_badge_triangle.stl, mono_ind_badge_waiting_1.stl, mono_ind_badge_waiting_4.stl]
2026-11-09 cad/consoles: bridge the counterbores in the model, two layers of steps
    Every case's screw counterbores print from the bed up and end in a ring-shaped ceiling with nothing
    to bridge to. shell.py now steps each hole for two 0.2 mm layers over its counterbore: a strip across
    it, bridged along the strip, then a square, bridged the other way, then the round hole. Being in the
    model, it works in any slicer; the README says to leave OrcaSlicer's and Bambu Studio's own
    counterbore bridging at None. The script stops if the counterbore isn't a whole number of layers.
    Rebuilt stick, badge, mono, mono_ind and rp: no check fails. Sliced in CadQuery, not in a slicer;
    not printed.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
    [badge_assembly.step, badge_tub.stl, mono_assembly.step, mono_ind_assembly.step, mono_ind_shell.stl, mono_shell.stl, rp_assembly.step, rp_shell.stl]
2026-11-09 A plan: optional branded chips signed by key 0000, and sponsored gas on Base
    Pulls BRANDED-KEYS.md, ATTESTED-KEYS.md, KEY-RUNBOOK.md and the console-rp
    plans into one plan for the board with no radio. Vanilla or branded, the
    customer's choice. Key 0000 signs each chip, and its counter is the public
    tally. What the customer checks on arrival, and what still rests on the
    console. The claim's challenge as the customer's mark. A Merkle root per
    batch. A plain relayer on Base, paid from a treasury Safe, Base Sepolia
    first. The decisions, and the order of work. No code changes.
    Claude-Session: https://claude.ai/code/session_013V1LHhmq2vTUsvN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
2026-11-09 Add the hardware and owner scripts, and group the Learn page into three areas
    Inside the console is rewritten on Mono as three zones: the cable, the
    console and the key. Two new scripts: When the hardware fails, and What
    it protects and what it doesn't. The Learn page and the scripts' index
    are grouped as Start here, The hardware and Being an owner.
    Claude-Session: https://claude.ai/code/session_013V1LHg8zxHYqdiZTLFdaMC
2026-11-09 Add Learn to the console page's header, and to the README
    The console page's header now matches the other pages: Learn, Guide,
    Hardware, Console, Source, X. On a phone its links wrap, as on the
    front page. The firmware is unchanged, so the release fingerprint is too.
    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
2026-11-11 hardware: Mono and console-rp stay; the S3 boards to prototypes/, the rest to archive/
    The hardware folder held thirteen folders side by side. Now its top level
    is what the work is on and what runs today: mono/, console-rp/, key-pcb/,
    and the dev console (DEV-CONSOLE.md, bom/, wiring/).
    - hardware/prototypes/: console-s3 and picoquorum-key, the two ESP32-S3
    boards with their own Wi-Fi, and the plan they were ordered from.
    - hardware/archive/: console-a, console-pcb, console-pocket, console-usb,
    feather-wing and builds/.
    - hardware/console-rp/: its two plans, from the repository's root.
    - Each of the three has a README that says what is in it, where each
    thing stands, and what still re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
    [bom-port.csv, bom.csv, cartridge_bottom.stl, cartridge_cover.stl, cartridge_top.stl, cartridge_tray.stl, concepts.step, console-a.kicad_pcb]
2026-11-11 README: Mono, the reference console, first; its cases easy to find
    The README described the Pico 2 W dev console as the console, and Mono
    was nowhere in it. Mono's case was a section at the bottom of a page
    titled for the two S3 boards' cases, and cad/mono/ held only the board
    as a print.
    - README: a section for Mono before the four ideas. What it is, where
    it stands (a design; not ordered, nothing built), its two cases, that
    it may become a dev board kit, and a note for early developers and
    contributors, with a sign-up sheet to come. The four ideas now say
    which board they speak of: the key is on the board or plugs in, and
    the dev console has Wi-Fi where Mono has a USB relay, not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
2026-11-11 site: the front page leads with Mono; current screens; no Console tab
    The front page still said console-rp was the console to build on, with a
    square rev B to follow, and every screen on it was the 240 x 240 A/B/X/Y
    interface from September. It gave the console in a browser a tab, a
    button in the hero and a section of its own.
    - The hero is the device: Mono in its case, on its dock, with a caption
    that says it is a drawing and nothing is built. Its buttons go to the
    hardware and to Learn. The app keeps the header's button, a line under
    the hero, and its own section with Launch app.
    - Hardware, rebuilt round Mono: what it is in four lines, the board as
    KiCad draws it, then its case,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
2026-11-11 cad: Mono's industrial case: the mark printed in the face, black lines over a green layer
    The badge's pocket was 1.0 mm deep and left a triangle 7 x 11 mm to bridge. The mark is now part of the
    shell, with no badge to glue in:
    - its pocket 0.4 mm deep, the shell's first two layers
    - lines of the face's plastic, 0.5 mm wide and 1.53 mm apart, across the triangle; a 0.5 mm ring round
    each signed dot inside it, so every line ends on a wall or a ring
    - the three signed dots open; one line through each waiting dot, since the mark is never five green dots
    - its radius 8 mm, from 6, at the same centre; 5.7 mm over the LED's hole
    Printed black for two layers and green from the third, the green lie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
    [mono_ind_assembly.step, mono_ind_badge_signed_0.stl, mono_ind_badge_signed_2.stl, mono_ind_badge_signed_3.stl, mono_ind_badge_triangle.stl, mono_ind_badge_waiting_1.stl, mono_ind_badge_waiting_4.stl, mono_ind_shell.stl]
2026-11-11 site: the front page's two case pictures rebuilt from the new industrial case
    web/build.mjs copies mono_ind_apart.png and mono_ind_dock.png to docs/img/, and BUILD.json holds their
    hashes. CI's web job rebuilds docs/ and failed on the difference. Rebuilt with npm ci && npm run build:
    those three files change and nothing else.
    Ran: web's npm test (all pass), tools/releases/site-test.mjs (all pass). Not run here: web's e2e.
2026-11-12 cad: Mono's industrial case: open waiting dots, a 36 mm name, rounded edges, the shell in three colours
    - The waiting dots are open, with no line across them.
    - The name is 36 x 5.8 mm, from 22.5 x 3.6 (NAME_FIT; rp.name takes the room as an argument).
    - The face's and the back's edges are rounded as Mono's, and the counterbores are plain. The chamfers
    left 1.2 mm of plastic between a counterbore and the edge's slope; the face is now flat for 2.2 mm.
    The 45-degree cut corners stay.
    - The shell is also written as three bodies in the same place, mono_ind_shell_black.stl, _green.stl
    and _orange.stl: a 0.6 mm slab of colour behind each opening (COLOUR). The script stops if they
    don't add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
    [mono_ind_assembly.step, mono_ind_shell.stl, mono_ind_shell_black.stl, mono_ind_shell_green.stl, mono_ind_shell_orange.stl]
2026-11-12 site: the front page's two case pictures rebuilt, and its words: no chamfered edges
2026-11-12 app: after a proposal, the form's nonce moves on to the next free one
    The New transaction form read the Safe and its queue once, when the page
    loaded, so a second proposal from the same form defaulted to the nonce
    just used, with no warning that it was taken.
    After a proposal the queue is read again, the new proposal added in case
    the service doesn't list it yet, and the nonce field set for the next
    one. The other fields are kept. "Propose another" scrolls back to the
    form. If the Safe has moved past the reviewed nonce, the form's nonce is
    refreshed and the page asks for a new review.
    e2e: two proposals in a row from one form, and the taken nonce's note.
    docs/app rebuilt.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
2026-11-13 cad: Mono's pictures drawn with a depth for every pixel, so flat faces don't show through
    matplotlib painted whole triangles, the far ones first, and long thin ones
    came out over the name, the mark and the caps. shell.render keeps the same
    views, light and colours and lets the nearest triangle win at each pixel.
    Mono's and its industrial case's pictures rebuilt, and the front page's two.
    Their STLs and STEPs are as they were. The other cases' pictures change at
    their next build.
    Claude-Session: https://claude.ai/code/session_013V1LHjDg4ooWZ5N1ZGVLqA
2026-11-13 hardware: Tally, Mono's console drawn again from scratch, with no inductor
    A 40 x 89.5 mm bar on Mono's outline and pins: RP2350A and flash, ATECC608C,
    the 1.14-inch panel, three buttons, a CH343P as the USB-C's only data path.
    The core's 1.1 V comes from a TLV74311P (datasheet figure 24), so there is no
    inductor; the crystal is a JLCPCB Basic part; the chip's own USB is not
    brought out, and firmware goes in over SWD (J3 and pads on the back).
    gen_tally.py writes the symbols, footprints, schematic, routed board, fab
    files and PINS.md, and checks them. Run with KiCad 7.0.11: KiCad's netlist of
    the schematic matches the table, and its DRC finds 0 violations and nothing
    unconnected. tools/keyp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
    [bom.csv, tally.kicad_pcb, tally.kicad_sch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]
2026-11-13 hardware/tally: the schematic's notes tidied; the fab zip the same bytes on every run
    The sheet's note on the flash said it was not fitted; it is, in the default
    build. The screen's capacitors move clear of J2's labels. The drill files'
    creation date is now fixed like the Gerbers', so two runs of gen_tally.py give
    the same zip, board and schematic. Run again with KiCad 7.0.11: the netlist
    matches the table, DRC 0 violations, 0 unconnected.
    Claude-Session: https://claude.ai/code/session_013V1LHjjYuo8CmLHx2FLcua
    [tally.kicad_sch]
2026-11-13 hardware/tally: what the review found, fixed
    Ten agents reviewed the board; five found, five tried to refute. 42 findings,
    all reproduced, no blocker: every pin is on the right net. REVIEW.md has them.
    The board:
    - cpl.csv carries JLCPCB's turn for the eight parts whose library footprint
    has pin 1 elsewhere than KiCad's (the CH343P a quarter turn, where a QFN-16
    still fits its pads), and the USB-C's point is JLCPCB's origin. The bridge
    and the flash have their pin-1 marks back.
    - 10 uF on VBUS at U3 (WCH's advice beside a CH343P fed from VBUS).
    - 4.7k from the link's TX to 3.3 V; 100 R in SWCLK and SWDIO.
    - A ground via beside each capacitor that was far from one; D-'s via clear of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
    [bom.csv, tally.kicad_pcb, tally.kicad_sch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]
2026-11-13 hardware/tally: the placement angles worked out twice more
    Two more agents took the question of JLCPCB's rotation for each part: one
    fetched JLCPCB's footprints again and matched pads, kept from the earlier
    answer; one used only the published rotation tables and this repo's order
    history. The first gives cpl.csv's fifteen angles and the USB-C's point as
    they are. The second agrees on fourteen; for U4 the package-level tables say
    a half turn where the part's own footprint says a quarter. cpl.csv keeps the
    footprint's answer, and REVIEW.md and the README say what to look at first in
    JLCPCB's preview. No file but the two documents changes.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
