jmcpheron/pico-quorum/(notices)

Notices in the files:
hardware/console-usb/console-usb/console-usb.kicad_sch:
Written by hardware/console-usb/gen_console_usb.py. CERN-OHL-W v2
README.md:
Licenses: MIT code, CERN-OHL-W hardware, CC BY-SA docs
hardware/console-rp/console-rp/console-rp.kicad_sch:
Written by hardware/console-rp/gen_console_rp.py. CERN-OHL-W v2
hardware/console-pcb/console-a/console-a.kicad_pcb:
github.com/jmcpheron/pico-quorum CERN-OHL-W
